Belquer/Cotucatronics/docs/relatorio/002.md

# Relatório 002 — ppc/002 rev C (cérebro + painel) — FECHADO

> **Estado: as DUAS placas fechadas em rev C, pacotes de fábrica PRONTOS.**
> `para_fabrica` passa nas duas, com procedência limpa. O que falta é **humano**:
> a confirmação de rotação peça-a-peça no pré-visualizador da JLC antes de pagar
> (§4). Este relatório substitui a versão anterior — que dizia, corretamente para
> a época, que a rev B **não** estava fechada e que faltava um host com KiCad 10.
> Esse bloqueio caiu (§1) e a saga que o seguiu está aqui, factual.

- **Data:** 2026-09-10
- **Ramo:** `claude/slack-session-sm2ldz`
- **Placas:** `kicad/cotuca_cerebro/cotuca_cerebro.kicad_pcb` (rev C — marca+búzios reposicionada e escalada para a banda centro-direita),
  `kicad/cotuca_painel/cotuca_painel.kicad_pcb` (rev C — J2 OLED corrigido em cobre)
- **Versionamento — congelamento-no-lançamento:** enquanto nenhuma das placas foi
  fabricada/pedida, **ambas ficam em `rev C`** (silk sem número). As iterações
  pré-fabricação (correcção do J2 do painel; reposicionamento+escala da marca do
  cérebro) partilham `rev C` e distinguem-se pelo **stamp de commit** do pacote —
  a letra só sobe quando um board for efectivamente mandado cortar. Ver
  `.claude/skills/aipcb/references/versionamento.md`.
- **Pacotes de fábrica (versionados, descarregáveis do PR):**
  - `export/cerebro_2026-09-12_06db1c7/` (zip + CPL + CPL rico + BOM + LEIA-ME + kit/) — commit **06db1c7** (**cérebro rev C**: marca COTUCATRONICS+rev+búzios reposicionada para a banda **à direita do U2, abaixo da fila de TP/J12, à esquerda do J2/C3** e **escalada por 0,72** para caber (a banda mede 32,8×9,5 mm; o banner cheio 45 mm não cabia) · silk gerber F/B 0 red/0 org · cobre provado idêntico ao 50e2368)
  - `export/painel_2026-09-12_06db1c7/` (zip + CPL + CPL rico + BOM + LEIA-ME + kit/) — commit **06db1c7** (**painel rev C**: J2 OLED reordenado + footprint 1x07 2,54 mm THT + labels por pino · silk gerber limpo · agora `painel rev C` no silk)
  - Ambos gerados por `para_fabrica`: *geometria 0 · planos inteiros ·
    todas as ligações feitas*. Vivem em `export/` (pasta de topo **rastreada**);
    o `fabrica/` continua a ser scratch gitignored. A partir de
    `para_fabrica v0.12.0` esta cópia para `export/` é **automática** na passagem
    do portão.
- **Thread do dB:** <https://cotucatronics.slack.com/archives/C0C0L4P4HKL/p1788980632073229>

### Histórico de revisões

- **cérebro rev C** — fechado, pacote `export/cerebro_2026-09-11_6ebbda5/` (retirado, reproduzível do histórico). A marca vivia em B.Silkscreen espelhada.
- **cérebro rev C1** — marca (COTUCATRONICS + rev) movida de B.Silkscreen para **F.Silkscreen do topo** — o cérebro monta com os componentes para cima e a tampa é de acrílico transparente, logo o topo é a face que se vê. Colocada na banda livre de topo entre J14 e J15 (folga ≥0,25 mm ao cobre, ≥1,5 mm ao bordo, medida em pcbnew), sem mirror. Acrescentado o **símbolo de búzios** (concha) em F.Silkscreen — a mesma marca `Concha` do `src/splash.h` (super-elipse n=3,2 com lábio/boca dentada), vectorizada para serigrafia. Rev sobe porque **silk é gerber**; o cobre foi provado **idêntico** (fingerprint de cobre/rede igual, diff do `.kicad_pcb` 100 % silk) — nenhuma deriva de gerador como a do painel. Commit **bcc80d2**, pacote `export/cerebro_2026-09-12_bcc80d2/` (retirado, reproduzível do histórico).
- **cérebro rev C2** — branding movido para área aberta centro-direita — a marca (COTUCATRONICS + rev + búzios) migrou **em bloco** (translação rígida +38,+65 mm, layout relativo preservado) da banda de topo para a **área aberta do centro-direita inferior**: acima do J1, à direita do U2 (Daisy DIP, acaba em x=115) e abaixo do bloco J2/J3/C3/J16, a pedido do dB. A banda de topo (rev C1) não comportava o bloco de 45 mm de largura sem apertar, e o ponto exacto apontado (y~55–72) está congestionado por J11/R9/J3/J2 — esta é a área aberta mais próxima que o comporta. Centros novos (F.Silkscreen, sem mirror): COTUCATRONICS (138, 89,4) · `cerebro rev C2` (138, 94,2) · búzios (162, 90,6); bbox (122,87)–(167,96); folgas pad 3,18 · furo 3,53 · pátio 2,22 · serigrafia 2,06 · bordo 24,4 mm. Rev sobe porque **silk é gerber**; o cobre foi provado **idêntico** ao bcc80d2 (fingerprint de cobre/rede igual `cf9aed0b…51eb`, diff do `.kicad_pcb` 100 % silk). Commit **50e2368**, pacote `export/cerebro_2026-09-12_50e2368/`.
- **painel — J2 OLED reordenado** (VCC·GND·DIN·CLK·CS·DC·RST) + footprint 1x07 2.54mm THT + labels por pino — commit deddd3d (silk carimbava `painel rev C1` à época). Ao regenerar a fonte apareceram e corrigiram-se duas derivas pré-existentes do gerador (EC11/SW1 chaves de pino, MOSFET Q1/Q2 source/drain) para o gerador voltar a reproduzir a placa; a netlist regenerada difere do baseline só no J2.
- **⚠️ Congelamento-no-lançamento (2026-09-12, commit 06db1c7)** — nenhuma das placas foi ainda fabricada, logo **as duas voltam a `rev C` no silk** (sem número), e as mudanças acima passam a ler-se como **iterações de `rev C` distinguidas pelo stamp de commit**, não como revs próprias. O silk do painel passa de `painel rev C1` → **`painel rev C`** e o do cérebro de `cerebro rev C2` → **`cerebro rev C`** (só texto de serigrafia; cobre byte-idêntico nas duas). A regra antiga «gerber muda → rev sobe a cada commit» foi substituída em `references/versionamento.md`: a rev sobe **por lançamento** (fabrico/pedido), não por commit.
- **cérebro rev C — marca reposicionada e escalada para a banda pedida** (commit 06db1c7) — o dB apontou a banda **à direita do U2, abaixo da fila de pontos de teste e do J12, à esquerda do bloco J2/C3**. Essa banda mede só **32,8 × 9,5 mm** (medido em pcbnew) e o banner a tamanho cheio tem **45 mm**: a tamanho cheio, COTUCATRONICS + rev caíam sobre os pads MIDI/AUDIO do U2 (**4 `silk_over_copper`** medidos). O grupo (COTUCATRONICS + rev + búzios) foi **escalado uniformemente por 0,72** (layout relativo preservado) e centrado na banda. Centros novos (F.Silkscreen, sem mirror): COTUCATRONICS **(127.2, 68.8)** size 1.872 · `cerebro rev C` **(127.2, 72.256)** size 1.152 · búzios **(144.48, 69.664)** ra 3.6 rb 2.16; bbox (115.7, 67.2)–(148.2, 73.3); folga mínima **0,67 mm** (pátio do U2 à esquerda, pátio do J2 à direita; TP e J12 a >3,6 mm); silk gerber F/B **0 red/0 org**, traço ≥0,15 mm. Cobre provado **idêntico** ao 50e2368 (fingerprint de cobre/rede igual, diff do `.kicad_pcb` 100 % silk). Pacote `export/cerebro_2026-09-12_06db1c7/`.
- **📦 Compra — PLACED (2026-09-12): peças na Mouser + placas nuas na JLCPCB** — BOM `export/COMPRA_MOUSER*` (`.csv` + template `.xlsx`/`.xls`), corte **v2**: 7 peças críticas verificadas em estoque via **Claude-on-Chrome** (F1 `MF-LSMF300/24X-2`, C14/C24 `MKS2C042201M00KN00`, C8 `CL31B106KAHNNWE`, D2 `SS14` onsemi, Q1/Q2 `SI2302CDS-T1-GE3`, IDC 2x13 `61202621621`, barra de headers `61304011121`) — os MPNs backordered/no-match do corte anterior foram trocados. Todo artefato de compra passa a carregar **carimbo** e o `export/MANIFEST.md` é a fonte-da-verdade de "o mais novo" (ver `references/versionamento.md`, «Versionar TUDO»). **Compra: PLACED.** **pedido Mouser #: 40440548 (2026-09-12)** (peças/BOM) · **pedido JLCPCB #: W2026091304545438 (2026-09-12) — placas nuas**. ⚠️ **confirmar se o pedido JLCPCB cobre cérebro E painel ou apenas um** (cobertura não verificada — não assumir).

---

## 1. A saga, factual

### 1.1 KiCad 10 indisponível → instalado por AppImage (Estágio 0)

Os ficheiros são KiCad 10 (formato pcb `20260206`, sch `20260306`) e **nenhum
KiCad instalável por apt/conda/PPA os abre** — foi o bloqueio que fechou o
relatório anterior. Resolvido pela via que o **Estágio 0** da `/aipcb` já prevê:
`scripts/bootstrap_kicad.sh` puxa o **AppImage do GitHub**, extrai o squashfs, e
a pipeline **volta a correr o portão de versão**. Passou: `kicad-cli` 10.0.6 a
abrir, correr ERC e DRC, rotear, encher zonas e exportar — o *"o ficheiro ABRE"*
que o Estágio 0 exige, provado, não assumido.

### 1.2 Os seis críticos da VARREDURA — já corrigidos no ficheiro

Os seis críticos C1–C6 que a `VARREDURA-PRE-FABRICA.md` (o de-facto 001) apanhou
já estavam corrigidos **no ficheiro** e continuam a passar por medição:
`funcao_dos_pads.py` dá **18 regras · 0 falhas** (cérebro) e **12 · 0** (painel),
e o `--sabota` reprova quando se corrompe um pad certo — a guarda tem dentes.
Nada de novo aqui; o trabalho da rev C foi geometria de cobre e colocação.

### 1.3 C16↔J14 — um waiver NEGADO por medição

O único **ERRO** de DRC do cérebro era um `courtyards_overlap` entre **C16**
(100n +3V3A, 0805, lado F) e **J14** (box-header DIN-41651, IDC 2×13). Parecia um
waiver razoável — courtyards são folga nominal. Ao medir **corpo-contra-corpo**,
C16 estava **inteiro dentro** do corpo F.Fab de J14 (o 0805 debaixo do shroud de
um header de assento rente): colisão real, não folga. **Um waiver é uma medição,
não uma opinião** — MUST-FIX, não SAFE-EMBARK. Este caso é agora a **âncora** do
Portão de Certificação de Risco na `/aipcb` e a instância do IFÁ10000 para hardware.

### 1.4 O nudge de J14 estava fisicamente bloqueado → C16 para B.Cu + FreeRouting

A correção óbvia — empurrar J14 para dentro e dar casa a C16 junto ao rail —
estava **fisicamente bloqueada pelo front-end do pré-amp** (D11/R11/J5) a ocupar
o único corredor interior vivo. Sem espaço para recolocar, o cérebro resolveu
**levando C16 para B.Cu** e roteando o +3V3A pela tira de plano com **FreeRouting**
(o router de pé: **JDK 25 + FreeRouting 2.4.1**, headless/offline). Resultado:
DRC de erros **5 → 0**, e os 3 itens de silk dependentes de C16/J14 resolvidos de
borda. O gerador foi atualizado para o novo estado (não só o ficheiro).

### 1.5 O painel levou o nudge real de J1 (5,5 mm) — fechou o latente C5

O painel tem o **mesmo** IDC 2×13 (**J1**), mesma classe de falha, e o seu cap
+3V3A **C5** estava a ~0,5 mm do corpo de J1 — um nudge de ser o próximo C16.
Aqui a recolocação **era possível**: nudge real de **J1 5,5 mm para dentro**,
re-roteamento do canto, **C5 colocado limpo**. DRC 0 erros mantido. O mesmo
defeito das duas placas, dois desfechos — um contornado por cobre porque a
colocação estava presa, o outro **desfeito na colocação** porque havia espaço.

### 1.6 Certificação de risco + revisão de terra — as duas SEGURAS, sem 🔴

- **Registo de risco** (saída da revisão tripla): depois de limpar o ruído de
  ambiente (`library not configured` vinha de `fp-lib-table` em falta, não da
  placa), o resíduo real é **cérebro 16 / painel 5 avisos**, cada um com veredito
  **medido**. Único ERRO era R1 (C16↔J14), já corrigido. Tudo o resto embarca com
  prova (metadata, silk da própria peça, MPN-no-símbolo). **GO** nas duas.
- **Revisão de terra** (`revisao-terra` P0–P7): cérebro com AGND/GND separadas e
  ponte única em NT1 (0 shorts ⇒ sem anel), plano analógico íntegro, pares de
  desacoplamento por rail; painel com terra única correta. **Ambas SEGURAS, sem
  🔴** — o único 🟠 é a distância do desacoplamento do rádio ESP32 (C3/C4 a ~10 cm),
  questão de ruído mitigada pelos caps de bordo do módulo, não defeito de cobre.

### 1.7 O achado de congestão (Estágio 3.5)

A revisão de densidade **pré-layout** mostrou que J14 e J1 eram a **mesma**
decisão tomada duas vezes: um IDC 2×13 encostado ao bordo de cima, o que mata um
dos dois broadsides de escape e sobre-aloca o corredor (**procura 17 > oferta
13**). Essa métrica prevê a colisão de C16 **antes de qualquer pista**. O achado
virou estágio: a `/aipcb` ganhou o **Estágio 3.5 — Previsão de congestão** (portão
GO / REVER-COLOCAÇÃO, duas recusas duras), a referência `references/congestao.md`,
e a ferramenta `scripts/congestao.py`. Corrida na rev C fechada, ela ainda marca
**cérebro J14 vermelho** (o over-commit é real, foi contornado por B.Cu, não
desfeito) e **painel J1 verde** (o nudge de 5,5 mm abriu o segundo broadside) —
exatamente a história das duas placas, medida.

---

## 2. O que passou por medição (rev C)

| check | cérebro | painel |
|---|---|---|
| DRC erros (com regras JLC, `--refill-zones`) | **0** | **0** |
| unconnected_items | **0** | **0** |
| ERC erros | **0** | **0** |
| funcao_dos_pads | **18 regras · 0 falhas** | **12 · 0** |
| revisão de terra | **SEGURA, sem 🔴** | **SEGURA, sem 🔴** |
| registo de risco | **GO** | **GO** |
| `para_fabrica` | **PASS** (pacote e058d6b) | **PASS** (pacote aad5d5a) |

---

## 3. Pacotes de fábrica (procedência)

Os dois pacotes saem carimbados com data/commit e o veredito *geometria 0 ·
planos inteiros · todas as ligações feitas*:

- **Cérebro:** `export/cerebro_2026-09-12_06db1c7/` — 2 camadas (F.Cu + B.Cu),
  GND (prio 0) + AGND (prio 1) ambas em B.Cu, NT1 como ponte única. BOM com coluna
  LCSC preenchida; CPL presente. **rev C** (marca + búzios em F.Silkscreen na banda
  à direita do U2, escalada por 0,72 para caber; cobre idêntico ao 50e2368).
- **Painel:** `export/painel_2026-09-12_06db1c7/` — 2 camadas. BOM+CPL presentes. **rev C** (J2 OLED corrigido; silk `painel rev C`).

> **Reempacotamento 6ebbda5 (`para_fabrica` v0.18.0).** O portão passou a preservar
> o **CPL rico** (`cpl_rico_<board>.csv`, com Val/Package) ao lado do CPL da JLC —
> antes reescrevia o CPL no lugar e perdia valor/footprint, e a jusante ninguém os
> lia da posição. Cada pacote ganha ainda um subdirectório **`kit/`** (gerado por
> `kit_montagem.py` v1.0.0): `MAPA_COLOCACAO.md` (colocação por valor, TOP/BOTTOM
> separados, BOTTOM e THT sinalizados), `COMPRA_LCSC.csv` (carrinho LCSC com sobras)
> e `LEIA-ME-KIT.txt` — o kit de montagem em casa na chapa quente. Os pacotes
> anteriores foram retirados (reproduzíveis do histórico do git). O `VISTORIA.md` é
> regenerado à parte, agora a partir do CPL rico que embarca.

> **Encomendar 2 camadas, não 4** — só há F.Cu e B.Cu; pedir 4 paga um plano
> interior que este desenho não usa.

---

## 4. Portões humanos pendentes ⟨dB⟩

**Não scriptáveis** — a rotação no CPL é a do KiCad, a JLC espera a da biblioteca
dela. Confirmar peça-a-peça no **pré-visualizador 3D da JLC, por placa, ANTES de
pagar** (só as peças com polaridade importam):

- **Cérebro:** `U1` OPA1642 SOIC-8 (ponto de pino 1); `D11`/`D21` BAV99 SOT-23
  (**risco 180°** — a JLC roda SOT-23 com frequência); `D1` SMBJ24A SMB (catodo =
  barra); `D2` SS14 SMA (catodo — ver ressalva do Value/MPN em §5).
- **Painel:** `Q1`/`Q2` AO3400A SOT-23 (**risco 180°**); **`J2` OLED — pinout vs
  Waveshare 2,42"**: a placa tem `1 GND · 2 +5V · 3 CLK · 4 DIN · …`; o módulo tem
  `VCC · GND · DIN · CLK · …`. **Com cabo 1:1, VCC↔GND TROCAM (o OLED morre ao
  ligar) e DIN/CLK também.** Ou se **reordena o J2** (o cabo de fábrica passa a
  servir), ou se **crimpa um cabo cruzado** — confirmar com o módulo em mão; nenhum
  script vê o conector de outra pessoa.
- **Pots THT** (`PTV09A-1020S-B103`) **não passam pela JLC** — vêm do
  distribuidor à parte; o `-1` é vertical com bucim, o `-4` é rear-mount e o eixo
  não sobe pela tampa.

Enquanto o ⟨dB⟩ não assinar, o Estágio 8 fica **INCOMPLETA** — nunca se confunde
com feito.

---

## 5. Ressalvas (honestas)

- **Regeneração do mapa LCSC bloqueada por egress (403 em jlcsearch).** O
  `codigos_lcsc.json` está completo **por referência** e o `para_fabrica`
  consumiu-o; **a chave de D2 ainda traz o MPN antigo, mas o `ref→C2480` está
  correto**. É a mesma peça (SS14 em SMA) que o desenho chama `1N5819` no `Value` —
  compra e desenho dão-lhe nomes diferentes; a coluna LCSC é que manda para a
  montagem.
- **"0 erros" de DRC (severidade=erro) é mais estreito que o portão do
  `para_fabrica`** (severidade=aviso + `refs_apontam`). As duas placas passam
  agora o **portão completo**, não só o DRC de erros — é o portão largo que conta.
- **Sem medição de bancada (P7).** A revisão de terra é do desenho/cobre; os
  números AC/mV sob carga ficam pendentes até haver placa na bancada.

---

## 6. Artefactos de método desta corrida

| artefacto | versão | porquê |
|---|---|---|
| `.claude/skills/aipcb/SKILL.md` | — | novo **Estágio 3.5 — Previsão de congestão** (portão GO/REVER-COLOCAÇÃO) |
| `.claude/skills/aipcb/references/congestao.md` | novo | método, fórmulas das 5 métricas, as 2 recusas duras, âncoras J14/C16 e J1/C5 |
| `.claude/skills/aipcb/scripts/congestao.py` | **0.1.0** | portão 3.5: orçamento de escape + densidade de pinos, read-only, sai ≠0 em vermelho, `--sabota` |

As placas carregam a **revisão** em `gr_text` (**`cerebro rev C`**, **`painel rev C`**) —
que agora **está** fechada. Sob **congelamento-no-lançamento** (2026-09-12), como
nenhuma das duas foi ainda fabricada, ambas ficam em `rev C` (silk sem número); as
mexidas do dia — correcção do J2 OLED do painel em cobre, e no cérebro a marca+búzios
levada primeiro para a F.Silkscreen do topo e depois reposicionada+escalada (0,72)
para a banda à direita do U2 — são **iterações de `rev C` distinguidas pelo stamp de
commit**, não revs próprias (só serigrafia nas do cérebro, cobre idêntico; ver
Histórico de revisões). O método de versão (as 3 camadas + a regra de
congelamento-no-lançamento) está em `.claude/skills/aipcb/references/versionamento.md`. As bumpagens de scripts de pipeline das corridas
anteriores (`faz_placa` 0.14.0, `para_fabrica` 0.11.0, `poe_furos` 0.2.0)
mantêm-se.

### 6a. Paridade com o DFM da JLC — serigrafia (adenda 2026-09-10)

O DFM da JLCONE reprovou o painel com serigrafia a vermelho que o portão
sub-contou (silk→pad, silk→furo, largura de traço). Corrigido no painel (texto
`Q1`/`Q2`/`painel rev C` para fora de pad+furo; 301 contornos de biblioteca a
0,12 → 0,15 mm) e dado **paridade** à pipeline: `cotuca_painel.kicad_dru` (regras
silk→pad/→furo/traço/altura), `para_fabrica` **0.13.0** (recusa serigrafia de
texto sobre pad + texto fino/baixo; silk→furo já cai na geometria) e
`normaliza_silk.py` **0.1.0** (a largura de gráfico de serigrafia, que nenhum DRC
mede, subida na fonte). **Decisão ⟨dB⟩ (ferramenta):** o **KiCad é a
fonte-da-verdade** (aberto, versionado, automatizável por agentes); o EasyEDA
Pro / JLCONE é só o front-end final de DFM + encomenda — o portão dá paridade
para esse passo ser um carimbo.

**Cérebro — mesma passagem, medida no gerber (2026-09-11).** Antes: silk→pad **23
vermelhos** (F) + **2** (B), traço mín 0,12 mm. Depois de `serigrafia_dfm`
(v0.2.0 — passou a tratar os 17 rótulos de pino `PCB_TEXT` do módulo ESP32-C3 em
`U3`, que faziam o `widen` rebentar): **silk→pad/→furo 0 vermelho nos dois lados**,
traço todo ≥ 0,18 mm, e cada marcador de polaridade/pino-1/cátodo (`D1` SMB, `D2`
SMA, `D11`/`D21` SOT-23, `U1` SOIC-8, «+» de `C1`/`C3`/`C5`/`C6`) renderizado e
**verificado a sobreviver** (`refs_apontam` 0). Laranjas medidas, cada uma ACEITE
com o número: anel mín **0,15 mm** (217 features plateadas; 0 < 0,13; 0 < 0,15;
`H1`–`H4` NPTH sem anel), 72 vias 0,6/0,3 = a via-padrão da JLC; **0 slots** (sem
EC11 — a classe slot/negative-mask não se aplica); expansão de máscara 0,0 mm e
**72 vias todas tapadas**; silk→pad no limite 0,163 mm (F)/0,195 mm (B) ≥ 0,15. O
`para_fabrica` **0.15.0** dá o cérebro **PRONTO** (geometria 0, ERC 0, unconnected
0, `funcao_dos_pads` 18/0, silk gerber 0, tenting 0 abertas). Detalhe em
`fab-automation.md` §2a-bis. **As DUAS placas agora com serigrafia a 0 vermelho no
gerber.**
