Belquer/Cotucatronics/docs/IFA10000.md

# IFÁ10000 — protocolo de certificação de efeitos

### Todo efeito que entra no Cotucatronics passa por aqui. Sem exceção, sem atalho.
### E toda placa que entra numa caixa passa pela trilha M, no fim deste documento.

> **Por que existe.** Cada item deste protocolo foi comprado com horas de
> bancada. O freeze quase morreu pelo número errado; um módulo passou
> sessões mudo por um contrato não conferido; 108 KB no lugar errado
> custaram 13 pontos de CPU. Nada aqui é burocracia — é cicatriz virada
> procedimento. Ver [battle_scars.md](battle_scars.md) para as histórias.
>
> **Documento vivo.** Efeito novo que revele buraco no protocolo ganha
> etapa nova. O IFÁ10000 melhora a cada certificação.

---

## As 10 etapas

Cada etapa tem **critério de passagem explícito**. Efeito que não passa
não entra no build — fica no repo, documentado, com a etapa que reprovou.

---

### 0. MEDIÇÃO LIMPA — o pré-voo, antes de qualquer número

Nenhuma etapa deste protocolo produz dado válido sem isto. Skill:
`medicao-limpa`.

- [ ] **o canal foi provado**: comando de eco conhecido, resposta conferida
- [ ] **ambiente zerado**: `tone off`, búzios desligados, params nos defaults
- [ ] **unidade declarada**: µs? % de que prazo? RMS, pico ou norm?
- [ ] **regime declarado**: estreia ou permanente? bloco 48 ou 256?
- [ ] **um voo, uma variável** — e os empregos da variável listados antes
- [ ] caixa-preta armada por comando no início; sessão de leitura não escreve

**Passa se:** o zero que aparecer na tela significa alguma coisa.

> Custou: quatro janelas de teste de MIDI lidas como "link morto" com o log
> mudo por um `bb arm` meu — mediram o meu silêncio, e a conclusão errada
> foi **publicada** no battle_scars como causa confirmada. **Um zero num
> canal não confirmado não é dado; é ausência de dado.**

---

### 1. CONTRATO — o que ele promete, conferido antes de embarcar

Ler o `description.json` (motor externo) ou a interface (shell) **antes** de
escrever uma linha de wrapper.

- [ ] entradas / saídas: quantas, e batem com o slot que vai recebê-lo?
- [ ] parâmetros: nomes exatos, faixas, valores iniciais
- [ ] datarefs externos: quais o host precisa preencher, e de que tamanho?
- [ ] classname / símbolos que possam colidir com outro módulo

**Passa se:** o wrapper e o contrato contam a **mesma história**, e a
divergência que existir está comentada no código.

> Custou: um módulo mudo por `r_window` de 2048 numa FFT de 1024; wrapper
> declarando 2 entradas num patch de 1; um param de mistura sumido de um
> export. **Ler o JSON custa um minuto; um módulo mudo custou horas.**

---

### 2. EMBARQUE — ele acorda?

- [ ] compila com `make check` (clone limpo tem tudo)
- [ ] `Init` retorna verdadeiro e o boot loga o que alocou
- [ ] `mods` mostra os params **descobertos por nome**, índices ≥ 0
- [ ] zero falhas de alocação

**Passa se:** boot limpo, sem `-1` em ligação nenhuma.

---

### 3. MOTOR — ele está sendo dirigido? *(só motor externo)*

- [ ] `processEventsUntil()` + `advanceTime()` a cada bloco
- [ ] warm-up no `Init` paga a estreia no boot
- [ ] re-kick de params depois do warm-up

**Passa se:** um parâmetro mexido ao vivo muda o som **na hora**.

> Custou a sessão inteira de 2026-08-16. Assinatura da falha: **roda, custa
> CPU, não soa, sem log.** Sinal puro roda sem motor; tudo que depende
> de evento fica morto.

---

### 4. MEMÓRIA — quanto, onde, e com que padrão de acesso

- [ ] quantos bytes, e em qual região (pool de módulo / SRAM / SDRAM)?
- [ ] quantos acessos por amostra, e são sequenciais ou espalhados?
- [ ] o tamanho é **perguntado ao efeito**, nunca fixado em quem chama

**Passa se:** cabe com folga declarada, e a escolha de região está
justificada no código.

> Custou: reverb com 108 KB em SDRAM = +12,9 pontos de CPU; os mesmos
> 108 KB em SRAM = +5,6. **O padrão de acesso importa mais que o
> tamanho** — 48 acessos espalhados por amostra é o pior caso pra cache.

---

### 5. CARGA — estreia e regime, separados, nos dois blocos

Medir **pico**, não média. Nos dois regimes: **bloco 48** (instrumento) e
**bloco 256** (com módulo espectral).

| | estreia (µs) | regime (µs) | % do prazo |
|---|---|---|---|
| bloco 48 | | | |
| bloco 256 | | | |

- [ ] estreia separada do regime (janela de graça)
- [ ] pico, com o medidor **zerado** entre as leituras
- [ ] a unidade está declarada (µs? %? de que prazo?)

**Passa se:** o pico cabe no prazo com folga ≥ 25%.

> Custou: freeze condenado por 233 965 µs de estreia quando o regime era
> 3 520. **Estreia é o preço da mudança; regime é o aluguel.** E: pico
> decide, média mente — um módulo tinha média de 7,8% com pico de 210%.

---

### 6. MATERIAL DE PROVA — o sinal certo pra este efeito

Cada efeito tem sua régua. Usar a errada produz "não funciona" falso.

| Efeito | Material | Por quê |
|---|---|---|
| delay, shifter | senoide | período claro, deslocamento audível |
| cross-synthesis | **banda larga** (ruído, piezo) | peneira: só devolve onde as fontes coincidem |
| reverb | **transiente + silêncio** | cauda só aparece depois do ataque |
| gate, limiter, governor | transiente percussivo real | é o caso que eles existem pra tratar |
| filtro | varredura ou ruído rosa | mostra a curva inteira |

- [ ] o material usado está registrado no teste
- [ ] o aceite final é sempre com o **piezo**, tocando a escultura

**Passa se:** o efeito responde ao material certo, e o registro diz qual foi.

> Custou: um cross-synthesis declarado quebrado porque senoide × drone esparso ≈
> silêncio. Não era bug — era **régua errada**.

---

### 7. FAIXA E ESTOURO — onde ele satura

- [ ] histograma de pico ao longo da faixa de cada parâmetro
- [ ] medido **antes** do limiter (depois dele tudo mostra 0,95)
- [ ] identificado: satura numa **nota** (→ notch) ou numa **região**
      (→ filtro)?

**Passa se:** existe tabela dizendo onde começa e até onde vai.

> É o que transforma "está estourando o grave" em "de 110 a 155 Hz o
> pico passa de 1,0" — e o conserto deixa de ser chute.

---

### 8. SEGURANÇA — o que ele pode fazer de errado

- [ ] interage bem com governor, limiter e shifter?
- [ ] pode realimentar pelo exciter? qual o plano B se o laço engordar?
- [ ] **quais params entram nos búzios, e quais NÃO** — com o porquê

Regra da whitelist: **caráter entra, moldura e segurança não.**
`level`, `src_mix`, gate, governor, limiter, roteamento e shift **jamais**.
Bloco que serve de referencial fixo (como o reverb) também fica fora:
*se tudo salta, nada é surpresa.*

**Passa se:** a decisão de cada param está escrita no manifest com a razão.

---

### 9. ACEITE — o ouvido do músico, não a caixa-preta

- [ ] **mínimo 1 minuto contínuo** tocando a escultura
- [ ] o efeito faz o que promete, do começo ao fim
- [ ] nada degrada ao longo do teste

**Passa se:** o dB diz que está bom. **Só isso conta como entregue.**

> Custou: "auto-rand funcionando" declarado com 951 pushes medidos, e a
> torneira seca. **Encanamento provado não é feature entregue.**

---

### 10. REGISTRO — o que fica pro próximo

- [ ] **TESTES.md**: teste T-novo com procedimento e critério
- [ ] **STATUS.md**: estado, custo medido, defeitos que ele trouxe
- [ ] **battle_scars.md**: se houve cicatriz, ganha parágrafo
- [ ] **commit por assunto**, com o *porquê* no corpo
- [ ] docs sincronizados no repo **e** no vault

**Passa se:** alguém que clone o repo amanhã reproduz tudo sem perguntar
nada.

---

## O braço executável — skills em `.claude/skills/`

O protocolo deixou de ser só leitura. As cicatrizes viraram skills que
carregam sozinhas na sessão quando o assunto aparece:

| Skill | Dispara quando | Vem de |
|---|---|---|
| `ifa10000` | efeito novo, revalidação, "isso está certificado?" | este documento |
| `medicao-limpa` | antes de **toda** medição — é a etapa 0 | caso 8, `tone on`, búzios ligados |
| `instrumentacao` | log, caixa-preta, contadores, sondas, mscope | os 8 casos do cap. 2 |
| `bug-de-ordem` | funciona às vezes; teste incoerente | as 3 famílias do cap. 1 |
| `edicao-segura` | **toda** alteração de arquivo | edições que falharam em silêncio |
| `aipcb` | placa nova, placa numa caixa — é quem corre a **trilha M** | o painel rev C sem fixação |

**Por que skills e não só documento:** o cap. 11 manda, com todas as letras,
procurar o teste que corta o sistema ao meio quando o sintoma se repete — e
mesmo assim quatro janelas foram gastas gerando hipóteses sobre BLE sem
aplicar a regra. **A lição não pegou por estar escrita.** Skill carrega no
momento do uso; documento espera ser lembrado.

---

## Ficha de certificação (copiar e preencher)

```
EFEITO: ..................  DATA: ..........  VERSÃO: ..........
TIPO: [ ] módulo externo   [ ] bloco permanente do shell
POSIÇÃO NA CADEIA: ......................................

 0 MED. LIMPA    [ ] canal provado ....  ambiente zerado ....  unidade ....
 1 CONTRATO      [ ] ....................................
 2 EMBARQUE      [ ] ....................................
 3 MOTOR         [ ] ....................  [ ] N/A (shell)
 4 MEMÓRIA       [ ] ......... bytes em ........  ..... acessos/amostra
 5 CARGA         [ ] blk48: ..... µs pico   blk256: ..... µs pico
 6 MATERIAL      [ ] ....................................
 7 FAIXA         [ ] satura em .............. (nota / região)
 8 SEGURANÇA     [ ] búzios: entra ..........  fica fora ..........
 9 ACEITE        [ ] dB ouviu ..... min  →  ....................
10 REGISTRO      [ ] T....  STATUS  scars  commit  vault

VEREDITO: [ ] CERTIFICADO   [ ] REPROVADO na etapa ....
```

---

## Certificados até aqui

| Efeito | Data | Veredito | Nota |
|---|---|---|---|
| delay (motor externo) | 2026-08-15 | ✅ T5 | primeiro módulo; abriu o caminho |
| búzios (shell) | 2026-08-16 | ✅ T13 | 74 transientes / 74 sorteios |
| reverb (shell) | 2026-08-17 | ✅ T14a | 108 KB: SDRAM +12,9 pp → SRAM +5,6 pp |
| passa-alta Fx2 (shell) | 2026-08-17 | ✅ T14b | histograma por nota evitou o notch errado |
| freeze (motor externo) | — | ❌ etapa 5 | 7 349 µs; não cabe em prazo nenhum |
| freeze granular (shell) | 2026-08-18 | ✅ **CERTIFICADO** | 98 µs de 500; três versões — laço de 2 s, ganho, e mix-como-camada |
| shifter SSB (shell) | 2026-08-15 | ✅ T8 | 50,5 dB de supressão em placa |

---

## Trilha M — pareamento mecânico placa ↔ caixa (IFÁ10000-M)

As dez etapas acima certificam **efeitos**. A trilha M certifica **o encaixe de
uma placa em qualquer caixa em que ela entre** — furos, ângulos, tamanhos,
volume, técnica de fixação, acesso e montagem. Vive na sub-skill `3ddesign`,
orquestrada pela `aipcb` (no estágio 3, antes do cobre, e antes dos gerbers): o
texto completo, as âncoras e a ficha estão em
**`.claude/skills/3ddesign/references/ifa10000-m.md`**. Aqui fica o registo.

**A ordem de prioridades** — é ordem, não lista absoluta:

1. **A placa traz os seus meios de fixação.** Sem furos não há como a prender, e
   nenhuma caixa resolve isso: aqui a placa cede.
2. **Com isso garantido, a caixa cede à placa em tudo o resto.** É muito mais
   fácil ajustar uma embalagem do que uma PCB.
3. **A placa só cede noutra coisa com justificação excelente**, escrita, medida
   e assinada pelo dB.

**Etapas:** M0 medição · M1 interfaces · M2 fixação · M3 furos e recortes · M4
tamanhos e contornos · M5 ângulos e orientação · M6 volume Z · M7 acesso e
montagem · M8 tolerâncias · M9 encaixe a seco ⟨dB⟩ · M10 registo.

### Certificados — trilha M

| Placa · caixa | Data | Veredito | Nota |
|---|---|---|---|
| painel rev C (`06db1c7`) · tampa r2 | 2026-09-18 | ❌ **M2** (`encaixe.py`) | **0 pontos de fixação.** Sem furos de montagem nem NPTH; desenhada para ficar pendurada nos eixos, mas os pots passaram à tampa por fios (caso B) e o `EC11E15244G1` não tem rosca. Pela prioridade 1 cede a placa: há 4 pontos furáveis medidos (M3 com anilha, fora do cobre e em acrílico inteiro), todos à direita de x=97 — os primeiros 60 mm, sob o OLED, ficam em balanço. Na próxima rev, os furos entram por desenho, com um na ponta esquerda. **M6 (dB, medido): o header do OLED com jumpers direitos não cabe entre a placa e o acrílico** — J2 por baixo ou jumpers em L; na próxima rev, conectores do lado de baixo por desenho. |
| cérebro rev C (`06db1c7`) · fundo r2 | 2026-09-18 | ❌ **M6** | M2 ✓ (4 furos M3, triângulo 5254 mm²) · M4 ✓ · cabo ✓ (265 mm pedidos, BOM 300). **M6: três corpos dentro dos discos dos arcade** — `J14` (8,85 mm) a 11,6 do centro, trimpot `RV1` (10) a 13,3, Daisy `U2` (17) a 14,8 — contra o raio do FURO (15) e 7,5 mm de folga. O corpo do botão por baixo da tampa é mais estreito e nunca foi medido: medir o botão pode absolver o `U2` e talvez o `RV1`; o `J14` é o que mais provavelmente bate. |

---

*Ifá consulta o destino com rigor; os Búzios consultam com acaso. O
instrumento precisa dos dois — e o rigor vem primeiro, senão o acaso não
tem onde cair.*
