Belquer/Cotucatronics/docs/ppc/008-versao-nova-cerebro-e-silencio.md

# ppc/008 — a versão nova: cérebro, silêncio, e o que a pesquisa desmentiu

<!-- doc-check: ignore cotuca_cerebro (pasta do projecto KiCad, nao e param) -->
<!-- doc-check: ignore funcao_dos_pads (portao do /aipcb, ferramenta em kicad/) -->

> **Estado: PESQUISA FECHADA EM 5 DE 7 FRENTES, decisão principal TOMADA.**
> Escrito a 2026-09-29, a seguir à noite em que a caixa montada se recusou a
> funcionar e o dB disse: *"consertaremos uma coisa e outra vai estragar."*

**O pedido que o originou, nas palavras dele:** deixar o sistema actual como
aprendizado, seguir para caixa e placa novas, **som mais limpo, nível
audiófilo**, aproveitando o que for bom — *"sem apego às peças, focando no
objetivo de um instrumento sólido, limpo e preciso."*

---

## §0 — A DECISÃO, e ela inverteu-se a meio da pesquisa

> **Não se faz placa própria agora.** Faz-se **caixa e carrier novas,
> mecânica-primeiro, com um Daisy Seed3** — e mede-se.

Eu tinha recomendado o contrário (STM32H7R3 próprio). O estudo de custo
desmentiu-me, e a razão é simples: **o benefício que eu invoquei já está à
venda.**

| por unidade | 5 un | 10 un | 30 un | 100 un |
|---|---|---|---|---|
| placa própria (JLCPCB) | ~$33 | ~$24 | ~$18 | ~$14,6 |
| Seed3 + carrier | ~$55 | ~$49 | ~$44 | ~$40 |
| **poupança** | ~$22 | ~$25 | ~$26 | **~$25** |

**A poupança é plana** — a curva de desconto da Daisy também é (5 % a 100 un),
e o ganho vem de trocar um módulo de $30 por ~$9 de silício, não de escala.

Contra isso: a média da indústria é **2,9 respins**, ~90 % dos primeiros
protótipos falham, e só o hardware dos respins custa **$700–1600**. Ponto de
equilíbrio: **~40 placas** (só hardware) ou **~200** com o tempo de projecto a
preço de mercado. Claramente certo a partir de **300–500 un/ano**.

**A 10 unidades, a placa própria perde feio:** semanas e dois ou três respins
para poupar $250.

### E o projecto já tinha decidido isto, a 2026-09-05

A `COTUCA_BOM.md` diz, e a razão é a mesma de hoje:

> *"A Daisy Seed rev4. **RESOLVIDO a 2026-09-05: passou a Seed3.** A pinagem foi
> conferida pino a pino... o nome STM32 bate nos 40 pinos, sem uma excepção...
> Símbolo, footprint e netlist ficaram **idênticos**. O que mudou a favor:
> codec **TI TAC5242**, 32 bit/192 kHz, chão de ruído de −120 dB."*

A pesquisa de hoje **não descobriu o cérebro — confirmou uma decisão de há três
semanas**, e o Seed3 é `drop-in`: *"backwards compatible with existing firmware
binaries"*. Zero alterações de firmware, zero de netlist.

⚠️ **Acção com prazo:** a Electrosmith deixou de vender por distribuidores e o
mercado de memória está tenso até 2027. A 2026-09-29 havia **44 Seed3** e **436
Seed2 DFM** em stock directo, a $29,99.

### Quando reabrir a questão da placa própria

1. Quando houver compromisso de **300+ unidades/ano**; **ou**
2. quando estiver **medido** que a arquitectura sem SDRAM serve (ver §1) — e aí
   desenha-se uma placa deliberadamente **melhor**, não só mais barata.

---

## §1 — A conta de memória, que é o que decide qualquer placa própria

**Medido na placa, não estimado** (`SDRAM via AllocBig` no arranque):

```
SDRAM via AllocBig: 2 035 216 de 67 108 864 bytes
  motores de pitch   150 KB × 2
  delay              187 KB
  freeze             750 KB × 2
```

**1,94 MB de RAM grande + 318 KB de `.bss` = ~2,26 MB.**

🔴 **NENHUM STM32H7 TEM ISSO INTERNAMENTE.** O maior (H7A3/H7B3/H7B0) tem
1,4 MB, e **1024 KB contíguos**. As peças com RAM suficiente são muito mais
lentas (U5G9, 160 MHz, 0,27× a nossa CPU) ou só existem em BGA (N6).

### ⚠️ E o baseline de CPU que eu usei estava errado

Eu li **29,6 % / 40,8 %** na placa — mas **com o shimmer inactivo**. O
`STATUS.md` documenta o caso cheio: **59,5 % média / 65,8 % pico**.

> **Valor lido de placa viva não tem procedência.** Eu medi o que estava a
> correr e tratei-o como o pior caso.

Com 65,8 %, o H7B0 a 280 MHz dá **113 % do prazo** — rebenta. Era a peça
elegante (1024 KB contíguos seguravam `.bss` + pitch + delay dentro do chip) e
morre por aqui.

### O achado técnico que torna a placa própria possível um dia

> **O QUADSPI do H750 só lê em modo mapeado. O OCTOSPI escreve.**

É **por isso** que a Daisy precisa de SDRAM paralela. Qualquer peça com OCTOSPI
(H723, H7A3/B3/B0, H7R3/S3) permite PSRAM série como RAM de trabalho.
Candidatos verificados: **STM32H7R3Z8T6** ($6,10/100 na ST, 600 MHz, LQFP144) +
**APS6404L-3SQR-SN** (8 MB, SOP-8, 3,0 V, $2,90/100).

### 🔴 CORRECÇÃO (estudo da memória, 2026-09-29): a PSRAM NÃO devolve os 12,9 pontos

Aquela medição foi **externo contra interno**, não SDRAM contra PSRAM. Custo de
uma linha de cache de 32 bytes (o Cortex-M7 tem linha fixa de 32 B):

| memória | 1.ª palavra | pico | **falha de 32 B** |
|---|---|---|---|
| **SRAM interna** | ~0 | ~3 GB/s | **~11 ns** |
| XSPI x16 @152 MHz (APS256, config da ST) | ~50 ns | 608 MB/s | 103 ns |
| **SDRAM da Daisy** @120 MHz CL3 | ~80 ns | 480 MB/s | **147 ns** |
| HyperRAM x8 @166 MHz | 56 ns | 333 MB/s | 152 ns |
| HyperRAM x8 @100 MHz (3,0 V) | 56 ns | 200 MB/s | 216 ns |

**A PSRAM empata com a SDRAM. Só a memória interna é ~14× melhor**, e é aí que
vivem os 12,9 pontos.

### E daí sai a melhor ideia da pesquisa toda: ENCOLHER, não acrescentar

> Um buffer de freeze de **2 s estéreo a 48 kHz** são **750 KB em float32** — e
> **375 KB em int16**.

Dois desses são **750 KB**, e o **H7A3/H7B3 tem 1024 KB contíguos**. Com os
pitch e o delay a caber no resto, **a memória externa desaparece**: zero sinais,
zero erratas de OCTOSPI, zero corrente de refrescamento ao pé do analógico, e os
12,9 pontos de volta.

⚠️ **A tensão que isto cria, e que só se resolve medindo:** o H7A3/H7B3 corre a
**280 MHz = 0,58×** a nossa CPU, o que dava 113 % do prazo pela conta de
relógio. Mas essa conta **não contabiliza as paragens de memória**, que é
precisamente o que melhora quando tudo vem para dentro. A conta de relógio diz
que não cabe; a física da memória diz que pode caber. **Não se decide por
argumento.**

### ⚠️ E a peça que eu recomendei NÃO serve

A **APS6404L** (Quad-SPI) tem **escrita mapeada quebrada**. Errata da ST
(ES0478 §2.6.8, ES0491 §2.8.6, ES0596 §2.4.1): *"memory-mapped write error
response when DQS output is disabled"*, estado **P — contorno parcial**. E o
contorno obrigatório traz o seu próprio defeito: *"os bytes que deviam ser
mascarados são escritos na memória"* — ou seja, **escrita parcial estraga as
amostras vizinhas**. O representante da AP Memory confirma-o no fórum da ST.

Se houver memória externa, as opções sãs são **x16 XSPI** (APS256XXN, $3,90/100,
mais rápida que a nossa SDRAM actual) ou **HyperRAM** (IS66WVH8M8BLL, validada
pela ST, com driver e exemplo, e cujo RWDS torna a escrita por byte **realmente
segura** — contorna a pior errata).

### 🔴 Dois riscos novos, e o segundo é de RUÍDO

**Contenção de DMA.** Medição num fórum da ST: HyperRAM a 100 MHz deu
**178 MB/s** — e caiu para **54 MB/s** quando um DMA de UART disputou o mesmo
barramento AXI. **O nosso DMA de SAI corre sempre.** É o maior risco isolado
deste plano, e mede-se no primeiro protótipo.

**Corrente de refrescamento da PSRAM.** A ficha da AP Memory: *"a corrente de
pico do refrescamento periódico interno pode chegar a 25 mA, durando algumas
dezenas de microssegundos"*. A ISSI especifica **60 mA** em rajada a 166 MHz.
**Isso é um transitório periódico, a taxa fixa, ao lado do analógico** — a mesma
família do transitório do callback que estraga a Daisy (§5). Se houver PSRAM,
**leva trilho filtrado próprio**.

🔴 **O RISCO QUE TEM DE SER MEDIDO ANTES DE DESENHAR COBRE:** os motores de
pitch fazem **acesso disperso**, e acesso disperso em memória série é dominado
por latência. Já medimos **+12,9 pontos de CPU** ao pôr o reverb em SDRAM. Com
456 KB contíguos no H7R3, **1,9 MB vai para a PSRAM, incluindo os buffers
quentes**. Experiência proposta: pôr um motor de pitch atrás de um caminho de
acesso deliberadamente lento **no hardware actual** e medir o custo no callback.

---

## §2 — O firmware já está portável, e isso é desenho, não sorte

```
main.cpp        8 318 linhas   inclui SÓ headers do projecto
hal.h             531 linhas   inclui SÓ <cstdint> e <cstddef>
DSP (18 headers)               nenhum toca em libDaisy
─────────────────────────────────────────────────────────
hal_daisy_seed.cpp  2 554      ← o ÚNICO que inclui libDaisy
qspi_raw.cpp          664      ← inclui só stm32h7xx.h (CMSIS)
```

Busca por chamadas reais a libDaisy fora da camada de placa (`daisy::`,
`DaisySeed`, `dsy_*`, `AdcHandle`, `SaiHandle`): **zero**. As ocorrências em
`main.cpp` são comentários.

**A migração é um ficheiro** — 94 funções, das quais ~20 tocam no silício. E o
`qspi_raw.cpp` escrito a 2026-09-29 é CMSIS puro: **transfere-se tal e qual**.

**Proposta de refinamento:** acrescentar `AllocFast()` (SRAM interna) ao lado do
`AllocBig()` (memória externa), para a partição quente/frio ficar **explícita e
auditável no arranque**, como já é a contabilidade da SDRAM.

---

## §3 — O silêncio: a linha de base é NOSSA, e é melhor que a literatura

| condição | IN_L | IN_R |
|---|---|---|
| **melhor já medido** (painel apagado) | **−75,3** | **−77,7** dBFS |
| com o painel OLED aceso | −69,3 | −71,3 dBFS (**−6 dB**) |
| **antes do conserto de terra** | −34,2 | −34,2 dBFS |
| saída em repouso | pico −74,7 · média −89,6 dBFS | |
| tom permanente medido 2026-09-29 | **4999,1 Hz a 33,9 dB**, dominância 1,00 | |

**Refazer o terra valeu 35 a 39 dB.** Trocar o conversor vale ~15–33 dB.

⚠️ O agente de aterramento procurou medição publicada equivalente ao nosso
ganho e **não encontrou nenhuma**. Isto é dado próprio, e vale mais aqui do que
qualquer fonte externa.

### Por que foi o terra, e por que não podia ter sido outra coisa

Archambeault (IEEE EMC Society, 2008) mede a transição: **abaixo de ~800 kHz** a
corrente de retorno segue o caminho de **menor resistência**; acima, o de
**menor indutância**.

- **A banda de áudio está toda abaixo disso.** O retorno do áudio **não
  acompanha o traço** — espalha-se pelo plano. Não se controla por roteamento;
  controla-se por **não partilhar cobre**. É **acoplamento por impedância
  comum**.
- **A assinatura confirma:** −34,2 dBFS **igual nos dois canais**. Simétrico é
  referência partilhada; diafonia ou cabo estragado seriam assimétricos.
- **O retorno digital está muito acima** dos 800 kHz — esse acompanha o traço e
  fica na partição digital **desde que o plano seja contínuo**.

### 🔴 O corolário, que é o maior risco da revisão nova

> **Um LDO, uma ferrite ou um plano dividido NÃO protegem se o retorno
> analógico voltar a partilhar caminho resistivo com o retorno do class-D ou do
> conversor comutado.** Colocação e topologia de corrente dominam tudo o resto.

O que nos deu 35-39 dB pode ser desfeito por uma decisão de **posicionamento**,
e nenhum componente caro o recupera.

---

## §4 — Regras de layout, com a fonte e o número

⚠️ **A literatura discorda de si própria, e isso é dado:** TI **SLAA749**
(codecs) manda **dividir** o plano; **Ott** e TI **SLYT512** mandam **um plano
só, particionado**; TI **SLOA216** (class-D) manda **contínuo**. Os três foram
lidos em texto extraído do PDF porque **o sumarizador de busca fabricou dois
resumos** — inclusive inverteu o sentido do SLAA749.

**Escolha deste projecto: um plano só, particionado.** O SLAA749 escreve para
placas onde o codec é a única ponte; a nossa tem H7 a 480 MHz, Octo-SPI, QSPI e
USB — dezenas de redes atravessariam o corte.

| regra | fonte | número |
|---|---|---|
| Um plano contínuo, particionado; disciplina de roteamento em **todas** as camadas | Ott · SLYT512 | — |
| Codec **a cavalo da partição**, digital para o MCU, analógico para os pré-amps | Ott | — |
| Empilhamento **assimétrico**: dieléctrico fino ao plano (~0,005"), núcleo grosso ao meio | Ott | **≥10 dB** menos radiação de laço |
| Nenhuma rede rápida atravessa descontinuidade; via de retorno a **<100 mil** de cada via de transição | NXP AN13202 | — |
| Energia entra na **partição digital**, alimenta o digital, **depois** filtra para o analógico | SLYT512 | — |
| **LDO** no trilho analógico, alimentado pelo buck | SLYT512 + ADI | mV → µV rms |
| Relógios longe dos pinos de referência do codec; condensador pequeno **mais perto** | Cirrus DS686F1 §5.8 | — |
| **MCLK a 256×fs (12,288 MHz)** para **contornar o PLL do codec** | TI SLAA749 | — |
| **1 kΩ + 4,7 nF** entre codec e class-D (polo a 33 kHz) | TI SLAA749 | — |
| Class-D: **1 nF + 0,1 µF** no PVCC; ferrite eficaz **acima de 1 MHz** nas saídas | TI SLOA216 | margens >10 dBµV |
| **Espalhamento de espectro** ligado no class-D | TI SLOA216 | conformidade medida assim |
| Traços do class-D ao transdutor **curtos**; nunca em paralelo com os piezos | TI SLOA216 | "a maior fonte de emissão" |
| Baixar a **força de saída** do Octo-SPI/QSPI ao mínimo que cumpra timing | NXP AN13202 | harmónicas medidas a cair |

⚠️ **NÃO é verdade que barramento estreito irradie menos por ter menos
condutores.** Procurou-se medição publicada e não existe. O barramento série
ajuda por ser **fisicamente pequeno e fácil de manter dentro da partição
digital** — a razão importa, porque a errada leva a decisões erradas.

---

## §5 — Conversores: o campo mudou debaixo de nós

🔴 **CS4270 e CS4272 estão em FIM DE VIDA** — última compra 2023-12-10, último
envio 2024-06-07, *"EOL'd due to fab closure"*. O conversor de referência do
GuitarML **não se pode desenhar hoje**. O **WM8731 também** está EOL, e a
dinâmica dele **a 48 kHz é 85 dB**, não os 90 que se citam (90 é a 96 kHz).

⚠️ **E os datasheets do CS4270/CS4272 não trazem aviso de fim de vida.** Quem só
lê a ficha é enganado — é a regra §7f da `/kicad` aplicada ao ciclo de vida.

**A escolha é o TI TAC5242** (119 dB ADC / 120 dB DAC, um trilho de 3,3 V, PLL
com detecção automática, ~$5,84) — **e é o que o Seed3 já traz.**

### A prova de que o conversor NÃO é o limite

Histórico medido da própria Daisy:

| placa | conversor | ficha | ruído medido |
|---|---|---|---|
| Seed Rev4 | AK4556 | 103/106 | 40 µV |
| Seed 1.1 | WM8731 | 85/100 | **18,6 µV** |
| Seed 1.2 | PCM3060 | **99/104** | **234 µV** |

**A placa com o melhor conversor mediu 15-22 dB pior.** Explicação da própria
Electrosmith: *"o STM32 é demasiado bom a regular o próprio consumo — há um
transitório de corrente quando processa áudio no callback."* As placas medem
**~95 dB em modo de arranque**: silenciosas quando o callback não corre.

> **O degrau de corrente do bloco modula a alimentação e cai DENTRO da banda, à
> taxa do bloco.** Isto entra no desenho da carrier como requisito: bulk
> generoso na entrada, e considerar o tamanho do bloco como variável de ruído,
> não só de latência.

⚠️ As medições da Daisy são de amadores (uma via entrada de microfone de
portátil). **Os deltas de ~20 dB são credíveis; os microvolts absolutos não.**

---

## §6 — A entrada dos piezos

### 🔴 PRIMEIRO, O QUE MATA A DISCUSSÃO TODA (9.º estudo)

Ruído intrínseco calculado para cada topologia contra piezos de 10-30 nF,
20 Hz-20 kHz sem ponderação:

> **Todas ficam entre 0,19 µV e 2,5 µV referidos à entrada.**
> **O nosso −75 dBFS medido são ≈178 µV.**

Mesmo um **TL072** — a pior peça que alguém poria aqui — é **~37 dB mais
silencioso que o nosso chão medido**. **Nenhuma escolha de topologia move o
nosso número.**

| referência | chão |
|---|---|
| **nós, hoje** | −75 dBFS ≈ 178 µV ≈ **−72,8 dBu** |
| nós, antes do conserto de terra | −34,2 dBFS ≈ 19,5 mV |
| **o nosso próprio conversor, pela ficha** | −90 dBFS ≈ 32 µV |
| **Grace Design FELiX2**, entrada de instrumento | < **−98 dBu** |
| Fishman Pro EQ Platinum | −89 dBu (A) |
| Headway EDB-2 | −87 dBu |

*"Como os pedais profissionais"* são ≈ **−98 dBu**. Estamos a ≈ **−73**. E
estamos **15-24 dB pior que a ficha do conversor que já lá está** — o ruído nem
chega ao limite do chip.

> **Os 25 dB que faltam são interferência, terra e alimentação** — a mesma
> classe de problema que o nosso conserto de terra já resolveu 35 dB. Nada no
> ruído intrínseco de um pré-amp se move 35 dB.

### 🔴 A ESCADA DE DIAGNÓSTICO, e corre-se antes de desenhar cobre

1. **Curto-circuitar a entrada do pré-amp nos terminais do piezo** e medir.
2. **Curto-circuitar a entrada do conversor** e medir. ⚠️ **Se isto der ≈ −75
   dBFS, o pré-amp é inocente por completo** e todo o trabalho de entrada é
   desperdício.
3. **Desligar e ligar os exciters** com o piezo ligado, e medir o delta.

**Medir SEM ponderação.** A ponderação A esconde exactamente a região de baixa
frequência que um microfone de contacto existe para captar.

### O que fazer na mesma — porque é barato e certo

⚠️ **Estamos na PIOR configuração de terra que existe.** A Endevco TP-270
ordena-as por medição:

| | configuração | veredicto |
|---|---|---|
| 1.ª | transdutor com caixa à terra + **montagem ISOLADA** + amp single-ended | *"o sistema mais simples disponível"* |
| 2.ª | montagem à terra + **amplificador DIFERENCIAL** | o remédio quando não se pode isolar |
| **3.ª** | **montagem à terra + amp à terra** | ⚠️ *"o método mais propenso a ruído"* — **o nosso** |

**Ou isolamos os piezos do corpo** (aceitando que a ressonância de montagem cai
15-30 %), **ou vamos a diferencial. Não fazer nenhuma das duas é a pior
opção.**

### Correcções ao que eu já tinha escrito aqui

1. **O Alex Rice, como publicado, tem os graves destruídos.** `C2`/`C3` = 220 pF
   ficam **em série com o piezo** e dominam a capacitância: corte a **~250 Hz**,
   não os 20 Hz que o autor reclama. A Stompville mediu-o e corrigiu com 22 nF →
   **8,5 Hz**; a aritmética independente dá 8,94 Hz. E a impedância de entrada
   real é **~1,7 MΩ medidos**, não os 3 MΩ documentados.
2. **"1 MΩ chega" para os nossos piezos.** Com 10-30 nF, 1 MΩ já dá 8-16 Hz. O
   folclore dos 10 MΩ vem de elementos **pequenos** (200 pF precisa de 20 MΩ).
3. **Resistência de polarização maior é MAIS SILENCIOSA** — confirmado com
   números: 1 MΩ → 1,02 nV/√Hz referidos a 1 kHz; 22 MΩ → 0,22. O piezo derva o
   ruído da resistência. *"Valores altos são ruidosos"* é **erro** para fonte
   capacitiva.
4. ⚠️ **A TI revisou o ruído do TL072 de 18 para 37 nV/√Hz** em Julho de 2025
   (SLOS080W). **Toda a literatura secundária ainda cita 18.**
5. **Ganho perto da unidade, e com atenuador.** Uma pancada leve num piezo passa
   **1 V de pico**. Com o conversor a ~1 Vrms de fundo de escala, precisamos de
   **margem, não de ganho** — e é por isso que o chão do conversor domina.

### E o que a literatura de instrumentos actuados acrescenta ao acoplamento

- **TI SLAA901**, e é o número que assusta: a saída de um class-D comuta a
  **0,7-2 V/ns**. `I = C·dV/dt` → **250 pF numa borda de 2 V/ns puxam ~0,5 A de
  pico**. Uns poucos pF de dispersão para um nó de megaohms é uma corrente
  enorme. **Nunca usar filtro de saída só com condensador.**
- E do mesmo documento: *"ruído que parece relacionado com a comutação da saída
  pode na verdade estar a irradiar das ligações de alimentação"* — **consertar o
  desacoplamento antes de perseguir o filtro de saída.**
- **Par entrançado até aos exciters, nunca cabo paralelo** (Jim Brown) — sozinho
  pode dar 20-30 dB.
- **Ruído triboeléctrico é de primeira ordem aqui**, não refinamento: o cabo
  está preso a um corpo que estamos deliberadamente a abanar. Cabo de baixo
  ruído com camada de grafite (Mogami W2319/W2524, Canare GS-6, Belden 9239),
  **curto**, e **preso ao corpo junto do transdutor**.

### ⚠️ E as especificações comerciais não se podem comparar

O agente prova-o: a Radial PZ-DI publica *"EIN −98 dBu"* — mas o ruído Johnson
da própria entrada de 10 MΩ que ela declara é **−82,6 dBu**. A figura publicada
está **16 dB abaixo do ruído da própria resistência de entrada** dela. **Nenhum
fabricante declara a capacitância da fonte junto com a figura de ruído.** Os
−128 dB da Grace são a entrada de **microfone** com fonte de 50 Ω, não a de
instrumento.

**Um piezo nunca pode atacar o conversor directamente.** As entradas são de
capacitor comutado; o CS4270 di-lo: *"THD+N degrada-se para impedância de fonte
acima de 1 kΩ"*. O nosso piezo está em megaohms.

**Topologia recomendada: amplificador de carga** (piezo contra terra virtual,
realimentação capacitiva) em vez de seguidor de alta impedância. Resolve três
problemas de uma vez: ganho passa a depender de `C_piezo/C_realim`, logo fica
**insensível à capacitância do cabo**; mata ruído triboeléctrico; e entrega ao
conversor a impedância baixa que ele exige.

⚠️ **Condensadores cerâmicos Classe 2 são microfónicos**, e a placa vai
aparafusada a um corpo que vibra com exciters. **C0G ou filme no caminho do
piezo.** (O GuitarML usa Classe 2 no caminho de áudio.)

**Resultado contra-intuitivo, por confirmar na bancada:** para uma fonte
capacitiva, **subir a resistência de polarização BAIXA o ruído em banda** — a
capacitância do piezo filtra o ruído da resistência, e o integrado tende para
√(kT/C), independente de R. Dois agentes derivaram o mesmo número
independentemente, **mas não há fonte publicada que o diga no contexto do
piezo**. Fica como experiência, não como facto.

---

## §6b — 🔴 O CONSTRANGIMENTO NÃO É PREÇO, É PRAZO (2026-09-29)

Lido em páginas ao vivo da Mouser: **52 semanas de prazo de fábrica em
praticamente todo o conjunto STM32H7.** O preço deixa de ser a variável.

| peça | stock | reposição | papel |
|---|---|---|---|
| **STM32H750VBT6** | **24** | mid-**2027** | o MCU da Daisy, LQFP100 |
| **STM32H7A3ZIT6** | **16** | sem data | **a rota de 1 MB contíguo** |
| STM32H7B3ZIT6Q | 440 | — | idem, LQFP144 |
| STM32H750ZBT6 | **2 432** | — | LQFP144, $8,94/100 |
| STM32H723ZGT6 | **1 582** | — | LQFP144, $9,80/100 |
| STM32H747IIT6 | 34 | 2027-05 | 30 semanas (excepção) |

> ⚠️ **A opção tecnicamente mais interessante é a menos disponível.** O
> H7A3/H7B3 é o que permitiria encolher os buffers para `int16` e eliminar a
> memória externa — e há 16 e 440 peças.

**Só duas peças são simultaneamente baratas, LQFP e disponíveis hoje:**
STM32H750ZBT6 e STM32H723ZGT6, ambas LQFP144.

Isto **reforça** a decisão do §0: uma placa própria hoje seria uma aposta de
abastecimento por cima de todo o resto do risco. E reforça a acção com prazo —
comprar os Seed3 enquanto há.

## §6c — O que as plataformas abertas já resolveram (estudo 7/7)

### ✅ O que a NOSSA carrier já faz certo

Verificado no `cotuca_cerebro`, e coincide com a prática publicada:

| nosso | o que a literatura diz |
|---|---|
| **`OPA1642`** na entrada dos piezos | JFET, 5,1 nV/√Hz. ⚠️ *"não uses MCP6002 na entrada de instrumento — 28 nV/√Hz contra 5,1 é 15 dB de penalização onde mais custa"* |
| **Ilha de AGND com ponte ÚNICA** (`MAPA-DE-TERRA.md` §6) | a decisão que a Daisy empurra para a carrier (`R7 DNI 0R`) |
| **Pré-amp encostado aos jacks, dentro da ilha, pista curta** | o padrão de particionamento por colocação |
| **Malha do piezo ao AGND só de UM lado** | *"nas duas pontas fecha laço"* |
| **`2200 µF` + `100 n` no terminal do amp** | medido a 2026-08-31: sem banco, o exciter zumbe |

**A parte analógica do desenho não é o problema.** Isso é informação: o ruído
que resta não está nestas decisões.

### ❌ O que falta, e é barato

1. **Filtro de reconstrução na saída: `3k3` + `2n2` = 22 kHz.** É o conserto
   comunitário confirmado para a regressão de SNR da Daisy Rev7, e a GuitarML já
   o traz **desenhado de origem** no SoundSketch. Não existe na nossa carrier.
2. **O class-D como DOMÍNIO DE ENERGIA PRÓPRIO** — trilho próprio, ferrite
   própria, retorno de terra próprio e **linha de desligamento por software**
   (Bela cape rev C3 faz exactamente isto com o PAM8406). Temos o banco de
   condensadores, não temos o domínio nem o desligamento.
3. **Filtrar NO amplificador**: LC (10 µH + 220 nF) mais snubber RC (3,3 Ω +
   1 nF), e um RC entre o PVCC e o AVCC do próprio amp (Phil's Lab, TPA3130D2).

### A comparação de conversores medida EM SISTEMA

Blocos de 48 amostras a 48 kHz, mesma placa, mesmo teste:

| codec | chão medido |
|---|---|
| WM8731 | **−79 dB** |
| AK4556 | −92 dB |
| **TAC5242** | **−95 dB** |
| aparelho desligado (chão do teste) | −104 dB |

**+16 dB do WM8731 para o TAC5242, medido, não de ficha.** E o TAC5242 tem
**entradas diferenciais** — o que permitiria atacar o conversor diferencialmente
a partir do pré-amp de piezo e **rejeitar a oscilação de terra entre a entrada e
o conversor**. Isso casa com o achado seguinte.

### O pré-amp de piezo: o número que desqualifica a ligação directa

Um piezo é uma fonte de tensão em série com **5–10 nF**. A impedância de entrada
fixa a frequência de corte:

| impedância de entrada | corte | veredicto |
|---|---|---|
| **30 kΩ** — a Daisy Seed NUA, sem pré-amp | **530 Hz – 1,06 kHz** | desqualificante |
| 1 MΩ — Mutable **Ears** (OPA1641) | 16–32 Hz | funcional |
| **3 MΩ** — **Alex Rice** | **5,3–10,6 Hz** | alvo |

⚠️ **A Daisy Seed não tem buffer de entrada nenhum**: `AUDIO_IN` → 0 Ω → 2,2 µF
→ `LINEIN` do codec. Quem ligar um piezo directamente a ela perde tudo abaixo de
~500 Hz. **É por isso que o nosso pré-amp existe**, e é a razão mais forte para
ele continuar a existir.

**O Alex Rice é um par diferencial JFET, balanceado** — piezo ao centro, bordo
de latão à outra entrada, folha de blindagem ao terra. *"Uma abordagem
single-ended sacrifica 6 dB de ganho"* e é mediamente mais ruidosa.

### 🔴 CORRECÇÃO (8.º estudo): AMPLIFICADOR DE CARGA, não alta impedância

O sétimo estudo recomendou um amplificador de tensão de alta impedância (2-3 MΩ,
op-amp JFET) — que é o que **todos** os desenhos abertos de piezo fazem. **E é
exactamente aquilo por que eles estão documentados como propensos a zumbido.**

Rod Elliott (ESP, Project 202) **construiu e comparou** as três topologias:

> *"O amplificador de carga não tinha praticamente zumbido nenhum. Isto é um
> bónus real, porque era quase impossível eliminar o zumbido na versão de alta
> impedância."* · A versão de alta impedância *"produzia zumbido de 50 Hz
> independentemente da distância a que estivesse de qualquer fonte."*

**E o argumento decisivo é sobre NÓS:** nenhum dos desenhos estudados tem um
class-D na mesma placa. **O nosso tem.** O amplificador de carga **remove a
antena** em vez de tentar blindá-la — a entrada passa a ser terra virtual de
impedância quase nula, imune à capacitância do cabo e ao ruído triboeléctrico.

O mecanismo do zumbido, quantificado (Mudhar): *"a impedância capacitiva de uma
fonte de 15 nF é ~200 kΩ a 50 Hz, e por isso é fácil acoplar zumbido
capacitivamente."* E mediu **NE5534 a 62 dB de S/N contra NE5532 a 49 dB** na
mesma fonte de 15 nF — **13 dB só da escolha do op-amp**.

**Dimensionamento (TI SBOA287):** ganho de ruído ≈ `1 + C_piezo/Cf` (×11 com
disco de 10 nF e `Cf` = 1 nF) · corte inferior = `1/(2π·Rf·Cf)` · `Vout = Q/Cf`.
⚠️ **Não usar a SBOA340** — é uma nota de medição de corrente, e um resumo
automático dela produziu conteúdo plausível e errado sobre amplificadores de
carga.

**Referência aberta completa:** `github.com/arxwtf/2023_PiezoPreamp2` (MIT,
KiCad 7, cada peça com propriedade "Purpose"): **OPA145 JFET singles, um por
canal** — *"dois singles e não um duplo, para minimizar a diafonia"* · `Rf`
10 MΩ · `Cf` comutável 1n/5n7/11n/23n · série de entrada **75 Ω** · ESD por
**TVS bidireccional de ~1,0 pF** (Bourns CDSOD323-T12LC).

**RECOMENDAÇÃO REVISTA: amplificador de carga, com opção de strap para voltar a
alta impedância de 1 MΩ.** As duas topologias partilham o op-amp e quase todos
os passivos — a cobertura é barata.

### O que copiar do Mutable Ears, agora com o esquema traçado

⚠️ O PDF verdadeiro **não está no índice de documentação da Mutable**:
`pichenettes.github.io/mutable-instruments-documentation/modules/ears/downloads/ears_v40.pdf`

Cadeia com as anotações da própria Émilie Gillet: jack → `C3` **68 pF** para
GND (*"LPF > 500 kHz"*) → `C5` 4,7 µF → `R5` **1,0 MΩ** → `R4` **10 kΩ série**
(*"protecção de V+"*) → **OPA1641**. O clamp `D3` BAT54S tem footprint mas está
**DNP**.

**Três coisas a copiar, e a terceira é a mais valiosa:**

1. **68 pF de derivação RF mesmo no jack.**
2. **10 kΩ em série antes do op-amp** — o máximo absoluto do OPA1641 permite
   ±0,5 V para lá dos trilhos se a corrente for limitada a 10 mA, logo 10 kΩ com
   ±12 V tolera ~±112 V no jack. **É por isso que o clamp externo é DNP.**
3. **A evolução.** O antepassado de 2014 (Mikrophonie 2) punha dois 1N4148
   directamente no nó de 1 MΩ, assimetricamente. Gillet moveu o clamp para
   **atrás** dos 10 kΩ, tornou-o simétrico, e depois **despopulou-o**.
   > **Fuga e capacitância de díodo num nó de alta impedância é o erro que ela
   > projectou para fora.**

### Regras de layout do nó de alta impedância (OPA1641 §10.1)

- *"Considerar um **anel de guarda** de baixa impedância, accionado, à volta dos
  traços críticos."*
- *"Afastar os traços de entrada dos de alimentação e de saída o mais possível.
  Se não puderem ser separados, **cruzar perpendicularmente** é muito melhor do
  que em paralelo."*
- Traços de entrada **curtos**.
- ⚠️ **E uma nota de montagem:** limpeza pós-assemblagem e **cozedura a 85 °C
  durante 30 min** depois de limpeza aquosa. **Resíduo de fluxo atravessado num
  nó de 1-10 MΩ é um caminho real de fuga e ruído** — e esta placa vai ser
  retrabalhada à mão.

**Mais:** ligar o **lado de latão** do disco ao terra (Open Music Labs). E
planear o transitório: um piezo percutido *"pode dar saída na ordem dos
quilovolts"* — indicação de clipe no mínimo, limitador a decidir
explicitamente.

### ⚠️ CORRECÇÃO sobre o espalhamento de espectro do class-D

Eu listei-o como medida de ruído. **É mais estreito do que parece:** o
MAX98357A varia a frequência de comutação **±20 kHz em torno de 330 kHz**, e
*"acima de 10 MHz o espectro alargado parece ruído para efeitos de EMI"*.
Ajuda a **emissão radiada acima de 10 MHz** e **não faz nada** pelo fundamental
de 330 kHz a centímetros da entrada. **Não substitui filtragem.**

**E a TI descreve a nossa situação nas palavras dela** (TPA3116 §layout):
*"Pode haver casos em que é necessário acrescentar um filtro LC de reconstrução
completo. Isto pode acontecer se houver circuitos próximos sensíveis a ruído."*
→ **filtro LC completo, não o atalho da ferrite.**

Mais: *"manter o laço de corrente de cada saída, através da ferrite e do
condensador, de volta ao GND, o mais pequeno e apertado possível — o tamanho
deste laço determina a eficácia dele como antena"* · *"todos os terras ligados
no GND do CI, que deve ser o ponto de terra em estrela"* · snubber **18 Ω +
330 pF** com retorno directo aos pinos de GND.

⚠️ **E escolher a frequência de comutação contra o aliasing do nosso ADC**, não
só contra os limites de EMC.

### 🔴 Isolamento galvânico: não é sugestão de fórum, é prática que se vende

A **Electrosmith vende módulos DC-DC isolados** nos produtos dela — `PDS1-S5-S5-M`
e `PDS1-S24-S5-M` — a alimentar o áudio **separadamente do MCU** no Petal e no
Patch.

> **Com um class-D na mesma placa, orçamentar um DC-DC isolado para a
> alimentação analógica desde o início.**

E o banco de condensadores não chega: os 1000 µF deram só ~50 % de melhoria
porque *"condensadores grandes têm resistência interna que limita a eficiência
deles em alta frequência"*. **Bulk é necessário, não suficiente.**

### ✅ A LACUNA FECHOU: existe precedente, e existe o conserto

Eu escrevi acima que ninguém publicou esta combinação. **Estava errado** — há um
caso de primeira mão, do laboratório do **Halldór Úlfarsson** (Intelligent
Instruments Lab), com a mesma geometria: pickups de alta impedância, transdutor
de 20 W accionado por amplificador de 50 W, **tudo no mesmo corpo e na mesma
alimentação**.

**Sintoma:** *"estamos a ter ruído digital na saída de áudio quando a
alimentamos da mesma fonte que o amplificador."*

**Diagnóstico do mantedor da Bela:** *"recomendo uma entrada de alimentação
dedicada (ou seja: **sem terra partilhado**) para o amplificador de potência,
senão vais ter um laço de terra. Em alternativa, se o teu amplificador tiver
entrada balanceada, deves conseguir atacá-lo com sinal balanceado."*

**Resultado:** *"o sinal balanceado parece ser a resolução do nosso problema."*

E o registo longo do mesmo laboratório é o documento mais útil de toda a
pesquisa, porque é um instrumento de realimentação — *"qualquer ruído no sistema
tende a acumular-se"*:

| tentativa | resultado |
|---|---|
| pickups nos 5 V do computador | *"imensa porcaria digital… tão sujo que nem tentámos filtrar"* |
| mesma fonte que computador e amp, **com** regulador e filtragem | *"ainda demasiado sujo… porque os componentes partilham terra e partilham ruído por ali"* |
| **pilha de 9 V dedicada** | *"o mais limpo que conseguimos pôr estes pickups a soar"* |

### 🔴 GANHO EM ANALÓGICO, ANTES DO ADC — não em software depois

Do mesmo registo, e vale para o nosso firmware:

> *"tivemos de acrescentar muito ganho digitalmente… esse ganho digital acabou
> por ser uma fonte consistente de sujidade."*

O conserto foi um **pré-amplificador analógico ×5** alimentado pela mesma pilha.
**O ganho vai antes do conversor.** Ampliar em software amplifica também o chão
de ruído que o conversor já digitalizou.

### 🔴 E O EXCITER ABANA AS TUAS PRÓPRIAS SOLDAS

Segunda falha documentada, piezo de alta impedância e actuador no mesmo corpo: o
ADC entrava em colapso durante a realimentação, e a causa raiz era **mecânica**:

> *"uma má ligação de solda na linha de 3,3 V que ia para os faders e
> interruptores, que às vezes **desligava com as vibrações fortes da caixa
> produzidas pelo altifalante**."*

⚠️ **Isto pode ser o mecanismo da noite de 2026-09-29** — o DPDT desligado, os fios
do OLED, o conector da ponte. *"Consertaremos uma coisa e outra vai estragar"*
deixa de ser azar e passa a ser previsão. **A revisão mecânica tem de contar com
a vibração do próprio instrumento**, não só com a montagem.

### O que a prática de instrumentos actuados (NIME) acrescenta

- **Magnetic Resonator Piano** (McPherson) **evita class-D de propósito** e usa
  um **amplificador de transcondutância** (corrente proporcional à tensão de
  entrada), em **configuração diferencial** *"para que os terras de potência e
  de sinal possam ser separados; as tensões induzidas no terra de potência por
  outros amplificadores cancelam-se"*. E faz **cancelamento antecipativo**:
  o amplificador expõe uma tensão proporcional à corrente do actuador, e
  *"subtraindo uma versão escalada dela, esta interferência é
  significativamente atenuada."*
- **Overtone Fiddle** (Overholt) resolve o acoplamento **mecanicamente**: o
  pickup vai no **fim do braço**, não no corpo, *"o que permite um uso menos
  contido da realimentação gerada por DSP, porque há muito pouca fuga directa
  do actuador embebido no corpo de volta ao pickup."* **Perguntar se o piezo e
  o exciter podem ser desacoplados por colocação antes de os combater
  electricamente.**
- **Berdahl** (CCRMA) prova que um **limitador de RMS no laço de realimentação**
  torna o estado de energia nula localmente assintoticamente estável — com
  prova de Lyapunov. Leitura obrigatória antes de escrever o DSP de
  realimentação.
- **EMvibe** impõe uma restrição de segurança **no software de síntese**:
  *"não podemos enviar uma forma de onda arbitrária. Temos de garantir uma
  pequena porção de tempo desligado no sinal, para não danificar os
  amplificadores."*
- **Lorentz Lap Brass** (NIME 2024), class-D PAM8406 a accionar cordas: *"há
  diafonia electrónica notável entre o circuito do pickup óptico e o sinal
  presente nas cordas"* — **e eles já tinham escolhido pickups ÓPTICOS** para
  serem cegos a campos magnéticos, e mesmo assim apanharam diafonia do class-D.

### ⚠️ CORRECÇÕES a coisas que eu escrevi acima

1. **O Alex Rice NÃO é um amplificador de carga.** É de **alta impedância,
   balanceado, JFET discreto**, com 3 MΩ e realimentação que *aumenta*
   deliberadamente a resistência de entrada. O argumento do amplificador de
   carga pertence ao **Rod Elliott** e ao **LOM Elektrosluch** — não a ele. A
   recomendação de carga mantém-se; a atribuição estava errada.
2. **🔴 O TPA3116D2 NÃO TEM espalhamento de espectro.** Uma busca no texto
   integral do datasheet dá **zero** ocorrências de *"spread"*. Tem selecção de
   frequência por pinos (`AM0/AM1/AM2` → 400/500/600/1000/1200 kHz) e um pino
   `SYNC`. **Eu recomendei-te ligar espalhamento de espectro — no nosso
   amplificador isso não existe.** Ele vive na família TAS58xx, por registo.
3. **O MAX98357A comuta a 300 kHz**, não 330 (a ficha contra o guia da
   Adafruit).

### As duas recomendações que passam a ser as primeiras

> **(a) Alimentação separada e SEM TERRA PARTILHADO para o amplificador dos
> exciters, com ligação BALANCEADA da metade sensível para a metade que
> comuta.** É o conserto que funcionou no único caso de primeira mão com a
> nossa geometria, é o que a Electrosmith vende, e é o que o McPherson desenhou
> de origem.
>
> **(b) Ganho em ANALÓGICO antes do ADC**, nunca em software depois.

### 🔴 E a parte que continua sem medição

Três fontes primárias **discordam** sobre plano de terra dividido ou contínuo ao
lado de uma entrada sensível: o TAS5825M pede plano contíguo, o TPA3116D2 pede
estrela no CI, e a Adafruit divide AGND de PGND com uma ferrite. **Não existe
medição que compare as três numa placa com piezo à entrada e class-D à saída.**
E **nenhuma fonte primária dá uma distância física mínima** entre um class-D e
uma entrada de alta impedância.

> **Deixar opções de layout na primeira versão:** footprints de ferrite, e um
> jumper de dividir-ou-unir. Isto prototipa-se, não se lê.

### Duas coisas que contrariam suposições comuns

- **2 camadas chegam.** O catálogo inteiro da Mutable Instruments é de **2
  camadas** (Clouds 106×89 mm, Elements 106×164 mm) com desempenho de ruído
  excelente. Quatro camadas é o padrão, não é requisito.
- **A Electrosmith FECHOU o esquema da Daisy de propósito.** Andrew Ikenberry:
  *"o esquema público passou a ser um esquema reduzido — não vamos fornecer
  toda a informação necessária para clonar a Seed existente."* O módulo que
  estamos a usar já não é um desenho de que se possa aprender.

### Erratas alheias que valem como nossas

- **Ksoloti v0.3 INVERTEU a decisão de terra do Axoloti**: *"3.3VA e GNDA agora
  reservados só para áudio e codec; 3.3V e GND para o digital e também para o
  ADC/DAC do STM32."* Mesma família de placa, decisão oposta, dois anos depois.
- **OWL2, notas de bancada:** *"mover o C408 de 100 n para junto do pino VA"*
  levou o ruído de VA de **60 mV para 40 mV**. Colocação de desacoplamento
  descobre-se na bancada, não no DRC.
- **Axoloti:** alargar um furo de fixação curto-circuitou dois planos de energia
  internos e matou o regulador. **Zona de exclusão entre furos e planos.**
- **GuitarML, arrependimentos declarados pelo próprio autor:** cerâmicos Classe 2
  no caminho de áudio (por preço), **sem pulldown de hardware no BOOT0**, e
  **wipers dos pots directos ao ADC sem resistência em série nem condensador** —
  este último é o único defeito claro num desenho de resto cuidadoso.

## §7 — O que falta, e o que NÃO foi verificado

**Estudos: 7 de 7 fechados.** ⚠️ A frente de **exciters/class-D** é a mais
fina — um agente paralelo falhou ao arrancar e foi coberta de segunda mão.
Merece uma passagem própria: class-D de entrada I2S (TAS5805M, MAX98357A)
contra entrada analógica, limites térmicos e de impedância dos exciters, e
falhas documentadas de acoplamento de class-D em entradas de alta impedância.

**Lacunas declaradas, para ninguém as tratar como factos:**

- ~~Zero preços da Mouser/DigiKey.~~ **FECHADO a 2026-09-29** por leitura em
  navegador real. Onde as duas fontes coincidem, **batem ao cêntimo**:
  H750VBT6 $7,81/100, H723ZGT6 $9,80/100, H7B3ZIT6Q $9,75/100 na ST **e** na
  Mouser. A tabela de preços está validada por duas fontes independentes.
  Continua sem preços da DigiKey além da unidade (páginas atrás de verificação
  interactiva que não se contorna).
- **Preços de PCB da JLCPCB são DERIVADOS**, não cotados: a ferramenta exige
  login e Gerbers. **Correr antes de orçamentar.**
- **Se a JLCPCB permite ENIG no serviço Económico** — vale ~$75 de uma vez.
- **Impostos de importação do Brasil** — fontes de 2026 contradizem-se. A
  conclusão robusta é que **o Brasil duplica o custo à chegada**; as
  percentagens não são de confiar.
- **O argumento verbatim de Rick Hartley contra dividir o plano** — atribuído
  universalmente, sem transcrição nem artigo encontrado.
- **Nenhuma medição de EMI comparando SDRAM com Octo-SPI existe** em nada que
  os agentes encontraram. Os argumentos de contagem de pinos e de excursão de
  tensão são raciocínio de primeiros princípios. **Se quisermos saber, medimos
  nós.**
- **A SDRAM da Daisy pode já ser de 1,8 V** (a AS4C16M32MSA é a peça *mobile* da
  Alliance). Se for, metade do argumento de ruído sobre excursão de tensão não
  se aplica ao nosso caso — a metade da contagem de pinos aplica-se na mesma.
- ⚠️ **TERCEIRA ocorrência do mesmo defeito de método:** um resumo de busca deu
  o H750VBT6 a **$9,10 com 9 258 em stock**; a página ao vivo diz **$12,06, 24
  unidades, 52 semanas**. Não se cita preço que não tenha sido lido numa página.
- ⚠️ **O sumarizador de busca fabricou preços e resumos repetidamente** durante
  esta pesquisa — o mesmo preço para quatro peças diferentes, e a inversão do
  sentido de um documento da TI. **Todo número aqui foi lido de uma página, não
  de um resumo.**
