Belquer/Cotucatronics/docs/operacao/ROTEAMENTO-CEREBRO.md

# Lista de roteamento — cerebro

Gerada por `kicad/lista_roteamento.py` v0.3.1 em **2026-09-08**, commit `1dca972`.  
⚠️ **Não comitado**: `kicad/cotuca_cerebro/cotuca_cerebro.kicad_pcb`, `kicad/faz_placa.py`, `kicad/roteia_fr.py` — a placa pode não corresponder a este commit.

**0 ligações**, mais **0 pad(s) que perderam o plano** — 0 no total, que é o que o DRC diz. Tudo o resto já está feito e o DRC dá geometria zero com os planos inteiros, o que quer dizer que **o que desenhares tem de continuar a dar isso**.

Depois de as fazeres, o portão diz se ficou bom:

```bash
python3 kicad/para_fabrica.py cerebro
```
