Belquer/Cotucatronics/docs/battle_scars.md

# Battle Scars — Cotucatronics
<!-- doc-check: ignore lib_id (campo do formato .kicad_sch, nao param) -->
<!-- doc-check: ignore lib_symbols (seccao do formato .kicad_sch, nao param) -->
<!-- doc-check: ignore nogueira_6p4 (perfil de dentes da caixa (6,4 mm), nome de configuracao) -->
<!-- doc-check: ignore acrilico_3p0 (idem, para acrilico de 3,0 mm) -->
<!-- doc-check: ignore confere_furos (portao em tools/, fora do alcance do check_docs) -->
<!-- doc-check: ignore arruma_silk (ferramenta em kicad/, fora do alcance do check_docs) -->
<!-- doc-check: ignore refs_apontam (ferramenta em kicad/, fora do alcance do check_docs) -->
<!-- doc-check: ignore kicad_layout (nome de skill, nao param) -->
<!-- doc-check: ignore funcao_dos_pads (ferramenta em kicad/, fora do alcance do check_docs) -->
<!-- doc-check: ignore pcb_contorno (ferramenta em kicad/, fora do alcance do check_docs) -->
<!-- doc-check: ignore confere_arcade (funcao do pcb_contorno, em kicad/) -->
<!-- doc-check: ignore para_fabrica (ferramenta em kicad/, fora do alcance do check_docs) -->
<!-- doc-check: ignore portao_humano (script da skill aipcb, em .claude/skills/aipcb/scripts/) -->
<!-- doc-check: ignore confere_caixa (idem) -->
<!-- doc-check: ignore confere_acesso (idem, vive no pcb_contorno.py) -->
<!-- doc-check: ignore silk_over_copper (codigo de violacao do DRC do KiCad) -->
<!-- doc-check: ignore route_l_a  (nome ANTERIOR da matriz, renomeado em 2026-09-02 para `route_a_l` — entrada primeiro, saida depois. A mencao aqui e o REGISTO do que se aprendeu com o nome velho; apaga-lo apagava o que explica a cicatriz.) -->
<!-- doc-check: ignore route_l_b (idem) -->
<!-- doc-check: ignore route_r_a (idem) -->
<!-- doc-check: ignore route_r_b (idem) -->
<!-- doc-check: ignore in_gain_a (REMOVIDO em 2026-08-28 — cicatriz 15v. O nome aparece aqui porque a cicatriz E sobre a remocao dele; apaga-lo apagaria o assunto.) -->
### O que o firmware nos ensinou enquanto a gente o ensinava a cantar
*Registro de aprendizados — resultados e metodologia. Atualizado ao fim da caçada do shimmer ardido e dos dois controles de I/O.*

---

## 0. Por que este documento existe

O Cotucatronics saiu do zero até um instrumento com delay, cross-synthesis espectral com portadora própria, stack anti-feedback completo e randomização por transiente ("Búzios") em poucas semanas de bancada. No caminho, cometemos e catalogamos dezenas de erros — e o padrão mais valioso que emergiu não foi nenhum truque de DSP: foi **uma disciplina forense de bancada**. Este documento registra as cicatrizes para que os próximos módulos, esculturas e colaboradores herdem as lições sem pagar o preço de novo.

Personagens: **dB** (design de instrumento, patches Max, ouvido e decisões musicais), **Claude Code** (compilação, gravação, medição em hardware), **Claude chat** (arquitetura, hipóteses, prompts, auditoria externa via /gitsync). O triângulo funciona porque cada vértice pode vetar os outros dois com dados.

---

## 1. As três famílias de bug de ordem

Todos os bugs graves de firmware desta fase tinham **lógica correta e ordem errada**. Eles caem em três famílias, e distinguir a família importa porque o conserto difere.

**Família A — Corrida de contexto.** Dois contextos concorrentes (callback de áudio vs loop principal vs ISR), com a proteção armada num e a condição acontecendo no outro. Casos: despacho serial rodando na ISR (travava a placa no comando `list`); a janela de graça armada no loop enquanto o bloco caro rodava no callback (duas vezes). Conserto: **mover o armar para junto do checar — mesmo contexto, sempre.** Corolário: toda flag que cruza callback↔loop é `volatile` (ou atomic).

**Família B — Ordem de configuração.** Sem concorrência nenhuma; sequência errada dentro de uma função só. Engana mais justamente porque o código lê certo de cima pra baixo. Casos: `bind[]` preenchido antes do `Add()` dos params; `RequestBlockSize` depois do `Init()` dos módulos (módulos preparados pra bloco 48 recebendo 256 — estouro de heap silencioso rodando por baixo de medições que pareciam limpas). Conserto: **quem configura vem antes de quem consome.** Risco de confundir com a Família A: leva a "sincronizar" o que só precisava ser reordenado — resposta cara pra problema barato.

**Família C — Variável com dois empregos.** Uma coisa servindo a dois propósitos, e um teste (ou conserto) mexendo nos dois de uma vez. Casos: o `DelayMs(1)` era relógio do loop **e** metrônomo da rampa — removê-lo para testar o relógio destruiu a rampa junto, contaminando a conclusão auditiva do voo; o `@title`/classname default servindo a todos os exports até colidir. Conserto: **antes de mexer numa variável, listar todos os empregos dela.** No desenho experimental: um voo, uma variável — e conferir que a variável é mesmo uma.

---

## 2. A família da instrumentação que destrói o dado (8 casos)

A lição mais repetida do projeto, cometida inclusive **depois de nomeada**. Instrumentação é código de produção e falha como código de produção.

1. A janela de graça **zerava o medidor** e apagava o pico de estreia — o dado que ela existia para revelar.
2. A sonda de perfil **se sobrescrevia** a cada ativação: a medição barata apagava a cara.
3. O filtro `grep` da sessão de leitura **escondia a linha de erro** que explicava a falha.
4. Os contadores `static` **zeravam no boot da sessão de leitura** — medíamos a leitura, não o voo.
5. Os marcadores do HAL gravavam **fora do portão** `bb_rec` — o comando `bb` da autópsia contaminava a cena do crime.
6. O `BlackboxArm()` ligava **no meio do processamento de uma linha serial** — M1/M2 pareavam eventos de linhas diferentes e produziram um álibi falso (M1==M2 "provando" que nenhuma linha prendia).
7. As ~20 escritas/volta com `SCB_CleanDCache` viraram **suspeitas de criar o defeito que mediam** (inocentadas depois, mas o voo enxuto precisou existir para isso).
8. **O mudo sem porta de saída (2026-08-18).** O comando `bb arm` chamava `LogMute(true)` e **não existia nenhum caminho de volta** — a flag só zerava no boot. Quatro janelas seguidas de teste de MIDI reportaram "0 CCs" e eu li como link morto. O log estava mudo **porque eu mesmo tinha armado a caixa-preta numa janela anterior**: cada medição seguinte mediu o meu próprio silêncio.

**A escalada, nomeada: números → conclusões.** Os casos 1 a 7 estragaram *medições* — um pico perdido, um perfil sobrescrito, um contador zerado. O caso 8 estragou uma *conclusão*, e a conclusão foi **publicada**: com base nesses quatro zeros eu commitei neste documento uma causa errada para a falha de MIDI (ver o adendo no capítulo 11). Instrumentação quebrada não para na planilha — ela chega ao registro permanente, e de lá volta como premissa da sessão seguinte.

**O agravante:** o próprio comando avisava — `"caixa-preta armada; log mudo ate o proximo reset"`. A mensagem saía **uma vez**, no armamento, e eu nunca a li porque vinha antes das linhas que eu estava esperando. **Aviso que aparece uma vez não é aviso; é sorte.**

**O antídoto (v0.39.0): todo comando de status denuncia os modos que silenciam.** `board`, `midi` e `mscope` imprimem `[LOG MUDO]` no cabeçalho. E o ponto fino, que é a lição de desenho: **a declaração tem que ser imune ao modo que declara.** Um banner impresso pelo `Log()` normal morreria mudo junto com todo o resto — por isso existe `LogAlways()`, que atravessa o mudo, e só o banner o usa. Antídoto que pega a mesma doença não é antídoto.

Esse antídoto é o **mesmo** da cicatriz 7 do capítulo 3 (o rótulo que mentia, "transições: NENHUMA" impresso com todos os contadores zerados): as duas falhas são o instrumento **não declarando o próprio estado**, e as duas se curam obrigando-o a declarar.

9. **O watchdog que condenou o inocente (2026-08-18).** O CTOS ganhou veto
   automático: efeito que estoura o prazo entra em bypass. Na primeira
   execução ele mediu **4 277 071 629 µs** — lixo, assinatura de subtração
   estourada — leu como estouro e **desligou o freeze**, que gastava 35 µs de
   500. Os 15 s de "aceite do freeze" que rodaram em seguida foram, na
   verdade, 15 s do instrumento **sem freeze**, e eu quase os apresentei como
   resultado.

**A escalada completa a família: números → conclusões → AÇÕES.** Os casos 1–7
corromperam *medições*. O caso 8 corrompeu uma *conclusão*, e ela foi
publicada. O caso 9 **agiu**: não relatou errado, ele *mudou o sistema* com
base no erro.

> **Um instrumento que só observa erra e alguém percebe. Um instrumento que
> age erra e altera o sistema antes de alguém perceber.**

**A regra:** todo mecanismo automático de veto exige **teste de
plausibilidade antes do gatilho**. Amostra implausível é **descartada e
contada**, nunca julgada — e o contador aparece no status, senão o descarte
vira outro silêncio. Juiz que aceita prova corrompida condena o inocente.

**Regras destiladas:** dado de evento único grava uma vez e **trava** (não atualiza). Estado vence contagem (o token de voo `in_flight` é imune ao problema do armamento; contadores pareados não são). A caixa-preta arma **por comando explícito no início do voo**, nunca no meio de um fluxo. A sessão de leitura não escreve nada. Escritas em backup SRAM em **lote** (acumular em DTCM, um flush por volta ou por evento, struct `alignas(32)`).

---

## 3. Medir antes de concluir — os casos que provam a regra

**O freeze condenado pelo número errado.** Primeira medição: 233.965 µs — "impossível". A separação estreia/regime revelou 3.520 µs de regime: faltava 2,1×, não 88×. Sem separar, teríamos cortado o patch com o número errado. **Estreia é o preço da mudança; regime é o aluguel. Nunca julgar aluguel pelo preço da mudança.**

**A estreia morava no hop, não no primeiro Process.** O warm-up desenhado por intuição (uma chamada de silêncio) não teria consertado nada — o bloco 1 era barato; o custo caía no bloco 2 (primeiro hop) e decaía em dois hops. A medição bloco-a-bloco corrigiu o desenho: warm-up cobre ~4096 amostras. **A prova de que funcionou não foi o tempo — foi a memória aparecer no lugar certo** (14 KB migrando pro `MemReport` do Init).

**Pico decide, média mente.** Um módulo de FFT: média 7,8%, pico 210%. Custo FFT concentra no bloco do hop (1 a cada N). O watchdog julga o pico. Corolário do bloco: dobrar o bloco dobra o prazo mas o pico sobe junto (~19%) — **dobrar o bloco não dobra a folga.**

**`-O3` piorou.** Binário +13%, média de CPU +15% — app executando da QSPI paga I-cache miss por byte de código. **Nesta plataforma, código menor é código mais rápido.** Regra registrada: ao reverter, remedir tudo (todos os números têm -O3 como base).

**Fixar parâmetro no Max não remove o DSP.** Cirurgia de "fixar valores": 12% menos código, **0% menos CPU**. Parâmetro congelado é alavanca colada, não motor desligado. Corte de custo exige **deletar objetos de sinal**. Rota preferida para módulo pesado: construir do piso e devolver luxo por luxo com etiqueta de preço — não desbastar patch rico.

**Frequência bater com suspeito não é identificação.** Duas fontes distintas produziam 1 kHz; a conclusão inverteu duas vezes até o teste que **remove** uma fonte separar as duas. Identificação exige manipulação, não coincidência.

**Suspeitar não é medir.** O estouro de heap (Família B) "provavelmente não distorcia o tempo de FFT" — e não distorcia. Mas só a remedição completa permitiu afirmar. Números publicados com defeito ativo por baixo foram **invalidados e remedidos**, mesmo os que estavam certos por sorte.

**Teste que passa merece a mesma desconfiança que teste que falha.** O bug do zsh (word-splitting) deixou um teste "passar por acaso" no pino 18; só o silêncio inesperado no pino 19 o expôs. A expectativa violada revela o que a expectativa confirmada esconde.

**RMS ≠ pico.** O medidor reportava RMS; senóide tem pico 3 dB acima. −1,1 dBFS RMS = ADC da interface clipando — e o governor pareceu errado por causa do instrumento de medição, não do firmware. Conhecer a unidade do próprio medidor é pré-requisito de qualquer conclusão.

**O assassino confirmado por protocolo.** `hal::DelayMs(1)`: quatro voos, mesma instrumentação, **uma variável** — 1.505 voltas/morte aos 12,6 s com ele; 8,7 M de voltas/vivo sem ele; religado, morte de novo; removido, vivo de novo. Discriminante e conserto no mesmo protocolo. É o padrão-ouro: quando a hipótese sobrevive à reintrodução do suspeito, ela vira fato.

---

## 4. Cultura de hipótese (como erramos melhor)

Hipóteses erradas com testes certos resolveram o projeto. O diagnóstico "cycle~ a 0 Hz por eventos não propagados" errou o mecanismo exato — mas o **teste de um comando** (um `set` de uma nota) que ele gerou apontou a região certa e destravou tudo. **Teste bom sobrevive a hipótese ruim.** Registrar apostas com percentuais ("60% relógio, 30% instrumentação, 10% resto") mantém o placar honesto e ensina a calibrar.

Derrubar a própria hipótese com dado é vitória, não derrota: o M1==M2 derrubou a hipótese da prisão no line_cb — e depois o furo do M1==M2 (armamento no meio da linha) a reabilitou — e depois o token a derrubou de vez. Três reviravoltas, todas por medição, nenhuma por teimosia.

Quando as hipóteses acabam, **pedir olhos novos com um relatório estruturado**: contexto, medições contraditórias, o que já foi descartado *com o dado que descartou*, e perguntas numeradas. Os melhores destravamentos da caçada vieram de relatórios assim.

---

## 5. Fronteiras de arquitetura (o que nos salvou repetidamente)

**HAL:** includes de fabricante só em `hal_<board>.cpp`. Trocar de cérebro = um arquivo + uma entrada de Makefile. Auditado em clone limpo múltiplas vezes; nunca violado.

**Módulos:** headers do motor externo só nos `.cpp` de módulo; o `main` fala com `Module`, nunca com motor. A fronteira fechou inclusive a porta dos fundos (as estatísticas de alocação passaram a sair por `Module::Memory()`).

**Portão único da SDRAM:** `AllocBig()` é o único acesso; `DSY_SDRAM_BSS` proibido fora do HAL. O linker passou a **auto-aplicar** a regra (pool reivindica a região inteira; clandestino nem linka).

**Manifest = identidade do instrumento.** Params, macros, requisitos, bloco, cercas de sorteio, máscara de escala, mapa MIDI — tudo dado, nada código. Trocar escultura = trocar manifest + módulo. `Requirements` conferidos no boot: cérebro insuficiente recusa com log claro, nunca bug misterioso no palco.

**Get/Shaped/Real — três consumidores, três moedas.** Knob lê `Get` (norm cru), módulo lê `Shaped` (norm curvado), humano lê/escreve `Real` (unidades). O bug do push com `Get` (curva invisível pro DSP) e o do `set` normalizado (bench_boost "1.0" entregando 8×) nasceram de misturar moedas. A borda serial fala unidade humana; o miolo fala norm; a conversão vive na borda.

**Repo versiona o instrumento; bancada é estado transitório.** O default do repo é o que a placa É quando alguém clona e grava. Modo bancada vira *receita documentada*, nunca estado commitado.

**Clone limpo é o teste.** O cabeçalho de alocação do módulo, nunca commitado, ("funciona na minha máquina" por semanas) gerou o `make check` — que **na primeira execução** pegou outro defeito (export do freeze não rastreado). Hábito automatizado vence hábito lembrado; a prova é que a checagem manual recém-escrita não teria pego o segundo caso.

---

## 6. Patch embarcado — o manual das cicatrizes

**Domínios evento vs sinal são a fonte nº 1 de bug de patch.** A régua: *olha a boca de quem come.* Freq de `cycle~` (nesta versão) = evento (param → expr → cycle~, direto). Ganho de `*~` = sinal (param → `sig~` → inlet). `delay~` (sinal) ≠ `delay` (evento). Operadores que alimentam entradas de sinal precisam ser variante `~`. Feedback fecha **só** com `feedback~` no ciclo. Na dúvida: autocomplete descreve, help patcher demonstra — copiar exemplo vivo venceu três vezes.

**Memórias:** `data @external 0` tranca como interna; `buffer~` é externo *por natureza* (o @external não pega). Receita oficial: **janelas matemáticas são do host** (firmware aloca via AllocBig, gera sqrt(hann), entrega via dataref, lendo o tamanho do próprio dataref); **memórias de estado são do patch** (`data @external 0`). Dataref se resolve **por nome**, nunca por índice (reexport reordena). `poke~`/`peek~` referenciando nome inexistente cria buffer externo fantasma no Max — funciona lá, sai mudo na placa.

**Custo:** todo `buffer~` custa **8 B/amostra** (Float64Buffer, ignora a macro de float32) + arredondamento pra potência de 2 — estimativa ingênua erra por até 4×. Patch grande mata por **tempo**, não memória (freeze: 2% da SDRAM, 275% do prazo). Custo FFT concentra no bloco do hop.

**Embarque:** o runtime de desktop é inutilizável — o export entra como fonte, com um motor mínimo. As macros de configuração têm de vir **antes** dos includes: chegar depois é o mesmo que não existir, e a falha é silenciosa. Alocador híbrido (pool SRAM → AllocBig), free no-op, memória vitalícia. **O motor precisa ser dirigido:** `processEventsUntil()` + `advanceTime()` por bloco — sem isso, relógio preso em 0, nenhum evento executa, patch com portadora interna sai mudo. **Warm-up no Init** (política de slot, ~4096 amostras de silêncio) paga a estreia no boot. **Re-kick de params pós-warm-up** (reenviar todos os valores com o motor vivo) mata a classe "estado inicial que não propagou".

**Conferência pré-embarque do `description.json` é obrigatória e já pagou três vezes:** datarefs externos inesperados, params faltando (um param de mistura sumido), saída mono onde o slot espera par, classname default. Ler o JSON custa um minuto; um módulo mudo custou horas.

**Cross-synthesis é peneira:** só devolve energia onde molde e portadora coincidem. Senóide × drone esparso ≈ silêncio (e "sem diferença perceptível" que não era bug). **Banda larga é a régua de cross-synthesis; senóide é a régua de delay e shifter.** Cada efeito tem seu material de prova.

---

## 7. O loop principal sob carga (a caçada do DelayMs)

Com a carga a 65% do bloco, o mundo do loop principal muda de clima e três verdades ficaram gravadas:

**Serial USB é hostil sob carga.** As rajadas de ~3,4 ms do callback starvam a ISR de USB; o CDC do host apodrece; transmit pode não retornar. Hierarquia de canais promovida a arquitetura: **caixa-preta = registro de voo** (sempre); **serial = telemetria oportunista** (quando o universo colabora); **MIDI = controle** (imune). `Log()` com orçamento duro (descarta e conta, nunca espera); destino final: ring buffer kick-and-forget drenado por ISR — o loop nunca toca o USB.

**Detecção de host morto é responsabilidade nossa.** `dev_state`/TxState não detectam host que some sem avisar. Dead-man por timeout de conclusão + rearme por RX. E o gate protege as chamadas *seguintes* — não a que já entrou: por isso "3 falhas que retornam" não pega "1 chamada que não retorna".

**Rampa por tempo, não por volta.** Rampa que avança um passo por iteração amarra duração musical à saúde do loop (Família C: o DelayMs era o metrônomo dela). Desenho certo: `t = (NowMs − start)/dur`, lerp puro, sem estado incremental — qualquer volta reconstrói o valor do zero, loop degradado só espaça as avaliações, a rampa termina no prazo aconteça o que acontecer.

**Starvation ≠ prisão, e a célula que distingue:** contador de voltas *completas* no fim do while(1) + timestamp. Parado = prisão (e o token diz dentro de quê); lento = starvation (e a resposta é tirar trabalho do loop, não priorizar).

**Desfecho (2026-08-16, fechado).** Assassino nomeado e removido; feature entregue. A **ordem dos consertos importou tanto quanto os consertos**: a rampa teve que virar função do relógio **antes** de o `DelayMs` sair, senão remover o metrônomo teria quebrado a música ao consertar o loop. Foi o único momento da caçada em que consertar na ordem errada teria produzido um segundo bug enquanto apagava o primeiro.

A assinatura que apontou o culpado antes de qualquer medição confirmar foi a **forma da falha, não a magnitude**: o loop primeiro *degradava* (8 ms por volta em vez de 1) e só depois *parava de vez*. Cache degrada linear e não mata; relógio quebra de uma vez. E o mecanismo ficou provado pelo carimbo de tempo, escrito **imediatamente antes** do delay — o loop chegou lá aos 12 674 ms e nunca mais voltou: entrou e não saiu.

Commits: [`b9e5365`](https://github.com/Belquer/Cotucatronics/commit/b9e5365) (rampa por tempo) → [`bbf7f84`](https://github.com/Belquer/Cotucatronics/commit/bbf7f84) (DelayMs fora, com a tabela dos quatro voos) → [`7960f1d`](https://github.com/Belquer/Cotucatronics/commit/7960f1d) (Búzios, T13 aprovado, catálogo forense).

**Pendências herdadas da caçada**, que o documento deixa em aberto de propósito: o ring de log *kick-and-forget* (o loop nunca toca o USB) segue como refactor certo e não feito; a serial ainda morre sob carga, contornada por `log_mute` + caixa-preta + MIDI; e o estado do repo é de **bancada** (dinâmica neutralizada do A/B com o Max), esperando a decisão do dB sobre quanto de proteção volta e a que custo tímbrico.

---

## 8. Hardware — o que a medição decidiu

O piezo grande direto na entrada da Daisy preserva nível e grave — **opamp dispensado por medição** para este disco (receita do buffer arquivada para piezos menores/cabos longos). Proteção passiva (1k + 2×1N4148) recomendada antes do exciter: barata, invisível ao som, blinda o codec contra picos de impacto. O apito e o crackling eram **anel de terra do USB do computador** — somem na bateria, que já era o projeto; resíduo de 1 kHz a −90 dBFS é nosso (taxa de bloco) e inaudível. Pots são 3 fios + 100 nF no trilho analógico; botões, 2 fios + pull-up interno. **A física venceu a teoria duas vezes** (buffer, e a compensação de pitch que um simples 0.33→0.02 resolveu melhor que a fórmula) — o ouvido tem poder de veto sobre a elegância.

---

## 9. Búzios — o resultado que as cicatrizes compraram

Cada transiente na escultura é uma jogada; o que cai decide o timbre. `dly_time` sorteia em degraus de 50 ms **em unidade real** (a curva 2.5 entortaria sorteio uniforme em norm — mais uma vez, a moeda certa no lugar certo); a carta de nota do Fx2 sorteava nota a nota **sempre em Lá menor natural** (máscara de escala é dado de manifest; a base 110 Hz já é Lá, então a máscara nasce afinada); knob manual segue cromático — *a máquina se comporta, a mão pode tudo*. Cerca de segurança inegociável: level, gate, governor, limiter, routing e src_mix jamais sorteáveis. Aceite: **1 minuto de taps, 74 transientes, 74 sorteios — razão 1:1, julgada pelo músico.** O critério final de qualquer feature é o ouvido de quem toca; caixa-preta prova encanamento, não flor.

---

## 10. O dia 2026-08-17 — quatro cicatrizes

**Estado de diagnóstico que sobrevive ao diagnóstico.** O `level` ficou em 0.4 desde o A/B com o Max e virou default do repo por três commits, junto com gate e governor desligados. Pior que o descuido: eu **documentei a violação no STATUS como temporária** e segui em frente. Registro que se sabe errado e não conserta não é aviso — é permissão. O dB só descobriu indo tocar o instrumento real. É prima da instrumentação-que-apaga-o-dado, mas pior: aquela estraga a medição, esta estraga o instrumento, e some do radar justamente por estar anotada. **Estado de bancada tem prazo, e o prazo é a mesma sessão.**

**Regra que sobrevive ao motivo.** O `fx2_on` nascia em bypass pra proteger de um risco que a medição já tinha eliminado — o módulo em 37% do prazo, watchdog funcionando, morte do loop com outra causa já consertada. A regra continuava cobrando preço (o dB encontrou "só o delay" seis vezes num dia) por um perigo que não existia mais. E o custo era invisível de um lado e óbvio do outro: **quem escreve a regra não é quem aperta o RESET.** Regra de segurança precisa de data de revisão, senão vira superstição.

**`bytes 0` tem três causas, e a ordem de suspeita muda com o contexto.** No dia da solda é cruzamento TX/RX (o guia manda desconfiar dele primeiro, e está certo). Depois que o fio está provado, é quase sempre o **link BLE** — que cai sozinho, some depois de RESET, e é derrubado por outro central que se conecte ao mesmo periférico. No palco vai ser sempre essa. Receita: *esquecer o device → parear de novo → reiniciar o app que manda*. E **"conectado" num app prova que aquele aparelho tem o link, não que o CC sai de lá** — BLE MIDI costuma aceitar um central por vez, e um segundo app toma a conexão em silêncio.

**Guardar um teste que passa é guardar um instrumento.** O que fechou o caso do MIDI foi um teste que já tinha passado: mesmo botão, mesmo CC, funcionara vinte minutos antes e parou sem ninguém tocar no firmware. Referência conhecida-boa vale mais que hipótese nova — se o que funcionava parou e o firmware não mudou, o firmware não é o suspeito.

### O corolário que atravessa as quatro: replace que falha calado

Duas destas cicatrizes quase não existiram — o script que as escrevia usou uma âncora errada, o `replace` não casou, **não deu erro**, e eu reportei como feito. O mesmo padrão já tinha comido uma célula de instrumentação inteira (o `VOLTAS=0, nan` que eu li como bug de escopo e era **código que nunca foi inserido**).

**Edição programática sem verificação é a mesma família da instrumentação que apaga o dado**, aplicada ao próprio ato de documentar. Regra: `assert` na âncora antes de substituir, e `grep` depois pra confirmar que entrou. Ferramenta que falha calada mente com a mesma confiança com que acerta.

---

## 11. MIDI, BLE e a hora que eu gastei trocando de suspeito (2026-08-17)

**O teste que elimina variáveis vale mais que dez que trocam de suspeito.**
Passei uma hora atrás de um MIDI que não chegava, e troquei de hipótese
cinco vezes — link BLE caindo, fader desconfigurado, app sem autorização,
DMA abortado, controlador mandando dump. **Nenhuma foi confirmada nem
descartada com evidência.** O dado era sempre o mesmo (`bytes 0`) e a
explicação era nova a cada rodada.

O **loopback** (jumper D13→D14, comando `midiloop`) resolveu em dez
segundos: mensagem sai pelo TX, volta pelo RX, percorre UART → DMA → ISR →
fila → parser → mapa → parâmetro. Passou com 113 mensagens, zero órfãos,
zero ressync, zero perdidos. **A placa inteira provada, e o problema
isolado fora dela.**

Ele estava disponível desde o começo, na fila congelada esperando um fio.
A regra: **quando o mesmo sintoma se repete pela terceira vez, pare de
gerar hipóteses e procure o teste que corta o sistema ao meio.** Trocar de
suspeito parece progresso e não é — é a mesma medição vestida de nova.

**E a causa real, achada pelo dB depois de eu esgotar cinco hipóteses: o
pareamento BLE não sobrevive ao reset da placa.** Todo `bytes 0` da tarde
veio depois de um reset sem reparear; todo sucesso veio depois de parear.
Não era link instável, nem 5V no pino de 3V3, nem brown-out do rail, nem
central competindo — era procedimento de operação que ninguém tinha
escrito. **Gravar e testar MIDI não cabem no mesmo ciclo.**

> **ADENDO DE 2026-08-18 — esta conclusão foi publicada em cima de silêncio
> auto-infligido.** Ela continua acima, sem corte, porque o registro do
> que eu concluí importa tanto quanto a correção.
>
> As quatro janelas de "0 CCs" que sustentaram o *"não sobrevive ao
> reset"* aconteceram **com o log mudo pelo meu próprio `bb arm`** (caso 8
> do capítulo 2). Elas não mediram o link: mediram o meu silêncio. **O
> pareamento pode ou não sobreviver ao reset — nós ainda não sabemos, e o
> que estava escrito aqui como causa confirmada não estava confirmado.**
>
> O que permanece verdadeiro e independente do erro: o dB observou por
> conta própria que reparear fazia funcionar, e o loopback (113 mensagens,
> zero órfãos) prova o caminho **dentro** da placa. O que cai é a
> atribuição de causa exclusiva.
>
> A revalidação está desenhada: gravar (o que já é um reset) → **não
> reparear** → `log on` e conferir eco → só então `mscope stats`. Sem eco
> confirmado, aborta e não interpreta. **Qualquer resultado é lucro:** ou
> some uma burocracia inventada, ou o procedimento vira dado.
>
> **RESOLVIDO no mesmo dia, por medição: o pareamento SOBREVIVE ao reset.**
> Firmware v0.40.0 gravado (DFU + gravação + reset, sem reparear nada),
> canal provado por eco, fader movido: **65 CCs, 220 bytes, zero órfãos,
> zero ressync, zero perdidos.** A causa que este capítulo publicou está
> **refutada**, não apenas em dúvida. Não havia fenômeno de BLE nenhum —
> havia um log que eu tinha mandado calar. **O procedimento
> "gravar → reparear → testar" era superstição nascida do caso 8**, e o
> BOARDS.md pode voltar a ser simples.
>
> A lição que sobra é sobre a forma do erro, não sobre BLE: **uma
> explicação plausível preencheu o buraco que a medição quebrada abriu, e
> depois se defendeu sozinha** — cada novo zero parecia confirmá-la, porque
> cada novo zero vinha da mesma instrumentação quebrada. Hipótese que se
> alimenta do próprio defeito não é hipótese; é eco.

O que me cegou: `bytes 0` é idêntico em todas as causas — fio cruzado,
módulo sem alimentação, app sem autorização, central competindo, e
pareamento velho. Eu tinha o sintoma certo e nenhuma forma de distinguir,
e em vez de procurar o que distinguisse, **gerei explicações**. A pergunta
que resolveria — *"o aparelho ainda está pareado?"* — é a mais básica do
checklist e foi a única que eu não fiz.

**Instrumento que só diz "não chegou" precisa de um par que diga "o que eu
mandei, chegou".** O `mscope` mede o que entra, e por isso nunca podia
distinguir "a fonte não mandou" de "mandou e se perdeu". O loopback é o
par dele: fonte conhecida, caminho real, resposta binária. Todo canal de
entrada devia nascer com o seu.

**Erro de UART engolido em silêncio.** O callback do DMA fazia
`if(res != OK) return;` sem contar nada — overrun, framing e ruído de
linha ficavam invisíveis, e `bytes 0` com a porta reportando **ESCUTANDO**
era indistinguível de "ninguém está mandando". Contador adicionado.

**E a escuta DMA pode ser abortada sem voltar sozinha.** Erro de UART pode
derrubar a recepção no stack da ST, e o `DmaListenStart` não se rearma: o
sintoma seria exatamente "funcionou e parou pra sempre", com a porta
dizendo que escuta. Agora há vigia no `PollMidi` que rearma, contador de
rearmes, e o comando manual `rearm`. **Não é remendo — é a contrapartida
obrigatória de um DMA circular que ruído de linha pode derrubar.**

**Estado de teste anterior contamina o teste seguinte.** Os búzios ficaram
ligados de uma rodada passada, com limiar 0.04, sorteando `dly_time`,
`dly_mix` e as duas cartas do Fx2 **continuamente** durante os testes de
MIDI — o instrumento se modificava sozinho enquanto eu media outra coisa.
É a prima do `tone on` esquecido durante a medição do reverb. **Zerar o
ambiente antes de medir é parte da medição.** (E de brinde: 0.04 dispara
com o chão de ruído do piezo, sem ninguém tocar — dado que só apareceu por
acidente.)

---

## 11b. O conserto que quase sobreviveu ao problema (2026-08-18)

Com o slot Fx2 vazio, o dB ouviu o instrumento e disse: **"o som está
com uma presença de grave que nunca teve antes, muito melhor sonoramente."**

A causa está em uma linha de escopo. O passa-alta de 120 Hz vive **dentro**
do bloco do Fx2, e `fx2_want` exige um módulo no slot:

```cpp
const bool fx2_want = fx2 && params.Real(manifest.p_fx2_on) >= 0.5f;
```

Slot vazio ⇒ bloco pulado ⇒ **filtro não existe mais**. O grave do piezo
passa inteiro.

**Por que isso é um acerto e não sorte.** Aquele filtro nasceu pra tratar um
defeito *do módulo do Fx2* — o estouro de grave que só acontecia com ele
ligado. O estouro se **ouvia na saída**, então o lugar óbvio pra filtrar era
o master. A decisão foi outra, e está escrita no manifest: *"NO CAMINHO DO
FX2, não no master: sem módulo não estoura."*

Se tivesse ido pro master, ele teria sobrevivido à saída do módulo e o
instrumento ficaria fino **para sempre**, sem ninguém saber por quê — um
filtro sem dono, tratando um problema que não existe mais.

**A regra:** *um conserto pertence ao escopo do defeito, não ao lugar onde o
sintoma aparece.* Filtro que existe por causa de um efeito mora no caminho
daquele efeito. Quando o efeito sai, o conserto sai junto — de graça, sem
ninguém precisar lembrar.

O corolário incomoda mais: **todo conserto instalado fora do escopo do seu
defeito vira dívida invisível.** Ele continua rodando depois que a razão
morreu, e o custo aparece como "o instrumento sempre soou assim".

---

## 11c. O cabo (2026-08-18) — cinco hipóteses, nenhuma certa

A placa passou horas "morta": USB enumerava, DFU gravava, e o app não dava
sinal — sem banner, sem resposta, sem som. **A causa era o cabo USB.** Com um
cabo curto, tudo voltou ao normal. Quem achou foi o dB, trocando o cabo.

**O que eu testei, e o veredito de cada uma:**

| Hipótese minha | Como testei | Veredito |
|---|---|---|
| freeze quebrando o boot | build com o freeze fora | ❌ mesma falha |
| alimentação / rail com o WIDI | só USB, WIDI fora | ❌ mesma falha |
| cabo ou USB do host | DFU enumera e grava | ❌ *(conclusão errada)* |
| QSPI corrompida | leitura de volta = ruído | ❌ era upload não suportado |
| `cdc_dead` sem retentativa | conserto gravado | ❌ sintoma idêntico |

**As bissecções foram bem feitas e a conclusão foi errada.** Cada teste
isolou uma variável e deu resposta limpa; o problema é que a variável certa
nunca entrou na lista como *suspeita ativa* — eu a marquei como **descartada**
logo no começo, porque "o DFU enumera e grava, logo o cabo está bom".

**O erro de raciocínio, que é o que vale guardar:** DFU e app usam o mesmo
cabo mas **não o mesmo regime**. O bootloader faz transferências curtas, em
rajada, sem áudio rodando; o app mantém CDC contínuo com o loop e o áudio
disputando. **Um cabo marginal passa no primeiro e falha no segundo.** Provar
que o cabo serve pro DFU não prova que ele serve pro app — e eu tratei como
se provasse.

**A regra:** *descartar um suspeito exige testá-lo no regime em que o defeito
aparece.* Descarte feito em outro regime não é descarte, é mudança de
assunto. E suspeito descartado cedo demais some da lista — não é reexaminado
por mais bissecções que se faça depois, porque bissecção só divide o espaço
que sobrou.

> Custou horas de sessão, seis gravações, um conserto no alvo errado
> (legítimo, mas não era a causa) e três afirmações minhas de "isso fecha o
> diagnóstico" que não fechavam nada.

---

## 11d. O instrumento que não pode depender do paciente (2026-08-18)

O loop principal morreu. Serial, MIDI e caixa-preta pararam juntos — e os
**três** passam pelo loop. Nenhum conseguiu relatar a própria morte.

Passei uma hora testando hipóteses (freeze, alimentação, QSPI, cabo, log)
**sem nenhuma observação por baixo**. Todas erradas. O que destravou foi
piscar o LED da placa direto do loop: em dois segundos ele disse mais que uma
hora de sondas pela serial, porque não passava por nada que estava morto.

**E a primeira versão do LED tinha o mesmo defeito.** Era o próprio loop que
piscava, então ele só sabia dizer *"morreu"*, nunca *"onde"*. A segunda versão
é dirigida pelo **callback de áudio** — o único contexto que sobrevive — e
pisca N vezes com N igual à última fase que o loop completou.

> **Um instrumento de diagnóstico não pode depender do que ele diagnostica.**
> Se o observador e o paciente compartilham o destino, não há autópsia — só
> silêncio.

Corolário prático: **todo canal de diagnóstico precisa declarar de que
contexto ele depende.** Serial depende do loop. MIDI depende do loop.
Caixa-preta depende do loop pra ser lida. O LED dirigido pelo áudio depende
só da interrupção. Quando os três primeiros calam ao mesmo tempo, isso não é
coincidência — é a assinatura do que eles têm em comum.

---

## 11e. Comandos fantasma: a quarentena funcionou e não bastou (2026-08-18)

Transições de link BLE fazem o iOS reenviar o estado de todos os widgets. O
instrumento obedecia. A quarentena de reconexão foi construída pra isso e
**barrou 154 CCs em duas reconexões** — funcionou. E mesmo assim o resto do
despejo passou e pôs **sete parâmetros no máximo**: `src_mix` em 1.0 (jack de
linha, nada plugado) e `gate_thresh` em 1.0 (portão sempre fechado)
emudeceram o instrumento.

O gatilho da quarentena é *≥ 4 CCs distintos em < 100 ms após > 5 s de
silêncio*. As duas brechas: despejo mais **espalhado** que 100 ms, ou **sem os
5 s de silêncio** porque o músico estava tocando.

**A defesa mais forte não é apertar o gatilho — é reduzir a superfície.**
`src_mix`, `gate_thresh` e `gov_ceiling` são **roteamento e segurança**. A
regra da whitelist dos búzios já dizia que esses jamais entram em sorteio; a
mesma lógica vale pro MIDI, e ninguém tinha feito a ligação:

> **O que não está mapeado não pode ser derrubado por fantasma.**

Foram exatamente esses três que emudeceram o instrumento. Custa uma linha por
CC tirá-los do mapa, e nenhuma quantidade de heurística de timing dá a mesma
garantia.

**Assimetria que o dado expõe:** o instrumento aceita "tudo no máximo" como se
fosse música. Sete parâmetros no topo simultâneo não é gesto humano — é
assinatura de máquina, detectável **por si só**, sem depender de timing. Daí a
segunda defesa: **limite de taxa de mudança por parâmetro** vindo de MIDI. Um
fader real anda em rampa; `src_mix` de 0 a 127 num único CC é fisicamente
impossível.

---

## 11f. O filtro de sanidade que descartava a catástrofe (2026-08-18)

O caso 9 (watchdog que vetou um efeito saudável com base em 4 277 071 629 µs)
foi consertado com um **filtro de plausibilidade**: amostra acima de 10× o
orçamento é descartada e contada, nunca julgada. Isso impediu vetos falsos —
e criou um defeito novo, apontado pelo dB:

> **Um estouro catastrófico apareceria exatamente assim.**

O filtro definia "implausível" por **magnitude**. Mas magnitude sozinha **não
distingue outlier-por-erro de outlier-por-evento**. Um bloco que realmente
levasse 5 ms — o pior caso que o veto existe pra pegar — seria descartado
como ruído de relógio. O watchdog ficou cego justamente para aquilo que ele
foi feito para ver.

**E ajustar o limiar não conserta: só move a cegueira.** Qualquer corte por
magnitude tem, do outro lado, uma catástrofe do mesmo tamanho.

**É a família do dead-man cego pro host morto** (o disjuntor que declarava o
CDC morto e nunca mais tentava) **e da janela de graça que apagava a estreia**
(o filtro que existia pra perdoar o custo inicial e apagava a única medição
dele). Nos três, um mecanismo de proteção destrói o dado que justifica sua
existência.

### A causa real, achada por leitura de fonte

```cpp
uint32_t GetTick() { return tim_hal_handle_.Instance->CNT; }
uint32_t GetUs()   { return GetTick() / (GetFreq() / 1000000); }
```

`System::GetUs()` **divide antes de quem chama subtrair**. O `CNT` é um
contador livre de 32 bits, mas o valor devolvido vive numa faixa muito menor
— a 200 MHz, `2³²/200 ≈ 21 474 836 µs`, ou seja **dá a volta a cada ~21,5 s**.

Subtração `uint32` só corrige a volta quando o valor ocupa a faixa **inteira**.
Como não ocupa, uma volta no meio da medição produz `0 - 21 474 836` =
**4 273 492 460** — que é o número observado, a menos de onde no ciclo a volta
caiu.

**A taxa confirma:** o bloco mede ~100 µs a cada 1 ms, então a volta cai
dentro da janela em ~10% das vezes. Uma volta a cada 21,5 s em 2 h dá ~335
voltas → ~33 medições corrompidas esperadas. Observadas: 21. Mesma ordem.

**Conserto:** medir em **ticks crus** e converter **depois** da subtração. O
`CNT` ocupa os 32 bits todos, então a volta se corrige sozinha. Com o relógio
certo, o filtro por magnitude foi **removido** — número grande voltou a
significar estouro de verdade, e volta a vetar.

**A regra:** *filtro que define "implausível" por magnitude descarta a
catástrofe junto com o ruído.* Se um outlier incomoda, ache **por que ele
existe** — outlier reprodutível é bug achável, quase sempre de configuração
ou de aritmética, não fenômeno.

**Pré-requisito que isso estabelece:** um atuador automático exige um relógio
**monotônico e confiável**. Sem isso, o caso 9 está armado para reincidir —
não é questão de se, é de quando.

---

## 11g. A defesa que sobreviveu à ameaça (2026-08-18)

A quarentena de reconexão foi construída porque despejos de estado do iOS
punham `src_mix` e `gate_thresh` em valores perigosos e **emudeceram o
instrumento três vezes numa sessão**. Ela funcionava: barrou 154 e 14 CCs em
dois eventos.

Horas depois, duas decisões do dB — **cada uma correta isoladamente** —
mataram a ameaça que a justificava:

1. `src_mix` e `gov_ceiling` **saíram do mapa MIDI**. *O que não está mapeado
   não pode ser derrubado.*
2. Os defaults do que o MIDI alcança foram a **zero**, e o Loopy (que só
   transmite) virou a fonte da verdade.

Com isso o despejo deixou de ser ataque e virou a **inicialização desejada**.
E a quarentena continuou rodando, agora descartando exatamente o que o
instrumento precisava para acordar:

```
msgs completas 5 | APLICADAS 0
quarentena: 5 CCs recusados
```

Cinco mensagens no boot, zero aplicadas, instrumento mudo. O sintoma era
idêntico a "o MIDI não responde" — e a causa era uma defesa nossa fazendo
exatamente o que fora mandada fazer.

**Não é bug: é defesa órfã.** Nenhuma linha estava errada. O que mudou foi o
mundo em volta dela, e ninguém revisou a defesa quando isso aconteceu.

**É a família do passa-alta de 120 Hz** (cap. 11b) — conserto que existia por
causa do módulo do Fx2. A diferença é instrutiva: **aquele saiu sozinho porque
estava no escopo do defeito** (dentro do bloco do Fx2), e este não saiu porque
estava no escopo do sistema inteiro.

**A regra, mais dura que a do cap. 11b:**

> **Toda defesa precisa declarar a ameaça que a justifica**, para que se possa
> perguntar se a ameaça ainda existe.

Sem isso, defesas acumulam e viram folclore: cada uma custando alguma coisa,
nenhuma sendo revista, e a soma delas eventualmente impedindo o sistema de
funcionar. O conserto aqui não foi remover — foi **rebaixar a defesa a
sensor**: continua detectando e anunciando a reconexão (diagnóstico que se
quer ter), e parou de descartar.

**Corolário de processo:** quando uma decisão remove uma classe de ameaça,
o passo seguinte é *listar o que existia por causa dela*. Nós tomamos as duas
decisões e não fizemos essa pergunta.

---

## 11h. Proposta que o outro lado já executou (2026-08-18)

Propus um mapa de CCs renumerado, apresentei a tabela, pedi confirmação — e
**não implementei**. O dB alinhou o Loopy pela tabela.

O resultado foram várias rodadas caçando um `level` que "não respondia":
o fader mandava CC 20 (o novo `level`) e a placa ainda tinha CC 20 =
`dly_time`. Os dois lados estavam certos em relação a documentos diferentes.

O diagnóstico só destravou quando o dB colou a tabela de volta e perguntou
*"mas... e isso?"*.

**A regra:** *proposta que o outro lado já executou deixa de ser proposta.*
Uma tabela apresentada como decisão vira contrato no instante em que alguém
age sobre ela — e o custo de implementar tarde é maior que o de implementar
junto, porque no intervalo os dois lados divergem **em silêncio**.

---

## 11i. Os dois tetos que estouraram calados, e a caixa única (2026-08-18)

Quatro parâmetros novos do shimmer empurraram **três** para fora da tabela:
`kMaxParams = 32`, o manifest declarava 35, e o `Add()` devolvia `-1` **sem
dizer nada**. Os três últimos declarados eram os **búzios inteiros** — a
feature sumiu do instrumento.

No mesmo dia, o mapa MIDI chegou a **17** entradas com `kMaxMidiMap = 16` e
**sem nenhuma guarda**: a 17ª foi escrita **fora do array**. O comando `midi`
imprimia a linha (lê pelo mesmo índice estourado) e o `ApplyMidiCc` não achava
o dono — **duas leituras contraditórias da mesma tabela**, que é a assinatura
de escrita fora dos limites.

**Sintomas:** uma feature ausente, e um `?` numa tabela de debug. Nenhum erro,
nenhum log. Os dois só apareceram porque alguém olhou.

**Quinta instância da mesma família no mesmo dia:** `log_muted` sem porta de
saída, `cdc_dead` que nunca retentava, `replace` que não achava a âncora,
`Add()` devolvendo −1, e o mapa MIDI sem guarda. **Mecanismo que falha em
silêncio.**

**Conserto em dois níveis, e o segundo é o que importa:** os tetos subiram
(48 e 32, com folga proposital pros ~12 params dos quatro efeitos que faltam),
e o estouro passou a **gritar no boot** com o número exato. Subir o teto
resolve hoje; a falha ruidosa resolve todas as próximas.

> **Estouro de capacidade é defeito de PROJETO, não condição de runtime.** Quem
> adiciona o 49º parâmetro precisa saber na hora, não descobrir por uma feature
> que sumiu.

### A causa profunda, e a resposta do dB: a caixa única

O teto era o sintoma. A causa é que **não havia lugar único onde a lista de
features vive** — então ninguém revisa o que já existe antes de acrescentar, e
o custo de cada adição fica invisível até algo quebrar.

Daí [`docs/FEATURES.md`](FEATURES.md), decidido pelo dB em 2026-08-18:

- **Toda feature vigente numa caixa só**, com params, CCs e estado.
- **Aposentadas vão pro arquivo**, no mesmo documento, com *por que saiu* e
  *como reviver*.
- **A caixa é o começo de toda sessão**, e tem checklist próprio: *o que já
  está aqui que eu deveria revisar antes de acrescentar mais?*

**Por que o arquivo importa tanto quanto a lista:** este projeto já tem
**sete** features aposentadas, e cada uma deixou rastro — o módulo do Fx2 deixou
params vivos e CCs mortos, o freeze externo deixou um wrapper, a regra do
pareamento deixou um procedimento que ninguém precisava seguir. **Aposentar
sem registrar produz folclore**: coisas que continuam no código porque ninguém
lembra por que estão lá.

É a mesma raiz do cap. 11g (a defesa que sobreviveu à ameaça): sem declarar
por que algo existe, não há como perguntar se ainda precisa existir.

---

## 11j. O controle que não controlava (2026-08-18)

O dB, sobre o shimmer recém-nascido: **"o som está lindo mas o ganho está
baixo, mesmo com o mix no máximo."**

A causa era literal: **eu nunca chamava `Mistura()`.** O `shm_mix` existia,
era lido, escalava um campo interno — e nada no caminho de áudio consumia esse
campo. Todo o nível audível vinha do laço de realimentação, então o controle
girava sem estar ligado a coisa alguma.

**O que torna esse defeito perigoso é que o efeito FUNCIONAVA.** Soava bonito,
respondia ao feedback, ao shift, ao tamanho da sala. Um controle morto no meio
de um efeito vivo não produz sintoma até alguém tentar usá-lo — e mesmo então
o relato natural é *"está baixo"*, que manda procurar ganho, não fiação.

**A regra:** *todo param novo precisa de um teste que prove que ele MOVE
alguma coisa.* Não que exista, não que receba CC, não que apareça no `list` —
que **mude o som**. O PAT (T18) faz isso pelo lado do MIDI; falta o
equivalente do lado do DSP.

**Sinal de alerta genérico:** quando um controle "não parece fazer efeito", a
primeira hipótese não deve ser *"a faixa está errada"* ou *"o ganho é baixo"*.
Deve ser ***"ele está ligado em alguma coisa?"*** — e essa pergunta se
responde lendo o código, em segundos, antes de qualquer ajuste.

---

## 11k. Reportar como feito o que o assert barrou (2026-08-18)

Três vezes seguidas eu anunciei um conserto como gravado, e o `main.cpp`
tinha ficado em **v0.67.0** o tempo todo. As edições morriam num `assert` de
âncora — comportamento **correto** da disciplina de edição segura, que
protege o arquivo — e eu só conferia o resultado da **gravação**, nunca o do
**script**.

O `EXPIROU`/`GRAVOU` da laçada me dizia que o binário subiu. Não me dizia
*qual* binário.

**O que mascarou:** os consertos que importavam estavam em `params.h` e
`midi.h`, e **esses** foram escritos. Os búzios voltaram, o `shm_shift`
passou a responder — tudo funcionou. Só o log de capacidade no boot não
existia, e era justamente a peça que provaria que o resto estava certo.

> **Sempre conferir a versão do `main.cpp` — no arquivo E na placa — como
> parte da rotina.** O boot já imprime `Cotucatronics OS vX.Y.Z`: comparar
> com o fonte custa uma linha e fecha a diferença entre *"eu editei"* e *"a
> placa tem"*.

**A regra geral:** *saída de ferramenta não é confirmação de intenção.* A
laçada confirma que gravou; o `assert` confirma que a âncora casou; o
`grep` confirma que o texto entrou. **São três confirmações diferentes, e eu
tratei a primeira como se cobrisse as três.**

Corolário desagradável: quanto melhor a proteção contra edição silenciosa
(o `assert`), mais fácil é *não perceber* que ela agiu — porque o efeito de
uma edição barrada é o arquivo continuar igual, e arquivo igual não faz
barulho.

---

## 11l. O RESET que não precisava existir (2026-08-18)

Esta sessão gastou perto de **vinte gravações** brigando com a janela de ~2 s
do bootloader. Metade falhou porque eu pedia o RESET e **só depois** começava
a escutar — a família de ordem, aplicada a duas pessoas em vez de a duas
funções.

A pergunta do dB — *"tem como eu colocar um jumper pra você fazer o rst por
aí?"* — tinha uma resposta melhor que jumper: **`System::ResetToBootloader(
DAISY_INFINITE_TIMEOUT)`**. A placa se reinicia direto no DFU e **espera pra
sempre**. Comando `dfu go` pela serial, e a gravação acontece sem ninguém
tocar em nada.

**Resultado medido, na primeira gravação seguinte:**

| | tentativas |
|---|---|
| últimas três com RESET físico | **119**, 66, 47 |
| primeira com `dfu go` | **1** |

**A lição não é sobre a API — é sobre quanto tempo se pode gastar contornando
um atrito antes de perguntar se ele precisa existir.** O atrito era aceito
como fato da bancada desde a primeira sessão, e todo o fluxo foi construído em
volta dele: laçadas de retentativa, pedidos de "toca o RESET", coordenação de
tempo entre duas pessoas. A solução estava no header da libDaisy o tempo todo.

> **Atrito repetido vira paisagem.** Quando algo incomoda pela terceira vez,
> pergunte se ele precisa existir — *antes* de automatizar o contorno.

**E a regra irmã, que a rotina de versão encontrou em minutos:** o `board` não
imprimia a versão fora do banner de boot, então a checagem que o dB acabara de
pedir era **inexecutável** para quem conecta depois. Uma regra que não pode
ser executada não é regra. Corrigido no mesmo ciclo.

**Virou skill portátil** — `bancada-firmware`, sem nada de Cotucatronics
nela: reset por software antes do botão, conferência de versão nos dois
lados, e "saída de ferramenta não é confirmação de intenção". Vale para
qualquer projeto embarcado futuro.

---

## 11m. Escrevi a regra três vezes e violei quatro (2026-08-18)

**"Silêncio não distingue 'ninguém mexeu' de 'caiu'."** Está no `ble`, está no
BOARDS.md, está no battle_scars. E eu construí **quatro** instrumentos que
tratam ausência de dado como dado:

1. O detector de queda BLE dizia **"provável QUEDA"** quando o dB só tinha
   parado de mexer no fader. Corrigido — e o próprio conserto documentou a
   regra.
2. O monitor de tráfego me fez ler **"degradação do link"** num gráfico que
   era o dB tocando normalmente: fluxo humano é naturalmente esburacado.
3. O veredito do teste de fade imprimiu **"não voltou"** enquanto os
   contadores embaixo mostravam 21 CCs aplicados.
4. O aviso de sessão MIDI disparou **"SESSAO MIDI AUSENTE"** com o link
   perfeito, porque "zero bytes desde o boot" também é verdade quando ninguém
   encostou em nada ainda.

**O padrão não é esquecer a regra — é aplicá-la ao sistema e não a mim.** Nas
quatro vezes eu sabia que silêncio é ambíguo; nas quatro vezes escrevi código
que resolvia a ambiguidade **escolhendo um lado**, porque escolher produz uma
frase útil e admitir não produz.

> **A correção nunca é o limiar. É parar de afirmar.**
>
> Instrumento que não consegue distinguir dois estados tem que **dizer isso**,
> e vir com o teste que distingue:
>
> ```
> >>> Se voce JA mexeu num controle, a sessao caiu: reconecte.
> >>> Se ainda nao mexeu, isto aqui nao diz nada: mexa e olhe de novo.
> ```

**Sinal de alerta para escrever qualquer mensagem de diagnóstico:** se a
frase afirma uma causa, pergunte *"que outro estado produz exatamente esta
evidência?"* — e se houver um, a frase tem que citá-lo.

---

## 11n. Duas camadas com o mesmo sintoma (2026-08-18)

Depois de toda gravação o dB tinha de esquecer o Bluetooth, reparear o WIDI e
voltar ao Loopy. Três passos, toda vez.

Medido com o pino do LB:

| Camada | Depois de gravar |
|---|---|
| **BLE** — o que o LB vê | ✅ conectado, `LB 0/100%` |
| **Sessão CoreMIDI** — o que o Loopy usa | ❌ morre |

**O pareamento nunca quebrou.** Esquecer o dispositivo era trabalho gasto num
problema que não existia — a mesma forma da regra *"reparear após todo
RESET"*, revogada por medição algumas horas antes, no mesmo dia.

Ritual de três passos vira **dois**: reconectar no painel Bluetooth MIDI (dá
pra fazer dentro do próprio Loopy) e voltar a tocar.

**E isso expõe o limite da camada 1 que construímos hoje:** o LB responde
*"o rádio está ligado?"*, **nunca** *"o MIDI está fluindo?"*. A matriz de seis
quadrantes precisa da ressalva — `FIXO + zero tráfego` não distingue *"o app
parou de mandar"* de *"a sessão MIDI caiu com o rádio intacto"*. Mesmo par de
sintomas, causas diferentes, e a segunda acontece **toda vez** que se grava.

> **Instrumento novo não resolve a pergunta — ele move a fronteira do que
> ainda é ambíguo.** Vale saber onde a nova fronteira ficou.

---

## 11o. O desperdício que preserva a correção (2026-08-18)

Três efeitos seguidos pagaram o dobro pela mesma razão:

| Efeito | O que duplicava |
|---|---|
| **drive** | `tanh` calculado 2× sobre o mesmo valor mono |
| **phaser** | 2N allpass em vez de N |
| **detune** | gravação escrevendo o mesmo número nos dois canais |

**A causa não é "a cadeia é mono".** É que **a interface oferecia estéreo, o
dado era mono, e nada tornava o descompasso visível.** Todo efeito expunha
`Process(l, r)` como entrada natural; passar o mesmo valor duas vezes parecia
inofensivo, e o tipo `float` não sabe se carrega um canal ou dois.

### As três regras, da mais estreita à mais útil

**1. Desperdício que preserva a correção não tem sintoma.** Os três produziam
áudio **certo**. A única evidência era custo. Revisão não pega, teste não
pega, ouvido não pega — **só medição pega, e só se alguém medir.**

**2. Quando a forma da API não corresponde à forma do dado, o descompasso
cobra em silêncio e repetidamente.** O conserto não é disciplina: eu falhei
três vezes *sabendo* da regra. É fazer o caminho barato ser o **padrão** e o
caro ter que ser pedido — `ProcessMono` devia ter nascido como `Process`, e o
estéreo como `ProcessStereo`.

**3. Conserto sem perguntar "onde mais esta forma aparece?" reincide.**
Consertei no drive, repeti no phaser, repeti na gravação do detune. A pergunta
custa trinta segundos e teria pego as três de uma vez.

> **A terceira é a mais cara do projeto inteiro.** Ela também explica o
> `log_muted` → `cdc_dead` → `Add()` → `AddMidi()`: quatro mecanismos que
> falham em silêncio, consertados um a um, porque nenhum conserto perguntou
> onde mais aquela forma existia.

**O agravante da gravação do detune:** ela roda mesmo com o efeito **em
bypass**. Eram 33 µs pagos **continuamente** para escrever o mesmo número duas
vezes — custo que nem aparece quando o efeito está desligado, que é quando se
espera custo zero.

---

## 11p. O sinal errado como régua, terceira aparição (2026-08-18)

O phaser soou "como um tremolo bem sutil". Medido: **excursão de nível de
0,1 dB** com o notch varrendo — ou seja, não havia notch.

A causa era um par de sinais trocados na equação de diferenças:

```c
y = a*x + x[n-1] - a*y[n-1]   →  H(z) = (a + z⁻¹)/(1 + a·z⁻¹)   polo em z = −a
y = -a*x + x[n-1] + a*y[n-1]  →  H(z) = (z⁻¹ − a)/(1 − a·z⁻¹)   polo em z = +a
```

Polo em **−a** fica perto de **Nyquist**. Com `a ≈ 0,97` — calculado para
200 Hz — toda a ação de fase acontecia perto de **24 kHz**, e os notches
nasciam fora do espectro audível. **A conta do coeficiente estava certa; a
equação é que não correspondia a ela.**

Depois do conserto: **0,1 dB → 14,3 dB de excursão.**

**O relato do dB foi o que tornou isso achável em minutos.** *"Parece um
tremolo bem sutil"* descreve exatamente o resíduo de um notch fora de banda —
sobra a ondulação de nível, some o caráter. *"Não funciona"* teria mandado
procurar no LFO ou no mix.

> **Sintoma descrito pelo caráter vale mais que sintoma descrito pela
> ausência.** Vale pedir: *"com o que se parece?"*, não *"funcionou?"*.

---

## 11q. O estado que não sobrevive ao flash (2026-08-20)

Configurei o detune, gravei a placa para consertar os tetos das tabelas, e
anunciei *"o detune está ligado e pronto"*. O dB foi tocar e não ouviu nada.

Não era o efeito. Era o relato. A regravação zerou todos os params — que é
**a regra que o próprio dB pediu** (tudo nasce em 0, ele sobe pelo Loopy). Eu
repeti como presente um estado que era verdade antes do flash:

```
37 det_on     norm=0.00 real=0.00     ← desligado
39 det_voices norm=0.00 real=1.00     ← uma voz
40 det_spread norm=0.00 real=0.00     ← sem largura
```

O caminho do código estava certo, o `Mistura()` era chamado, o motor
funcionava. Nada disso importava com a chave em zero.

> **Estado de placa afirmado antes de um flash não sobrevive ao flash: ou se
> relê depois, ou não se afirma.** Vale para qualquer estado volátil —
> params, calibração, modo de log. A regravação é a fronteira, e afirmação
> não a atravessa.

**Corolário que virou código.** A denúncia de estouro de tabela existia desde
a v0.70 e **não evitou a segunda ocorrência**, porque só saía no banner de
boot — quem conecta a serial depois nunca a vê. Agora o estado das tabelas
sai também no `board`, sob demanda:

```
tabelas: 55/64 params | 37/48 CCs
```

> **Aviso que exige estar presente na hora certa é aviso que se perde.** Todo
> alarme de boot precisa de um gêmeo consultável a qualquer momento.

---

## 11r. Metade da queixa (2026-08-20)

O dB: *"tem frequências agudas, **médio-agudas** no shimmer que estão bem
ardidas"*. Encontrei uma causa real e a consertei.

**Aliasing.** Ler o buffer a `ratio 2.0` é compressão no tempo: tudo acima de
12 kHz atravessa Nyquist e **dobra de volta inarmônico**. Medido no motor: um
seno de 20 kHz reaparecia em **8 kHz a −11,9 dB**. E o laço fabricava isso
sozinho — com 3500 Hz na entrada, o pico **mais alto de toda a cauda** era
19963 Hz, que não é oitava de nada. Depois do anti-alias: **−64 dB**.

Publiquei a vitória. O dB voltou: *"ainda ardido"*.

A resposta estava na minha própria tabela, e eu a li como efeito colateral
inofensivo:

| | antes | depois |
|---|---|---|
| acima de 12 kHz | 19,2% | 1,2% |
| **2–6 kHz** | **26,4%** | **35,7%** |

A faixa médio-aguda **cresceu como fatia**. Eu tinha tirado energia de cima e
deixado a metade médio-aguda intacta — proporcionalmente mais audível do que
antes. O passa-baixa em 6 kHz que eu instalei **não toca em 2–6 kHz**: por
construção, não podia consertar a metade que o dB nomeou primeiro.

> **A queixa tem tantas partes quantas o dB nomeou.** Consertar uma parte e
> medir melhora não é consertar a queixa. Antes de publicar, reler a própria
> medição perguntando o que ela diz sobre a parte que eu *não* ataquei.

---

## 11s. A hipótese que a medição matou (2026-08-20)

Para a metade restante eu tinha uma hipótese boa, e o próprio código a
endossava: o cabeçalho do `detune.h` já dizia que grãos descorrelacionados
"somam em potência, nunca em fase" e que o caminho, se incomodasse, era
**grão mais longo**. Emenda de fase espalha energia justo no médio-agudo.

Medi antes de implementar. Seno puro de 1000 Hz, pitch ×2 — a saída ideal é
um seno puro de 2000 Hz, e tudo fora do pico é sujeira fabricada pelo motor:

| grão | sujeira |
|---|---|
| 50 ms | −15,8 dB |
| 100 ms (o atual) | −25,5 dB |
| 200 ms (buffer maior) | −36,2 dB |

Dez decibéis disponíveis. Ia gastar memória para pegá-los. Antes, uma última
medição: **planura espectral** da faixa 2–6 kHz na cauda real — próxima de 1
é ruído, próxima de 0 é tonal.

```
cauda do shimmer:  0,009      cauda seca de reverb:  0,004
```

**Tonal.** A sujeira granular existe, mas não é o que arde — e grão de 200 ms
até **piorou** a faixa (49,7% contra 35,7%). Hipótese morta antes de virar
código, por uma medição de trinta segundos.

O que arde é **som legítimo no lugar mais sensível do ouvido**: o 1–3 kHz da
escultura levado a 2–6 kHz pela oitava e sustentado pelo reverb. Não é
defeito de implementação — é o que um shimmer fiel faz.

> **Contra som legítimo no lugar errado não se usa filtro de ruído: usa-se
> EQ.** E a profundidade se escolhe contra uma **régua medida**, não de
> ouvido: a razão (2–6 kHz)/(300–2000 Hz) da cauda *seca* é o timbre natural
> do instrumento na sala. O shimmer dava 1,01 contra 0,28 do seco; o sino de
> −6 dB em 3 kHz o pôs em 0,19.

**Cicatriz menor, cara em tempo: cascata fraca não é filtro íngreme.** A
primeira versão do anti-alias eram três passa-baixas de um polo. Medido:
−25,6 dB, insuficiente. A conta explica — `y = (1−a)x + a·y` tem ganho
`(1−a)/(1+a)` em Nyquist, que com corte em 10 kHz é apenas **−4,8 dB por
polo**, e três já custavam −6,5 dB em 8 kHz. Fraco onde precisava cortar,
pesado onde precisava passar. Butterworth de 6ª ordem acertou as duas pontas.

> **Empilhar filtros baratos não substitui escolher a topologia certa.**
> Medir a resposta do filtro, não presumir que a cascata soma o que se espera.

---

## 11t. A convenção que só funcionava porque todos os casos eram iguais (2026-08-20)

O `piezo_mix` nasceu grudado num piezo só — `real=-1.00`, o extremo
esquerdo — e um dos dois transdutores teria ficado mudo sem sintoma.

A assinatura sempre disse a verdade:

```c
int Add(const char* name, float def_norm, float min_real, float max_real, ...)
                          ^^^^^^^^ NORMALIZADO, está no nome
```

**Todo parâmetro do projeto até aqui tinha `min_real = 0`.** Com mínimo zero,
normalizado e real coincidem, e a distinção nunca precisou existir. Copiei o
padrão de chamada de dezenas de vizinhos corretos sem verificar que a
condição que os tornava corretos — mínimo zero — ainda valia. O `piezo_mix` é
o primeiro de faixa **simétrica**, e nele `def_norm = 0` é a ponta, não o meio.

> **Padrão copiado carrega uma pré-condição que ninguém escreveu.** Ao ser o
> primeiro caso de uma forma nova (faixa negativa, unidade diferente, sinal
> invertido), reler a assinatura em vez de imitar o vizinho — os vizinhos
> estavam certos por um motivo que pode não valer para o caso novo.

Pego pelo `list` antes do dB tocar, e só porque a leitura de estado depois de
gravar já era rotina (11q). A cicatriz anterior pagou por esta.

---

## 11u. Não afirmei estado errado — destruí estado em silêncio (2026-08-20)

A 11q dizia: *estado afirmado antes de um flash não sobrevive ao flash*.
Escrevi a regra, virou skill, e no mesmo dia o dB relatou "sem som no p2".

O `level` estava em **0,00**. Eu havia gravado a placa **quatro vezes** na
mesma conversa, cada gravação zerando o master, e **nunca reposto nem
avisado**. Ele estava re-dialando pelo Loopy a cada rodada sem que eu
soubesse, e uma das perguntas dele nasceu de um silêncio que era meu.

A 11q cobria a metade errada do problema. Afirmar estado velho é um erro de
**relato**; destruir estado sem avisar é um erro de **ação** — e este é pior,
porque o outro lado não tem como saber que aconteceu.

> **Toda gravação destrói estado. Repor o estado de operação e DECLARAR o
> que foi reposto faz parte de gravar** — não é cortesia, é fechar a ação.
> Mínimo: `level`, `in_gain` e as chaves do que estava tocando.

---

## 11v. A pergunta que o instrumento não sabe responder (2026-08-20)

*"Chega sinal no segundo piezo?"* — e não havia como saber. O firmware media
CPU, MIDI, picos por nota, ganho do limiter, custo de cada efeito, e **não
media a própria entrada, por canal**. Piezo mudo e piezo baixo soam
exatamente igual atrás de um reverb.

Medidor cru (pré-balanço, pré-`in_gain`, pré-gate) resolveu em cinco minutos
e respondeu de imediato, antes mesmo de alguém tocar:

```
IN_L (p1): pico 0.00182 = -54.8 dBFS | 4783 amostras
IN_R (p2): pico 0.00422 = -47.5 dBFS | 9515 amostras   ← chega ao conversor
```

Pino morto daria zero absoluto. O canal existe; a pergunta virou "o transdutor
entrega?", que é outra pergunta e tem outro dono.

**A mesma lacuna produziu um erro de fato que durou o dia inteiro.** Citei
`in_gain = 8,0` como "18 dB de fábrica" em três respostas e o pus como defeito
aberto no STATUS. O default é **1,0×** — está escrito no manifest, na mesma
linha do `Add()`. O 8,0 era **ajuste do dB**, dialado pelo Loopy e persistido
até a gravação seguinte.

> **Valor lido de uma placa viva não tem procedência.** Antes de chamar um
> número de "default do projeto", ler o default no fonte — a placa mostra o
> que está lá, não quem o pôs.

> **A pergunta que o instrumento não sabe responder é a que será respondida
> com hipótese.** Quando um canal de sinal novo entra (entrada, saída, sensor),
> o medidor dele entra junto — não depois do primeiro mistério.

**O desfecho inverteu o diagnóstico.** Com o dB tocando:

```
IN_L (p1): pico 1.00000 =  -0.0 dBFS |  42 365 amostras | clip 65
IN_R (p2): pico 0.46398 =  -6.7 dBFS | 244 237 amostras | clip 0
```

O p2 — o canal "sem som" — entrega −6,7 dBFS e tem **quase 6× mais amostras
ativas** que o p1. Quem tem defeito é o **p1**, que bate no teto do conversor
(65 amostras em clip) antes de qualquer ganho de firmware e ocupa todo o
espaço. "Sem som no p2" era o p1 saturado encobrindo o vizinho — exatamente o
caso que o `piezo_mix` foi construído para resolver, chegando pela porta de
trás como se fosse um canal morto.

> **O sintoma nomeia o canal onde a falta é OUVIDA, não o canal onde a causa
> está.** Numa soma, o que some pode estar perfeito: quem o apaga é o outro
> somando. Antes de investigar o lado silencioso, medir o lado alto.

E o conserto de firmware aqui é paliativo declarado: baixar `in_gain` e abaixar
o p1 pelo balanço recupera equilíbrio, mas **clipping no ADC não se desfaz a
jusante**. O conserto real é físico.

---

## 11w. Dois canais de saída não são uma imagem estéreo (2026-08-20)

A especificação do `out_width` dizia "na saída final, após a espacialização
estéreo". Aplicado ao pé da letra, teria desfeito o stack anti-feedback.

`OUT_L` vai para o exciter **no corpo da escultura** e é o ramo que realimenta
o piezo: leva governor e shifter SSB. `OUT_R` é jack de linha, não realimenta,
e sai limpo **por desenho**. Depois do split eles não são L e R de uma imagem
— são dois **destinos** com processamentos diferentes.

`mid = (L+R)/2` e `side = (L-R)/2` ali dentro somariam o ramo protegido com o
desprotegido, reinjetando sinal sem shift no fio que fecha o laço acústico. A
proteção continuaria existindo no código e teria deixado de existir no ar.

O lugar certo é **entre o LEVEL e o split** — o último ponto em que os dois
canais ainda são a mesma imagem.

> **Antes de qualquer operação que MISTURE canais (mid/side, soma mono,
> correlação, pan), perguntar o que cada canal É naquele ponto.** "Estéreo" é
> uma propriedade do trecho, não do cabo.

---

## 11x. Canal mudo prova que aquele canal está mudo (2026-08-20)

Implementando o **aviso obrigatório** do teto de soma — a parte do desenho que
existia justamente para não repetir a família "falha em silêncio" — chamei
`LogAlways()` e `MidiSendBytes()` de dentro do `AudioCb`.

Escrever no CDC de dentro do callback starva a ISR do USB. **É o defeito de
prioridade 1 do `STATUS.md`, escrito lá havia dias, e eu o cometi mesmo
assim.** A implementação do aviso derrubou o instrumento.

Família A dos bugs de ordem, na forma mais pura: quem arma e quem executa têm
que estar no mesmo contexto, e o contexto que pode falar com o mundo é o loop.
Conserto: o callback marca (`volatile int aviso_teto_idx`), o loop lê a marca,
loga e manda o CC.

**Mas a cicatriz não é essa. É o que eu disse depois.**

Com a serial muda, afirmei ao dB: *"a placa continua tocando — só o canal de
conversa caiu"*. Eu tinha medido **uma** coisa: que o CDC não respondia. Dali
inferi o estado do áudio, que é outro subsistema, por nenhuma razão além de ser
a hipótese confortável. O dB descobriu tocando: *"não há som"*. O travamento
era geral.

> **Canal mudo prova que aquele canal está mudo, e nada além disso.** A
> ausência de resposta é a informação mais pobre que existe: ela não distingue
> "o canal caiu" de "o sistema caiu". Antes de afirmar o que sobreviveu, medir
> o que sobreviveu — ou dizer "não sei".

Terceira aparição da mesma família num dia. A 11q foi sobre **afirmar estado
velho**; a 11u sobre **destruir estado calado**; esta é sobre **afirmar estado
que nunca foi medido**. As três têm a mesma raiz: tratar como sabido o que
apenas era conveniente.

---

## 11y. Agir de novo antes de observar a própria ação (2026-08-20)

Teto de soma, teste 1: teto em 620 µs, bloco em 626. Derrubar o detune
(−125 µs) resolvia com folga. **Caíram dois** — detune e phaser:

```
"detune" em BYPASS — bloco 626 us de teto 620
"phaser" em BYPASS — bloco 633 us de teto 620      <- MAIOR que antes
```

Zerar o param **não faz o efeito parar de custar**: o `EffectSlot` desce por
rampa e continua processando enquanto desce. O mecanismo mediu de novo antes
que a própria ação surtisse efeito, viu o bloco ainda alto — mais alto, com o
ruído — e derrubou o próximo da fila.

O preço é exatamente o que a política de prioridade existia para evitar: um
efeito perdido a mais do que o necessário. E o modo de falha é insidioso
porque **cada queda individual parece justificada** pela medição do momento.

> **Mecanismo corretivo automático precisa de carência entre agir e medir de
> novo.** Sem ela ele reage à sua própria ação ainda em curso, e a correção
> vira sobre-correção. A carência não é conservadorismo: é o tempo que a
> realidade leva para refletir o que já foi feito.

250 ms aqui — folgado para as rampas de 8 ms, curto para que um estouro real
não fique sustentado. A cauda de 2 s do freeze não cabe nessa janela, e não
deve caber: durante ela o custo **está** lá, e uma segunda queda seria correta.

---

## 11z. Chave nova num recurso compartilhado cria dependência muda (2026-08-20)

O dB pediu `on`/`off` para o delay e o reverb, que até então ligavam pelo
`mix`. Pedido simples, e cada uma das duas chaves trouxe um problema
diferente.

**O reverb é recurso compartilhado.** O shimmer não tem reverb próprio — ele
realimenta o da cadeia, e isso é o desenho, não um atalho. Um `rev_on` que
pula o bloco inteiro (o que se quer, para custar zero) **emudece o shimmer
junto**, e o sintoma seria "o shimmer parou de funcionar" com o `shm_on` em
127 e nada errado à vista.

> **Desligar um recurso compartilhado emudece quem depende dele, em
> silêncio.** Ao dar chave a algo que outros consomem, a dependência tem que
> se declarar no ponto onde alguém vai olhar — não no comentário do código.

Aqui o `board` passou a imprimir, e só quando a combinação acontece:

```
*** shm_on ligado com rev_on DESLIGADO: o shimmer realimenta o reverb
    e esta MUDO. CC 61 para acordar os dois. ***
```

**O delay é módulo opaco.** A regra da casa — *"bypass pula o processamento,
nunca a gravação"*, que nasceu do clique da Peça 2 — **não é aplicável a um
módulo externo opaco**, que não separa as duas coisas. Pular o `Process()` zera o custo
e deixa a linha de delay rançosa: ao religar sai um pedaço de áudio velho.

Não há terceira opção, então a escolha é declarada: o `dly_on` mistura para o
seco e **o módulo segue rodando**. Paga-se custo para não pagar ranço — e o
teto de soma, fechado horas antes, é o que torna esse custo aceitável.

> **Regra herdada tem pré-condição.** Antes de aplicar uma regra da casa a um
> caso novo, verificar se a estrutura que a tornava possível existe ali. A
> regra do bypass pressupunha poder separar gravação de processamento; num
> módulo fechado, essa separação não existe, e insistir nela produziria um
> defeito em nome de uma boa prática.

---

## 12a. Validade de medição tem regime (2026-08-20)

Medi a entrada dos piezos com **dedo direto no disco solto** e registrei o
resultado como *"a entrada satura"*. Escrevi isso no STATUS como defeito
aberto, propus um plano de oito passos em cima disso, e cheguei a dar valores
de divisor resistivo.

O dB cortou: **esse regime não é o de uso.** Piezo desacoplado, excitado por
contato direto, é o caso mais violento que a pastilha encontra na vida. A mesma
pastilha colada na escultura e excitada pela vibração dela entrega outra coisa,
e provavelmente muito menos.

Nenhum número estava errado. **O que estava errado era o alcance da
conclusão.** Eu media um regime e afirmava sobre outro.

> **Toda medição vale para o regime em que foi feita, e o regime é parte do
> dado — não contexto do dado.** Um número sem regime declarado não é uma
> medição incompleta: é uma medição cuja validade ninguém pode julgar,
> inclusive quem a fez.

O projeto já tinha metade dessa regra, na forma *"estreia ou permanente?"* —
regime **temporal**. Faltava a outra metade: regime **físico**, o de como o
sinal está sendo produzido. Piezo solto e piezo montado são dois instrumentos
diferentes para efeito de medição.

**A correção mudou o plano de forma, não só de conteúdo.** A versão anterior ia
dimensionar um atenuador a partir do número errado. A nova ordem é: montar só a
**proteção** (1 kΩ + 2× 1N4148 — não mexe no ganho, protege o ADC de qualquer
jeito), instalar na escultura, tocar, e **só então** medir. O atenuador virou
condicional: entra se clipar tocando, e talvez não entre.

> **Antes de dimensionar uma solução, verificar se o problema existe no regime
> real.** Dimensionar cedo é resolver um problema que talvez não exista, com um
> número que com certeza não vale.

E há um bônus de método: a proteção é a peça **útil em qualquer desfecho**.
Quando há uma medição pendente, a ordem certa é fazer primeiro o que serve
para os dois resultados possíveis.

---

## 12b. Defeito físico num transdutor imita assimetria de circuito (2026-08-20)

O p2 chegava mais baixo que o p1. Medi, confirmei a diferença, e a diferença
virou premissa: entrou no STATUS como característica do par de canais e quase
virou a **justificativa** para duplicar gate e ganho por cadeia.

Era **um piezo com defeito**. Trocados de canal, p1 e p2 chegam exatamente
iguais.

**O que separou as duas hipóteses não foi medir mais fundo — foi trocar os
piezos de canal.** Nenhuma medição elétrica, por mais precisa, distingue "este
canal atenua" de "este transdutor entrega menos": as duas produzem o mesmo
número. O que distingue é **permutar o suspeito**, que é um experimento, não
uma leitura.

> **Quando um número descreve um par assimétrico, troque os elementos de lugar
> antes de atribuir a assimetria ao sistema.** Uma medição mais precisa do
> mesmo arranjo só confirma o número com mais casas decimais — e o número
> nunca esteve em dúvida.

Mesma família da medição do dedo-no-disco (12a): **o número estava certo; o
que ele descrevia é que não era o que se supunha.** Ali era o regime; aqui é
qual elemento do arranjo carrega a propriedade medida.

**A decisão sobreviveu à justificativa, e isso importa registrar.** Gate e
ganho duplicam mesmo — mas por **material**, não por desequilíbrio: o piezo do
tambor lê transientes curtos e fortes, o da mola/corda lê raspagem contínua de
baixo nível. Um limiar que deixa a raspagem passar abre demais para o tambor.
A duplicação vale com dois piezos perfeitamente casados, e valeria se fossem
idênticos de fábrica.

> **Justificativa errada envelhece mal.** Se ficasse escrito "duplicamos
> porque o p2 era mais baixo", alguém mede os canais iguais no futuro e conclui
> que a duplicação é dispensável — desfazendo uma decisão certa por causa de um
> motivo errado que ninguém revisou. A razão registrada tem que ser a razão que
> se sustenta, não a que estava à mão quando se decidiu.

---

## 12c. Verificador que casa texto não distingue o dado da narração (2026-08-20)

Certifiquei a remoção dos LEDs LG/LR com um teste automático: rodar `ble` e
procurar as letras `LG` ou `LR` na saída. Ele acusou **fantasmas**.

A linha que ele encontrou era esta:

```
LB 0/100%   (LG/LR removidos 2026-08-20)
```

O verificador achou exatamente **a frase que anuncia que eles foram
removidos**. A certificação tinha passado; quem falhou foi o certificador — e
eu publiquei "SIM — ERRADO" antes de olhar a saída com os próprios olhos.

> **Verificador que casa padrão em texto precisa distinguir o DADO da NARRAÇÃO
> sobre o dado.** Procurar um símbolo na saída inteira encontra também os
> comentários, cabeçalhos e avisos que falam sobre ele — e quanto melhor a
> mensagem explica o que mudou, mais provável que ela dispare o alarme.

Casar na estrutura, não no texto livre: a linha de dado tem forma conhecida
(`LB <n>/<n>%`), e é nela que se procura. Corolário desconfortável: **a
mensagem bem escrita é a que mais engana o verificador ingênuo.**

Mesmo dia, mesma família: quase publiquei uma decomposição de CPU em que dois
controles marcavam **+0 µs** — porque a edição que os criava tinha falhado no
`assert` e eu gravei o binário anterior. Um controle que não existe mede zero,
e zero parece dado. **O tell foi o +0 exato em dois itens independentes**;
número redondo demais é sintoma, não resultado.

---

## 12d. Delta entre builds não é atribuível (2026-08-20) — e nesta placa pode ser 25% (2026-08-23)

### A atualização de 2026-08-23, que sobe a regra de grau

Em 2026-08-20 a lição foi *"delta entre builds não é atribuível"*. Em 2026-08-23 mediu-se
**quanto** ele pode valer aqui, e o número muda o que a regra exige.

Duplicar dez params de caráter, com o **mesmo regime e o mesmo trabalho** nos
três binários:

| binário | o que mudou | pico médio |
|---|---|---|
| v0.130.0 | (linha de base) | **460,4 µs** |
| v0.131.0 | dez params duplicados | **437,0 µs** |
| v0.132.0 | **só** um `? :` por bloco | **347,0 µs** |

A v0.132.0 **acrescentou** trabalho e ficou 90 µs mais rápida. Entre a
primeira e a última: **113 µs, 25%, sem que o trabalho mudasse.**

O A/B no mesmo binário, alternando a cada leitura, deu o valor verdadeiro da
duplicação: **+6,6 µs contra 14 µs de espalhamento — indistinguível.**

### O mecanismo, que é desta placa e não genérico

**O código roda da QSPI.** Instrução buscada de flash externa através de
cache: alinhamento de linha e layout de função deixam de ser detalhe de
terceira ordem e viram **variável de primeira ordem**. Qualquer edição
desloca funções, e um laço quente que cruzava uma linha de cache pode passar
a caber nela — ou o contrário.

> **Nesta placa, o delta entre builds pode ser 25% sem nenhuma mudança de
> trabalho. Todo número de CPU citado sem A/B no mesmo binário é ruído com
> aparência de resultado.**

### O que isso explica retroativamente

Casos que ficaram sem culpado ganham um suspeito com mecanismo:

- o **638 vs 620 µs** da unificação de params;
- os **"40% mais rápido"** do BOOT_SRAM — que agora têm explicação
  concorrente: código em SRAM **elimina esta variável**, e parte do ganho
  pode ser a remoção da variância, não velocidade. Não muda a reprovação do
  BOOT_SRAM; muda o que se pode afirmar sobre o ganho dele.

### A consequência prática

**Todo ganho de teste que permite A/B no mesmo binário vale o código que
custa e fica no firmware.** O `ctos teto`/`ctos prazo` já eram assim; o
`dup on|off` entrou pelo mesmo motivo, e se declara em `board` porque
`dup off` altera o instrumento.

Medir custo aqui sem uma chave em tempo de execução não é medir com menos
precisão — **é não medir.**

---

### O caso original (2026-08-20)

O guarda do gate (`if(thresh > 0)`, pular quando o portão está aberto) mediu
**−58 µs** — comparando o total de v0.90.0 contra v0.91.0. Anunciei isso como o
ganho do guarda.

O dB desconfiou: o mesmo gate tinha medido **15 µs** por máscara. Quatro vezes
de diferença no instrumento invalida tudo o que ele mediu.

Medido de novo, **A/B no mesmo binário, na mesma janela** — com `thresh=0` o
guarda pula, com `thresh` mínimo ele processa sem portar nada:

| regime | gate pulado | gate rodando | custo |
|---|---|---|---|
| repouso | 159 µs | 185 µs | **+26** |
| carga total | 618 µs | 648 µs | **+30** |

**O gate custa 26–30 µs e não há super-linearidade.** A hipótese da I-cache
(código menor é mais rápido nesta plataforma) era plausível e já catalogada —
e não se aplica aqui.

Os −58 vinham de comparar **dois builds diferentes**, e entre eles mudaram
duas coisas: o guarda **e** a restauração do histograma pós-ganho, que
*acrescenta* trabalho. O saldo não fecha por ~40 µs em nenhuma direção.

> **Delta entre builds não é atribuível a nenhuma mudança específica.** Nesta
> plataforma o layout do código move a I-cache, e recompilar já muda o número.
> Custo só se atribui por **A/B no mesmo binário, na mesma janela** — de
> preferência alternando por parâmetro, não por recompilação.

A máscara, aliás, saiu absolvida: 16 contra 26 é ~1,6×, dentro do que variância
de layout e de corrida explicam. **O instrumento defeituoso era a comparação,
não a sonda** — e eu tinha acusado a sonda.

**Consequência que fica em aberto:** a rejeição da janela morna do warble
apoiava-se em 7 µs medidos por máscara. Corrigido pelo mesmo fator daria ~11 µs
— ainda pouco, mas é **estimativa**, não medição. Um A/B honesto exigiria um
param de toggle só para isso. Fica declarado como número fraco em vez de
promovido a fato.

---

## 12e. Deleção por faixa calculada, e a instrumentação órfã (2026-08-20)

Duas vezes na mesma sessão apaguei código que não pretendia apagar. As duas
operações têm a mesma forma: **deletar uma faixa cujos limites eu calculei em
vez de listar.** O que separa as duas é só o que as pegou.

### Incidente A — silencioso, achado por acaso

Substituir `s[i0:i1]` no `main.cpp`, com `i0` no `// 1) FONTE` e `i1` no
`// 3) MÓDULO`, para trocar os blocos de fonte, gate e caráter pela versão de
duas cadeias.

Dentro dessa faixa também morava o bloco `1.5`, que continha o **escritor** do
histograma pós-ganho (`out_pk_g`, `out_clip_g`, `hist_o[]`).

**Compilou limpo.** As variáveis continuaram declaradas e o comando `hist`
continuou **lendo** elas. O sintoma seria `hist` imprimindo *"pós-ganho 0"*
para sempre — indistinguível de "não chega sinal depois do ganho". Achado por
acaso, três turnos depois, procurando uma âncora para outra coisa. Nunca foi
commitado, mas rodou em firmware gravado durante várias corridas de medição.

### Incidente B — ruidoso, pego em dez segundos

`re.search` com `.*?` e lookahead, `re.S`, para remover um comentário do
`manifest.h`. Alvo: **7 linhas**. Apagou **50**. Colateral de 43: o bloco
inteiro de documentação do `in_gain` (por que mora pré-gate, por que não é o
mesmo que subir o `level`, o que ele **não** resolve) e a linha
`static constexpr int kCadeias = 2;`.

**Não reconstruí com confiança por que o padrão casou tão longe — e isso fica
assim de propósito**, porque a regra que sai daí é melhor que qualquer
explicação póstuma:

> **A falha é rodar operação destrutiva com um matcher de extensão
> imprevisível — não o casamento inesperado.** `.*?` com `re.S` pode
> atravessar o arquivo inteiro dependendo do lookahead. A extensão precisa ser
> **conhecida antes de deletar, não descoberta depois.**

Antídoto de duas etapas: **casar → imprimir o que casou → conferir a contagem
de linhas → só então apagar.**

### A regra

> **O perigo de uma deleção por faixa é proporcional a quanto do conteúdo
> apagado não é referenciado por nome em outro lugar.**

O compilador testemunha **dependências de símbolo, e nada mais.**

**Só-escrita é a subclasse mais perigosa** — produz *zero com cara de dado*.
Mas a mesma cegueira cobre as 43 linhas de prosa do `in_gain`: nenhum símbolo,
nenhuma reclamação, e prosa some ainda mais silenciosamente, porque ninguém
nunca vai notar a falta de um parágrafo que explicava um porquê.

> **O que lê, o compilador cobra. O que escreve, não.**

### A topologia explica os dois tempos

Não foi sorte nem atenção: **B apagou algo com vinte referências, A apagou algo
com zero.** O que tem muitos dependentes é quase impossível de perder em
silêncio; o que não tem nenhum é quase impossível de notar. O incidente B fez
barulho por sorte estrutural, não por mérito meu — se aquela regex tivesse
comido só comentários e instrumentação, teria passado igual ao A.

### Subtipo novo na família: INSTRUMENTAÇÃO ÓRFÃ

Os oito casos anteriores são *instrumentação presente que corrompe o que
mede*. Este é *instrumentação **ausente** que não avisa*. Sintoma oposto — lá
número errado, aqui número que nunca chega — e a mesma raiz:

> **A instrumentação não tem quem a defenda.** Ninguém depende dela, então nada
> a protege: nem compilador, nem teste, nem uso.

### Defesa acionável: dar testemunha à instrumentação

Fazer com que algo dependa dela **por nome** — um `static_assert`, um contador
que o `board` lê e cujo desaparecimento quebre o build, uma linha de teste que
referencie o escritor. Dá ao compilador uma testemunha onde hoje não há
nenhuma. É *hábito automatizado vence hábito lembrado* aplicado justamente à
classe de código que este projeto mais perde.

### Recuperação: recuperar um BLOCO não é restaurar um ARQUIVO

`git checkout` é o reflexo e é o **errado** quando há trabalho não commitado no
mesmo arquivo — no incidente B teria destruído a unificação de params. O que
funcionou:

```bash
git show HEAD:src/manifest.h     # extrai o bloco
# recola cirurgicamente, com âncora literal
```

### E uma correção do próprio relato

Eu disse ao dB *"terceira vez nesta sessão que uma regex minha come mais do que
devia"*. São **duas**, e uma nem era regex — era fatiamento por índice.

> **Contar errado para o lado que se acusa mais não é humildade: é o mesmo
> defeito com o sinal trocado. Em ambos os casos o número não veio de
> contagem.**

Vale sozinho porque a tentação de errar para o lado autocrítico é alta num
documento de cicatrizes, e corrompe o registro tanto quanto o exagero na
direção oposta.

**E a defesa que eu já tinha cobria isto.** A skill `edicao-segura` manda
âncora **literal e única**, conferida antes. Abandonei-a nas duas vezes, e nas
duas pelo mesmo motivo: a operação parecia grande demais para âncoras
individuais. É o raciocínio de quem pula o cinto na viagem curta — a regra
descartada exatamente na hora em que valia mais.

---

## 12f. Eliminação cirúrgica: o compilador como inventário (2026-08-20)

Tirar o motor externo do projeto era remover 56 sítios espalhados por três
arquivos,
seis arquivos-fonte, quatro diretórios de export e o sistema de slots inteiro.
Um mês antes eu teria feito isso apagando faixas e rezando — e acabara de
escrever a cicatriz 12e sobre por que isso não funciona.

**O método que funcionou inverte a 12e.** Se o compilador testemunha
dependências de símbolo, então **removo primeiro o símbolo-raiz e deixo que
ele liste os dependentes.**

```
1. remove o `#include "module.h"` e a declaração de `mod_slot[]`
2. compila
3. o compilador enumera CADA sítio restante, com número de linha
4. remove um por um, recompilando
```

Quatro erros na primeira passada, depois um, depois zero. **Nenhuma faixa
calculada, nenhuma prosa perdida.** O que a 12e chama de cegueira do
compilador vira ferramenta quando se usa na ordem certa: ele não vê o que
some, mas vê perfeitamente o que ficou órfão.

**A regra complementar da 12e:**

> **Para remover um subsistema, apague o símbolo do qual tudo depende e deixe
> o compilador enumerar o resto.** Não caçe as referências à mão: a lista dele
> é completa, a sua não é.

**Onde o método não alcança, e isso importa.** Ele só enumera o que tem
dependência de símbolo. O que sobrou invisível:

- **params órfãos** (`fx2_gain`, `fx2_hp`…) — existiam na tabela e ninguém
  os lia. Só apareceram quando removi as declarações e o compilador reclamou
  do único consumidor restante, que era um histograma que media um módulo
  fora do build havia dois dias.
- **prosa** — comentários explicando um sistema que não existe mais. Nenhum
  compilador reclama de um parágrafo órfão.
- **verificações sem objeto** — o `check_repo.sh` tinha um bloco inteiro
  conferindo exports que já não existiam. Passava sempre, e ia continuar passando para
  sempre, verificando nada.

> **Depois que o compilador parar de reclamar, ainda falta o que ele não vê:
> params sem leitor, prosa sem assunto, e verificações sem objeto.** Este
> último é o pior dos três: uma checagem que não tem mais o que checar **passa
> com sucesso** e ninguém desconfia de um `ok`.

**O que a remoção rendeu, medido:**

| | antes | depois |
|---|---|---|
| tudo ligado | 678 µs | **545 µs** |
| base (nada ligado) | 182 µs | **115 µs** |
| binário | 212 424 B | 175 980 B |
| params | 61 | 54 |
| repo | — | −8 MB de export |

Os **67 µs da base** são o dado que interessa: o módulo externo rodava **ligado ou
desligado**, porque um `Module::Process` não sabe se está em bypass. O efeito
que substituiu custa 11 µs quando ligado e **zero** quando não — a disciplina de
custo-zero-desligado, que todo efeito da casa segue, era estruturalmente
impossível dentro do sistema de slots.

---

## 12g. "Impossível" que era "impossível nesta arquitetura" (2026-08-20)

O dB pediu envio por cadeia em cada efeito da cauda — `dly_mix_a`,
`frz_mix_b`, e assim por diante. Respondi que **não era fisicamente
possível**, e argumentei bem: a cauda é serial, o `piezo_mix` soma A e B
antes dela, e quando o som chega ao freeze já é um objeto único. Não há um
"A" ali dentro para dosar.

Cada frase estava correta. **A conclusão não**, porque toda ela repousava
numa premissa que eu não examinei: *a cauda é serial*.

Serial era uma **escolha de desenho**, tomada quando havia um efeito de cada
tipo e nenhuma razão para outra coisa. Em paralelo — cada efeito virando um
destino irmão com envio próprio — o pedido não só é possível como custa quase
nada: **cada efeito continua sendo um só**, apenas recebe sua própria dose de
cada cadeia.

O dB insistiu, eu reexaminei, e o custo real da mudança foi **+15 a 20 µs**
contra os "impossível" que eu tinha dito.

> **Antes de dizer "não é possível", separar o que é lei do que é decisão
> minha.** Física não muda; arquitetura é escolha, e uma escolha antiga com
> boas razões *na época* não vira lei por ter durado.

O sintoma de que a distinção não foi feita é justamente a **qualidade do
argumento**: eu sustentei "impossível" com uma cadeia correta de deduções
sobre um sistema que eu mesmo tinha construído. Argumento bom sobre premissa
não examinada é mais perigoso que argumento fraco — ele convence os dois lados.

### E a estimativa não atravessou junto

Previ **807 µs** para o pior caso somando os custos medidos de reverb (+99) e
shimmer (+182) da cauda **serial**. Medido depois da mudança: **639 µs**, 209
abaixo.

A razão é a mesma da cicatriz: na cauda serial cada efeito processava o sinal
**inteiro**; em paralelo cada um recebe só o seu envio, e o shimmer de uma
cadeia não processa a cauda da outra. **Duas salas custaram menos que o dobro
de uma.**

> **Custo medido numa arquitetura não se transporta para outra.** Somar
> números de um desenho para prever outro é a mesma família do "delta entre
> builds não é atribuível" (12d) — ali o layout muda o número, aqui a
> topologia muda o que cada peça processa.

Errei para o lado seguro desta vez. Mas errar 26% para cima numa conta que
decide se algo cabe é o tipo de erro que, na direção contrária, teria matado
uma ideia boa antes de ela ser tentada.

---

## 12h. Redundância criada por uma mudança em outro lugar (2026-08-20)

O dB perguntou: *"qual a função de esp_mix? já não temos rev_mix?"*

Tinha razão, e eu precisei ler o código para descobrir que sim:

```
entrada da sala = cadeia × esp_mix     ← ganho na ENTRADA
sala 100% molhada
retorno         = saída  × rev_mix     ← ganho na SAÍDA
```

Dois ganhos em série no mesmo caminho. **Numa sala linear, entrada 0,5 com
saída 1,0 soa idêntico a entrada 1,0 com saída 0,5** — era o mesmo controle
escrito duas vezes.

**Ninguém adicionou um controle redundante.** Cada peça era correta quando
entrou: `rev_mix` era o dry/wet do reverb desde sempre, e `esp_mix` nasceu
como **crossfade** entre "vai pro espaço" e "sai seco", num desenho em que a
cauda era serial e o seco precisava contornar.

Quando a cauda virou **paralela**, o seco passou a passar por fora sozinho — e
o crossfade virou um ganho simples. **A redundância foi criada pelo refactor,
não pela adição.**

> **Refactor não cria só código morto: cria CONTROLE morto.** Um parâmetro que
> era necessário na arquitetura antiga vira duplicata na nova, e nada avisa —
> dois ganhos em série compilam, medem e soam. Só ficam confusos.

Depois de mudar a topologia, a pergunta não é só "o que quebrou?", mas **"o que
deixou de ser necessário?"**. A primeira o compilador responde; a segunda não
tem quem responda.
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
