Belquer/Cotucatronics/export/cerebro_2026-09-12_06db1c7/bom_cerebro.csv

Comment | Designator | Footprint | Qty | LCSC Part #
2200u/35V | C1 | Capacitor_THT:CP_Radial_D16.0mm_P7.50mm | 1
100n | C2,C4,C7,C9,C15,C16 | Capacitor_SMD:C_0805_2012Metric | 6 | C49678
100u | C3 | Capacitor_THT:CP_Radial_D6.3mm_P2.50mm | 1
47u | C5 | Capacitor_THT:CP_Radial_D6.3mm_P2.50mm | 1
470u 25V | C6 | Capacitor_THT:CP_Radial_D10.0mm_P5.00mm | 1
10u | C8 | Capacitor_SMD:C_1206_3216Metric | 1 | C13585
22n C0G | C12,C22 | Capacitor_SMD:C_1206_3216Metric | 2 | C3862155
2u2 filme | C14,C24 | Capacitor_THT:C_Rect_L7.2mm_W11.0mm_P5.00mm_FKS2_FKP2_MKS2_MKP2 | 2
SMBJ24A | D1 | Diode_SMD:D_SMB | 1 | C19077578
SS14 | D2 | Diode_SMD:D_SMA | 1 | C2480
BAV99 | D11,D21 | Package_TO_SOT_SMD:SOT-23 | 2 | C2500
PTC 3,3A | F1 | Fuse:Fuse_2920_7451Metric | 1 | C720183
entrada decoy PD | J1 | TerminalBlock_Phoenix:TerminalBlock_Phoenix_MKDS-1,5-2-5.08_1x02_P5.08mm_Horizontal | 1
ao amp TPA3116 | J2 | TerminalBlock_Phoenix:TerminalBlock_Phoenix_MKDS-1,5-2-5.08_1x02_P5.08mm_Horizontal | 1
step-down 5V fixo | J3 | Connector_PinHeader_2.54mm:PinHeader_1x03_P2.54mm_Vertical | 1
a ponte ESP32 | J4 | Connector_PinHeader_2.54mm:PinHeader_1x02_P2.54mm_Vertical | 1
fio -> jack piezo J5 | J5 | Connector_PinHeader_2.54mm:PinHeader_1x03_P2.54mm_Vertical | 1
fio -> jack piezo J6 | J6 | Connector_PinHeader_2.54mm:PinHeader_1x03_P2.54mm_Vertical | 1
modulo TPA3116 | J11 | Connector_PinHeader_2.54mm:PinHeader_1x04_P2.54mm_Vertical | 1
fio -> TRS linha L | J12 | Connector_PinHeader_2.54mm:PinHeader_1x03_P2.54mm_Vertical | 1
fio -> TRS linha R | J13 | Connector_PinHeader_2.54mm:PinHeader_1x03_P2.54mm_Vertical | 1
IDC 2x13 -> painel | J14 | Connector_IDC:IDC-Header_2x13_P2.54mm_Vertical | 1
fio -> DPDT tipo 2, canal L | J15 | Connector_PinHeader_2.54mm:PinHeader_1x08_P2.54mm_Vertical | 1
fio -> DPDT tipo 2, canal R | J16 | Connector_PinHeader_2.54mm:PinHeader_1x08_P2.54mm_Vertical | 1
100k | R5,R6,R8 | Resistor_SMD:R_0805_2012Metric | 3 | C149504
100R 1/4W | R7 | Resistor_SMD:R_1206_3216Metric | 1 | C17901
22k | R9 | Resistor_SMD:R_0805_2012Metric | 1 | C17560
0R | R10,R20 | Resistor_SMD:R_0805_2012Metric | 2 | C17477
4M7 | R11,R21 | Resistor_SMD:R_0805_2012Metric | 2 | C17674
1k | R12,R22 | Resistor_SMD:R_0805_2012Metric | 2 | C17513
100R | R14,R24 | Resistor_SMD:R_0805_2012Metric | 2 | C17408
10k — L | R50,R51 | Resistor_SMD:R_0805_2012Metric | 2 | C17414
OPA1642 | U1 | Package_SO:SOIC-8_3.9x4.9mm_P1.27mm | 1 | C67640
Daisy Seed3 | U2 | Module:Electrosmith_Daisy_Seed | 1
ESP32-C3 SuperMini | U3 | cotuca:ESP32C3_SUPERMINI_SOQUETE | 1
