Belquer/Cotucatronics/export/painel_2026-09-12_06db1c7/bom_painel.csv

Comment | Designator | Footprint | Qty | LCSC Part #
100n | C1,C2,C4,C5 | Capacitor_SMD:C_0805_2012Metric | 4 | C49678
100u 16V | C3 | Capacitor_THT:CP_Radial_D6.3mm_P2.50mm | 1
IDC 2x13 femea <- cerebro | J1 | Connector_IDC:IDC-Header_2x13_P2.54mm_Vertical | 1
OLED SSD1309 2,54mm 7p | J2 | Connector_PinHeader_2.54mm:PinHeader_1x07_P2.54mm_Vertical | 1
fio -> arcade AZUL freeze A | J3 | Connector_JST:JST_XH_B2B-XH-A_1x02_P2.50mm_Vertical | 1
fio -> arcade AZUL freeze B | J4 | Connector_JST:JST_XH_B2B-XH-A_1x02_P2.50mm_Vertical | 1
fio -> arcade BRANCO buzios | J5 | Connector_JST:JST_XH_B2B-XH-A_1x02_P2.50mm_Vertical | 1
fio -> LED do arcade A (1=A, 2=K) | J6 | Connector_JST:JST_XH_B2B-XH-A_1x02_P2.50mm_Vertical | 1
fio -> LED do arcade B (1=A, 2=K) | J7 | Connector_JST:JST_XH_B2B-XH-A_1x02_P2.50mm_Vertical | 1
AO3400A | Q1,Q2 | Package_TO_SOT_SMD:SOT-23 | 2 | C20917
100R gate | R1,R2 | Resistor_SMD:R_0805_2012Metric | 2 | C17408
10k pull-down | R3,R4 | Resistor_SMD:R_0805_2012Metric | 2 | C17414
100R serie (~30 mA) | R5,R6 | Resistor_SMD:R_1210_3225Metric | 2 | C2933799
10k lin | RV1,RV2 | Potentiometer_THT:Potentiometer_Bourns_PTV09A-1_Single_Vertical | 2
EC11 — o unico encoder | SW1 | Rotary_Encoder:RotaryEncoder_Alps_EC11E-Switch_Vertical_H20mm | 1
