Belquer/Cotucatronics/export/COMPRA_MOUSER_template.xls

Sheet: Sheet1
Mfr Part Number (Input) | Manufacturer Part Number | Mouser Part Number | Manufacturer Name | Description | Quantity 1 | Unit Price 1 | Quantity 2 | Unit Price 2 | Quantity 3 | Unit Price 3 | Quantity 4 | Unit Price 4 | Quantity 5 | Unit Price 5 | Order Quantity | Order Unit Price | Min./Mult. | Availability | Lead Time in Days | Lifecycle | NCNR | RoHS | Pb Free | Package Type | Datasheet URL | Product Image | Design Risk
RC0805FR-07100RL | RC0805FR-07100RL |  | Yageo | R 100R 0805 1% 1/8W thick film (Yageo). Cerebro R14,R24 + Painel R1,R2. equiv qualquer 100R 0805 1%. | 6
RC0805FR-0710KL | RC0805FR-0710KL |  | Yageo | R 10k 0805 1% 1/8W thick film (Yageo). Cerebro R50,R51 + Painel R3,R4. equiv qualquer 10k 0805 1%. | 6
RC0805FR-07100KL | RC0805FR-07100KL |  | Yageo | R 100k 0805 1% 1/8W thick film (Yageo). Cerebro R5,R6,R8. equiv qualquer 100k 0805 1%. | 5
RC0805FR-0722KL | RC0805FR-0722KL |  | Yageo | R 22k 0805 1% 1/8W thick film (Yageo). Cerebro R9. equiv qualquer 22k 0805 1%. | 3
RC0805JR-070RL | RC0805JR-070RL |  | Yageo | R 0R (jumper) 0805 (Yageo). Cerebro R10,R20. equiv qualquer 0 ohm 0805. | 4
RC0805FR-074M7L | RC0805FR-074M7L |  | Yageo | R 4M7 0805 1% 1/8W thick film (Yageo). Cerebro R11,R21. equiv qualquer 4.7M 0805 1%. | 4
RC0805FR-071KL | RC0805FR-071KL |  | Yageo | R 1k 0805 1% 1/8W thick film (Yageo). Cerebro R12,R22. equiv qualquer 1k 0805 1%. | 4
RC1206FR-07100RL | RC1206FR-07100RL |  | Yageo | R 100R 1206 1% 1/4W thick film (Yageo). Cerebro R7 (100R 1/4W). equiv qualquer 100R 1206 1%. | 3
RC1210FR-07100RL | RC1210FR-07100RL |  | Yageo | R 100R 1210 1% 1/2W thick film (Yageo). Painel R5,R6 (serie ~30mA p/ LED arcade). equiv qualquer 100R 1210. | 4
CL21B104KBCNNNC | CL21B104KBCNNNC |  | Samsung | C 100nF 0805 50V X7R (Samsung) = LCSC C49678. Cerebro C2,C4,C7,C9,C15,C16 (6) + Painel C1,C2,C4,C5 (4) = 10, +20%. equiv Yageo CC0805KRX7R9BB104. | 12
CL31B106KAHNNWE | CL31B106KAHNNWE | 187-CL31B106KAHNNWE | Samsung | C 10uF 1206 25V X7R (Samsung CL31B). Cerebro C8. verificado em estoque no Mouser 187-CL31B106KAHNNWE (2026-09-12). Alt: Murata GRM31CR61E106KA12L (25V X5R), TDK C3216X5R1E106K160AB, Taiyo Yuden TMK316ABJ106KL-T. | 3
C1206C223J5GACTU | C1206C223J5GACTU |  | Kemet | C 22nF 1206 50V C0G/NP0 (Kemet) = equiv de LCSC C3862155. Cerebro C12,C22. C0G obrigatorio. confirmar estoque. | 4
SMBJ24A | SMBJ24A |  | Littelfuse | TVS unidirecional SMB 24V standoff (Littelfuse) = LCSC C19077578. Cerebro D1 (protecao entrada). | 3
SS14 | SS14 | 512-SS14 | onsemi | Diodo Schottky SMA/DO-214AC 40V 1A (onsemi). Cerebro D2. verificado em estoque no Mouser 512-SS14 (2026-09-12); footprint D_SMA. Alt: Vishay SK14-E3/61T, MCC SS14-TP, Diodes SS14L-13-F. NAO usar SS14FL (SMAF, footprint diferente). | 3
BAV99-7-F | BAV99-7-F |  | Diodes Inc | Diodo duplo comutacao SOT-23 (Diodes Inc) = BAV99 = LCSC C2500. Cerebro D11,D21. | 4
SI2302CDS-T1-GE3 | SI2302CDS-T1-GE3 | 781-SI2302CDS-T1-GE3 | Vishay | MOSFET N-ch SOT-23 20V logic-level (Vishay). Painel Q1,Q2 (drivers low-side de LED, Vds<=5V - 20V ok). verificado em estoque no Mouser 781-SI2302CDS-T1-GE3 (2026-09-12). Alt: Diodes DMN3404L-7 (30V), DMG3404L-7, onsemi NTR4003NT1G. | 4
OPA1642AID | OPA1642AID |  | TI | Amp. op. audio JFET duplo SOIC-8 (Texas Instruments) = OPA1642 = LCSC C67640. Cerebro U1. Mouser vende TI direto. | 3
MF-LSMF300/24X-2 | MF-LSMF300/24X-2 | 652-MF-LSMF300/24X-2 | Bourns | PTC resetavel 2920 hold 3A / trip 5.2A / 24V (Bourns MF-LSMF), footprint Fuse_2920_7451Metric (2920/7450 metric = mesma land 2920 do 7451). Cerebro F1. verificado em estoque no Mouser 652-MF-LSMF300/24X-2 (2026-09-12). Alt: Littelfuse 2920L330/24MR (3.3A/24V). NAO usar Bel 0ZCF (so 6V). | 3
ECA-1VM222 | ECA-1VM222 |  | Panasonic | Cap eletrolitico radial 2200uF 35V D16 P7.5mm (Panasonic). THT Cerebro C1. equiv Nichicon/Rubycon 2200uF 35V mesmo corpo. | 3
ECA-1EM471 | ECA-1EM471 |  | Panasonic | Cap eletrolitico radial 470uF 25V D10 P5mm (Panasonic). THT Cerebro C6. | 3
ECA-1EM101 | ECA-1EM101 |  | Panasonic | Cap eletrolitico radial 100uF 25V D6.3 P2.5mm (Panasonic). THT Cerebro C3 (100u) + Painel C3 (100u 16V) — 25V cobre os dois. | 4
ECA-1HM470 | ECA-1HM470 |  | Panasonic | Cap eletrolitico radial 47uF 50V D6.3 P2.5mm (Panasonic). THT Cerebro C5. | 3
MKS2C042201M00KN00 | MKS2C042201M00KN00 | 505-MKS2C042201M00KN | WIMA | Cap filme box 2.2uF 63V PET, PCM5, corpo 7.2x8.5x14mm (WIMA MKS2). THT Cerebro C14,C24. verificado em estoque no Mouser 505-MKS2C042201M00KN (2026-09-12). altura 14mm cabe na caixa (~42mm interno min). ATENCAO: Kemet R82 2.2uF exige passo 7.5mm+ (NAO cabe no P5). Alt mesmo corpo P5: Vishay BFC2378 MKT 2.2uF, EPCOS/TDK B32 2.2uF. | 4
1715721 | 1715721 |  | Phoenix Contact | Bloco de terminais Phoenix MKDS 1,5/2-5,08 2 vias 5.08mm horizontal (Phoenix Contact). Cerebro J1 (decoy PD) + J2 (amp TPA3116). equiv qualquer terminal 2P passo 5.08mm. | 4
B2B-XH-A(LF)(SN) | B2B-XH-A(LF)(SN) |  | JST | Conector JST XH 2 vias vertical THT, header de placa (JST). Painel J3,J4,J5,J6,J7 (arcade/LED). Precisa tb housing XHP-2 + terminais SXH-001T-P0.6 no lado do fio. | 7
61202621621 | 61202621621 | 710-61202621621 | Wurth Elektronik | Box header blindado 2x13 26 pinos 2.54mm THT vertical macho (Wurth Elektronik WR-BHD) = 'IDC 2x13'. Cerebro J14 + Painel J1. verificado em estoque no Mouser 710-61202621621 (2026-09-12); footprint IDC-Header_2x13_P2.54mm_Vertical. Alt: Adam Tech BHR-26-VUA, CNC Tech 3020-26-0100-00, Amphenol 71922-126LF. | 4
61304011121 | 61304011121 | 710-61304011121 | Wurth Elektronik | Barra de pinos macho 1x40 2.54mm THT destacavel vertical (Wurth Elektronik WR-PHD). Cortar p/ TODOS os headers 1 fila 2.54mm: Cerebro J3(1x3),J4(1x2),J5(1x3),J6(1x3),J11(1x4),J12(1x3),J13(1x3),J15(1x8),J16(1x8) + Painel J2 (1x7 OLED). ~44 pinos; 4 barras = folga. verificado em estoque no Mouser 710-61304011121 (2026-09-12). Alt: Amphenol 68000-140HLF, Sullins PREC040SAAN-RC, Adam Tech PH1-40-UA. | 4
PTV09A-4020F-B103 | PTV09A-4020F-B103 |  | Bourns | Potenciometro Bourns PTV09A 10k linear 9mm, pinos PC vertical (Bourns). Painel RV1,RV2. confirmar variante de eixo (F=6mm flatted). | 4
EC11E15244C0 | EC11E15244C0 |  | Alps | Encoder rotativo incremental Alps EC11E c/ chave, vertical, eixo 20mm (Alps Alpine). Painel SW1. Confirmar detentes/comprimento de eixo (familia EC11E15244xx). | 3

Sheet: carimbo
carimbo: COMPRA_MOUSER_template.xls v2 · 2026-09-12 · placas: painel rev C · cerebro rev C
