Belquer/Cotucatronics/caixa/cotuca_caixa_20260906_r5_acrilico_3p0_0070f4e8.dxf

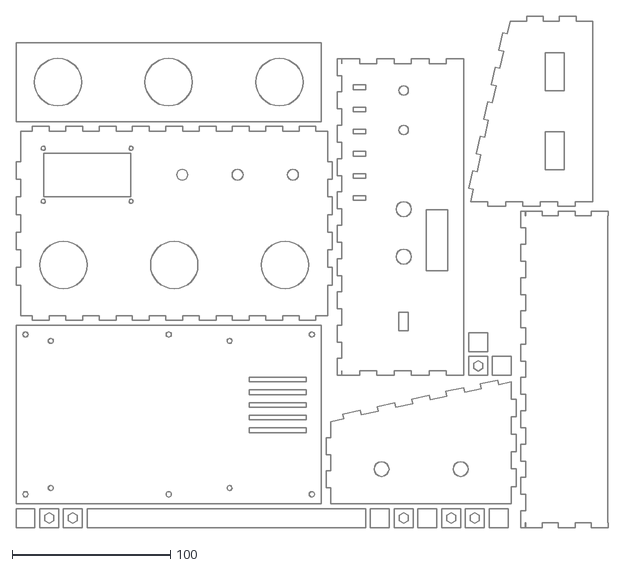
[picture p1: CAD file, 2026-09-06]
caixa/cotuca_caixa_20260906_r5_acrilico_3p0_0070f4e8.dxf
374.1 x 323.0
