Belquer/Cotucatronics/caixa/cotuca_caixa_20260906_r3_acrilico_3p0_037a9c30.dxf

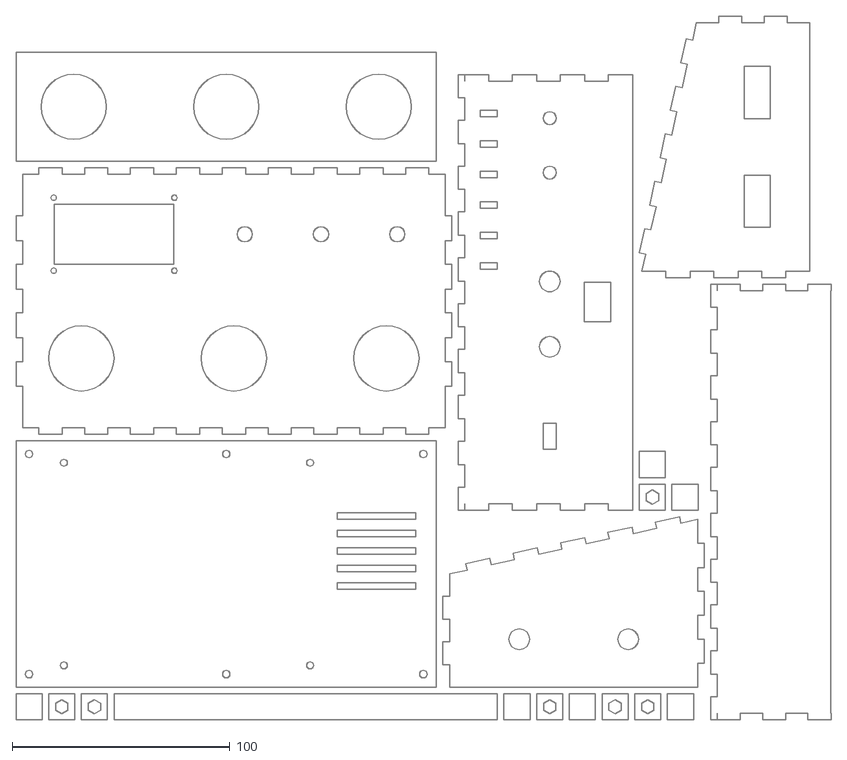
[picture p2: CAD file, 2026-09-06]
caixa/cotuca_caixa_20260906_r3_acrilico_3p0_037a9c30.dxf
374.1 x 323.0
