Belquer/Cotucatronics/caixa/cotuca_caixa_r2_acrilico_3p0_55cf3955.dxf

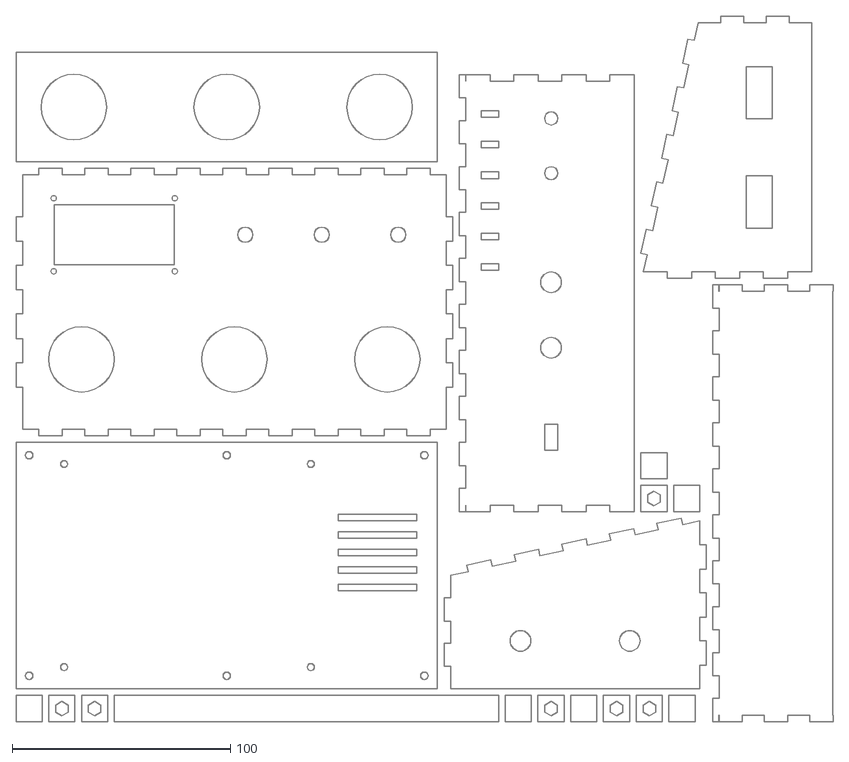
[picture p3: CAD file, 2026-09-06]
caixa/cotuca_caixa_r2_acrilico_3p0_55cf3955.dxf
374.1 x 323.0
