Belquer/Cotucatronics/caixa/BUILD-SHEET-CASCO.html

# Montagem do CASCO

Caixa acrílico 3,0 mm cast, kerf 0,2 mm compensado · cunha 200×120, frente 55 / trás 80, tampa a 11,8° · Cotucatronics

NÃO colar o FUNDO — é a porta de serviço parafusada.

O casco são as 5 faces soldadas (tampa + 4 paredes) + reforço + nervura + calços. O FUNDO entra depois, por baixo, com 6 parafusos M3×10 em porcas cativas. O que custa dinheiro sai; o que fica soldado é acrílico.

## 1. Materiais & ferramentas

- Peças de acrílico 3,0 mm (com a película de proteção ainda colada)
- Weld-On 4 — solvente fino (juntas a 90° e colagens face-a-face)
- Weld-On 16 — gel (só juntas tampa↔frente / tampa↔trás, a 11,8°)
- Frasco aplicador com agulha (sem ele não há capilaridade)
- Esquadro pequeno
- Lixa fina 400 / 600 (à água)
- Luvas de nitrilo (cloreto de metileno; látex não serve)
- Ventilação — bancada arejada / extração
- Fita de pintor forte ou 4 grampos de mola
- Pano de microfibra + álcool isopropílico (nunca acetona)

Não usar: super-cola (racha o acrílico em teia branca), epóxi, cola quente, acetona para limpar.

## 2. Pré-cola (a seco)

- Manter a película de proteção em todas as peças — o vapor do solvente esbranquiça a superfície onde toca. (só sai no fim, depois das 24 h de cura)
- Rebarbar as arestas dos dedos com lixa 400, uma passagem, só onde a junta prender.
- Montar o casco a seco: frente + esquerda + direita + trás. Dedos entram à mão com atrito leve.
- Pousar a tampa a seco; os dedos da frente/trás entram enviesados (11,8°). Se prender, lixar os cantos dos dedos da frente/trás — nunca a tampa.
- Conferir cotas: exterior 200×120, frente 55, trás 80; diagonais do fundo aberto iguais = esquadro.
- Encaixar o fundo por baixo (folga ~0,5 mm) e tirá-lo.
- Dry-fit dos controlos nos furos da tampa: 3× arcade ø30, encoder + 2 pots ø7, OLED (janela + 4× M2.5). Um furo 0,5 mm fora corrige-se agora com lixa, não depois de colada.

## 3. Sequência de colagem

5. Reforço sob a tampa — Weld-On 4 (face-a-face, capilar). Faixa 193×50 colada por baixo da tampa, centrada, bordo da frente a 10 mm da borda dianteira do corpo, com os 3 furos ø30 concêntricos com os da tampa. Confere a seco com um botão enfiado nos dois furos antes do solvente. Agulha pela aresta, peso distribuído (tábua + livro), 30 min.
  Junto: a nervura (tira 12×176) cola-se também sob a tampa com Weld-On 4, ao longo dos 200 mm, a y ≈ 62 mm da frente (entre a fila dos arcade e a dos knobs). Peso, 30 min.
6. 4 paredes nos cantos verticais — Weld-On 4 (90°). Montar frente + esquerda + direita + trás, fita em volta, esquadro nas diagonais. Ponta da agulha ao longo de cada junta, por dentro — entra por capilaridade. Uma passagem lenta por junta; 30 s sem mexer por canto (4 cantos ≈ 2 min).
7. Tampa às paredes — Weld-On 16 na frente/trás (11,8°) + Weld-On 4 nas laterais (90°). Só depois de a §2 confirmar que tudo entra nos furos. Gel nas ranhuras da frente e de trás; solvente nas ranhuras das laterais. Pousar, alinhar os dedos, peso distribuído. Limpar o excesso de gel com pano seco enquanto está fresco.
8. Cura. 1 hora antes de tocar; 24 h antes de carregar. Só então tirar as películas.

## 4. Juntas → adesivo

Junta | Ângulo | Adesivo
4 cantos verticais (parede ↔ parede) | 90° | Weld-On 4
Tampa ↔ frente | 11,8° | Weld-On 16
Tampa ↔ trás | 11,8° | Weld-On 16
Tampa ↔ laterais | 90° | Weld-On 4
Reforço ↔ tampa (laminado) | face | Weld-On 4
Nervura ↔ tampa | face | Weld-On 4
Calços CB/CT (às paredes) | face | Weld-On 4

### NÃO faças agora

- NÃO colar o FUNDO — é a porta de serviço, entra por baixo com 6 parafusos M3×10 em porcas M3 cativas (sexágono 5,7 mm A/F).
- NÃO montar placas nem controlos ainda — carrier, amp e painel entram só quando a placa chegar.

## 5. Segurança

- Weld-On 4/16 têm cloreto de metileno: usar sempre com ventilação.
- Luvas de nitrilo (látex não protege deste solvente).
- Proteção de olhos; evitar respirar o vapor; frasco fechado quando não em uso.

## 6. Depois (quando a placa chegar)

1. Bench test da placa antes de fechar seja o que for.
2. Parafusar no fundo: carrier nos 4 espaçadores M3×10 F-F; módulo do amp nos espaçadores dele.
3. Conectar os cabos (tudo com conector, nada soldado de placa a painel), com ~80 mm de folga em cada cabo que vai do fundo à casca — é o que permite abrir sem desligar.
4. Fechar o fundo com os 6 parafusos M3×10; pés adesivos.

o que custa dinheiro sai; o que fica soldado é acrílico.
