Belquer/Cotucatronics/docs/montagem/manual_montagem.html

# Cotucatronics Manual de montagem

Das placas nuas até o instrumento ligado: cérebro, painel, caixa de acrílico e fios. Siga os passos na ordem. Onde houver ✋, pare e confira antes de seguir.

gerado por tools/manual_montagem.py v0.23.0 · 22/09/2026 · commit d11ff7d (árvore com alterações) · placas do pacote 06db1c7 (rev C)

## 0Antes de começar

1

### Ferramentas1 bancada

- Ferro de solda com ponta fina (cônica ou chanfro 1–2 mm), ~330 °C
- Solda 0,5–0,8 mm com fluxo, e fluxo extra (caneta ou pasta)
- Pinça de ponta fina · lupa ou lente de aumento · malha dessoldadora
- Multímetro com bipe de continuidade — vai ser usado em quase todos os passos
- Alicate de corte rente · alicate de bico · chave Phillips pequena
- Furadeira com brocas ø3,2 e ø7,5 (ou escareador) — para placa e tampa
- Para a caixa: Weld-On 4 com frasco de agulha, Weld-On 16, luvas de nitrilo, fita crepe, esquadro
- Caneta permanente fina, para marcar fios e pinos

feito

2

### Cinco regras que valem para tudo

- O quadrado é o pino 1. Em toda peça com polaridade, o pad quadrado na placa marca o pino 1 (ou o +). Nos desenhos deste manual ele aparece como ■.
- E o quadrado continua visível POR BAIXO, depois da peça soldada. A serigrafia some debaixo do corpo do borne, do header ou do módulo — o pad quadrado não some: vire a placa e ele está lá, do outro lado dos mesmos furos.
- Nunca vire de cabeça para baixo um conector com chave (IDC, JST dos LEDs). Virar troca pinos — alguns são alimentação. Onde o manual manda soldar algo por baixo, ele diz exatamente o quê.
- Antes de ligar qualquer coisa na energia, bipe. Os passos dizem quais pontos têm que bipar e quais não podem bipar.
- A peça na sua mão manda. Se ela não bate com o desenho, pare e pergunte. Não force, não lixe placa, não improvise.
- Marque cada passo como feito na caixinha ✓ quando terminar. A página lembra onde você parou.

Solda com chumbo e solvente de acrílico são tóxicos: janela aberta, mãos lavadas, nada de comer na bancada.

feito

## 1Confira tudo

3

### Identifique os sacos da Mouser — e escreva o valor em cada um21 sacos

A etiqueta da Mouser não diz o valor de um jeito fácil de ler: o que salta à vista é um código, como 603-RC0805FR-07100RL. Procure esse código na coluna na etiqueta e escreva no saco, com caneta, o que está na coluna escreva no saco. A tabela está em ordem alfabética do código.

| na etiqueta | é | escreva no saco | mede | qtd | vai em
☐ | 187-CL21B104KBCNNNC | capacitor cerâmico | 100 nF | 2 × 1,25 mm | 12 | cérebro C2 C4 C7 C9 C15 C16 · painel C1 C2 C4 C5
☐ | 187-CL31B106KAHNNWE | capacitor cerâmico | 10 µF | 3,2 × 1,6 mm | 3 | cérebro C8
☐ | 306-B2BXHALFSNP | conector JST XH 2 vias | JST 2p | — | 7 | painel J3 J4 J5 J6 J7
☐ | 512-SS14 | diodo Schottky | SS14 | — | 3 | cérebro D2
☐ | 595-OPA1642AID | amplificador operacional | OPA1642 | — | 3 | cérebro U1
☐ | 603-RC0805FR-07100KL | resistor | 100 kΩ | 2 × 1,25 mm | 5 | cérebro R5 R6 R8
☐ | 603-RC0805FR-07100RL | resistor | 100 Ω pequeno | 2 × 1,25 mm | 6 | cérebro R14 R24 · painel R1 R2
☐ | 603-RC0805FR-0710KL | resistor | 10 kΩ | 2 × 1,25 mm | 6 | cérebro R50 R51 · painel R3 R4
☐ | 603-RC0805FR-071KL | resistor | 1 kΩ | 2 × 1,25 mm | 4 | cérebro R12 R22
☐ | 603-RC0805FR-0722KL | resistor | 22 kΩ | 2 × 1,25 mm | 3 | cérebro R9
☐ | 603-RC0805FR-074M7L | resistor | 4,7 MΩ | 2 × 1,25 mm | 4 | cérebro R11 R21
☐ | 603-RC0805JR-070RL | resistor jumper | 0 Ω | 2 × 1,25 mm | 4 | cérebro R10 R20
☐ | 603-RC1206FR-07100RL | resistor | 100 Ω médio | 3,2 × 1,6 mm | 3 | cérebro R7
☐ | 603-RC1210FR-07100RL | resistor | 100 Ω grande | 3,2 × 2,5 mm | 4 | painel R5 R6
☐ | 621-BAV99-F | diodo duplo | BAV99 | — | 4 | cérebro D11 D21
☐ | 651-1715721 | borne de parafuso 2 vias | borne 2p | — | 4 | cérebro J1 J2
☐ | 652-MF-LSMF300/24X-2 | fusível rearmável | PTC 3 A | — | 3 | cérebro F1
☐ | 652-SMBJ24A | diodo TVS (proteção) | SMBJ24A | — | 3 | cérebro D1
☐ | 710-61202621621 | conector IDC 2×13 com caixa | IDC 26p | — | 4 | cérebro J14 · painel J1
☐ | 781-SI2302CDS-T1-GE3 | transistor MOSFET | SI2302 | — | 4 | painel Q1 Q2
☐ | 80-C1206C223J5G | capacitor cerâmico C0G | 22 nF | 3,2 × 1,6 mm | 4 | cérebro C12 C22

- Resistor Yageo RC0805FR-07100KL: o número depois de RC é o tamanho (0805, 1206, 1210); o valor fica entre o -07 e o L final. R = ohms, K = mil, M = milhão, 4M7 = 4,7 MΩ, 0R = zero ohm.
- Capacitor Samsung CL21B104…: 21 = 0805, 31 = 1206. O 104 é 10 seguido de 4 zeros, em pF: 100 000 pF = 100 nF. 106 = 10 µF. No Kemet C1206C223, o mesmo: 22 000 pF = 22 nF.
- Diodos, transistor, chip e fusível: o nome é o valor (SS14, BAV99, OPA1642).
- Abra um saco de cada vez e feche antes de abrir o próximo. Duas pecinhas 0805 soltas na mesa ficam iguais para sempre. Os passos de solda seguem esta mesma ordem: um saco por passo, até esvaziá-lo.
- Quando o mesmo valor vem em dois tamanhos, o nome leva pequeno / médio / grande (0805 / 1206 / 1210). Escreva a palavra no saco: é o que distingue na bancada.
- Não vieram neste pedido: cérebro C1 C3 C5 C6 C14 C24 J3 J4 J5 J6 J11 J12 J13 J15 J16 U2 U3 · painel C3 J2 RV1 RV2 SW1.

PARE. Há três sacos de 100 Ω que só mudam no tamanho. Escreva o tamanho no saco: pequeno (RC0805, 2 × 1,25 mm), médio (RC1206, 3,2 × 1,6 mm, só o R7 do cérebro) e grande (RC1210, 3,2 × 2,5 mm, R5/R6 do painel). E 100K é resistor, 104 é capacitor. Leia o código inteiro.

fonte: notificação de envio da Mouser, pedido 40440548 · export/mouser_40440548.csv

feito

4

### Confira as peças do CÉREBRO (placa grande)50 peças

| valor | qtd | referências | encapsulamento | lado
☐ | 470u 25V | 1 | C6 | CP Radial D10.0mm P5.00mm | por cima
☐ | 2200u/35V | 1 | C1 | CP Radial D16.0mm P7.50mm | por cima
☐ | 100u | 1 | C3 | CP Radial D6.3mm P2.50mm | por cima
☐ | 47u | 1 | C5 | CP Radial D6.3mm P2.50mm | por cima
☐ | 100n | 6 | C2 C4 C7 C9 C15 C16 | C 0805 2012Metric | por baixo
☐ | 10u | 1 | C8 | C 1206 3216Metric | por cima
☐ | 22n C0G | 2 | C12 C22 | C 1206 3216Metric | por cima
☐ | 2u2 filme | 2 | C14 C24 | C Rect L7.2mm W11.0mm P5.00mm FKS2 | por cima
☐ | SS14 | 1 | D2 | D SMA | por cima
☐ | SMBJ24A | 1 | D1 | D SMB | por cima
☐ | ESP32-C3 SuperMini | 1 | U3 | ESP32C3 SUPERMINI SOQUETE | por cima
☐ | Daisy Seed3 | 1 | U2 | Electrosmith Daisy Seed | por cima
☐ | PTC 3A | 1 | F1 | Fuse 2920 7451Metric | por cima
☐ | IDC 2x13 -> painel | 1 | J14 | IDC-Header 2x13 P2.54mm Vertical | por cima
☐ | a ponte ESP32 | 1 | J4 | PinHeader 1x02 P2.54mm Vertical | por cima
☐ | fio -> TRS linha L | 1 | J12 | PinHeader 1x03 P2.54mm Vertical | por cima
☐ | fio -> TRS linha R | 1 | J13 | PinHeader 1x03 P2.54mm Vertical | por cima
☐ | fio -> jack piezo J5 | 1 | J5 | PinHeader 1x03 P2.54mm Vertical | por cima
☐ | fio -> jack piezo J6 | 1 | J6 | PinHeader 1x03 P2.54mm Vertical | por cima
☐ | step-down 5V fixo | 1 | J3 | PinHeader 1x03 P2.54mm Vertical | por cima
☐ | modulo TPA3116 | 1 | J11 | PinHeader 1x04 P2.54mm Vertical | por cima
☐ | fio -> DPDT tipo 2, canal L | 1 | J15 | PinHeader 1x08 P2.54mm Vertical | por cima
☐ | fio -> DPDT tipo 2, canal R | 1 | J16 | PinHeader 1x08 P2.54mm Vertical | por cima
☐ | 0R | 2 | R10 R20 | R 0805 2012Metric | por cima
☐ | 100R | 2 | R14 R24 | R 0805 2012Metric | por cima
☐ | 100k | 3 | R5 R6 R8 | R 0805 2012Metric | por cima
☐ | 10k — L | 1 | R50 | R 0805 2012Metric | por cima
☐ | 10k — R | 1 | R51 | R 0805 2012Metric | por cima
☐ | 1k | 2 | R12 R22 | R 0805 2012Metric | por cima
☐ | 22k | 1 | R9 | R 0805 2012Metric | por cima
☐ | 4M7 | 2 | R11 R21 | R 0805 2012Metric | por cima
☐ | 100R 1/4W | 1 | R7 | R 1206 3216Metric | por cima
☐ | OPA1642 | 1 | U1 | SOIC-8 3.9x4.9mm P1.27mm | por cima
☐ | BAV99 | 2 | D11 D21 | SOT-23 | por cima
☐ | ao amp TPA3116 | 1 | J2 | TerminalBlock Phoenix MKDS-1,5-2-5 | por cima
☐ | entrada decoy PD | 1 | J1 | TerminalBlock Phoenix MKDS-1,5-2-5 | por cima

Não montar (o lugar existe na placa, mas fica vazio): C11 C13 C21 C23 RV1 RV2 R13 R23 — não é esquecimento: são a perna de ganho do pré-amp, que hoje é um seguidor (ganho 1, pelo R10/R20 de 0 Ω). Só se montam se o ganho ajustável voltar. Os pontos TP são só pads de teste, e os H são furos.

fonte: pacote de fábrica cerebro_2026-09-12_06db1c7 · cpl_rico_cerebro.csv

feito

5

### Confira as peças do PAINEL (placa comprida)23 peças

| valor | qtd | referências | encapsulamento | lado no desenho
☐ | 100u 16V | 1 | C3 | CP Radial D6.3mm P2.50mm | por cima
☐ | 100n | 1 | C4 | C 0805 2012Metric | por cima
☐ | 100n COLADO ao IDC | 1 | C5 | C 0805 2012Metric | por cima
☐ | 100n COLADO ao cursor | 2 | C1 C2 | C 0805 2012Metric | por cima
☐ | IDC 2x13 femea <- cerebro | 1 | J1 | IDC-Header 2x13 P2.54mm Vertical | por cima
☐ | fio -> LED do arcade A (1=A, 2=K) | 1 | J6 | JST XH B2B-XH-A 1x02 P2.50mm Verti | por cima
☐ | fio -> LED do arcade B (1=A, 2=K) | 1 | J7 | JST XH B2B-XH-A 1x02 P2.50mm Verti | por cima
☐ | fio -> arcade AZUL freeze A | 1 | J3 | JST XH B2B-XH-A 1x02 P2.50mm Verti | por cima
☐ | fio -> arcade AZUL freeze B | 1 | J4 | JST XH B2B-XH-A 1x02 P2.50mm Verti | por cima
☐ | fio -> arcade BRANCO buzios | 1 | J5 | JST XH B2B-XH-A 1x02 P2.50mm Verti | por cima
☐ | OLED SSD1309 2,54mm 7p | 1 | J2 | PinHeader 1x07 P2.54mm Vertical | por cima
☐ | 10k lin | 2 | RV1 RV2 | Potentiometer Bourns PTV09A-1 Sing | por cima
☐ | 100R gate | 2 | R1 R2 | R 0805 2012Metric | por cima
☐ | 10k pull-down | 2 | R3 R4 | R 0805 2012Metric | por cima
☐ | 100R serie (~30 mA) | 2 | R5 R6 | R 1210 3225Metric | por cima
☐ | EC11 — o unico encoder | 1 | SW1 | RotaryEncoder Alps EC11E-Switch Ve | por cima
☐ | AO3400A | 2 | Q1 Q2 | SOT-23 | por cima

Os transistores Q1/Q2 que vieram são SI2302CDS (marcados N2), não AO3400A como diz a lista. É a peça certa — mesma pinagem.

fonte: pacote de fábrica painel_2026-09-12_06db1c7 · MANIFEST v5

feito

6

### Confira os módulos e as peças do painel frontal

| peça | qtd | vai onde
☐ | Daisy Seed (placa de áudio) | 1 | soquete U2 do cérebro
☐ | ESP32-C3 SuperMini (ponte MIDI) | 1 | soquete U3 do cérebro
☐ | Amplificador TPA3116 estéreo | 1 | fundo da caixa, espaçadores
☐ | Step-down 5 V fixo | 1 | fios no J3 do cérebro
☐ | Decoy PD 15 V (gatilho USB-C) | 1 | parede de trás
☐ | OLED Waveshare 2,42" + o cabo dele (MX1.25 → jumpers fêmea) | 1 | tampa, por dentro
☐ | Encoder EC11 com rosca e porca | 1 | SW1 do painel + tampa
☐ | Potenciômetro 16 mm, 10 kΩ linear, com porca | 2 | tampa (ligados por fios)
☐ | Botão arcade 30 mm AZUL com LED 5 V | 2 | tampa
☐ | Botão arcade 30 mm BRANCO (búzios) | 1 | tampa
☐ | Jack TRS 1/4" Neutrik NMJ6HCD2 | 4 | 2 na esquerda (piezos), 2 atrás (linha)
☐ | Chave DPDT ON-ON-ON | 2 | parede de trás
☐ | Piezos e exciters (transdutores 4 Ω) | 2 + 2 | na escultura
☐ | Cabo IDC 2×13 fêmea-fêmea, 300 mm | 1 | painel ↔ cérebro
☐ | Barra de pinos 1×40 (Würth 61304011121) | 4 | cortar em todos os headers
☐ | Tira fêmea 1×20 (soquete da Daisy) | 2 | U2
☐ | Tira fêmea 1×8 (soquete do ESP32) | 2 | U3
☐ | Jumpers fêmea em L (90°) | 7 | OLED
☐ | Cabo USB-C curto com dados (PD) | 1 | powerbank → decoy

fonte: docs/COTUCA_BOM.md §5 e caixa/LICOES-MONTAGEM.md #6, #7, #9

feito

7

### Confira a caixa e a ferragem

| peça | qtd | nota
☐ | Acrílico: TAMPA, FRENTE, TRÁS, ESQUERDA, DIREITA, FUNDO | 6 | 3,0 mm transparente; não tire a película ainda
☐ | Acrílico: NERVURA | 1 | vai colada embaixo da tampa
☐ | Acrílico: REFORÇO 193 × 50 | 1 | vai colado embaixo da tampa, na faixa dos arcade
☐ | Acrílico: calços CB (com sextavado) e CT (lisos) | 6 + 6 | 12 × 12
☐ | Parafuso M3 × 10 cabeça cilíndrica + porca M3 | 6 + 6 | fundo → calços
☐ | Espaçador M3 × 10 F-F + parafuso M3 × 6 | 4 + 8 | cérebro no fundo (10, não 8)
☐ | Espaçador M3 de 6,5 mm (ou 6 + arruela) + parafusos | 2 + 4 | painel na tampa
☐ | Espaçador M2.5 + parafusos | 4 + 8 | OLED na tampa
☐ | Espaçadores para o amplificador | 4 | altura conforme o módulo
☐ | Pé de borracha ø15 adesivo | 4 | fundo

fonte: caixa/CAIXA-ACRILICO-MONTAGEM.md §1 · corte r2 (20 peças)

feito

## 2Cérebro

8

### Cérebro · 100 nF — saco 187-CL21B104KBCNNNC×5

| ref | valor no desenho
☐ | C2 | 100n
☐ | C4 | 100n
☐ | C7 | 100n
☐ | C9 | 100n
☐ | C15 | 100n

- Estanhe um pad, segure a peça com a pinça, derreta esse pad — a peça fica presa.
- Confira se está reta e centrada. Só então solde o(s) outro(s) pad(s).
- Deste mesmo saco ainda falta C16, que vai por baixo — é o passo logo a seguir.
- Este saco volta na outra placa (C1 C2 C4 C5). Se quiser esvaziá-lo de uma vez, solde os dois lugares agora, com as duas placas na bancada.

Vista por cima · em azul: o que se coloca neste passo · ■ = pad 1

fonte: export/mouser_40440548.csv · kit/MAPA_COLOCACAO.md

feito

9

### Cérebro · 0 Ω — saco 603-RC0805JR-070RL×2

| ref | valor no desenho
☐ | R10 | 0R
☐ | R20 | 0R

- Estanhe um pad, segure a peça com a pinça, derreta esse pad — a peça fica presa.
- Confira se está reta e centrada. Só então solde o(s) outro(s) pad(s).

Vista por cima · em azul: o que se coloca neste passo · ■ = pad 1

fonte: export/mouser_40440548.csv · kit/MAPA_COLOCACAO.md

feito

10

### Cérebro · 100 Ω pequeno — saco 603-RC0805FR-07100RL×2

| ref | valor no desenho
☐ | R14 | 100R
☐ | R24 | 100R

- Estanhe um pad, segure a peça com a pinça, derreta esse pad — a peça fica presa.
- Confira se está reta e centrada. Só então solde o(s) outro(s) pad(s).
- Este saco volta na outra placa (R1 R2). Se quiser esvaziá-lo de uma vez, solde os dois lugares agora, com as duas placas na bancada.

Vista por cima · em azul: o que se coloca neste passo · ■ = pad 1

Este é o pequeno dos 100 Ω (2 × 1,25 mm). Há outro saco de 100 Ω noutro tamanho — confira o código 603-RC0805FR-07100RL na etiqueta antes de abrir.

fonte: export/mouser_40440548.csv · kit/MAPA_COLOCACAO.md

feito

11

### Cérebro · 1 kΩ — saco 603-RC0805FR-071KL×2

| ref | valor no desenho
☐ | R12 | 1k
☐ | R22 | 1k

- Estanhe um pad, segure a peça com a pinça, derreta esse pad — a peça fica presa.
- Confira se está reta e centrada. Só então solde o(s) outro(s) pad(s).

Vista por cima · em azul: o que se coloca neste passo · ■ = pad 1

fonte: export/mouser_40440548.csv · kit/MAPA_COLOCACAO.md

feito

12

### Cérebro · 10 kΩ — saco 603-RC0805FR-0710KL×2

| ref | valor no desenho
☐ | R50 | 10k — L
☐ | R51 | 10k — R

- Estanhe um pad, segure a peça com a pinça, derreta esse pad — a peça fica presa.
- Confira se está reta e centrada. Só então solde o(s) outro(s) pad(s).
- Este saco volta na outra placa (R3 R4). Se quiser esvaziá-lo de uma vez, solde os dois lugares agora, com as duas placas na bancada.

Vista por cima · em azul: o que se coloca neste passo · ■ = pad 1

fonte: export/mouser_40440548.csv · kit/MAPA_COLOCACAO.md

feito

13

### Cérebro · 22 kΩ — saco 603-RC0805FR-0722KL×1

| ref | valor no desenho
☐ | R9 | 22k

- Estanhe um pad, segure a peça com a pinça, derreta esse pad — a peça fica presa.
- Confira se está reta e centrada. Só então solde o(s) outro(s) pad(s).

Vista por cima · em azul: o que se coloca neste passo · ■ = pad 1

fonte: export/mouser_40440548.csv · kit/MAPA_COLOCACAO.md

feito

14

### Cérebro · 100 kΩ — saco 603-RC0805FR-07100KL×3

| ref | valor no desenho
☐ | R5 | 100k
☐ | R6 | 100k
☐ | R8 | 100k

- Estanhe um pad, segure a peça com a pinça, derreta esse pad — a peça fica presa.
- Confira se está reta e centrada. Só então solde o(s) outro(s) pad(s).

Vista por cima · em azul: o que se coloca neste passo · ■ = pad 1

fonte: export/mouser_40440548.csv · kit/MAPA_COLOCACAO.md

feito

15

### Cérebro · 4,7 MΩ — saco 603-RC0805FR-074M7L×2

| ref | valor no desenho
☐ | R11 | 4M7
☐ | R21 | 4M7

- Estanhe um pad, segure a peça com a pinça, derreta esse pad — a peça fica presa.
- Confira se está reta e centrada. Só então solde o(s) outro(s) pad(s).

Vista por cima · em azul: o que se coloca neste passo · ■ = pad 1

fonte: export/mouser_40440548.csv · kit/MAPA_COLOCACAO.md

feito

16

### Cérebro · 22 nF — saco 80-C1206C223J5G×2

| ref | valor no desenho
☐ | C12 | 22n C0G
☐ | C22 | 22n C0G

- Estanhe um pad, segure a peça com a pinça, derreta esse pad — a peça fica presa.
- Confira se está reta e centrada. Só então solde o(s) outro(s) pad(s).

Vista por cima · em azul: o que se coloca neste passo · ■ = pad 1

fonte: export/mouser_40440548.csv · kit/MAPA_COLOCACAO.md

feito

17

### Cérebro · 10 µF — saco 187-CL31B106KAHNNWE×1

| ref | valor no desenho
☐ | C8 | 10u

- Estanhe um pad, segure a peça com a pinça, derreta esse pad — a peça fica presa.
- Confira se está reta e centrada. Só então solde o(s) outro(s) pad(s).

Vista por cima · em azul: o que se coloca neste passo · ■ = pad 1

fonte: export/mouser_40440548.csv · kit/MAPA_COLOCACAO.md

feito

18

### Cérebro · 100 Ω médio — saco 603-RC1206FR-07100RL×1

| ref | valor no desenho
☐ | R7 | 100R 1/4W

- Estanhe um pad, segure a peça com a pinça, derreta esse pad — a peça fica presa.
- Confira se está reta e centrada. Só então solde o(s) outro(s) pad(s).

Vista por cima · em azul: o que se coloca neste passo · ■ = pad 1

Este é o médio dos 100 Ω (3,2 × 1,6 mm). Há outro saco de 100 Ω noutro tamanho — confira o código 603-RC1206FR-07100RL na etiqueta antes de abrir.

fonte: export/mouser_40440548.csv · kit/MAPA_COLOCACAO.md

feito

19

### Cérebro · BAV99 — saco 621-BAV99-F×2

| ref | valor no desenho
☐ | D11 | BAV99
☐ | D21 | BAV99

- Estanhe um pad, segure a peça com a pinça, derreta esse pad — a peça fica presa.
- Confira se está reta e centrada. Só então solde o(s) outro(s) pad(s).
- SOT-23 só encaixa de um jeito: 2 pernas de um lado, 1 do outro — igual ao desenho dos pads.

Vista por cima · em azul: o que se coloca neste passo · ■ = pad 1

fonte: export/mouser_40440548.csv · kit/MAPA_COLOCACAO.md

feito

20

### Cérebro · SS14 — saco 512-SS14×1

| ref | valor no desenho
☐ | D2 | SS14

- Estanhe um pad, segure a peça com a pinça, derreta esse pad — a peça fica presa.
- Confira se está reta e centrada. Só então solde o(s) outro(s) pad(s).

Vista por cima · em azul: o que se coloca neste passo · ■ = pad 1

PARE. Diodo tem lado. A faixa no corpo do diodo fica do lado do pad marcado K no desenho (o cátodo). Ao contrário, a placa não liga ou queima o diodo.

fonte: export/mouser_40440548.csv · kit/MAPA_COLOCACAO.md

feito

21

### Cérebro · SMBJ24A — saco 652-SMBJ24A×1

| ref | valor no desenho
☐ | D1 | SMBJ24A

- Estanhe um pad, segure a peça com a pinça, derreta esse pad — a peça fica presa.
- Confira se está reta e centrada. Só então solde o(s) outro(s) pad(s).

Vista por cima · em azul: o que se coloca neste passo · ■ = pad 1

PARE. Diodo tem lado. A faixa no corpo do diodo fica do lado do pad marcado K no desenho (o cátodo). Ao contrário, a placa não liga ou queima o diodo.

fonte: export/mouser_40440548.csv · kit/MAPA_COLOCACAO.md

feito

22

### Cérebro · PTC 3 A — saco 652-MF-LSMF300/24X-2×1

| ref | valor no desenho
☐ | F1 | PTC 3A

- Estanhe um pad, segure a peça com a pinça, derreta esse pad — a peça fica presa.
- Confira se está reta e centrada. Só então solde o(s) outro(s) pad(s).
- O fusível não tem polaridade: entra em qualquer sentido.

Vista por cima · em azul: o que se coloca neste passo · ■ = pad 1

fonte: export/mouser_40440548.csv · kit/MAPA_COLOCACAO.md

feito

23

### Cérebro · OPA1642 — saco 595-OPA1642AID×1

| ref | valor no desenho
☐ | U1 | OPA1642

- Estanhe um pad, segure a peça com a pinça, derreta esse pad — a peça fica presa.
- Confira se está reta e centrada. Só então solde o(s) outro(s) pad(s).

Vista por cima · em azul: o que se coloca neste passo · ■ = pad 1

Ache o pino 1 antes de soldar. Segure o chip com a escrita legível: o pino 1 é o de baixo à esquerda. A marca dele pode ser um ponto nesse canto ou uma faixa na ponta (o lado curto), ligando os pinos 1 e 8. Para ter certeza, teste o chip solto com o multímetro em modo diodo: ponta vermelha no pino 4 (embaixo à direita), preta em cada um dos outros → 0,4–0,8 V. Invertendo as pontas → OL. Se esse padrão aparecer em outro pino, pare.

PARE. O pino 1 do chip vai no pad marcado pino 1 no desenho. Girado, todos os pinos trocam — inclusive a alimentação.

fonte: export/mouser_40440548.csv · kit/MAPA_COLOCACAO.md

feito

24

### Cérebro · confira o que fica VAZIO antes de virar a placa4 lugares

Os lugares C11 C21 R13 R23 não se montam — não é esquecimento: são a perna de ganho do pré-amp, que hoje é um seguidor (ganho 1, pelo R10/R20 de 0 Ω). Só se montam se o ganho ajustável voltar.

- Confira que estão mesmo vazios e que não há solda a ligar dois pads neles.
- Confira também que todas as outras peças SMD estão soldadas: nenhum saco deve ter sobrado cheio.

Vista por cima · em azul: o que se coloca neste passo · ■ = pad 1 · ✕ vermelho: fica vazio

feito

25

### Cérebro · vire a placa e solde o C16 (100n) POR BAIXO×1

- O C16 é a única peça SMD por baixo. Não tem polaridade. É o último lugar do saco 100 nF (187-CL21B104KBCNNNC).

Vista POR BAIXO (espelhada — como você vê com a placa virada) · em azul: o que se coloca neste passo · ■ = pad 1

fonte: MAPA_COLOCACAO.md: C16 Bottom

feito

26

### Cérebro · headers de pinos (corte da barra 1×40)×8

| ref | pinos | para
☐ | J3 | 3 | step-down 5V fixo
☐ | J5 | 3 | fio -> jack piezo J5
☐ | J6 | 3 | fio -> jack piezo J6
☐ | J11 | 4 | modulo TPA3116
☐ | J12 | 3 | fio -> TRS linha L
☐ | J13 | 3 | fio -> TRS linha R
☐ | J15 | 8 | fio -> DPDT tipo 2, canal L
☐ | J16 | 8 | fio -> DPDT tipo 2, canal R

- Corte a barra no número de pinos certo (conte duas vezes).
- Encaixe o lado curto dos pinos na placa, por cima. Solde um pino, confira se ficou em pé (90°), depois os outros.
- O J4 ("a ponte ESP32") fica vazio: a ponte encaixa no soquete U3, que já tem a alimentação.

Vista por cima · em azul: o que se coloca neste passo · ■ = pad 1

feito

27

### Cérebro · bornes de parafuso J1 e J2×2

- A abertura dos parafusos fica virada para fora da placa, onde os fios vão chegar.
- J1 = entrada do decoy PD (1 = +, 2 = GND) · J2 = alimentação do amplificador (1 = +15 V, 2 = GND).
- Depois de soldado o corpo tapa a serigrafia — inclusive o triângulo do pino 1. Antes de apertar fio nenhum, ache o pino 1 por um destes dois:
- (a) Vire a placa: o pad quadrado é o pino 1. É o jeito mais rápido e não precisa de energia.
- (b) Bipe: no J1, o pino 1 bipa com o fusível F1. No J2, o pino 1 bipa com o + do C1 (o capacitor grande) e com o pino 1 do J11. O outro pino de cada um bipa com qualquer terra.

Vista por cima · em azul: o que se coloca neste passo · ■ = pad 1

Trocar os dois fios do J1 põe 15 V ao contrário em toda a placa. Confira por (a) e por (b) antes de ligar a energia.

feito

28

### Cérebro · capacitores de filme C14 e C24 (2u2)×2

- Sem polaridade. Encoste o corpo na placa antes de soldar.
- Não tem filme de 2,2 µF com pernas a 5 mm? Use, pela ordem: um filme de 1 µF (ou dois em paralelo nos mesmos furos); ou um eletrolítico de 2,2 a 10 µF, 25 V ou mais, com o + no furo marcado + no desenho — o que liga ao R14/R24 (confirme com o bipe). Esse lado fica a ~7 V e o da Daisy sempre abaixo.
- Nunca cerâmico multicamada (X7R, Y5V) aqui: com 7 V em cima perde capacitância, distorce, e é microfônico — numa escultura que vibra, vira ruído no áudio.

Vista por cima · em azul: o que se coloca neste passo · ■ = pad 1

fonte: substituição feita no cérebro #1 a 19/09 — docs/STATUS.md

feito

29

### Cérebro · capacitores eletrolíticos×4

| ref | valor
☐ | C5 | 47u
☐ | C3 | 100u
☐ | C6 | 470u 25V
☐ | C1 | 2200u/35V

- A perna longa (+) vai no pad ■ quadrado. A faixa no corpo do capacitor marca o −, do lado oposto ao quadrado.
- Solde do menor para o maior: C5 → C3 → C6 → C1.
- Deixe vazios os lugares C13 C23 RV1 RV2 (✕ vermelho no desenho): não é esquecimento: são a perna de ganho do pré-amp, que hoje é um seguidor (ganho 1, pelo R10/R20 de 0 Ω). Só se montam se o ganho ajustável voltar.

Vista por cima · em azul: o que se coloca neste passo · ■ = pad 1 · ✕ vermelho: fica vazio

PARE. Eletrolítico ao contrário estoura quando liga. Confira os quatro antes de soldar.

feito

30

### Cérebro · PROVE o pré-amp antes de seguir (dois multímetros de dois segundos)

Ligue os 15 V (decoy PD no J1) e meça, com a ponta preta no TP8 (GND):

medida | onde | tem de dar | se não der
alimentação do pré-amp | TP3 | ~14,6 V | o R7 ou o trilho de 15 V
polarização | TP4 | ~metade do TP3 (~7,3 V) | solda fria no R5/R6 — foi este o defeito de 22/09
saída do canal A | U1 pino 1 | igual ao TP4 | junta do U1, lado A
saída do canal B | U1 pino 7 | igual ao TP4 | junta do U1, lado B

- Alimentação boa não é polarização boa. O TP2 e o TP3 podem dar 15 V e 14,6 V com o instrumento inteiro mudo: sem o TP4 você não sabe.
- As duas saídas do U1 repousam no VBIAS. Uma delas fora disso, com a outra certa, é junta do chip — e o par simétrico é o que denuncia.
- Se uma junta for intermitente, ela passa uma vez e falha depois. Pressione levemente o U1 com um palito enquanto mede: se a leitura mudar, refaça os oito pinos.

Vista por cima · em azul: o que se coloca neste passo · ■ = pad 1

PARE. Não siga para os piezos com o TP4 fora dos ~7 V. Tudo o que vier depois — jack, cabo, transdutor — vai parecer culpado, e não é.

fonte: docs/battle_scars.md 15fe · medido na primeira montagem, 22/09

feito

31

### Cérebro · caixa de pinos IDC J14 (para o cabo do painel)×1

- A caixa de pinos tem um entalhe (chave) no meio de um dos lados compridos. Coloque-a com o entalhe do lado desenhado na serigrafia da placa.
- O pino 1 fica no pad marcado ■ no desenho.

Vista por cima · em azul: o que se coloca neste passo · ■ = pad 1

feito

32

### Cérebro · soquetes da Daisy (U2) e do ESP32 (U3)2 + 2 tiras

- Use as tiras fêmea: 2 × 1×20 no U2, 2 × 1×8 no U3.
- Truque para ficarem retos: encaixe as tiras no módulo, apoie o módulo sobre a placa, e solde as tiras com o módulo no lugar. Depois tire o módulo.
- Ainda não deixe os módulos na placa — eles entram depois do teste de energia.

Vista por cima · em azul: o que se coloca neste passo · ■ = pad 1

feito

## 3Painel

33

### Painel · 100 nF — saco 187-CL21B104KBCNNNC×4

| ref | valor no desenho
☐ | C1 | 100n COLADO ao cursor
☐ | C2 | 100n COLADO ao cursor
☐ | C4 | 100n
☐ | C5 | 100n COLADO ao IDC

- Estanhe um pad, segure a peça com a pinça, derreta esse pad — a peça fica presa.
- Confira se está reta e centrada. Só então solde o(s) outro(s) pad(s).
- Este saco volta na outra placa (C2 C4 C7 C9 C15 C16). Se quiser esvaziá-lo de uma vez, solde os dois lugares agora, com as duas placas na bancada.

Vista por cima · em azul: o que se coloca neste passo · ■ = pad 1

fonte: export/mouser_40440548.csv · kit/MAPA_COLOCACAO.md

feito

34

### Painel · 100 Ω pequeno — saco 603-RC0805FR-07100RL×2

| ref | valor no desenho
☐ | R1 | 100R gate
☐ | R2 | 100R gate

- Estanhe um pad, segure a peça com a pinça, derreta esse pad — a peça fica presa.
- Confira se está reta e centrada. Só então solde o(s) outro(s) pad(s).
- Este saco volta na outra placa (R14 R24). Se quiser esvaziá-lo de uma vez, solde os dois lugares agora, com as duas placas na bancada.

Vista por cima · em azul: o que se coloca neste passo · ■ = pad 1

Este é o pequeno dos 100 Ω (2 × 1,25 mm). Há outro saco de 100 Ω noutro tamanho — confira o código 603-RC0805FR-07100RL na etiqueta antes de abrir.

fonte: export/mouser_40440548.csv · kit/MAPA_COLOCACAO.md

feito

35

### Painel · 10 kΩ — saco 603-RC0805FR-0710KL×2

| ref | valor no desenho
☐ | R3 | 10k pull-down
☐ | R4 | 10k pull-down

- Estanhe um pad, segure a peça com a pinça, derreta esse pad — a peça fica presa.
- Confira se está reta e centrada. Só então solde o(s) outro(s) pad(s).
- Este saco volta na outra placa (R50 R51). Se quiser esvaziá-lo de uma vez, solde os dois lugares agora, com as duas placas na bancada.

Vista por cima · em azul: o que se coloca neste passo · ■ = pad 1

fonte: export/mouser_40440548.csv · kit/MAPA_COLOCACAO.md

feito

36

### Painel · 100 Ω grande — saco 603-RC1210FR-07100RL×2

| ref | valor no desenho
☐ | R5 | 100R serie (~30 mA)
☐ | R6 | 100R serie (~30 mA)

- Estanhe um pad, segure a peça com a pinça, derreta esse pad — a peça fica presa.
- Confira se está reta e centrada. Só então solde o(s) outro(s) pad(s).

Vista por cima · em azul: o que se coloca neste passo · ■ = pad 1

Este é o grande dos 100 Ω (3,2 × 2,5 mm). Há outro saco de 100 Ω noutro tamanho — confira o código 603-RC1210FR-07100RL na etiqueta antes de abrir.

fonte: export/mouser_40440548.csv · kit/MAPA_COLOCACAO.md

feito

37

### Painel · SI2302 — saco 781-SI2302CDS-T1-GE3×2

| ref | valor no desenho
☐ | Q1 | AO3400A
☐ | Q2 | AO3400A

- Estanhe um pad, segure a peça com a pinça, derreta esse pad — a peça fica presa.
- Confira se está reta e centrada. Só então solde o(s) outro(s) pad(s).
- SOT-23 só encaixa de um jeito: 2 pernas de um lado, 1 do outro — igual ao desenho dos pads.

Vista por cima · em azul: o que se coloca neste passo · ■ = pad 1

fonte: export/mouser_40440548.csv · kit/MAPA_COLOCACAO.md

feito

38

### Painel · o encoder SW1, por cima×1

- Encaixe o encoder por cima: 3 pinos (A C B) de um lado, 2 pinos (botão) do outro, 2 patas grossas nas laterais.
- Solde as 2 patas primeiro (seguram), depois os 5 pinos.

Vista por cima · em azul: o que se coloca neste passo · ■ = pad 1

PARE. Confira se o seu encoder tem os 2 pinos do botão (do lado oposto ao A C B). Sem eles o botão de apertar não funciona — avise antes de soldar.

fonte: LICOES-MONTAGEM.md #9

feito

39

### Painel · REGRA: daqui em diante, quase tudo vai POR BAIXO

Na caixa, a placa do painel fica só 6,5 mm abaixo do acrílico — é a altura do corpo do encoder. Tudo o que for mais alto que isso bate na tampa. Por isso os conectores, o capacitor e os fios do painel vão por baixo da placa.

- A partir de agora os desenhos do painel estão em vista por baixo (espelhada): é assim que você vê com a placa virada na mão.
- Por baixo a serigrafia não aparece. Use o pad quadrado ■ como referência, sempre.

Vista por baixo: o encoder (já soldado) aparece do outro lado · os tracejados são as peças que estão por cima

fonte: LICOES-MONTAGEM.md #9

feito

40

### Painel · capacitor C3 (100 µF) por baixo×1

- Enfie as pernas por baixo. A perna longa (+) vai no furo do pad ■.
- Solde por cima e corte as pernas.

Vista POR BAIXO (espelhada — como você vê com a placa virada) · em azul: o que se coloca neste passo · ■ = pad 1

PARE. Perna longa no ■. Ao contrário estoura.

feito

41

### Painel · conectores dos botões J3, J4, J5 (JST) por baixo×3

- Encaixe cada JST por baixo e solde por cima.
- São dos interruptores dos arcade — não têm polaridade, então virar não faz mal nestes três.
- J3 = azul A · J4 = azul B · J5 = branco (búzios).

Vista POR BAIXO (espelhada — como você vê com a placa virada) · em azul: o que se coloca neste passo · ■ = pad 1

feito

42

### Painel · LEDs dos arcade: FIOS soldados em J6 e J7 (sem JST)4 fios

pad | rede | fio vai para
■ 1 | +5V | + do LED do arcade (ânodo)
2 | LED_R_A | − do LED do arcade

- Aqui não use JST: virado por baixo ele trocaria + com −.
- Solde dois fios (vermelho no ■, preto no outro) direto nos furos, por baixo. Faça igual no J7 (arcade B).
- Marque na ponta de cada fio: A+, A−, B+, B−.
- ⚠️ Não confie na cor de um chicote comprado. Um par macho/fêmea do mesmo saco pode sair com o vermelho de um lado a casar com o preto do outro — aconteceu aqui a 22/09, e os LEDs não acendiam com a placa perfeita. A ficha só entra de um jeito, mas a chave garante o pino, não a cor. Bipe pino a pino antes de ligar, e marque as duas pontas.

Vista POR BAIXO (espelhada — como você vê com a placa virada) · em azul: o que se coloca neste passo · ■ = pad 1

fonte: LICOES-MONTAGEM.md #9

feito

43

### Painel · header do OLED (J2) por baixo1 × 7 pinos

pad | sinal | cor no cabo Waveshare
■ 1 | +5V | vermelho
2 | GND | preto
3 | OLED_DIN | azul
4 | OLED_CLK | amarelo
5 | OLED_CS | laranja
6 | OLED_DC | verde
7 | OLED_RST | branco

- Corte 7 pinos da barra. Encaixe por baixo e solde por cima.
- Os jumpers do OLED entram por baixo, com conectores em L virados para trás e para baixo.

Vista POR BAIXO (espelhada — como você vê com a placa virada) · em azul: o que se coloca neste passo · ■ = pad 1

PARE. Por baixo a ordem aparece ao contrário. O pad ■ é o VCC. Antes de ligar: bipe o ■ com o ponto de teste TP1 (+5V) e o vizinho dele com o TP3 (GND). Se não bipar, pare.

fonte: LICOES-MONTAGEM.md #7

feito

44

### Painel · cabo do cérebro: fita soldada direto no J1 (sem conector)26 fios

- Pegue o cabo IDC de 300 mm. Corte fora a ficha de uma das pontas (deixe a outra — ela vai no cérebro).
- Na ponta cortada, separe os 26 fios uns 15 mm. O fio vermelho é o 1.
- Solde por baixo, na ordem: ímpares (1, 3 … 25) na fila mais longe da borda comprida mais próxima; pares (2, 4 … 26) na fila mais perto dela.
- O pad 1 do J1 é redondo (sem quadrado). Ele fica na ponta do J1 do lado dos conectores J3/J6 — marcado ● no desenho.

Vista POR BAIXO (espelhada — como você vê com a placa virada) · em azul: o que se coloca neste passo · ■ = pad 1

PARE. NÃO solde a caixa de pinos IDC por baixo, virada: dá curto do +3V3A com o GND. Só fios.

fonte: LICOES-MONTAGEM.md #8

feito

45

### Painel · fios dos potenciômetros (RV1, RV2)6 fios

pad na placa | rede | perna do potenciômetro
1 | GND | perna de uma ponta
2 | POT_L | perna do meio (cursor)
3 | +3V3A | perna da outra ponta

- Os potenciômetros não vão na placa: ficam presos na tampa, ligados por 3 fios cada.
- Solde 3 fios de ~10 cm em cada (RV1 = esquerdo, RV2 = direito), por baixo. A perna do meio do potenciômetro vai sempre no pad 2.
- Se o volume girar ao contrário, inverte-se no firmware — não refaça a solda.

Vista POR BAIXO (espelhada — como você vê com a placa virada) · em azul: o que se coloca neste passo · ■ = pad 1

fonte: LICOES-MONTAGEM.md #6 (caso B) e #9

feito

46

### Painel · dois furos de fixação (ø3,2)2 furos

- O painel não veio com furos de fixação. Ele fica preso pelo encoder e por estes dois furos.
- Marque com caneta e fure com broca ø3,2, devagar, pelo lado de cima (componentes). Tire a rebarba.
- Cotas a partir do canto superior esquerdo, olhando por cima: A = 77,5 → , 32,0 ↓ · C = 146,0 → , 4,0 ↓ (mm).

Vista por cima · os círculos marcam os furos A e C com o espaço da arruela livre de trilhas

Estes pontos foram medidos para não cortar nenhuma trilha. Não fure em outro lugar.

fonte: certificação IFÁ10000-M · docs/STATUS.md 18/09

feito

## 4Caixa

47

### Caixa · ORDEM que não se pode inverter: painel antes dos jacks

Com os quatro jacks TRS montados, a placa do painel não sai mais: a ponta do encoder fica presa no acrílico da tampa antes de a placa libertar os jacks.

- Na montagem: ponha o painel na tampa antes de apertar os jacks.
- Na manutenção: para tirar o painel, tire primeiro os quatro jacks. Não force a placa — a ponta do encoder não passa.
- Vale a pena deixar os fios dos jacks com folga para eles saírem sem dessoldar.

Descoberto na bancada a 19/09, com a caixa montada.

fonte: caixa/LICOES-MONTAGEM.md #11

feito

48

### Caixa · monte a seco, sem cola

- Não tire a película das peças ainda.
- Encaixe frente + esquerda + direita + trás. Os dentes entram à mão com leve atrito.
- Apoie a tampa por cima (frente e trás entram inclinadas, 11,8°).
- Meça: 200 × 120, altura 55 na frente e 80 atrás. As diagonais do fundo aberto têm que ser iguais.
- Encaixe todas as peças reais nos furos (arcade, jacks, chaves, USB-C, encoder, potenciômetros). Um furo errado se corrige agora com lixa — depois, não.

fonte: CAIXA-ACRILICO-MONTAGEM.md §2

feito

49

### Caixa · ajuste os furos da tampa

- Encoder: o furo tem ø7 e a rosca é M7 — alargue para ~7,3 mm até a rosca passar sem forçar.
- Potenciômetros: ao lado de cada furo de ø7, fure ø3,2 a 7,5 mm à esquerda do centro (vista de cima, mesma altura) — é para o pino anti-giro do potenciômetro.
- Postes do painel: fure ø3,2 na tampa em A e C. Cotas na superfície da tampa, a partir da borda esquerda e da borda da frente (medindo ao longo da inclinação): A = 91,5 → , 78 ↑ · C = 160 → , 106 ↑.

Acrílico racha se a broca pegar: velocidade baixa, sem pressão, apoio de madeira embaixo.

fonte: LICOES-MONTAGEM.md #1 e #9 · geometria da pcb_contorno

feito

50

### Caixa · cole as quatro paredes

- Monte de novo frente + esquerda + direita + trás, sem a tampa. Fita crepe em volta, esquadro nos cantos.
- Com o frasco de agulha, passe Weld-On 4 ao longo de cada junta por dentro — ele entra sozinho por capilaridade. Uma passada lenta por junta.
- 30 s sem mexer em cada junta. 1 hora antes de tocar, 24 h antes de fazer força.

PARE. Luvas de nitrilo. Nunca super cola (racha o acrílico), nunca acetona.

fonte: CAIXA-ACRILICO-MONTAGEM.md §3

feito

51

### Caixa · calços com porca presa (×6)

- Cada calço = CB (com sextavado, embaixo) + CT (liso, em cima).
- Coloque o fundo encostado por dentro, rente à borda, como gabarito. Cole o CB com o sextavado para baixo sobre ele, nos 4 cantos e no meio da frente e de trás.
- Enfie a porca M3 no sextavado e cole o CT por cima: a porca fica presa.
- Tire o fundo antes de secar.

fonte: CAIXA-ACRILICO-MONTAGEM.md §4

feito

52

### Caixa · reforço e nervura embaixo da tampa

- Reforço (193 × 50): centrado, borda da frente a 10 mm da borda dianteira. Confira a seco enfiando um botão arcade nos dois furos de ø30 — têm que ficar concêntricos. Depois Weld-On 4 pela aresta, peso por cima, 30 min.
- Nervura: ao longo dos 200 mm, a ~62 mm da frente (entre os arcade e os knobs). Weld-On 4, peso, 30 min.

fonte: CAIXA-ACRILICO-MONTAGEM.md §4b e §5

feito

53

### Caixa · cole a tampa (por último)

- Só depois de confirmar que tudo encaixa nos furos.
- Weld-On 16 (gel) nas ranhuras da frente e de trás (as inclinadas). Weld-On 4 nas laterais.
- Apoie, alinhe, peso distribuído. Limpe o excesso de gel com pano seco. 24 h. Só então tire as películas.

fonte: CAIXA-ACRILICO-MONTAGEM.md §5

feito

## 5Montar o interior

54

### Tampa por dentro · botões, potenciômetros, OLED

- Arcade ×3 (azul A à esquerda, branco no meio, azul B à direita): porca por dentro.
- Potenciômetros ×2 com porca, pino anti-giro no furo de ø3,2.
- OLED por dentro, sobre 4 espaçadores M2.5 — o vidro olhando pela janela, o cabo para dentro.

fonte: LICOES-MONTAGEM.md #2 e #6

feito

55

### Tampa por dentro · o painel

- Passe o eixo do encoder pelo furo da tampa. Arruela + porca por fora, sem apertar ainda.
- Espaçadores de 6,5 mm em A e C, entre a placa e a tampa; parafusos M3 dos dois lados.
- Aperte a porca do encoder por último. A placa tem que ficar paralela à tampa, sem forçar.

Se algo raspar na tampa, pare: alguma peça ficou por cima e devia estar por baixo.

fonte: LICOES-MONTAGEM.md #9 · IFÁ10000-M M2

feito

56

### Paredes · jacks, chaves, USB-C

- Esquerda: 2 jacks TRS dos piezos (furos ø9,5).
- Trás: 2 jacks TRS de linha (ø9,5) e 2 chaves DPDT (ø6). Porca por dentro.
- Trás: o decoy PD com o USB-C para fora (2 parafusos ou fita dupla forte).

fonte: CAIXA-ACRILICO-MONTAGEM.md §6 · furos do gerador da caixa

feito

57

### Fundo · cérebro e amplificador

- Cérebro sobre 4 espaçadores M3 × 10 (não 8: a placa passa por cima de calços de 6 mm).
- Amplificador sobre os espaçadores dele.
- Ainda sem a Daisy e o ESP32 nos soquetes.

fonte: CAIXA-ACRILICO-MONTAGEM.md §1 e §6

feito

## 6Fios

58

### Fios · mapa de TODOS os conectores do cérebro

ref | liga em | o que é | pinos | pino a pino
J1 | decoy PD | entrada decoy PD | 2 | ■1 = sinal → F1 · 2 = GND
J2 | modulo amplificador | ao amp TPA3116 | 2 | ■1 = +15V · 2 = GND
J3 | modulo step-down 5 V | step-down 5V fixo | 3 | ■1 = +15V · 2 = GND · 3 = +5V
J4 | ponte ESP32 | FICA VAZIO (vestígio) | 2 | ■1 = +5V_PONTE · 2 = GND
J5 | jack do piezo A | fio -> jack piezo J5 | 3 | ■1 = sinal → R12 · 2 = AGND · 3 = AGND
J6 | jack do piezo B | fio -> jack piezo J6 | 3 | ■1 = sinal → R22 · 2 = AGND · 3 = AGND
J11 | modulo amplificador | modulo TPA3116 | 4 | ■1 = +15V NÃO LIGAR · 2 = GND · 3 = AMP_IN_L · 4 = AMP_IN_R
J12 | jack de linha L | fio -> TRS linha L | 3 | ■1 = LINHA_L · 2 = AGND · 3 = AGND
J13 | jack de linha R | fio -> TRS linha R | 3 | ■1 = LINHA_R · 2 = AGND · 3 = AGND
J15 | chave DPDT L | fio -> DPDT tipo 2, canal L | 8 | ■1 = OUT_L_DAISY · 2 = LINHA_L · 3 = AMP_IN_L · 4 = OUT_L_DAISY · 5 = LINHA_L · 6 = AMP_IN_L · 7 = GND · 8 = GND
J16 | chave DPDT R | fio -> DPDT tipo 2, canal R | 8 | ■1 = OUT_R_DAISY · 2 = LINHA_R · 3 = AMP_IN_R · 4 = OUT_R_DAISY · 5 = LINHA_R · 6 = AMP_IN_R · 7 = GND · 8 = GND

O pad quadrado ■ é o pino 1 em todos. O J14 (cabo do painel) tem 26 vias e está na tabela seguinte. Não existem J7 a J10.

- J15 e J16 repetem cada sinal em dois pinos (1 e 4, 2 e 5, 3 e 6): são os dois polos da chave DPDT. Os pinos 7 e 8 são o terra de referência do cabo, e não vão a terminal nenhum da chave.
- Em J5, J6, J12 e J13 o pino 1 é sempre o sinal e os outros dois são terra.
- J1 tem 2 pinos, a 5,08 mm. O borne especificado (Phoenix 1715721) traz um pino por polo — se a peça na sua mão tiver mais pinos, é outra peça: pare e confira antes de soldar.

PARE. O J11 pino 1 NÃO se liga. Ele traz o mesmo +15 V que já vai pelo J2, e o módulo em mão alimenta-se pelo borne de parafuso (decidido a 20/09). Ligar os dois põe a força em paralelo por dois caminhos e fecha um laço de terra — e nada se queixa até o som ficar sujo. Energia pelo J2 (fio curto e grosso, é o retorno de força) · áudio pelo J11: pino 2 = referência, 3 = L, 4 = R. O pino 1 sai na rev D.

fonte: kicad/encaixe.py (DESTINOS) + redes de cotuca_cerebro.kicad_pcb · ficha Phoenix 1715721

feito

59

### Fios · as 26 vias do J14 (cabo do painel)

pino | sinal | pino | sinal
■ 1 | GND | 14 | GND
2 | OLED_CLK | 15 | LED_FRZ_A
3 | GND | 16 | LED_FRZ_B
4 | OLED_DIN | 17 | BOT_FRZ_A
5 | OLED_CS | 18 | BOT_FRZ_B
6 | OLED_DC | 19 | BOT_BUZIOS
7 | OLED_RST | 20 | ENC_A_A
8 | GND | 21 | ENC_A_B
9 | +3V3A | 22 | ENC_A_PUSH
10 | GND | 23 | GND
11 | +5V | 24 | POT_L
12 | +5V | 25 | POT_R
13 | GND | 26 | GND

- O cabo é direto e com chave: pino 1 no pino 1. Não há nada a decidir — só entra de um jeito.
- Esta tabela é para medir, não para montar: serve quando um botão não responde e você quer bipar a via certa.

Vista por cima · em azul: o que se coloca neste passo · ■ = pad 1

fonte: gerado das redes das duas placas

feito

60

### Fios · como se faz um cabo de sinal (o método, não o improviso)

Vale para os piezos (J5/J6) e para as saídas de linha (J12/J13). O que separa um cabo profissional de um improviso não é a solda: são descascar certo, aliviar o esforço e terminar a malha num ponto só.

passo | medida | porquê
1 · corte no comprimento | piezo < 60 mm · linha o que a caixa pedir + folga | cabo sobrando vira antena e vira laço
2 · descasque a capa | 25 mm | é o que dá para trabalhar a malha sem a destrançar toda
3 · junte a malha num rabicho | ≤ 10 mm | malha aberta deixa de blindar; o rabicho é o trecho que não blinda — por isso curto
4 · descasque o centro | 4–5 mm | mais do que isso fica condutor nu dentro do conector
5 · estanhe os dois | banho rápido | fio estanhado não se desfia e não abre com o tempo
6 · termine | conector ou solda (abaixo) | —
7 · termorretrátil | um por condutor + um no conjunto | isola e segura; o do conjunto é meio alívio de esforço
8 · alívio de esforço | abraçadeira a ≤ 20 mm da terminação | é isto que falta em 90% dos improvisos: a força do cabo tem de morrer na abraçadeira, nunca na solda

- Cabo: blindado de instrumento/microfone, um condutor central. Não serve fio paralelo nem cabo de rede.
- Terminação, duas maneiras certas. (a) Soldar direto no header + termorretrátil + abraçadeira — é o que boutiques de pedais fazem num trecho curto dentro da caixa, e é o que já está soldado aqui. (b) Conector de crimpe de sistema, com trava: família Molex KK-254 ou Harwin M20 encaixam nos headers de 2,54 mm que a placa tem. ⚠️ O código exacto confere-se na ficha do fabricante antes de comprar — MPN é afirmação, não palpite.
- 🚫 Dupont genérico não é conector de sistema: sem trava, contacto fraco, recua com vibração. Serve para bancada, não para um instrumento que viaja.
- A malha termina num ponto só. Aqui é a ilha AGND. Não a ligue também ao chassi nem a dois pinos.
- Encaminhe longe dos fios do amplificador, dos exciters e do step-down, e cruze-os a 90° quando não der para afastar.
- Teste do puxão: segure a abraçadeira e puxe o cabo com força moderada. Se a solda sentir, o alívio está no sítio errado.
- Marque as duas pontas com fita e caneta antes de fechar a caixa.

fonte: caixa/CAIXA-ACRILICO-MONTAGEM.md §6b · docs/operacao/ATERRAMENTO.md

feito

61

### Fios · piezos → cérebro J5 e J6

pino | rede | liga em
■ 1 | Net-(J5-Pad1) | ponta (tip) do jack · centro do cabo blindado
2 | AGND | manga (sleeve) · malha do cabo
3 | AGND | anel (ring) — vai à terra

- Igual para o J6 (segundo piezo).
- Fio < 60 mm, blindado. E a malha depende do cabo: se ele tiver dois condutores + malha, a malha é escudo e liga só do lado da placa; se for coaxial (um central + malha), a malha é o retorno e liga nas duas pontas — solta no jack não dá menos ruído, dá sinal nenhum.
- Com coaxial: centro no pino 1, malha no pino 2 e na manga do jack; ligue anel e manga juntos no jack e deixe o pino 3 sem nada (é a mesma rede do 2).
- Rabicho curto ao soldar a malha: malha destrançada é blindagem que se perde.
- Malha grossa a tocar nos pinos 2 e 3? Não faz mal — os dois são a mesma rede (AGND). O que não pode tocar é o pino 1, que é o sinal: malha no pino 1 é o piezo em curto, e o sintoma é silêncio nesse canal. O mais simples é soldar a malha só no pino 2 e deixar o 3 vazio.
- Confira no fim, sem energia: entre o pino 1 e o 2 NÃO pode bipar. Entre o pino 1 e a ponta do jack, tem de bipar.
- Solde o cabo direto nos pinos do header, sem conector destacável: o trecho é curto, fica dentro da caixa, e neste nó de 4,7 MΩ um crimpe frouxo vira estalo, não perda de sinal.
- Termorretrátil em cada pino: segura o fio e impede que dois pinos se toquem.
- Limpe o fluxo com álcool isopropílico depois de soldar. Resíduo entre pinos é caminho de fuga, e numa entrada de 4,7 MΩ isso aparece como ruído.
- Se quiser destacável mesmo assim: carcaça Dupont 1×3, e transforme a malha num rabicho de fio comum antes de crimpar — malha trançada crimpada direto dá contato ruim.

Vista por cima · em azul: o que se coloca neste passo · ■ = pad 1

fonte: HARDWARE.md §2 · CAIXA-ACRILICO-MONTAGEM.md §6b

feito

62

### Fios · saídas de linha → cérebro J12 e J13

pino | rede | liga em
■ 1 | LINHA_L | ponta (tip) do jack de linha
2 | AGND | manga (sleeve)
3 | AGND | anel (ring)

Igual para o J13 (canal R).

- Aqui jumper comum serve (ao contrário do J5/J6): é sinal de linha, de baixa impedância, vindo da chave DPDT.
- Torça o par — sinal com o terra dele. O que capta zumbido é a área do laço entre ida e volta, não o tipo de fio.
- Afaste dos fios do amplificador e dos exciters: são eles que carregam corrente comutada.
- Crimpe Dupont recua com o tempo. Solde as pontas, ou prenda o corpo do conector com um pingo de cola.

Vista por cima · em azul: o que se coloca neste passo · ■ = pad 1

Não confunda com o J5/J6: lá é entrada de piezo, o trecho de maior impedância do instrumento — cabo blindado, < 60 mm, malha só do lado da placa.

fonte: rede de cada pad, placa fabricada · docs/operacao/ATERRAMENTO.md

feito

63

### Fios · chaves DPDT → cérebro J15 (L) e J16 (R)

pino | rede | liga em
■ 1 | OUT_L_DAISY | comum do polo 1
2 | LINHA_L | polo 1, posição jack
3 | AMP_IN_L | polo 1, posição amp
4 | OUT_L_DAISY | comum do polo 2
5 | LINHA_L | polo 2, posição jack
6 | AMP_IN_L | polo 2, posição amp
7 | GND | não liga na chave (terra do cabo)
8 | GND | não liga na chave (terra do cabo)

- Antes de soldar, meça a chave com o multímetro: em cada posição, descubra qual pino do meio (comum) bipa com qual pino da ponta. Escreva os números da SUA chave nas linhas em branco do desenho.
- Posição 1: comuns ligados às pernas jack. Posição 3: às pernas amp. Posição do meio: um polo em cada — as duas saídas.
- Três fios e um jumper, que é a fiação que já funcionou: 1 → comum de um polo; jumper entre os dois comuns; 2 → perna linha desse mesmo polo; 3 → perna amp do outro polo. A chave usa-se na diagonal, e duas pernas ficam vazias.
- O que isso dá nas três posições: só linha (mixer) · os dois · só amp (exciter).
- Os pinos 4, 5 e 6 são os mesmos sinais de 1, 2 e 3 (a placa duplica-os) e não se usam nesta fiação. Os 7/8 são o dreno do cabo.
- Nada de terra vai à chave: os pinos 7/8 são dreno do cabo. Corte-os rente e isole a ponta solta.
- Depois de fiar, confira sem energia, bipando entre o header e a chave: posição *jack* → 1–2 e 4–5 · posição *amp* → 1–3 e 4–6 · posição *do meio* → um par de cada (por exemplo 1–2 e 4–6).
- ⚠️ Se no meio as duas metades derem o mesmo, a sua chave é do outro tipo e a posição do meio não manda para as duas saídas. Não é defeito de montagem: é a peça.

Pernas pelo que fazem, não pelo número: meça a sua chave e escreva os números dela nas linhas. Três fios e um jumper — a fiação que já funcionou: o sinal entra nos dois comuns (jumpeados), a linha sai por um polo e o amp pelo outro, na diagonal. As duas pernas a cinzento ficam vazias. Os pinos 4, 5 e 6 do header são os mesmos sinais de 1, 2 e 3 — não se usam. Tracejado cinzento = dreno do cabo, que não vai a perna nenhuma.

Vista por cima · em azul: o que se coloca neste passo · ■ = pad 1

PARE. Chave ON-ON-ON tem tipos diferentes. Meça antes de fiar — não confie na posição das pernas.

fonte: docs/COTUCA_BOM.md §5 · HARDWARE.md §3

feito

64

### Fios · amplificador

pino | rede | liga em
■ 1 | +15V | NÃO ligue numa entrada de áudio (+15 V)
2 | GND | GND da entrada do amp
3 | AMP_IN_L | entrada L do amp
4 | AMP_IN_R | entrada R do amp

pino | rede | liga em
■ 1 | +15V | + da alimentação do amp
2 | GND | − da alimentação do amp

Vista por cima · em azul: o que se coloca neste passo · ■ = pad 1

PARE. As saídas do amplificador para os exciters têm os dois terminais quentes. Nunca ligue uma saída do amp ao GND nem a um jack — queima o amp.

fonte: HARDWARE.md §1 e §3

feito

65

### Fios · energia: decoy PD e step-down

pino | rede | liga em
■ 1 | Net-(F1-Pad1) | + do decoy PD (15 V)
2 | GND | − do decoy PD

pino | rede | liga em
■ 1 | +15V | VIN do step-down
2 | GND | GND do step-down
3 | +5V | VOUT (5 V) do step-down

- O módulo tem dois GND (IN e OUT) e a placa só dá um. Bipe os dois pinos de terra do módulo: em qualquer step-down destes eles são o mesmo nó, e aí basta um fio ao J3 pino 2 — de preferência partindo do lado OUT, que é por onde volta a corrente do 5 V. Se não bipar, o módulo é isolado (raro): aí ligue os dois, com um jumper curto no próprio módulo.
- Um fio só, e dedicado. O terra do 5 V voltar por outro caminho já custou um clique a ~3 Hz audível neste instrumento (ATERRAMENTO.md).
- 🚫 Não acrescente capacitor grande na ENTRADA do step-down. 2200 µF ali produziram guincho agudo medido a 31/08: um conversor comutado é carga de potência constante e oscila contra a indutância do fio. E na saída, no máximo 100 µF.

Vista por cima · em azul: o que se coloca neste passo · ■ = pad 1

PARE. Confira as marcas VIN / GND / VOUT no seu step-down. VIN no 5 V queima a Daisy.

fonte: HARDWARE.md §1

feito

66

### Fios · botões e LEDs dos arcade (painel)

- Onde vai cada botão, olhando a tampa de cima, da esquerda para a direita: azul A, azul B, branco (búzios). Os dois azuis (freeze) ficam juntos, e o branco fica à direita deles.
- Interruptor de cada arcade → o JST dele (J3 azul A, J4 azul B, J5 branco). Sem polaridade.
- LED dos azuis: fio A+/B+ no terminal + do LED do botão, A−/B− no −. O branco não tem LED.

A ordem não é escolha de gosto: o C1 (2200 µF) do cérebro fica debaixo de um dos furos, e só o botão branco passa por cima dele, porque não tem LED e desce só 20 mm (o azul desce 34). Antes de fechar a tampa, olhe por baixo de cada furo e confirme que nenhum botão com LED tem peça alta debaixo. Medido na bancada a 19/09.

fonte: caixa/LICOES-MONTAGEM.md #10 · docs/STATUS.md (19/09)

feito

67

### Fios · o cabo do painel no cérebro

- A ficha que sobrou no cabo IDC vai no J14 do cérebro: a chave da ficha entra no entalhe da caixa de pinos — só entra de um jeito.
- O cabo corre pela parede de trás, com ~80 mm de folga: é o que deixa tirar o fundo sem desligar.

Vista por cima · em azul: o que se coloca neste passo · ■ = pad 1

fonte: CAIXA-ACRILICO-MONTAGEM.md §6b

feito

## 7Ligar e fechar

68

### Antes de ligar · bipes (sem energia)

| entre | tem que
☐ | +15 V e GND (bornes J2) | NÃO bipar
☐ | +5 V e GND (TP1 e TP3 do painel) | NÃO bipar
☐ | +3V3A e GND (TP2 e TP3 do painel) | NÃO bipar
☐ | ficha IDC solta: pino 9 ↔ TP2 do painel | bipar
☐ | ficha IDC solta: pinos 11 e 12 ↔ TP1 | bipar
☐ | ficha IDC solta: pino 1 ↔ TP3 | bipar
☐ | ficha IDC solta: pino 2 ↔ pad 4 do J2 (OLED CLK) | bipar
☐ | pad ■ do J2 ↔ TP1 | bipar (é o VCC do OLED)

PARE. Qualquer linha errada: pare e ache o fio antes de continuar.

fonte: HARDWARE.md checklist · LICOES-MONTAGEM.md #7 e #8

feito

69

### Primeira energia · passo a passo

- Sem Daisy, sem ESP32, exciters desligados.
- Ligue o powerbank no decoy PD. Meça no J1: 15 V.
- Meça a saída do step-down (J3 pino 3): 5 V. Só com 5 V confirmados siga.
- Desligue. Encaixe a Daisy no U2 e o ESP32 no U3, na orientação do desenho da serigrafia (conferir o canto do pino 1 e o lado do USB).
- Ligue de novo. Só por último conecte os exciters, com volume baixo.

PARE. Se algo esquentar, cheirar ou o LED do amp acender sem motivo: desligue na hora.

fonte: HARDWARE.md checklist antes de energizar

feito

70

### Antes de fechar · confira o que ainda está aberto

- Arcade da esquerda × J14 do cérebro: com o fundo no lugar, aperte o botão até o fim e veja se o corpo dele encosta na caixa de pinos J14 ou no trimpot/Daisy. Se encostar, pare — avise para ajustar a caixa.
- Botão do encoder: aperte e veja se o menu reage. Se não, o seu encoder pode não ter os pinos do botão.
- Fundo: 6 parafusos M3 × 10 nas porcas presas. Pés de borracha a 12 mm dos cantos.

fonte: docs/STATUS.md (18/09): M6 do cérebro por medir

feito
