Belquer/Cotucatronics/src/TESTES.md

# TESTES.md — Cotucatronics OS · roteiro de bancada

## LED USR — o que ele está a dizer

A placa fala pelo LED em dois momentos, com **a mesma gramática**: conta N
piscadas, faz uma pausa, e repete.

### Recusa de arranque — o laço de paragem

Se o `CheckRequirements()` falhar, a placa **não arranca de propósito** e o
LED conta o código de cada requisito em falta, ciclando entre eles:

| piscadas | requisito em falta |
|---|---|
| **1** | entrada de áudio — o instrumento exige, a placa não tem |
| **2** | RAM grande insuficiente |
| **3** | knobs a menos do que o manifest exige |

⚠️ **Nada mais funciona neste estado** — o laço principal nunca começa, logo
não há serial a que perguntar. Mas **o texto do erro repete-se** a cada três
ciclos: ligar a serial a qualquer momento mostra o motivo.

> Custou meia hora em 2026-08-31. O `min_knobs` dizia 4, o painel tem 2, e a placa
> recusou arrancar — correctamente. Mas piscava 5 Hz constante (indistinguível
> de um travamento) e dizia o erro **uma vez**, no boot, para um host que ainda
> não estava a escutar. **Alarme de boot que se perde, numa forma sem
> "depois".**

### Fase do laço — quando ele está a correr

Com o instrumento vivo, o mesmo LED conta a **fase** em que o laço está. Corre
no callback de áudio, e por isso **sobrevive a um laço morto** — foi o que
endereçou o *livelock* do `PollMidi` em 2026-08-28.

| piscadas | fase |
|---|---|
| 1 | knobs |
| 2 | `PollSerial` · encoders · espelho do OLED |
| 3 | botões do painel |
| 4 | disparo do sorteio |
| 5 | rampas do sorteio |
| 6 | `PollMidi` · LbTick |
| 7 | espelho MIDI, fim do laço |

**Como distinguir os dois:** a recusa de arranque nunca passa de **3** e a
placa está muda a comandos; a fase chega a **7** e a placa responde.

**Documento v0.25.0** · última execução em placa: 2026-08-18 · firmware
**v0.47.0 / HAL v0.11.0** na QSPI. **T1, T2, T3, T5, T6, T7 e T8 passaram**; T4 espera
hardware, e o T7e (gate com piezo) espera junto. **T10a passou nativo;
T10b espera um jumper.**

Roteiro mínimo pra dizer "a placa está viva e o painel falso responde"
antes de encostar em DSP. T1–T3 rodam só com USB; T4 espera hardware;
T5 é o critério de aceite do primeiro módulo externo; T10 é o do MIDI.

> **Os bancos nativos rodam sem placa e sem flash:** `./test.command`
> valida `dynamics.h` e `midi.h` no Mac em um segundo. Eles não
> substituem teste em placa — nenhum deles toca hardware — mas evitam
> gastar um ciclo de gravação pra descobrir erro de aritmética ou de
> máquina de estados.

---

## Ambiente validado

| Item | Versão |
|---|---|
| Placa | Daisy Seed 2 (DFM) — detectada por `CheckBoardVersion()`, codec PCM3060 |
| Toolchain | ARM GNU Toolchain 15.3.rel1 (`arm-none-eabi-gcc 15.3.1`) |
| libDaisy | `~/dev/libDaisy` (`libdaisy.a`, 7.6 MB) |
| dfu-util | 0.11 |
| Bootloader | Electrosmith `dsy_bootloader_v6_4-intdfu-2000ms.bin` (vem com a libDaisy) |
| Firmware | Cotucatronics OS v0.5.0 / `hal_daisy_seed v0.4.0` · `APP_TYPE=BOOT_QSPI` |

Ocupação do firmware v0.4.1 (com módulo externo e medidor de CPU):

| Região | Usado | Total | % |
|---|---|---|---|
| FLASH (interna) | 0 B | 128 KB | 0,00% — é do bootloader agora |
| QSPIFLASH | 123 784 B | 7 936 KB | **1,52%** |
| SRAM | 71 100 B | 512 KB | 13,56% |
| SDRAM | 64 MB | 64 MB | 100,00% (o `sdram_pool` inteiro — ver nota no fim) |

> **Antes da migração o mesmo firmware ocupava 123 392 B / 128 KB = 94,14%
> da flash interna.** Um único módulo externo comeu quase tudo; o segundo não
> caberia. Daí o `APP_TYPE=BOOT_QSPI`.

> O toolchain do Homebrew (`brew install arm-none-eabi-gcc`) **não serve**:
> vem sem newlib, e a libDaisy morre em `stdint.h: No such file or directory`.
> Use o cask `gcc-arm-embedded` (pede senha de admin).

## Como rodar

### Passo único: gravar o bootloader (só na primeira vez por placa)

O bootloader mora na flash interna, como qualquer app normal — então
grava-se pelo **DFU da STM**: segure **BOOT**, toque **RESET**, solte BOOT.

```bash
make program-boot
```

Isso é **uma vez por placa**. Depois disso a flash interna é do bootloader e
não se mexe mais nela, a não ser pra atualizar o próprio bootloader.

### Ciclo normal: compilar e gravar o app na QSPI

```bash
make -C ~/dev/libDaisy          # uma vez
make BOARD=daisy_seed
# toque RESET e grave DURANTE a janela de graça (LED pulsando, ~2 s).
# Pra estender a janela indefinidamente: segure BOOT (o LED responde com
# piscadas rápidas).
make program-dfu               # o APP_TYPE já aponta pro endereço da QSPI
./cotuca_serial.py --send board list mods --gap 1.3
```

**O que mudou em relação ao fluxo antigo:**

| | Antes (`BOOT_NONE`) | Agora (`BOOT_QSPI`) |
|---|---|---|
| Entrar em modo de gravação | BOOT + RESET (DFU da STM) | só RESET, e gravar na janela de ~2 s |
| Onde o app vai parar | flash interna, 128 KB | QSPI, 8 MB |
| Teto de tamanho | 128 KB | 7 936 KB |
| USB PID no DFU | `0483:df11` (STM) | `0483:df11` (bootloader da Daisy) |
| Tempo de boot | imediato | +2 s de janela de graça |

`make program-dfu` sempre termina com `Error 74` no `leave request`: a placa
pula pro app e para de responder ao último `get_status`. Se apareceu
`File downloaded successfully`, gravou.

### Voltar pra flash interna

```bash
make clean && make APP_TYPE=BOOT_NONE
# BOOT + RESET + solta BOOT
make APP_TYPE=BOOT_NONE program-dfu
```

Isso **apaga o bootloader** (o app volta a ocupar a flash interna) — pra
voltar pra QSPI é preciso refazer o `make program-boot`.

---

## T1 — LED pisca 1×/seg · ✅ PASSOU

**Procedimento:** gravar, olhar o LED USER.
**Esperado:** ~1 Hz. Pisca **rápido** (10 Hz) = `CheckRequirements()` reprovou a placa.

**Resultado:** piscando devagar. Confirmado também pelo serial: o boot imprime
`pronto.` em vez de entrar no laço de pisca rápido, ou seja a Seed 2 atende
`needs_audio_in`, `min_knobs 4` e a RAM exigidos pelo manifest.
Na v0.3.0 o LED virou heartbeat contado (toggle a cada 500 ticks de ~1 ms),
e o ritmo de 1 Hz se manteve.

## T2 — painel falso via serial 115200 · ✅ PASSOU

**Procedimento:** `board`, `list`, `k1 0.5`, `list`.

```
> board      < Daisy Seed | knobs:5 | in:sim | 48000Hz/blk48
> list       <  0 level      norm=0.70 real=0.70
             <  1 tone_freq  norm=0.40 real=848.00
             <  2 tone_mix   norm=0.00 real=0.00
             <  3 spare      norm=0.00 real=0.00
             <  4 src_mix    norm=0.00 real=0.00
> k5 0.5     < knob 5 -> 0.50   (src_mix 0.00 → 0.50)
> k1 0.5     < knob 1 -> 0.50
> list       <  0 level      norm=0.50 real=0.50
```

Sample rate e block size batem com o `BoardInfo`. A tradução
normalizado→real do manifest confere: `0.40` em `[80, 2000]` = 848 Hz.

## T3 — áudio no AUDIO_OUT_L · ✅ PASSOU

**Procedimento:** cabo em **pino 18 (AUDIO OUT L)** e **pino 20 (AGND)**;
`tone on`, `k2 0.1875`, `k2 0.8`, `k5 0.5`, `tone off`.

**Lado do firmware — passou:**

```
> tone on     < tone ON            (tone_mix 0.00 → 0.50)
> k2 0.1875   < knob 2 -> 0.19     → tone_freq real = 440.00 Hz
> k2 0.8      < knob 2 -> 0.80     → tone_freq real = 1616.00 Hz
> tone off    < tone OFF
```

Conversão pra afinação alvo, com `tone_freq` em `[80, 2000]`:
`norm = (Hz − 80) / 1920`. Logo **440 Hz = 0.1875** e 880 Hz = 0.4167.

**Lado do ouvido — passou.** Tom contínuo e limpo no reteste com 3 s por altura
(848 → 440 → 1616 → 440 Hz), sem estalo, dropout ou distorção. A primeira
passada tinha soado como um bip curto; foi observação parcial, não defeito.

> **`k5` / SRC MIX passou a existir na v0.3.0.** `list` mostra `src_mix` no
> índice 4 e `k5 0.5` move de 0.00 → 0.50. O crossfade `IN_L`↔`IN_R` está no
> callback, mas só será audível com as duas entradas ligadas (T4).

## T4 — piezo / exciter / toggle de roteamento · ⏸️ BLOQUEADO

Espera o buffer de alta impedância, o TPA3116 e o painel. Nada a rodar.

## T5 — módulo externo "delay" · ✅ PASSOU

**O critério de aceite do primeiro módulo.** Compilar não é evidência: o
patcher pode estar montado e mudo. Aqui a conta foi fechada por medição, não
só por ouvido — ver T5b.

**Pré-requisito:** bootloader gravado (`make program-boot`, uma vez) e
firmware na QSPI (`make program-dfu`). Ambos feitos em 2026-08-15;
executado com o firmware v0.4.1 / HAL v0.4.0.

### T5a — descoberta dos parâmetros (serial, sem áudio)

```bash
./cotuca_serial.py --send board list mods --gap 1.5
```

**Esperado:**

- No **boot**: `modulo "delay": 2 params, 2 ligados`, e **nenhum**
  `AVISO: param … nao existe no modulo`.
- `list` mostra **7** parâmetros — os 5 de sistema mais `dly_time` e
  `dly_mix`, ambos `norm=0.50`.
- `mods` mostra o módulo, os dois params **descobertos por nome**
  (`[0] dly_time`, `[1] dly_mix`), as duas ligações do manifest com índice
  `≥ 0`, e o extrato de memória com **`0 falhas`**.
- O boot imprime `SDRAM via AllocBig: N de 67108864 bytes` com **N > 0** —
  é a linha de delay. Antes do módulo esse número era zero.

**Falhou se:** índice `-1` em alguma ligação (nome divergente do
`description.json`), `falhas > 0` no extrato (SDRAM esgotada), ou
`ERRO: modulo "delay" falhou no Init` (o firmware cai pra passthrough e o
áudio sai seco, o que **não** é o teste passando).

**Resultado — passou:**

```
> mods
< modulo "delay": 2 params
<   [0] dly_time
<   [1] dly_mix
<   dly_time   -> dly_time [0]
<   dly_mix    -> dly_mix [1]
<   ram: 2000 SRAM (de 32768) + 1048584 SDRAM, 15 blocos, 0 falhas
> list
<  5 dly_time   norm=0.50 real=0.50
<  6 dly_mix    norm=0.50 real=0.50
```

7 parâmetros, ligações em `[0]` e `[1]`, nenhum `AVISO`, 15 blocos e
**0 falhas**.

### T5b — confirmação sonora

Cabo no **pino 18 (AUDIO OUT L)** e **pino 20 (AGND)**.

| # | Comando | Esperado no ouvido |
|---|---|---|
| 1 | `tone on` · `k2 0.7` | senóide **ecoando em trem que decai** — o feedback interno do patch é 0.4, então cada repetição sai a ~40% da anterior e a cauda morre sozinha em alguns ecos |
| 2 | `k1 0.0` → `k1 0.5` → `k1 1.0` | o **tempo entre os ecos varre audivelmente**, de curto a longo. Varrer com o eco tocando dá o glissando típico de delay time modulado |
| 3 | `k2 0.0` | som **seca**: só a senóide direta, sem cauda |
| 4 | `tone off` | silêncio depois da cauda escoar |

`k1` → `dly_time`, `k2` → `dly_mix`, `k3` → `level` (ver `manifest.h`).

**Falhou se:** eco único em vez de trem (feedback não chegou), cauda que
**cresce** em vez de decair (feedback > 1, perigo pro exciter — corte o
volume), estalos a cada mudança de `k1` (interpolação do delay), ou `k2`
sem efeito nenhum (parâmetro não ligado — volte pro T5a).

**Resultado — passou, e medido em vez de só ouvido.**

Eco não muda afinação, então FFT de frequência não prova delay. O que prova é
a **cauda que sobra depois de cortar a fonte** — se o sinal persiste com a
fonte muda, ele está saindo da linha de delay e de nenhum outro lugar:

| Condição | Nível 1 s após `tone off` |
|---|---|
| `dly_mix = 0.0` | silêncio (−94 dBFS) |
| `dly_mix = 1.0` | **848 Hz a −33,7 dBFS** |
| `dly_time = 0.05` | cauda já extinta na janela de medição |
| `dly_time = 0.9` | −27,2 dBFS |

Com o tom ligado e 100% molhado: 848,23 Hz a −23,4 dBFS; logo após o corte,
848,01 Hz a −33,8 dBFS (−10,4 dB de decaimento); 3 s depois, silêncio.

O par `dly_mix = 0` → seco / `dly_mix = 1` → cauda é o controle que fecha a
cadeia inteira: **ParamTable → ligação por nome → `setParameterValue` do
motor → mudança audível**.

### T5c — CPU

```
> cpu
< cpu: 5.7% media, 9.9% pico (bloco de 48 @ 48000 Hz)
```

**Constante** em 5,7% / 9,9% com qualquer combinação de `dly_time` e
`dly_mix`, e igual em repouso e com o tom passando. Era esperado: a linha de
delay lê e escreve toda amostra independente do ajuste, então a carga não
depende do parâmetro. Carga determinística é o que se quer no palco — mas
significa que **o custo do módulo não cai quando ele está "desligado"**.

## T6 — curva de parâmetro e `set` serial · ✅ PASSOU

**Procedimento:** girar `k1` (→ `dly_time`, `curve 2.5`) por todo o curso e
conferir o `real` no `list`; depois exercitar `set <nome> <valor>`.

### T6a — a curva bate com a conta

`real = pow(norm, 2.5)`, medido nos cinco pontos:

| `k1` | Previsto | Medido |
|---|---|---|
| 0.00 | 0.000 | 0.00 |
| 0.25 | 0.031 | 0.03 |
| **0.50** | **0.177** | **0.18** |
| 0.75 | 0.487 | 0.49 |
| 1.00 | 1.000 | 1.00 |

Metade do curso do knob cobre os primeiros ~18% da faixa — os delays curtos
ganharam metade útil do percurso, que era o objetivo.

### T6b — o valor CURVADO chega no DSP

O teste que importa: não basta o `list` mostrar o número certo, o motor tem que
receber esse número. Medindo a cauda 1 s após cortar a fonte (440 Hz,
`dly_mix = 1.0`):

| `k1` | `dly_time` real | Cauda |
|---|---|---|
| 0.5 | 0.177 (curto) | −28,7 dBFS |
| 0.9 | 0.768 (longo) | **−7,2 dBFS** |

21,5 dB de diferença: delay curto repete mais vezes por segundo e a energia
decai mais rápido. Se o módulo estivesse recebendo o normalizado cru (0.5 e
0.9), a separação seria bem menor.

> **Armadilha que isso apanha.** O push pro módulo usava `params.Get()` — o
> normalizado **cru**. Com a curva só dentro do `Real()`, ela ficaria presa do
> nosso lado e nunca chegaria ao motor: o sintoma seria "a curva não faz nada",
> sem erro, sem log, sem pista. O push agora usa `Real()`. **Todo parâmetro
> futuro herda isso:** o que chega no módulo é `Real()`, e é por ali que
> qualquer transformação de manifest passa a valer.

### T6c — `set <nome> <valor>`

```
> set tone_freq 440      < tone_freq -> real=440.000 (norm=0.188, curve 1.0)
> set dly_time 0.5       < dly_time -> real=0.500 (norm=0.758, curve 2.5)
> set naoexiste 0.5      < ? param "naoexiste" nao existe (use list)
```

Alcança qualquer parâmetro pelo nome **em unidade real**, mostra a curva
aplicada e recusa nome inexistente ou valor fora da faixa. `tone_freq` e `tone_mix` são **serial-only por design** — os
knobs 1–3 foram pro delay e pro level, e o tom de teste é bancada, não
performance.

## T7 — cadeia de dinâmica do shell · ✅ PASSOU (com ressalva no gate)

Gate → [módulo] → level → split → `OUT_L`: governor → [bench_boost] → limiter ·
`OUT_R`: limiter. Firmware v0.6.3 / dynamics v0.3.1.

### T7a — governor comprime, e comprime o previsto

Tom 440 Hz, `dly_mix 0`, nível fora da região de clipe do ADC:

| `gov_ceiling` | ganho | saída medida | previsto |
|---|---|---|---|
| 1.0 | 1.00 | −9,0 dBFS | — |
| 0.02 | 0.39 | −17,2 dBFS | **−8,2 dB** |

Redução medida **8,2 dB**, batendo ao décimo com `20·log₁₀(0,39)`, repetível
duas vezes.

> **Armadilha de medição.** Numa primeira tentativa o medido (6,7 dB) não batia
> com o previsto (11,1 dB). Não era o governor: `cotuca_measure.py` reporta
> **RMS**, e pra senóide o pico fica 3 dB acima — a leitura de −1,1 dBFS RMS
> significava pico em **+1,9 dBFS**, ou seja o ADC da interface estava clipando
> e a leitura alta saía subestimada. Baixado o nível, os números fecharam.
> Toda medida de nível aqui precisa de pico abaixo de 0 dBFS, não RMS.

### T7b — limiter segura, e a conta fecha

Com `bench_boost` (ferramenta de bancada) empurrando o sinal contra o teto:

| `bench_boost` | interno | `gainL` medido | previsto `0,95/env` |
|---|---|---|---|
| 1× | 0,25 | 1.00 | 1.00 |
| 2× | 0,50 | 1.00 | 1.00 |
| 4× | 1,00 | **0.96** | 0,95 |
| 8× | 2,00 | **0.48** | 0,475 |

A saída trava de 4× em diante enquanto a entrada dobra.

**Distorção — medida nativamente**, porque na placa o ADC clipa antes:

| Sobrecarga | Pico de saída | THD |
|---|---|---|
| 1,1× | 0,95000 | 0,13% |
| 2× | 0,95000 | 0,13% |
| 4× | 0,95000 | 0,13% |
| 8× | 0,95000 | **0,13%** |

**A distorção não cresce com a sobrecarga.** Em regime permanente o clamp duro
nunca atua: o ganho suavizado já trouxe o sinal abaixo do teto, e o que sai é
senóide limpa apenas escalada. O clamp só pega o transiente inicial de ~1 ms,
que é o papel de backstop dele.

> **Ressalva:** isso é regime permanente. Material **percussivo** — que é
> exatamente o piezo com taps — bate no clamp a cada ataque. Quando o piezo
> chegar, medir de novo com transiente real, não com senóide.

### T7c — roteamento, os dois andares

```bash
python3 teste_roteamento.py
```

⚠️ **PRÉ-CONDIÇÃO DE FIAÇÃO, e não é opcional: cada saída num canal PRÓPRIO
da interface.** O script mede o mapa e **aborta** se as duas caírem no mesmo
canal — porque foi exactamente isso que invalidou a primeira corrida (ver
abaixo).

Seis critérios, medidos em v0.178.0 · `OUT_L → ch1`, `OUT_R → ch2` ·
separação útil 59,6 dB · chão −78,2 / −81,5 dBFS · base −32,6 / −36,7:

| critério | OUT_L | OUT_R | |
|---|---|---|---|
| `route_l_a=0` corta A em L, e **só** em L | −44,8 | +0,0 | ✅ |
| `route_r_a=0` corta A em R, e **só** em R | −0,0 | −43,9 | ✅ |
| `out_l=0` corta o ramo L, e **só** L | −44,1 | +0,0 | ✅ |
| `out_r=0` corta o ramo R, e **só** R | +0,0 | −41,5 | ✅ |
| **inversão**: A só no L → A só no R | −32,6 → −77,4 | −80,9 → −36,7 | ✅ |
| o delay **sobrevive** a `route_r_a=0` | — | −40,5 contra chão −81,5 | ✅ |

O último é o que separa os andares: a matriz tira o seco, o freeze e o espaço
da cadeia A, mas o retorno do delay fica **41 dB acima do chão** — uma
instância só, envios já somados, e nada nela sabe de que cadeia veio.

> **A PRIMEIRA CORRIDA TINHA DOIS CRITÉRIOS VAZIOS.** As duas saídas chegavam
> somadas a uma entrada só (soma coerente confirmada ao centésimo: −22,1 e
> −19,1 dBFS dão −14,45, medido −14,5). Com `OUT_L` sem chegar à interface,
> *"o L não afecta o R"* dava +0,0 dB **fosse qual fosse o firmware**.
> **Critério que não pode falhar não é critério** — e ele passou, com aspecto
> de prova.
>
> **E o mapa saiu CRUZADO na primeira montagem** (`OUT_L → ch2`). Por isso o
> script o MEDE em vez de o assumir: índice trocado não produz silêncio, produz
> veredito trocado de lado.

### T7d — CPU

| Configuração | Média | Pico |
|---|---|---|
| Sem cadeia (v0.5.0, só o delay do motor externo) | 5,7% | 9,9% |
| Repouso, cadeia carregada | 10,2% | 20,5% |
| **Tudo engajado** (gate aberto + governor comprimindo + boost 8× + limiter atuando + delay) | **11,0%** | **20,5%** |

A cadeia custou ~5 pontos de média. Note que engajar tudo custa quase nada a
mais que o repouso: os três blocos rodam o detector e o ganho **sempre**, ativos
ou não. Carga determinística — bom pro palco, mas o custo não desaparece quando
o bloco está "desligado".

### T7e — gate · ⏸️ PARCIAL

Fecha corretamente com o chão em silêncio digital (`gain=0.00`, `env=0.0001`) e
abre com sinal (`gain=1.00`, `env=0.47`). Mas os dois critérios que importam —
*silenciar chão de ruído real* e *abrir no tap sem comer transiente* — precisam
do piezo. Com a entrada desligada não há chão que gatear.

O teste nativo cobre a lógica: fecha a −60 dBFS, abre em 10,1 ms, e deixa passar
**9,5% do sinal no primeiro milissegundo**. Esse último número é o que vale
discutir quando o piezo chegar: com attack de 10 ms o gate **come parte do
transiente**. Pra um tap seco em metal pode soar como perda de ataque. O
conserto seria attack de ~1 ms, e o detector já está rápido o bastante (0,5 ms)
pra sustentar isso sem falso disparo.

## T8 — shifter SSB (anti-feedback) · ✅ PASSOU

Quarto bloco permanente do stack, em C++ do shell. Ramo do exciter, entre o
split e o governor. Firmware v0.9.0 / dynamics v0.4.0.

**Este é o teste perfeito pro medidor por FFT**: o deslocamento é literalmente
uma frequência, então o critério de aceite é diretamente mensurável em vez de
inferido.

### T8a — o deslocamento acontece, e é o valor pedido

Tom 440 Hz, `set shift_hz 5`, medido no ramo do exciter:

```
ch2:  445.12 Hz   -7.4 dBFS   erro +0.12 Hz (+0.5 cents)
```

**445,12 Hz** = 440 + 5, com o mesmo desvio de clock de +0,12 Hz que aparece em
toda medição desde o T3. Deslocamento linear em Hz, não intervalo.

### T8b — banda lateral inferior suprimida

FFT alvo em três frequências, 3 s de captura, janela de Hann:

| Componente | Nível | vs. banda superior |
|---|---|---|
| **445 Hz** (banda superior) | −4,3 dBFS | — |
| 440 Hz (portadora) | −101,0 dBFS | **−96,7 dB** |
| 435 Hz (banda inferior) | −54,9 dBFS | **−50,5 dB** |

**50,5 dB de supressão**, contra os 30 dB pedidos — e batendo *exatamente* com
os 50,5 dB previstos nativamente a 440 Hz. A portadora original praticamente
desapareceu (96,7 dB abaixo): o SSB está limpo.

Perfil nativo em toda a banda:

| Tom | Supressão |
|---|---|
| 100 Hz | 55,7 dB |
| 440 Hz | 50,5 dB |
| 5 kHz | 46,8 dB |

### T8c — CPU

| Configuração | Média | Pico |
|---|---|---|
| Sem shifter (v0.8.0) | 9,6% | 20,4% |
| **Com shifter** | **10,7%** | **23,6%** |

**~1 ponto de média**, abaixo do orçamento de 3–6% previsto. Constante para
qualquer `shift_hz` — o filtro roda sempre, como os outros blocos do stack.

O barateamento vem do oscilador de quadratura em **forma acoplada** (4
multiplicações por amostra) em vez de dois `sinf`/`cosf` por amostra.

### T8d — jack sem shift · ✅ PASSOU

Cabo movido pro **pino 19** (`OUT_R`), mesmo tom 440 Hz e mesmo `shift_hz 5`:

| Componente | Nível | vs. 440 |
|---|---|---|
| **440 Hz** (original) | −4,4 dBFS | — |
| 445 Hz (banda superior) | −111,1 dBFS | **−106,7 dB** |
| 435 Hz (banda inferior) | −108,7 dBFS | −104,3 dB |

**106,7 dB de rejeição** — isso é o piso de ruído, não supressão parcial. O jack
sai absolutamente limpo, sem traço do deslocamento. O split é real.

### T8e — roteamento, dos dois lados

Com o cabo no pino 19:

| Roteamento | Medido em `OUT_R` |
|---|---|
| exciter=1, jack=1 | 440,12 Hz, −7,4 dBFS |
| exciter=1, jack=0 | silêncio |
| exciter=0, jack=1 | 440,12 Hz, −7,4 dBFS |

Espelho exato do teste no pino 18: cada ramo responde só ao próprio `route`, e
mutar um não toca no outro.

> **Erro de bancada que quase virou conclusão errada.** A primeira rodada deste
> teste usava `set -- $cfg` num loop de shell pra separar os pares. **zsh não faz
> word-splitting** em expansão não-quotada, então `$1` virava `"1 1"` e `$2`
> ficava vazio — o comando enviado era `set route_jack` sem valor, que o
> `strtof` lê como **0**. O jack esteve mutado durante todo o teste.
>
> A conclusão anterior (que `route_exciter` — hoje `out_l` — controla o canal
> medido no pino 18) continuava certa, mas **por acaso**. Refeito com
> argumentos explícitos.
>
> Vale a lição pro roteiro: teste que dá o resultado esperado merece a mesma
> desconfiança que o que falha — aqui foi o silêncio *inesperado* no pino 19 que
> expôs o bug, e ele estava lá desde a rodada anterior.

> ### A armadilha que quase passou: `a` vs `a²`
>
> A primeira versão do shifter dava **18,9 dB** de supressão, degradando em
> direção ao meio da banda (60 dB a 100 Hz, 19 dB a 5 kHz). Testei as quatro
> combinações de atraso e sinal — a melhor parava em 19 dB. Testei duas formas
> de seção allpass — sem melhora.
>
> A causa: **os coeficientes clássicos publicados são `a`, e a seção usa `a²`.**
> Elevar ao quadrado levou de 18,9 pra 46,8 dB a 5 kHz. Não era erro de
> estrutura nem de sinal — era convenção não documentada no conjunto de
> coeficientes.
>
> **Se tivesse gravado sem medir, o anti-feedback ficaria com metade da
> supressão e ninguém descobriria até uma escultura apitar no palco.** É o
> argumento mais forte que este projeto tem a favor de medir antes de gravar.

---

## T10 — MIDI: parser, mapa e loopback de UART · ⚙️ NATIVO PASSOU · ⏳ PLACA PENDENTE

**A validação está partida em dois de propósito, porque as duas metades
provam coisas diferentes e só uma delas roda sem hardware.**

| | O que prova | O que **não** prova |
|---|---|---|
| **T10a** — banco nativo | parser, mapa do manifest, normalização, curva | nada da UART |
| **T10b** — loopback com jumper | UART, baud rate, pino, DMA, fila, ISR | — |

Um parser perfeito alimentado por uma UART configurada a 9600 baud não
recebe byte nenhum, e o T10a passaria do mesmo jeito. Por isso o T10a
**não** é o teste de aceite — é o que permite chegar na bancada com o
parser já sabidamente correto.

### T10a — banco nativo · ✅ PASSOU

```bash
cd src && ./test.command      # ou: clang++ -std=c++14 -O2 -I. test_midi.cpp -o /tmp/t && /tmp/t
```

`midi.h` e `manifest.h` são C++ puro e board-agnostic, então a máquina
de estados **e a via completa CC→ParamTable** rodam no Mac.

**Resultado: 16 verificações, 0 falhas.** As que importam:

```
OK   status omitido: 3 CCs de um B0 so                     n=3 ultimo val=127
OK   clock entre os data bytes nao quebra o CC             n=1 val=64 realtime=1
OK   nota/bend/pgm/pressure engolidos, CC seguinte intacto n=1 cc=21 val=32 outras=4
OK   corpo de sysex nao vira CC, e o CC seguinte funciona  n=2 cc=22 val=99
OK   dados sem status sao descartados e contados           n=1 orfaos=3 val=70
OK   CC 20 val 64 -> dly_time norm 0.50                    norm=0.5039 real=0.1803 (curve 2.5)
OK   CC 24 val 127 -> gov_ceiling em 1.00 (param sem knob) norm=1.0000
OK   CC e knob no mesmo param dao o MESMO valor            midi=1.0000 knob=1.0000
```

A penúltima é a que fecha o critério de aceite do enunciado. A última é
a que prova que **MIDI é um knob remoto e não um caminho novo**: o mesmo
gesto pelas duas vias dá bit a bit o mesmo valor.

> **`real=0.1803` não é erro.** `dly_time` tem curva 2.5, então
> `real = 0.5039^2.5 = 0.18`. O `list` mostra as duas colunas; o
> critério é o `norm`. A curva do manifest vale pro MIDI **exatamente
> como vale pro knob** — é o ponto, não um efeito colateral.

### T10b — loopback de UART · ⏳ PENDENTE

**Precisa de um jumper entre o pino 14 (D13/TX) e o pino 15 (D14/RX).**
Um fio, sem solda. É a única forma de provar baud rate e pino sem o
WIDI em mãos.

```bash
cd src && ./cotuca_serial.py --send midi "midiloop 20 64" midi list --gap 1.5
```

**Esperado:**

1. No **boot**: `MIDI: USART1 31250 8N1 | TX=D13(pino14) RX=D14(pino15)`
   e `MIDI: canal omni, 5 CCs mapeados`.
2. `midi` antes: `uart ESCUTANDO | perdidos 0`, `bytes 0`, `cc 0`.
3. `midiloop 20 64` manda `B0 14 40` pelo TX.
4. `midi` depois: **`bytes 3 | cc 1`**, e no histórico
   `cc 20 val 64 ch 1 -> dly_time`.
5. `list`: **`dly_time norm=0.50`**.

**Falhou, e o que cada falha quer dizer:**

| Sintoma | Onde está o problema |
|---|---|
| `uart PARADA` no boot | a UART nem inicializou — conflito de periférico |
| `bytes 0` depois do `midiloop` | o jumper: fio solto, ou pino errado |
| `bytes 3` mas `cc 0` | parser — mas o T10a já cobre isso, então desconfie do jumper primeiro |
| `cc 1` mas `dly_time` parado | o mapa do manifest, ou id resolvido antes do `Add()` |
| `perdidos > 0` | fila de 128 estourou — não deve acontecer com 3 bytes |

### `miditest` — o atalho, e o que ele custa

```
miditest 20 64
```

Injeta os mesmos três bytes **na fila de RX**, sem passar pela UART.
Serve pra separar "o fio não chegou" de "chegou e o firmware ignorou"
sem desmontar nada.

> **`miditest` NÃO substitui o `midiloop`.** Ele entra depois do fio:
> um baud rate errado, um pino trocado ou um DMA mal configurado
> passariam por ele sem reclamar. O próprio comando avisa isso na
> resposta (`NAO passa pela UART`).
>
> E ele escreve no mesmo índice de fila que a ISR do RX. Com MIDI ao
> vivo entrando, as duas escritas correm. **É gancho de bancada com a
> porta silenciosa.**

### No dia da solda do WIDI

`midi` é a primeira coisa a consultar. Ele responde **em qual etapa o
sinal parou**:

```
midi: uart ESCUTANDO | perdidos 0 | canal omni
  bytes 42 | cc 3 | outras 12 | orfaos 0 | realtime 24 | canal alheio 0
  parser: running status B0 | 0 byte(s) pendente(s)
  cc 20  -> dly_time
  ...
  ultimos CCs (mais recente primeiro):
    cc 20  val 64  ch 1  -> dly_time
```

- `bytes 0` → **cheque o cruzamento TX↔RX antes de qualquer coisa**
  (ver [BOARDS.md](BOARDS.md)). Ligar reto não queima nada e não dá erro
  nenhum: só não chega byte, igualzinho a módulo sem alimentação.
- `bytes > 0` mas `cc 0` → está chegando lixo, ou só real-time. Se
  `realtime` sobe e mais nada, o controlador manda clock e não CC.
- `cc > 0` mas `(fora do mapa)` no histórico → o controlador manda CC,
  só que outro número. Ajuste o `midi_map[]` no manifest.
- `canal alheio > 0` → chegou no canal errado. O default é omni, então
  isto só aparece se alguém fixou `midi_channel`.

## T11 — painel v2 por serial (botões antes da solda) · ⏳

Mesma estratégia que validou os knobs antes dos pots existirem: os
comandos `b1` e `b2` simulam os botões pelo caminho REAL — mesma
detecção de borda, mesmo randomizador, mesmas rampas. O que fica de
fora é só o GPIO e o debounce.

### T11a — B1 randomizador

```bash
./cotuca_serial.py --send list b1 list --gap 1.5
```

**Esperado:** `B1: sorteando 2 param(s) em 50 ms`, e o `list` depois
mostra `dly_time` e `dly_mix` com valores diferentes do anterior.

**Whitelist:** só esses dois. Se `level`, `src_mix`, `gate_*`, `gov_*`,
`route_*`, `shift_hz` ou `bench_boost` mudarem, **é defeito grave** —
a whitelist existe pra que o botão surpreenda o timbre e nunca a
segurança nem a identidade do instrumento.

### T11b — a rampa não clica

Com `tone on` soando, disparar `b1` repetidamente. O timbre deve
mudar sem estalo. Rampa de 50 ms: curta pro gesto, longa pro alto-falante.

### T11c — B2 hold

Com `button2_target = -1` (instrumento atual), `b2 1` deve avisar que
não há alvo. Quando o freeze voltar ao Fx2 e o alvo for `p_frz_on`:
`b2 1` congela, `b2 0` libera, e o `list` mostra o valor anterior
restaurado — não zerado.

### T11d — knobs no desenho novo

| | Antes | Painel v2 |
|---|---|---|
| k1 | dly_time | **level** |
| k2 | dly_mix | **src_mix** |
| k3 | level | dly_time |
| k4 | src_mix | dly_mix |
| k5 | src_mix | **livre** |

`k5 0.5` não deve mexer em nada — o delay só tem dois params de caráter.

### O que o serial NÃO prova

GPIO, pull-up e debounce. `b1`/`b2` entram depois disso. Um botão que
quica ou um pino trocado passa neste teste e falha no painel — a
validação do hardware é bater no botão de verdade e ver o log.

## T12 — RETIRADO

O ensaio de coincidência espectral saiu com o efeito que o motivava. As duas
lições que ele comprou vivem onde servem a qualquer efeito futuro: o material
de prova por família está na etapa 6 do [IFÁ10000](../docs/IFA10000.md)
(*banda larga é a régua de cross-synthesis; senóide é a de delay e shifter*),
e o custo de a errar está no cap. 6 do
[battle_scars](../docs/battle_scars.md).

## T13 — BÚZIOS: sorteio por transiente em Lá menor · ✅ PASSOU

**Aprovado de ouvido pelo dB em 2026-08-16, um minuto contínuo de taps:
74 transientes, 74 sorteios aplicados. Razão 1:1.**

Nome do dB, e descreve o gesto melhor que qualquer termo técnico: cada
batida na escultura é uma jogada de búzios, e o que cai decide o timbre.
A escala de Lá menor faz a sorte cair sempre dentro do tom — surpresa
sem nota errada.

```bash
./cotuca_serial.py --send "bb arm" "set buzios_on 1" "set fx2_on 1" --gap 3
```

| Alvo | Sorteio |
|---|---|
| `dly_time` | 100–500 ms em **degraus de 50 ms** (cerca em REAL) |
| carta de nota do Fx2 | nota nova em **Lá menor**, repetição aceita |
| `dly_mix` / carta de timbre do Fx2 | [0.3–0.8] / [0.4–1.0] |

Proibidos por design: `level`, `src_mix`, gate, governor, limiter,
roteamento, shift. **O búzio pode surpreender o TIMBRE, nunca a
SEGURANÇA nem a IDENTIDADE do instrumento.**

### A caçada que o T13 custou — o loop que morria

O búzios "funcionava" 5 segundos e congelava. Foram nove voos de
diagnóstico até o assassino ter nome, e o método que resolveu foi trocar
teoria por medição a cada passo:

| Voo | Variável | Voltas do loop | Morte |
|---|---|---|---|
| completo | tudo ligado | 1 505 | 12,6 s |
| enxuto | sem `DelayMs`, instr. mínima | 8 748 683 | vivo aos 58,7 s |
| discriminante | `DelayMs` religado | 1 516 | 12,7 s |
| **conserto** | `DelayMs` fora | **9 711 576** | **vivo aos 62,9 s** |

**`hal::DelayMs(1)` no fim do loop era o assassino.** Com o callback do
o módulo do Fx2 segurando a CPU em rajadas de ~3,4 ms, a espera baseada em tick
engole tick e em algum momento não termina. O carimbo de tempo é escrito
imediatamente ANTES do delay: o loop chegou lá aos 12 674 ms e nunca
mais voltou — entrou e não saiu.

Tirar é seguro porque o delay era cortesia de CPU e o áudio roda por
interrupção. A única coisa que dependia da cadência do loop era a rampa
do sorteio — e ela virou função do relógio no patch anterior. **Tirar o
metrônomo deixou de ter efeito colateral no exato commit em que o
metrônomo deixou de existir.**

(Na spec do dB este teste veio como "T12"; virou T13 porque o T12 já
era da coincidência espectral.)

Cada batida no piezo sorteia:
- **tempo de delay novo, uniforme entre 100 e 500 ms** (cerca em REAL,
  porque a curva 2.5 do param entortaria um sorteio em norm);
- **nota nova do módulo do Fx2 em Lá menor natural** ({0,2,3,5,7,8,10} sobre
  110 Hz — que JÁ é um Lá), repetição aceita: sorteio sem memória;
- `dly_mix` [0.3–0.8] e a carta de timbre do Fx2 [0.4–1.0].

```bash
./cotuca_serial.py --send "set arand_on 1" "set fx2_on 1" --gap 2.5
```

**Esperado, de ouvido:**
- cada batida move o eco (derrapagem de pitch na cauda do delay =
  esperado e DESEJADO) e salta a nota do módulo do Fx2;
- a nota **nunca soa "errada"** — sempre dentro de Lá menor;
- duas batidas em < 100 ms = UM sorteio só (cooldown);
- `set arand_on 0` congela tudo (exige serial viva; com o módulo
  ligado ela morre — RESET também congela, arand_on nasce em 0).

**Registro:** enquanto a serial viver, cada sorteio loga
`arand: dly_time=… <nota>=…`. Depois dela, os **últimos 4 sorteios**
ficam na caixa-preta (slots 4–7: id na parte inteira, norm na fração)
e saem no `bb` após o reset.

**Custo:** o detector é um envelope + comparação por amostra. Esperado
~zero; conferir no `cpu` que o pico não saiu da casa dos 63–64%.

**Segurança inalterada:** level, src_mix, gate, governor, limiter,
routing e shift seguem FORA de qualquer sorteio — a whitelist com
cercas substitui a lista simples, não a política.

## T14 — REVERB + passa-alta do Fx2 · ✅ PASSOU

Certificado pelo [IFÁ10000](../docs/IFA10000.md) em 2026-08-17.

### T14a — reverb (Freeverb no shell)

`rev_mix` 0.15 · `rev_size` 0.5 · `rev_damp` 0.5, todos serial/MIDI.
**Material de prova: transiente + silêncio** — reverb em senoide contínua
é quase inaudível, porque a cauda só aparece depois do ataque.

**Custo, e a cicatriz que ele deixou:**

| Buffers (108 KB) | Sem reverb | Com reverb | Custo |
|---|---|---|---|
| SDRAM (`AllocBig`) | 8,0% | 20,9% | **+12,9 pp** |
| **SRAM** (`.bss`) | 7,9% | **13,5%** | **+5,6 pp** |

**O padrão de acesso importa mais que o tamanho.** São 48 acessos por
amostra espalhados em 24 linhas de atraso — 2,3 M/s, o pior caso possível
pra cache. Os mesmos 108 KB na região certa custam menos da metade.

Pico com o módulo do Fx2: 71,3% (3800 µs de 5333), folga de 29%.

**Fora dos búzios de propósito:** o reverb é MOLDURA, não caráter. Com
tudo saltando a cada batida, a sala constante é o que faz as jogadas
pertencerem ao mesmo lugar. *Se tudo salta, nada é surpresa.*

### T14b — passa-alta do Fx2: a medição que impediu o conserto errado

Sintoma: "um grave está estourando". O histograma de pico por nota
(pré-level, pré-limiter) mostrou:

| Portadora | Pico |
|---|---|
| ~110 Hz | 1,417 🔴 |
| ~139 Hz | 1,478 🔴 |
| ~175 Hz | 0,756 |
| ~220 Hz | 0,704 |
| ~277 Hz | 1,485 🔴 |
| ~349 Hz | 0,549 |

**Duas correções de leitura que valem mais que o número.** Primeira: os
baldes cobriam 4 semitons cada, grosseiro demais — resolução dobrada
depois. Segunda, e mais séria: o histograma agrupa por **pitch da
portadora** e mede **pico total** — ele diz *quando* a saída picou, não
*em que frequência está a energia*. Chamar aquilo de "ressonância" e
receitar notch teria sido cirurgia baseada em suposição.

O passa-alta virou então **hipótese e conserto ao mesmo tempo**: se
achatasse o histograma, era energia grave; se não, o problema seria
desequilíbrio de nível por nota e o filtro sairia.

**Achatou.** `fx2_hp` = **120 Hz**, aprovado de ouvido ("não estoura
mais"). Fica **no caminho do Fx2**, não no master — sem módulo não
estoura (medido), então filtrar o master castigaria o delay de graça. E
120 Hz fica **abaixo** da região de 174–220 Hz que o histograma mostrou
saudável: cortar mais alto levaria o corpo do som junto.

## T15 — ESTADO INSTRUMENTO: a placa sobe tocando · ✅ 2026-08-17

O instrumento real, aprovado de ouvido pelo dB. **Nenhum comando serial
necessário** — RESET e toca.

| Parâmetro | Valor | Como se chegou nele |
|---|---|---|
| `level` | **1.00** | fundo de escala; o atenuador está na placa de som |
| `in_gain` | **8×** | topo da faixa, subiu 1→2→4→8 de ouvido |
| `rev_mix` | **0.35** | valor tocado e aprovado (0.15 era chute não ouvido) |
| `buzios_thresh` | **0.04** | 0.15 era duro demais pro gesto real |
| `gate_thresh` | 0.02 | restaurado |
| `gov_ceiling` | 0.85 | proteção, não cor |
| `fx2_on` / `buzios_on` | **1 / 1** | nascem ligados |

### ~~`in_gain` — pós-fonte, PRÉ-GATE~~ 🗑️ REMOVIDO 2026-08-28

> **O param saiu, e este registo fica.** O `Governor` é um AGC: 18 dB postos
> no `in_gain` eram 18 dB que ele tirava adiante, e a saída não mudava — o
> único efeito audível era o degrau, porque o ganho era lido por bloco e
> aplicado por amostra. **Se não soa, não fica.**
>
> O teste abaixo continua verdadeiro sobre o que mediu na altura; o que
> mudou foi o instrumento.

A promessa mais antiga deste manifest, cumprida no lugar que ela mesma
reservou no primeiro dia: *"o ganho de compensação do piezo NÃO mora no
level: mora pós-entrada / pré-gate"*.

**Por que não é o mesmo que subir o `level`:** o level empurra a SAÍDA
contra o governor e o limiter — mais volume ali é mais compressão, que é
o artefato que se quer evitar. O ganho de entrada levanta o sinal antes
da cadeia inteira, e a dinâmica segue trabalhando na mesma proporção.

**Pré-gate** porque o gate precisa decidir sobre o sinal já no nível
certo; depois dele, o limiar significaria coisas diferentes conforme o
ganho.

> ⚠️ **Está no TETO, e isso é informação.** Em 8× o chão de ruído do
> piezo está 18 dB acima de onde estava. Se faltar mais, **subir o teto é
> o caminho errado** — o certo é o buffer de alta impedância
> ([BOARDS.md](BOARDS.md)), que levanta o sinal antes do ADC e melhora a
> relação sinal/ruído em vez de multiplicar os dois. A conclusão de
> 2026-08-16 ("a Daisy dá conta do piezo") segue válida *para o nível em que
> ele estava* — e esse nível mudou de significado.

### A regra do bypass, revogada por medição

`fx2_on` nascia em 0 porque módulo pesado que estoura o prazo mata o loop.
O risco foi **medido e afastado**: o módulo em 37% do prazo, watchdog
intacto, e a morte do loop que se culpava tinha outra causa (`DelayMs`,
cap. 7 do battle scars) — já consertada.

No lugar da regra fica algo melhor: **o watchdog**, que força bypass se o
módulo estourar de verdade. *Proteção por medição, não por abstinência.*

**Condição de retorno, escrita no manifest:** módulo novo e não medido no
slot Fx2 → voltar ao bypass. A regra continua certa pra quem ainda não
passou pelo [IFÁ10000](../docs/IFA10000.md).

## T10b — LOOPBACK MIDI · ✅ PASSOU (2026-08-17)

Sai da fila congelada. Jumper **D13 → D14** e:

```bash
./cotuca_serial.py --send "mscope on" "midiloop 22 0" "midiloop 22 64" "midiloop 22 127" midi --gap 3
```

**Passou:** as três mensagens saíram pelo TX, voltaram pelo RX e
percorreram o caminho real — UART → DMA → ISR → fila → parser → mapa →
parâmetro. Hex batendo com a decodificação, `level` indo a 0.000 / 0.504 /
1.000.

| bytes | msgs | aplicadas | órfãos | ressync | perdidos | erros UART |
|---|---|---|---|---|---|---|
| 395 | 113 | 112 | 0 | 0 | 0 | 0 |

**É o teste que corta o sistema ao meio.** O `mscope` mede o que entra e
por isso nunca distingue "a fonte não mandou" de "mandou e se perdeu"; o
loopback usa fonte conhecida no caminho real e dá resposta binária. Todo
canal de entrada devia nascer com o seu par assim.

## T16 — MIDI real com o WIDI, pelo scope · ✅ a/b/c PASSARAM

> **PRÉ-REQUISITO, e ele explica todos os falsos negativos:** o pareamento
> BLE **não sobrevive ao reset da placa**. Sempre *gravar → esquecer o
> dispositivo → parear → testar*. Ver [BOARDS.md](BOARDS.md).

Reprodutível por qualquer um com um cabo USB. **Sessão fria primeiro** —
`fx2_on 0` pra serial viver — depois com o módulo, pela caixa-preta.

### T16a — sessão fria, fader deslizando

```bash
./cotuca_serial.py --send "set fx2_on 0" "mscope on" --gap 2
```

O dB pareia o iPhone e desliza o fader do Loopy. O scope conta a história,
e cada desfecho aponta pra um lugar diferente:

| O que aparece | Onde está o problema |
|---|---|
| **nada** | BLE não pareou, ou UART/cruzamento (ver o guia de solda) |
| bytes chegam, `msgs completas` não sobe | parser preso — ver `ressync` e `órfãos` |
| msgs sobem, `APLICADAS` não | CC fora do mapa |
| `fila perdeu` > 0 | rajada estourando a fila da ISR |
| tudo sobe e o som não muda | o problema está depois do mapa |

### T16b — rajada · ✅ PASSOU com 914 mensagens

Fonte determinística (MIDI Wrench, knobs 20–23 e botões 24–33):

| CC | msgs | | CC | msgs |
|---|---|---|---|---|
| 20 `dly_time` | 62 | | 28 (mistura do Fx2) | 42 |
| 21 `dly_mix` | 49 | | 29 `rev_mix` | 58 |
| **22 `level`** | **381** | | 30 `in_gain` | 27 |
| 23 `src_mix` | 53 | | 31 `gate_thresh` | 25 |
| 24 `gov_ceiling` | 43 | | 32 `buzios_on` | 19 |
| 25 `fx2_gain` | 72 | | 26 (nota do Fx2) | 57 |

**914 mensagens · órfãos 0 · truncadas 0 · faixa 0–127 em todos.**

O `cc 33` apareceu como "(fora do mapa)" neste voo e por isso foi mapeado
pro `fx2_on` — **instrumentação que mostra o que NÃO está mapeado fez a
lacuna aparecer sozinha.** Agora o módulo do Fx2 liga por MIDI, e o instrumento
não depende mais de serial nem de boot pra tocar.

### T16b (histórico) — rajada de 200 CCs

Fader varrido rápido de ponta a ponta. Com `mscope stats`, uma linha por
segundo: **msgs/s**, descartes, últimos 4 CCs. O stream teria buracos aqui
de propósito — é o caso que o modo `stats` existe pra cobrir.

**Passa se:** `ressync` fica em 0 e `fila perdeu` fica em 0.

### T16c — MIDI sob carga do módulo do Fx2 · ✅ PASSOU (2026-08-18, v0.40.0)

**A pergunta:** o MIDI sobrevive com o módulo consumindo 65% do prazo do
bloco? O furo conhecido era o `hal::PollMidi()`, que roda no loop
principal — os bytes chegam por DMA (imune a carga), mas **quem despacha é
o loop**. Se o loop engasga, o canal cai junto.

**Procedimento** (etapa 0 do IFÁ10000 primeiro, sempre):

```
log on            → conferir eco. Sem eco, aborta.
board             → confirma versão
tone off ; set buzios_on 0     → zera o ambiente
midi              → baseline da marca d'água
set fx2_on 1      → sobe o módulo (uma variável trocada)
mscope stats      → janela de 90 s varrendo o CC 22 sem parar
midi ; cpu        → veredito
```

**Resultado**

| | sem carga | sob carga |
|---|---|---|
| CPU de pico | — | **65,1%** (3 470 de 5 333 µs) |
| mensagens | 65 | **2 779 em 90 s** (~70/s sustentado) |
| bytes | 220 | 8 362 |
| órfãos / ressync / perdidos | 0 / 0 / 0 | **0 / 0 / 0** |
| erros de UART / rearmes | 0 / 0 | **0 / 0** |
| **pico da fila** | **32 de 128** | **32 de 128** |

**Passa.** A marca d'água **não subiu um byte** com o módulo ligado: o
loop drena a fila na mesma velocidade a 65% de CPU que a vazio. O furo do
`PollMidi` está fechado **com número**, não com suposição.

**E o número explica a si mesmo.** Os 32 bytes não são atraso do loop — são
o **tamanho da rajada da fonte**. O WIDI entrega em pacotes de ~10
mensagens, e a fila reflete o BLE, não o despacho. Por isso o valor é
idêntico nos dois regimes: se fosse latência de loop, teria subido junto
com a carga.

**Hierarquia confirmada na prática:** caixa-preta é registro, serial é
telemetria oportunista, **MIDI é controle** — e o controle não vacilou sob
carga.

> **Pendência menor:** `msgs completas 2779 | APLICADAS 2778`. Falta
> exatamente **uma**, igual à janela sem carga (65/64). Diferença **fixa**
> de 1, não taxa de perda — quase certamente a mensagem em trânsito no
> instante da leitura. Confirmar antes de chamar de cosmético.

> **Nota histórica.** Este teste ficou "não executado" por um dia inteiro
> porque quatro tentativas anteriores reportaram `0 CCs` — com o log mudo
> por um `bb arm` meu. Elas não mediram o link: mediram o meu silêncio.
> Ver caso 8 em [../docs/battle_scars.md](../docs/battle_scars.md).

---

## T18 — PAT: Parameter Alignment Test · ⏳ 4 de 14

Um parâmetro por vez, pedido **pelo nome** (não pelo número de CC). O dB mexe
o controle, a placa registra qual CC chegou e em que param bateu, e o dB
relata o que ouviu. Separa três coisas que "não funciona" mistura: **CC não
chega**, **CC chega no param errado**, e **CC chega certo e não soa**.

**Pré-requisito inegociável:** etapa 0 do IFÁ10000 **depois de cada RESET** —
os búzios nascem ligados e sorteiam `dly_time` e `dly_mix`, então julgar
esses dois com eles ativos é medir duas mãos no mesmo controle. Já aconteceu,
e o dB percebeu antes de mim.

| # | Parâmetro | CC | Alinhamento | Comportamento |
|---|---|---|---|---|
| 1 | `freeze on` | 26 ✅ | ok | ✅ **certificado** (v0.3.1) |
| 2 | `freeze mix` | 27 ✅ | corrigido no app (mandava CC 0) | ✅ funciona |
| 3 | `delay time` | 20 ✅ | ok | ⚠️ re-testar (búzios ligados no julgamento) |
| 4 | `delay mix` | 21 ✅ | ok | ✅ funciona |

Faltam: `level`, `src mix`, `gov ceiling`, `reverb mix`, `in gain`,
`gate thresh`, `buzios on`, `freeze size`, e os dois **esperados-mortos**
`fx2 gain` (CC 25) e `fx2 on` (CC 33) — slot Fx2 vazio, o esperado é o CC
chegar e não fazer nada.

**#1 e #2 DESBLOQUEADOS em 2026-08-18:** o freeze v0.3.1 passou no aceite de 10 s
(*"ficou ótimo assim"*) e o widget do `freeze mix` foi corrigido pro CC 27 no
app. A regra que valeu até aqui continua valendo pro próximo: **conserto não
verificado não vira linha verde em lugar nenhum.**

**Nota de método:** o `ctos` foi conferido DEPOIS do aceite pra provar que o
freeze esteve ativo o teste inteiro. Sem isso o resultado não vale — o
primeiro aceite foi anulado justamente por um veto falso do watchdog, e os
15 s "de freeze" eram 15 s de silêncio.

**Achado que justifica o teste existir, e que se confirmou:** o widget de
`freeze mix` mandava **CC 0** (fora do mapa). O instrumento estava certo e o
app no número errado — diagnóstico que nenhuma leitura de código
encontraria, e que o dB corrigiu no app assim que o PAT apontou.

**Mapa reduzido em 2026-08-18:** `src_mix` (CC 23) e `gov_ceiling` (CC 24) saíram
do mapa MIDI por segurança — ver T17. Os widgets deles no controlador seguem
mandando e a placa ignora, o que aparece como `msgs completas` maior que
`APLICADAS` (95 de 887 numa sessão). **Isso é a proteção funcionando, não
perda.**

---

## T17 — QUARENTENA DE RECONEXÃO: o som não muda sem gesto · ⏳ NOVO

**O caso de campo (2026-08-18).** Transições de link BLE fazem o iOS/Loopy
reenviar a posição de todos os widgets de uma vez. O instrumento obedecia:
**som silenciado na desconexão, e freeze com `frz_size` no teto na
reconexão** — comandos que ninguém deu, aplicados como se fossem gesto.

**A defesa** (main.cpp v0.44.0): todo CC que chega depois de silêncio
> 5 s fica **seguro por até 100 ms sem ser aplicado**. Se dentro da janela
aparecerem ≥ 4 CCs **distintos**, é dump: descarta tudo o que estava
seguro e bloqueia por 500 ms. Senão, libera na ordem e a vida segue.

> **Por que segurar antes de decidir.** O gatilho é o *quarto* CC
> distinto. Bloquear a partir dali deixaria os **três primeiros**
> entrarem — e com 14 CCs no mapa, três bastam pro estrago observado.

### Fase 1 — capturar a rajada real (o dado que ainda não temos)

```
log on            → conferir eco
mscope on
```
Conectar e desconectar o WIDI **com o scope ligado**. Registrar: **quais
CCs, quais valores, e o timing**. A caixa-preta carimba (slots 87 e 89).

**Critério:** ter em mãos o perfil da rajada — sem ele, o limiar de 4 CCs
distintos é hipótese razoável, não número medido.

### Fase 2 — o ciclo de 5

Instrumento **tocando**, com o delay e o reverb no estado aprovado:

```
1. conectar    → o som mudou? 
2. desconectar → o som mudou?
   ... 5 vezes
midi     → quantos CCs a quarentena recusou
ble      → quantas (re)conexões foram detectadas
```

**Passa se: o som NÃO muda em nenhuma das 10 transições sem que alguém
tenha encostado num controle.** Qualquer mudança audível sem gesto é
reprovação, mesmo que os contadores digam que a quarentena atuou.

**Falso positivo a vigiar:** um gesto humano legítimo barrado. O perfil é
diferente — fader real é **um** CC repetido em rampa, dois dedos são
**dois** CCs — mas o teste tem que confirmar que tocar normalmente depois
de uma pausa continua funcionando. Custo declarado: o primeiro gesto
depois de 5 s parado chega com até 100 ms de atraso, uma vez só.

### Defesa em profundidade (fora da placa)

Investigar no Loopy se existe *"send state on connect"* pra desligar na
origem. **Não substitui a nossa** — um app de terceiro no caminho crítico
é exatamente o que este projeto evita —, mas se existir, some a causa em
vez de filtrar o sintoma.

---

## Catálogo forense — quando o instrumento destrói o próprio dado

Sete casos numa sessão, e o padrão vale mais que qualquer um deles:
**instrumentação é código de produção.** Quem mede tem que ser blindado
como quem toca.

1. **D-cache** — escrita na caixa-preta morria no cache e sumia no reset.
2. **Bootloader** — o `BootInfo` dele mora na base da backup SRAM e é
   escrito a cada boot, por cima da palavra mágica.
3. **Domínio travado** — acesso sem `HAL_PWR_EnableBkUpAccess()` é bus
   fault, não escrita ignorada.
4. **A leitura apagando o voo** — contadores `static` zeram no boot, e a
   sessão que LÊ reescrevia os slots antes de olhar. Reportava sempre
   "5 pushes" (o número da leitura). Conserto: só grava com o voo ativo.
5. **O mesmo, uma camada abaixo** — blindei os contadores do `main.cpp`
   e esqueci os do HAL. Conserto: portão único no `BlackboxArm()`.
6. **Contadores pareados que mentem** — `M1==M2` parecia álibi, mas o
   gravador ARMAVA no meio de uma linha, então os contadores pareavam
   eventos de linhas diferentes. Conserto: **token de estado**, não
   contagem.
7. **Dado velho com cara de fresco** — `BlackboxArm` só zerava quando a
   mágica era inválida, então `disparos` do voo anterior apareciam
   misturados. Conserto: zera sempre.

E uma **terceira família** de bug de ordem, irmã da corrida-de-contexto e
da ordem-de-configuração, mas no desenho experimental: **uma variável
servindo a dois propósitos, e o teste mexendo nos dois de uma vez.** O
`DelayMs` era relógio E metrônomo da rampa; removê-lo pra testar o
relógio mudou a música junto, e invalidou a leitura auditiva do voo.

### Ferramentas que a caçada deixou

`bb arm` (arma antes do voo, nunca no meio) · `log_mute` (Log só grava na
caixa-preta) · token de voo · marcadores de fase · carimbo de tempo ·
contador de voltas completas.

---

## Defeitos conhecidos

### A serial morre sob callback longo · ABERTO

Com o Fx2 ativo, o USB CDC cai poucos blocos depois (`Device not
configured`) e não volta até o RESET. **O áudio continua rodando o tempo
todo** — a escultura toca normalmente, só não há mais como falar com ela.

Não é inanição do loop principal, que foi a primeira teoria: a carga
medida é de **61%**, e 61% não starva loop nenhum. A hipótese de pé é o
callback segurando o processador em blocos de ~3,2 ms e atrasando o
serviço da interrupção do USB o bastante pra quebrar o timing do CDC.
**Não medido — é hipótese, não diagnóstico.**

**Impacto prático, que é o que importa:** nenhum parâmetro pode ser
ajustado sob a carga, então todo ajuste vira uma regravação.
Foi a causa de quase toda a lentidão da sessão de 2026-08-16.

Contornos que existem hoje: a **caixa-preta** (`bb`) grava durante o voo
e é lida depois do reset; o **CC 25** ajusta o `fx2_gain` por MIDI, que
é o único caminho de controle que sobrevive.

### Motor externo não dirigido: módulo roda mas eventos nunca executam · CORRIGIDO

`MinimalEngine` exige que o HOST rode `processEventsUntil()` e
`advanceTime()` a cada bloco. Chamar só `patcher_.process()` deixa
`_currentTime` em zero pra sempre: sinal puro roda (FFT, delay), mas
tudo que depende de evento — clock, rampa, captura — fica morto. No Max
funciona porque o motor é do Max. Assinatura: **roda, custa CPU, não
soa (ou soa errado), sem log**. Corrigido no wrapper do módulo do Fx2,
v0.5.0; o delay tinha a mesma violação e funcionava por ser só sinal —
corrigir quando for mexido.

### Caixa-preta: três armadilhas silenciosas até a primeira leitura · CORRIGIDO

1. **Domínio de backup travado**: acesso sem `HAL_PWR_EnableBkUpAccess()`
   é bus fault, não escrita ignorada.
2. **D-cache**: escrita fica no cache e morre no reset — cada escrita
   precisa de `SCB_CleanDCache_by_Addr`.
3. **Bootloader**: o `BootInfo` DELE é linkado na BASE da backup SRAM
   (binário separado!) e escrito a cada boot — em cima de qualquer coisa
   que o linker do app puser ali. A caixa-preta mora em `0x38800F00`
   (fim da região, ponteiro fixo), longe da briga.

### `r_window`: o "fallback" de tamanho é o único caminho · CORRIGIDO

`r_window` é `buffer~` e o export **nunca** chama `requestSize()` nele,
então `getSizeInBytes()` devolve 0 sempre e o código que "lê o tamanho do
próprio dataref" nunca executou. O fallback estava em 2048 pra uma FFT de
1024: o patch lia meia janela — uma rampa — e o overlap-add nunca somou
plano. Corrigido no wrapper do módulo do Fx2, v0.3.0.

### Backup SRAM: destravar o domínio antes de qualquer acesso · CORRIGIDO

Só ligar o clock não basta. No H7 o domínio de backup nasce com proteção
de escrita, e acesso a `0x38800000` sem `HAL_PWR_EnableBkUpAccess()` dá
**bus fault**, não escrita ignorada — a placa morre no primeiro `bb`,
parecendo defeito de boot sem relação com o módulo. Sequência completa
em `hal_daisy_seed v0.10.1`.

| # | Sintoma | Estado |
|---|---|---|
| 1 | `list` travava a placa (CDC calada até o reset) | ✅ corrigido no HAL v0.2.0 |
| 2 | Todo `%f` saía vazio — `board` sem o `48000`, `list` com `norm= real=` | ✅ corrigido no Makefile |
| 3 | Linha de log saía picotada e grudada na seguinte | ✅ corrigido no HAL v0.3.1 |
| 4 | Comando serial demorava até 0,5 s pra responder | ✅ corrigido no main.cpp v0.3.0 |
| 5 | Soft-knee do governor tinha degrau de 0,09 no topo do joelho | ✅ corrigido no dynamics v0.3.1 |
| 6 | `set <param>` recebia NORMALIZADO, não real — `set bench_boost 1.0` dava **8×** | ✅ corrigido no main.cpp v0.7.0 |

**#1 — despacho serial rodava na ISR.** `SetReceiveCallback` dispara em contexto
de interrupção, e `hal::Log()` transmite pelo mesmo USB: o segundo `Log`
esperava um TX que só completa quando a ISR retorna. Deadlock. `board` (1 log)
passava, `list` (4 logs) matava. A ISR agora só enfileira (SPSC de 8, fila cheia
descarta em vez de bloquear) e o `PollSerial()` despacha do loop principal —
que é exatamente pra isso que ele existe no contrato do `hal.h`.

**#2 — printf sem float.** A libDaisy linka com `--specs=nano.specs`, e o
newlib-nano vem sem suporte a `%f`: falha **calada**, sem warning. Como o
manifest e o painel são todos float, metade da saída sumia. `LDFLAGS = -u
_printf_float` no Makefile, custa ~4,6 KB.

**#3 — buffer único do Logger.** O `Logger` da libDaisy formata tudo num
`static char tx_buff_[128]` **compartilhado** e transmite sem esperar: a segunda
linha sobrescrevia o buffer enquanto o USB ainda lia a primeira, e a saída vinha
truncada e grudada (`SDRAM via AllocBig:$$ 0 level...`), às vezes sumindo.

Não era ritmo — por isso um `System::Delay(2)` por linha **não** curou. O
`hal::Log` agora ignora o Logger e transmite direto por
`hw.usb_handle.TransmitInternal()`, com **dois buffers alternados** e retry até
o CDC aceitar. Como `Log` só retorna após o aceite, ao escrever em B o buffer A
já foi entregue ao hardware, e o transmit de B só é aceito quando A terminou:
nenhum buffer é tocado enquanto o DMA o lê. Retry tem teto de ~50 ms, pra placa
sem host lendo não travar.

**Verificado:** 21 linhas em rajada com 50 ms entre comandos, todas íntegras.

**#4 — latência.** Com o despacho por polling, o `DelayMs(500)` do loop virava o
teto de resposta a comando. O loop agora gira a ~1 ms e o LED virou heartbeat
contado (toggle a cada 500 ticks), mantendo 1 Hz. Verificado com comandos a
0,35 s de intervalo: resposta imediata.

**#6 — `set` recebia normalizado.** Era coerente com `ParamTable::Set()`, mas
virava armadilha em parâmetro cuja faixa não é `[0,1]`: `set bench_boost 1.0`
parecia "sem boost" e entregava **8×**, o máximo — num parâmetro que existe
justamente pra sobrecarregar a saída do exciter. "Parece seguro e é o máximo" é
a inversão errada pra ter num instrumento.

`set` agora fala em **unidade real** — Hz, ms, ×. Converte pra normalizado
invertendo a curva:

```
norm = pow((real - min) / (max - min), 1/curve)
```

e **recusa** fora da faixa em vez de saturar: quem digita 12 num parâmetro que
vai até 8 errou, e saturar em 8 esconderia o erro.

`Set()` normalizado continua existindo ao lado de `SetReal()`, e knob e macro
seguem usando ele — posição de curso é normalizada por natureza. A mudança é só
na fronteira humana.

Efeito colateral bem-vindo: conserta o `dly_time` também. Com `curve 2.5`,
`set dly_time 0.5` dava real `0.177`; agora dá `0.500`. Antes era preciso saber
a curva de cabeça pra digitar o valor certo.

**Validado em placa** (firmware v0.7.0):

```
> set tone_freq 440     < tone_freq -> real=440.000 (norm=0.188, curve 1.0)
> set bench_boost 1     < bench_boost -> real=1.000 (norm=0.000, curve 1.0)
> set bench_boost 12    < fora da faixa: bench_boost aceita [1.000 .. 8.000]
> set dly_time 0.5      < dly_time -> real=0.500 (norm=0.758, curve 2.5)
> set tone_freq 5000    < fora da faixa: tone_freq aceita [80.000 .. 2000.000]
```

`pow(0.5, 1/2.5) = 0.758` confere a inversão da curva, e a FFT confirma os
440 Hz na saída (440,12 Hz medidos, +0,5 cents — o desvio de clock de sempre).

---

## Nota de arquitetura

**O `AllocBig()` deixou de ser descartado pelo linker.** Até a v0.3.0 a SDRAM
aparecia como `0 B / 64 MB` porque nada chamava a função e o `--gc-sections`
comia o pool inteiro. Com o módulo externo alocando a linha de delay, os 64 MB
voltaram de uma vez: o mapa agora mostra `SDRAM: 64 MB / 64 MB = 100%`.

Isso é **esperado, não estouro**. O `sdram_pool` em `hal_daisy_seed.cpp` reserva
a região inteira de propósito, e reparte por dentro — os 100% são o pool, não o
consumo. O consumo real é o que o boot imprime:

```
SDRAM via AllocBig: N de 67108864 bytes
```

A consequência prática é a de sempre: **não sobra byte pra mais nada em
`.sdram_bss`**. Todo acesso à SDRAM tem que passar pelo portão. Regra completa
em [BOARDS.md](BOARDS.md).

### Quanto o motor externo pedia — previsão vs. medido

A previsão errou por exatamente **2×**, e a causa é instrutiva:

| Origem | Conta | Bytes |
|---|---|---|
| Previsto | 131 072 samples × **4 B**, supondo que a macro de float32 valesse pra linha de delay | 524 296 |
| **Medido** | 131 072 samples × **8 B** + 8 B de header | **1 048 584** |

**Por que o dobro:** a macro de float32 troca o `SampleValue` (os sinais do
patcher) para `float`, mas a linha de delay é um `buffer~`, e o código gerado
a instancia como **`Float64Buffer`** — 8 B por amostra, independente da macro:

```cpp
this->delaytilde_01_del_buffer = new Float64Buffer(this->delaytilde_01_del_bufferobj);
```

131 072 × 8 = 1 048 576, mais 8 do nosso header = **1 048 584**, que é o número
medido, ao byte. A macro não alcança o armazenamento de `buffer~`.

**Consequência de planejamento:** todo `buffer~` de um patch custa 8 B por
amostra, não 4. Um freeze de 10 s a 48 kHz pede ~4 MB, não 2. Com 64 MB de
SDRAM ainda sobra muito, mas a conta pra dimensionar módulos é essa.

Os demais buffers do patcher são do tamanho do bloco e **couberam no pool de
32 KB em SRAM**, como previsto: 2 000 B em 15 blocos, 6% do pool. Só a linha de
delay foi pra SDRAM.

> **Nota sobre a macro de float32:** sem ela, `SampleValue` seria `double` e a
> mesma linha de delay pediria **1 MB** em vez de 512 KB.
