Belquer/Cotucatronics/kicad/cotuca_cerebro/cotuca_cerebro.kicad_pcb

## KiCad design kicad/cotuca_cerebro/cotuca_cerebro.kicad_pcb (2026-09-17)

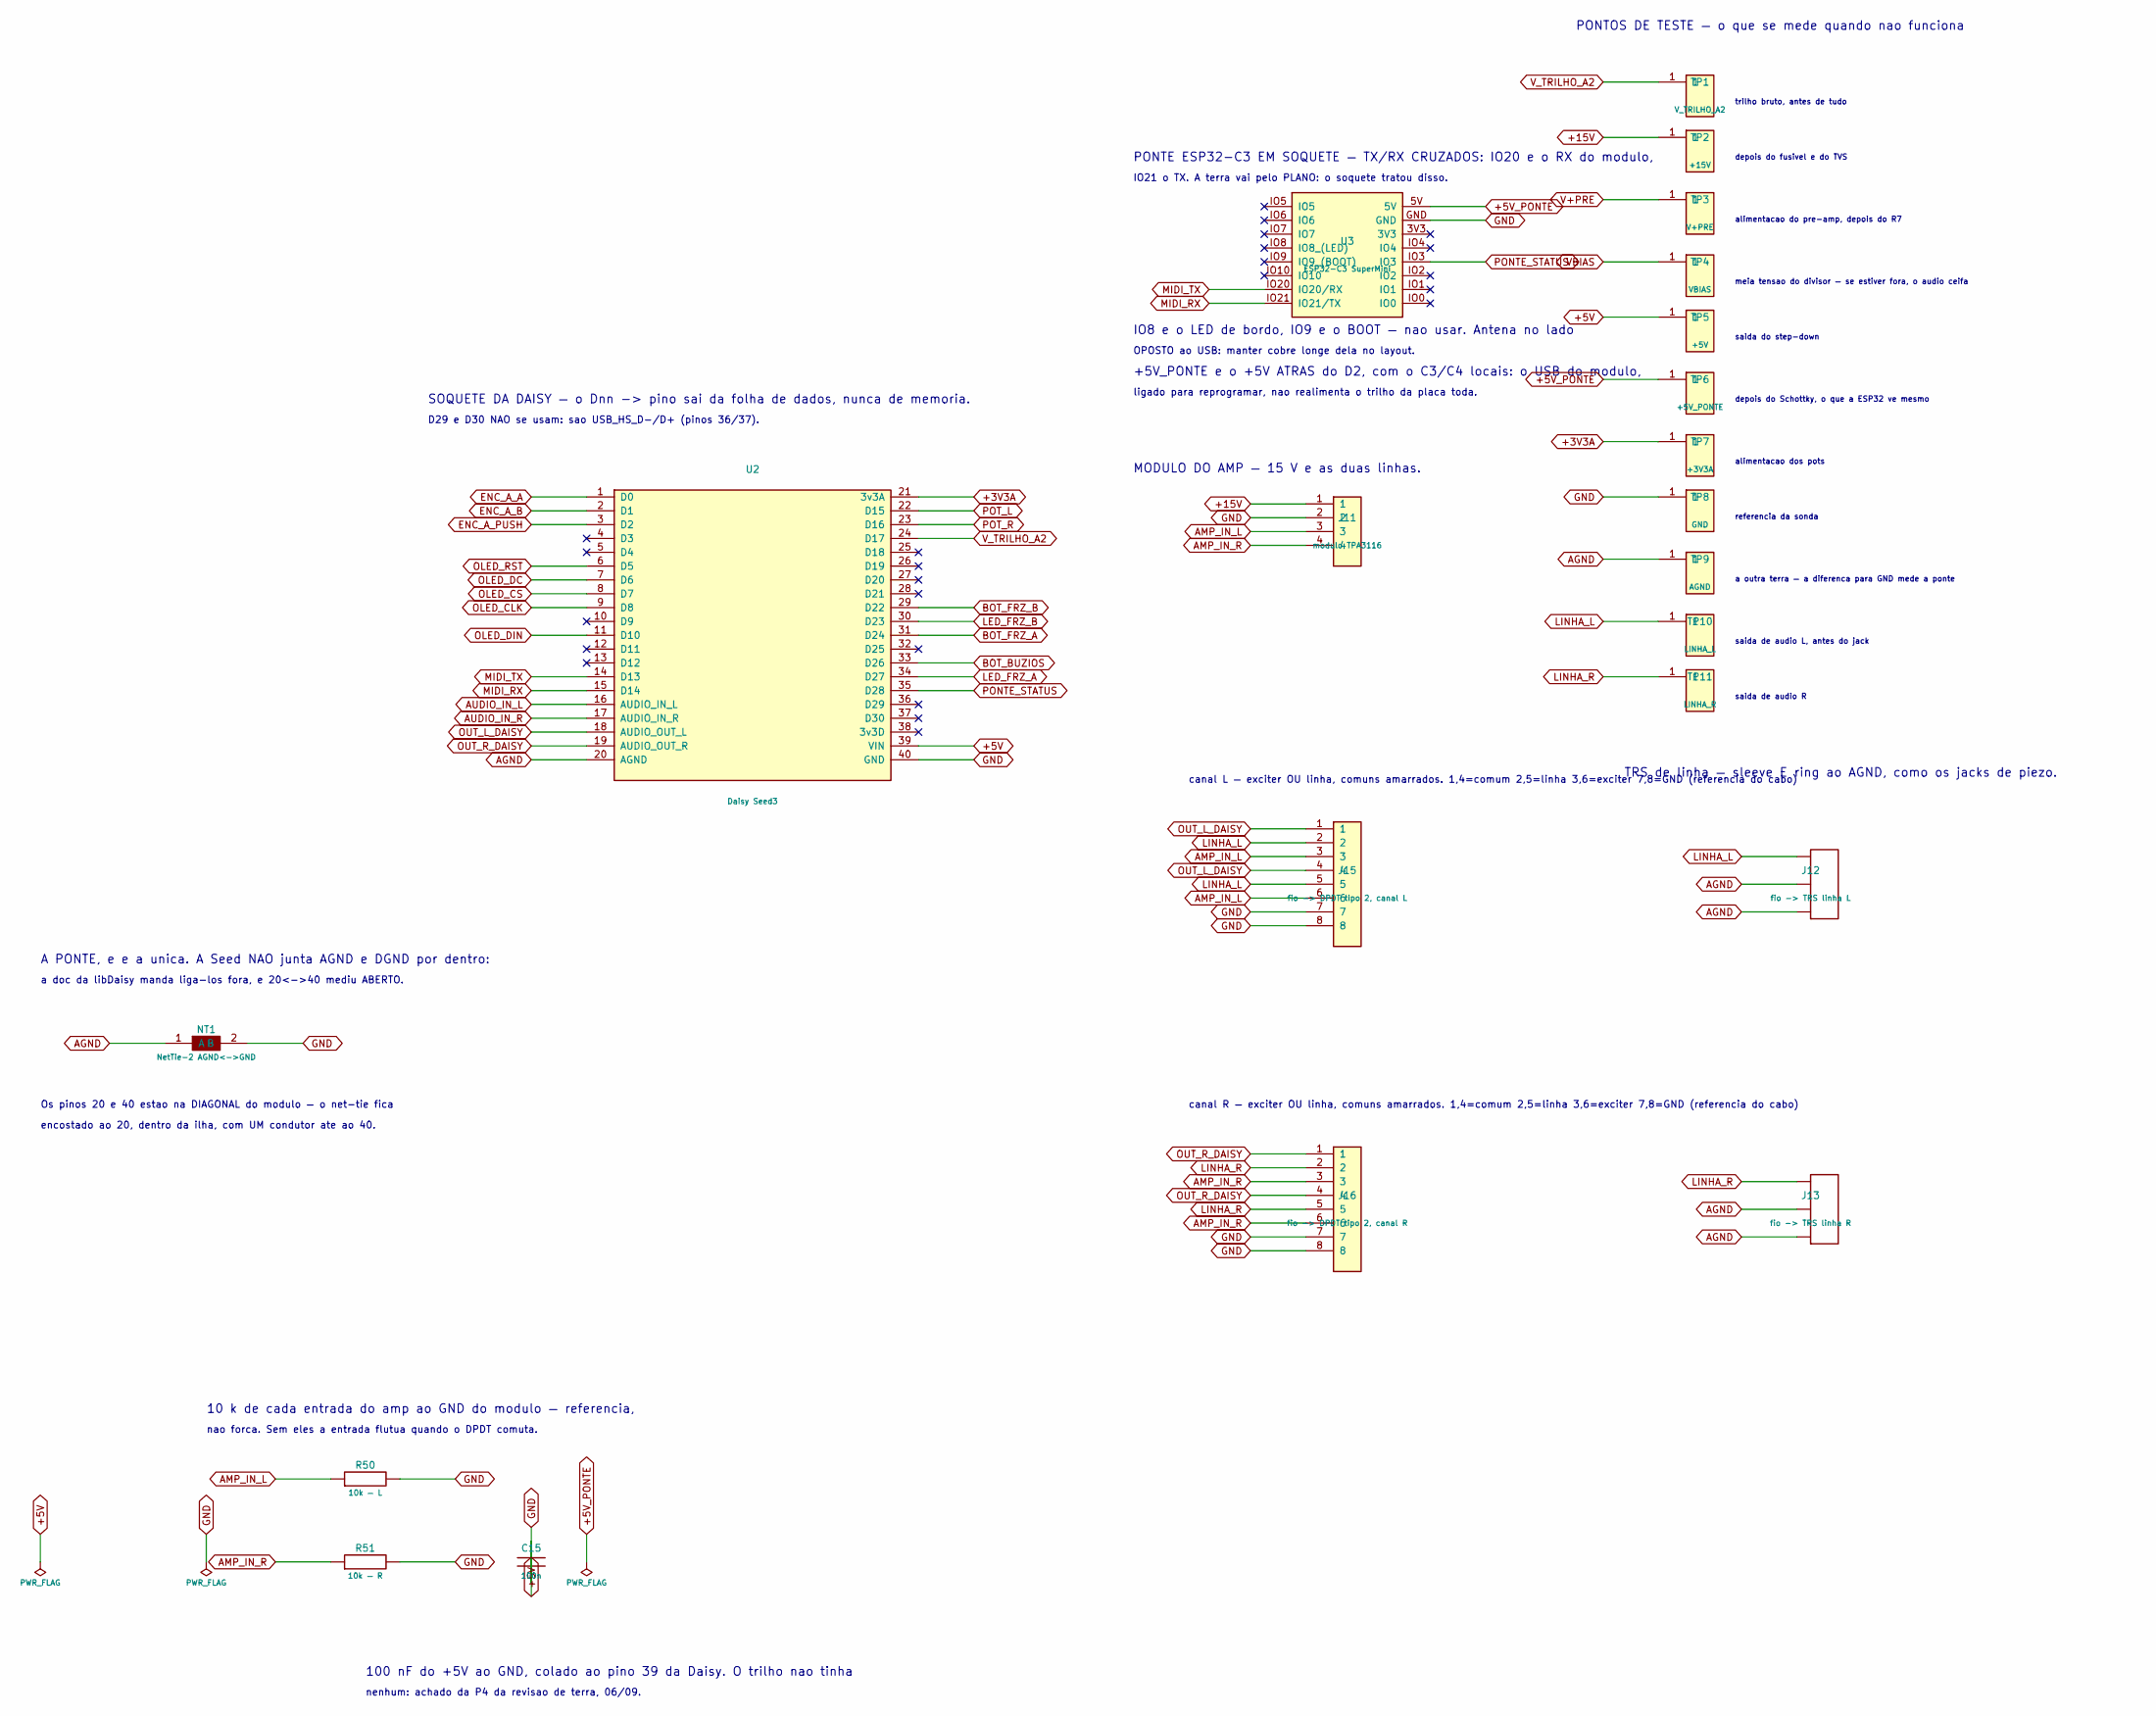
[picture p4: schematic cotuca_soquete.kicad_sch, SOQUETE + PONTE + DPDT + SAIDAS — carrier rev B]

Parts:
C15: 100n; C_0805_2012Metric
J11: modulo TPA3116; PinHeader_1x04_P2.54mm_Vertical; MPN 61304011121
J12: fio -> TRS linha L; PinHeader_1x03_P2.54mm_Vertical; MPN 61304011121
J13: fio -> TRS linha R; PinHeader_1x03_P2.54mm_Vertical; MPN 61304011121
J15: fio -> DPDT tipo 2, canal L; PinHeader_1x08_P2.54mm_Vertical; MPN 61304011121
J16: fio -> DPDT tipo 2, canal R; PinHeader_1x08_P2.54mm_Vertical; MPN 61304011121
NT1: NetTie-2 AGND<->GND; NetTie-2_SMD_Pad2.0mm
R50: 10k — L; R_0805_2012Metric
R51: 10k — R; R_0805_2012Metric
TP1: V_TRILHO_A2; TestPoint_Pad_D1.5mm
TP2: +15V; TestPoint_Pad_D1.5mm
TP3: V+PRE; TestPoint_Pad_D1.5mm
TP4: VBIAS; TestPoint_Pad_D1.5mm
TP5: +5V; TestPoint_Pad_D1.5mm
TP6: +5V_PONTE; TestPoint_Pad_D1.5mm
TP7: +3V3A; TestPoint_Pad_D1.5mm
TP8: GND; TestPoint_Pad_D1.5mm
TP9: AGND; TestPoint_Pad_D1.5mm
TP10: LINHA_L; TestPoint_Pad_D1.5mm
TP11: LINHA_R; TestPoint_Pad_D1.5mm
U2: Daisy Seed3; Electrosmith_Daisy_Seed
U3: ESP32-C3 SuperMini; ESP32C3_SUPERMINI_SOQUETE

Connections:
+3V3A: TP7.1, U2.21 (3v3A); also elsewhere on the board
+5V: C15.1, TP5.1, U2.39 (VIN); also elsewhere on the board
+5V_PONTE: TP6.1, U3.5V; also elsewhere on the board
+15V: J11.1, TP2.1; also elsewhere on the board
AGND: J12.2, J12.3, J13.2, J13.3, NT1.1 (A), TP9.1, U2.20 (AGND); also elsewhere on the board
AMP_IN_L: J11.3, J15.3, J15.6, R50.1
AMP_IN_R: J11.4, J16.3, J16.6, R51.1
AUDIO_IN_L: U2.16 (AUDIO_IN_L); also elsewhere on the board
AUDIO_IN_R: U2.17 (AUDIO_IN_R); also elsewhere on the board
BOT_BUZIOS: U2.33 (D26); also elsewhere on the board
BOT_FRZ_A: U2.31 (D24); also elsewhere on the board
BOT_FRZ_B: U2.29 (D22); also elsewhere on the board
ENC_A_A: U2.1 (D0); also elsewhere on the board
ENC_A_B: U2.2 (D1); also elsewhere on the board
ENC_A_PUSH: U2.3 (D2); also elsewhere on the board
GND: C15.2, J11.2, J15.7, J15.8, J16.7, J16.8, NT1.2 (B), R50.2, R51.2, TP8.1, U2.40 (GND), U3.GND; also elsewhere on the board
LED_FRZ_A: U2.34 (D27); also elsewhere on the board
LED_FRZ_B: U2.30 (D23); also elsewhere on the board
LINHA_L: J12.1, J15.2, J15.5, TP10.1
LINHA_R: J13.1, J16.2, J16.5, TP11.1
MIDI_RX: U2.15 (D14), U3.IO21 (IO21/TX)
MIDI_TX: U2.14 (D13), U3.IO20 (IO20/RX)
OLED_CLK: U2.9 (D8); also elsewhere on the board
OLED_CS: U2.8 (D7); also elsewhere on the board
OLED_DC: U2.7 (D6); also elsewhere on the board
OLED_DIN: U2.11 (D10); also elsewhere on the board
OLED_RST: U2.6 (D5); also elsewhere on the board
OUT_L_DAISY: J15.1, J15.4, U2.18 (AUDIO_OUT_L)
OUT_R_DAISY: J16.1, J16.4, U2.19 (AUDIO_OUT_R)
PONTE_STATUS: U2.35 (D28), U3.IO3
POT_L: U2.22 (D15); also elsewhere on the board
POT_R: U2.23 (D16); also elsewhere on the board
V+PRE: TP3.1; also elsewhere on the board
VBIAS: TP4.1; also elsewhere on the board
V_TRILHO_A2: TP1.1, U2.24 (D17); also elsewhere on the board

Notes on the sheet:
SOQUETE DA DAISY — o Dnn -> pino sai da folha de dados, nunca de memoria.
D29 e D30 NAO se usam: sao USB_HS_D-/D+ (pinos 36/37).
A PONTE, e e a unica. A Seed NAO junta AGND e DGND por dentro:
a doc da libDaisy manda liga-los fora, e 20<->40 mediu ABERTO.
Os pinos 20 e 40 estao na DIAGONAL do modulo — o net-tie fica
encostado ao 20, dentro da ilha, com UM condutor ate ao 40.
PONTE ESP32-C3 EM SOQUETE — TX/RX CRUZADOS: IO20 e o RX do modulo,
IO21 o TX. A terra vai pelo PLANO: o soquete tratou disso.
IO8 e o LED de bordo, IO9 e o BOOT — nao usar. Antena no lado
OPOSTO ao USB: manter cobre longe dela no layout.
+5V_PONTE e o +5V ATRAS do D2, com o C3/C4 locais: o USB do modulo,
ligado para reprogramar, nao realimenta o trilho da placa toda.
MODULO DO AMP — 15 V e as duas linhas.
canal L — exciter OU linha, comuns amarrados. 1,4=comum 2,5=linha 3,6=exciter 7,8=GND (referencia do cabo)
canal R — exciter OU linha, comuns amarrados. 1,4=comum 2,5=linha 3,6=exciter 7,8=GND (referencia do cabo)
trilho bruto, antes de tudo
depois do fusivel e do TVS
alimentacao do pre-amp, depois do R7
meia tensao do divisor — se estiver fora, o audio ceifa
saida do step-down
depois do Schottky, o que a ESP32 ve mesmo
alimentacao dos pots
referencia da sonda
a outra terra — a diferenca para GND mede a ponte
saida de audio L, antes do jack
saida de audio R
PONTOS DE TESTE — o que se mede quando nao funciona
10 k de cada entrada do amp ao GND do modulo — referencia,
nao forca. Sem eles a entrada flutua quando o DPDT comuta.
TRS de linha — sleeve E ring ao AGND, como os jacks de piezo.
100 nF do +5V ao GND, colado ao pino 39 da Daisy. O trilho nao tinha
nenhum: achado da P4 da revisao de terra, 06/09.

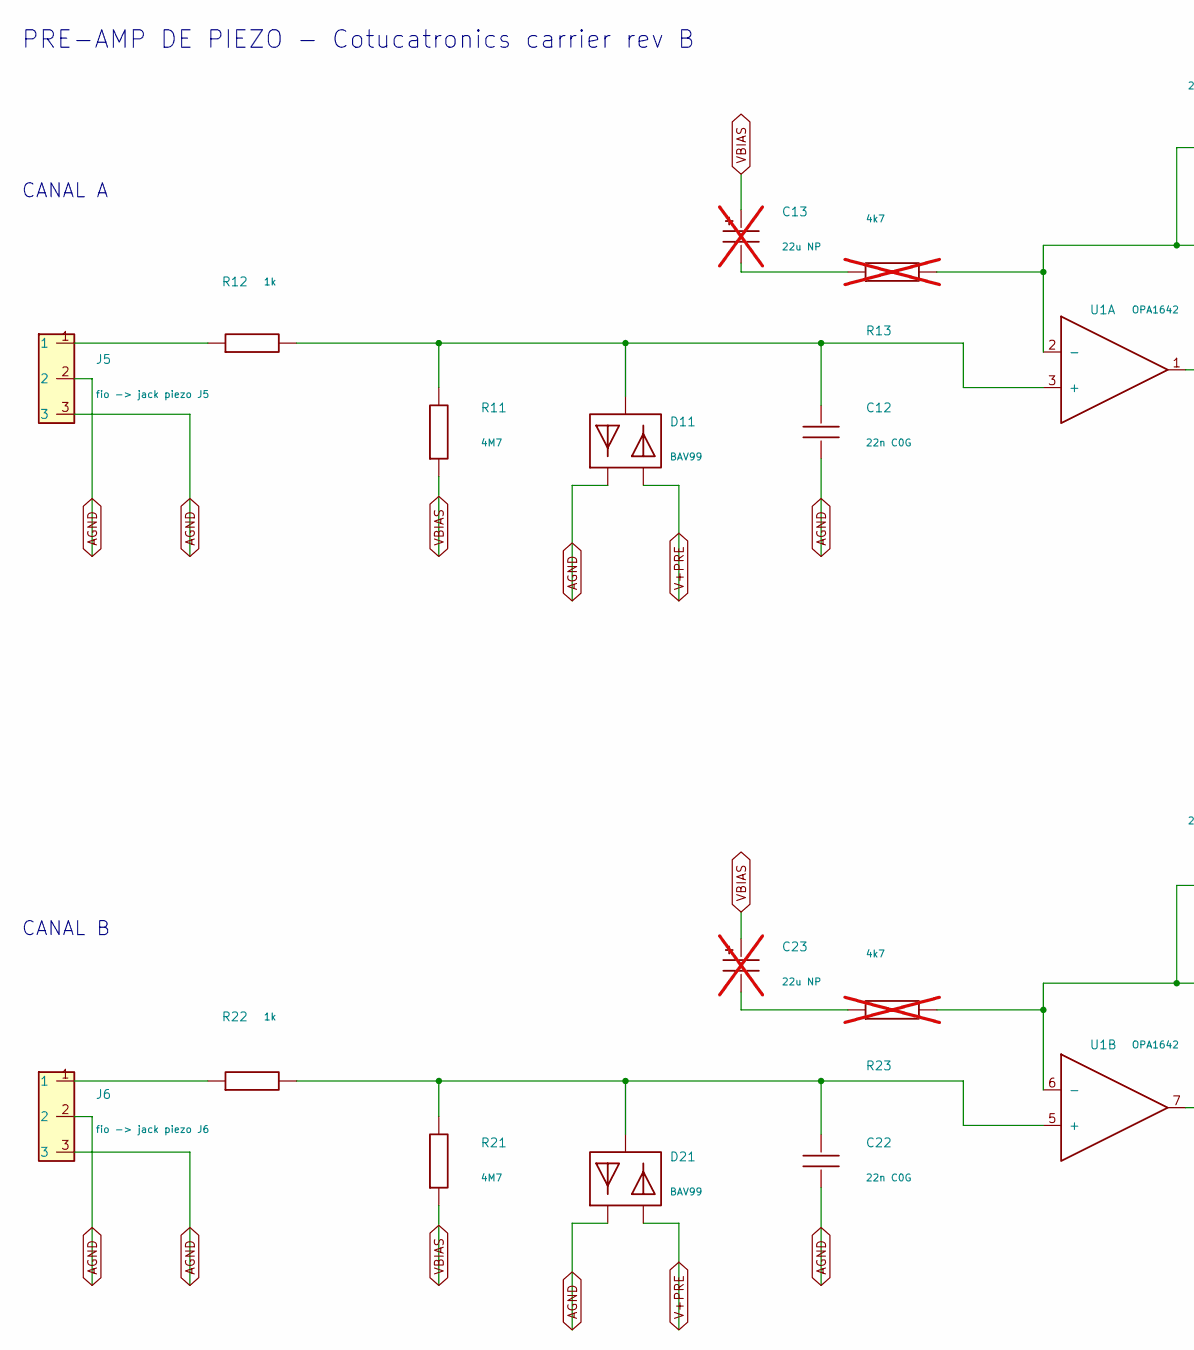
[picture p5: schematic cotuca_preamp.kicad_sch, part in row 1, column 1]

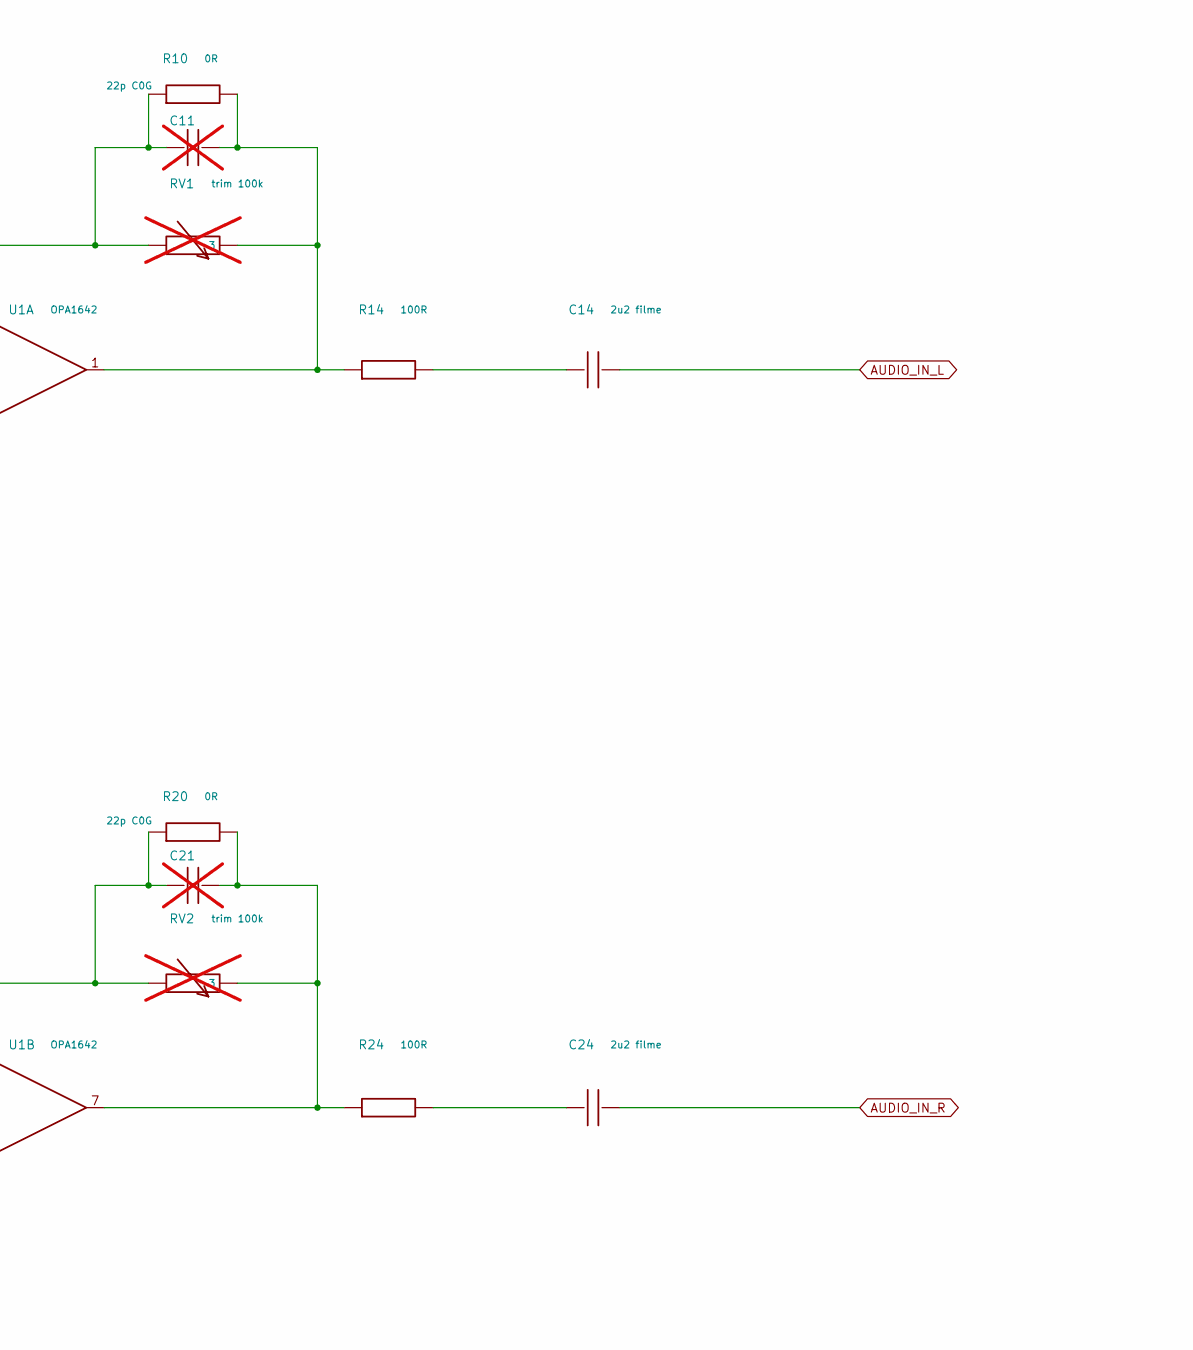
[picture p6: schematic cotuca_preamp.kicad_sch, part in row 1, column 2]

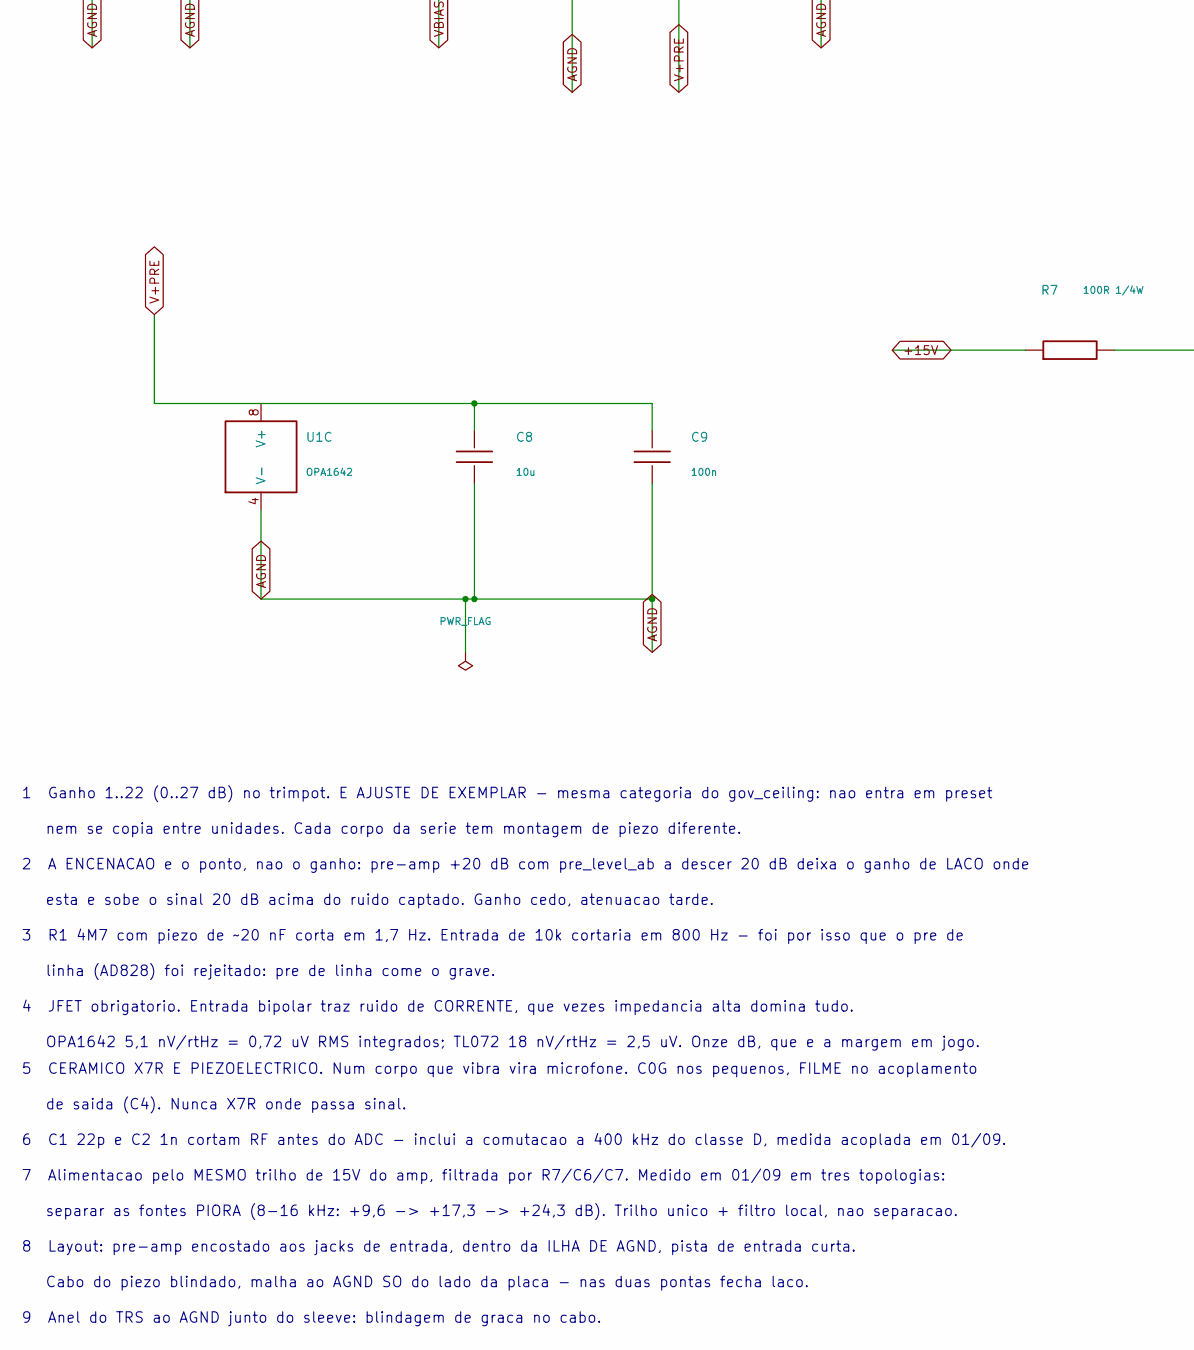
[picture p7: schematic cotuca_preamp.kicad_sch, part in row 2, column 1]

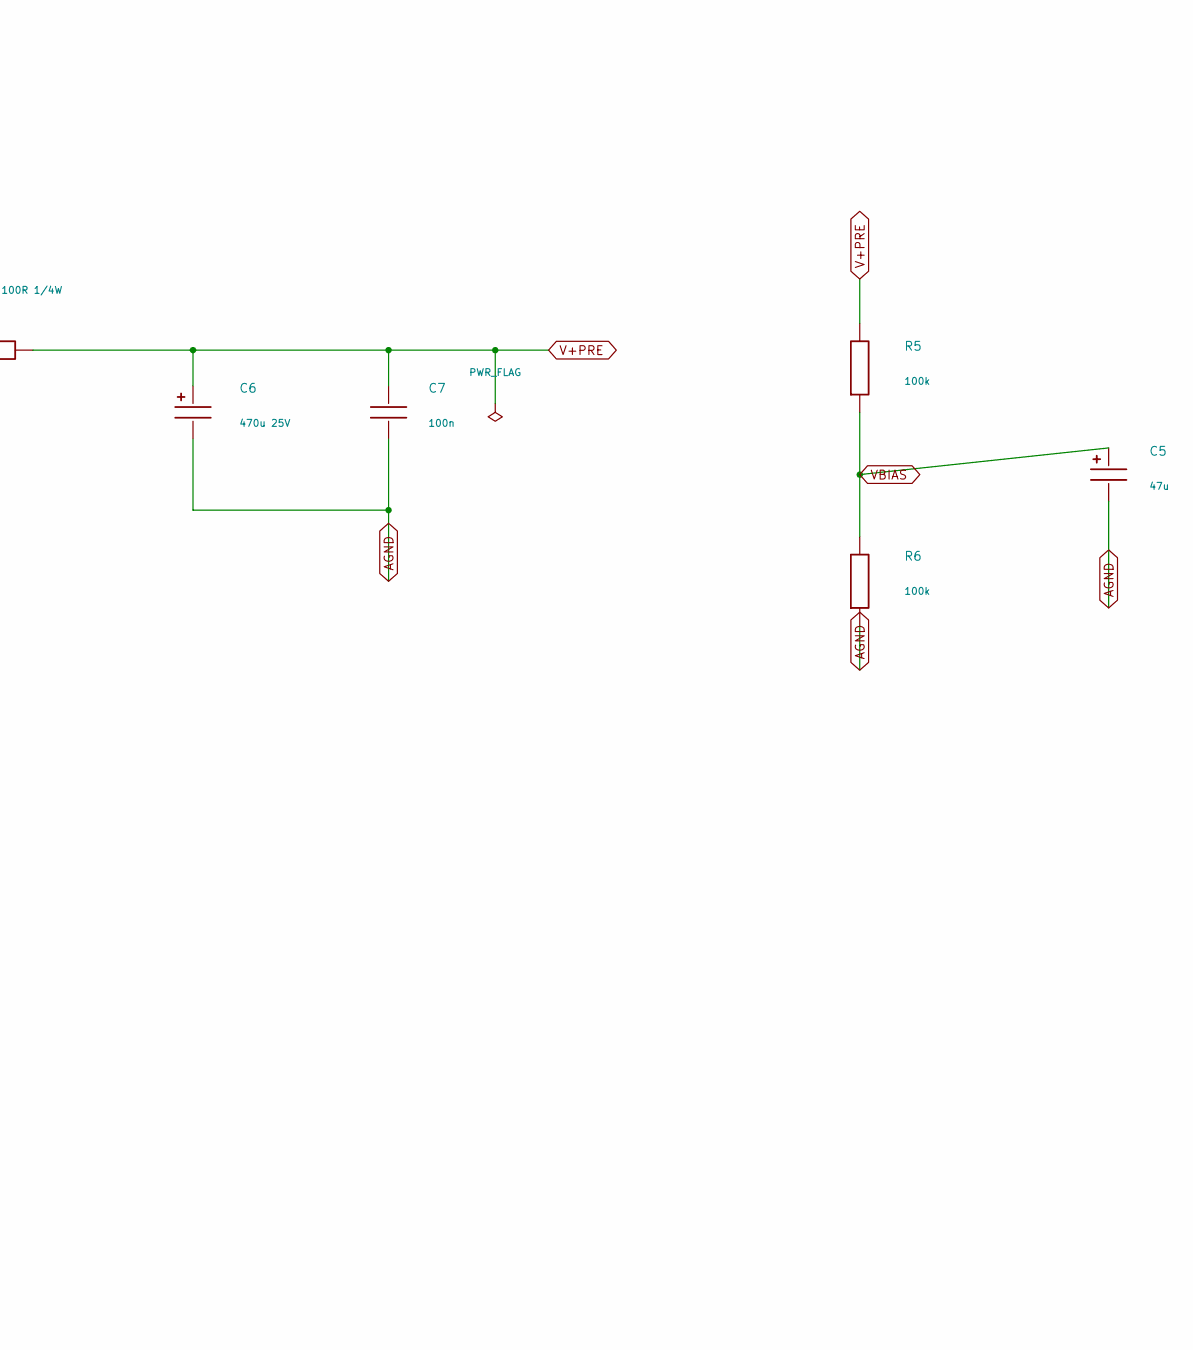
[picture p8: schematic cotuca_preamp.kicad_sch, part in row 2, column 2]

Parts:
C5: 47u; CP_Radial_D6.3mm_P2.50mm; MPN EEU-FR1E470
C6: 470u 25V; CP_Radial_D10.0mm_P5.00mm; MPN EEU-FR1E471
C7, C9: 100n; C_0805_2012Metric
C8: 10u; C_1206_3216Metric; MPN CL31B106KAHNNWE
C11, C21: 22p C0G; C_0805_2012Metric; not fitted
C12, C22: 22n C0G; C_1206_3216Metric; MPN C1206C223J5GACTU
C13, C23: 22u NP; CP_Radial_D6.3mm_P2.50mm; MPN UES1H220MEM; not fitted
C14, C24: 2u2 filme; C_Rect_L7.2mm_W11.0mm_P5.00mm_FKS2_FKP2_MKS2_MKP2; MPN MKS2C042201M00KN00
D11, D21: BAV99; SOT-23; MPN BAV99,215
J5: fio -> jack piezo J5; PinHeader_1x03_P2.54mm_Vertical; MPN 61304011121
J6: fio -> jack piezo J6; PinHeader_1x03_P2.54mm_Vertical; MPN 61304011121
R5, R6: 100k; R_0805_2012Metric
R7: 100R 1/4W; R_1206_3216Metric
R10, R20: 0R; R_0805_2012Metric
R11, R21: 4M7; R_0805_2012Metric
R12, R22: 1k; R_0805_2012Metric
R13, R23: 4k7; R_0805_2012Metric; not fitted
R14, R24: 100R; R_0805_2012Metric
RV1, RV2: trim 100k; Potentiometer_Bourns_3296W_Vertical; MPN 3296W-1-104LF; not fitted
U1: OPA1642; SOIC-8_3.9x4.9mm_P1.27mm; MPN OPA1642AIDR

Connections:
+15V: R7.1; also elsewhere on the board
AGND: C5.2, C6.2, C7.2, C8.2, C9.2, C12.2, C22.2, D11.1, D21.1, J5.2, J5.3, J6.2, J6.3, R6.2, U1.4 (V-); also elsewhere on the board
AUDIO_IN_L: C14.2; also elsewhere on the board
AUDIO_IN_R: C24.2; also elsewhere on the board
unnamed: C11.2, R10.2, R14.1, RV1.2, RV1.3, U1.1
unnamed: C13.2, R13.1
unnamed: C14.1, R14.2
unnamed: C21.2, R20.2, R24.1, RV2.2, RV2.3, U1.7
unnamed: C23.2, R23.1
unnamed: C24.1, R24.2
unnamed: J5.1, R12.1
unnamed: J6.1, R22.1
unnamed: C12.1, D11.3, R11.1, R12.2, U1.3 (+)
unnamed: C11.1, R10.1, R13.2, RV1.1, U1.2 (-)
unnamed: C22.1, D21.3, R21.1, R22.2, U1.5 (+)
unnamed: C21.1, R20.1, R23.2, RV2.1, U1.6 (-)
V+PRE: C6.1, C7.1, C8.1, C9.1, D11.2, D21.2, R5.1, R7.2, U1.8 (V+); also elsewhere on the board
VBIAS: C5.1, C13.1, C23.1, R5.2, R6.1, R11.2, R21.2; also elsewhere on the board

Notes on the sheet:
9 Anel do TRS ao AGND junto do sleeve: blindagem de graca no cabo.
separar as fontes PIORA (8-16 kHz: +9,6 -> +17,3 -> +24,3 dB). Trilho unico + filtro local, nao separacao.
esta e sobe o sinal 20 dB acima do ruido captado. Ganho cedo, atenuacao tarde.
2 A ENCENACAO e o ponto, nao o ganho: pre-amp +20 dB com pre_level_ab a descer 20 dB deixa o ganho de LACO onde
6 C1 22p e C2 1n cortam RF antes do ADC - inclui a comutacao a 400 kHz do classe D, medida acoplada em 01/09.
CANAL B
3 R1 4M7 com piezo de ~20 nF corta em 1,7 Hz. Entrada de 10k cortaria em 800 Hz - foi por isso que o pre de
nem se copia entre unidades. Cada corpo da serie tem montagem de piezo diferente.
de saida (C4). Nunca X7R onde passa sinal.
8 Layout: pre-amp encostado aos jacks de entrada, dentro da ILHA DE AGND, pista de entrada curta.
7 Alimentacao pelo MESMO trilho de 15V do amp, filtrada por R7/C6/C7. Medido em 01/09 em tres topologias:
PRE-AMP DE PIEZO - Cotucatronics carrier rev B
Cabo do piezo blindado, malha ao AGND SO do lado da placa - nas duas pontas fecha laco.
linha (AD828) foi rejeitado: pre de linha come o grave.
OPA1642 5,1 nV/rtHz = 0,72 uV RMS integrados; TL072 18 nV/rtHz = 2,5 uV. Onze dB, que e a margem em jogo.
CANAL A
4 JFET obrigatorio. Entrada bipolar traz ruido de CORRENTE, que vezes impedancia alta domina tudo.
1 Ganho 1..22 (0..27 dB) no trimpot. E AJUSTE DE EXEMPLAR - mesma categoria do gov_ceiling: nao entra em preset
5 CERAMICO X7R E PIEZOELECTRICO. Num corpo que vibra vira microfone. C0G nos pequenos, FILME no acoplamento

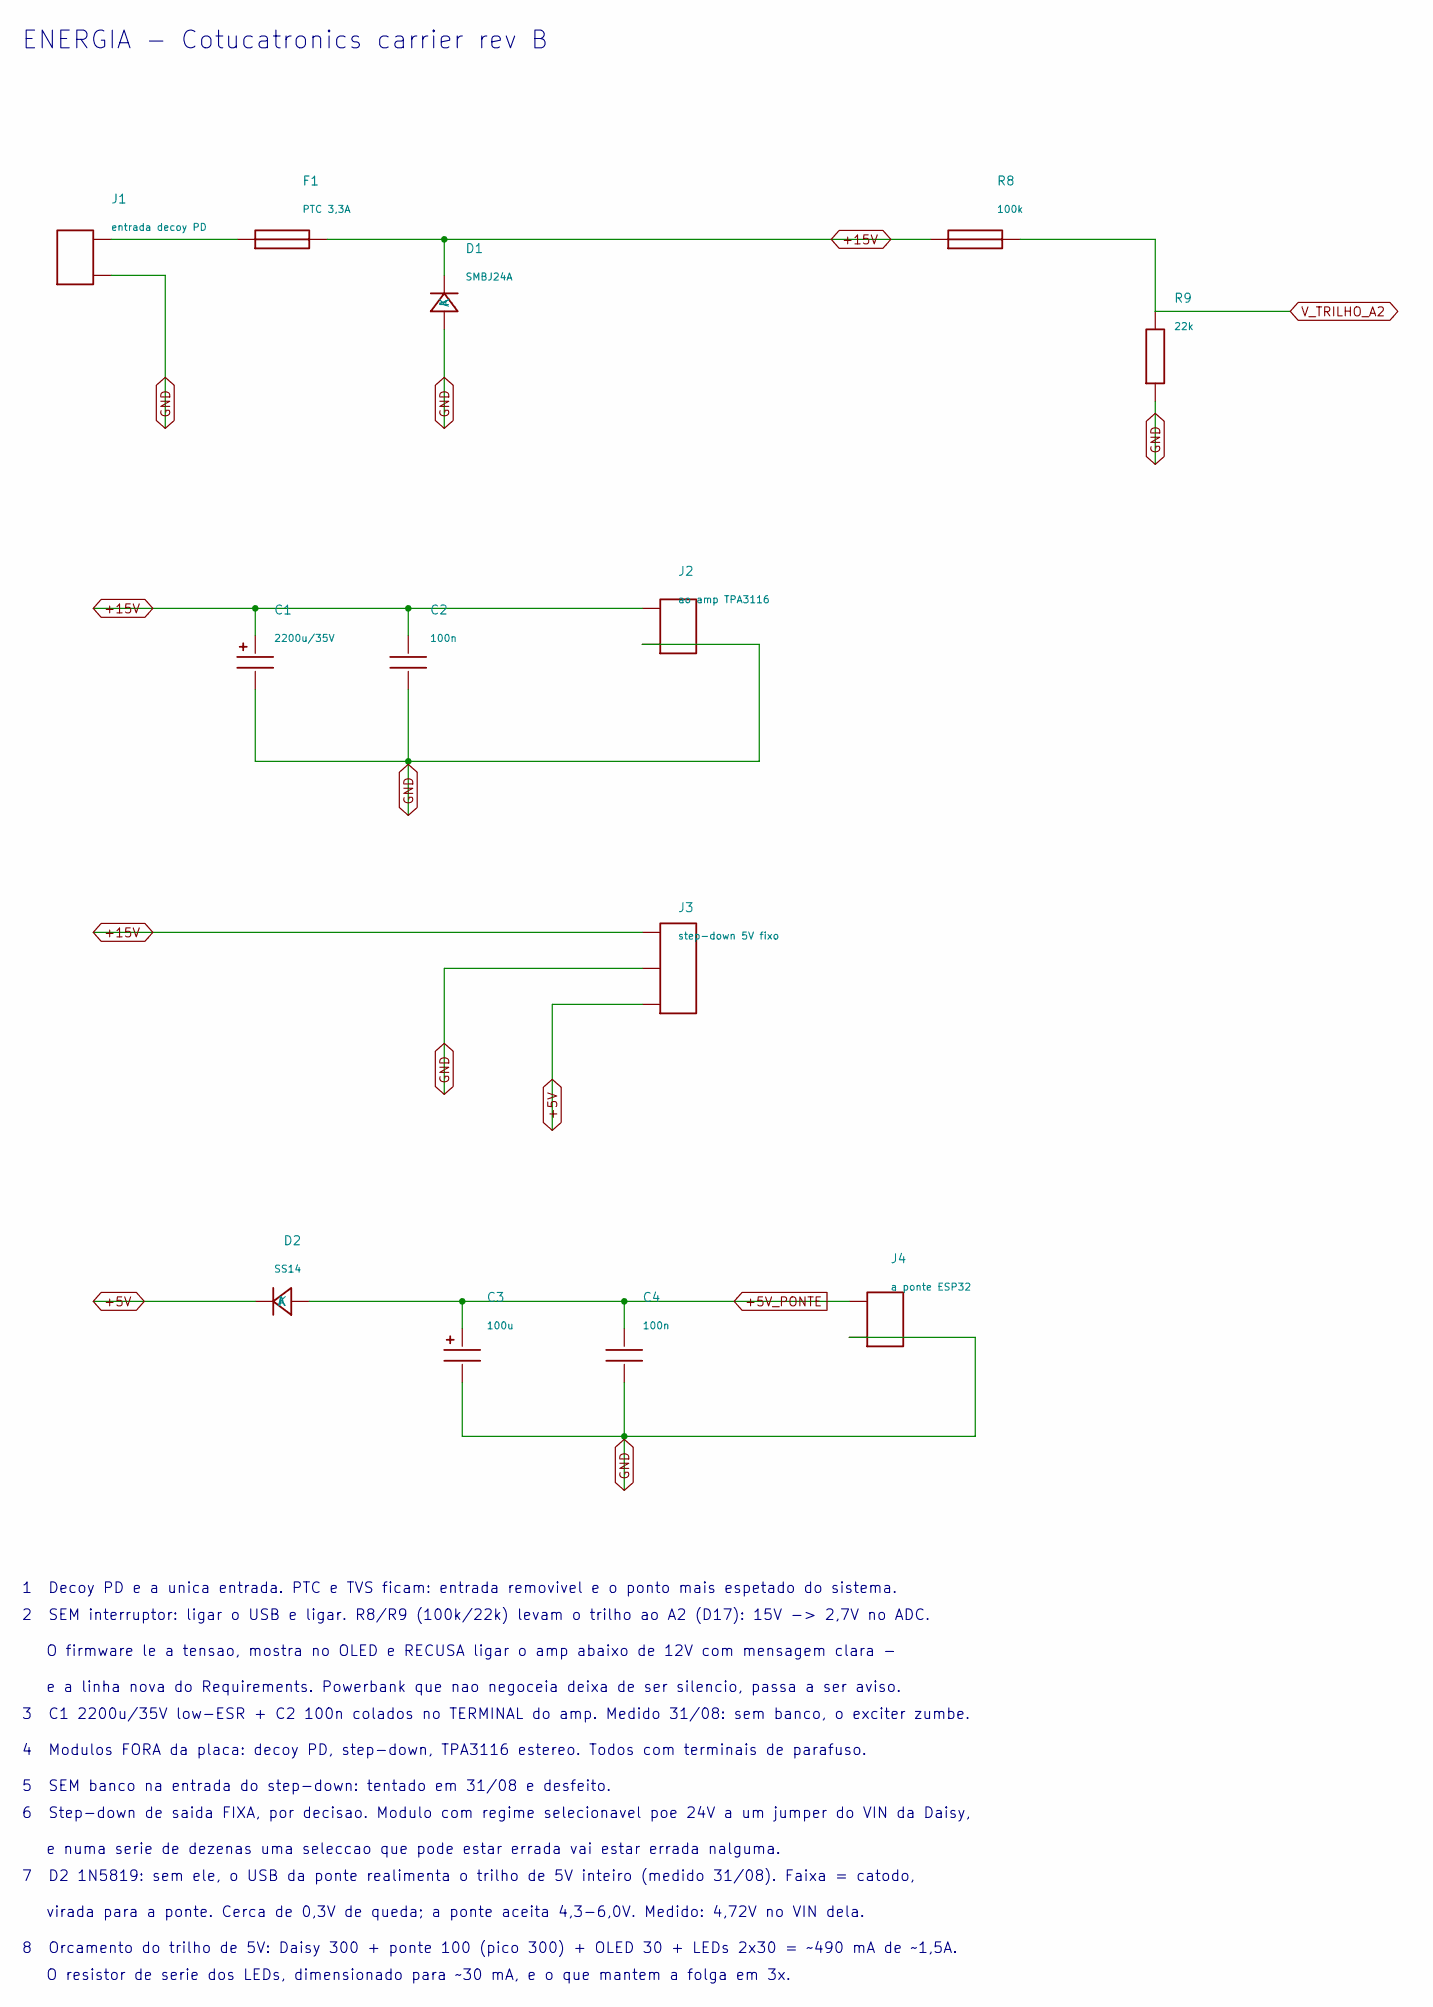
[picture p9: schematic cotuca_energia.kicad_sch]

Parts:
C1: 2200u/35V; CP_Radial_D16.0mm_P7.50mm; MPN EEU-FR1V222
C2, C4: 100n; C_0805_2012Metric
C3: 100u; CP_Radial_D6.3mm_P2.50mm; MPN EEU-FR1C101
D1: SMBJ24A; D_SMB; MPN SMBJ24A
D2: SS14; D_SMA; MPN SS14
F1: PTC 3,3A; Fuse_2920_7451Metric; MPN MF-LSMF300/24X-2
J1: entrada decoy PD; TerminalBlock_Phoenix_MKDS-1,5-2-5.08_1x02_P5.08mm_Horizont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; MPN 1715721
J2: ao amp TPA3116; TerminalBlock_Phoenix_MKDS-1,5-2-5.08_1x02_P5.08mm_Horizont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; MPN 1715721
J3: step-down 5V fixo; PinHeader_1x03_P2.54mm_Vertical; MPN 61304011121
J4: a ponte ESP32; PinHeader_1x02_P2.54mm_Vertical; MPN 61304011121
R8: 100k; R_0805_2012Metric
R9: 22k; R_0805_2012Metric

Connections:
+5V: D2.2 (A), J3.3; also elsewhere on the board
+5V_PONTE: C3.1, C4.1, D2.1 (K), J4.1; also elsewhere on the board
+15V: C1.1, C2.1, D1.1 (K), F1.2, J2.1, J3.1, R8.1; also elsewhere on the board
GND: C1.2, C2.2, C3.2, C4.2, D1.2 (A), J1.2, J2.2, J3.2, J4.2, R9.2; also elsewhere on the board
unnamed: F1.1, J1.1
V_TRILHO_A2: R8.2, R9.1; also elsewhere on the board

Notes on the sheet:
3 C1 2200u/35V low-ESR + C2 100n colados no TERMINAL do amp. Medido 31/08: sem banco, o exciter zumbe.
virada para a ponte. Cerca de 0,3V de queda; a ponte aceita 4,3-6,0V. Medido: 4,72V no VIN dela.
6 Step-down de saida FIXA, por decisao. Modulo com regime selecionavel poe 24V a um jumper do VIN da Daisy,
e numa serie de dezenas uma seleccao que pode estar errada vai estar errada nalguma.
O firmware le a tensao, mostra no OLED e RECUSA ligar o amp abaixo de 12V com mensagem clara -
5 SEM banco na entrada do step-down: tentado em 31/08 e desfeito.
8 Orcamento do trilho de 5V: Daisy 300 + ponte 100 (pico 300) + OLED 30 + LEDs 2x30 = ~490 mA de ~1,5A.
e a linha nova do Requirements. Powerbank que nao negoceia deixa de ser silencio, passa a ser aviso.
1 Decoy PD e a unica entrada. PTC e TVS ficam: entrada removivel e o ponto mais espetado do sistema.
2 SEM interruptor: ligar o USB e ligar. R8/R9 (100k/22k) levam o trilho ao A2 (D17): 15V -> 2,7V no ADC.
7 D2 1N5819: sem ele, o USB da ponte realimenta o trilho de 5V inteiro (medido 31/08). Faixa = catodo,
4 Modulos FORA da placa: decoy PD, step-down, TPA3116 estereo. Todos com terminais de parafuso.
ENERGIA - Cotucatronics carrier rev B
O resistor de serie dos LEDs, dimensionado para ~30 mA, e o que mantem a folga em 3x.

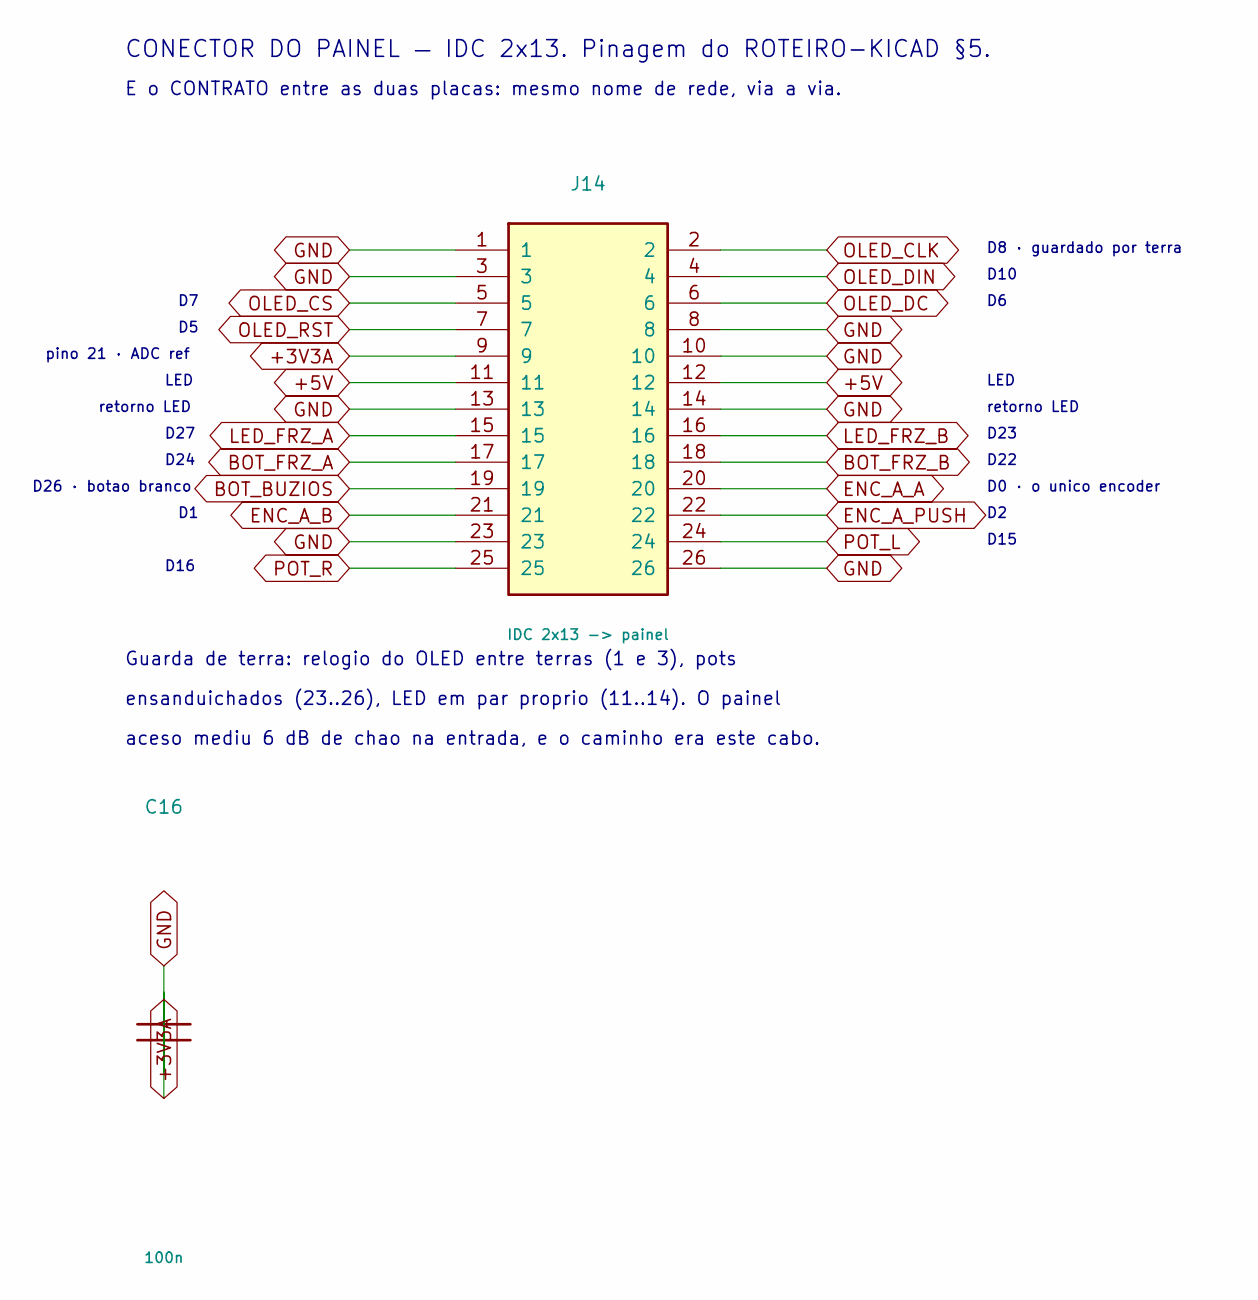
[picture p10: schematic cotuca_conector.kicad_sch, CONECTOR DO PAINEL — IDC 2x13 — carrier rev B]

Parts:
C16: 100n; C_0805_2012Metric
J14: IDC 2x13 -> painel; IDC-Header_2x13_P2.54mm_Vertical; MPN 61202621621

Connections:
+3V3A: C16.1, J14.9; also elsewhere on the board
+5V: J14.11, J14.12; also elsewhere on the board
BOT_BUZIOS: J14.19; also elsewhere on the board
BOT_FRZ_A: J14.17; also elsewhere on the board
BOT_FRZ_B: J14.18; also elsewhere on the board
ENC_A_A: J14.20; also elsewhere on the board
ENC_A_B: J14.21; also elsewhere on the board
ENC_A_PUSH: J14.22; also elsewhere on the board
GND: C16.2, J14.1, J14.3, J14.8, J14.10, J14.13, J14.14, J14.23, J14.26; also elsewhere on the board
LED_FRZ_A: J14.15; also elsewhere on the board
LED_FRZ_B: J14.16; also elsewhere on the board
OLED_CLK: J14.2; also elsewhere on the board
OLED_CS: J14.5; also elsewhere on the board
OLED_DC: J14.6; also elsewhere on the board
OLED_DIN: J14.4; also elsewhere on the board
OLED_RST: J14.7; also elsewhere on the board
POT_L: J14.24; also elsewhere on the board
POT_R: J14.25; also elsewhere on the board

Notes on the sheet:
D8 · guardado por terra
D10
pino 21 · ADC ref
LED
retorno LED
D27
D23
D24
D22
D26 · botao branco
D0 · o unico encoder
D15
D16
CONECTOR DO PAINEL — IDC 2x13. Pinagem do ROTEIRO-KICAD §5.
E o CONTRATO entre as duas placas: mesmo nome de rede, via a via.
Guarda de terra: relogio do OLED entre terras (1 e 3), pots
ensanduichados (23..26), LED em par proprio (11..14). O painel
aceso mediu 6 dB de chao na entrada, e o caminho era este cabo.

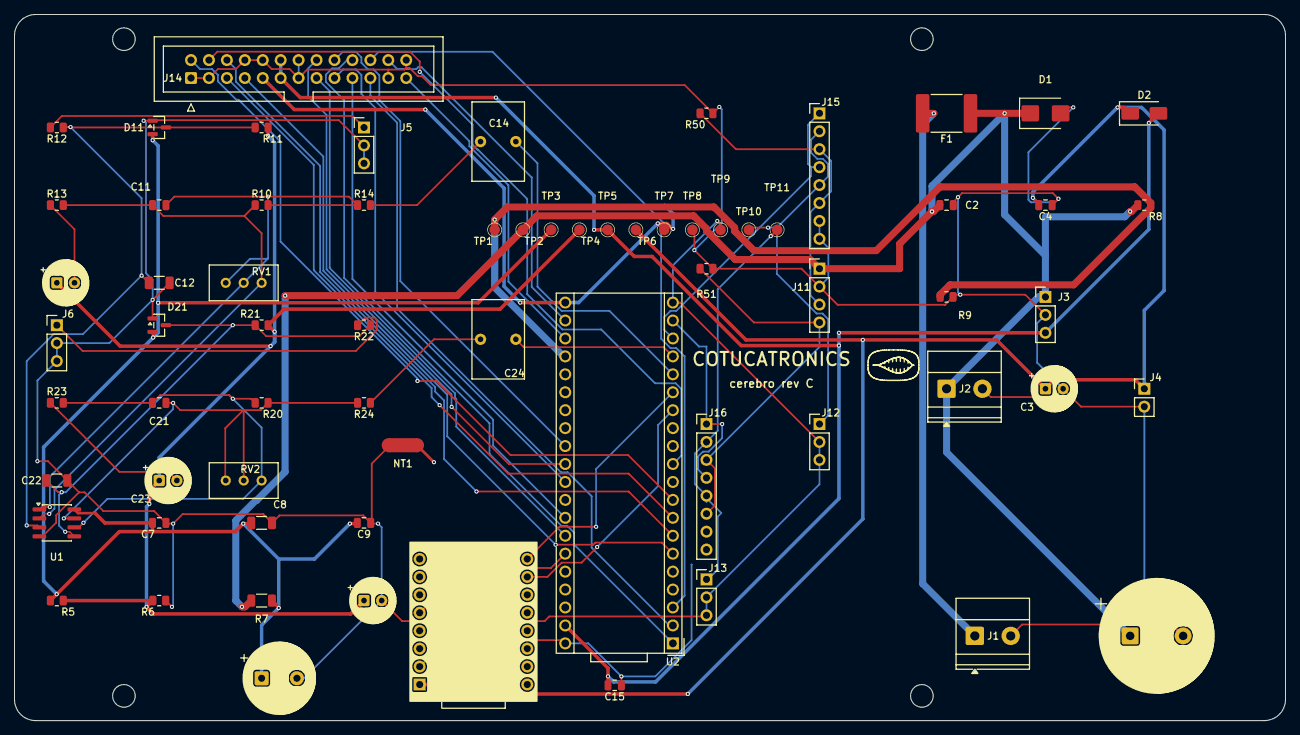
[picture p11: board cotuca_cerebro.kicad_pcb from above]

Board: 2 copper layers, 180.0 x 100.0 mm, 74 parts (1 on the bottom side), 48 nets.

Other parts of the board:
H1, H2, H3, H4: MountingHole_3.2mm_M3
