Belquer/Cotucatronics/kicad/cotuca_painel/cotuca_painel.kicad_pcb

## KiCad design kicad/cotuca_painel/cotuca_painel.kicad_pcb (2026-09-17)

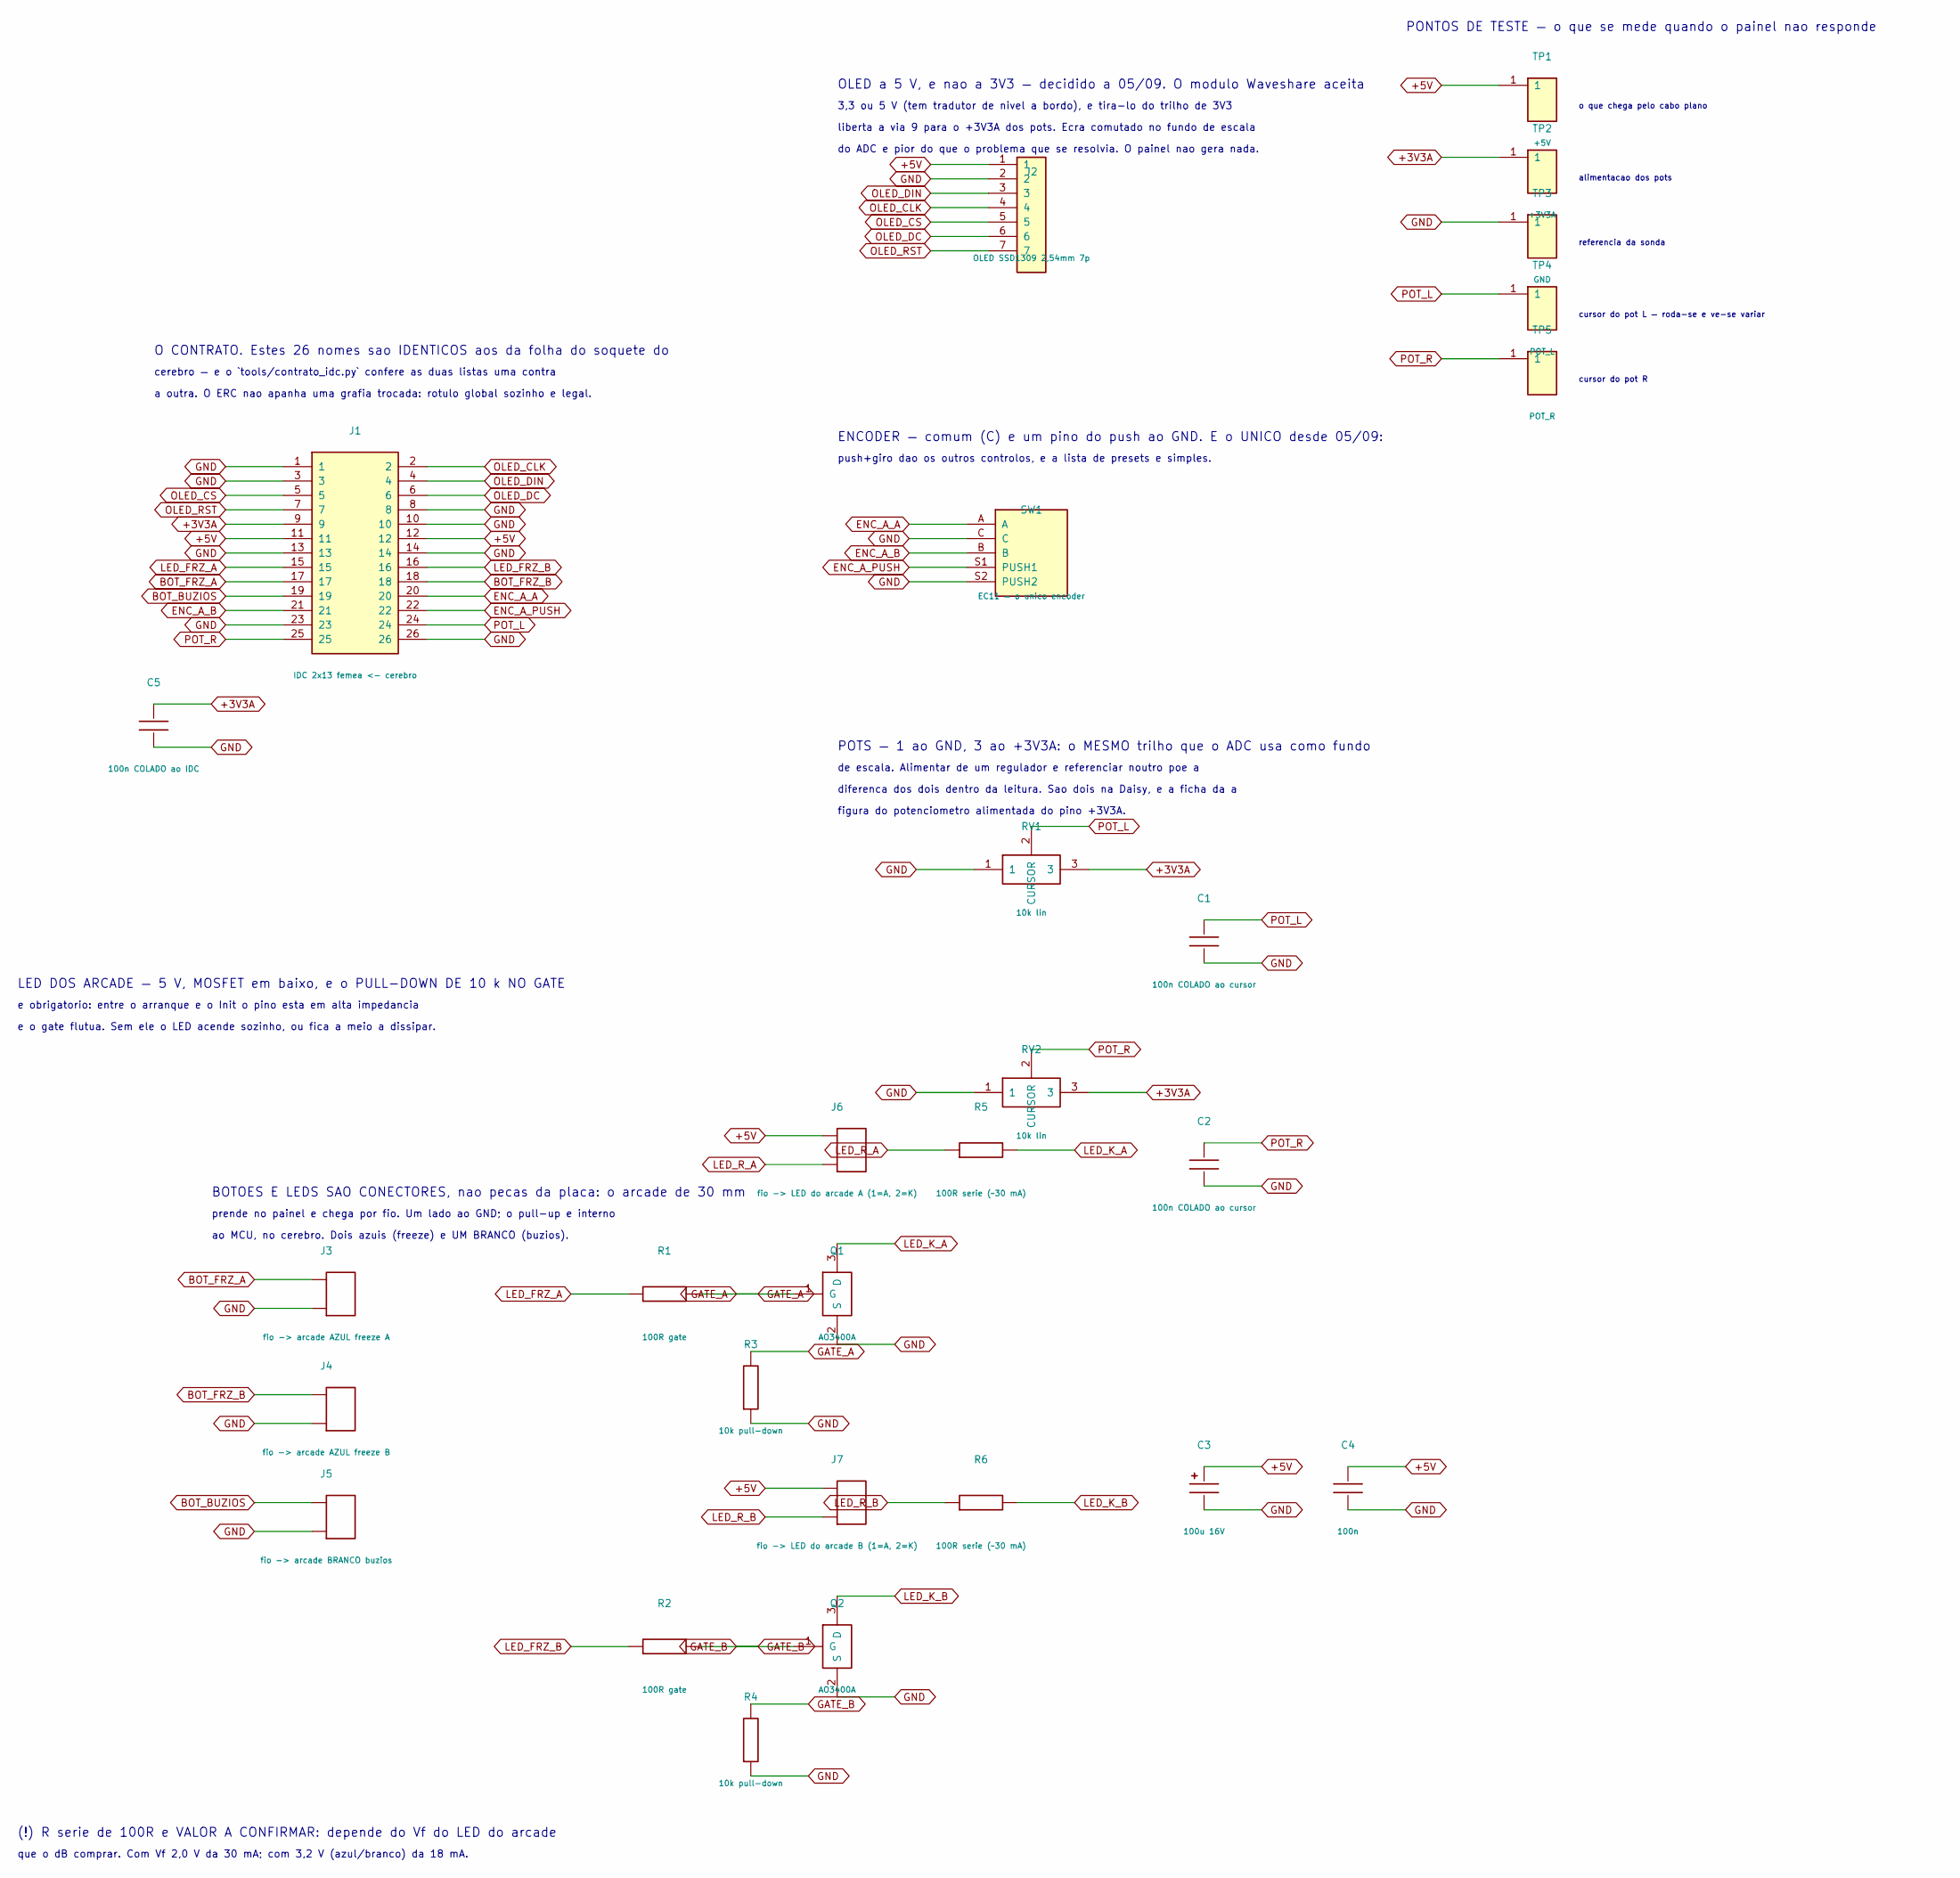
[picture p12: schematic cotuca_painel.kicad_sch, PAINEL — tampa da caixa — rev C1]

Parts:
C1, C2: 100n COLADO ao cursor; C_0805_2012Metric
C3: 100u 16V; CP_Radial_D6.3mm_P2.50mm; MPN EEU-FR1C101
C4: 100n; C_0805_2012Metric
C5: 100n COLADO ao IDC; C_0805_2012Metric
J1: IDC 2x13 femea <- cerebro; IDC-Header_2x13_P2.54mm_Vertical; MPN 61202621621
J2: OLED SSD1309 2,54mm 7p; PinHeader_1x07_P2.54mm_Vertical; MPN 53047-0710
J3: fio -> arcade AZUL freeze A; JST_XH_B2B-XH-A_1x02_P2.50mm_Vertical; MPN B2B-XH-A
J4: fio -> arcade AZUL freeze B; JST_XH_B2B-XH-A_1x02_P2.50mm_Vertical; MPN B2B-XH-A
J5: fio -> arcade BRANCO buzios; JST_XH_B2B-XH-A_1x02_P2.50mm_Vertical; MPN B2B-XH-A
J6: fio -> LED do arcade A (1=A, 2=K); JST_XH_B2B-XH-A_1x02_P2.50mm_Vertical; MPN B2B-XH-A
J7: fio -> LED do arcade B (1=A, 2=K); JST_XH_B2B-XH-A_1x02_P2.50mm_Vertical; MPN B2B-XH-A
Q1, Q2: AO3400A; SOT-23; MPN SI2302CDS-T1-GE3
R1, R2: 100R gate; R_0805_2012Metric
R3, R4: 10k pull-down; R_0805_2012Metric
R5, R6: 100R serie (~30 mA); R_1210_3225Metric
RV1, RV2: 10k lin; Potentiometer_Bourns_PTV09A-1_Single_Vertical; MPN PTV09A-1020S-B103
SW1: EC11 — o unico encoder; RotaryEncoder_Alps_EC11E-Switch_Vertical_H20mm; MPN EC11E15244G1
TP1: +5V; TestPoint_Pad_D1.5mm
TP2: +3V3A; TestPoint_Pad_D1.5mm
TP3: GND; TestPoint_Pad_D1.5mm
TP4: POT_L; TestPoint_Pad_D1.5mm
TP5: POT_R; TestPoint_Pad_D1.5mm

Connections:
+3V3A: C5.1, J1.9, RV1.3, RV2.3, TP2.1
+5V: C3.1, C4.1, J1.11, J1.12, J2.1, J6.1, J7.1, TP1.1
BOT_BUZIOS: J1.19, J5.1
BOT_FRZ_A: J1.17, J3.1
BOT_FRZ_B: J1.18, J4.1
ENC_A_A: J1.20, SW1.A
ENC_A_B: J1.21, SW1.B
ENC_A_PUSH: J1.22, SW1.S1 (PUSH1)
GATE_A: Q1.1 (G), R1.2, R3.1
GATE_B: Q2.1 (G), R2.2, R4.1
GND: C1.2, C2.2, C3.2, C4.2, C5.2, J1.1, J1.3, J1.8, J1.10, J1.13, J1.14, J1.23, J1.26, J2.2, J3.2, J4.2, J5.2, Q1.2 (S), Q2.2 (S), R3.2, R4.2, RV1.1, RV2.1, SW1.C, SW1.S2 (PUSH2), TP3.1
LED_FRZ_A: J1.15, R1.1
LED_FRZ_B: J1.16, R2.1
LED_K_A: Q1.3 (D), R5.2
LED_K_B: Q2.3 (D), R6.2
LED_R_A: J6.2, R5.1
LED_R_B: J7.2, R6.1
OLED_CLK: J1.2, J2.4
OLED_CS: J1.5, J2.5
OLED_DC: J1.6, J2.6
OLED_DIN: J1.4, J2.3
OLED_RST: J1.7, J2.7
POT_L: C1.1, J1.24, RV1.2 (CURSOR), TP4.1
POT_R: C2.1, J1.25, RV2.2 (CURSOR), TP5.1

Notes on the sheet:
O CONTRATO. Estes 26 nomes sao IDENTICOS aos da folha do soquete do
cerebro — e o `tools/contrato_idc.py` confere as duas listas uma contra
a outra. O ERC nao apanha uma grafia trocada: rotulo global sozinho e legal.
OLED a 5 V, e nao a 3V3 — decidido a 05/09. O modulo Waveshare aceita
3,3 ou 5 V (tem tradutor de nivel a bordo), e tira-lo do trilho de 3V3
liberta a via 9 para o +3V3A dos pots. Ecra comutado no fundo de escala
do ADC e pior do que o problema que se resolvia. O painel nao gera nada.
ENCODER — comum (C) e um pino do push ao GND. E o UNICO desde 05/09:
push+giro dao os outros controlos, e a lista de presets e simples.
POTS — 1 ao GND, 3 ao +3V3A: o MESMO trilho que o ADC usa como fundo
de escala. Alimentar de um regulador e referenciar noutro poe a
diferenca dos dois dentro da leitura. Sao dois na Daisy, e a ficha da a
figura do potenciometro alimentada do pino +3V3A.
BOTOES E LEDS SAO CONECTORES, nao pecas da placa: o arcade de 30 mm
prende no painel e chega por fio. Um lado ao GND; o pull-up e interno
ao MCU, no cerebro. Dois azuis (freeze) e UM BRANCO (buzios).
LED DOS ARCADE — 5 V, MOSFET em baixo, e o PULL-DOWN DE 10 k NO GATE
e obrigatorio: entre o arranque e o Init o pino esta em alta impedancia
e o gate flutua. Sem ele o LED acende sozinho, ou fica a meio a dissipar.
(!) R serie de 100R e VALOR A CONFIRMAR: depende do Vf do LED do arcade
que o dB comprar. Com Vf 2,0 V da 30 mA; com 3,2 V (azul/branco) da 18 mA.
o que chega pelo cabo plano
alimentacao dos pots
referencia da sonda
cursor do pot L — roda-se e ve-se variar
cursor do pot R
PONTOS DE TESTE — o que se mede quando o painel nao responde

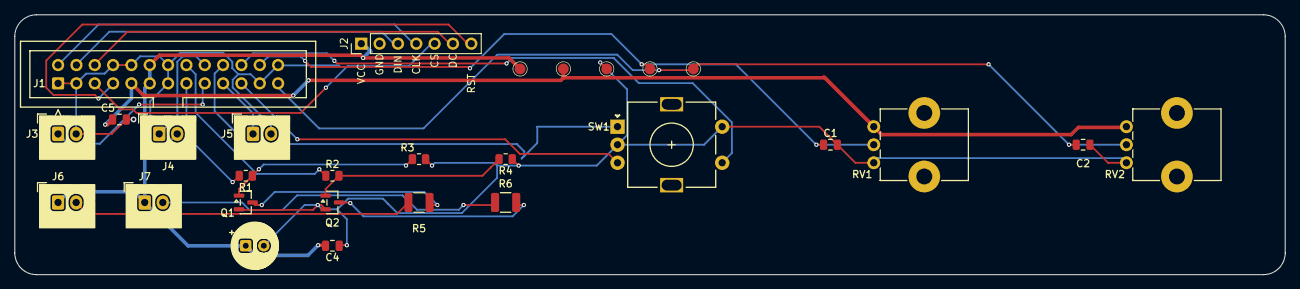
[picture p13: board cotuca_painel.kicad_pcb from above]

Board: 2 copper layers, 176.0 x 36.0 mm, 28 parts (0 on the bottom side), 24 nets.
