Belquer/Cotucatronics/docs/operacao/esquematicos/revB/cotuca_energia.kicad_sch

## KiCad design docs/operacao/esquematicos/revB/cotuca_energia.kicad_sch (2026-09-04)

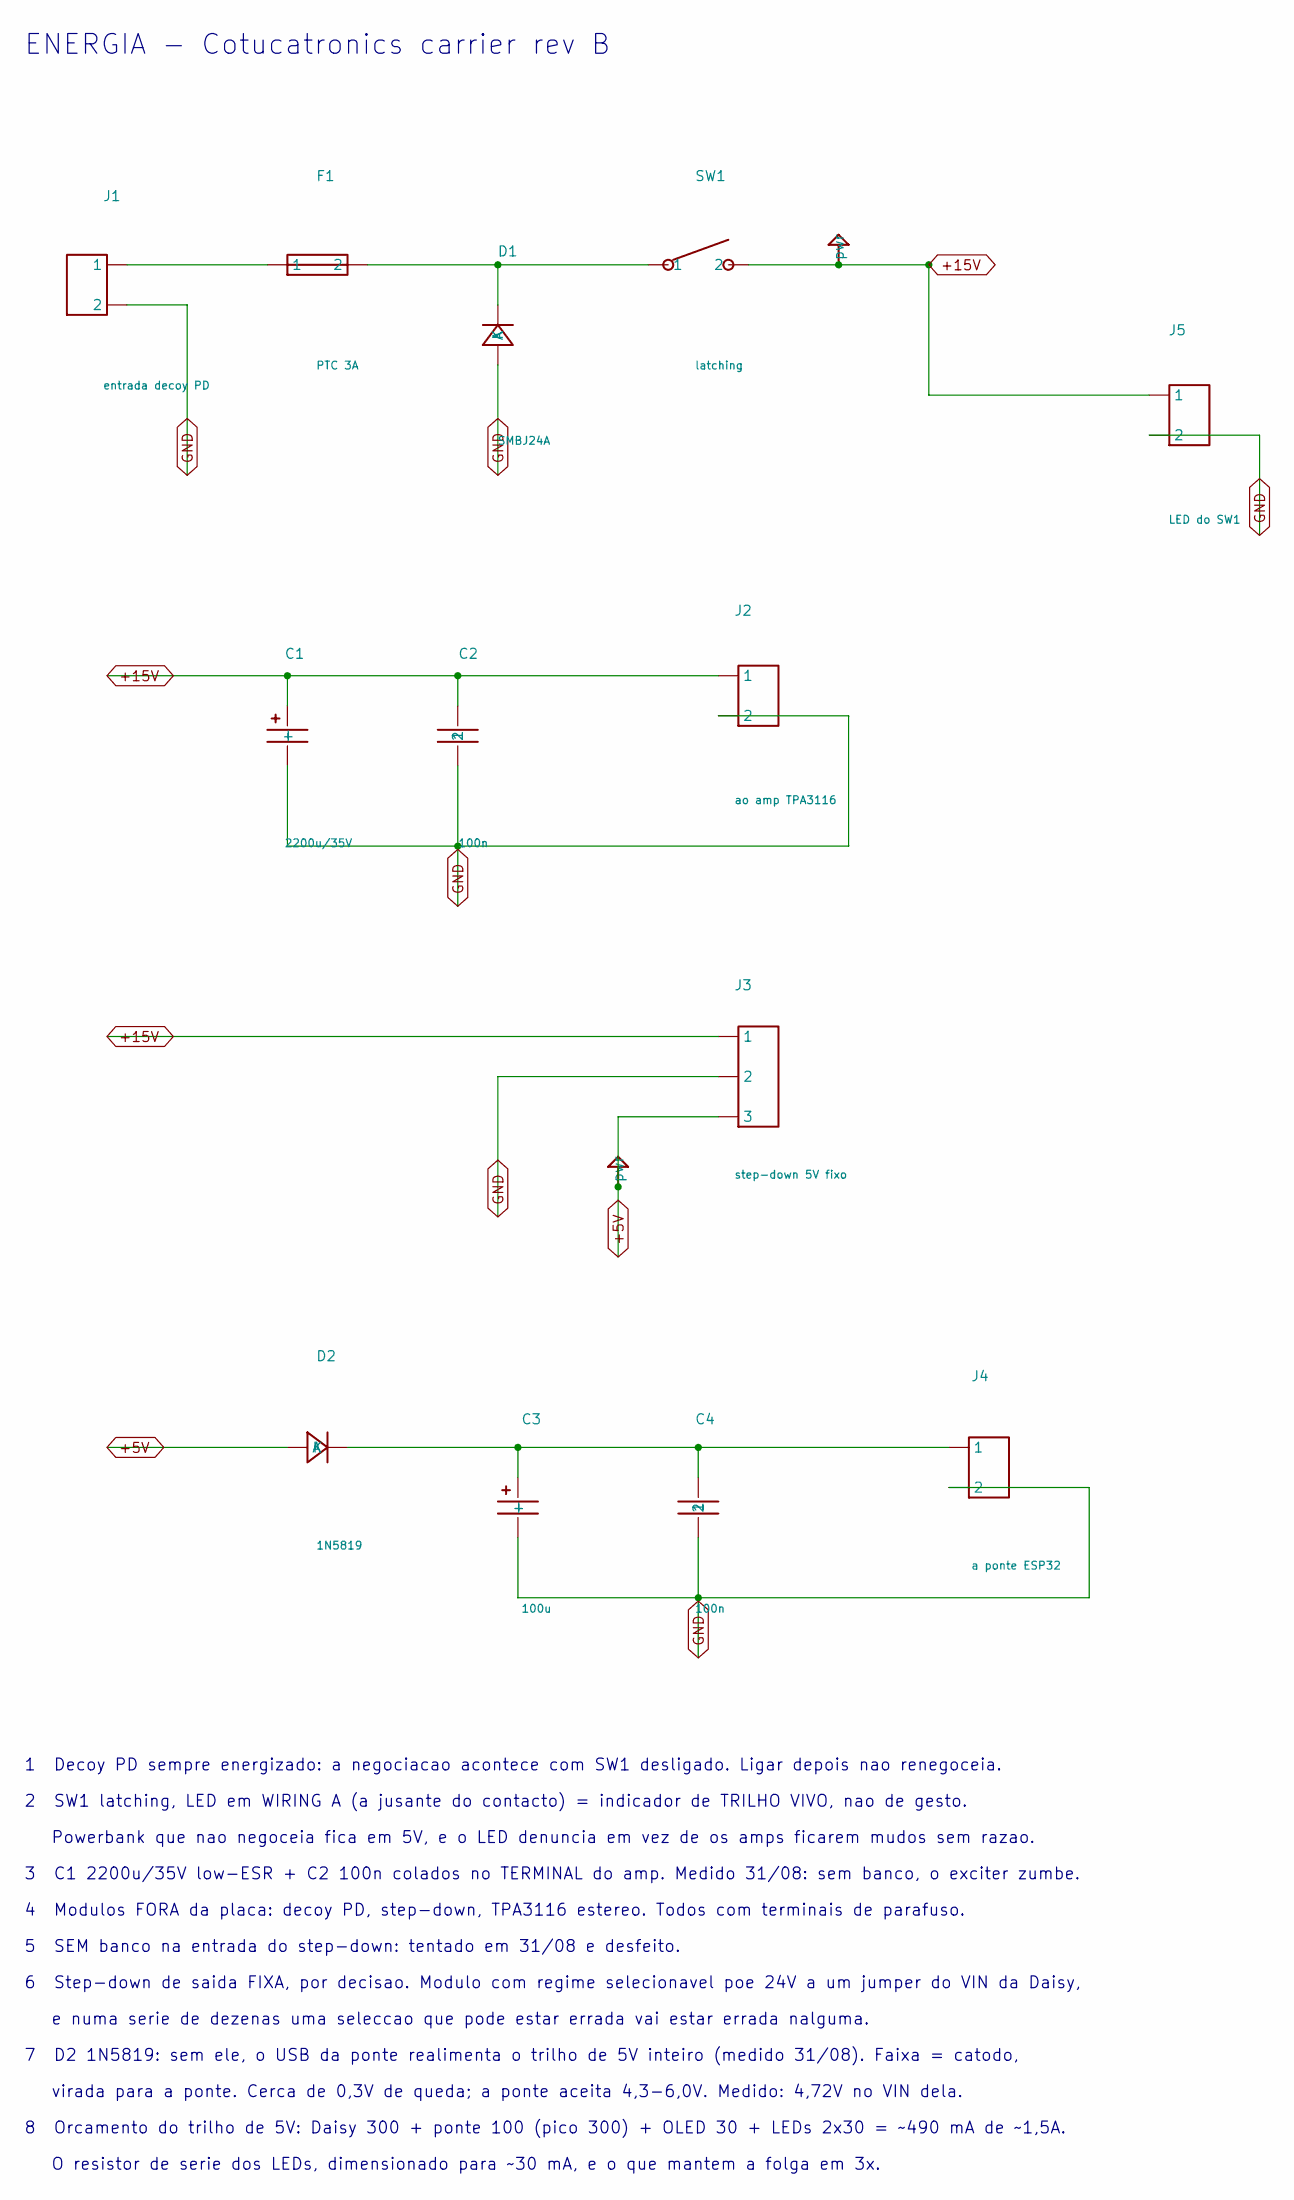
[picture p14: schematic cotuca_energia.kicad_sch]

Parts:
C1: 2200u/35V
C2, C4: 100n
C3: 100u
D1: SMBJ24A
D2: 1N5819
F1: PTC 3A
J1: entrada decoy PD
J2: ao amp TPA3116
J3: step-down 5V fixo
J4: a ponte ESP32
J5: LED do SW1
SW1: latching

Connections:
+5V: D2.1 (A), J3.3
+15V: C1.1 (+), C2.1, J2.1, J3.1, J5.1, SW1.2
GND: C1.2 (-), C2.2, C3.2 (-), C4.2, D1.2 (A), J1.2, J2.2, J3.2, J4.2, J5.2
unnamed: C3.1 (+), C4.1, D2.2 (K), J4.1
unnamed: D1.1 (K), F1.2, SW1.1
unnamed: F1.1, J1.1

Notes on the sheet:
7 D2 1N5819: sem ele, o USB da ponte realimenta o trilho de 5V inteiro (medido 31/08). Faixa = catodo,
Powerbank que nao negoceia fica em 5V, e o LED denuncia em vez de os amps ficarem mudos sem razao.
6 Step-down de saida FIXA, por decisao. Modulo com regime selecionavel poe 24V a um jumper do VIN da Daisy,
1 Decoy PD sempre energizado: a negociacao acontece com SW1 desligado. Ligar depois nao renegoceia.
3 C1 2200u/35V low-ESR + C2 100n colados no TERMINAL do amp. Medido 31/08: sem banco, o exciter zumbe.
4 Modulos FORA da placa: decoy PD, step-down, TPA3116 estereo. Todos com terminais de parafuso.
5 SEM banco na entrada do step-down: tentado em 31/08 e desfeito.
e numa serie de dezenas uma seleccao que pode estar errada vai estar errada nalguma.
virada para a ponte. Cerca de 0,3V de queda; a ponte aceita 4,3-6,0V. Medido: 4,72V no VIN dela.
2 SW1 latching, LED em WIRING A (a jusante do contacto) = indicador de TRILHO VIVO, nao de gesto.
O resistor de serie dos LEDs, dimensionado para ~30 mA, e o que mantem a folga em 3x.
ENERGIA - Cotucatronics carrier rev B
8 Orcamento do trilho de 5V: Daisy 300 + ponte 100 (pico 300) + OLED 30 + LEDs 2x30 = ~490 mA de ~1,5A.
