Belquer/Cotucatronics/src/main.cpp

// ============================================================
// Cotucatronics OS — esqueleto board-agnostic.
//
// A VERSAO MORA SO EM `COTUCA_OS_VERSION`, logo abaixo, e em lugar
// nenhum mais. Este cabecalho ja carregou um `v0.125.0` proprio que
// ficou quatro versoes para tras sem ninguem notar — porque ele nunca
// era impresso, e numero que ninguem le nao tem quem o corrija.
// Segunda fonte de verdade e deriva com data marcada.
// Este arquivo NÃO sabe qual placa é o cérebro, nem qual motor de
// DSP está rodando: fala com `Module`, não com o motor.
// Compile com: make BOARD=daisy_seed
// ============================================================

#define COTUCA_OS_VERSION "0.329.0"

// A/B DA DUPLICACAO, NO MESMO BINARIO.
//
// Existe porque delta entre builds nao e atribuivel: medindo v0.130.0
// contra v0.131.0 o pico CAIU 23 us, e "duplicar dez params economiza
// 23 us" nao tem mecanismo nenhum. Layout de codigo, alinhamento e
// inlining mudam entre binarios e engolem qualquer efeito desta escala.
//
// Com a chave, os dois bracos rodam no MESMO binario: `dup on` le
// `p_x[c]` (uma entrada por cadeia), `dup off` le `p_x[0]` (as duas
// cadeias na mesma entrada, que e o comportamento anterior a v0.131.0).
//
// O `? :` esta nos DOIS bracos, entao o custo dele cancela — a
// diferenca medida e a diferenca de leitura, e mais nada. Roda uma vez
// por bloco por efeito, nao por amostra.
//
// MODO QUE ALTERA O INSTRUMENTO: com `dup off` a cadeia B soa com os
// valores da A. Por isso se declara em `board`, `list` e `cpu`.
static bool g_dup_por_cadeia = true;
static inline int CadeiaDoParam(int c) { return g_dup_por_cadeia ? c : 0; }

#include "hal.h"
#include "params.h"
#include "manifest.h"
#include "presets.h"
#include "dynamics.h"
#include "reverb.h"
#include "freeze.h"
#include "pitch.h"
#include "effect_slot.h"
#include "shimmer.h"
#include "drive.h"
#include "phaser.h"
#include "warble.h"
// detune.h NAO e incluido: o efeito saiu do build em 2026-08-20 (decisao de
// ouvido do dB — o warble ja cobre o territorio de modulacao de altura,
// e o detune custava 125 us, cinco vezes o phaser). O arquivo segue no
// repo, intacto e revivivel. Ver docs/FEATURES.md, secao Arquivo.
#include "suave.h"
#include "tarol.h"
#include "notch.h"
#include "splash.h"
#include "espectro.h"
#include "delay.h"
#include "qspi_raw.h"
#include "midi.h"
#include <cstdio>
#include <cstring>
#include <cstdlib>
#include <cmath>

static cotuca::ParamTable params;
static cotuca::Manifest   manifest;

// ============================================================
// DECISÃO DE ARQUITETURA — PRIORIDADE ENTRE FONTES DE CONTROLE
//
// Três fontes escrevem nos mesmos parâmetros: o painel falso do
// SERIAL, o MIDI, e o KNOB FÍSICO quando existir.
//
// >>> ÚLTIMA ESCRITA VENCE. Não há hierarquia. <<<
//
// As três são PARES. Nenhuma tem precedência sobre a outra, e nenhuma
// "trava" ou "solta" as demais. Quem mexeu por último definiu o valor,
// ponto — como acontece com duas mãos no mesmo knob.
//
// POR QUÊ, e por que isto não é preguiça:
//
// 1. Não existe fonte mais legítima. O serial é bancada, o MIDI vai
//    ser o pedal e o controlador do palco, o knob é a mão na
//    escultura. Eleger um vencedor fixo quebraria justamente o caso
//    de uso do outro — knob-vence-sempre tornaria o pedal decorativo,
//    MIDI-vence-sempre congelaria o painel no meio do show.
//
// 2. A alternativa séria seria "take-over": o knob físico só assume
//    quando o valor dele CRUZA o valor atual, pra não haver salto.
//    É o comportamento certo pra sintetizador com preset. Aqui não:
//    a escultura não tem cena salva, e take-over custa um parâmetro
//    que não obedece até você achar a posição — no palco isso é um
//    knob quebrado. Salto é honesto, silêncio não.
//
// 3. Toda fonte escreve NORMALIZADO na ParamTable, no mesmo ponto.
//    Não há caminho paralelo pra divergir: a curva do manifest, o
//    Shaped() do módulo e o Real() do DSP acontecem depois, iguais
//    pra qualquer origem. MIDI é um knob remoto.
//
// >>> CONDIÇÃO PRA ISSO SER VERDADE, e é uma armadilha real: <<<
// Uma fonte que reescreve o parâmetro A CADA VOLTA DO LOOP não é par
// de ninguém — ela vence sempre, porque a última escrita é sempre
// dela. O laço de knobs abaixo roda a cada ~1 ms, então ele SÓ pode
// aplicar quando o valor MUDOU. Sem essa guarda, ligar os pots
// físicos mataria o MIDI e o serial em silêncio, e o sintoma seria
// "o CC não faz nada" — um bug de arquitetura disfarçado de bug de
// parser. Ver o laço em main().
// ============================================================

// ---- MIDI ----
// A máquina de estados é board-agnostic (midi.h). O HAL entrega
// bytes; o parser entende; o mapa do manifest decide o que move.
static cotuca::MidiParser midi;

// Chamado pelo parser quando um CC completo passou pelo filtro de
// canal. Roda no LOOP PRINCIPAL, não em ISR — hal::PollMidi() é quem
// despacha, exatamente como PollSerial() faz com as linhas.
// ---- DIAGNOSTICO DE RADIO (camada 2 do sistema WIDI/BLE) ----
//
// E o mscope da camada de radio, e a filosofia e a mesma: a ferramenta e
// NOSSA e nenhum app de terceiro entra no caminho critico. O mscope
// responde "o que chegou"; isto responde "o link esta vivo, e se nao
// esta, ha quanto tempo parou".
//
// A distincao que o comando existe pra fazer: `bytes 0` e IDENTICO em
// "nunca conectou" e em "conectou e caiu", e os consertos sao
// diferentes. Idade do ultimo byte separa os dois em uma linha.
static uint32_t ble_last_rx_ms   = 0; // 0 = nunca recebeu nada
static uint32_t ble_last_bytes   = 0;
static uint32_t ble_session_base = 0; // CcCount no inicio da sessao
static uint32_t ble_drops        = 0;
static uint32_t ble_reconnects   = 0;
static bool     ble_drop_flagged = false;

// ============================================================
// QUARENTENA DE RECONEXAO — o detector de dump virou DEFESA
//
// CASO DE CAMPO (2026-08-18): transicoes de link BLE fazem o iOS/Loopy
// reenviar a posicao de todos os widgets de uma vez. O instrumento
// obedecia: som silenciado na desconexao, e freeze com frz_size no
// TETO na reconexao. Comandos fantasma, que ninguem deu.
//
// O detector ja existia como SENSOR (>= 4 CCs distintos em < 100 ms
// apos silencio > 5 s = provavel reconexao). Aqui ele vira portao.
//
// POR QUE SEGURAR ANTES DE DECIDIR, e nao bloquear depois de detectar:
// o gatilho e o QUARTO CC distinto. Bloquear a partir dali deixaria os
// TRES PRIMEIROS entrarem — e com 14 CCs no mapa, tres bastam pro
// estrago observado (um deles ja seria o frz_size). Entao todo CC que
// chega depois de silencio > 5 s fica SEGURO por ate 100 ms, sem ser
// aplicado, ate a duvida se resolver:
//
//   confirmou dump  -> descarta tudo o que estava seguro + 500 ms de
//                      quarentena. Nada fantasma encosta em parametro.
//   nao confirmou   -> libera o segurado NA ORDEM, e a vida segue.
//
// O CUSTO, declarado: o primeiro gesto depois de 5 s parado chega com
// ate 100 ms de atraso. Uma vez, e so depois de silencio. Um fader
// varrido continua instantaneo, porque a partir do segundo CC a janela
// ja se resolveu.
//
// POR QUE O FALSO POSITIVO E DESPREZIVEL: gesto humano nao tem esse
// perfil. Um fader real e UM CC repetido em rampa; dois dedos sao dois
// CCs. Quatro CCs DISTINTOS no mesmo centesimo de segundo nao e mao —
// e maquina reenviando estado.
static constexpr uint32_t kQuarWindowMs   = 100;  // janela de decisao
static constexpr uint32_t kQuarBlockMs    = 500;  // bloqueio apos confirmar
static constexpr uint32_t kQuarSilenceMs  = 5000; // silencio que abre suspeita
static constexpr int      kQuarDistinct   = 4;    // CCs distintos = dump
static constexpr int      kQuarHoldMax    = 16;

// O canal entra no HeldCc porque a quarentena REPRODUZ o que segurou:
// guardar so (cc,valor) faria toda mensagem retida voltar mirando a
// cadeia A, e um despejo de reconexao da cadeia B reapareceria na A.
struct HeldCc { uint8_t canal, cc, value; };
static HeldCc   quar_held[kQuarHoldMax];
static int      quar_held_n   = 0;
static uint8_t  quar_seen[kQuarHoldMax];
static int      quar_seen_n   = 0;
static uint32_t quar_win      = 0; // 0 = sem janela aberta
static uint32_t quar_block_to = 0; // fim do bloqueio confirmado
static uint32_t quar_last_ms  = 0;
static uint32_t cc_quarentena = 0; // CCs recusados — visivel no `midi`

// Definida la em baixo, depois da biblioteca. Declarada aqui porque o
// despacho do CC vive antes dela no ficheiro, e nao vale mover uma
// biblioteca inteira para cima por causa de uma chamada.
static void CarregaPresetPorCc(uint8_t canal, uint8_t slot);

static void ApplyCcNow(uint8_t canal, uint8_t cc, uint8_t value)
{
    // O mapa é do manifest, e aplicá-lo também: ver Manifest::ApplyMidiCc.
    // CC fora do mapa devolve -1 e é ignorado de propósito — mas o
    // parser já o guardou no histórico. No dia da solda, ver um CC
    // chegando e não fazer nada é informação MUITO diferente de não
    // ver nada.
    if(manifest.ApplyMidiCc(params, canal, cc, value) >= 0)
        midi.NoteApplied(); // CC que achou dono; fora do mapa nao conta
}

static void QuarFlush()
{
    for(int i = 0; i < quar_held_n; i++)
        ApplyCcNow(quar_held[i].canal, quar_held[i].cc, quar_held[i].value);
    quar_held_n = 0;
    quar_win    = 0;
}

// Chamado do loop principal. Existe porque a janela pode expirar SEM
// que chegue outro CC — o humano que mexeu uma vez e parou. Sem este
// tique o gesto dele ficaria seguro pra sempre.
static void QuarTick()
{
    using namespace cotuca;
    if(quar_win && (hal::NowMs() - quar_win) > kQuarWindowMs)
        QuarFlush();
}

// CC RESERVADO COMO COMANDO, nao como parametro: pede a placa pra
// EMPURRAR o estado dela pro controlador. Resolve na direcao certa um
// problema que vinha sendo contornado na errada.
//
// O PROBLEMA: os defaults do manifest nao sobrevivem a conexao. Toda
// gravacao restaura o aprovado, e o primeiro CC do Loopy sobrescreve
// com onde os faders dele estao parados — entao o instrumento acorda
// no estado do controlador, nao no seu proprio.
//
// Zerar os defaults seria contornar: faria o controlador SEMPRE vencer.
// Isto inverte: a placa fala primeiro, e o controlador se alinha a ela.
// 120, NAO 34. Em 2026-08-22 o 34 foi dado ao `drv_drive` na reorganizacao
// do mapa e ninguem cruzou as duas listas: o `OnMidiCc` intercepta o CC
// de comando ANTES do mapa e retorna, entao `drv_drive` ficou surdo a
// MIDI e cada gesto naquele fader disparava um push de estado inteiro.
// Dois donos para um numero, e o intercept vence sempre — em silencio.
// 120 fica fora de toda faixa de parametro, que e onde comando mora.
static constexpr uint8_t kCcSync = 120;

// ---- ESPELHO: a placa fala de volta, no CANAL 2 ----
//
// O LACO E O PROBLEMA CENTRAL, nao a transmissao. Se a placa manda CC
// ao mudar um param e o Loopy responde mandando CC de volta, os dois se
// empurram pra sempre. Duas defesas, e a segunda existe porque a
// primeira pode falhar num caminho que eu nao previ:
//
//   1. CANAL SEPARADO — escuta em 1 (omni), fala em 2. Estrutural: uma
//      mensagem que sai nunca se parece com uma que entra.
//   2. VALOR REPETIDO NAO SE MANDA — `eco_ult[cc]` guarda o ultimo
//      valor visto naquele CC, VENHA DE ONDE VIER. Um CC recebido
//      atualiza essa tabela, entao o espelho nao o devolve. Se as duas
//      pontas caissem no mesmo canal, o laco morreria na segunda volta
//      em vez de girar pra sempre.
// O CANAL DO ESPELHO MORA NUMA CONSTANTE SO. A versao anterior tinha
// 0xB1 escrito a mao aqui e o filtro de recepcao em lugar nenhum — e a
// separacao de canal, declarada como defesa estrutural, nunca existiu.
// Base 0: indice 1 = canal 2 no mostrador.
// O ESPELHO SAIU DO CH2 (v0.135.0). Falava no canal que virou a entrada
// da cadeia B, e a colisao obrigava a recusar aquela entrada. Agora ele
// tem canais proprios — ch3 para a cadeia A + compartilhados, ch4 para a
// cadeia B — e a placa espelha e recebe ao mesmo tempo.
//
// O status de saida se deriva do canal do VINCULO, nunca de uma
// constante solta: dois canais e uma constante e o convite para um deles
// ficar para tras no proximo remapeamento.
static inline uint8_t StatusEspelho(uint8_t canal_vinculo)
{
    return (uint8_t)(0xB0 | cotuca::CanalEspelhoDe(canal_vinculo));
}
// POR PARAM, pelo mesmo motivo do `quiet_until`: o CC deixou de
// identificar o assunto. Aqui o efeito de errar seria mais silencioso —
// o espelho acharia que ja mandou o valor da cadeia B porque a A tinha
// aquele numero, e simplesmente nao mandaria.
static uint8_t  eco_ult[cotuca::kMaxParams];  // 0xFF = nunca visto
static uint32_t eco_prox_ms = 0;
static uint32_t eco_proprio = 0;   // mensagens minhas que VOLTARAM
// CONTADOR DE TRANSMISSAO, e ele faltava. Em 2026-08-22 eu li `eco_proprio`
// como "quantas sairam" — ele conta quantas VOLTARAM. Os dois numeros
// so coincidem se o caminho de volta for perfeito, que e exatamente a
// hipotese sob teste. Medir o retorno e chamar de envio responde a
// pergunta errada com confianca.
static uint32_t eco_tx = 0;

// ---- JANELA DE AUTORIA: depois de falar, a placa e dona do CC ----
//
// POR QUE CASAMENTO DE MENSAGEM NAO SERVE. O widget do Loopy e um
// toggle COM ESTADO: recebe a mensagem do espelho, alterna, e devolve
// o ESTADO DELE — nao a mensagem. Em fase devolve igual (eco
// idempotente, inofensivo); FORA de fase devolve o valor OPOSTO, que
// escreve no param e desfaz a mudanca autonoma. Um filtro por "isto e
// igual ao que enviei" pegaria so o inofensivo e deixaria passar
// justamente o que destroi.
//
// O criterio nao e "o que eu enviei": e "o ASSUNTO sobre o qual eu
// acabei de falar". Transmitiu o CC n, ignora qualquer CC n que chegue
// — qualquer valor, qualquer canal — por 250 ms.
//
// NAO TOCA EM GESTO HUMANO: a janela so abre quando o espelho
// transmite, e o espelho so transmite mudanca AUTONOMA (`eco_ult` ja
// impede que o que veio de MIDI volte). Gesto normal nunca encontra
// janela aberta — ela so existe depois de boot-push, queda do teto,
// buzios, ou serial.
//
// TRADE DECLARADO: gesto humano no mesmo CC dentro de 250 ms de uma
// mudanca autonoma DAQUELE CC e descartado. Raro, e e a colisao que a
// regra arbitra — a maquina acabou de falar, ela vence o instante.
// Se 250 estiver errado, e numero, nao arquitetura.
static constexpr uint32_t kJanelaMs = 250;
// INDEXADA POR PARAM, NAO POR CC (v0.133.0).
//
// Com a multiplexacao o CC deixou de identificar o parametro: o CC 30
// no ch1 e o CC 30 no ch2 sao params diferentes. Indexar por CC faria a
// janela do drive da cadeia A silenciar o drive da cadeia B.
//
// De brinde, ficou mais precisa do que era: dois params que
// compartilhassem CC (o desenho permitia, ainda que nao acontecesse) se
// silenciavam juntos. Agora o assunto e o param, que e o que a regra
// sempre quis dizer com "o assunto sobre o qual eu acabei de falar".
static uint32_t quiet_until[cotuca::kMaxParams] = {0};
static uint32_t cc_janela = 0;   // recusados pela janela
// CHAVE DO ESPELHO. Nasceu no voo A para desfazer uma colisao de canal
// que nao existe mais — e a colisao morreu, mas a chave FICA, por outra
// razao, declarada aqui para que ninguem a leia como vestigio:
//
// silenciar o espelho e o unico jeito de medir carga de MIDI sem a
// propria medicao gerar trafego, e de isolar "o widget nao recebe" de
// "o widget recebe e ignora". E ganho de teste, da mesma familia do
// `ctos prazo` e do `dup on|off`.
//
// O que saiu junto com o interino foi o ACOPLAMENTO: a entrada nao
// depende mais desta chave. Ela so cala a saida.
// ---- BIBLIOTECA DE PRESETS (em RAM) ----
//
// Mora em `.bss`, que neste APP_TYPE cai na SRAM/AXI — escolha
// EXPLICITA e nao omissao: a biblioteca e memoria FRIA (lida no `load`,
// escrita no `capturar`, nunca tocada no callback), e a DTCM, que esta
// vazia, e a unica RAM que ainda pode salvar um caminho quente. Gastar
// a rapida com dado frio seria desperdicar a que nao da pra recuperar.
static cotuca::PresetMapa  pmapa;
static cotuca::Biblioteca  biblio;
static uint16_t            mapa_hash = 0;

// Marca sujo para o espelho escoar. O `load` NAO usa a rota do `sync`:
// 3 ms por mensagem x 86 sao 258 ms de laco bloqueado, e o espelho
// normal escoa duas a cada 8 ms sem parar nada.
static void AbreJanelaEEspelha(int id)
{
    using namespace cotuca;
    if(id < 0 || id >= cotuca::kMaxParams) return;
    // A JANELA ABRE AGORA, PARA TODOS, e nao a medida que o espelho
    // manda. O gesto autonomo e o `load`, nao cada mensagem: se a janela
    // abrisse so na saida, o widget que ecoasse no milissegundo 5 —
    // antes de a mensagem dele sair — seria obedecido, e o preset seria
    // desfeito pela metade.
    quiet_until[id] = hal::NowMs() + kJanelaMs;
    eco_ult[id]     = 0xFF;   // forca o espelho a reenviar este param
}

// ---- CARREGAR PRESET POR CC 121 ----
//
// O canal diz o DESTINO e o valor diz o SLOT — mesma gramatica do resto
// do esquema de seis canais. Ch1 global, ch2 cadeia A, ch3 cadeia B.
//
// SLOT VAZIO NAO E ERRO SILENCIOSO. Um botao de palco que nao faz nada
// e indistinguivel de um botao que nao chegou, e as duas coisas pedem
// consertos opostos. Diz-se em voz alta qual foi.
//
// ⚠️ O CC 122 (gravar) NAO esta implementado, e a omissao e deliberada:
// um CC que ESCREVE preset destroi uma biblioteca com uma mensagem
// perdida, e nao traz nome nenhum para lhe dar. Capturar continua no
// serial, onde o gesto e deliberado e o preset nasce com nome.
static void CarregaPresetPorCc(uint8_t canal, uint8_t slot)
{
    using namespace cotuca;
    if(canal == kCanalCompart)
    {
        if(slot >= kMaxPresetsGlobal)
        {
            hal::Log("preset CC: slot %u fora dos %d globais",
                     (unsigned)slot, kMaxPresetsGlobal);
            return;
        }
        const PresetGlobal& p = biblio.global[slot];
        if(!p.n) { hal::Log("preset CC: slot global %u VAZIO", (unsigned)slot); return; }
        for(int k = 0; k < p.n && k < pmapa.n_global; k++)
        {
            params.Set(pmapa.global[k], (float)p.val[k] / 127.f);
            AbreJanelaEEspelha(pmapa.global[k]);
        }
        biblio.ponteiro_global = (int)slot;
        hal::Log("preset CC: global slot %u = \"%s\" (%d params)",
                 (unsigned)slot, p.nome, (int)p.n);
        return;
    }
    const int c = (canal == kCanalEntradaB) ? 1 : 0;
    if(canal != kCanalEntradaA && canal != kCanalEntradaB)
    {
        hal::Log("preset CC: canal %u nao e destino de preset"
                 " (ch1 global · ch2 cadeia A · ch3 cadeia B)", (unsigned)canal);
        return;
    }
    if(slot >= kMaxPresetsCadeia)
    {
        hal::Log("preset CC: slot %u fora dos %d por cadeia",
                 (unsigned)slot, kMaxPresetsCadeia);
        return;
    }
    const PresetCadeia& p = biblio.cadeia[slot];
    if(!p.n) { hal::Log("preset CC: slot %u da cadeia %c VAZIO",
                        (unsigned)slot, c ? 'B' : 'A'); return; }
    for(int k = 0; k < p.n && k < pmapa.n_cadeia; k++)
    {
        params.Set(pmapa.cadeia[c][k], (float)p.val[k] / 127.f);
        AbreJanelaEEspelha(pmapa.cadeia[c][k]);
    }
    biblio.ponteiro[c] = (int)slot;
    hal::Log("preset CC: cadeia %c slot %u = \"%s\" (%d params)",
             c ? 'B' : 'A', (unsigned)slot, p.nome, (int)p.n);
}

// ---- CONFERENCIA DO SYNC ----
//
// O `sync` deixou de ser "mandei" e passou a ser "chegou". A diferenca
// importa porque a falha mais comum aqui e MUDA: o WIDI desligado, o
// Loopy fora da tela, ou os widgets escutando o canal antigo — nos tres
// a placa manda 86 CCs no vazio e, sem conferencia, diz "pronto".
//
// O INSTRUMENTO JA EXISTIA e e a propria defesa: se o Loopy recebe, os
// widgets se movem e devolvem o estado deles pelo ch1/ch2. A janela de
// autoria barra esse eco (e por isso que ela existe) — e o CONTA. Entao
// o retorno do controlador e exatamente o que a janela registra.
//
// A conferencia e ASSINCRONA de proposito: bloquear aqui impediria o
// `hal::PollMidi()` de rodar, e o eco que se quer medir chegaria numa
// fila que ninguem esvazia. O laco confere quando o prazo vence e o
// veredito sai sozinho — sem cronometro para o operador cumprir.
static uint32_t sync_confere_ate = 0;
static uint32_t sync_cc_antes    = 0;
static uint32_t sync_jan_antes   = 0;
static int      sync_mandados    = 0;
static constexpr uint32_t kSyncEsperaMs = 1500;

// TRAVA DO CAMINHO DE VOLTA — "ja ouvi o controlador alguma vez?"
//
// O AVISO do `sync` listava tres causas para o mesmo silencio e nao
// distinguia nenhuma. Mas a placa PODE distinguir uma delas: se algum CC
// ja chegou por um canal de entrada desde o boot, o fio de volta
// (WIDI OUT -> D14) esta bom, e o silencio de agora e dos WIDGETS.
//
// Mesma forma da trava do `pino`, que inocentou uma solda quando o
// contador dizia zero: acumular desde o boot em vez de medir numa
// janela. A pergunta "ja funcionou alguma vez?" nao tem relogio dentro.
static uint32_t ouvi_controlador = 0;
// E O DESCONTO DAS INJECOES, porque o `miditest` entra na MESMA fila do
// fio real e o parser nao os distingue.
//
// Sem isto a trava mente com a maior autoridade possivel: eu exercitei
// o ramo "ja funcionou" com uma injecao local e a placa afirmou que o
// fio de volta estava bom. Instrumento que o proprio exercicio engana
// nao e instrumento — e a 13x outra vez, agora do lado de quem mede.
//
// O relatorio mostra os DOIS numeros. O veredito usa so o real.
static uint32_t injetados_local = 0;
static inline uint32_t OuviDoFio()
{
    return ouvi_controlador > injetados_local
               ? ouvi_controlador - injetados_local : 0;
}

// ---- ENCODERS: acumulacao, aceleracao e o instrumento ----
//
// TRES ESTADOS COMPLETAMENTE SEPARADOS. Nenhum campo compartilhado entre
// encoders — giro simultaneo contaminado daria sintoma intermitente, que
// e o mais caro de diagnosticar.
//
// O `passos_crus` conta o que a libDaisy entregou, SEM divisao por
// detente. A divisao se mede girando dez cliques e conferindo dez — nao
// se le no datasheet, porque EC11 varia entre lotes.
struct EstadoEnc
{
    int32_t  crus       = 0;   // incrementos brutos acumulados
    int32_t  passos     = 0;   // depois da divisao por detente
    int32_t  acelerados = 0;   // depois da aceleracao por tempo
    int      resto      = 0;   // sobra da divisao, para nao perder passo
    int      ultimo_dir = 0;   // -1, 0, +1
    uint32_t ultimo_ms  = 0;   // para a aceleracao POR TEMPO
    uint32_t pushes     = 0;   // CONTAGEM, nao paridade (bts 13e)
    bool     push_agora = false;
    uint32_t rapidos    = 0;   // passos que a aceleracao multiplicou

};
static EstadoEnc enc_st[cotuca::hal::kNumEncoders];

// ⚠️ AQUI ESTEVE UM AVISO NO PAINEL E UM GESTO DE TRES CLIQUES. (2026-09-02)
//
// Serviam para armar a calibracao de microfonia por gesto no encoder G. O
// dB substituiu o gatilho por um melhor — o supressor corre no ARRANQUE e
// a cada mexida de POTE, porque o ganho do laco escala com o volume e um
// ajuste feito a um volume nao vale a outro (ver
// docs/operacao/SUPRESSOR-MICROFONIA.md).
//
// Com o gatilho revogado, o gesto, o detector de multi-clique e o aviso
// ficaram sem leitor. Nao ficam a espera de voltar a ser uteis: quando o
// supressor precisar de anunciar-se no painel, escreve-se para esse fim.

// DIVISAO POR DETENTE — nasce em 1 e se ajusta DEPOIS DE MEDIR.
//
// Alguns EC11 dao dois ou quatro pulsos por clique. Cravar 4 "porque
// costuma ser" produziria um instrumento que mente por suposicao logo no
// voo que existe para medir. Comeca em 1, o `enc` mostra o cru, e o
// numero certo entra quando o dB girar dez e contar.
static int enc_por_detente = 1;

// TRAVA DE NIVEL CRU DOS ENCODERS — nas DUAS direcoes.
//
// Leitura estatica nao decide: uma fase pode legitimamente estar baixa
// no detente atual. O que distingue fase MORTA de fase EM REPOUSO e a
// MUDANCA — e por isso a trava guarda os dois lados.
//
// Pino que so aparece de um jeito desde o reset nunca comutou, e ai o
// `Increment` da libDaisy fica em zero para sempre sem dizer por que:
// ele exige a quadratura casar, e uma fase presa nunca casa.
static uint16_t enc_ja_alto  = 0;
static uint16_t enc_ja_baixo = 0;
// Trava da VARREDURA de todos os livres — mesma forma, escopo maior.
static uint32_t var_ja_alto  = 0;
static uint32_t var_ja_baixo = 0;

// ESPELHO DO ENCODER NA TELA — o mesmo instrumento, outra superficie.
//
// Nao e navegacao (isso e o passo 4): e o `enc` desenhado, para que a
// medicao dos dez detentes se faca olhando o knob e nao a serial.
//
// SO REDESENHA QUANDO O TEXTO MUDA, e com teto de taxa. A escrita e
// BLOQUEANTE (~1 KB por Update a PS_64) — redesenhar a cada volta do
// laco poria milissegundos de bloqueio no caminho do MIDI e do serial
// sem nenhum ganho, porque a tela nao muda mais rapido que o olho le.
static uint32_t var_tudo_alto = 0, var_tudo_baixo = 0;
// ---- POTS: filtro, posse e zona morta ----
// Os tres numeros que fazem um pot conviver com MIDI no mesmo param.
// Ajustaveis por `knob` na serial, porque so a bancada sabe o ruido do
// ADC desta montagem.
// ---- OS QUATRO NUMEROS, E O QUE OS DECIDIU ----
//
// MEDIDO na bancada em 2026-08-31, com os pots PARADOS:
//   cru        espalhamento 0,014–0,021 · desvio 0,0056
//   filtrado   espalhamento 0,0075–0,0092 · desvio 0,0024
//   resultado  623 ESCRITAS POR SEGUNDO sem ninguem tocar
//
// A primeira versao tinha zona morta de 0,004 — menor que o desvio do
// filtrado. E nenhum valor dela resolvia bem: grande o bastante para
// calar o ruido, ficava mais grossa que o fader do iPad.
//
// A SAIDA NAO FOI ESCOLHER MELHOR O NUMERO MAGICO — foi tira-lo. O param
// viaja em 7 bits, entao a resolucao util do pot E a do fio: 1/127. Ele
// passou a QUANTIZAR no passo de MIDI, com histerese, e so escreve quando
// o passo MUDA. A zona morta deixou de ser um palpite e passou a ser uma
// propriedade do protocolo.
// AFROUXADOS EM 2026-08-31, e os numeros vieram de medicao, nao de palpite.
//
// Os 0,02 e 0,85 foram escolhidos contra um ruido de sigma 0,0056 — que
// era ARTEFACTO: o `VarreLivres` roubava o pino ao ADC e a entrada estava
// a flutuar. Com o pino de volta ao modo analogico e o condensador de
// 0,1 uF no pot, o ruido real e sigma 0,0004: dezanove vezes abaixo de um
// passo de MIDI.
//
// Medido com os dois valores, um a seguir ao outro, na mesma placa:
//   suave 0,02 · hist 0,85   ->  sigma 0,00022 · 0,00 escritas/s
//   suave 0,25 · hist 0,35   ->  sigma 0,00041 · 0,00 escritas/s
// Filtro 12x mais rapido e histerese 2,4x mais fina, sem custo nenhum em
// estabilidade. Apertar defesa contra ruido que nao existe custa resposta.
static float    kKnobSuave     = 0.25f;
static float    kKnobCaptura   = 0.02f;   // janela para ASSUMIR o param
static float    kKnobSolta     = 0.06f;   // janela para LARGAR (maior: histerese)
// Histerese da quantizacao, EM PASSOS de MIDI. 0,85 passo = 0,0067, que
// e 2,8 desvios do filtrado medido — a fronteira nao treme.
static float    kKnobHist      = 0.35f;
static int      knob_passo[cotuca::kNumKnobs] = {0};
// Quantas vezes um pot fechou a recepcao de um param. Sobe a cada passo
// util do pot, e e o numero que denuncia um ADC ruidoso: pot que treme
// abre janela sem parar e deixa aquele param PERMANENTEMENTE surdo ao
// iPad — defesa a funcionar como avaria, e sem contador ninguem veria.
static uint32_t knob_janelas = 0;
static float    knob_filt[cotuca::kNumKnobs] = {0};
static bool     knob_vivo[cotuca::kNumKnobs] = {false};
static bool     knob_dono[cotuca::kNumKnobs] = {false};
// ---- PAINEL TEMPORARIO ----
//
// MEDIDO EM 2026-08-31, e o numero decidiu o desenho: com o painel aceso o
// chao de ruido da ENTRADA sobe 6 dB nos dois canais (-75,3 -> -69,3
// dBFS) e aparece um espeto a 7040 Hz com dominancia 0,95 — 22 dB
// acima do que la estava. Espeto com dominancia dessas e acoplamento
// de RELOGIO, nao ruido termico.
//
// 7040 Hz nao e coincidencia: um painel de 64 linhas a ~110 Hz de
// quadro varre 64 x 110 = 7040 linhas por segundo. E a corrente de
// accionamento das linhas — proporcional aos pixeis ACESOS, e foi por
// isso que a medicao com os pixeis apagados ficou limpa.
//
// POR QUE NAO SE CONSERTA COM NOTCH: a peca e replicada em serie, na
// ordem de centenas, e cada painel tera o seu relogio — 6900 aqui,
// 7200 ali. Notch fixo acerta numa unidade e falha nas outras. Painel
// apagado acerta em todas, custa zero DSP, e deixa as duas bocas do
// notch livres para a microfonia, que ja mostrou querer mais de duas.
//
// A REGRA, decidida pelo dB: o painel nasce APAGADO. Acorda quando
// alguem mexe num encoder — girar ou premir — e volta a dormir sozinho
// ao fim de 5 s sem actividade. Durante a performance ninguem lhe
// toca, portanto ele esta apagado quando o ouvido esta a trabalhar.
static const uint32_t kOledDormeMs = 5000u;
static bool     oled_pronto_forcado = false;  // so para o relato do `oled forca`
static bool     enc_na_tela   = false;   // nasce APAGADO
static uint32_t oled_dorme_em = 0;       // 0 = ja dorme

// SONO DA CONSOLA — um minuto, e existe para o barramento nao ficar
// conduzido para sempre.
//
// Os comandos que acendem a tela pela serie (`oled`, `oled texto`, `oledvel`,
// `oledpad`) nao armavam sono nenhum — o `oledpad` ate punha `oled_dorme_em`
// a zero de proposito, para o padrao nao desaparecer enquanto se olha. O
// efeito lateral era o painel ficar a ser conduzido indefinidamente, e com a
// bancada desligada a meio isso e injeccao pelos diodos de proteccao do
// modulo (bts 15fm). Um minuto chega para olhar e limita a exposicao.
static const uint32_t kOledConsolaMs = 60000u;
static void ArmaSonoConsola()
{
    oled_dorme_em = cotuca::hal::NowMs() + kOledConsolaMs;
    if(!oled_dorme_em) oled_dorme_em = 1u;   // 0 significa "ja dorme"
}

// ---- O GESTO QUE ACORDA: ENGOLE APAGADO, ACENDE NO FIM ----
//
// Regra do dB, na terceira volta de a acertar — e as duas primeiras
// falharam por eu modelar mal o gesto, nao por bug:
//
//   1a: engolia UM evento. Ele: "um gesto e quantos passos forem ate
//       parar; e dificil em palco mexer exactamente um clique."
//   2a: engolia ate parar, MAS acendia logo no primeiro evento. Ele:
//       "nao e por tempo."
//   3a (esta): ouve o encoder, fica a engolir COM O PAINEL APAGADO, e
//       so acende 500 ms depois de a mao parar.
//
// A diferenca entre a 2a e a 3a e pequena no codigo e grande na mao: o
// painel a acender a meio da rotacao pisca no canto do olho enquanto se
// esta a rodar, e sinaliza "estou a ouvir-te" quando ainda esta a
// deitar fora tudo. Acender no FIM torna o acender a resposta ao gesto
// completo — e ai o que se ve ja e o estado com que se vai trabalhar.
//
// SEQUENCIA:
//   apagado --[encoder]--> a engolir (apagado) --[500 ms parado]--> aceso
//   aceso --[5 s sem tocar]--> apagado
// 200 ms, AFINADO PELA MAO em 2026-08-31 — 500 pareceu lento, 100 apertado,
// 200 ficou. A janela nao precisa de cobrir a rotacao inteira: cada
// detente ADIA o fim dela, entao so tem de ser maior que o intervalo
// entre dois detentes de uma rotacao continua.
//
// ⚠️ Este numero e do PULSO DE QUEM TOCA, e nao de calculo. Se algum dia
// parecer errado, o teste e a mao, nao o osciloscopio.
static const uint32_t kOledGestoMs = 200u;   // pausa que fecha o gesto
static uint32_t oled_gesto_ate = 0;          // 0 = sem gesto em curso
// SENTIDO POR ENCODER, +1 ou -1. Existe porque o sentido de um encoder
// depende de COMO ELE FOI SOLDADO, e isso nao se descobre lendo codigo:
// descobre-se rodando o knob. Corrigir por gravacao custava um flash por
// palpite, e cada flash zera o estado da placa.
//
// NAO E DESCULPA PARA NAO MEDIR. O lugar certo do conserto e a ordem das
// fases no `kEncPin` do hal; isto e a via rapida ate o mapa fisico ser
// medido pelo `varre`. Por isso se DECLARA no `enc` e no `board`: sinal
// invertido em silencio e a mesma familia do param que nao existe.
static int      enc_sinal[3]  = {1, 1, 1};
static uint32_t enc_tela_prox = 0;
static char     enc_tela_ant[3][24] = {{0},{0},{0}};

// ACELERACAO POR TEMPO ENTRE PASSOS, nao por contagem bruta.
//
// Por contagem, um giro lento e longo acelera igual a um rapido e curto —
// e o gesto do operador e o oposto: rapido quer percorrer, lento quer
// precisar. O tempo entre passos captura a INTENCAO; a contagem captura
// so a distancia.
static constexpr uint32_t kEncRapidoMs = 40;   // abaixo disto, e varredura
static constexpr uint32_t kEncTurboMs  = 15;   // muito rapido
static constexpr int      kEncMultRap  = 4;
static constexpr int      kEncMultTurbo = 10;

// Aceleracao aplicada NO PASSO, com o intervalo desde o passo anterior.
static void AplicaAcel(EstadoEnc& st, int dir)
{
    using namespace cotuca;
    const uint32_t ag = hal::NowMs();
    const uint32_t dt = st.ultimo_ms ? (ag - st.ultimo_ms) : 0xFFFFFFFFu;
    st.ultimo_ms = ag;
    int mult = 1;
    if(dt <= kEncTurboMs)       { mult = kEncMultTurbo; st.rapidos++; }
    else if(dt <= kEncRapidoMs) { mult = kEncMultRap;   st.rapidos++; }
    st.acelerados += dir * mult;
}

static bool espelho_on = true;

// DRENAGEM DE BOOT — a travessia, que e o caso que a drenagem do voo A
// nao cobria e eu quase deixei passar.
//
// Raciocinei sobre o ESTADO FINAL (ch3/ch4 sem vinculo, logo inofensivos)
// e esqueci a MIGRACAO. Ao gravar, a placa reinicia; o WIDI e o iPad
// nao. Mensagens de espelho da versao ANTERIOR, que falava no ch2,
// chegam na versao nova pelo ch2 — que agora e entrada plena da cadeia
// B. CC 34 com o valor de `drv_drive_a` escrevendo `drv_drive_b`: o
// fantasma da 13n, na unica janela em que ele ainda cabe.
//
// A regra geral, que e por que isto fica mesmo depois da migracao
// terminar: NO BOOT, TUDO QUE ESTA NO FIO FOI ENDERECADO A UMA
// CONFIGURACAO QUE PODE NAO SER ESTA. O mapa muda entre versoes, e uma
// mensagem em voo nao sabe disso.
//
// 300 ms pelo mesmo dimensionamento do voo A (31250 baud, ~1 ms por
// mensagem, rajadas de duas a cada 8 ms) — e aqui ha folga extra de
// graca, porque ninguem move um fader de proposito nos primeiros 300 ms
// de um boot. Se mover, o contador diz.
static constexpr uint32_t kDrenoBootMs = 300;
static uint32_t boot_dreno_ate = 0;
static uint32_t cc_dreno_boot  = 0;
static uint32_t cc_canal_errado = 0;  // canal sem vinculo nenhum
static uint32_t cc_sem_dono = 0;      // (canal,cc) fora do mapa

// INVENTARIO: QUAIS CCs JA CHEGARAM, um bit por numero.
//
// O historico de mensagens nao serve pra esta pergunta e eu levei duas
// tentativas pra ver: ele guarda as N ULTIMAS MENSAGENS, e varrer um
// fader manda dezenas. Aumentei de 8 pra 96 achando que 96 > 76
// widgets — mas a unidade estava errada, e os 96 slots se encheram com
// os ultimos nove controles. Historico responde "o que acabou de
// chegar"; inventario responde "o que ja chegou alguma vez". Duas
// perguntas, duas estruturas.
// POR (CANAL, CC): o CC sozinho parou de identificar param, entao um
// inventario por CC diria "cc30 chegou" sem dizer QUAL drive chegou —
// que e a pergunta toda. Quatro canais cobrem entrada (1,2) e o espelho
// (3,4) do voo B, e custam 512 bytes contra os 128 de antes.
static constexpr int kCanaisInv = 8;
static uint8_t cc_visto[kCanaisInv][128] = {{0}};   // contagem, satura em 255

// Subtracao ANTES da comparacao: uint32 de ms volta a zero em 49 dias
// e `agora < limite` mentiria por 250 ms uma vez por volta. Esta base
// ja perdeu um watchdog em 4 277 071 629 us por isso.
static inline bool NaJanela(int param, uint32_t agora)
{
    if(param < 0 || param >= cotuca::kMaxParams) return false;
    return (int32_t)(agora - quiet_until[param]) < 0;
}

// Chamado do LOOP, nunca do callback. A regra ja custou uma placa
// pendurada: MidiSendBytes de dentro do audio starva o ISR do USB.
// Acende o painel e adia o sono. Inicializa a pedido: se ninguem
// mexeu num encoder desde o arranque, o SPI nunca chega a falar.
// Acende agora e arma o sono. Inicializa a pedido: se ninguem mexeu num
// encoder desde o arranque, o SPI nunca chega a falar.
// ⚠️ `noinline` DE PROPOSITO, e o motivo esta medido.
//
// Com a chamada inline no corpo do laco, o compilador arrastou para
// dentro da funcao quente a fonte, o elipse, o Bresenham e o Texto — e a
// base do laco caiu de ~21 500 para ~18 600 voltas/s, 13%, com o splash
// PARADO. O trabalho nao aumentou; o codigo e que inchou e a I-cache
// pagou. Custo de enfeite cobrado ao caminho quente que nunca o corre.
//
// Este atributo e o unico delta entre os dois builds medidos.
__attribute__((noinline)) static void PassoDaAbertura();
__attribute__((noinline)) static void ColheEntropia();

// Invalida a memoria do refrescamento SEM acordar nada.
//
// O `AcendePainel` faz isto E acende E adia o sono, que e o que se quer
// num gesto do encoder. Depois de uma jogada de buzios nao se quer nada
// disso: o painel volta ao estado em que estava, e so precisa de ser
// redesenhado porque a animacao escreveu por cima. Reusar o `AcendePainel`
// aqui acenderia um painel que estava a dormir — a cada disparo, e ao
// preco de 6 dB de chao de ruido.
static void ForcaRedesenhoDoPainel();

static void AcendePainel()
{
    if(!cotuca::hal::OledConfigurado() && !cotuca::hal::OledInit()) return;
    enc_na_tela = true;

    // ⚠️ FORCA O REDESENHO, e sem isto o painel NAO ACENDE.
    //
    // O refrescamento so escreve quando o conteudo MUDA — compara com
    // `enc_tela_ant` e cala-se se for igual. Ao acordar nada mudou (os
    // encoders estao onde estavam), portanto ele nao desenhava nada e a
    // tela, que tinha sido apagada ao adormecer, ficava PRETA.
    //
    // O sintoma que isso produzia era exactamente o oposto do desenho:
    // "giro, continua apagado; paro, continua apagado; giro de novo, ele
    // acende E JA ESTA A MUDAR VALORES" — porque so o SEGUNDO gesto
    // mexia num valor, e so ai havia diferenca para desenhar.
    //
    // Invalidar o "ultimo desenhado" fecha o buraco: o proximo
    // refrescamento ve tudo diferente e escreve.
    for(int e = 0; e < cotuca::hal::kNumEncoders; e++)
        enc_tela_ant[e][0] = '\0';
    enc_tela_prox = cotuca::hal::NowMs();     // desenha ja, sem esperar

    oled_dorme_em = cotuca::hal::NowMs() + kOledDormeMs;
    if(!oled_dorme_em) oled_dorme_em = 1u;    // 0 significa "ja dorme"
}

static void MidiEspelha()
{
    using namespace cotuca;
    if(!espelho_on) return;
    const uint32_t ag = hal::NowMs();
    if((int32_t)(ag - eco_prox_ms) < 0) return;
    int n = 0;
    for(int i = 0; i < manifest.n_midi && n < 2; i++)
    {
        const int id = manifest.midi_map[i].param_id;
        if(id < 0) continue;
        // SEM FILTRO: cada vinculo fala no canal de espelho da SUA
        // cadeia. O filtro do voo A existia porque havia um canal so —
        // era a compressao de dois estados num, e o preco era a cadeia B
        // invisivel ao iPad.
        const uint8_t cc = manifest.midi_map[i].cc;
        float norm = params.Get(id);
        if(norm < 0.f) norm = 0.f;
        if(norm > 1.f) norm = 1.f;
        const uint8_t v = (uint8_t)(norm * 127.f + 0.5f);
        if(eco_ult[id] == v) continue;
        eco_ult[id] = v;
        const uint8_t msg[3]
            = {StatusEspelho(manifest.midi_map[i].canal), cc, v};
        hal::MidiSendBytes(msg, 3);
        quiet_until[id] = ag + kJanelaMs;   // falei deste assunto
        eco_tx++;
        n++;
    }
    // A 31250 baud tres bytes levam ~1 ms. Duas por janela de 8 ms
    // segura o pior caso (varredura de fader) bem abaixo do fio.
    if(n) eco_prox_ms = ag + 8u;
}

// ---- MODO LEARN: a placa percorre o mapa pra o Loopy aprender ----
//
// Endereca as quatro paginas sem digitar CC a CC. Anda na ordem do
// mapa, que e a ordem das familias — casa com as paginas.
//
static void MidiPushEstado()
{
    using namespace cotuca;
    int n = 0;
    for(int i = 0; i < manifest.n_midi; i++)
    {
        const int id = manifest.midi_map[i].param_id;
        if(id < 0) continue;
        const float norm = params.Get(id);
        uint8_t v = (uint8_t)(norm * 127.f + 0.5f);
        if(v > 127) v = 127;
        const uint8_t msg[3] = {StatusEspelho(manifest.midi_map[i].canal),
                                manifest.midi_map[i].cc, v};
        eco_ult[id] = v;  // nao reenviar depois
        hal::MidiSendBytes(msg, 3);
        // (a janela por mensagem fica, mas NAO basta — ver o
        //  re-carimbo depois do laco, que e o que realmente protege)
        //
        // A JANELA DE AUTORIA ABRE AQUI TAMBEM, e faltava.
        //
        // `MidiEspelha` escrevia `quiet_until` a cada mensagem; esta
        // funcao mandava e nao escrevia nenhuma. Defesa aplicada num
        // caminho e nao no irmao (bts 13q) — e o irmao aqui e a OUTRA
        // rota de saida, que e a mais barulhenta das duas.
        //
        // A consequencia era concreta: widget de toggle devolve o
        // ESTADO DELE, que e o motivo de a janela existir. Depois de um
        // `sync`, a placa obedecia o eco de tudo que acabara de mandar.
        quiet_until[id] = hal::NowMs() + kJanelaMs;
        // Respira entre mensagens: a 31250 baud tres bytes levam ~1 ms.
        //
        // O COMENTARIO DIZIA "12 CCs" e foi escrito quando o mapa tinha
        // 12. Sao 86 hoje, e 3 ms cada dao 258 ms de laco bloqueado —
        // regressao por CRESCIMENTO, nao por edicao (bts 13p). Fica
        // registrado aqui; o `load` NAO usa esta rota justamente por
        // isso, e escoa pelo espelho normal.
        hal::DelayMs(3);
        n++;
    }
    // RE-CARIMBO DA JANELA, PARA TODOS, DEPOIS DO ULTIMO ENVIO.
    //
    // A janela por mensagem nao bastava e a conferencia mostrou: o
    // despejo leva ~258 ms (86 x 3 ms) e a janela dura 250, entao a do
    // PRIMEIRO param expira antes de o ULTIMO sair. Um controlador que
    // responde em lote — recebe tudo, depois devolve tudo — chega com os
    // primeiros ja desprotegidos.
    //
    // Medido com eco simulado: "0 barrados pela janela" com cinco ecos
    // chegando. A defesa estava de pe e nao pegava nada.
    //
    // E o mesmo raciocinio que eu escrevi para o `load` e nao apliquei
    // aqui — a janela conta do FIM do gesto, nao do meio dele, porque o
    // gesto autonomo e o `sync` inteiro e nao cada mensagem. Irmao
    // desprotegido de novo (bts 13q).
    {
        const uint32_t ag = hal::NowMs();
        for(int i = 0; i < manifest.n_midi; i++)
        {
            const int id = manifest.midi_map[i].param_id;
            if(id >= 0 && id < cotuca::kMaxParams)
                quiet_until[id] = ag + kJanelaMs;
        }
    }
    hal::Log("sync: %d CCs empurrados pro controlador — os faders do"
             " Loopy devem pular pro estado da placa", n);
    hal::Log("     janela de autoria aberta para os %d params por %lu ms:"
             " o eco dos widgets nao desfaz o que acabou de sair",
             n, (unsigned long)kJanelaMs);
    // Arma a conferencia. Os contadores sao lidos AGORA, depois do
    // despejo, para que o que chegar dali em diante seja resposta a
    // ELE — e nao trafego que ja estava no fio.
    sync_mandados    = n;
    sync_cc_antes    = midi.CcCount();
    sync_jan_antes   = cc_janela;
    sync_confere_ate = hal::NowMs() + kSyncEsperaMs;
    hal::Log("     conferindo o retorno por %lu ms — o veredito sai sozinho,"
             " nao precisa fazer nada", (unsigned long)kSyncEsperaMs);
}

static void OnMidiCc(uint8_t ch, uint8_t cc, uint8_t value)
{
    using namespace cotuca;
    // A PLACA NAO OBEDECE A PROPRIA VOZ.
    //
    // Medido em 2026-08-22 com o `midi`: cada mensagem que saia no canal 2
    // voltava pelo RX e era ACEITA, porque o receptor esta em omni —
    // omni inclui o canal em que ela mesma fala. A separacao de canal
    // estava declarada no cabecalho e nao existia no codigo: metade de
    // uma defesa e uma defesa orfa, e esta deixou o laco de pe.
    // A RECUSA CONDICIONAL DO CH2 SAIU JUNTO COM A AMEACA (v0.135.0).
    //
    // Ela existia porque o espelho falava no ch2 e a placa obedeceria a
    // propria voz. Com o espelho no ch3/ch4 o ch2 e SO entrada, e manter
    // a recusa deixaria a cadeia B pela metade — defesa orfa e a que
    // sobrevive ao inimigo.
    //
    // A voz propria continua barrada, e por um caminho mais simples: os
    // canais 3 e 4 NAO TEM VINCULO NENHUM no mapa, entao caem na recusa
    // por canal logo abaixo, contados. Endereco que nao existe nao
    // precisa de defesa dedicada.
    //
    // E o que protege contra o laco de verdade nao e canal, e a JANELA
    // DE AUTORIA: o widget ouve o ch3, reage, e manda no ch1 — mesmo
    // canal de sempre. Nenhuma separacao de canal pega isso; so a janela
    // por param pega.
    if(cotuca::EhCanalEspelho(ch)) { eco_proprio++; return; }
    // O fio ainda carrega o que foi enderecado a versao anterior.
    if(boot_dreno_ate && (int32_t)(hal::NowMs() - boot_dreno_ate) < 0)
    { cc_dreno_boot++; return; }
    // CANAL SEM VINCULO NENHUM: recusado e CONTADO.
    //
    // No voo A so 1 e 2 endereçam. 3 e 4 ainda nao existem como saida do
    // espelho, mas a recusa ja vale para eles e para qualquer outro —
    // defesa que so nasce junto com a ameaca chega atrasada, e esta e
    // barata porque o canal virou parte do endereço: um CC que chega
    // num canal sem vinculo simplesmente nao acha dono.
    if(!cotuca::EhCanalEntrada(ch))
    {
        cc_canal_errado++;
        if(ch < kCanaisInv && cc_visto[ch][cc] < 255) cc_visto[ch][cc]++;
        return;
    }
    // CC de COMANDO: nao e parametro, nao passa pela quarentena, nao
    // entra no mapa. Borda de subida so.
    if(cc == kCcSync)
    {
        static bool armado = true;
        if(value >= 64)
        {
            if(armado) { armado = false; MidiPushEstado(); }
        }
        else
            armado = true;
        return;
    }

    // Registrado ANTES de qualquer recusa: a pergunta que esta trava
    // responde e "o fio de volta funciona?", e ela nao depende de o
    // firmware ter obedecido a mensagem.
    ouvi_controlador++;

    const uint32_t now = hal::NowMs();

    // O PARAM SE RESOLVE ANTES DA JANELA, e a ordem inverteu de proposito.
    //
    // Antes a janela era consultada por CC e o param so aparecia la na
    // frente. Com a multiplexacao o CC nao identifica mais o assunto, e
    // consultar a janela antes de saber o param silenciaria a cadeia
    // errada — o drive da A calando o drive da B.
    const int pid = manifest.FindMidiParam(ch, cc);

    // INVENTARIO por (canal, cc): registrado ANTES de qualquer recusa,
    // porque a pergunta que ele responde e "isto chegou alguma vez", e
    // essa pergunta nao depende de o firmware ter obedecido.
    if(ch < kCanaisInv && cc_visto[ch][cc] < 255) cc_visto[ch][cc]++;

    // CC que chega num canal sem vinculo: nao move nada, e e CONTADO.
    // Sem o contador isto seria indistinguivel de "o widget nao mandou",
    // que e o erro que custou uma sessao inteira em 2026-08-22.
    // ---- CC DE COMANDO: nao tem param, e morreria na linha abaixo ----
    //
    // O 121 nao e um param — e uma ordem. Passa-lo pelo mapa exigiria
    // inventar um param falso so para o transportar, e esse param
    // apareceria no `list`, no preset e no espelho: tres sitios onde
    // ele nao existe.
    //
    // Ate 2026-09-01 isto NAO EXISTIA. O `PRESETS-LISTA.md` descrevia o
    // desenho e nada o implementava, entao os botoes de preset do Loopy
    // eram inertes — documento a descrever intencao como se fosse
    // comportamento, que e uma armadilha para quem o le.
    //
    // ⚠️ E A PRIMEIRA TENTATIVA FICOU A JUSANTE DESTE PORTAO, o que a
    // tornou codigo morto: `FindMidiParam` devolve -1 para o 121, e o
    // `pid < 0` descartava-o antes. O comando nunca corria, e o unico
    // sintoma era nao acontecer nada — indistinguivel de nao ter
    // chegado.
    if(cc == cotuca::Manifest::kCcPresetLoad)
    {
        // A QUARENTENA VALE PARA ELE TAMBEM, e mais do que para um
        // param: um dump de reconexao BLE com um 121 velho carregaria
        // um preset a meio da peca. Param errado corrige-se com o dedo;
        // PRESET errado troca o instrumento inteiro numa mensagem.
        if(quar_block_to && now < quar_block_to) { cc_quarentena++; return; }
        CarregaPresetPorCc(ch, value);
        midi.NoteApplied();
        return;
    }

    if(pid < 0) { cc_sem_dono++; return; }

    // JANELA DE AUTORIA, agora por PARAM. Descarte CONTADO — descarte
    // mudo e a familia proibida: defesa que trabalha calada e
    // indistinguivel de defesa que nao existe, e foi assim que o laco do
    // canal 2 passou.
    if(NaJanela(pid, now)) { cc_janela++; return; }
    // Passou a janela: o Loopy e o autor deste valor e ja o conhece,
    // entao o espelho nao deve devolve-lo.
    eco_ult[pid] = value;

    // 1) Bloqueio confirmado: o CC e REGISTRADO pelo parser (ja
    //    aconteceu antes daqui) mas nao encosta em parametro.
    if(quar_block_to)
    {
        if(now < quar_block_to)
        {
            cc_quarentena++;
            return;
        }
        quar_block_to = 0;
    }

    const uint32_t gap = quar_last_ms ? (now - quar_last_ms) : 0xFFFFFFFFu;
    quar_last_ms       = now;

    // 2) Primeiro CC depois de silencio longo: abre a duvida.
    if(gap > kQuarSilenceMs)
    {
        quar_win    = now ? now : 1u;
        quar_seen_n = 0;
        quar_held_n = 0;
    }

    // 3) Dentro da janela: SEGURA, nao aplica.
    if(quar_win && (now - quar_win) <= kQuarWindowMs)
    {
        bool ja = false;
        for(int i = 0; i < quar_seen_n; i++)
            if(quar_seen[i] == cc) ja = true;
        if(!ja && quar_seen_n < kQuarHoldMax)
            quar_seen[quar_seen_n++] = cc;
        if(quar_held_n < kQuarHoldMax)
            quar_held[quar_held_n++] = {ch, cc, value};

        if(quar_seen_n >= kQuarDistinct)
        {
            // ---- A DEFESA VIROU ESTORVO (2026-08-18) ----
            //
            // A quarentena nasceu porque o despejo de reconexao punha
            // `src_mix` e `gate_thresh` em valores perigosos e emudecia
            // o instrumento. Duas decisoes do dB mataram essa premissa
            // no mesmo dia:
            //
            //   1. os params de roteamento e seguranca SAIRAM do mapa —
            //      o que nao esta mapeado nao pode ser derrubado;
            //   2. os defaults do que o MIDI alcanca foram a ZERO, e o
            //      Loopy (que so transmite) virou a fonte da verdade.
            //
            // Com isso o despejo deixou de ser ataque e virou a
            // INICIALIZACAO desejada. A defesa passou a descartar
            // exatamente o que o instrumento precisa: 5 mensagens
            // chegaram no boot e ZERO foram aplicadas.
            //
            // Entao ela vira SENSOR: continua detectando e contando
            // (diagnostico util — reconexao e evento que se quer ver),
            // e para de descartar. Libera o que estava seguro.
            QuarFlush();
            ble_reconnects++;
            // CARIMBA A BASE DA SESSAO. Ate 2026-08-22 este contador era
            // LIDO e nunca ESCRITO: o `ble` imprimia
            // `CcCount() - ble_session_base` com a base congelada em
            // zero, ou seja, o TOTAL rotulado como "msgs da sessao".
            // Pior que zero-com-cara-de-dado — numero plausivel e
            // errado, que ninguem tem como desconfiar. Uma reconexao
            // e o inicio de sessao que o rotulo sempre prometeu.
            ble_session_base = midi.CcCount();
            hal::BlackboxWrite(87, (float)ble_reconnects);
            hal::Log("ble: (re)conexao detectada — %d CCs distintos em"
                     " <%lu ms. APLICADOS: com defaults em zero, o"
                     " despejo do controlador E a inicializacao.",
                     quar_seen_n, (unsigned long)kQuarWindowMs);
            quar_win    = 0;
            quar_seen_n = 0;
            return;
        }
        if(false)
        {
            // CONFIRMADO. Descarta o que estava seguro — inclusive os
            // tres primeiros, que e o ponto inteiro deste desenho.
            cc_quarentena += (uint32_t)quar_held_n;
            quar_held_n   = 0;
            quar_win      = 0;
            quar_block_to = now + kQuarBlockMs;
            ble_reconnects++;
            hal::BlackboxWrite(87, (float)ble_reconnects);
            hal::BlackboxWrite(89, (float)cc_quarentena);
            hal::Log("ble: DUMP DE RECONEXAO barrado — %d CCs distintos"
                     " em <%lu ms apos silencio. %lu CCs recusados,"
                     " %lu ms de quarentena.",
                     quar_seen_n, (unsigned long)kQuarWindowMs,
                     (unsigned long)cc_quarentena,
                     (unsigned long)kQuarBlockMs);
        }
        return;
    }

    // 4) Janela expirou sem dump: libera o segurado, na ordem.
    if(quar_win)
        QuarFlush();

    ApplyCcNow(ch, cc, value);
}

static void OnMidiByte(uint8_t b) { midi.Byte(b); }

// ============================================================
// MIDI SCOPE — o analisador que a gente nao tem no bolso
//
// Duas colunas: hex CRU e o que o PARSER CONCLUIU. Byte igual
// significa coisas opostas conforme o estado (0x45 e "data1 de um CC"
// ou "orfao" dependendo do que veio antes), entao mostrar so o hex
// seria mostrar metade.
//
// ORCAMENTO: escreve pelo hal::Log, que descarta em vez de esperar.
// Em rajada o scope tem BURACOS, e isso e projeto, nao defeito —
// ferramenta de diagnostico que segura o loop e o proximo DelayMs
// (battle_scars cap. 7). Os CONTADORES nunca mentem; o stream sim.
// ============================================================
static int      mscope_mode = 0; // 0 = off, 1 = stream, 2 = stats
static uint32_t msc_msgs = 0, msc_last_s = 0, msc_win_msgs = 0;

static const char* VerdictoStr(cotuca::MidiVerdict v)
{
    using V = cotuca::MidiVerdict;
    switch(v)
    {
        case V::RealTime:     return "realtime";
        case V::StatusCanal:  return "status canal";
        case V::StatusSystem: return "status system (cancela running)";
        case V::SysexInicio:  return "sysex inicio";
        case V::SysexCorpo:   return "sysex corpo";
        case V::SysexFim:     return "sysex fim";
        case V::DadoOrfao:    return "?? DADO SEM STATUS";
        case V::DadoParcial:  return "data parcial";
        case V::MsgCompleta:  return "MSG COMPLETA";
        case V::Truncada:     return "!! TRUNCADA (ressync)";
    }
    return "?";
}

static void OnMidiTrace(uint8_t b, cotuca::MidiVerdict v, uint8_t status,
                        int n_data)
{
    using namespace cotuca;
    using V = cotuca::MidiVerdict;
    if(v == V::MsgCompleta) { msc_msgs++; msc_win_msgs++; }
    if(mscope_mode != 1)
        return;
    // Decodifica o que der: CC completo vira nome de param e valor real.
    if(v == V::MsgCompleta && (status & 0xF0) == 0xB0)
    {
        const uint8_t cc  = midi.History(0).cc;
        const uint8_t val = midi.History(0).value;
        const int     pid = manifest.FindMidiParam((uint8_t)(status & 0x0F), cc);
        if(pid >= 0)
            hal::Log("  %02X  CC ch%d cc%d val%d -> %s %.3f", b,
                     (status & 0x0F) + 1, cc, val, params.Name(pid),
                     (double)params.Real(pid));
        else
            hal::Log("  %02X  CC ch%d cc%d val%d -> (fora do mapa)", b,
                     (status & 0x0F) + 1, cc, val);
        return;
    }
    hal::Log("  %02X  %s%s", b, VerdictoStr(v),
             (v == V::DadoParcial && n_data == 1) ? " (data1)" : "");
}



// Fonte que alimenta o módulo: crossfade das entradas + tom de teste.
// Estático porque o callback de áudio não aloca. 64 > block_size (48).
// TEM que ser >= ao block_size da placa. Com 64 e bloco 128, o clamp
// abaixo processaria metade do bloco e deixaria a outra metade do
// buffer de saida com lixo do bloco anterior — sem erro, com ruido.
// >= ao maior block_size que o manifest pode pedir (48/128/256).
static constexpr size_t kMaxBlock = 256;
static float            src_buf[kMaxBlock];


// REVERB — bloco permanente do shell, não módulo. Ver reverb.h pras
// duas razões (pool de SRAM a 92,4% e a natureza fim-de-linha).
// Pico de saida por balde de pitch (13 semitons da cerca dos buzios).

// ---- ESPACO POR CADEIA ----
//
// DUAS SALAS DE VERDADE, e a razao e que shimmer NAO e um efeito ao
// lado do reverb: ele E o reverb realimentado com pitch. Pra cadeia A
// ter shimmer e a B ter sala limpa, cada uma precisa da propria — nao
// ha como uma sala so ser molhada de dois jeitos ao mesmo tempo.
//
// Custo medido: +99 us a sala, +182 us o shimmer. Pior caso (as duas
// com shimmer) da 807 us contra teto de 850 — cabe, e o teto de soma
// existe exatamente pra esse limite.
struct Espaco
{
    cotuca::Reverb      reverb;
    bool                reverb_ok = false;
    cotuca::Shimmer     shimmer;
    cotuca::EffectSlot  shimmer_slot;
    cotuca::PitchEngine pitch;      // motor proprio: o shimmer le a cauda
    bool                pitch_ok  = false;
    float*              pitch_mem = nullptr;
    cotuca::Suave       suave;      // rampa da chave da sala
    uint32_t            pico_us   = 0;
};
static Espaco esp[cotuca::Manifest::kCadeias];
static cotuca::Reverb reverb;
static bool           reverb_ok = false;

// FREEZE — bloco permanente do shell, no lugar que era do módulo do Fx2
// na cadeia. Ver freeze.h pro porquê de ser C++ e não módulo externo.
//
// O buffer vai pra SDRAM via AllocBig e ISSO ESTA CERTO, ao contrário
// do reverb, que teve que sair de lá. A diferença é o PADRAO DE
// ACESSO, que a etapa 4 do IFA10000 existe pra perguntar:
//
//   reverb : 48 leituras ESPALHADAS por amostra (8 combs + 4 allpass,
//            estéreo) — cada uma num buffer diferente, cada uma um
//            provável miss. SDRAM custou +12,9 pontos de CPU.
//   freeze : 4 leituras SEQUENCIAIS por amostra (2 grãos x 2 canais),
//            avançando uma posição por amostra. A linha de cache
//            trazida serve as próximas 16 leituras.
//
// Mesma região, custo diferente, porque a pergunta certa nunca foi
// "quantos bytes" e sim "de que jeito".
// UM FREEZE POR CADEIA. Cada uma congela SEU material no SEU instante;
// um freeze so, alimentado pela soma, congelaria os dois juntos — e o
// gesto e justamente pegar um material enquanto o outro segue vivo.
static cotuca::Freeze freeze_c[cotuca::Manifest::kCadeias];
static bool           freeze_c_ok[cotuca::Manifest::kCadeias] = {};
static float*         freeze_c_mem[cotuca::Manifest::kCadeias] = {};
static cotuca::Freeze freeze;
// 2 s estéreo a 48 kHz = 192 000 floats = 768 KB. Dois segundos porque
// é o que sustenta uma batida inteira da escultura com cauda; abaixo
// de ~1 s a varredura volta ao início rápido demais e o ouvido acha o
// laço, que é exatamente o defeito que este bloco existe pra não ter.
static constexpr float kFreezeSeconds = 2.0f;

// MOTOR DE PITCH COMPARTILHADO — um buffer, ate 4 vozes. Ver pitch.h e
// docs/CTOS.md §5b. Shimmer, detune e warble consomem ESTE, em vez de
// cada um alocar o seu: e onde o "compartilhado" vira economia real.
//
// 100 ms basta pra faixa util (0.5x a 2x): subindo uma oitava, a
// leitura se aproxima da gravacao em um grao por grao, e a folga de
// partida cobre isso com margem. 9600 floats = 38 KB.
// 400 ms, nao 100. Os 100 ms cobriam o MINIMO pra leitura nao alcancar
// a gravacao, e isso travava o grao em 25 ms (teto cap/4). Duas razoes
// independentes pedem grao longo, e as duas apareceram no mesmo dia:
//
//   MEDIR: janela de 25 ms tem largura de banda de ~40 Hz e laterais a
//   80 Hz — portadora e lateral quase encostadas. Encurtar o grao NAO
//   ajuda: afasta as laterais e alarga a portadora na mesma proporcao.
//   Com 100 ms, banda ~10 Hz e laterais a 20 Hz: portadora legivel.
//
//   SOAR: grao curto e granular audivel ("chuvisco"); o shimmer quer
//   cauda lisa. O freeze ja tinha mostrado isso na etapa 9.
//
// Custo: 38 400 floats = 150 KB em SDRAM, acesso sequencial.
static constexpr float     kPitchSeconds = 0.40f;

// VALIDACAO ISOLADA (etapa 2 do IFA10000 pro motor): rota de teste que
// substitui o sinal pela leitura deslocada, 100% molhado, pra medir a
// frequencia de saida por FFT. Nao e caminho de producao — o shimmer
// so entra depois que isto passar.

// PECA 2 EM VALIDACAO: o motor de pitch e o primeiro efeito a rodar
// dentro de um EffectSlot. Escolhido em vez do freeze porque o freeze
// tem cauda de 2 s aprovada de ouvido, e o fade do slot e outra coisa
// (bypass de 8 ms) — envolver o freeze agora poria duas rampas
// disputando o mesmo gesto.
//
// O slot entrega tres coisas de uma vez: fade sem clique, custo ZERO
// desligado, e a cronometragem por efeito que faltava (o `ctos` media
// so o freeze).

// ---- SHIMMER: motor PROPRIO, no ponto de derivacao da cauda ----
//
// Motor separado do `pitch` porque "compartilhado" e afirmacao sobre a
// FONTE, nao sobre o recurso (docs/CTOS.md §5b, correcao de 2026-08-18). O
// shimmer grava a SAIDA DO REVERB — e a cauda que sobe de oitava e
// realimenta; detune e warble vao gravar o seco, noutro ponto.
static cotuca::PitchEngine pitch_tail;
static bool                pitch_tail_ok  = false;
static cotuca::Shimmer     shimmer;
static cotuca::EffectSlot  shimmer_slot;

// DRIVE — primeiro da cadeia, zero memoria. Fecha a classe "sem
// historico" e valida o EffectSlot nela.
static cotuca::EffectSlot drive_slot;

// PHASER — depois do drive, antes do delay. Zero buffer, mas N
// multiplicacoes por amostra: a regua do drive vale, trabalho nao e
// memoria. `bypass_style: cut` — sem cauda, corta seco (nao ha nada
// decaindo pra deixar terminar).
static cotuca::EffectSlot phaser_slot;

// WARBLE — deriva de fita. Buffer minusculo (40 ms mono = 7,5 KB), em
// SRAM: acesso e uma leitura interpolada por amostra, perto da cabeca
// de escrita, entao cabe na cache sem esforco.
static cotuca::EffectSlot warble_slot;

// DETUNE — motor PROPRIO no ponto pos-modulo. Terceiro ponto de
// derivacao (seco / cauda do reverb / pos-modulo), e o unico dos cinco
// que consome DUAS vozes do mesmo buffer: o caso que o "compartilhado"
// previa desde o desenho.
// I/O: balanco da entrada e largura da saida. Nascem no NEUTRO (1.0)
// pra nao produzirem um fade-in de estreia que ninguem pediu.
static cotuca::Suave       suave_gl, suave_gr;

// DELAY EM C++ — substitui o modulo externo em 2026-08-20. Era o ultimo
// consumidor daquele runtime no instrumento. Ver delay.h: o grafo do
// patch foi lido do export e reproduzido, feedback 0.4 incluido.
static cotuca::Delay       delay_fx;
static bool                delay_ok  = false;
static float*              delay_mem = nullptr;
static constexpr float     kDelaySeg = 1.0f;   // teto do tempo
static cotuca::Suave       suave_dly, suave_rev;

// LEVEL SUAVIZADO — o master de saida era o UNICO ganho aplicado cru.
//
// Medido em 2026-08-27 pelo ouvido do dB: mover o fader do `level` depressa
// produzia um clique. A causa e de forma, nao de valor: o `level` era
// lido UMA vez por bloco e multiplicado igual nas 48 amostras, entao
// cada bloco era um degrau. A 48 kHz sao 1 ms por degrau — inaudivel
// quando o movimento e lento, e um transiente quando nao e.
//
// O projeto ja tinha a ferramenta e ja a usava no gate, no delay, no
// reverb e na chave da sala. Faltava no ganho mestre, que e justamente
// onde qualquer salto aparece INTEIRO na amplitude, sem nada a seguir
// que o disfarce.
static cotuca::Suave       suave_pre;

// TOM DE TESTE, UM SUAVIZADOR POR CADEIA. Carrega `tone_mix` e
// `tone_dest` JUNTOS, porque do ponto de vista do audio eles sao a mesma
// grandeza: quanto deste tom entra NESTA cadeia. O `dest` era um `if`
// inteiro — ligava e desligava o tom de uma amostra para a outra, que e
// o degrau maximo possivel.
static cotuca::Suave       suave_tom[cotuca::Manifest::kCadeias];
// Via DIRETA: um por SAIDA, pela mesma razao de rampa. Chamavam-se
// `_e`/`_j` de exciter e jack, nomes que a chave DPDT tornou falsos:
// para onde a saida vai e decisao de cobre, nao de firmware.
static cotuca::Suave       suave_dir_l, suave_dir_r;

// ---- MATRIZ DE ROTEAMENTO 2x2 ----
//
// Qual CADEIA entra em qual SAIDA. Ate 2026-08-28 isto era codigo fixo com
// as quatro celulas ligadas (`out[0] = out[1] = A + B`), e a matriz
// cheia reproduz exatamente esse som.
//
// AS RAMPAS VIVEM NUM BUFFER, e nao ha jeito mais barato: tres
// contribuicoes diferentes precisam do MESMO valor suavizado na MESMA
// amostra — o seco, o freeze e o espaco. Chamar `Passo()` em cada uma
// adiantaria o filtro tres vezes por amostra, e a rampa deixaria de
// ser a rampa. Entao passa-se UMA vez, guarda-se, e os tres leem.
//
// Indice: [2*c + 0] = cadeia c -> OUT_L, [2*c + 1] = cadeia c -> OUT_R.
// Custo: 4 x 256 x 4 = 4 KB de SRAM, estatico, sem alocacao.
// ---- TAROLATOR, um por cadeia ----
// Custa ~17 us cada (medido em A/B no mesmo binario) e por isso NAO entra
// na ordem de sacrificio: efeito que so some sob carga desapareceria
// exatamente quando se toca forte.
static cotuca::Tarol       tarol[cotuca::Manifest::kCadeias];
static cotuca::Suave       suave_tarol[cotuca::Manifest::kCadeias];

// ---- NOTCH ANTI-MICROFONIA, um por cadeia ----
static cotuca::Notch       notch[cotuca::Manifest::kCadeias];
static bool                notch_vivo[cotuca::Manifest::kCadeias] = {false, false};

// ---- CACADOR DE FREQUENCIA ----
//
// O QUE ELE RESOLVE: sem isto, saber a frequencia que grita exige
// interface de audio e um portatil. Na galeria nao ha nem um nem
// outro, e a peca e replicada em serie — cada uma com a sua soldadura
// e os seus modos. O instrumento tem de saber medir-se a si proprio.
//
// TRAVESSIA DE CONTEXTO, e ela e o risco deste bloco. O callback
// ESCREVE, o laco LE. A disciplina e a mesma que a do anel de MIDI,
// que travou a placa em 2026-08-28 por perseguir um ponteiro vivo:
//
//   callback: enche ate ao fim, poe `cheio=true`, e PARA de escrever
//   laco:     so le quando `cheio`, e limpa a flag quando acaba
//
// Assim nao ha corrida — ha um dono de cada vez, e a flag e o bastao.
// `volatile` nos dois lados porque o compilador nao sabe que existe
// outro contexto.
// N=2048: 43 ms de janela, passo de bin de 23,4 Hz.
//
// COMECOU EM 1024 E SUBIU DEPOIS DA PRIMEIRA CACA REAL. A parabola
// resolve a PRECISAO do pico, mas nao resolve a SEPARACAO: com bins de
// 46,9 Hz, tudo abaixo de uns 200 Hz cabia em quatro bins e o resto de
// DC mandava. Doze KB e barato ao lado de um cacador que so serve
// acima de 200 Hz.
static const int           kCacaN = 2048;
static float               caca_buf[kCacaN];
// Os dois do FFT. 8 KB, e vivem aqui em vez de na pilha porque a pilha
// do laco nao tem 8 KB para dar.
static float               caca_re[kCacaN];
static float               caca_im[kCacaN];
static volatile int        caca_i    = 0;
static volatile bool       caca_cheio = false;
static volatile bool       caca_quer  = false;   // o laco pediu
static volatile int        caca_cad   = 0;       // de que RAMO (0=L, 1=R)

// ---- VIGIA: a placa caca sozinha, sem o ida-e-volta da serie ----
//
// POR QUE ELA EXISTE, e o numero que a impos: cada captura olha 43 ms
// de audio. Pedida pela serie, o ciclo inteiro leva ~1,3 s — ou seja,
// olha-se 3% DO TEMPO. Na primeira sessao apanhou-se a microfonia por
// sorte (dois acertos em vinte e cinco pedidos); na segunda, com o
// instrumento a gritar na mesma, nao se apanhou NADA.
//
// Instrumento de medida com 3% de ciclo util nao mede: amostra. E
// amostragem esparsa de um evento raro devolve "nao ha evento" com a
// mesma cara com que devolveria a verdade.
//
// NAO BLOQUEIA O LACO. A tentacao era um `while` de vinte segundos
// dentro do comando — e teria parado o MIDI, os botoes e os encoders.
// Isto e maquina de estados: uma captura por passagem, e o laco faz o
// resto entre elas.
static bool                vigia_on  = false;
static uint32_t            vigia_ate = 0;
static int                 vigia_cad = 0;
static const int           kVigiaQ   = 6;
static float               vigia_hz[kVigiaQ];
static float               vigia_db[kVigiaQ];
static float               vigia_dm[kVigiaQ];
static int                 vigia_n[kVigiaQ];
static int                 vigia_q = 0;
static uint32_t            vigia_voltas = 0;
// LIMIAR AJUSTAVEL, e a razao e economica: fixa-lo obriga a gravar
// para o afinar, e cada gravacao apaga o estado todo. O primeiro
// valor (-25 dB) apanhou a microfonia forte e deixou passar o que
// sobrou depois dos dois notches — que era exactamente o alvo
// seguinte. Instrumento de medida com limiar fixo so serve para a
// primeira medicao.
static float               vigia_piso = -25.f;
// Volume por ramo, dos pots. SUAVIZADO porque e ganho por amostra e o
// param vem em degraus — a mesma escada que ja mordeu o `level`, o
// `tone_mix`, o `tone_dest` e o `in_gain`. Quinta ocorrencia da forma.
static cotuca::Suave       suave_post_l, suave_post_r;

static cotuca::Suave       suave_mat[4];
static float               mat_g[4][kMaxBlock];

// ---- TETO DE SOMA DO CTOS ----
//
// IRMAO DO WATCHDOG, NAO SUBSTITUTO. O watchdog por-efeito pega o
// efeito BUGADO — um que sozinho estoura seu orcamento tem defeito, e o
// veto e justo porque ha culpado. Este pega N efeitos SAUDAVEIS que
// juntos nao cabem no prazo. Nao ha culpado, e procurar um fabricaria
// injustica: qualquer regra de "quem foi" acabaria punindo o inocente.
//
// A politica e PRIORIDADE DECLARADA no manifest, decidida a frio pelo
// dB. O sistema no calor nao escolhe nada: le a ordem e obedece.
//
// MEDE O BLOCO INTEIRO, nao a soma de estimativas. Estimativa some
// justamente no caso que importa (interacao, cache, estreia); o
// cronometro do bloco e o unico numero que corresponde ao que de fato
// acontece.
static constexpr float    kTetoFrac      = 0.85f;  // do prazo do bloco
static constexpr uint32_t kBlocosSeguidos = 4;     // ~4 ms antes de agir
// CARENCIA DEPOIS DE CADA QUEDA. Zerar o param NAO faz o efeito parar de
// custar: o EffectSlot desce por rampa e continua processando enquanto
// desce. Sem esperar, o mecanismo mede de novo antes da propria acao
// surtir efeito, ve o bloco ainda alto e derruba o proximo — MEDIDO: com
// teto em 620 e bloco em 626, caiu o detune E o phaser, quando o detune
// (-125 us) sozinho ja resolvia. Um efeito perdido a mais do que o
// necessario e exatamente o que a politica de prioridade existe pra
// evitar.
//
// 250 blocos ~ 250 ms: folgado pras rampas de 8 ms e curto o bastante
// pra que um estouro real nao fique sustentado. A cauda de 2 s do freeze
// nao cabe nesta janela, e nao deve caber: durante ela o custo ESTA la, e
// uma segunda queda seria correta.
static constexpr uint32_t kCarenciaBlocos = 250;
static uint32_t soma_us        = 0;   // ultimo bloco medido
static uint32_t soma_pico_us   = 0;
static uint32_t soma_seguidos  = 0;
static uint32_t soma_quedas    = 0;
static uint32_t soma_carencia  = 0;   // blocos restantes de espera
static uint32_t soma_teto_us   = 0;   // 0 = automatico (kTetoFrac do prazo)
static uint32_t soma_teto_forc = 0;   // != 0 = teto artificial, so pra teste
static bool     soma_caiu[cotuca::Manifest::kMaxSacrificaveis]   = {false};
static uint32_t soma_caiu_ms[cotuca::Manifest::kMaxSacrificaveis] = {0};
static uint32_t soma_caiu_us[cotuca::Manifest::kMaxSacrificaveis] = {0};
// QUAL CRITERIO DERRUBOU. Com dois criterios agindo, "CAIU pelo teto"
// para ambos e relatorio que perde a informacao mais util: carga
// SUSTENTADA acima do orcamento e PICOS estourando o prazo pedem
// consertos diferentes, e o registro nao pode confundi-los.
static bool     soma_caiu_est[cotuca::Manifest::kMaxSacrificaveis] = {false};
static bool     soma_sem_saida = false;
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
int main(void)
{
    using namespace cotuca;
    hal::Init();
    // A `.itcm_text` mora gravada na QSPI e RODA na ITCM. Copiar aqui,
    // antes de qualquer chamada pra la — e depois do hal::Init(),
    // porque a copia usa cache e o cache e configurado la dentro.
    cotuca::qspi::CopiaParaItcm();
    params.Init();
    manifest.Init(params);

    const uint32_t falhas = CheckRequirements();
    if(falhas)
    {
        // ---- PARAGEM QUE SE EXPLICA, e as duas metades sao precisas ----
        //
        // A versao anterior piscava a 5 Hz para sempre e dizia o erro UMA
        // vez. As duas coisas falharam juntas em 2026-08-31, e custaram meia
        // hora de caca no sitio errado:
        //
        //   - a MENSAGEM sai no boot, para um host que ainda nao esta a
        //     escutar. Depois disso a placa nunca mais diz nada. E o
        //     "alarme de boot que se perde", agora numa forma sem depois:
        //     nao ha comando a que perguntar, porque o laco principal
        //     nunca comeca.
        //   - o PISCAR era mudo: 5 Hz constante nao distingue qual dos
        //     tres requisitos falhou, nem sequer se distingue de outro
        //     defeito qualquer. Eu li "pisca sem parar" e fui procurar um
        //     travamento, quando a placa estava a recusar arrancar de
        //     proposito.
        //
        // Agora: o LED conta o CODIGO de cada falha, com a mesma gramatica
        // do instrumento de fase (N piscadas, pausa) — quem esta na
        // bancada ja sabe le-la —, e o texto REPETE-SE, para que ligar a
        // serial a qualquer momento mostre o motivo.
        hal::Log("=== RECUSA DE ARRANQUE — cerebro errado para este"
                 " instrumento ===");
        DizRequisitos(falhas);
        hal::Log("  o LED conta o codigo de cada falha: N piscadas, pausa,"
                 " e repete.");
        uint32_t ciclo = 0;
        while(1)
        {
            // Um codigo por volta, ciclando entre os que falharam: mostrar
            // so o primeiro esconderia os outros, e a bancada consertaria
            // um de cada vez sem saber quantos faltam.
            int cod = 0;
            for(int i = 0; i < 3 && !cod; i++)
            {
                const int k = (int)((ciclo + (uint32_t)i) % 3u);
                if(falhas & (1u << k)) cod = k + 1;
            }
            ciclo++;
            for(int p = 0; p < cod; p++)
            {
                hal::SetLed(true);  hal::DelayMs(150);
                hal::SetLed(false); hal::DelayMs(150);
            }
            hal::DelayMs(1200);
            // O TEXTO REPETE a cada volta. Quem ligar a serial daqui a uma
            // hora ve o motivo, que era exatamente o que faltava.
            if((ciclo % 3u) == 0u) DizRequisitos(falhas);
        }
    }

    // Tamanho de bloco é decisão de INSTRUMENTO, não de placa: define
    // a latência, e num instrumento realimentado a latência é parte do
    // laço acústico.
    //
    // TEM QUE VIR ANTES DO Init DOS MÓDULOS. O Module::Init recebe
    // hal::Info().block_size e o repassa ao prepareToProcess, que
    // dimensiona os buffers internos por ele. Pedir o bloco DEPOIS
    // deixava os módulos preparados pra 48 enquanto o callback
    // entregava 256 — estouro de heap silencioso nos blocos vizinhos
    // do alocador. Mesma familia dos outros bugs de ordem desta
    // funcao: quem configura tem que vir antes de quem consome.
    hal::RequestBlockSize(manifest.req.block_size);


    // Salvaguarda (c): bench_boost TEM que nascer em 1.0. Hoje não
    // existe persistência de cena, então isto nunca dispara — é
    // tripwire pro dia em que existir. Um boost de 8x restaurado em
    // silêncio seria a escultura gritando no palco sem explicação.
    {
        const float b = params.Real(manifest.p_bench_boost[0])
                        + params.Real(manifest.p_bench_boost[1]) - 1.f;
        if(b != 1.0f)
            hal::Log("AVISO: bench_boost nasceu em %.2f e nao 1.00 — "
                     "ferramenta de bancada NAO deve persistir", b);
    }

    for(int c = 0; c < cotuca::Manifest::kCadeias; c++)
        cad[c].gate.Init(hal::Info().sample_rate);
    gov_l.Init(hal::Info().sample_rate);
    gov_r.Init(hal::Info().sample_rate);
    lim_l.Init(hal::Info().sample_rate);
    lim_r.Init(hal::Info().sample_rate);
    shift_l.Init(hal::Info().sample_rate);
    shift_r.Init(hal::Info().sample_rate);

    // ---- MIDI ----
    // Depois do manifest.Init(): o parser recebe o canal do manifest,
    // e o mapa CC→param só existe depois dos Add(). Mesma regra de
    // ordem de configuração que vale pros bind[].
    // 0xFF = nunca visto, entao o primeiro passe do espelho empurra o
    // estado INTEIRO pro Loopy. E a resposta na direcao certa pro
    // problema que mordeu tres vezes hoje: gravar zera tudo e a tela do
    // dB continuava mostrando o valor velho. Agora a placa fala primeiro.
    for(int i = 0; i < cotuca::kMaxParams; i++) eco_ult[i] = 0xFF;
    // Armado DEPOIS do hal::Init(), porque `NowMs()` antes dele nao tem
    // base de tempo valida — a mesma pre-condicao que derrubou o vigia
    // do loop em 2026-08-22 (bts 12z).
    boot_dreno_ate = hal::NowMs() + kDrenoBootMs;
    // O MAPA DE PRESET E O HASH SE CONSTROEM DEPOIS DO manifest.Init(),
    // porque os dois LEEM a tabela ja povoada. Ler antes daria um mapa
    // vazio e um hash de nada — e o hash de nada bate com o hash de
    // nada, entao todo preset passaria na conferencia (P2 do audit:
    // quem configura vem antes de quem consome).
    pmapa.Construir(params);
    mapa_hash = cotuca::MapaHash(params);
    hal::Log("presets: mapa 0x%04X | %d por cadeia + %d global%s",
             (unsigned)mapa_hash, pmapa.n_cadeia, pmapa.n_global,
             pmapa.estourou ? "   *** ESTOUROU o teto por preset ***" : "");
    // ENCODERS INICIALIZAM NO BOOT, e nao no primeiro `enc`.
    //
    // Ate a v0.169.0 o `EncoderInit` so era chamado pelo comando de
    // diagnostico, e o `EncoderPoll` do laco retornava cedo enquanto
    // isso. Consequencia: girar antes de digitar `enc` nao contava nada
    // — e o sintoma era desconcertante, porque o `encpino` (que tem
    // GPIOs proprios) mostrava as fases COMUTANDO enquanto o contador
    // ficava em zero.
    //
    // Isso me custou uma rodada de diagnostico de HARDWARE: cheguei a
    // mandar o dB conferir o comum do encoder no multimetro, e o comum
    // estava certo. Instrumento nao inicializado le zero, e zero pareceu
    // dado — a familia de sempre, agora no codigo que eu mesma escrevi
    // para caca-la.
    //
    // E o defeito estava ANOTADO ha horas, com estas palavras: "os
    // encoders nao funcionam ate alguem digitar `enc`, o que e
    // inaceitavel quando o painel for tocar". Deixei para depois.
    hal::EncoderInit();
    midi.Init(manifest.midi_channel, OnMidiCc);
    midi.SetTrace(OnMidiTrace);
    hal::SetMidiByteCallback(OnMidiByte); // é isto que liga a UART
    hal::Log("MIDI: canal %s, %d CCs mapeados",
             manifest.midi_channel == kMidiOmni ? "omni"
                                                : "fixo (ver `midi`)",
             manifest.n_midi);

    // REVERB: aloca ANTES do StartAudio — familia (B) da regra de
    // ordem, quem configura vem antes de quem consome. O callback
    // rodando com reverb_ok false so passa direto; rodando com buffer
    // meio-alocado leria memoria alheia.
    //
    // O `FloatsNeeded` e perguntado ao proprio reverb: este arquivo nao
    // conhece as afinacoes do Freeverb, e o dia em que a taxa mudar o
    // tamanho acompanha sozinho. Fixar um numero aqui seria a mesma
    // armadilha do r_window com 2048 numa FFT de 1024.
    {
        const float  sr   = hal::Info().sample_rate;
        const size_t need = cotuca::Reverb::FloatsNeeded(sr);
        const size_t have = sizeof(reverb_mem[0]) / sizeof(reverb_mem[0][0]);
        for(int c = 0; c < cotuca::Manifest::kCadeias; c++)
        {
            esp[c].reverb_ok = esp[c].reverb.Init(sr, reverb_mem[c], have);
            esp[c].suave.Init(sr, 20.f, 0.f);
            esp[c].shimmer.Init(sr);
            esp[c].shimmer_slot.Init(sr, 8.f, 2000.f); // cauda de 2 s
        }
        reverb_ok = esp[0].reverb_ok;
        suave_gl.Init(hal::Info().sample_rate, 20.f, 1.f);
        suave_gr.Init(hal::Info().sample_rate, 20.f, 1.f);
        // Chaves nascem FECHADAS (0): default zero, como todo param
        // alcancavel por MIDI.
        suave_dly.Init(hal::Info().sample_rate, 20.f, 0.f);
        suave_rev.Init(hal::Info().sample_rate, 20.f, 0.f);
        // Nasce em 0 como o param: os params deste instrumento nascem
        // todos em zero por regra, entao nao ha rampa de estreia a evitar.
        suave_pre.Init(hal::Info().sample_rate, 20.f, 0.f);
        for(int c = 0; c < cotuca::Manifest::kCadeias; c++)
            suave_tom[c].Init(hal::Info().sample_rate, 20.f, 0.f);
        suave_dir_l.Init(hal::Info().sample_rate, 20.f, 0.f);
        suave_dir_r.Init(hal::Info().sample_rate, 20.f, 0.f);
        // A MATRIZ NASCE EM 1, ao contrario dos vizinhos: o param dela
        // tambem nasce em 1 (ver manifest), e um suavizador que nascesse
        // em 0 daria um fade-in de 20 ms no primeiro bloco — audivel, e
        // ninguem o pediu.
        for(int i = 0; i < 4; i++)
            suave_mat[i].Init(hal::Info().sample_rate, 20.f, 1.f);
        suave_post_l.Init(hal::Info().sample_rate, 20.f, 1.f);
        suave_post_r.Init(hal::Info().sample_rate, 20.f, 1.f);
        for(int c = 0; c < cotuca::Manifest::kCadeias; c++)
        {
            tarol[c].Init(hal::Info().sample_rate);
            suave_tarol[c].Init(hal::Info().sample_rate, 20.f, 0.f);
            notch[c].Init(hal::Info().sample_rate);
        }
        comp_l.Init(hal::Info().sample_rate);
        comp_r.Init(hal::Info().sample_rate);
        {
        }
        // Loga OS DOIS numeros. Se a taxa mudar e o `need` passar o
        // `have`, o reverb recusa (passthrough) e o log diz por que —
        // em vez de rodar lendo memoria alheia, que e o que um
        // buffer curto faria em silencio.
        hal::Log("espaco: sala A %s | sala B %s (%u de %u floats cada,"
                 " %u KB em SRAM no total)",
                 esp[0].reverb_ok ? "pronta" : "BUFFER CURTO",
                 esp[1].reverb_ok ? "pronta" : "BUFFER CURTO",
                 (unsigned)need, (unsigned)have,
                 (unsigned)(sizeof(reverb_mem) / 1024));
    }

    // MOTOR DE PITCH: alocar e inicializar ANTES do StartAudio, mesma
    // regra de ordem do reverb e do freeze.
    {
        const float  sr   = hal::Info().sample_rate;

        // Motor da cauda + shimmer. Mesmo tamanho de buffer: a oitava
        // acima exige a mesma folga de partida.
        // UM MOTOR DE PITCH POR ESPACO. Cada shimmer le a cauda da SUA
        // sala; um motor compartilhado misturaria as duas e o shimmer
        // de A ouviria o reverb de B.
        const size_t need_t
            = cotuca::PitchEngine::FloatsNeeded(sr, kPitchSeconds);
        for(int c = 0; c < cotuca::Manifest::kCadeias; c++)
        {
            esp[c].pitch_mem = (float*)hal::AllocBig(need_t * sizeof(float));
            if(esp[c].pitch_mem)
                esp[c].pitch_ok = esp[c].pitch.Init(sr, esp[c].pitch_mem,
                                                    need_t, kPitchSeconds);
        }
        hal::Log("motores de pitch: A %s | B %s (%u KB cada em SDRAM)",
                 esp[0].pitch_ok ? "pronto" : "SEM BUFFER",
                 esp[1].pitch_ok ? "pronto" : "SEM BUFFER",
                 (unsigned)(need_t * sizeof(float) / 1024));
        // DELAY: 1 s a 48 kHz = 192 KB. Vai pra SDRAM pelo portao
        // unico (`AllocBig`), como os motores de pitch — nao cabe no
        // pool de SRAM e nao deve competir com ele.
        {
            const size_t nd = cotuca::Delay::FloatsNeeded(sr, kDelaySeg);
            delay_mem = (float*)hal::AllocBig(nd * sizeof(float));
            if(delay_mem)
                delay_ok = delay_fx.Init(sr, delay_mem, nd, kDelaySeg);
            hal::Log("delay: %s (%.0f ms max, %u KB em SDRAM, feedback %.2f)",
                     delay_ok ? "pronto" : "SEM BUFFER — passthrough",
                     (double)(kDelaySeg * 1000.f),
                     (unsigned)(nd * sizeof(float) / 1024),
                     (double)cotuca::Delay::kFeedback);
        }
        for(int c = 0; c < cotuca::Manifest::kCadeias; c++)
        {
            Cadeia& k = cad[c];
            k.drive.Init(sr);   k.drive_slot.Init(sr, 8.f);
            k.phaser.Init(sr);  k.phaser_slot.Init(sr, 8.f);
            k.warble_ok = k.warble.Init(sr, warble_mem[c],
                                        sizeof(warble_mem[c])
                                            / sizeof(warble_mem[c][0]), 40.f);
            k.warble_slot.Init(sr, 8.f);
        }
        hal::Log("warble: A %s | B %s (40 ms cada, %u KB em SRAM no total)",
                 cad[0].warble_ok ? "pronto" : "BUFFER CURTO",
                 cad[1].warble_ok ? "pronto" : "BUFFER CURTO",
                 (unsigned)(sizeof(warble_mem)/1024));
        // CAUDA DE 2 s NA SAIDA (pedido do dB). Entrar e imediato;
        // sair e decaimento — o shimmer E a sala se empilhando, e sala
        // nao para de existir quando alguem solta o botao.
        shimmer_slot.Init(sr, 8.f, 2000.f);
        hal::Log("shimmer: %s (motor da cauda, %u KB em SDRAM)",
                 pitch_tail_ok ? "pronto" : "SEM BUFFER — inativo",
                 (unsigned)(need_t * sizeof(float) / 1024));
    }

    // FREEZE: mesma regra de ordem do reverb — alocar e inicializar
    // ANTES do StartAudio. E o tamanho é PERGUNTADO ao freeze, nunca
    // fixado aqui: se a taxa mudar, o pedido acompanha sozinho.
    {
#if COTUCA_FREEZE_ENABLED
        const float  sr   = hal::Info().sample_rate;
        const size_t need = cotuca::Freeze::FloatsNeeded(sr, kFreezeSeconds);
        for(int c = 0; c < cotuca::Manifest::kCadeias; c++)
        {
            freeze_c_mem[c] = (float*)hal::AllocBig(need * sizeof(float));
            if(freeze_c_mem[c])
                freeze_c_ok[c] = freeze_c[c].Init(sr, freeze_c_mem[c], need,
                                                  kFreezeSeconds);
        }
        hal::Log("freeze: A %s | B %s (%.1f s, %u KB cada em SDRAM)",
                 freeze_c_ok[0] ? "pronto" : "SEM BUFFER",
                 freeze_c_ok[1] ? "pronto" : "SEM BUFFER",
                 (double)kFreezeSeconds,
                 (unsigned)(need * sizeof(float) / 1024));
#else
        hal::Log("freeze: DESLIGADO no build (bisseccao)");
#endif
    }

    // ---- CAPACIDADE DAS TABELAS: DENUNCIA NO BOOT ----
    // Em 2026-08-18 os dois tetos estouraram no mesmo dia, os dois EM
    // SILENCIO: `kMaxParams` recusou tres params (os buzios inteiros
    // sumiram) e `kMaxMidiMap` deixou a 17a entrada ser escrita FORA
    // DO ARRAY (o `shm_shift` chegava e nao achava dono).
    if(manifest.midi_overflow > 0)
        hal::Log("ERRO: %d entradas do mapa MIDI RECUSADAS (kMaxMidiMap)."
                 " Os ULTIMOS CCs declarados NAO respondem.",
                 manifest.midi_overflow);
    if(params.Overflow() > 0)
        hal::Log("ERRO: %d parametros RECUSADOS (kMaxParams). Os ULTIMOS"
                 " declarados NAO existem.", params.Overflow());
    hal::Log("tabelas: %d params (teto %d) | %d CCs (teto %d)",
             params.Count(), (int)cotuca::kMaxParams,
             manifest.n_midi, (int)cotuca::kMaxMidiMap);

    hal::SetSerialLineCallback(HandleLine);
    // ---- CONSOLA SEM FIO: o mesmo interpretador, por outro cano ----------
    //
    // ⚠️ E O MESMO `HandleLine`, DE PROPOSITO. Dois interpretadores para os
    // mesmos comandos seria a familia que este projecto mais persegue: duas
    // fontes do mesmo facto, a derivar em silencio. Aqui muda o TRANSPORTE,
    // nunca o significado — quem chega por radio executa exactamente o que
    // chega pelo cabo, e um comando novo aparece nos dois sem trabalho.
    midi.SetSysexCallback(ConsolaSysex);

    hal::StartAudio(AudioCb);
    hal::Log("Cotucatronics OS v" COTUCA_OS_VERSION " [%s] — pronto.",
             hal::Info().name);
    // Toda a SDRAM do projeto passa por AllocBig(). Este log é o extrato:
    // se um módulo alocar escondido, o número aqui não fecha.
    hal::Log("SDRAM via AllocBig: %u de %u bytes",
             (unsigned)hal::AllocBigUsed(),
             (unsigned)hal::Info().big_ram_bytes);

    // ---- A ABERTURA ----
    //
    // DEPOIS do StartAudio, de proposito: o instrumento ja soa enquanto a
    // jogada corre. Um splash que atrasa o audio troca 2,5 s de som por
    // 2,5 s de enfeite, e nesta casa isso nao se troca.
    //
    // ⚠️ SEMENTE FRACA NO ARRANQUE, e digo-o. O `rng_state` dos buzios so
    // gira DENTRO do laco (uma soma aurea por volta), e aqui o laco ainda
    // nao deu volta nenhuma: vale 0. Entao semeio do relogio, que no boot
    // varia pouco — a jogada de arranque e quase sempre a mesma. A do
    // despertar, essa sim, apanha o `rng_state` ja girado por milhoes de
    // voltas, e ai a jogada e diferente de cada vez.
    if(hal::OledConfigurado() || hal::OledInit())
    {
        abertura.Versao("v" COTUCA_OS_VERSION);
        splash_semeia_em = hal::NowMs() + kColheitaMs;
        if(!splash_semeia_em) splash_semeia_em = 1u;   // 0 significa "feito"
    }

    // Tick de ~1 ms. Nada de bloqueio longo aqui: o serial responde na
    // hora e o LED vira heartbeat contado, não um sleep de meio segundo.
    constexpr uint32_t kLedToggleTicks = 500; // 500 ms aceso / 500 apagado

    bool     led  = false;
    uint32_t tick = 0;

    // Último valor lido de cada knob físico. Ver a DECISÃO DE
    // PRIORIDADE no topo: o knob só escreve quando MUDOU, senão ele
    // reescreveria o parâmetro a cada ~1 ms e venceria MIDI e serial
    // sempre — "última escrita vence" viraria "o knob vence", sem que
    // ninguém tivesse decidido isso.
    //
    // -2 e um valor impossivel (ReadKnob devolve -1 ou 0..1), entao a
    // primeira leitura real sempre conta como mudanca.
    float knob_last[kNumKnobs];
    for(int k = 0; k < kNumKnobs; k++)
        knob_last[k] = -2.f;

    // RASTREADOR DE FASE. O batimento provou que o loop MORRE (2816
    // ticks contra 1,07 milhao de blocos de audio), mas nao onde. Cada
    // etapa carimba o slot 12 ANTES de rodar; depois do reset, o
    // numero que sobrou e a ultima etapa que ele entrou — e a proxima
    // linha depois dela e a que trava. Uma store por etapa.
    // VOO ENXUTO (bancada 2026-08-16). A instrumentacao cresceu ate
    // ~20 escritas em backup SRAM por volta, cada uma com
    // SCB_CleanDCache_by_Addr — e o padrao observado (degrada 8x, DEPOIS
    // para) e compativel com o observador virando o assassino.
    //
    // kDiagFull=false deixa so DUAS escritas por volta: voltas e
    // carimbo. E o DelayMs sai junto, porque o outro suspeito do mesmo
    // tamanho e o relogio: DelayMs(1) que engole tick durante as
    // rajadas de 3,4 ms do callback explicaria os ~8 ms/volta sem
    // culpar o cache — e relogio quebra de vez, cache degrada linear.
    static constexpr bool kDiagFull = false;
    // ============================================================
    // DelayMs FORA DO LOOP — o assassino, nomeado por medicao.
    //
    // Dois voos, uma variavel trocada, instrumentacao identica:
    //   sem DelayMs : 8 748 683 voltas, vivo aos 58,7 s
    //   com DelayMs :        1 516 voltas, morto aos 12,7 s
    //
    // E o carimbo diz o mecanismo: ele e escrito IMEDIATAMENTE ANTES do
    // delay. O loop chegou la aos 12 674 ms e nunca mais voltou — entrou
    // e nao saiu. Com o callback pesado segurando a CPU em rajadas
    // de ~3,4 ms, a espera baseada em tick engole tick e em algum
    // momento nao termina.
    //
    // Por que simplesmente TIRAR e seguro, e nao remendo: o delay era
    // cortesia de CPU, e o audio roda por INTERRUPCAO — o loop girando
    // livre nao lhe rouba nada. A unica coisa que dependia da cadencia
    // do loop era a rampa do sorteio, e ela agora e funcao do relogio,
    // nao contagem de voltas. Tirar o metronomo deixou de ter efeito
    // colateral no exato patch em que o metronomo deixou de existir.
    // ============================================================
    static constexpr bool kUseDelay = false;
    // FASE publica em `loop_fase` ALEM da caixa-preta. A caixa-preta so
    // se le pela serial, e a serial morre junto com o loop: o dado
    // existia, o caminho ate ele e que estava morto.
    #define FASE(n) do { loop_fase = (uint8_t)(n); \
                        loop_snap = ((uint32_t)(n) << 24) \
                                  | ((uint32_t)loop_sub << 16) \
                                  | (loop_voltas & 0xFFFFu); \
                        if(kDiagFull) cotuca::hal::BlackboxWrite(12, (float)(n)); } while(0)
    // SUB so tem sentido dentro da fase 2; a `FASE()` limpa-a ao sair,
    // senao um numero velho sobreviveria a mudanca de rua.
    #define SUB(n) do { loop_sub = (uint8_t)(n); \
                        loop_snap = ((uint32_t)loop_fase << 24) \
                                  | ((uint32_t)(n) << 16) \
                                  | (loop_voltas & 0xFFFFu); } while(0)

    while(1)
    {
        // Declarado NO TOPO: quem configura vem antes de quem consome.
        // (`voando` saiu: era a condicao que prendia o registador de voo ao
        //  `buzios_on`. Ver o bloco das escritas 28/29 mais abaixo.)
        FASE(1);
        // Knobs físicos. Pares do MIDI e do serial: quem mexeu por
        // último vence. Hoje ReadKnob() devolve -1 (sem pot ligado) e
        // este laço não faz nada — a guarda de mudança existe pro dia
        // em que os pots chegarem, porque sem ela o MIDI para de
        // funcionar em silêncio no mesmo dia.
        for(int k = 0; k < hal::Info().num_knobs && k < kNumKnobs; k++)
        {
            const float cru = hal::ReadKnob(k);
            if(cru < 0.f) continue;              // sem pot: -1, fora do dominio

            // 1) SUAVIZA. O ADC treme, e a guarda antiga era
            //    `if(v == knob_last[k])` — igualdade de float sobre ruido
            //    NUNCA dispara. O comentario que estava aqui previa a
            //    consequencia com estas palavras: "sem ela o MIDI para de
            //    funcionar em silencio no mesmo dia". Previa certo: o pot
            //    escreveria o param a cada volta do laco e ganharia sempre.
            // ADOCAO NA PRIMEIRA LEITURA. No arranque ninguem escreveu
            // ainda o param, entao a verdade e a POSICAO FISICA do pot —
            // e um volume que nasce longe de onde o botao esta e a
            // primeira coisa que assusta quem liga o instrumento. Depois
            // disto vale a captura, que protege do salto.
            if(!knob_vivo[k])
            {
                knob_filt[k] = cru;
                knob_vivo[k] = true;
                knob_dono[k] = true;
                knob_passo[k] = (int)(cru * 127.f + 0.5f);
                knob_last[k] = (float)knob_passo[k] / 127.f;
                manifest.knob[k].Apply(params, knob_last[k]);
                continue;
            }
            knob_filt[k] += kKnobSuave * (cru - knob_filt[k]);
            const float v = knob_filt[k];

            const int alvo = manifest.knob[k].PrimeiroAlvo();
            if(alvo < 0) continue;
            const float pos = manifest.knob[k].Inverso(params.Get(alvo));
            if(pos < 0.f) continue;              // macro sem inverso util

            // 2) CAPTURA SUAVE. O pot e ABSOLUTO e o param e partilhado
            //    com o MIDI e a serial. Sem captura, tocar no pot salta o
            //    param para a posicao fisica dele — o mesmo defeito que fez
            //    os encoders serem escolhidos RELATIVOS no painel v2.
            //
            //    Ele so assume quando PASSA pelo valor actual, e larga
            //    quando alguem escreve por outro caminho. A janela de
            //    largar e maior que a de capturar de proposito: iguais,
            //    ficariam a trocar de dono na fronteira.
            if(!knob_dono[k])
            {
                if(fabsf(v - pos) > kKnobCaptura) continue;
                knob_dono[k] = true;
            }
            else if(fabsf(v - pos) > kKnobSolta)
            {
                knob_dono[k] = false;            // o iPad mexeu: recaptura
                continue;
            }

            // 3) QUANTIZA NO PASSO DO FIO, COM HISTERESE.
            //
            //    O param sai daqui em 7 bits de qualquer forma — pelo
            //    espelho, pelo preset, pelo iPad. Fazer o pot mais fino que
            //    isso nao ganha resolucao nenhuma e ganha ruido: e a
            //    fronteira entre dois passos que treme.
            //
            //    So se muda de passo quando o valor a ultrapassa com
            //    margem. Sem histerese, um valor parado em cima da
            //    fronteira alterna para sempre — que e o que produzia 623
            //    escritas por segundo com os pots parados.
            //    ⚠️ A MARGEM CONTA-SE A PARTIR DA FRONTEIRA, NAO DO CENTRO.
            //
            //    Ate v0.205.0 a condicao era `|em_passos - passo| < 0.35`,
            //    e o `passo` vinha de ARREDONDAR AO MAIS PROXIMO — que
            //    deixa um resto de ate 0.5, MAIOR que os 0.35 exigidos.
            //    Para qualquer posicao cujo resto caisse entre 0.35 e 0.5,
            //    a guarda nunca fechava: o laco reescrevia o MESMO valor a
            //    cada volta, para sempre, com o pot imovel.
            //
            //    Nao era so desperdicio. Cada escrita abre a janela de
            //    silencio de 250 ms, entao o `level` ficava PERMANENTEMENTE
            //    surdo ao Loopy — um pot parado a calar o iPad. Medido a
            //    2026-08-31: 210 150 janelas em 20 s parado, o ritmo do laco.
            //
            //    O ruido nao tinha culpa: medido no mesmo instante, 0.23
            //    passos de pico-a-pico. Uma guarda mal posta imita ruido, e
            //    eu quase acusei o ADC — outra vez.
            const float em_passos = v * 127.f;
            const float atual     = (float)knob_passo[k];
            if(fabsf(em_passos - atual) < 0.5f + kKnobHist) continue;
            knob_passo[k] = (int)(em_passos + 0.5f);
            if(knob_passo[k] < 0)   knob_passo[k] = 0;
            if(knob_passo[k] > 127) knob_passo[k] = 127;
            knob_last[k] = (float)knob_passo[k] / 127.f;
            manifest.knob[k].Apply(params, knob_last[k]);

            // O POT E AUTOR, e fecha a recepcao daquele param — pedido do
            // dB, e tapa uma corrida real.
            //
            // Ate aqui a janela era aberta pelo TRANSMISSOR: o pot
            // escrevia, e so quando o `MidiEspelha` mandasse — fase 7, ate
            // 8 ms depois e no maximo dois params por passagem — e que o
            // `quiet_until` abria. Nesse intervalo um CC do Loopy entrava e
            // sobrescrevia o gesto em curso. Com o pot a varrer, e uma
            // corrida que ele perde de vez em quando: o fader "prende" a
            // meio do movimento e ninguem sabe porque.
            //
            // Autor abre a janela no instante em que escreve, e nao quando
            // alguem o anuncia. Mesma regra que ja vale para o widget do
            // Loopy — quem mexeu ultimo manda, e tem 250 ms de sossego.
            //
            // TODOS os alvos da macro, nao so o primeiro: uma macro de tres
            // alvos protegeria um e deixaria dois expostos.
            {
                const uint32_t ate = hal::NowMs() + kJanelaMs;
                for(int a = 0; a < manifest.knob[k].TargetCount(); a++)
                {
                    const int id = manifest.knob[k].Alvo(a);
                    if(id >= 0 && id < cotuca::kMaxParams)
                    {
                        quiet_until[id] = ate;
                        knob_janelas++;
                    }
                }
            }
        }
        // ---- VIGIA ANTI-MICROFONIA ----
        if(vigia_on)
        {
            if((int32_t)(hal::NowMs() - vigia_ate) > 0)
            {
                vigia_on = false; caca_quer = false;
                hal::Log("VIGIA: %lu capturas | %d frequencia(s) fortes",
                         (unsigned long)vigia_voltas, vigia_q);
                if(!vigia_q)
                    hal::Log("  nada acima do chao — nao gritou nesta janela.");
                for(int i = 0; i < vigia_q; i++)
                {
                    int m = i;   // sao seis: ordena a imprimir
                    for(int j = i + 1; j < vigia_q; j++)
                        if(vigia_db[j] > vigia_db[m]) m = j;
                    if(m != i)
                    {
                        float t; int ti;
                        t = vigia_hz[i]; vigia_hz[i] = vigia_hz[m]; vigia_hz[m] = t;
                        t = vigia_db[i]; vigia_db[i] = vigia_db[m]; vigia_db[m] = t;
                        t = vigia_dm[i]; vigia_dm[i] = vigia_dm[m]; vigia_dm[m] = t;
                        ti = vigia_n[i]; vigia_n[i] = vigia_n[m]; vigia_n[m] = ti;
                    }
                    hal::Log("  %2d) %8.1f Hz | pico %+7.1f dB | %4d vez(es)"
                             " | dom %.2f", i + 1, (double)vigia_hz[i],
                             (double)vigia_db[i], vigia_n[i], (double)vigia_dm[i]);
                }
                if(vigia_q)
                    hal::Log("  poe a mao com `set notch1_hz_%c <hz>` +"
                             " `set notch1_db_%c 12` (idem notch2)",
                             vigia_cad ? 'b' : 'a', vigia_cad ? 'b' : 'a');
            }
            else if(caca_cheio)
            {
                vigia_voltas++;
                float med = 0.f;
                for(int i = 0; i < kCacaN; i++) med += caca_buf[i];
                med /= (float)kCacaN;
                float e0 = 0.f;
                for(int i = 0; i < kCacaN; i++)
                { caca_re[i] = caca_buf[i] - med; e0 += caca_re[i] * caca_re[i]; }
                if(e0 > 1e-9f)
                {
                    float nv = -200.f, dm = 0.f;
                    const float hz = cotuca::Espectro::Pico(
                        caca_re, caca_im, kCacaN, hal::Info().sample_rate,
                        100.f, 8000.f, &nv, &dm);
                    // O CHAO MEDIDO DESTA PECA e -43 dB e a microfonia
                    // real deu +45. O limiar fica no meio, bem longe
                    // dos dois — nao ha ambiguidade nesta faixa.
                    if(hz > 0.f && nv > vigia_piso)
                    {
                        int achou = -1;
                        for(int i = 0; i < vigia_q; i++)
                            if(hz > vigia_hz[i] * 0.96f && hz < vigia_hz[i] * 1.04f)
                            { achou = i; break; }
                        if(achou < 0 && vigia_q < kVigiaQ)
                        {
                            achou = vigia_q++;
                            vigia_hz[achou] = hz; vigia_db[achou] = -200.f;
                            vigia_dm[achou] = 0.f; vigia_n[achou] = 0;
                        }
                        if(achou >= 0)
                        {
                            vigia_n[achou]++;
                            // Guarda a frequencia do INSTANTE MAIS FORTE,
                            // e nao a media do grupo: media entre um pico
                            // alto e um vizinho fraco aponta para onde
                            // nao mora modo nenhum.
                            if(nv > vigia_db[achou])
                            { vigia_db[achou] = nv; vigia_hz[achou] = hz;
                              vigia_dm[achou] = dm; }
                        }
                    }
                }
                caca_cheio = false; caca_quer = false;
            }
            else if(!caca_quer)
            {
                caca_i = 0; caca_cheio = false;
                caca_cad = vigia_cad; caca_quer = true;
            }
        }

        FASE(2);
        SUB(1);   // PollSerial -> HandleLine -> Log -> TransmitInternal
        hal::PollSerial();
        // ---- ENCODERS, no laco ----
        {
            SUB(2);   // niveis crus dos encoders + VarreTudo
            const uint16_t m = hal::EncoderNiveisCrus();
            enc_ja_baixo |= m;
            enc_ja_alto  |= (uint16_t)(~m & 0x1FFu);
            const int* dummy; const int nl = hal::PinosVarridos(&dummy);
            if(hal::VarreTudoAtivo())
            {
                const uint32_t w = hal::VarreTudo();
                const int* d2; const int nt = hal::PinosTodos(&d2);
                var_tudo_baixo |= w;
                var_tudo_alto  |= (~w) & ((nt >= 32) ? 0xFFFFFFFFu
                                                     : ((1u << nt) - 1u));
            }
            SUB(3);   // varredura dos pinos livres
            const uint32_t v = hal::VarreLivres();
            var_ja_baixo |= v;
            var_ja_alto  |= (~v) & ((nl >= 32) ? 0xFFFFFFFFu
                                              : ((1u << nl) - 1u));
        }
        SUB(4);   // EncoderPoll + os tres encoders (G intermitente)
        hal::EncoderPoll();
        for(int e = 0; e < cotuca::hal::kNumEncoders; e++)
        {
            EstadoEnc& st = enc_st[e];
            const int  inc  = hal::EncoderIncremento(e) * enc_sinal[e];
            const bool push = hal::EncoderPushBorda(e);


            // ---- O PRIMEIRO GESTO SO ACENDE ----
            //
            // Pedido do dB, e e regra de OPERACAO, nao de codigo: com o
            // painel apagado, quem gira nao ve o que esta a mudar. Se o
            // primeiro gesto ja mexesse no valor, o utilizador alterava
            // as cegas e so descobria depois de a tela acender — e nao
            // saberia de quanto.
            //
            // Entao o gesto que acorda e ENGOLIDO: o incremento e a
            // borda de push sao lidos (para nao ficarem na fila e
            // dispararem depois) e DEITADOS FORA. A partir do segundo
            // gesto, tudo normal.
            //
            // ⚠️ Ler e descartar, e nao "nao ler": `EncoderIncremento` e
            // `EncoderPushBorda` CONSOMEM o evento. Deixa-los por ler
            // guardaria o gesto para a volta seguinte, e ele acabaria
            // por ser aplicado na mesma — so que atrasado, que e pior.
            const bool houve = inc || push || hal::EncoderPushNivel(e);
            if(houve && !enc_na_tela)
            {
                // PAINEL APAGADO: engole, e ADIA o acender. Cada evento
                // empurra a marca para a frente, entao rodar sem parar
                // mantem tudo engolido e a tela apagada.
                //
                // ⚠️ Ler e DEITAR FORA, e nao "nao ler": os leitores
                // CONSOMEM o evento, e deixa-lo por ler aplicava-o na
                // volta seguinte — atrasado, que e pior que logo.
                oled_gesto_ate = hal::NowMs() + kOledGestoMs;
                if(!oled_gesto_ate) oled_gesto_ate = 1u;
                st.push_agora  = hal::EncoderPushNivel(e);
                continue;
            }
            if(houve) AcendePainel();          // ja aceso: so adia o sono

            if(inc)
            {
                st.crus += inc;
                st.ultimo_dir = inc;
                // Divisao com RESTO guardado: sem ele, dividir por 4
                // perderia ate tres pulsos a cada troca de sentido, e a
                // perda apareceria como "o encoder as vezes nao anda".
                st.resto += inc;
                while(st.resto >= enc_por_detente)
                { st.resto -= enc_por_detente; st.passos += 1; AplicaAcel(st, +1); }
                while(st.resto <= -enc_por_detente)
                { st.resto += enc_por_detente; st.passos -= 1; AplicaAcel(st, -1); }
            }
            if(push) st.pushes++;
            st.push_agora = hal::EncoderPushNivel(e);
        }

        SUB(5);   // OLED por SPI
        // ---- A ABERTURA: um quadro por periodo, NUNCA um laco de espera ----
        if(splash_semeia_em)
        {
            ColheEntropia();
            if((int32_t)(hal::NowMs() - splash_semeia_em) >= 0)
            {
                splash_semeia_em = 0;
                rng_state ^= ent_acc ^ hal::NowTicks();
                splash_semente = rng_state;
                abertura.Comeca(rng_state, false);
                splash_ativo = true;
                splash_prox  = hal::NowMs();
                // ⚠️ A QUALIDADE DA ENTROPIA E DITA, nao presumida. Se o
                // ADC estiver morto, `EntropiaAdc` devolve 0 sempre e
                // `distintas` fica em 1 — e a linha denuncia-o, em vez de
                // eu jurar que a jogada e diferente de cada vez.
                hal::Log("abertura: semente %08lX · %lu leituras distintas"
                         " do ADC em %lu ms%s",
                         (unsigned long)rng_state,
                         (unsigned long)ent_distintas,
                         (unsigned long)kColheitaMs,
                         ent_distintas < 8 ? "  <- ENTROPIA FRACA" : "");
            }
        }
        if(splash_ativo) PassoDaAbertura();
        PassoDoSupressor();
        // A marca fica no vidro, e depois APAGA. Painel aceso custa 6 dB de
        // chao de ruido (medido) — deixar a assinatura acesa para sempre
        // seria cobrar esse preco por um enfeite.
        if(splash_apaga_em && (int32_t)(hal::NowMs() - splash_apaga_em) >= 0)
        {
            splash_apaga_em = 0;
            // ⚠️ COM O PAINEL LIGADO, APAGAR NAO CHEGA: o refrescamento so
            // escreve quando o conteudo MUDA, e nada mudou enquanto a
            // abertura corria — a marca ficaria no vidro para sempre. E a
            // mesma armadilha que ja tinha impedido o painel de acender.
            if(splash_tinha_tela) ForcaRedesenhoDoPainel();
            else                  hal::OledPreenche(false);
        }
        // ---- BANCO DE ENSAIO: um quadro por periodo, sem delay ----
        if(!splash_ativo && oled_bench_on)
        {
            const uint32_t ag = hal::NowMs();
            if(oled_bench_fase == 1 && (int32_t)(ag - oled_bench_prox) >= 0)
            {
                oled_bench_prox = ag + oled_bench_ms;
                hal::OledDesenha(oled_fb);
            }
            if(oled_bench_fase == 0 && (int32_t)(ag - oled_bench_ate) >= 0)
            {
                const uint32_t dt = ag - oled_bench_t0;
                oled_voltas_seg_base = dt ? (loop_voltas - oled_bench_v0)
                                                * 1000u / dt : 0;
                hal::OledDmaEstado(nullptr, nullptr, nullptr);
                oled_bench_fase = 1;
                oled_bench_t0   = ag;
                oled_bench_ate  = ag + oled_bench_seg * 1000u;
                oled_bench_prox = ag;
                oled_bench_v0   = loop_voltas;
                hal::Log("oledbench: base %lu voltas/s — agora a desenhar.",
                         (unsigned long)oled_voltas_seg_base);
            }
            else if(oled_bench_fase == 1 && (int32_t)(ag - oled_bench_ate) >= 0)
            {
                oled_bench_on = false;
                uint32_t q, d, us;
                hal::OledDmaEstado(&q, &d, &us);
                const uint32_t dt = ag - oled_bench_t0;
                const uint32_t vs = dt ? (loop_voltas - oled_bench_v0) * 1000u / dt : 0;
                hal::Log("OLED BENCH: %lu Hz por %lu ms", 
                         (unsigned long)(1000u / (oled_bench_ms ? oled_bench_ms : 1)),
                         (unsigned long)dt);
                hal::Log("  voltas/s: %lu com o painel · %lu quieto · %+ld%%",
                         (unsigned long)vs, (unsigned long)oled_voltas_seg_base,
                         oled_voltas_seg_base
                             ? (long)((long)vs - (long)oled_voltas_seg_base) * 100
                                   / (long)oled_voltas_seg_base
                             : 0L);
                hal::Log("  quadros %lu nesta corrida · descartes %lu ·"
                         " QUADRO pico %lu us",
                         (unsigned long)(q - oled_bench_q0),
                         (unsigned long)d, (unsigned long)us);
                hal::Log("  (o \"disparo\" e o quadro INTEIRO enquanto o"
                         " caminho for bloqueante — memcpy + SPI)");
            }
        }
        // A MAO PAROU: agora sim acende. Fica aqui, e nao no laco dos
        // encoders, porque tem de correr mesmo quando NAO ha evento —
        // e "parar" e justamente a ausencia de eventos.
        if(oled_gesto_ate && (int32_t)(hal::NowMs() - oled_gesto_ate) >= 0)
        {
            oled_gesto_ate = 0;
            AcendePainel();
        }
        // ADORMECE. Subtraccao em ticks antes de comparar, que e como
        // esta casa trata a volta do uint32.
        if(oled_dorme_em && (int32_t)(hal::NowMs() - oled_dorme_em) >= 0)
        {
            oled_dorme_em  = 0;
            enc_na_tela    = false;
            oled_gesto_ate = 0;   // dormiu: o proximo gesto recomeca
            if(hal::OledConfigurado()) hal::OledPreenche(false);
            // (!) E LARGA O BARRAMENTO. A dormir nao ha o que mostrar, e
            // conduzir sinal num painel que pode ficar sem 5 V a qualquer
            // momento ja custou um modulo (bts 15fm). Ao acordar, o
            // `OledInit` volta a perguntar se ha alimentacao.
            hal::OledSolta();
            hal::Log("oled: a dormir (%lu s sem encoder) — barramento LARGADO"
                     " (nada conduzido) · o painel aceso custa 6 dB de chao",
                     (unsigned long)(kOledDormeMs / 1000u));
        }
        // ---- ENCODER NA TELA ----
        if(!splash_ativo && enc_na_tela && hal::OledConfigurado()
           && (int32_t)(hal::NowMs() - enc_tela_prox) >= 0)
        {
            char l[3][24];
            static const char* kIni[] = {"A", "B", "G"};
            bool mudou = false;
            for(int e = 0; e < cotuca::hal::kNumEncoders; e++)
            {
                const EstadoEnc& st = enc_st[e];
                snprintf(l[e], sizeof(l[e]), "%s c%+ld p%+ld #%lu%s",
                         kIni[e], (long)st.crus, (long)st.passos,
                         (unsigned long)st.pushes, st.push_agora ? " *" : "");
                if(strcmp(l[e], enc_tela_ant[e]) != 0)
                { mudou = true; snprintf(enc_tela_ant[e],
                                         sizeof(enc_tela_ant[e]), "%s", l[e]); }
            }
            if(mudou)
            {
                hal::OledLinhas(l[0], l[1], l[2]);
                // 60 ms entre desenhos: mais rapido que isso o olho nao
                // acompanha, e cada Update bloqueia o laco.
                enc_tela_prox = hal::NowMs() + 60u;
            }
        }

        // ⚠️ DUAS CHAMADAS, DOIS CARIMBOS. O `SUB(6)` cobria as duas, e
        //    quando o LED apontou 6 eu tratei-as como uma so — consertei
        //    o pump, a placa continuou a travar, e a medicao seguinte
        //    teria dito o mesmo `6`. O instrumento dava a rua; a porta
        //    exigia mais um carimbo. Foi exactamente para isto que a
        //    sub-fase nasceu (ver o cabecalho do `loop_sub`).
        //
        //    8 = dentro do MidiEspelha · 9 = dentro do MidiTxPump
        SUB(8);
        MidiEspelha();   // LOOP, nunca callback — ver cabecalho
        // O PUMP LOGO A SEGUIR AO ESPELHO, e nao no fim da volta: assim
        // o que acabou de ser enfileirado sai nesta mesma passagem, e a
        // latencia do espelho nao ganha uma volta inteira de laco.
        SUB(9);
        hal::MidiTxPump();
        hal::ConsolaPump();   // espelho da consola: so quando o MIDI esta quieto

        SUB(7);   // veredito do sync, com LogAlways
        // VEREDITO DO SYNC. Roda no laco porque so aqui o
        // `hal::PollMidi()` ja teve chance de processar o que voltou.
        if(sync_confere_ate
           && (int32_t)(hal::NowMs() - sync_confere_ate) >= 0)
        {
            sync_confere_ate = 0;
            const uint32_t voltaram = midi.CcCount() - sync_cc_antes;
            const uint32_t barrados = cc_janela - sync_jan_antes;
            if(!voltaram)
            {
                // O QUE A PLACA SABE E O QUE ELA NAO SABE, separados.
                // Ela sabe que mandou e nao ouviu; nao sabe por que, e
                // dizer "o Loopy nao esta conectado" seria escolher uma
                // das tres causas para produzir uma frase util.
                hal::LogAlways("sync: AVISO — mandei %d CCs e NADA voltou em"
                               " %lu ms.", sync_mandados,
                               (unsigned long)kSyncEsperaMs);
                // A TRAVA CORTA O ESPACO DE CAUSAS AO MEIO.
                if(OuviDoFio())
                    hal::LogAlways("      MAS o fio de volta JA FUNCIONOU neste"
                                   " voo (%lu CCs pelo FIO desde o boot). Entao"
                                   " nao e cabo nem pareamento: sao os widgets,"
                                   " que nao estao ouvindo ch%d-ch%d.",
                                   (unsigned long)OuviDoFio(),
                                   cotuca::kDeslocEspelho + 1,
                                   cotuca::kDeslocEspelho
                                       + cotuca::kNumCanaisEntrada);
                else
                    hal::LogAlways("      E a placa NUNCA ouviu o controlador"
                                   " neste voo. Restam duas: os widgets nao"
                                   " escutam ch%d-ch%d, ou o fio de volta"
                                   " (WIDI OUT -> D14) nao fecha.",
                                   cotuca::kDeslocEspelho + 1,
                                   cotuca::kDeslocEspelho
                                       + cotuca::kNumCanaisEntrada);
                hal::LogAlways("      Nao confirmado quanto ao RETORNO. A"
                               " TRANSMISSAO a placa fez: conferir no MIDI"
                               " Wrench separa as duas coisas.");
            }
            else
            {
                hal::LogAlways("sync: OK — %d CCs enviados, %lu voltaram do"
                               " controlador (%lu barrados pela janela,"
                               " nenhum desfez nada).",
                               sync_mandados, (unsigned long)voltaram,
                               (unsigned long)barrados);
                if(voltaram < (uint32_t)sync_mandados / 2)
                    hal::LogAlways("      Voltou MENOS DA METADE: o link"
                                   " responde, mas parte dos widgets pode"
                                   " estar noutra pagina ou noutro canal.");
            }
        }
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
