Belquer/Cotucatronics/src/hal.h

#pragma once
// hal.h v0.45.0
// ============================================================
// Cotucatronics OS — HAL (Hardware Abstraction Layer)
// A fronteira de independência de fornecedor.
//
// Regra de ouro: NADA fora de hal_<board>.cpp pode incluir
// headers de fabricante (daisy_seed.h, Arduino.h, etc).
// main.cpp, params, macros, manifests e módulos externos só
// conhecem este arquivo.
//
// Trocar de placa = escrever um novo hal_<board>.cpp
// e compilar com: make BOARD=<nome>
// ============================================================

#include <cstdint>
#include <cstddef>

namespace cotuca::hal
{

// ---- capacidades da placa (preenchido pela implementação) ----
struct BoardInfo
{
    const char* name;         // "Daisy Seed", "Teensy 4.1"...
    int         num_knobs;    // ADCs disponíveis no painel
    int         num_buttons;  // botões momentâneos no painel
    bool        has_audio_in; // false = só síntese/playback
    float       sample_rate;
    size_t      block_size;
    size_t      big_ram_bytes; // RAM "grande" p/ delays longos, freeze etc.
                               // Daisy: 64MB SDRAM. Placas sem: 0.
    uint32_t    cpu_hz;        // clock real do núcleo, lido da placa —
                               // não o nominal. Boost muda isto.
};

// ---- áudio ----
// Callback genérico: buffers de float não-intercalados.
// in/out[canal][amostra]. Canais fixos em 2 por simplicidade.
using AudioCallback = void (*)(const float* const* in,
                               float**             out,
                               size_t              size);

// ---- serial (painel falso / debug) ----
using SerialLineCallback = void (*)(const char* line);

// ---- MIDI ----
// O HAL entrega BYTES CRUS, um a um. Não parseia: a máquina de
// estados MIDI é board-agnostic e mora em midi.h, do lado do shell.
// A placa só sabe puxar bytes de um fio a 31250 baud.
//
// Por que byte e não mensagem: parser no HAL significaria reescrever
// o parser a cada placa nova, e é justamente o tipo de lógica que não
// muda de hardware pra hardware. O que muda é COMO os bytes chegam —
// DMA, interrupção, polling —, e isso sim é assunto da placa.
using MidiByteCallback = void (*)(uint8_t byte);

// ---- contrato que toda placa implementa ----
bool             Init();                       // clocks, codec, power
const BoardInfo& Info();
void             StartAudio(AudioCallback cb);

// Pede um tamanho de bloco. Chamar ANTES de StartAudio; depois
// dele não tem efeito. A placa pode recusar e manter o seu — o
// valor efetivo fica em Info().block_size, que é a verdade.
//
// É o manifest quem pede, não a placa quem impõe: bloco define
// LATÊNCIA, e latência é característica do instrumento.
void             RequestBlockSize(size_t block_size);
// POTS: 0.0–1.0, ou **-1 quando nao ha pot** — ausencia representada
// FORA do dominio, e nao com um zero que se confunde com pot no fundo.
// Dois canais: A0 (D15) e A1 (D16); os outros tres do bloco sao o
// encoder global.
float            ReadKnob(int index);
void             AdcInit();
bool             AdcConfigurado();
// O pot `index` esta com as pontas trocadas no cobre? Quem imprime
// diagnostico precisa saber, ou anuncia como "cru" um numero ja rodado.
bool             KnobInvertido(int index);
// O valor de COBRE do pot: sem inversao, sem batentes. Para RE-MEDIR
// onde ele de facto para — a correcao dos batentes apaga a evidencia
// dela propria, e correcao que nao se pode conferir vira folclore.
float            ReadKnobCru(int index);

// Entropia FISICA do conversor, sem relogio misturado — para quem chama
// poder medir se o ADC esta mesmo a variar. 0 = ADC nao pronto.
uint32_t         EntropiaAdc();
// Diz se cada pino do ADC esta SOLTO (segue o pull interno) ou LIGADO a
// uma fonte de impedancia baixa. Mata o ADC ate um reboot — sao os mesmos
// pinos. Ver o cabecalho no .cpp.
void             AdcSondaPinos(bool* solto_l, bool* solto_r);
// CONTROLO POSITIVO: a placa dirige o proprio pino e ve se o ADC segue.
// Prova que o par (canal, pino) esta certo antes de qualquer leitura
// valer — sonda que nao consegue devolver diferente nao mede nada.
void             AdcControloPositivo(float* al, float* bl,
                                     float* ar, float* br);
// true = PRESSIONADO. Já com debounce; quem chama vê só transições
// limpas. O contrato é NÍVEL, não evento: detectar borda é do shell,
// que é onde se sabe o que uma borda significa.
//
// Chamar do loop principal, em qualquer ritmo — o debounce é por
// tempo, não por contagem de chamadas.
bool             ReadButton(int index);        // true = pressionado
// NIVEL CRU do pino: sem debounce, sem borda, sem estado. Existe para
// responder "o botao fecha para GND?" sem passar por camada nenhuma que
// possa mascarar a resposta — mesma razao de o `pk` medir a entrada de
// audio antes de qualquer ganho. true = pino BAIXO (o que o botao faz).
bool             ButtonNivelCru(int index);
// Botao declarado NORMALMENTE FECHADO (excecao de hardware, ver o .cpp): a
// leitura LOGICA inverte-se, o nivel CRU nao. Existe para o diagnostico poder
// dizer que "sempre baixo" ali e o esperado.
bool             ButtonNormalmenteFechado(int index);

// Nivel CRU do pino ligado ao pad LB do WIDI (seed::D28), com pull-up
// interno. Devolve o que o pino le, SEM interpretacao — quem classifica
// "conectado" ou "anunciando" e o main, porque a polaridade e a legenda
// sao do modulo, nao da placa.
//
// Pull-up interno significa que pino solto le ALTO. Entao "alto
// constante" e ambiguo: pode ser LED apagado, ou fio nao ligado. O
// comando `ble` diz isso em vez de fingir que sabe.
// Le o pad LB (D28) do WIDI. Nivel CRU, sem interpretacao.
//
// ERAM TRES. LG (D29) e LR (D30) foram lidos por dois dias e NAO
// MARCARAM NADA util — removidos do hardware em 2026-08-20, com D29/D30 de
// volta ao pool de pinos livres (ver BOARDS.md).
//
// O QUE O LB INDICA SEGUE PERGUNTA ABERTA. A legenda da CME ("pisca
// lento = anunciando, fixo = conectado") foi assumida como sendo do LB
// e o dB DESMENTIU por medicao: desconectou e o LB ficou FIXO. Entao o
// LB nao e "conectado/desconectado" — e o que ele carrega ainda nao se
// sabe. A hipotese "e um dos outros dois" morreu junto com eles: LG e
// LR estao descartados como candidatos POR NAO MARCAREM, o que e
// resultado, nao ausencia de resultado.
bool             ReadWidiLed();

// Reinicia a placa DIRETO no bootloader, com timeout INFINITO — ela
// fica esperando a gravacao ate ser gravada.
//
// Isto elimina o maior atrito da bancada: a janela de ~2 s do
// bootloader depois de um RESET fisico. Esta sessao gastou umas quinze
// gravacoes tentando acertar esse tempo, e varias falharam porque o
// comando saiu depois do toque. Agora a ORDEM some do problema: a
// placa entra em DFU por comando e espera.
//
// NAO TEM VOLTA POR SOFTWARE. Uma vez em DFU, so gravar (ou um RESET
// fisico) traz o app de volta — por isso o comando exige confirmacao.
void             RebootToDfu();

// VERSAO DA IMPLEMENTACAO DO HAL, perguntada ao backend.
//
// NASCEU DE UM BUILD QUEBRADO (2026-08-25). O `board` passou a imprimir as
// versoes de modulo, e para o hal eu usei `COTUCA_HAL_VERSION` direto no
// main.cpp — macro que vive no hal_daisy_seed.cpp e portanto nao existe
// ali. Compilou zero vezes e mesmo assim foi commitado: o check_docs e os
// bancos nativos nao constroem o main.cpp para a placa.
//
// Mover a macro para ca teria resolvido o build e estragado o contrato:
// a versao da IMPLEMENTACAO nao e propriedade da interface. O contrato
// diz "cada backend sabe dizer a sua"; quem responde e quem implementa.
const char*      VersaoImpl();
void             SetLed(bool on);

// LEDs de painel, por INDICE — quem chama nao conhece pino. Cada um
// SEGUE O PARAMETRO que o manifest lhe atribuiu, nunca o gesto:
// indicador reporta estado real, nao intencao.
void             SetPanelLed(int idx, bool on);
int              PanelLedCount();
void             Log(const char* fmt, ...);    // printf via USB/serial
void             SetSerialLineCallback(SerialLineCallback cb);
void             PollSerial();                 // chamar no loop principal
void             DelayMs(uint32_t ms);

// Relogio monotonico em ms desde o boot. Existe pra INSTRUMENTACAO: um
// contador de voltas sem carimbo de tempo diz que o loop parou, mas nao
// QUANDO — e o quando e o que cruza com o evento que o matou.
uint32_t         NowMs();

// ---- MIDI: liga a porta e registra quem recebe os bytes ----
//
// Chamar UMA VEZ, no boot, antes do StartAudio. É esta chamada que
// liga a UART — placa que nunca a chama não paga periférico nenhum.
// Placa sem UART: implementa vazio, e PollMidi() nunca entrega nada.
void             SetMidiByteCallback(MidiByteCallback cb);

// Despacha os bytes acumulados. CHAMAR DO LOOP PRINCIPAL, junto com
// PollSerial() — e pelo mesmo motivo: o RX chega por interrupção, e
// rodar o parser (que mexe em params e pode logar) dentro da ISR é a
// receita do deadlock que matou o `list` na v0.2.0. A ISR só
// enfileira; quem despacha é o loop.
void             PollMidi();

// Transmite bytes crus pela MESMA porta. Existe pro teste de
// loopback (T10): com um jumper de TX pra RX, o firmware manda uma
// mensagem MIDI e ela volta pelo caminho real — UART, DMA, ISR, fila,
// parser. É a única validação que prova baud rate e pino.
// ENFILEIRA E VOLTA SEMPRE. Nunca bloqueia, nunca espera pelo mundo.
// Fila cheia = descarta o resto da mensagem e conta.
//
// ⚠️ Ate 2026-08-31 isto era um `BlockingTransmit`, e com a ponte ESP32
// desligada a placa NAO ARRANCAVA: o D14 flutuava, a USART1 entrava em
// erro, e o `MidiEspelha` ficava la dentro. Um cabo solto matava o
// instrumento. Ver hal_daisy_seed.cpp e HARDWARE.md §4.
void             MidiSendBytes(const uint8_t* bytes, size_t n);

// ESPELHO DA CONSOLA por SysEx (ppc/006 fase 1). `ConsolaPump` chama-se do
// LACO: emite um quadro por passagem e SO quando o anel do MIDI esta vazio —
// diagnostico nunca atrasa o instrumento. Melhor-esforco por desenho: o que
// nao couber e contado em `perdidos`.
void             ConsolaPump();
void             ConsolaEstado(uint32_t* quadros, uint32_t* perdidos,
                               uint32_t* na_fila);

// Chamada do LACO, uma vez por volta. Arranca a transferencia por DMA
// se houver bytes e nada em curso. Volta sempre.
void             MidiTxPump();

// Contadores da fila de TX. Qualquer ponteiro pode ser nulo.
void             MidiTxEstado(uint32_t* descartes, uint32_t* erros,
                              uint32_t* uart_err, uint32_t* bytes,
                              uint32_t* pico, uint32_t* na_fila,
                              uint32_t* recuos);
uint32_t         MidiTxRingTam();

// GANCHO DE BANCADA. Empurra um byte na fila de RX como se tivesse
// vindo do fio. Prova o parser e o mapeamento sem hardware nenhum —
// mas NÃO prova a UART, e por isso não substitui o loopback.
//
// CUIDADO: escreve no mesmo índice que a ISR do RX. Com MIDI ao vivo
// entrando, as duas escritas correm. É gancho de bancada com a porta
// silenciosa, não ferramenta de uso geral.
void             MidiInjectByte(uint8_t b);

// Diagnóstico da porta, pro comando serial `midi`.
bool             MidiRxActive();    // a escuta chegou a começar?
uint32_t         MidiDropped();     // bytes perdidos por fila cheia
// Linhas de comando RECUSADAS por passarem do tamanho maximo. Linha
// truncada nao e comando: executar metade e pior que nao executar.
uint32_t         SerialTruncadas();

// ---- ENCODERS EC11 (tres: cadeia A, cadeia B, global) ----
//
// ESTADO INDEPENDENTE POR ENCODER, e isso e requisito e nao detalhe:
// qualquer variavel compartilhada entre eles faz giro simultaneo se
// contaminar, e o sintoma seria "as vezes o global pula" — intermitente,
// que e o mais caro de todos.
//
// O `Incremento` e CRU: -1, 0 ou +1 do ultimo poll, sem divisao por
// detente e sem aceleracao. A divisao se MEDE (alguns EC11 dao dois ou
// quatro pulsos por clique) e a aceleracao e decisao de interface —
// as duas moram na camada de cima, nao aqui.
//
// LIMITE CONHECIDO: o `Debounce` da libDaisy amostra a 1 kHz e decodifica
// por padrao de quadratura. Transicao mais curta que 1 ms se perde. Por
// isso quem chama ACUMULA e CONTA, para que a perda apareca como numero
// em vez de sumir.
// UM encoder. Foram tres ate 2026-09-05; o dB fechou a interface num so, com
// combinacao de push+giro a fazer o resto e uma lista de presets simples.
//
// ⚠️ E ISSO RESOLVEU O CONFLITO DO D17 DE GRACA. O push do encoder G vivia
// no D17, que o desenho da placa queria para o divisor 100k/22k do trilho
// (A2). Os dois estavam escritos e nenhum verificador via a colisao, porque
// moravam em documentos diferentes. Nenhuma das duas saidas que se propos
// foi precisa: a decisao de INTERFACE dissolveu o problema de HARDWARE.
static constexpr int kNumEncoders = 1;
bool             EncoderInit();
// O NOME DO PINO VEM DO HAL, nao de uma lista no shell. Ate 2026-08-28 o
// `encpino` carregava os nove nomes escritos a mao: uma terceira copia
// do mapa, noutro ficheiro, que o compilador nao consegue cruzar.
const char*      EncoderPinNome(int idx, int qual);   // qual: 0=faseA 1=faseB 2=push
void             EncoderPoll();            // no LOOP, nunca no callback
int              EncoderIncremento(int idx);  // -1 / 0 / +1, CRU
bool             EncoderPushNivel(int idx);   // com debounce
bool             EncoderPushBorda(int idx);   // borda de apertar

// NIVEL CRU dos nove pinos dos encoders, antes de qualquer decodificacao.
//
// O `Increment` da libDaisy so devolve algo quando a QUADRATURA casa: se
// uma fase estiver solta, ele fica em zero para sempre e nao distingue
// "encoder parado" de "fase morta". Isto le o pino direto.
//
// Mesma forma do `pino` que inocentou a solda do freeze B: acumular
// desde o boot, sem janela, e deixar o operador girar quando quiser.
// `idx` 0..2 = encoder, `qual` 0=fase A, 1=fase B, 2=push.
bool             EncoderNivelCru(int idx, int qual);
// Amostra os NOVE pinos de uma vez, um bit por pino (1 = BAIXO).
// Existe para a trava: leitura estatica nao distingue "fase morta" de
// "fase em repouso neste detente" — so a MUDANCA distingue.
uint16_t         EncoderNiveisCrus();

// VARREDURA: le TODOS os pinos livres da Daisy, nao so os nove que eu
// supus. Existe porque supor o mapa e depois medir contra a suposicao
// so encontra o que ja se esperava — se o fio esta noutro pino, nenhum
// instrumento apontado para os nove diria isso.
//
// `mascara` recebe um bit por pino da lista `PinosVarridos()`.
int              PinosVarridos(const int** lista);
uint32_t         VarreLivres();
// VARREDURA DOS 31 PINOS — abre o ponto cego do `VarreLivres`, que so ve
// os 15 sem dono. PRECO DECLARADO: reconfigura tudo como entrada, logo
// MATA o OLED e o MIDI ate um reboot. Sonda que custa periferico so se
// liga por pedido explicito, e diz o que custou.
// REINICIO POR SOFTWARE. Existe porque o `varre tudo` so se desfaz com
// um reboot, e uma modalidade que exige o dedo de alguem para sair nao
// serve a uma bancada remota — nem a uma escultura numa galeria.
void             Reiniciar();

// ATRASO DA DRENAGEM DE MIDI. `MidiAtrasos` conta as voltas que deixaram
// bytes para tras; `MidiSobraPico`, a maior sobra vista. Zero nos dois =
// a drenagem acompanha. A subir = ela esta a perder, e foi perder PARA
// SEMPRE que travou a placa em 2026-08-28.
uint32_t         MidiAtrasos();
uint32_t         MidiSobraPico();
// O TAMANHO DO ANEL VEM DO HAL, nao de uma copia aqui. Escrevi
// `constexpr int kMidiRingTam = 256` neste ficheiro e o anel eram 128:
// uma segunda fonte que nasceu errada, no mesmo dia em que removi tres
// copias do mapa de pinos pelo mesmo motivo.
uint32_t         MidiRingTam();
int              PinosTodos(const int** lista);
uint32_t         VarreTudo();
bool             VarreTudoAtivo();

// ---- OLED (SSD1309 128x64, 4-wire SPI) ----
//
// TESTE DE VIDA, nao driver de painel. Prova que os cinco fios chegam e
// para ai — sem fonte, sem layout, sem taxa de refresh.
//
// DECLARACAO QUE PRECEDE O USO: este display NAO E DETECTAVEL. O
// barramento e TWO_LINES_TX_ONLY e o painel nunca responde, entao
// nenhuma funcao aqui pode dizer "presente". `OledInit` devolve se a
// CONFIGURACAO foi feita — o `Init` da libDaisy e `void` e nao tem o que
// reportar. Chamar isso de deteccao seria a string fixa `placa viva: sim`
// outra vez (bts, cap. instrumentacao).
// (!) RECUSA-SE a conduzir os pinos se o painel nao tiver alimentacao —
// ver `OledPainelAlimentado`. Conduzir 3,3 V num modulo sem VCC alimenta-o
// pelos diodos de proteccao das entradas e mata-o ao longo de sessoes. Ja
// morreram dois modulos. `forcar` passa por cima, para quem sabe o que faz.
bool             OledInit(bool forcar = false);

// O painel tem 5 V? Responde com o PULL-UP do proprio modulo contra o
// pull-down interno do MCU: se o modulo esta alimentado, ele ganha.
// Nao precisa de fio de retorno nenhum — e a unica realimentacao que
// este barramento so-de-escrita tem.
bool             OledPainelAlimentado();

// Larga os cinco pinos (entrada, sem pull) e marca o painel como nao
// configurado. Chama-se quando o painel adormece: a placa deixa de conduzir
// seja o que for, e o `OledInit` seguinte volta a testar a alimentacao antes
// do primeiro pino. E a segunda metade da guarda da bts 15fm — sem ela, a
// primeira so protege o arranque.
void             OledSolta();          // true = CONFIGURADO, nao detectado
void             OledPreenche(bool aceso);   // tela toda acesa/apagada
void             OledTexto(const char* l1, const char* l2);
// Tres linhas pequenas — o formato de instrumento, nao de titulo.
void             OledLinhas(const char* l1, const char* l2, const char* l3);
// ---- O UNICO PONTO DE ENTRADA NOVO DO PAINEL ----
//
// 1024 bytes em ordem de pagina do SSD1309 (`fb[pagina*128 + coluna]`),
// entregues por DMA: o laco paga o DISPARO, nao a transferencia.
//
// ⚠️ O BUFFER TEM DE SOBREVIVER A CHAMADA — o DMA le-o depois dela
// voltar. Estatico, nunca local.
//
// `false` = havia transferencia em curso e o quadro foi DESCARTADO.
bool             OledDesenha(const uint8_t* fb);
void             OledFbZeraPico();
void             OledDmaEstado(uint32_t* quadros, uint32_t* descartes,
                               uint32_t* us_pico);

bool             OledConfigurado();
// Quantos `Update` foram ao painel e quantos caracteres foram escritos.
// Sem estes dois, tela preta tem duas causas indistinguiveis: o desenho
// nao rodou, ou rodou e nao pintou.
uint32_t         OledUpdates();
uint32_t         OledChars();

// SONDA DE FIO: segura um dos cinco pinos do OLED num nivel fixo, para
// medir NO CONECTOR DO PAINEL com multimetro. Testa o percurso inteiro —
// pino, solda, fio, conector — e nao so a continuidade de um fio solto.
//
// Sem janela e sem pressa: o nivel FICA ate a proxima chamada.
//
// ATENCAO: CLK, DIN e CS pertencem ao periferico SPI. Usar a sonda neles
// os reconfigura como GPIO e o SPI para de funcionar ate um `oled` novo
// reinicializar tudo. O comando avisa.
bool             OledSondaPino(const char* nome, bool alto);

// CACA-PONTE: dirige cada pino do OLED e le os outros quatro.
//
// O teste de continuidade ponto-a-ponto NAO cobre isto: `D6 -> DC` passa
// mesmo que D6 esteja tambem em curto com D7, e dois sinais do SPI
// unidos quebram tudo sem romper nada.
//
// Devolve quantos pares suspeitos achou e preenche `achados` com a
// descricao. A placa faz sozinha o que o multimetro faria em dez
// medicoes — e sem depender de um multimetro que ja mentiu hoje.
int              OledCacaPonte(char* achados, int cap);

// LEITOR DE TRES ESTADOS dos cinco pinos do OLED: le cada um com o pull
// interno para cima e depois para baixo, e a comparacao das duas separa
//   SOLTO (segue o pull interno) · preso a TERRA · puxado para CIMA.
//
// E o que o `fio` nao sabe fazer: ele SEGURA um nivel para medir la
// fora, e um 0 V medido no conector tanto pode ser curto como ausencia.
//
// So conclui EM PAR — uma leitura com a fita ligada, outra sem — porque
// o pull-up do proprio modulo OLED e indistinguivel de um curto ao 3V3.
// Deixa os cinco sem pull e o SPI desfeito: pede `oled` a seguir.
void             OledLeCinco(bool* com_pullup, bool* com_pulldown);

// QUEM MANDA NO PINO `i` (0..4 = rst dc cs clk din) NESTE INSTANTE:
// 0 ou 1 = retido pelo `fio` nesse nivel · -1 = nao retido.
//
// (!) Existe porque uma medicao no conector so vale se a retencao ainda
// estiver de pe, e um REINICIO apaga-a sem dizer nada — devolve CLK e
// DIN ao SPI, que em repouso os deixa BAIXOS. Ler 0 V nesses dois e 3,3
// nos outros tres e o repouso NORMAL do barramento, nao avaria.
int              OledRetido(int i);

// SONDA DO SPI: faz os envios ela mesma, com a configuracao do painel, e
// relata por tamanho o CODIGO (0 = OK, 1 = ERR) e o TEMPO em us.
//
// Existe porque o driver do `SSD130x` deita fora o `Result` de cada
// envio: um quadro inteiro pode esgotar oito prazos de 100 ms e o nosso
// `oled` continua a dizer "tela ACESA". Devolve quantas linhas encheu,
// ou -1 se o proprio `Init` do SPI recusou. Toma o SPI: pede `oled`.
int              OledSondaSpi(int ps, int* tam, int* res,
                              uint32_t* us, int cap);
// Prescaler do SPI do painel, ajustavel sem gravar. Fio comprido perdoa
// menos em MHz alto — e isso se MEDE varrendo, nao se supoe.
bool             OledVelocidade(int ps);   // 2,4,8,16,32,64,128,256
int              OledVelocidadeAtual();
uint32_t         MidiErrors();      // erros de UART (overrun/framing/ruido)
uint32_t         MidiRestarts();
// Rearmes CONSECUTIVOS sem a escuta pegar. >= 4 significa que o recuo
// esta activo, ou seja: a linha de RX esta morta.
uint32_t         MidiRearmeSeguidos();
// Falso = o agrupamento de prioridades NAO e o assumido, e a prioridade
// posta na USART1 nao preempta nada. Ver o comentario no Init do MIDI.
bool             NvicGrupoOk();
// Estado CRU da USART1 e do pino PB7 — para diagnosticar sem bissectar.
void             UartDiag(uint32_t* cr1, uint32_t* cr3, uint32_t* isr,
                          uint32_t* moder, uint32_t* pupdr, uint32_t* afrl);

// Reinicio duro, igual ao botao de RESET. Nao vai para o DFU.
// Usado pelo vigia de laco, que vive no callback de audio.
void             ReiniciaAgora();
// Erros de linha limpos na ultima janela de 1 s, total, e quantas vezes
// o receptor teve de se calar por a linha estar suja demais.

// Reinicia a escuta DMA. Erro de UART pode abortar a recepcao no stack
// da ST, e ela NAO volta sozinha — o sintoma e "funcionou e parou pra
// sempre" com a porta reportando escuta ativa. O PollMidi ja rearma
// automaticamente; isto existe pro comando manual de bancada.
bool             MidiRestart();

// Aloca da RAM "grande" (SDRAM na Daisy). Chame só no boot,
// nunca no callback de áudio. Retorna nullptr se a placa não
// tem essa capacidade ou se acabou — quem chama DEVE checar.
//
// Este é o ÚNICO portão de acesso à RAM grande no projeto.
// Declarar DSY_SDRAM_BSS (ou equivalente) fora de hal_<board>.cpp
// é proibido — ver BOARDS.md.
void*            AllocBig(size_t bytes);

// Carga do bloco de áudio, 0.0–1.0 (1.0 = estourou o prazo).
// Média e pico desde o boot. Placa sem medidor devolve -1.
// Relogio do CTOS. Mede o tempo do EFEITO por bloco — CpuLoadMeter
// mede o callback inteiro e nao sabe dizer QUEM gastou; sem separar, o
// veto puniria o inocente.
//
// EM TICKS, DE PROPOSITO, e isto e a correcao de um defeito real.
// `System::GetUs()` faz `CNT / (freq/1e6)` — divide ANTES de quem chama
// subtrair. O CNT e um contador livre de 32 bits, mas o valor devolvido
// vive numa faixa muito menor: a 200 MHz, 2^32/200 = ~21,5 s. Subtracao
// uint32 so corrige a volta quando o valor usa a faixa INTEIRA; como
// nao usa, uma volta no meio da medicao produz ~4,27e9 em vez de ~100.
//
// Foi exatamente o numero que desligou o freeze num veto falso (caso 9
// do battle_scars). Medir em TICKS e converter DEPOIS da subtracao faz
// a volta se corrigir sozinha, porque o CNT ocupa os 32 bits todos.
uint32_t         NowTicks();
uint32_t         TicksPerUs();

float            CpuLoadAvg();
float            CpuLoadMax();

// Zera média e pico. Necessário pra rearmar o watchdog de módulo:
// CpuLoadMax() é monotônico, então sem reset um estouro passado
// travaria o watchdog pra sempre.
void             CpuLoadReset();

// ---- CAIXA-PRETA: memória que sobrevive ao RESET ----
//
// Existe por um motivo específico e recorrente: MEDIR O QUE SÓ
// ACONTECE DEPOIS QUE A SERIAL JÁ MORREU. Um módulo pesado derruba
// o USB alguns blocos depois de subir, e a partir daí a placa não
// tem mais como contar o que viu — todo instrumento que depende de
// log vira inútil justamente no trecho que interessa.
//
// Com isto o firmware grava DURANTE o voo e a gente lê DEPOIS do
// reset, quando o serial voltou a funcionar. É gravador de voo, não
// armazenamento: sobrevive a RESET, NÃO sobrevive a queda de
// energia, e não deve guardar nada que importe pro instrumento.
//
// Escrever é barato (uma store) e pode ser feito do callback de
// áudio. Ler é do loop principal.
//
// Slot fora da faixa é ignorado na escrita e devolve 0 na leitura.
// Depois de energizar do zero o conteúdo é lixo: Valid() diz se o
// que está lá foi escrito por uma execução anterior ou não.
void  BlackboxWrite(int slot, float value);
float BlackboxRead(int slot);
bool  BlackboxValid();   // false = ligou agora, não há voo anterior
void  BlackboxArm();     // marca "há dados"; chamar antes de gravar

// SILENCIA o Log no caminho do USB: ele passa a gravar só na caixa-
// preta. Existe porque em voo NINGUÉM lê a serial — ela morre — e as
// confirmações de comando são luxo que está custando o instrumento.
void  LogMute(bool on);
uint32_t MidiHiWater();   // pico de bytes na fila — o furo do PollMidi
uint32_t MidiRingSize();  // capacidade, pra dar sentido ao pico
bool  LogMuted();                     // o instrumento sabe que esta mudo
void  LogAlways(const char* fmt, ...); // ...e consegue dizer isso
int   BlackboxSlots();

// Total já entregue por AllocBig(), em bytes. Serve de extrato:
// o boot loga isto, e módulo que aloque por fora não aparece aqui.
size_t           AllocBigUsed();

} // namespace cotuca::hal
