Belquer/Cotucatronics/src/manifest.h

#pragma once
// manifest.h (instrumento "bancada") v3.0.0
// ============================================================
// Cotucatronics OS — MANIFEST do instrumento
// Este é o ÚNICO arquivo que muda de escultura para escultura,
// junto com o export do motor em modules/<nome>/.
//
// Instrumento de teste: "bancada" — entrada + tom de teste
// atravessando o módulo externo "delay".
// ============================================================

#include "params.h"
#include "midi.h"

namespace cotuca
{

// O que este instrumento EXIGE do cérebro. O boot confere
// contra hal::Info() e recusa rodar em placa insuficiente —
// erro claro no boot em vez de bug misterioso no palco.
struct Requirements
{
    size_t big_ram_bytes = 0;     // ex: 8MB p/ freeze longo
    bool   needs_audio_in = true; // esculturas com piezo: sim
    // DOIS, e a mudanca custou uma gravacao muda para o aprender.
    //
    // Dizia 4 desde antes de o painel existir. Ao ligar os pots baixei o
    // `num_knobs` do HAL de 5 para 2 — que e o que a placa comporta — e o
    // `CheckRequirements` recusou arrancar: exigencia 4 > disponivel 2. A
    // verificacao fez exatamente o que devia; era o REQUISITO que estava
    // velho, escrito quando ninguem sabia quantos knobs haveria.
    //
    // O sintoma foi o pior possivel de ler: "enumera e nao fala", com o
    // LED a piscar sem parar. A mensagem de erro SAI — mas sai no boot,
    // para um host que ainda nao esta a escutar, e depois disso a placa
    // entra no laco de paragem e nunca mais diz nada. Alarme de boot que
    // se perde, agora numa forma sem "depois": nao ha comando a que
    // perguntar, porque o laco principal nunca comeca.
    int    min_knobs      = 2;

    // ---- TAMANHO DE BLOCO: decisão de INSTRUMENTO ----
    //
    // Define a latência, e num instrumento realimentado a latência é
    // parte do laço acústico — mexer nela muda ONDE o feedback se
    // estabelece. Por isso mora aqui e não no HAL.
    //
    // O prazo de cada bloco é block_size / sample_rate, e é ele que
    // um módulo pesado precisa caber. Módulo espectral concentra o
    // custo no bloco do hop: o que tem que caber é o PICO.
    //
    //    48  →  1000 us  — latência mínima, o normal do instrumento
    //   128  →  2667 us  — 2,7x de orçamento, 2,7 ms de latência
    //   256  →  5333 us  — 5,3x de orçamento, 5,3 ms de latência
    //
    // Medido com o módulo de FFT (2048/hop 1024): pico de 5609 us em
    // regime — não coube nem no 256, por 5%. A variante FFT
    // 1024/hop 512 deve cair pra faixa de 2,5–2,8k us e caber no 256
    // com folga.
    // MÓDULO DO Fx2 FORA DO BUILD (2026-08-18, decisão de ouvido do dB):
    // volta pra 48. O 256 nunca foi escolha — era exigência da FFT do
    // desse módulo, e saiu junto com ela.
    //
    // O que se ganha de volta é o que o 256 custava: a latência cai de
    // 5,3 ms pra 1 ms, e num instrumento realimentado isso REPÕE onde
    // o feedback se estabelece. O freeze que entra no lugar é granular
    // no domínio do tempo — não tem prazo mínimo de janela, roda em
    // qualquer bloco.
    //
    // Pra reviver um módulo de FFT: 256 aqui, e o módulo no Makefile.
    // Os dois arquivos mudam JUNTOS — é por isso que a nota está nos
    // dois.
    size_t block_size = 48;
};

// Grau permitido = semitom MOD 12 relativo ao centro da cerca. Lá
// menor natural: a base da portadora é 110 Hz — um Lá — então a
// máscara nasce afinada de graça, sem transposição nenhuma.
// Outra escultura declara outra máscara; é DADO de manifest.
static constexpr uint8_t kScaleAminor[] = {0, 2, 3, 5, 7, 8, 10};

// Alvo de sorteio (B1 e búzios): cerca por parâmetro + máscara de
// escala opcional. Cerca em NORMALIZADO, sorteio uniforme dentro dela.
// Com máscara (n_scale > 0) o sorteio só pousa em semitons permitidos:
// passo norm_per_semi a partir de center_norm.
struct RandTarget
{
    int            id            = -1;
    float          min_norm      = 0.f;   // cerca; ver real_fence
    float          max_norm      = 1.f;
    const uint8_t* scale         = nullptr;
    int            n_scale       = 0;
    float          center_norm   = 0.5f;
    float          norm_per_semi = 0.f;
    // true = a cerca está em REAL (unidade do param) e o sorteio é
    // uniforme NELA. Necessário quando o param tem curva != 1: sorteio
    // uniforme em norm entortaria a distribuição — "100 a 500 ms"
    // viraria "quase sempre perto de 100".
    bool           real_fence    = false;
    // Passo do sorteio em REAL (0 = contínuo). Com real_fence, o
    // sorteio pousa só em min + k*passo — degraus perceptíveis em vez
    // de variação contínua que o ouvido lê como "quase igual".
    float          real_step     = 0.f;
};

// Semântica do botão 2. Momentânea por ora; Toggle fica declarado
// pra o dia em que existir, mas não implementado — declarar sem
// implementar é melhor que improvisar depois sem lugar previsto.
enum class ButtonMode
{
    Hold,   // param = 1 enquanto pressionado, volta ao anterior ao soltar
    Toggle, // FUTURO: alterna a cada pressionada
};

struct Manifest
{
    Requirements req; // instrumento de teste: defaults servem

    // ids de parâmetros preenchidos no Init()
    int p_pre_level;      // volume master
    int p_test_tone_freq;  // freq do oscilador de teste
    int p_test_tone_level;   // mistura tom de teste vs entrada
    // BALANCO dos dois piezos, nao crossfade. Centro = OS DOIS CHEIOS;
    // girar abaixa o dominante sem cortar o outro. O crossfade que
    // estava aqui (`src_mix`, aposentado 2026-08-20) derrubava OS DOIS no
    // meio — -6 dB cada no centro — e por isso nao resolvia "um
    // encobre o outro".
    //
    // FAIXA SIMETRICA [-1,+1] com neutro em 0: e o que faz o default
    // zero cair no centro sozinho, sem excecao a regra. CC 64 = centro.
    //
    // AGORA PODE IR PRO MIDI, e o `src_mix` nao podia. Aquele emudecia
    // o instrumento nos extremos (3x num dia so); este, no extremo,
    // perde UM piezo e mantem o outro. Nao existe posicao muda.
    int p_piezo_mix;  // -1 = so IN_L ... 0 = ambos cheios ... +1 = so IN_R
    // ---- GANHO DE ENTRADA — pós-fonte, PRÉ-GATE ----
    // O lugar que este manifest reservou pra ele desde o primeiro dia,
    // no bloco do bench_boost: "o ganho de compensação do piezo NÃO
    // mora no level: mora pós-entrada / pré-gate".
    //
    // POR QUE PRÉ-GATE, e não depois: o gate precisa decidir sobre o
    // sinal JÁ no nível certo. Amplificar depois dele significaria
    // amplificar junto o que ele deixou passar, e o limiar do gate
    // passaria a significar coisas diferentes conforme o ganho.
    //
    // POR QUE NÃO É O MESMO QUE SUBIR O LEVEL: o level empurra a
    // SAÍDA contra o governor e o limiter — mais volume ali é mais
    // compressão, que é o artefato que se quer evitar. O ganho de
    // entrada levanta o sinal ANTES da cadeia inteira, então delay,
    // o Fx2 e o reverb recebem material mais quente e a dinâmica
    // continua trabalhando na mesma proporção.
    //
    // O QUE ELE NÃO RESOLVE, e é honesto dizer: ele levanta o CHÃO DE
    // RUÍDO do piezo junto com o sinal. A relação sinal/ruído não
    // melhora — o que melhora é o quanto da faixa útil se usa. Se o
    // ruído começar a incomodar, o conserto é o buffer de alta
    // impedância (receita no BOARDS.md), não mais ganho aqui.
    // ---- DUAS CADEIAS DE CARATER (pivo de 2026-08-20) ----
    //
    // POR QUE DUPLICAR, e a razao NAO e desequilibrio entre transdutores.
    //
    // Cada piezo capta um MATERIAL diferente do instrumento hibrido: o do
    // tambor le transientes curtos e fortes; o da mola/corda le raspagem
    // continua de baixo nivel. E diferenca de FONTE, nao de transdutor.
    // Um limiar de gate que deixa a raspagem passar abre demais pro
    // tambor; um ganho que serve a corda satura no golpe.
    //
    // A duplicacao vale com dois piezos perfeitamente casados, e valeria
    // se fossem identicos de fabrica. ISTO IMPORTA ESTAR ESCRITO: houve
    // um momento em que o p2 chegava mais baixo e isso quase virou a
    // justificativa — era DEFEITO FISICO de um piezo, nao propriedade do
    // circuito, e com os dois em ordem os canais chegam iguais. Se
    // ficasse registrado "duplicamos porque p2 era mais baixo", alguem
    // mede os canais iguais no futuro e conclui que a duplicacao e
    // dispensavel. Justificativa errada envelhece mal.
    static constexpr int kCadeias = 2;
// `in_gain` REMOVIDO em 2026-08-28 — o Governor (AGC) anulava-o e o
    // `piezo_mix` ja fazia o balanco. Ver a nota no `main.cpp`, secao 1.1,
    // que guarda o que se perdeu. CC 21 voltou a ficar livre.
    int p_dly_time;   // → módulo externo "dly_time"
    int p_dly_mix[kCadeias];    // → módulo externo "dly_mix"
    int p_dly_on[kCadeias];     // 0/1 — chave própria (o mix deixa de ser a chave)

    // ---- cadeia de dinâmica do shell (C++ puro, não externo) ----
    // Todos serial-only: são política de segurança e comportamento,
    // não gesto de performance. O painel tem 5 knobs e nenhum deles
    // se gasta aqui.
    int p_gate_thresh[kCadeias];
    int p_gate_release[kCadeias];
    int p_gov_ceiling[2];
    int p_gov_release[2];

    // Roteamento de saída: 0/1. DOIS ANDARES, e eles NÃO fazem a
    // mesma coisa — 2026-08-28, e a confusão entre os dois é o que fez
    // `route_jack` existir com esse nome:
    //
    //   route_*  ANTES dos efeitos. Matriz 2×2: qual CADEIA entra em
    //            qual SAÍDA (A→L, A→R, B→L, B→R). É aqui que se
    //            trocam as cadeias quando os transdutores estão
    //            ligados invertidos, sem duplicar preset nenhum.
    //   out_*    DEPOIS do limiter. Corta o RAMO inteiro, e continua
    //            a ser o único mute de verdade: zerar uma coluna da
    //            matriz cala o seco, o freeze e o espaço daquela
    //            cadeia, mas o retorno do delay ainda entra (uma
    //            instância só, envios já somados — ver main.cpp).
    //
    // O FIRMWARE NÃO NOMEIA DESTINO, e é por isso que `route_jack`
    // era um nome falso. Cada saída passa por um DPDT de três
    // posições — jack | ambos | amp — que mora DEPOIS daqui. `out[1]`
    // não é "o jack": é uma saída que PODE estar no jack, e a chave é
    // que decide. O firmware nomeia SAÍDA; o cobre nomeia destino.
    int p_exc_on[2];    // [0]=exciter L, [1]=exciter R. Gateia shift+governor
    int p_route_l[2];   // a cadeia A/B entra em OUT_L?
    int p_route_r[2];   // a cadeia A/B entra em OUT_R?
int p_post_level_l;        // volume do ramo L — POT em A0 (D15)
    int p_post_level_r;        // volume do ramo R — POT em A1 (D16)
        int p_comp_on;      // compressor: sobe a media sem tocar no pico
    int p_comp_thresh;
    int p_comp_razao;
    int p_comp_makeup;
    int p_sim_laco;     // laco simulado: microfonia sem escultura
    int p_sim_hz;       // frequencia do modo simulado
    int p_sim_fb;       // ganho da realimentacao simulada
    int p_micro_auto;   // supressor automatico ligado?
    int p_micro_dom;    // limiar de dominancia para agir
    int p_out_l;        // OUT_L no ar?  (mute pos-limiter)
    int p_out_r;        // OUT_R no ar?

    // ============================================================
    // >>>>>>>>>>>>>  FERRAMENTA DE BANCADA  <<<<<<<<<<<<<
    //
    // NUNCA mapear bench_boost a knob, encoder, botão ou cena.
    // Ele existe por um motivo só: dar headroom pra EXERCITAR o
    // limiter em teste. O caminho de sinal normal não consegue
    // passar de ~0,5 interno, e um limiter que nunca engata é um
    // limiter não testado.
    //
    // Por que não subir o `level` em vez disso: level [0,1] é
    // CONTRATO DE ERGONOMIA DO PALCO. O knob de volume da
    // escultura não pode ter quatro quintos de curso perigoso.
    //
    // E o ganho de compensação do piezo, quando vier, NÃO mora
    // aqui nem no level: mora pós-entrada / pré-gate, que é onde
    // ele pertence — antes do gate poder decidir sobre o sinal já
    // no nível certo.
    //
    // NÃO PERSISTE. Nasce sempre em 1.0. O boot tem tripwire.
    // ============================================================
    int p_bench_boost[2];

    // SHIFTER — bloco PERMANENTE do shell (dynamics.h), não módulo.
    // Anti-feedback: deslocar alguns Hz quebra a coerência do laço
    // piezo→corpo→piezo antes que ele cresça — o sinal que volta não
    // coincide mais em fase com o que saiu, e a realimentação não
    // encontra frequência pra travar.
    //
    // >>> DESTINO DO ENCODER FÍSICO, junto com gov_ceiling. Os dois
    // >>> formam o controle da "borda de feedback": gov_ceiling diz
    // >>> ONDE parar de crescer, shift_hz diz O QUANTO desmanchar o
    // >>> laço. Push do encoder alterna entre os dois.
    //
    // 0 Hz = desligado. Acima de ~10 Hz começa a soar como efeito
    // (metálico, desafinado) em vez de proteção transparente.
    int p_shift_hz;

    // ---- REVERB — bloco PERMANENTE do shell (reverb.h) ----
    // Freeverb clássico, pós-fx2 e pré-level: a sala envolve o
    // instrumento inteiro, não um canal dele.
    //
    // Serial/MIDI por ora — os cinco knobs estão cheios. Escultura que
    // quiser reverb na mão declara um macro aqui; é decisão de peça,
    // não do shell.
    //
    // rev_mix nasce em 0.15: presença de sala sem virar efeito. Reverb
    // é o ar em volta da escultura, e ar demais afoga o gesto do piezo.
    // Passa-alta NO CAMINHO DO FX2, não no master. O estouro só
    // acontece com o módulo do Fx2 ligado (medido), então filtrar o master
    // castigaria o delay de graça. 0 Hz = desligado.

    // ENVIO DA CADEIA PRO ESPACO — mesma forma do delay e do freeze.
    //
    // Ate 2026-08-20 havia TRES controles pro mesmo caminho: `esp_mix` na
    // entrada, `rev_mix` na saida, e duas chaves. Numa sala LINEAR
    // ganho na entrada e ganho na saida sao o MESMO controle escrito
    // duas vezes — o dB viu antes de mim.
    //
    // Ficou um so: `rev_on`/`rev_mix` dizem quanto da cadeia entra no
    // espaco. O retorno volta inteiro, porque num send/return o retorno
    // E o molhado — o seco ja passa por fora.
    //
    // `shm_mix` VOLTOU AO EMPREGO UNICO: so a camada pitcheada direta.
    // Ele tambem escalava a saida da sala quando o reverb estava
    // desligado, que e a familia C do catalogo (variavel com dois
    // empregos) plantada por mim ontem.
    int p_rev_on[kCadeias];     // 0/1 — chave. ATENÇÃO: emudece o shimmer junto
    int p_rev_mix[kCadeias];
    int p_rev_size[kCadeias];
    int p_rev_damp[kCadeias];

    // FREEZE — bloco permanente do shell (freeze.h), no lugar do
    // o do Fx2 na cadeia: pós-delay, pré-reverb. O congelado ganha a
    // sala junto, que é o que faz ele PERTENCER ao instrumento em vez
    // de flutuar por cima.
    // FREEZE: UM POR CADEIA, e SEM chave separada.
    //
    // NAO HA CHAVE SEPARADA porque congelar JA E o liga/desliga. Foi o
    // dB que viu: "ele nao precisa de on/off ao contrario de todos os
    // outros, o hold dele ja e on off".
    //
    // E o param se chama `frz_on` e nao `frz_hold` pra ler igual aos
    // vizinhos na lista — o gesto e o mesmo, o nome e que acompanha a
    // familia. Consistencia de vocabulario onde o comportamento ja e
    // consistente.
    //
    // DOIS FREEZES DE VERDADE, nao um com envio: cada cadeia congela
    // SEU material, no SEU instante. Um freeze so, alimentado pela
    // soma, congelaria os dois juntos — e o gesto e justamente pegar
    // um material enquanto o outro segue vivo.
    int p_frz_on[kCadeias];     // A CHAVE, que aqui E o gesto de congelar
    int p_frz_vol[kCadeias];    // nivel do congelado
  // 0..1 seco/congelado
    int p_frz_size[kCadeias];

    // DRIVE — waveshaper tanh como COLA. Primeiro da cadeia: sujeira
    // antes de modulacao, tempo e espaco (ordem de pedaleira).
    // CARATER: PARAMS COMPARTILHADOS, chave e dry/wet POR CANAL.
    //
    // Seis efeitos com params independentes ficou confuso de operar
    // (decisao de uso do dB, 2026-08-20). Volta a existir UM drive, UM
    // phaser, UM warble — o que duplica e so o que se opera ao vivo.
    //
    // NAO ESPERE ECONOMIA DE CPU, e isto foi verificado na estrutura
    // antes de medir: cada efeito segue processando os DOIS sinais com
    // estados internos separados (dois conjuntos de allpass, dois
    // buffers de warble), senao os canais se contaminam. O que encolhe
    // e a superficie de controle e a tabela — nao o trabalho.
    int p_drv_on[kCadeias];     // 0/1 — chave, POR CANAL
    int p_drv_mix[kCadeias];    // 0..1 — dry/wet, POR CANAL
    int p_drv_drive[kCadeias];   // POR CADEIA (era compartilhado ate v0.131.0)
    int p_drv_tone[kCadeias];   // POR CADEIA (era compartilhado ate v0.131.0)
    int p_drv_sujeira[kCadeias];   // POR CADEIA (era compartilhado ate v0.131.0)

    // PHASER — N allpass varridos por LFO. Depois do drive, antes do
    // delay: sujeira, depois movimento, depois tempo e espaco.
    //
    // ATENCAO ao `phs_mix`: e INVERTIDO em relacao aos outros efeitos.
    // O notch nasce de CANCELAMENTO entre seco e desviado, e
    // cancelamento maximo exige amplitudes iguais — entao ~0.5 e o
    // "ligado" e 1.0 e quase inaudivel. Ver phaser.h.
    int p_phs_on[kCadeias];        // chave, POR CANAL
    int p_phs_mix[kCadeias];       // dry/wet POR CANAL · MONTANHA: pico em ~0.5
    int p_phs_rate[kCadeias];   // POR CADEIA (era compartilhado ate v0.131.0)
    int p_phs_depth[kCadeias];   // POR CADEIA (era compartilhado ate v0.131.0)
    int p_phs_feedback[kCadeias];   // POR CADEIA (era compartilhado ate v0.131.0)
    int p_phs_stages[kCadeias];   // POR CADEIA (era compartilhado ate v0.131.0)

    // WARBLE — deriva de fita: delay curto modulado. Depois do phaser
    // (sujeira, movimento de fase, movimento de altura), antes do
    // delay.
    //
    // NAO tem `mix`: fita nao mistura com ela mesma. O sinal inteiro
    // deriva, ou nao deriva — misturar com o seco daria flanger, que e
    // outro efeito.
    // WARBLE GANHOU `mix` EM 2026-08-20, por decisao do dB (consistencia:
    // todo efeito de caracter tem chave e dry/wet por canal).
    //
    // ISTO MUDA UM EFEITO APROVADO. Ate aqui o dry/wet do warble era o
    // crossfade do EffectSlot, e ligar bastava pra ouvir. Agora, com
    // mix em 0 — que e o default — ele fica MUDO ligado, igual a drive
    // e phaser. Reaceite pelo IFA10000 esta pendente.
    int p_wrb_on[kCadeias];     // chave, POR CANAL
    int p_wrb_mix[kCadeias];    // dry/wet, POR CANAL
// ---- TAROLATOR ----
    // Nome do dB, e o nome e o diagnostico: nasceu oitavador e nao produz
    // oitava — numa membrana os modos sao inarmonicos e o divisor treme,
    // gerando rajada de ruido com o envelope da pancada. Ver tarol.h.
    //
    // DUAS CHAVES SO. O tom e o rastreio ficaram FIXOS nos numeros que
    // produziram o som aprovado: como params davam curso morto, e a regra
    // e SE NAO SOA, NAO FICA.
    int p_tarol_on[kCadeias];
    int p_tarol_mix[kCadeias];

    // NOTCH ANTI-MICROFONIA — duas bocas por cadeia.
    //
    // ⚠️ CHAMOU-SE `ntc_*` ATE 2026-09-01, e o nome era mau por duas razoes.
    // A primeira: o dB perguntou "o que e ntc?" — e se o dono do
    // instrumento nao reconhece o nome, o nome falhou. A segunda e pior
    // neste repositorio: NTC e um COMPONENTE, o termistor de coeficiente
    // negativo, que aparece em esquematicos a toda a hora. Ao lado de
    // folhas de KiCad, `ntc1_hz` le-se como "o primeiro termistor".
    // O corpo desta peca e SOLDADO: exciter e piezo na mesma chapa,
    // sem junta para perder energia. Nenhum gesto mecanico funcionou.
    int p_notch_on[kCadeias];
    int p_notch_hz[kCadeias][4];   // 4 bocas por ramo
    int p_notch_db[kCadeias][4];
        int p_wrb_rate[kCadeias];   // POR CADEIA (era compartilhado ate v0.131.0)
    int p_wrb_depth[kCadeias];   // POR CADEIA (era compartilhado ate v0.131.0)
    int p_wrb_irreg[kCadeias];   // POR CADEIA (era compartilhado ate v0.131.0)

    // ---- PARAM PRIMARIO POR EFEITO ----
    //
    // O que o pot de "parameter" do painel controla. E destilacao
    // forcada: se nao da pra nomear o knob que mais importa, o efeito
    // nao esta maduro. Tambem e o unico param, alem do on/off, que
    // recebe CC — os secundarios seguem alcancaveis por `set`.
    struct EfeitoCaracter
    {
        int         p_on;
        int         p_primario;
        const char* nome;
        const char* nome_primario;
    };
    EfeitoCaracter caracter[kCadeias][3];

    // TOM DE TESTE: pra qual cadeia. 0=A 1=B 2=AMBAS (default).
    //
    // Tom que entra so numa cadeia deixa a outra INVISIVEL ao teste, e
    // canal mudo prova so que aquele canal esta mudo. Sem destino
    // selecionavel, nenhum teste futuro distingue "B quebrada" de "B nao
    // excitada". AMBAS valida simetria de uma vez; A ou B isolam quando
    // o sintoma for assimetrico.
    int p_test_tone_out;
    int p_test_tone_via;   // 0=pre (pos-level) · 1=post (cadeia)

    // DETUNE — vozes micro-desafinadas + largura. Depois do modulo,
    // onde o estereo existe: sem estereo nao ha spread.

    // SHIMMER — reverb + pitch-up num laco de realimentacao. Nao tem
    // reverb proprio: realimenta o Freeverb da cadeia.
    //
    // NAO HA `shm_decay`, e e deliberado. A especificacao pedia o
    // param E dizia "decay = tempo de cauda do proprio reverb" — o que
    // faria dele um segundo dono de `rev_size`. Variavel com dois
    // empregos e a terceira familia de bug de ordem deste projeto.
    // `rev_size` (CC 25) E o decay, e a dependencia esta declarada.
    // ON/OFF EXPLICITO, pedido do dB: todo efeito que entra na suite
    // ganha o seu. Antes o shimmer ligava quando `mix > 0`, o que
    // funde duas decisoes numa so — desligar obrigava a zerar o mix e
    // perder o ajuste. Chave separada preserva a posicao do fader.
    int p_shm_on[kCadeias];       // 0/1 — chave
    int p_shm_mix[kCadeias];      // 0..1 — CAMADA por cima do seco
    int p_shm_shift[kCadeias];    // 0=+12  1=+7  2=ambos
    int p_shm_feedback[kCadeias]; // 0..1 — quantas oitavas empilham
    int p_shm_tone[kCadeias];     // 0..1 — 0 = 6 kHz (quente) ... 1 = 18 kHz

    // ------------------------------------------------------------
    // ORDEM DE SACRIFICIO — a politica do TETO DE SOMA do CTOS.
    //
    // DUAS SITUACOES DIFERENTES, DOIS MECANISMOS. O watchdog por-efeito
    // pega o efeito BUGADO: um efeito que sozinho estoura seu orcamento
    // tem defeito individual, e o veto e justo porque ha culpado. O teto
    // de soma pega outra coisa: N efeitos SAUDAVEIS que juntos nao cabem
    // no prazo do bloco. Ali nao ha culpado — e excesso de ambicao, e
    // procurar culpa fabricaria um.
    //
    // Entao nao se pergunta "quem estourou?" (ninguem), e sim "qual o
    // instrumento perde com menos dano?". A resposta e PRIORIDADE
    // DECLARADA: o dB decide A FRIO, aqui, fora do calor do overrun.
    //
    // POR QUE NAO LIFO. Derrubar o ultimo ligado e aproximacao: pune por
    // ordem de chegada, que nao tem relacao com valor musical. O ultimo
    // ligado pode ser exatamente o que se estava buscando.
    //
    // A ORDEM DO ARRAY E A PRIORIDADE. Indice 0 cai primeiro. Reordenar
    // aqui e a unica forma de mudar a politica — nao ha numero de
    // prioridade escondido em lugar nenhum.
    struct Sacrificavel
    {
        int         param_on;
        const char* nome;
    };
    // ESTE LIMITE E LIDO NO CALLBACK DE AUDIO, e por isso ele nao pode
    // seguir a tabela de params.
    //
    // Uma varredura de 2026-08-23 procurou "que custos escalam com uma tabela
    // que cresceu?" e achou o `sync` gastando 258 ms onde foi dimensionado
    // para 36 (bts 13p). O callback saiu limpo — o unico laco sobre tabela
    // ali e o do `n_sacrif` — mas saiu limpo por SORTE DE DESENHO: nada
    // dizia que ele nao podia escalar com params, e ninguem tinha
    // verificado.
    //
    // O assert transforma a sorte em garantia. Se um dia alguem quiser
    // sacrificar POR PARAM em vez de por efeito, o build reclama antes de
    // o callback engordar — que e o unico lugar onde engordar custa
    // amostra perdida, e nao apenas paciencia.
    //
    // Se este numero precisar passar de 16, a pergunta certa nao e "posso
    // aumentar?" e sim "isto ainda e por EFEITO?".
    static constexpr int kMaxSacrificaveis = 12;
    static_assert(kMaxSacrificaveis <= 16,
                  "kMaxSacrificaveis e varrido no callback de audio: tem que "
                  "ser constante pequena ligada a contagem de EFEITOS, nunca "
                  "a de params, que cresce (ver battle_scars 13p)");
    Sacrificavel sacrif[kMaxSacrificaveis];
    int          n_sacrif = 0;

    // ---- FREEZE (slot Fx2) ----
    // Serial-only: os cinco knobs estao todos ocupados. As faixas
    // ESPELHAM as do export, porque o modulo recebe normalizado e o
    // o motor remapeia — declarar [-24,24] aqui faz `set frz_transp 12`
    // significar 12 semitons de verdade.
    // BYPASS do slot Fx2. NASCE DESLIGADO de proposito.
    //
    // Um modulo pesado que estoura o prazo do bloco de audio nao
    // "soa mal": ele mata o loop principal por inanicao, e a placa
    // fica surda no serial — sem log, sem cpu, sem jeito de
    // diagnosticar a nao ser regravando. Ja aconteceu com o freeze.
    //
    // Com bypass, o boot sempre responde, e ligar o modulo vira um
    // experimento reversivel em vez de uma aposta.

    // Variante ENXUTA do patch: a cirurgia do dB fixou auto, fade e
    // pitchjit internamente e removeu transp/panjit/ampjit. Restam
    // dois params vivos. O export ainda EXPOE lowcut, highcut,
    // direct, auto, autodel, fade e pitchjit — nao ligamos porque,
    // segundo o autor, estao fixos por dentro; ligar daria a ilusao
    // de controle sobre algo que nao responde.
    // ---- MÓDULO DO SLOT Fx2 ----
    // Cross-synthesis: ch1 = escultura (modulador), ch2 = jack de
    // linha CRU (portadora).
    //
    // A carta de timbre nasceu no export de 2026-08-16 e ficou com o k5, que
    // estava livre desde o painel v2. mix e pitch seguem serial-only.

    // ---- GANHO DE COMPENSAÇÃO DO SLOT Fx2 ----
    // O módulo do Fx2 saía MUITO mais baixo que o delay. Não é defeito:
    // cross-synthesis espectral só devolve energia onde as duas fontes
    // coincidem, e coincidência é raríssima comparada com um delay, que
    // devolve o sinal inteiro.
    //
    // POR QUE UM PARÂMETRO NOVO, e não subir `level` ou `bench_boost`:
    //
    //   level        é o master do palco, contrato [0,1]. Gastá-lo pra
    //                compensar um módulo faria o knob de volume da
    //                escultura significar coisas diferentes conforme o
    //                Fx2 estivesse ligado ou não.
    //   bench_boost  é ferramenta de bancada, proibida de sair da
    //                bancada. Ver o bloco dela acima.
    //
    // Isto é CASAMENTO DE NÍVEL ENTRE MÓDULOS, que é problema próprio e
    // merece nome próprio. Fica no slot, não no master: trocar o módulo
    // do Fx2 troca o ganho junto, como tem que ser.
    //
    // Aplicado ANTES do level e da dinâmica, então governor e limiter
    // continuam protegendo — é por isso que 8x é seguro de oferecer.

    // ============================================================
    // PAINEL v2 — 5 pots + 2 botões momentâneos
    //
    //   k1 = level      k2 = piezo_mix    k3–k5 = macros de caráter
    //   B1 = randomizador                 B2 = assinalável
    // ============================================================

    // ---- B1: RANDOMIZADOR, com whitelist EXPLÍCITA ----
    //
    // Só entra aqui parâmetro de CARÁTER do módulo — o que muda o som
    // sem mudar o que o instrumento é. Ficam PROIBIDOS por design:
    //
    //   level          é o volume. Sortear volume no palco é o mesmo
    //                  que dar um susto em quem está ouvindo.
    //   src_mix        escolhe a FONTE. Sortear isso troca o
    //                  instrumento, não o som dele.
    //   gate_*         política sobre o chão de ruído do piezo.
    //   gov_*, limiter proteção do exciter. Sortear proteção é
    //                  sortear se o hardware sobrevive.
    //   route_*, out_* sortear roteamento pode emudecer a peça, ou
    //                  mandar para o transdutor errado o que estava
    //                  endereçado ao outro.
    //   shift_hz       anti-feedback. Mesmo argumento do governor.
    //   bench_boost    ferramenta de bancada, nunca de performance.
    //
    // A regra por trás: o botão pode surpreender o TIMBRE, nunca a
    // SEGURANÇA nem a IDENTIDADE do instrumento. Whitelist e não
    // blacklist porque param novo nasce fora — esquecer de proibir é
    // erro silencioso, esquecer de permitir só faz o botão ignorá-lo.
    RandTarget randomizable[8];
    int        n_randomizable = 0;

    // ---- BÚZIOS: o sorteio disparado por transiente ----
    //
    // Nome do dB, e ele descreve o gesto melhor que qualquer termo
    // técnico: cada batida na escultura é uma jogada de búzios, e o
    // que cai decide o timbre. A escala de Lá menor é o que faz a
    // sorte cair sempre dentro do tom — surpresa sem nota errada.
    // Detector no shell (main.cpp), pós-gate: batida acima do limiar
    // dispara UM sorteio nas mesmas cercas do B1. buzios_on nasce em 0
    // — é gesto de performance, liga por serial/MIDI, e é candidato ao
    // B2 como toggle quando Toggle existir.
    int p_buzios_on;
    int p_buzios_thresh;   // limiar do envelope pós-gate, 0..1
    int p_buzios_cooldown; // ms entre sorteios; 2 batidas rápidas = 1

    // ---- B2: ASSINALÁVEL ----
    // -1 = sem função. Momentâneo: segura, vale 1; solta, volta.
    // ---- BOTOES COM ALVO, generalizado ----
    //
    // Era `button2_target`, um alvo unico, e o segundo botao fisico
    // (freeze B) obrigaria a repetir o gesto inteiro — que e quando as
    // duas versoes comecam a divergir no primeiro conserto. Agora e
    // tabela: cada botao declara o param que alterna e o pino do LED
    // que espelha esse param.
    //
    // `led_hw` e o INDICE do LED no HAL, nao o pino: o manifest nao
    // conhece pino, e a fronteira board-agnostic e o motivo de esta
    // base existir. -1 = sem LED.
    // SENTINELA NEGATIVA NAO SOBREVIVE A ZERO-INIT, e este projeto ja
    // pagou por isso hoje (o `SacrifTravado` devolvendo -1 testado como
    // booleano). `BotaoAlvo x[] = {}` poe param=0 e led_hw=0 — e ZERO E
    // INDICE VALIDO de parametro e de LED. Sem os inicializadores
    // abaixo, o botao randomizador alternaria o `level` e acenderia o
    // LED do freeze A.
    //
    // O relatorio do `board` pegou isso na primeira leitura: "B1 (?):
    // alterna level | LED 0". Instrumento que declara o proprio estado
    // paga o custo dele na primeira execucao.
    struct BotaoAlvo
    {
        int         param  = -1;   // o que alterna na borda, -1 = nenhum
        int         led_hw = -1;   // indice do LED que espelha, -1 = nenhum
        const char* nome   = nullptr;
    };
    static constexpr int kMaxBotoes = 6;
    BotaoAlvo  botao[kMaxBotoes] = {};
    int        n_botoes = 0;

    void AddBotao(int idx, int param, int led_hw, const char* nome)
    {
        if(idx < 0 || idx >= kMaxBotoes) return;
        botao[idx] = {param, led_hw, nome};
        if(idx + 1 > n_botoes) n_botoes = idx + 1;
    }
    ButtonMode button2_mode   = ButtonMode::Hold;

    // ---- ligação com o módulo DSP, POR NOME ----
    // O manifest não conhecia índice de parâmetro do motor: reexportar
    // o patch reordena tudo. Declara-se o nome, e o boot resolve o
    // índice via Module::FindParam(). Nome que não existe = erro
    // claro no log, não parâmetro fantasma mexendo em nada.
    // O SISTEMA DE MODULOS EXTERNOS SAIU INTEIRO EM 2026-08-20. O delay,
    // ultimo modulo, virou C++ no shell (delay.h). Nao ha mais slot,
    // bind, nem push por nome — todo efeito le os params direto, como
    // sempre foi pros efeitos da casa.

    // ============================================================
    // ---- MIDI: CC → parâmetro ----
    //
    // MIDI É UM KNOB REMOTO, NÃO UM CAMINHO NOVO. O CC entrega um
    // valor normalizado à ParamTable e para por aí — exatamente onde
    // o knob físico para. Tudo que vem depois (curva do manifest,
    // Shaped() pro módulo, Real() pro DSP) acontece igual, porque é
    // a mesma via. Um `dly_time` movido por CC tem a mesma ergonomia
    // curvada de quando é movido pelo knob 1.
    //
    // Isso não é coincidência de implementação: os knobs deste
    // manifest são macros de UM alvo com peso 1.0, e `Macro::Apply`
    // com um alvo de peso 1.0 é literalmente `t.Set(id, v)`. Não há
    // divergência possível entre as duas vias enquanto for assim.
    // Se algum knob virar macro composta e o mesmo gesto tiver que
    // ser alcançável por MIDI, o certo é apontar o CC pra macro —
    // não duplicar os alvos aqui.
    //
    // A tabela é CC → PARÂMETRO e não CC → knob de propósito: o
    // painel tem 5 knobs e o instrumento tem 15 parâmetros. MIDI
    // alcança os que não couberam no painel — gov_ceiling é o
    // exemplo, e é o mais importante deles.
    // ============================================================
    int        midi_channel = kMidiOmni; // omni: aceita todos os canais
    MidiCcBind midi_map[kMaxMidiMap];
    int        midi_overflow = 0; // entradas recusadas por falta de espaco

    // TODA escrita no mapa passa por aqui. A versao anterior fazia
    // `midi_map[n_midi++] = {...}` direto, SEM GUARDA — e a 17a entrada
    // escreveu FORA DO ARRAY. Estouro de capacidade e defeito de
    // PROJETO: quem adiciona o 33o CC precisa saber no boot.
    // ------------------------------------------------------------
    // DETECTOR DE COLISAO — devolve quantos pares (CC, canal) estao
    // repetidos, e escreve o primeiro em `cc_out`/`canal_out`.
    //
    // ESTE DETECTOR NASCEU DE UM DEFEITO SEU. Em 2026-08-31 o notch entrou
    // no CC 115, que ja era do `bench_boost` nos MESMOS canais. O
    // `Aplica` diz na propria linha "primeiro vence; duplicata e erro"
    // — e ninguem verificava. O notch foi registado antes, ganhou, e o
    // `bench_boost` ficou inalcancavel pelo iPad EM SILENCIO.
    //
    // O `board` ate dizia "sem CC: 0 de 95 params", e dizia a verdade:
    // o param sombreado TEM entrada no mapa. Contar quem nao tem CC
    // nao encontra quem tem CC roubado — sao perguntas diferentes, e
    // so uma delas estava a ser feita.
    int Colisoes(uint8_t* cc_out, uint8_t* canal_out) const
    {
        int n = 0;
        for(int i = 0; i < n_midi; i++)
            for(int j = i + 1; j < n_midi; j++)
                if(midi_map[i].cc == midi_map[j].cc
                   && midi_map[i].canal == midi_map[j].canal)
                {
                    if(!n)
                    {
                        if(cc_out)    *cc_out    = midi_map[i].cc;
                        if(canal_out) *canal_out = midi_map[i].canal;
                    }
                    n++;
                }
        return n;
    }

    // Para quem quer a lista toda: devolve o par `k`-esimo em colisao.
    bool Colisao(int k, uint8_t* cc, uint8_t* canal,
                 int* p1, int* p2) const
    {
        int n = 0;
        for(int i = 0; i < n_midi; i++)
            for(int j = i + 1; j < n_midi; j++)
                if(midi_map[i].cc == midi_map[j].cc
                   && midi_map[i].canal == midi_map[j].canal)
                {
                    if(n++ == k)
                    {
                        if(cc)    *cc    = midi_map[i].cc;
                        if(canal) *canal = midi_map[i].canal;
                        if(p1)    *p1    = midi_map[i].param_id;
                        if(p2)    *p2    = midi_map[j].param_id;
                        return true;
                    }
                }
        return false;
    }

    // ---- CCs DE COMANDO: nao sao params, e por isso nao entram no mapa ----
    //
    // 121 e 122 ficam junto do 120 (`sync`) e longe de tudo o que e
    // param — ver PRESETS-LISTA.md. O CANAL diz o DESTINO, como em todo
    // o resto do esquema: ch1 global, ch2 cadeia A, ch3 cadeia B. O
    // VALOR diz o slot.
    static constexpr uint8_t kCcPresetLoad = 121;
    static constexpr uint8_t kCcPresetSave = 122;   // ainda NAO implementado

    void AddMidi(uint8_t cc, int param_id, uint8_t canal = kCanalEntradaA)
    {
        if(n_midi >= kMaxMidiMap) { midi_overflow++; return; }
        midi_map[n_midi].cc       = cc;
        midi_map[n_midi].canal    = canal;
        midi_map[n_midi].param_id = param_id;
        n_midi++;
    }
    int        n_midi = 0;

    // Aplica um CC pela via do knob. Devolve o id do parâmetro movido,
    // ou -1 se o CC não está no mapa.
    //
    // Mora aqui, e não no main.cpp, porque o mapa é do manifest —
    // e porque assim o banco de teste nativo (test_midi.cpp) exercita
    // ESTA função, não uma cópia dela. Lógica de mapeamento duplicada
    // entre firmware e teste é teste que valida a si mesmo.
    // Só CONSULTA o mapa, sem aplicar. O scope precisa disso pra
    // decodificar o CC em nome de parâmetro sem provocar efeito
    // colateral — instrumento de medição que altera o medido é a
    // família inteira do catálogo forense.
    int FindMidiParam(uint8_t canal, uint8_t cc) const
    {
        for(int i = 0; i < n_midi; i++)
            if(midi_map[i].cc == cc && midi_map[i].canal == canal)
                return midi_map[i].param_id;
        return -1;
    }

    // O CANAL E PARTE DO ENDERECO, e por isso e argumento e nao default:
    // uma sobrecarga sem canal deixaria qualquer chamador antigo mirar
    // silenciosamente na cadeia A. O compilador tem que cobrar os dois
    // valores em cada chamada — o custo de errar aqui e o CC do bumbo
    // mexendo no efeito da corda, que ninguem depura de ouvido.
    int ApplyMidiCc(ParamTable& t, uint8_t canal, uint8_t cc, uint8_t value) const
    {
        for(int i = 0; i < n_midi; i++)
        {
            if(midi_map[i].cc != cc || midi_map[i].canal != canal)
                continue;
            // Set() fala NORMALIZADO — o mesmo ponto de entrada do
            // knob físico. Curva, Shaped() e Real() vêm depois, iguais
            // pra qualquer origem.
            t.Set(midi_map[i].param_id, MidiNorm(value));
            return midi_map[i].param_id; // primeiro vence; duplicata é erro
        }
        return -1;
    }

    Macro knob[kNumKnobs];

    void Init(ParamTable& t)
    {
        // ============================================================
        // DEFAULTS: ZERO PARA O QUE O MIDI ALCANCA (dB, 2026-08-18)
        //
        // O Loopy so TRANSMITE — nao recebe sem MIDI learn, e o dB
        // decidiu nao fazer isso por ora. Consequencia: o controlador e
        // a fonte da verdade, e os faders dele estao onde estao.
        //
        // Se a placa acordasse nos valores "aprovados", eles durariam
        // ate o primeiro CC e depois pulariam pro que o fader dissesse.
        // Isso ja aconteceu hoje varias vezes e foi lido como defeito:
        // `level` em 0.49 logo apos o boot, freeze ligado sozinho, o
        // grave "sumindo". Nao era defeito — era o controlador fazendo
        // o trabalho dele por cima do manifest.
        //
        // Entao o manifest para de disputar: params MAPEADOS nascem em
        // ZERO, e o dB constroi o instrumento subindo os faders. Nada
        // pula, porque nao ha divergencia pra corrigir.
        //
        // O QUE NAO E ZERADO, E POR QUE: params que o MIDI NAO alcanca.
        // Zera-los nao alinha nada (o Loopy nunca os manda) e alguns
        // quebram o instrumento — `gov_ceiling` em 0 faz o governor
        // comprimir tudo contra o chao, que foi a causa medida do
        // "sumiu o baixo" desta sessao. Roteamento em 0 e saida muda.
        //
        // A regra, entao: ZERA O QUE O CONTROLADOR ALCANCA, PRESERVA O
        // QUE ELE NAO ALCANCA. E a mesma fronteira caráter/segurança
        // que ja governa a whitelist dos buzios e o mapa MIDI.
        // ============================================================
        // nome, default (0-1), min real, max real
        // ESTADO INSTRUMENTO restaurado 2026-08-17. Estava em 0.4 desde
        // o A/B com o Max e ficou — o dB ouviu o instrumento real e
        // disse "muuuuito baixo". Era resíduo de bancada versionado por
        // descuido, exatamente o que a regra da casa proíbe.
        //
        // FUNDO DE ESCALA (1.0), por decisão do dB: "pode ir pra 1 se
        // precisar diminuo na placa de som". Faz sentido pra ESTA
        // escultura — a saída é jack de linha, e quem tem o atenuador
        // na mão é quem mixa.
        //
        // >>> MAS ISSO NÃO É REGRA GERAL, e o dia em que o EXCITER
        // >>> entrar no caminho a conta muda: lá o atenuador não existe,
        // >>> o TPA3116 recebe o que a placa mandar, e level 1.0 com
        // >>> governor em 0.85 deixa o limiter como única rede. Quando
        // >>> a escultura tocar pelo exciter, revisar este número junto
        // >>> com o gov_ceiling — os dois formam o par que decide onde
        // >>> o laço para de crescer.
        //
        // O contrato [0,1] segue intacto: 1.0 é o topo do curso do knob,
        // não uma exceção. Quem precisar de mais que isso está pedindo
        // ganho de ENTRADA, que mora pós-entrada/pré-gate — nunca aqui.
        // ⚠️ EXCEPCAO DECLARADA A "TODO PARAM NASCE EM ZERO".
        //
        // Decisao do dB em 2026-08-31, e a razao e o que ele faz: o
        // `pre_level_ab` esta ANTES do governor e do limiter, e serve
        // para TESTE e EMERGENCIA — nao para tocar. O volume de
        // performance sao os `post_level_*`, que seguem os pots.
        //
        // Nascer em zero fazia o instrumento acordar MUDO pela via das
        // cadeias, enquanto o tom de teste — que entra depois dele —
        // continuava a soar. Essa assimetria disfarcou-se de defeito de
        // piezo CINCO VEZES num dia, e uma delas quase custou uma
        // subida permanente do ganho de entrada para compensar um param
        // perdido.
        //
        // E a unidade e o valor certo por desenho, nao so por
        // conveniencia: o sinal do piezo deve entrar QUENTE E SAUDAVEL
        // na dinamica de saida. Atenuar antes da proteccao e desperdicar
        // faixa util e depois pedi-la de volta com ganho, que e como se
        // compra ruido.
        p_pre_level     = t.Add("pre_level_ab",     1.0f, 0.f,    1.f);
        p_test_tone_freq = t.Add("test_tone_freq", 0.4f, 80.f,   2000.f);
        // ⚠️ LEVEL — escolha do dB em 2026-09-01, depois de passar por `mix`
        // e `gain`. E o nome que ele quer ver no painel, e o casamento
        // widget<->param no Loopy e por TITULO: quem manda no nome e o
        // que esta pintado no vidro, nao o que e literal no codigo.
        //
        // ⚠️ ENTAO O WIDGET TEM DE PASSAR A "Test Tone Level". Enquanto
        // disser "Test Tone Gain", o gerador de perfil deixa-o orfao e
        // o fader nao manda nada — falha silenciosa, sem erro nenhum.
        //
        // E fica registado o que ele FAZ, para ninguem escrever
        // `>= 0.5f` contra ele: o codigo e um crossfade,
        // `b[i]*(1-m) + tom[i]*m`. Em 0.5 ouve-se metade instrumento e
        // metade tom, e o comando `tone on` poe 0.5 por isso mesmo.
        p_test_tone_level  = t.Add("test_tone_level",  0.0f, 0.f,    1.f);
        // 0.5 NORMALIZADO = 0.0 real = centro. O primeiro argumento do
        // Add() e `def_norm`, e todo param ate hoje tinha min = 0, o
        // que fazia norm e real coincidirem — a distincao nunca doeu e
        // por isso o habito passou batido. Este e o primeiro param de
        // faixa SIMETRICA: aqui norm 0.0 e o extremo esquerdo, e
        // nascia com um piezo mudo.
        p_piezo_mix = t.Add("piezo_mix", 0.5f, -1.f,   1.f);

        // Faixa [1, 8], curva 2 — resolução embaixo, onde o ajuste fino
        // acontece. Em 8.0, o TOPO da faixa, por pedido do dB depois de
        // 4x ter melhorado muito.
        //
        // ESTAR NO TETO É INFORMAÇÃO, não conforto: significa que o
        // instrumento pede mais do que este ganho oferece, e a próxima
        // pergunta deixa de ser "quanto" e passa a ser ONDE. Se 8x
        // ainda ficar curto, subir o teto daqui é o caminho errado —
        // o certo é o BUFFER DE ALTA IMPEDÂNCIA (receita no BOARDS.md),
        // que levanta o sinal ANTES do ADC e melhora a relação
        // sinal/ruído em vez de só multiplicar os dois.
        //
        // Lembrete do que este ganho não faz: ele levanta o chão de
        // ruído do piezo junto. Em 8x o chão está 18 dB acima de onde
        // estava em 1x. Se o ruído aparecer, é ele falando — não é
        // defeito novo.
        //
        // norm para 8.0 = topo da faixa = 1.0
        // os params do módulo já são 0–1 no export, então min/max reais
        // coincidem com o normalizado e a conversão é identidade.
        // curve 2.5 no dly_time: ERGONOMIA, não DSP. O parâmetro do
        // patch é linear em 0–1, e linear na mão significa que quase
        // todo delay curto se amontoa no primeiro décimo do knob. Com
        // 2.5, metade do curso cobre os primeiros ~18% da faixa, que é
        // onde moram os slapbacks e os flams. O motor recebia o valor já
        // curvado e não sabe que houve curva.
        // norm 0.69 com curve 2.5 da real ~0.40: eco audivel e
        // claramente separado, nem slapback nem cauda longa.
        // CURVA LINEAR (dB, 2026-08-18). Era 2.5, que dava controle fino nos
        // tempos CURTOS — util pra delay-como-timbre e pessimo pra
        // delay-como-eco. O patch mapeia real 0..1 em 10..1000 ms
        // linearmente, entao com curva 2.5 o fader em 30% dava 59 ms:
        // abaixo de ~60 ms o ouvido nao separa em eco, vira
        // espessamento. O primeiro TERCO do curso era inaudivel como
        // delay, e foi exatamente o que o dB relatou.
        //
        // Linear: 10% = 109 ms, 25% = 258 ms, 50% = 505 ms, 100% = 1 s.
        // Curso inteiro util, e o fader passa a ler em MILISSEGUNDOS —
        // previsivel pra quem toca.
        // FAIXA CORTADA POR BAIXO (dB, 2026-08-18): o fader inteiro passa a
        // viver na regiao PERCEPTIVEL. Antes ia de 10 ms a 1 s com
        // curva 2.5, e o primeiro terco do curso ficava abaixo de
        // ~60 ms — que o ouvido nao separa em eco, so espessa. Um
        // terco de fader que nao faz nada audivel e um terco perdido.
        //
        // Agora min_real = 0.05, que o patch mapeia em ~59 ms (a borda
        // da percepcao), e o topo segue em 1 s. Linear:
        //   0% = 59 ms | 25% = 294 ms | 50% = 530 ms | 100% = 1000 ms
        //
        // O corte e no PARAMETRO, nao na curva, e a diferenca importa:
        // curva redistribui o mesmo alcance e deixa o inutil no fim do
        // curso; limite REMOVE o inutil do alcance. As cercas dos
        // buzios (100-500 ms) continuam validas porque falam em real e
        // cabem dentro da faixa nova.
        // CURSO INTEIRO desde 2026-08-20: a cerca de 50 ms mudou-se pra
        // dentro do `delay.h`, onde vale pra qualquer manifest que o
        // use. Aqui o param volta a ser 0..1 de ponta a ponta.
        p_dly_time  = t.Add("dly_time",  0.0f, 0.f, 1.f, 1.0f); // 50..1000 ms
        p_dly_mix[0]   = t.Add("dly_mix_a",   0.0f, 0.f,    1.f);  // MIDI: nasce 0
        p_dly_mix[1]   = t.Add("dly_mix_b",   0.0f, 0.f,    1.f);
        // CHAVE PROPRIA. Delay e reverb ligavam pelo `mix` — sao
        // anteriores a convencao de chave que o dB pediu pros efeitos
        // da suite. Fundir chave e mix obriga a zerar o ajuste pra
        // desligar, e o ajuste se perde.
        p_dly_on[0]    = t.Add("dly_on_a",    0.0f, 0.f,    1.f);
        p_dly_on[1]    = t.Add("dly_on_b",    0.0f, 0.f,    1.f);

        // GATE. gate_thresh usa curve 2 porque threshold útil vive
        // todo no fundo da faixa: linear, os primeiros 5% do curso
        // seriam a única parte usável. O default REAL é 0.02
        // (~-34 dBFS), e como Real() = pow(norm,2), o norm que
        // produz 0.02 é sqrt(0.02) = 0.1414.
        // Gate de volta: o chão de ruído do piezo vira cauda no delay se
        // ninguém o cortar. 0.02 é o valor que estava antes do A/B.
        p_gate_thresh[0]  = t.Add("gate_thresh_a",  0.0f, 0.f, 1.f, 2.0f);
        p_gate_thresh[1]  = t.Add("gate_thresh_b",  0.0f, 0.f, 1.f, 2.0f);
        // release em ms: 50–2000, default 300
        p_gate_release[0] = t.Add("gate_release_a", 0.1282f, 50.f, 2000.f);
        p_gate_release[1] = t.Add("gate_release_b", 0.1282f, 50.f, 2000.f);

        // GOVERNOR. gov_ceiling é o futuro destino do ENCODER físico:
        // é a "borda de feedback", o ponto onde a escultura para de
        // crescer. Linear de propósito — a borda é procurada pelo
        // ouvido, e curva atrapalharia o gesto fino.
        // Governor em 0.85, não nos 0.5 de antes: com o level em 0.85 um
        // teto de 0.5 comprimiria o instrumento o tempo todo. Ele volta
        // como PROTEÇÃO (segura o crescimento do laço), não como cor.
        p_gov_ceiling[0] = t.Add("gov_ceiling_l", 0.85f,    0.f,  1.f);
        p_gov_ceiling[1] = t.Add("gov_ceiling_r", 0.85f,    0.f,  1.f);
        // release em ms: 100–3000, default 800
        p_gov_release[0]  = t.Add("gov_release_l",  0.2414f, 100.f, 3000.f);
        p_gov_release[1]  = t.Add("gov_release_r",  0.2414f, 100.f, 3000.f);

        // ROTEAMENTO. Os dois ligados no boot: mudo por engano é pior
        // que alto por engano — pra alto o limiter já tem resposta.
    // ⚠️ `exc_filter`, e nao `exc_on`. Nome do dB, 2026-09-02: o param FILTRA
    //    o sinal do exciter (deslocador + governor); nao liga nem desliga
    //    o exciter. Ele perguntou "corta a saida L do amp?" — e nao corta,
    //    quem corta e o `out_l`. Nome que provoca essa pergunta esta errado.
    //
    // ⚠️ `_l`/`_r` E NAO `_a`/`_b`, e o sufixo aqui tem significado de
    //    MAQUINA e nao de estilo.
    //
    // Terminologia do dB, fixada em 2026-09-02: PIEZO e A ou B, porque o que o
    // define e a COLOCACAO no instrumento; EXCITER e L ou R, porque o que
    // o define e a saida do amp estereo de que ele pega.
    //
    // Estes params governam `out[0]`/`out[1]`, que sao OUT_L e OUT_R —
    // sao de SAIDA. Chamar-lhes `_a`/`_b` fazia tres estragos:
    //
    //   1. o `EhDeCadeia()` classifica pelo sufixo, e eles PARECIAM params
    //      de cadeia — so escapavam pela lista de excepcoes. Nome que
    //      obriga a uma excepcao numa regra e defeito, nao estilo;
    //   2. o MIDI endereçava-os nos canais de ENTRADA (ch2/ch3), quando
    //      todo o resto do lado da saida vive no ch1 compartilhado
    //      (`out_l`, `out_r`, `post_level_l`, `post_level_r`);
    //   3. na bancada obrigava a traduzir "cadeia A" para "saida L" de
    //      cabeca, e era a pergunta que a sessao de escuta precisava de
    //      fazer sem ambiguidade.
    p_exc_on[0]     = t.Add("exc_filter_l",      1.0f, 0.f, 1.f);
    p_exc_on[1]     = t.Add("exc_filter_r",      1.0f, 0.f, 1.f);
        // A matriz nasce CHEIA, e isso e deliberado: cheia ela
        // reproduz exatamente o codigo fixo que a antecedeu,
        // `out[0] = out[1] = A + B`. Feature nova que nasce mudando o
        // som e feature que se descobre pelo susto.
    // ⚠️ ENTRADA PRIMEIRO, SAIDA DEPOIS — nome do dB, 2026-09-02.
    //
    // Eram `route_l_a` (saida, entrada). Lidos em voz alta davam "rota L
    // do A", e a pergunta que a bancada faz e a outra: "para onde vai o
    // A?". Agora `route_a_l` le-se "rota A para L", que e a ordem do
    // sinal e a ordem do pensamento.
    //
    // O eixo do MIDI ja estava certo aqui, e continua: o CANAL diz a
    // ENTRADA (ch2 = cadeia A, ch3 = cadeia B) e o CC diz a SAIDA (97 =
    // para L, 98 = para R). Ao contrario do `exc_filter`, que era de
    // saida e estava endereçado pelos canais de entrada, a rota E de
    // cadeia — o canal e o eixo certo dela.
    //
    // Os membros C++ ficam `p_route_l[c]` / `p_route_r[c]`: o array e
    // indexado pela CADEIA, que e o eixo natural do vector, e o sufixo
    // diz o destino. Nome de string e para quem digita e para o iPad;
    // nome de membro e para quem indexa.
    p_route_l[0]    = t.Add("route_a_l",     1.0f, 0.f, 1.f);
    p_route_l[1]    = t.Add("route_b_l",     1.0f, 0.f, 1.f);
    p_route_r[0]    = t.Add("route_a_r",     1.0f, 0.f, 1.f);
    p_route_r[1]    = t.Add("route_b_r",     1.0f, 0.f, 1.f);
        // NOME: `level_l`/`level_r`, e nao `vol_*`. Alinha com o `level`
        // mestre que ja existia e diz o que sao — o mesmo eixo, em dois
        // ramos. Renomeados em 2026-08-30, a pedido do dB e de graca: o mapa
        // muda de hash, e ainda nao existe preset nenhum capturado.
        //
        // VOLUME POR RAMO, e nao e o mesmo que `out_*`. O mute existe para
        // matar um ramo inteiro depois do limiter — gesto de seguranca,
        // instantaneo. O volume e performance, continuo, e mora nos dois
        // pots fisicos soldados em D15/D16.
        //
        // Nasce em 1.0, mas quem manda no arranque e a POSICAO DO POT: o
        // laco adota a leitura fisica na primeira volta. Volume que nasce
        // diferente de onde o botao esta e a primeira coisa que assusta
        // quem liga o instrumento.
        p_post_level_l         = t.Add("post_level_l",         1.0f, 0.f, 1.f);
        p_post_level_r         = t.Add("post_level_r",         1.0f, 0.f, 1.f);
        // ---- SIMULADOR DE LACO: microfonia SEM escultura ----
        //
        // ⚠️ EXISTE PORQUE O dB ERA O BANCO DE ENSAIO, e isso acabou.
        //
        // Em 2026-09-02 o supressor foi afinado com a escultura ligada ao lado
        // de uma pessoa: cada defeito meu chegou-lhe aos ouvidos, e uma
        // das vezes o filho dele gritou. Um actuador que so se prova a
        // gritar num corpo real nao se pode iterar.
        //
        // Isto fecha um laco DENTRO do firmware — ressoador de Q alto mais
        // realimentacao — com o notch LA DENTRO, como no corpo. Sobe-se o
        // `sim_fb` ate oscilar e ve-se o supressor trabalhar, com as saidas
        // MUDAS.
        //
        // `sim_laco` tambem conta como "ha laco" para o portao do
        // supressor: sem isso ele recusava-se a cacar com o som cortado, e
        // era essa recusa que tornava o teste seguro impossivel.
        p_sim_laco      = t.Add("sim_laco",      0.0f, 0.f, 1.f);
        p_sim_hz        = t.Add("sim_hz",        0.0f, 60.f, 8000.f, 2.0f);
        p_sim_fb        = t.Add("sim_fb",        0.0f, 0.f, 2.f);

        // ---- COMPRESSOR — sobe a MEDIA, nao o pico ----
        //
        // PARTILHADO pelos dois ramos, de proposito: os dois exciters vivem
        // no mesmo corpo e no mesmo amp, e quatro params por ramo nao cabem
        // (a tabela ia em 121 de 128). Se o ouvido pedir separacao, separa-se
        // — mas nao se gasta oito lugares antes de alguem os pedir.
        //
        // Nasce DESLIGADO. Compressao muda o timbre, e um instrumento que
        // arranca com o som alterado sem ninguem escolher e uma decisao
        // tomada por omissao.
        //
        // Limiar 0,05 e razao 4 sao o ponto de partida para 49 dB de crista
        // — o valor final sai do ouvido do dB, e o `makeup` tem tecto em 8x
        // porque acima disso o limiter passa a trabalhar sempre.
        p_comp_on       = t.Add("comp_on",       0.0f, 0.f, 1.f);
        p_comp_thresh   = t.Add("comp_thresh",   0.05f, 0.001f, 1.f);
        p_comp_razao    = t.Add("comp_razao",    0.3f, 1.f, 20.f);
        p_comp_makeup   = t.Add("comp_makeup",   0.0f, 1.f, 8.f);

        // ---- SuMiA™: supressor de microfonias automatizado ----
        //
        // `micro_auto` nasce LIGADO. Um instrumento que arranca com a
        // protecao desligada e o cenario de 2026-09-02, em que o dB levou com
        // microfonia a volume alto — e o lado seguro e proteger sem
        // precisar, nao o contrario.
        //
        // `micro_dom` e o limiar de dominancia, e a faixa saiu de
        // MEDICOES e nao de teoria: 0,97-1,00 com o instrumento a gritar,
        // 0,14-0,29 depois de cortado, e microfonia real ja mediu 0,61 em
        // 2026-08-31. Uma calibracao anterior em senoides sinteticas dera 0,85,
        // que teria RECUSADO os casos reais. 0,50 fica no meio da vala,
        // longe dos dois lados, e e ajustavel porque o ouvido decide.
        p_micro_auto    = t.Add("micro_auto",    1.0f, 0.f, 1.f);
        p_micro_dom     = t.Add("micro_dom",     0.5f, 0.f, 1.f);
    // ⚠️ NASCEM FECHADAS. A PLACA ARRANCA MUDA, e isto custou dois sustos.
    //
    // Nasciam em 1.0. Cada GRAVACAO e cada arranque abriam o som com as
    // bocas de microfonia VAZIAS — os params nascem nos defaults — e o
    // laco tinha tudo o que precisava. Em 2026-09-02 aconteceu duas vezes: a
    // primeira apanhou o dB com o volume alto, a segunda fez o filho dele
    // gritar. A rampa de 8 s nao chega: ela sobe o som na mesma.
    //
    // Nascer fechado inverte o lado do erro. Antes, esquecer de proteger
    // custava um uivo; agora, esquecer de abrir custa silencio. Silencio
    // nao magoa ninguem.
    //
    // Quem abre e o operador, com `out_l 1` / `out_r 1` — ou, no futuro, o
    // supressor, DEPOIS de ter provado que o corpo esta seguro.
    // NASCEM ABERTAS — a escultura tem de soar SOZINHA.
    //
    // Estiveram a 0.0f durante meia hora em 2026-09-02, depois de dois sustos
    // com microfonia no arranque. O dB desfez essa decisao com uma frase
    // que a mata: "quero que ele funcione sem o loopy". Uma peca em
    // exposicao nao tem ninguem para escrever `out_l 1`.
    //
    // A seguranca nao vem daqui: vem da RAMPA SUPERVISIONADA (ver
    // `kRampaArranqueAmostras` e o recuo em `PassoDoSupressor`). Ela sobe
    // sozinha, e RECUA sempre que o supressor apanha um modo — o som
    // aparece, mas nunca chega a crescer.
    p_out_l         = t.Add("out_l",         1.0f, 0.f, 1.f);
    p_out_r         = t.Add("out_r",         1.0f, 0.f, 1.f);

        // FERRAMENTA DE BANCADA — ver bloco acima. def_norm 0.0 com
        // faixa [1,8] e curve 1 dá real = 1.0 no boot, sempre.
        p_bench_boost[0]   = t.Add("bench_boost_l",   0.0f, 1.f, 8.f);
        p_bench_boost[1]   = t.Add("bench_boost_r",   0.0f, 1.f, 8.f);

        // SHIFTER. Faixa 0–10 Hz, default 4 Hz (norm 0.4). Linear
        // pelo mesmo motivo do gov_ceiling: a borda se procura de
        // ouvido. Acima de ~10 Hz o deslocamento deixa de ser
        // proteção transparente e vira efeito — as harmônicas param
        // de ser múltiplas inteiras e o timbre metaliza.
        p_shift_hz      = t.Add("shift_hz",      0.0f, 0.f, 10.f);

        // REVERB. Os três 0..1: o reverb.h faz o mapeamento pras
        // grandezas internas (size → realimentação [0.7, 0.98], damp →
        // corte do passa-baixa da cauda).
        // 120 Hz, APROVADO DE OUVIDO em 2026-08-17 ("não estoura mais").
        //
        // O caminho até este número, porque ele parece arbitrário e não
        // é: o histograma de pico por nota mostrou a saída do Fx2
        // picando 1,4–1,5 nas portadoras graves contra 0,55 nas agudas.
        // Isso NÃO provava energia grave — o histograma agrupa por
        // pitch da portadora, não por conteúdo espectral, e o excesso
        // podia estar em qualquer lugar. O passa-alta foi ao mesmo
        // tempo hipótese e conserto: se achatasse, era grave mesmo.
        // Achatou.
        //
        // 120 Hz é escolha musical dentro do que a medição permitiu:
        // corta o sub que a portadora empilha, e fica ABAIXO da região
        // de 174–220 Hz que o histograma mostrou saudável (0,70–0,75).
        // Cortar mais alto levaria junto o corpo do som.
        //
        // NO CAMINHO DO FX2, não no master: sem módulo não estoura
        // (medido), então filtrar o master castigaria o delay de graça.
        // Faixa 0–400, curva 2 — resolução embaixo, que é onde se
        // procura. 0 Hz desliga.

        // 0.35 — o valor que o dB tocou e aprovou ("reverb está ótimo").
        // 0.15 era o chute inicial e nunca foi ouvido.
        p_rev_mix[0]       = t.Add("rev_mix_a",       0.0f, 0.f, 1.f);  // MIDI: nasce 0
        p_rev_mix[1]       = t.Add("rev_mix_b",       0.0f, 0.f, 1.f);
        // DESLIGAR O REVERB EMUDECE O SHIMMER, que nao tem reverb
        // proprio — ele realimenta ESTE. Dependencia real, declarada em
        // vez de deixar o dB cacando um efeito que "parou de funcionar".
        p_rev_on[0]        = t.Add("rev_on_a",        0.0f, 0.f, 1.f);
        p_rev_on[1]        = t.Add("rev_on_b",        0.0f, 0.f, 1.f);
        p_rev_size[0]      = t.Add("rev_size_a",      0.50f, 0.f, 1.f);
        p_rev_size[1]      = t.Add("rev_size_b",      0.50f, 0.f, 1.f);
        p_rev_damp[0]      = t.Add("rev_damp_a",      0.50f, 0.f, 1.f);
        p_rev_damp[1]      = t.Add("rev_damp_b",      0.50f, 0.f, 1.f);

        // ---- FREEZE ----
        // Nasce DESLIGADO. Congelar é gesto, e gesto não tem estado
        // default ligado: a placa subindo já congelada seria a
        // escultura tocando sozinha um som que ninguém pediu.
        // O GESTO, separado do envio: `frz_on_a/b` dizem QUAL cadeia
        // alimenta o freeze; este diz QUANDO congelar.
        p_frz_on[0]    = t.Add("frz_on_a",  0.0f, 0.f, 1.f);
        p_frz_on[1]    = t.Add("frz_on_b",  0.0f, 0.f, 1.f);
        p_frz_vol[0]   = t.Add("frz_vol_a", 0.0f, 0.f, 1.f);
        p_frz_vol[1]   = t.Add("frz_vol_b", 0.0f, 0.f, 1.f);
        // Mix em 1.0: congelou, é o congelado que se ouve. Meio a meio
        // deixaria o seco competindo com a sustentação e o gesto
        // perderia clareza — quem quiser camada abaixa no CC.
        // 100 ms de janela. Abaixo de ~40 ms o grão vira timbre
        // próprio (soa granular, "chuvisco"); acima de ~250 ms os dois
        // grãos leem quase o mesmo trecho e o batimento volta.
        // CUIDADO: o primeiro argumento e NORMALIZADO, nao o valor
        // real. Escrever 100.0f aqui satura em 1.0 e o grao nasce em
        // 400 ms — exatamente o tamanho em que os dois graos leem quase
        // o mesmo trecho e o batimento volta. 100 ms = (100-20)/380.
        // FAIXA CORTADA EM 165 ms (2026-08-20). Ia ate 400, e o `SetSize` limita o
        // grao a um TERCO DO NUCLEO — que tem 500 ms, entao o teto real
        // sempre foi ~167. Sessenta e um por cento do curso do fader nao
        // fazia nada, e o dB percebeu tentando mexer no `frz_size_b`.
        //
        // Mesma licao do `dly_time` em 2026-08-18: LIMITE remove o inutil do
        // alcance, CURVA so o redistribui. E vale pros dois canais — o
        // defeito nunca foi do B.
        // O 165 NAO E ARBITRARIO E NAO PODE DESSINCRONIZAR EM SILENCIO.
        //
        // O `Freeze` grampeia o tamanho do grao em `NucleusLen()/3`, e
        // `NucleusLen()` vale `kNucleusMs` (500 ms) convertido pra
        // amostras. Logo o teto real e 500/3 = 166,7 ms, e declarar
        // 165 poe a faixa inteira dentro do curso util com 1,7 ms de
        // margem.
        //
        // Ate 2026-08-20 a faixa era 20..400 ms contra o mesmo clamp: 61%
        // do curso do fader nao fazia nada (bts 12i). Corrigido em
        // d80e45d — e o item ficou meses na FILA descrevendo o estado
        // pre-conserto, que e a deriva de 2026-08-22 num lugar que o
        // `check-docs` nao olha.
        //
        // SE `kNucleusMs` MUDAR, este numero muda junto: novo teto =
        // kNucleusMs/3, menos uma margem. O literal esta aqui porque
        // derivar exigiria o manifest incluir `freeze.h`, e essa
        // dependencia custa mais que este comentario.
        p_frz_size[0]      = t.Add("frz_size_a",      0.0f, 20.f, 165.f); // MIDI: nasce 0 (= 20 ms)
        p_frz_size[1]      = t.Add("frz_size_b",      0.0f, 20.f, 165.f); // MIDI: nasce 0 (= 20 ms)

        // ---- DRIVE ----
        p_drv_on[0]    = t.Add("drv_on_a",    0.0f, 0.f, 1.f);
        p_drv_on[1]    = t.Add("drv_on_b",    0.0f, 0.f, 1.f);
        // FAIXA CORTADA POR BAIXO, mesma regua do dly_time: 1.5x ja e
        // cola audivel, e abaixo disso o waveshaper nao faz nada que o
        // ouvido perceba. Curso inteiro util, agressivo so no fim.
        //   0% = 1.5x | 25% = 4.1x | 50% = 6.8x | 100% = 12x
        // Passa-baixa pos-saturacao. No topo e transparente de
        // proposito: "tone no maximo" tem que significar SEM filtro.
        p_drv_mix[0]   = t.Add("drv_mix_a",   0.0f, 0.f, 1.f);
        p_drv_mix[1]   = t.Add("drv_mix_b",   0.0f, 0.f, 1.f);
        p_drv_drive[0] = t.Add("drv_drive_a", 0.0f, 1.5f, 48.f);
        p_drv_drive[1] = t.Add("drv_drive_b", 0.0f, 1.5f, 48.f);
        p_drv_tone[0] = t.Add("drv_tone_a", 0.0f, 800.f, 16000.f, 2.0f);
        p_drv_tone[1] = t.Add("drv_tone_b", 0.0f, 800.f, 16000.f, 2.0f);
        // NASCE EM 0 = o tube aprovado de ouvido em 2026-08-22. Subir
        // daqui e ir pro dobrador, que e o "bem mais suja" pedido.
        p_drv_sujeira[0] = t.Add("drv_sujeira_a", 0.0f, 0.f, 1.f);
        p_drv_sujeira[1] = t.Add("drv_sujeira_b", 0.0f, 0.f, 1.f);

        // ---- PHASER ----
        p_phs_on[0]       = t.Add("phs_on_a",       0.0f, 0.f, 1.f);
        p_phs_on[1]       = t.Add("phs_on_b",       0.0f, 0.f, 1.f);
        // 0.02 a 4 Hz. Abaixo de 0.02 o movimento some; acima de ~4 ja
        // e vibrato de fase, nao phaser.
        // 3 posicoes: 4, 6 ou 8 estagios (2, 3 ou 4 notches).
        p_phs_mix[0]      = t.Add("phs_mix_a",      0.0f, 0.f, 1.f);
        p_phs_mix[1]      = t.Add("phs_mix_b",      0.0f, 0.f, 1.f);
        p_phs_rate[0] = t.Add("phs_rate_a", 0.0f, 0.02f, 4.f, 2.0f);
        p_phs_rate[1] = t.Add("phs_rate_b", 0.0f, 0.02f, 4.f, 2.0f);
        p_phs_depth[0] = t.Add("phs_depth_a", 0.0f, 0.f, 1.f);
        p_phs_depth[1] = t.Add("phs_depth_b", 0.0f, 0.f, 1.f);
        p_phs_feedback[0] = t.Add("phs_fb_a", 0.0f, 0.f, 1.f);
        p_phs_feedback[1] = t.Add("phs_fb_b", 0.0f, 0.f, 1.f);
        p_phs_stages[0] = t.Add("phs_stages_a", 0.0f, 4.f, 8.f, 1.0f, 3);
        p_phs_stages[1] = t.Add("phs_stages_b", 0.0f, 4.f, 8.f, 1.0f, 3);

        // ---- WARBLE ----
        p_wrb_on[0]    = t.Add("wrb_on_a",    0.0f, 0.f, 1.f);
        p_wrb_on[1]    = t.Add("wrb_on_b",    0.0f, 0.f, 1.f);
        p_wrb_mix[0]   = t.Add("wrb_mix_a",   0.0f, 0.f, 1.f);
        p_wrb_mix[1]   = t.Add("wrb_mix_b",   0.0f, 0.f, 1.f);
        // 0,5–12 Hz desde 2026-08-28, por veredito de ouvido do dB: "vai de
        // muito devagar a devagar". Era 0,05–3 Hz com curva 2.0, e as duas
        // coisas empurravam para o mesmo lado — a meio do curso dava
        // 0,79 Hz, e o TOPO eram 3 Hz, que ja e lento.
        //
        // A curva 2.0 FICA: com o minimo em 0,5 o extremo lento deixou de
        // ser sub-audio, e a curva continua a dar resolucao onde o gesto
        // e fino. A meio do curso passa a dar ~3,4 Hz — onde ficava o
        // maximo antigo —, entao tudo o que existia mora agora na metade
        // de baixo, e a de cima e territorio novo.
        //
        // MUDAR FAIXA NAO MUDA O HASH DO MAPA (ele cobre nomes), mas MUDA
        // o real que um preset velho produziria: o preset guarda o
        // normalizado. Saiu de graca porque ainda nao existe preset nenhum.
        // TAROLATOR: nasce DESLIGADO. Feature nova que nasce a mudar o som
        // e feature que se descobre pelo susto.
        p_tarol_on[0]  = t.Add("tarol_on_a",  0.0f, 0.f, 1.f);
        p_tarol_on[1]  = t.Add("tarol_on_b",  0.0f, 0.f, 1.f);
        // MIX ATE 4x, COM CURVA 0.5, e as duas coisas vem do mesmo relato:
        // na primeira versao (0–1, linear) o dB so ouvia o efeito no topo
        // do fader — dois tercos de curso morto.
        //
        // O 4x e o teto UTIL, nao um numero redondo: acima disso o tarol
        // domina a cadeia por completo e o limiter grampeia, entao mais
        // ganho deixa de significar mais efeito. 100% e o maximo que este
        // efeito consegue gerar, que foi o pedido.
        //
        // A curva 0.5 puxa a resolucao para BAIXO (o contrario do usual
        // neste manifest): a 10% do curso ja da 1,26x, que e onde o efeito
        // comecava a ser audivel antes. Assim o fader inteiro faz alguma
        // coisa — SE NAO SOA, NAO FICA vale tambem para pedacos de curso.
        p_tarol_mix[0] = t.Add("tarol_mix_a", 0.5f, 0.f, 4.f, 0.5f);
        p_tarol_mix[1] = t.Add("tarol_mix_b", 0.5f, 0.f, 4.f, 0.5f);

        // NOTCH — 60 Hz a 8 kHz, que e onde vivem os modos de um corpo
        // metalico deste tamanho. Curva 2.0 porque os modos sao
        // logaritmicos como o ouvido: faixa linear poria metade do
        // curso acima de 4 kHz, onde nao grita quase nada.
        //
        // `db` e REJEICAO, e nasce em ZERO. Um notch que nascesse a
        // cortar esconderia um modo antes de alguem o ter ouvido.
        p_notch_on[0]    = t.Add("microfonia_on_l",    0.0f, 0.f, 1.f);
        p_notch_on[1]    = t.Add("microfonia_on_r",    0.0f, 0.f, 1.f);
        p_notch_hz[0][0] = t.Add("microfonia1_hz_l",   0.0f, 60.f, 8000.f, 2.0f);
        p_notch_hz[1][0] = t.Add("microfonia1_hz_r",   0.0f, 60.f, 8000.f, 2.0f);
        p_notch_db[0][0] = t.Add("microfonia1_db_l",   0.0f, 0.f, 24.f);
        p_notch_db[1][0] = t.Add("microfonia1_db_r",   0.0f, 0.f, 24.f);
        p_notch_hz[0][1] = t.Add("microfonia2_hz_l",   0.0f, 60.f, 8000.f, 2.0f);
        p_notch_hz[1][1] = t.Add("microfonia2_hz_r",   0.0f, 60.f, 8000.f, 2.0f);
        p_notch_db[0][1] = t.Add("microfonia2_db_l",   0.0f, 0.f, 24.f);
        p_notch_db[1][1] = t.Add("microfonia2_db_r",   0.0f, 0.f, 24.f);
        p_notch_hz[0][2] = t.Add("microfonia3_hz_l",  0.0f, 60.f, 8000.f, 2.0f);
        p_notch_db[0][2] = t.Add("microfonia3_db_l",  0.0f,  0.f,   24.f);
        p_notch_hz[1][2] = t.Add("microfonia3_hz_r",  0.0f, 60.f, 8000.f, 2.0f);
        p_notch_db[1][2] = t.Add("microfonia3_db_r",  0.0f,  0.f,   24.f);
        p_notch_hz[0][3] = t.Add("microfonia4_hz_l",  0.0f, 60.f, 8000.f, 2.0f);
        p_notch_db[0][3] = t.Add("microfonia4_db_l",  0.0f,  0.f,   24.f);
        p_notch_hz[1][3] = t.Add("microfonia4_hz_r",  0.0f, 60.f, 8000.f, 2.0f);
        p_notch_db[1][3] = t.Add("microfonia4_db_r",  0.0f,  0.f,   24.f);
        p_wrb_rate[0] = t.Add("wrb_rate_a", 0.0f, 0.5f, 12.f, 2.0f);
        p_wrb_rate[1] = t.Add("wrb_rate_b", 0.0f, 0.5f, 12.f, 2.0f);
        p_wrb_depth[0] = t.Add("wrb_depth_a", 0.0f, 0.f, 3.f);
        p_wrb_depth[1] = t.Add("wrb_depth_b", 0.0f, 0.f, 3.f);
        p_wrb_irreg[0] = t.Add("wrb_irreg_a", 0.0f, 0.f, 1.f);
        p_wrb_irreg[1] = t.Add("wrb_irreg_b", 0.0f, 0.f, 1.f);
        // Ate 3 ms. O desvio de altura e ~2*pi*rate*depth: 1 ms a
        // 0,6 Hz da ~4 cents (fita boa); 3 ms a 2 Hz da ~65 cents
        // (fita estragada — as vezes e o que se quer).

        // TOM DE TESTE: destino. 0=A 1=B 2=AMBAS (default).
        // ORDEM DO PAINEL (2026-08-28): 0=A+B, 1=so A, 2=so B.
        // Nasce em ZERO como todos os outros — e zero e o estado
        // normal (as duas cadeias), nao um modo de diagnostico. A
        // ordem anterior (0=A, 1=B, 2=ambas) obrigava o default a
        // ser 2 e fazia do estado comum uma excecao a regra da casa.
        p_test_tone_out = t.Add("test_tone_out", 0.0f, 0.f, 2.f, 1.0f, 3);
        // VIA DO TOM DE TESTE (2026-08-28). Duas ferramentas diferentes com o
        // mesmo oscilador, e o switch diz qual:
        //   0 = DIRETO — entra no estagio de saida, DEPOIS do `level`.
        //       Referencia limpa: independente do nivel do utilizador e
        //       do processamento. E o que serve para calibrar e para o
        //       discriminante do codec.
        //   1 = CADEIA — entra dentro das cadeias, como sempre entrou.
        //       Atravessa drive, phaser, reverb e o `level`. E o que
        //       serve para excitar o processamento com sinal conhecido.
        // Nasce em ZERO (direto): o uso comum e medir, e medicao que
        // depende do que o musico deixou no fader nao e medicao.
        p_test_tone_via = t.Add("test_tone_via", 0.0f, 0.f, 1.f, 1.0f, 2);

        // ---- DESCRITOR POR EFEITO DE CARATER ----
        for(int c = 0; c < kCadeias; c++)
        {
            // O PRIMARIO agora e COMPARTILHADO; so a chave e por canal.
            caracter[c][0] = {p_drv_on[c], p_drv_drive[c], "drive", "drive"};
            caracter[c][1] = {p_phs_on[c], p_phs_rate[c],  "phaser", "rate"};
            caracter[c][2] = {p_wrb_on[c], p_wrb_depth[c], "warble", "depth"};
        }

        // ---- SHIMMER ----
        // Tudo em zero: o dB constroi subindo os faders (ver a nota dos
        // defaults no topo desta funcao).
        p_shm_on[0]       = t.Add("shm_on_a",       0.0f, 0.f, 1.f);
        p_shm_on[1]       = t.Add("shm_on_b",       0.0f, 0.f, 1.f);
        p_shm_mix[0]      = t.Add("shm_mix_a",      0.0f, 0.f, 1.f);
        p_shm_mix[1]      = t.Add("shm_mix_b",      0.0f, 0.f, 1.f);
        // Chave de 3 posicoes. steps=3 faz o CC cair em terços limpos.
        p_shm_shift[0]    = t.Add("shm_shift_a",    0.0f, 0.f, 2.f, 1.0f, 3);
        p_shm_shift[1]    = t.Add("shm_shift_b",    0.0f, 0.f, 2.f, 1.0f, 3);
        // O teto de 0.85 mora no shimmer.h, nao aqui: e limite de
        // ESTABILIDADE do laco, nao preferencia musical. Param vai a
        // 1.0 e o efeito escala pra dentro do seguro.
        p_shm_feedback[0] = t.Add("shm_feedback_a", 0.0f, 0.f, 1.f);
        p_shm_feedback[1] = t.Add("shm_feedback_b", 0.0f, 0.f, 1.f);
        // TOM: sobe pra clarear. 0 e o estado BOM, nao o mais brilhante
        // — a regra do default zero desliga efeito, nao escolhe o pior
        // timbre. Medido: 0 poe a cauda em centroide 3189 Hz, 1 em 5507.
        p_shm_tone[0]     = t.Add("shm_tone_a",     0.0f, 0.f, 1.f);
        p_shm_tone[1]     = t.Add("shm_tone_b",     0.0f, 0.f, 1.f);

        // tone_freq e tone_mix ficaram SEM knob: os três primeiros
        // foram pro delay e pro level. Seguem alcançáveis pelo serial
        // (`tone on`/`tone off`) e pelo default — o tom de teste é
        // bancada, não performance.
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
