Belquer/Cotucatronics/(commit log)

2026-08-15 Cotucatronics OS v0.2: base funcional na Daisy Seed 2
    Primeira base que compila, grava e passa T1-T3 na bancada.
    Arquitetura (fechada): fronteira HAL — nenhum include de fabricante
    fora de hal_<board>.cpp; parametros normalizados 0-1 em tabela central;
    macros com peso/inversao; manifest por instrumento com Requirements
    conferidos no boot; AllocBig() abstraindo a SDRAM.
    Dois bugs silenciosos corrigidos nesta bancada:
    - hal_daisy_seed v0.2.1: o despacho serial rodava em contexto de ISR.
    SetReceiveCallback dispara na interrupcao do USB e hal::Log()
    transmite pelo mesmo periferico, entao o segundo Log esperava um TX
    que so completa quando a ISR retorna. Deadlock: "list" travava a
    pl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
    [cotuca_serial.py, hal.h, hal_daisy_seed.cpp, main.cpp, manifest.h, params.h]
2026-08-15 Documenta a arquitetura, o build e os defeitos conhecidos
    O repo nasceu sem README. Sem ele, o ambiente que funciona (toolchain
    com newlib, o Error 74 benigno do dfu-util, o -u _printf_float) so
    existia no historico da bancada e ia se perder.
    Registra tambem o signal path completo do sistema — piezo, SRC MIX,
    exciter, roteamento por toggle — que ainda nao esta implementado mas
    condiciona decisoes de arquitetura.
2026-08-15 Loop responsivo, SRC MIX e o portao unico da SDRAM
    Tres mudancas de preparacao pra integracao RNBO.
    1. Loop responsivo (main.cpp v0.3.0). O DelayMs(500) virou tick de 1 ms.
    Desde que o despacho serial saiu da ISR, aquele sleep era o teto de
    resposta a comando: ate meio segundo de latencia, intocavel pra tocar.
    PollSerial() e leitura de knobs agora rodam a cada tick, e o LED virou
    heartbeat contado (toggle a cada 500 ticks) — mesmo 1 Hz de antes, sem
    bloquear o loop. Verificado com comandos a 0,35 s: resposta imediata.
    2. SRC MIX (k5). O painel tem 5 knobs: 4 de carater + SRC MIX. kNumKnobs
    e num_knobs sobem pra 5, novo parametro normalizado src_mix (default
    0.0) faz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
2026-08-15 Corrige a saida de log picotada trocando o Logger da libDaisy
    O Logger da libDaisy formata tudo num static char tx_buff_[128] UNICO e
    transmite sem esperar. Duas linhas seguidas se sobrescreviam em pleno
    voo: a saida vinha truncada e grudada ("SDRAM via AllocBig:$$ 0 level"),
    as vezes sumia por completo. Um comando isolado saia intacto, o que
    mascarava o problema.
    A hipotese anterior — TX descartado por BUSY — estava errada, e por isso
    o System::Delay(2) por linha nao curou nada: o problema nao e ritmo, e o
    buffer ser um so. Delay removido.
    hal::Log agora ignora o Logger e transmite direto por
    usb_handle.TransmitInternal(), com dois buffers alternados e retry ate o
    CDC aceitar. Como Lo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
    [hal_daisy_seed.cpp]
2026-08-15 Adiciona medicao de frequencia por FFT
    Ate agora o teste de afinacao dependia do ouvido: "soou" e "mudou de
    altura". Isso nao pega erro de escala nem desvio de clock, e nao serve
    de regressao quando o oscilador de teste for substituido pelo RNBO.
    cotuca_measure.py grava um trecho de uma entrada de audio e reporta a
    frequencia dominante por FFT, com janela de Hann e interpolacao
    parabolica no log-magnitude pra precisao sub-bin. Reporta tambem o nivel
    em dBFS e, com --expect, o erro em Hz e em cents.
    Medido na Seed 2 pelo caminho eletrico (MiniFuse 4 ch2), com a faixa
    inteira do tone_freq:
    k2 0.0 -> 80.02 Hz (alvo 80) +0.5 cents
    k2 0.1875 -> 440.12 Hz (alvo 440) +0.5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
2026-08-15 Embarca o primeiro módulo RNBO: delay
    O oscilador de teste era o único DSP do firmware. Este commit abre a
    porta pro Max: o export C++ do RNBO vira um cotuca::Module, e a partir
    daqui toda escultura é um patch exportado, não código escrito à mão.
    Por que module_rnbo.cpp é um arquivo só e inclui o export como fonte:
    é a mesma regra de fronteira do hal_<board>.cpp. Só ele vê RNBO.h,
    então trocar de motor de DSP é escrever outro module_<engine>.cpp e
    main.cpp não fica sabendo. E o .cpp gerado precisa ser incluído — não
    compilado à parte — porque as macros de configuração (RNBO_NOTHROW,
    RNBO_USE_FLOAT32, RNBO_USECUSTOMALLOCATOR) são lidas pelos headers:
    compilado como u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
2026-08-15 Documenta a receita de embarque de módulos RNBO
    Fazer o primeiro export do RNBO rodar na Daisy custou uma sequência de
    descobertas que não estão em lugar nenhum: a ordem das macros, o export
    incluído como fonte, a MinimalEngine no lugar da engine completa, o
    alocador híbrido. Nada disso é dedutível do código depois do fato — o
    module_rnbo.cpp mostra O QUE foi feito, não o que acontece se não for.
    Este é o template de toda escultura futura. Sete passos, um checklist e
    uma tabela de armadilhas em ordem de dor, pra que o segundo módulo não
    redescubra o primeiro.
    Registra também uma bomba-relógio: o export do delay saiu com o
    classname padrão `rnbomatic`. Com um módulo só,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
2026-08-15 Migra o app pra QSPI via bootloader da Electrosmith
    Com um único módulo RNBO embarcado o firmware chegou a 123392 B dos
    128 KB de flash interna — 94,14%. O segundo módulo não caberia, e
    descobrir isso no meio da próxima escultura seria descobrir sob
    pressão. Melhor pagar a migração agora, com o firmware validando.
    APP_TYPE=BOOT_QSPI joga o app pros 8 MB da QSPI e entrega os 128 KB
    internos pro bootloader. O mesmo firmware passa de 94,14% de 128 KB
    para 1,52% de 7936 KB: o teto some como problema.
    O que se paga: o M7 executa da QSPI mais devagar que da flash interna
    (mitigado pelo I-cache, mas real — vale medir se um módulo pesado
    começar a apertar o prazo do bloco de áudio),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
2026-08-15 Atualiza docs: fluxo QSPI, T5 e a SDRAM que voltou
    TESTES.md: o fluxo de gravação mudou de verdade — program-boot uma vez
    por placa pelo DFU da STM, e depois só RESET + program-dfu dentro da
    janela de graça. Tabela de antes/depois pra não gravar no endereço
    errado por hábito, e o caminho de volta pra flash interna.
    Ganha o T5, que é o critério de aceite do primeiro módulo RNBO:
    descoberta dos params por nome (T5a) e confirmação sonora (T5b) — trem
    de ecos decaindo com feedback interno de 0.4, k1 varrendo o tempo
    audivelmente, k2 em 0 secando o som. Compilar não é evidência: o
    patcher pode estar montado e mudo. O T5 está marcado PENDENTE porque
    gravar exige o botão BOOT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
2026-08-15 Fecha o T5: delay RNBO tocando na placa, com CPU medida
    O modulo RNBO deixou de ser codigo que compila e passou a ser modulo
    que funciona. Bootloader da Electrosmith gravado na flash interna e app
    gravado na QSPI (0x90040000).
    Instrumentacao nova pra fechar o unico item que faltava do aceite:
    hal.h v0.3.0 ganha CpuLoadAvg()/CpuLoadMax() no contrato,
    hal_daisy_seed v0.4.0 implementa com o CpuLoadMeter da libDaisy
    envolvendo o callback, e main.cpp v0.4.1 expoe o comando "cpu".
    T5a — descoberta por nome: 2 params (dly_time, dly_mix), duas ligacoes
    resolvidas em [0] e [1], nenhum AVISO, 15 blocos alocados, 0 falhas.
    T5b — eco nao muda afinacao, entao FFT de frequencia nao prova delay.
    A p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
2026-08-15 Curva de parametro, set serial generico e a regra do 8B/amostra
    Tres mudancas de ergonomia e documentacao, antes do modulo 2.
    1. ParamTable ganha expoente por parametro (params.h v0.3.0):
    real = min + pow(norm, curve) * (max - min)
    Default 1.0 = linear, com caminho rapido que pula o pow (Real() e
    chamado a cada bloco). O dly_time usa 2.5: metade do curso do knob
    passa a cobrir os primeiros ~18% da faixa, que e onde moram os
    delays curtos.
    CURVA E DECISAO DE MANIFEST, NAO DE MODULO. E ergonomia — como o
    knob se comporta na mao — nao DSP. O modulo recebe o valor ja
    curvado e nao sabe que houve curva, e o mesmo export do RNBO serve
    a esculturas com curvas di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
2026-08-15 Valida a curva em placa: T6 passou
    Fecha a pendencia do commit anterior — a curva estava commitada sem
    validacao em hardware, porque gravar exige um toque fisico no RESET.
    T6a — real = pow(norm, 2.5) bate nos cinco pontos do curso:
    0.00->0.00, 0.25->0.03, 0.50->0.18, 0.75->0.49, 1.00->1.00. Metade do
    knob cobre os primeiros ~18% da faixa, que era o objetivo.
    T6b — o teste que importa nao e o list mostrar o numero certo, e o RNBO
    receber esse numero. Cauda 1 s apos cortar a fonte, 440 Hz, dly_mix 1.0:
    k1 0.5 (real 0.177, curto) -> -28.7 dBFS
    k1 0.9 (real 0.768, longo) -> -7.2 dBFS
    21,5 dB de separacao. Delay curto repete mais por segundo e decai mais
    rapido; com o normalizado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
2026-08-15 Dinamica 1/3: envelope follower compartilhado e gate na entrada
    Primeiro bloco da cadeia de dinamica do shell. C++ puro,
    board-agnostic, sem RNBO: isto nao e DSP de instrumento, e politica
    de seguranca e comportamento que vale pra toda escultura
    independente do modulo carregado. Por isso vive no shell e nao num
    patch — trocar o modulo nao pode trocar a politica.
    dynamics.h v0.1.0 traz o EnvFollower, detector de um polo com
    constantes separadas de subida e descida. E a base compartilhada dos
    tres blocos: gate, governor e limiter diferem no que FAZEM com o
    envelope, nao em como o medem. Uma implementacao de detector, tres
    politicas em cima.
    Gate: abaixo do threshold o ganho vai a zero com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
2026-08-15 Dinamica 2/3: governor soft-knee no ramo do exciter
    Segundo bloco. Politica INVERSA a do gate: o gate age no que e
    pequeno demais, o governor no que e grande demais. Mesmo EnvFollower,
    decisoes opostas — que e exatamente por que o detector foi feito
    compartilhado no commit anterior.
    Nao e limiter. O limiter (3/3) e absoluto e inegociavel; o governor e
    negociavel e musical: soft-knee de joelho largo (50% do teto), slope
    1/4 acima dele, attack 5 ms pra proteger e release 800 ms pra nao
    bombear. A reducao deve soar como o instrumento CEDENDO, nao batendo
    numa parede.
    Soft-knee em dominio linear, sem powf: acima do teto so uma fracao do
    excesso passa, e a transicao entra por interpolacao qua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
2026-08-15 Dinamica 3/3: limiter por ramo e roteamento de saida
    Terceiro e ultimo bloco. INEGOCIAVEL E SEM PARAMETRO EXPOSTO, de
    proposito: gate e governor sao politica musical e se ajustam, o
    limiter e a ultima linha entre o firmware e um exciter queimado.
    Coisa que protege hardware nao vira knob — nao existe cenario em que
    valha desliga-lo, e existir um parametro so cria o cenario de
    desliga-lo por engano.
    Duas camadas, porque uma so nao basta:
    1. ganho suavizado (attack 1 ms) quando o envelope passa de 0.95.
    E o que faz a reducao soar limpa em vez de aspera.
    2. clamp duro no fim. A camada 1 tem tempo de ataque, entao um
    transiente rapido o bastante passa por ela; o clamp garante qu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
2026-08-15 Corrige degrau no joelho do governor, achado por teste nativo
    dynamics.h e C++ puro e board-agnostic — nao inclui hal.h nem nada de
    fabricante. Isso significa que a matematica dos tres blocos compila e
    roda no Mac, sem placa e sem flash. Escrevi o banco de teste pra usar
    o tempo de espera pelo RESET, e ele achou um bug audivel de primeira.
    O bug: o soft-knee do governor multiplicava a excursao inteira pelo
    slope INSTANTANEO —
    out = lo + (env - lo) * slope(t)
    — em vez de integrar o slope ao longo do joelho. Com isso as duas
    metades da curva nao se encontram no topo do joelho: com ceiling 0.5,
    o ramo do joelho entrega 0.4375 e o ramo acima entrega 0.53125. Um
    degrau de 0.094 na curv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
    [dynamics.h, test_dynamics.cpp]
2026-08-16 bench_boost: ferramenta de bancada, e o T7 fechado em placa
    O limiter era inexercitavel na placa: o oscilador de teste devolve
    sin*0.5 e o level vai ate 1.0, entao o pico interno para em ~0.5 contra
    um teto de 0.95. Um limiter que nunca engata e um limiter nao testado.
    bench_boost resolve isso sem tocar no ganho que vai pro palco. Faixa
    [1,8] linear, aplicado imediatamente antes do limiter, so no ramo do
    exciter. Tres salvaguardas:
    (a) bloco de aviso em caixa alta no manifest.h — nunca mapear a knob,
    encoder, botao ou cena;
    (b) nao persiste: def_norm 0.0 numa faixa que comeca em 1.0 faz o
    boot nascer em 1.0 estruturalmente, nao por default que alguem
    possa esquecer de ap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
    [dynamics.h, main.cpp, manifest.h]
2026-08-16 set passa a falar em unidade real; fecha o defeito #6
    set <nome> <valor> recebia NORMALIZADO. Coerente com o ParamTable por
    dentro, mas invertia a intuicao em qualquer faixa que nao comeca em
    zero: `set bench_boost 1.0` parecia "sem boost" e entregava 8x, o
    maximo — num parametro que existe justamente pra sobrecarregar a saida
    do exciter. "Parece seguro e e o maximo" e a inversao errada pra ter
    num instrumento, e eu mesmo cai nela ao conferir o firmware recem
    gravado.
    Agora set fala na unidade do parametro — Hz, ms, vezes — e converte
    invertendo a curva:
    norm = pow((real - min) / (max - min), 1/curve)
    Fora da faixa RECUSA em vez de saturar, citando os limites reais. Quem
    digita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
2026-08-16 Slots fixos, registro de modulos e o slot do shifter
    Prepara o shell pro segundo modulo. Tres mudancas que se sustentam
    mutuamente.
    1. SLOTS FIXOS (module.h v0.2.0). O shell passa a ter posicoes
    definidas na cadeia — Instrument no caminho principal, Shifter no
    ramo do exciter entre o split e o governor — em vez de uma lista
    livre de plugins.
    E escolha, nao limitacao. Cadeia livre pediria ordem configuravel
    em runtime, e num instrumento realimentado A ORDEM E A SEGURANCA:
    o shifter tem que vir antes do governor (o governor precisa reagir
    ao sinal que de fato vai pro exciter, ja deslocado) e o limiter tem
    que ser o ultimo. Slot fixo torna isso estrutural em vez de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
    [main.cpp, manifest.h, params.h]
2026-08-16 Shifter SSB fecha o stack anti-feedback de software
    Quarto bloco permanente do shell, em C++, no ramo do exciter entre o
    split e o governor. Frequency shifter de banda lateral unica: par de
    cadeias allpass IIR em quadratura (Hilbert aproximado, 8a ordem por
    ramo), oscilador de quadratura em forma acoplada, I*cos + Q*sin.
    Deslocar alguns Hz quebra a coerencia do laco piezo->corpo->exciter:
    o retorno nao coincide mais em fase com o que saiu, e a realimentacao
    nao encontra frequencia pra travar. Nao e pitch shift — o
    deslocamento e LINEAR em Hz, entao as harmonicas deixam de ser
    multiplas inteiras. Dai soar metalico acima de ~10 Hz, e dai a faixa
    parar em 10.
    SSB e nao modulacao em anel por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
2026-08-16 T8 completo: jack sem shift, confirmado por medicao
    Fecha o unico criterio pendente do shifter. Cabo movido pro pino 19
    (OUT_R), mesmo tom 440 Hz e mesmo shift_hz 5:
    440 Hz (original) -4.4 dBFS
    445 Hz (banda superior) -111.1 dBFS -106.7 dB
    435 Hz (banda inferior) -108.7 dBFS -104.3 dB
    106,7 dB de rejeicao e piso de ruido, nao supressao parcial: o jack
    sai absolutamente limpo. O split entre os ramos e real, e a decisao de
    que o jack nao leva anti-feedback esta verificada dos dois lados.
    Roteamento tambem confirmado do lado do jack: cada ramo responde so ao
    proprio route, e mutar um nao toca no outro.
    ERRO DE BANCADA REGISTRADO. A primeira rodada do teste de roteamento
    usav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
2026-08-16 Contrato de duas entradas: ch2 e a portadora externa
    Estende Module pra modulos de 2 canais de entrada, que e o que
    cross-synthesis exige. Independe do vocoder: o freeze ja e 2-in e
    estava recebendo a coisa errada.
    Module ganha InputCount(), default 1. A convencao:
    ch1 = sinal do ponto da cadeia onde o slot esta — pos-crossfade
    de fontes e pos-gate, ou seja o instrumento;
    ch2 = IN_R CRU, direto do jack, ANTES do crossfade e ANTES do gate.
    Que ch2 nao passe por nenhum dos dois e deliberado. O crossfade
    existe pra escolher UMA fonte entre piezo e jack; um modulo de duas
    entradas quer as duas ao mesmo tempo, entao passar pelo crossfade
    seria pedir que ele escolhesse justamente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
2026-08-16 Janela de graca, bloco por manifest e a infra do vocoder
    Trabalho provado, independente do destino do patch do vocoder.
    1. JANELA DE GRACA no watchdog. Um modulo pode fazer trabalho de UMA
    VEZ no primeiro Process — o RNBO aloca buffers de FFT
    preguicosamente. Condenar por isso confunde custo de estreia com
    custo de regime, que e justamente a pergunta que interessa.
    Durante a graca (24 blocos) o watchdog nao trava, e ao fim dela o
    medidor e ZERADO: o pico reportado depois e so regime permanente.
    Isso ja pagou: o vocoder marcava 233 965 us no primeiro bloco e
    5 609 us em regime. Sem a graca, 42x de diferenca ficava invisivel
    e a conclusao teria sido "impossivel" em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
2026-08-16 Vocoder FFT 1024 cabe no bloco 256; e o alloc.h que faltava no repo
    BALANCA FECHADA. Export FFT 1024/hop 512, watchdog e graca armados,
    480 MHz:
    bloco 128 (2667us) bloco 256 (5333us)
    estreia -- 81 761 us
    regime 2 984 us 3 561 us
    vs prazo 112% 67%
    veredito nao cabe CABE, com folga
    67% deixa 33 pontos abaixo da regua de 95% — ~1770 us de margem, que
    comporta a variacao de execucao da QSPI e ainda outro bloco moderado
    na cadeia. Nao e "passou raspando": e a casa dele.
    O 128 falha por 12%, o que e informacao util: nao esta longe. Se a
    latenc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
2026-08-16 Warm-up no Init mata a estreia; ordem de config corrigida; make check
    Tres coisas, todas medidas.
    1. WARM-UP COMO POLITICA DO SLOT. Todo modulo embarcado leva ~4096
    amostras de silencio no Init, antes do audio comecar.
    A medicao decidiu o desenho, e contra a intuicao: o custo de
    estreia NAO mora no primeiro Process, mora no primeiro HOP. Perfil
    bloco a bloco do vocoder (FFT 1024/hop 512, bloco 256):
    bloco 1: 932 us bloco 5: 1 122 us
    bloco 2: 81 563 us <- bloco 6: 3 526 us
    bloco 3: 1 136 us bloco 7: 1 100 us
    bloco 4: 42 512 us <- bloco 8: 2 367 us
    Uma chamada de silencio teria pago o bloco 1, que e justamente o
    barato. Sao precis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
    [main.cpp]
2026-08-16 Registra o estado da placa e o pool a 96,6%
    Fechamento da sequencia, depois da auditoria externa num clone limpo.
    1. MODO BANCADA documentado como estado da placa, no BOARDS.md e em
    destaque no README: 480 MHz, bloco 256, -O3, app na QSPI, OS
    v0.15.0 / HAL v0.7.0. O proximo trabalho e de hardware, e daqui a
    semanas ninguem lembra de cabeca o que esta gravado.
    Fica registrado tambem que o bloco 256 e do INSTRUMENTO DE TESTE —
    existe porque o vocoder precisa. Escultura sem modulo espectral roda
    em 48 com 1 ms de latencia; o bloco e decisao de manifest por isso.
    E que o -O3 e candidato a reverter: medido contra -O2, a media
    PIOROU (11,3% -> 13,0%) porque o binario i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
2026-08-16 Estado instrumento vira o default do repo
    Fecha a sequencia. Regra da casa daqui em diante: O REPO VERSIONA O
    INSTRUMENTO; BANCADA E ESTADO TRANSITORIO. O que esta no main e o que
    deve estar na placa pra tocar; configuracao de medicao e receita
    documentada, nao commit.
    1. ESTADO INSTRUMENTO versionado:
    bloco 48 (1 000 us de prazo, 1 ms de latencia)
    modulos delay no slot instrument, fx2 VAZIO
    dly_time 0,40 real (norm 0,69 com curve 2,5)
    dly_mix 0,50
    cpu medida 188 us de 1 000 — 18,8%
    O vocoder sai do MODULE_SRC. Ele existe e cabe, mas exige bloco 256
    e 5,3 ms de latencia — nao e o regime de tocar. Slot vazio e melhor
    que modulo d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
2026-08-16 Entrada MIDI: UART no HAL, parser no shell, CC como knob remoto
    O instrumento tem 15 parametros e o painel tem 5 knobs. Ate agora o
    que nao coube no painel so era alcancavel digitando no serial — o que
    serve pra bancada e nao serve pra nada com a escultura na mao. O
    gov_ceiling e o caso que dói: e a "borda de feedback", o ajuste que se
    procura DE OUVIDO, e procurar de ouvido digitando e impossivel.
    FRONTEIRA. O HAL entrega BYTES CRUS, um a um; a maquina de estados
    mora em midi.h, board-agnostic, ao lado de params.h e dynamics.h. A
    divisao nao e purismo: "como os bytes chegam" muda de placa pra placa
    (DMA, interrupcao, polling), "o que eles significam" nao muda nunca —
    um parser dentro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
2026-08-16 Caca a ruido: o USB do computador e a fonte dominante
    Medido com entrada em curto (AUDIO_IN_L -> AGND, piezo fora) e cadeia
    neutralizada. Detalhe que decide a validade da medicao: gate_thresh em
    ZERO, pra manter o gate permanentemente aberto — com ele fechando, o
    piso fica mascarado e o espectro nao vale nada.
    USB do PC powerbank delta
    pico -44,1 dBFS -64,4 dBFS -20 dB
    16 002 Hz -80,9 some
    7 998 Hz -85,2 some
    3 000 Hz -86,9 -100,5 -13,6
    1 998 Hz -88,9 -97,4 -8,5
    1 002 Hz -88,1 -90,4 -2,3
    VEREDITO. Apito = harmonico de 16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
2026-08-16 Corrige o enquadramento: a bateria ja era o projeto
    A nota de ruido dizia "argumento direto pra bateria interna no build",
    o que faria um leitor futuro entender que a decisao veio desta medicao.
    Nao veio: a bateria sempre esteve no plano e o USB e so pra gravar
    firmware.
    O que a medicao acrescenta e outra coisa, e mais util: o numero do que
    a configuracao de BANCADA custa, e a confirmacao de que o ruido
    reportado nao acompanha o instrumento montado.
    Fica explicito que na bateria o unico ruido remanescente e o residual
    de 1 kHz — nosso, a -90 dBFS, taxa de bloco. E o unico que vai pro
    campo, e por isso o unico que ainda merece atencao.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
2026-08-16 Painel v2, caixa-preta e vocoder ligado no build
    Sincroniza o trabalho que estava na arvore do Mac sem commit. Sao tres
    frentes, e elas vieram JUNTAS porque estao entrelacadas no manifest e
    no main: separa-las exigiria um commit intermediario que nao compila,
    o que e pior que um commit largo.
    --- PAINEL v2 -------------------------------------------------------
    O contrato do HAL ganhou botoes (num_buttons, ReadButton com debounce
    por tempo). O contrato e NIVEL, nao evento: detectar borda e do shell,
    que e onde se sabe o que uma borda significa.
    B1 randomiza uma whitelist de parametros do manifest; B2 segura um
    parametro assinalado e devolve no solta. As mudancas passam por rampa
    (kRampTic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
2026-08-16 Vocoder mudo era coincidencia espectral, nao defeito
    O vocoder rodava, custava 61% do prazo do bloco e nao saia som. Passei
    horas tratando isso como bug de firmware — janela zerada, trava no
    Process, inanicao do loop — e nenhuma das tres hipoteses era o caso.
    O diagnostico veio do dB e explica todos os dados sem sobrar nada:
    molde espectralmente esparso (tom senoidal) x portadora esparsa (drone
    de 3 parciais) = os bins nao coincidem e a saida e ~zero POR
    CONSTRUCAO. O `in=0.0822 out=0.0000` medido no bloco 4 nao era falha,
    era a fisica do patch.
    O mais incomodo: o comentario do fx2_gain JA DIZIA isso — "cross-
    synthesis so devolve energia onde as duas fontes coincidem". A frase
    estav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
    [main.cpp, manifest.h]
2026-08-17 Export novo do vocoder: portadora interna e ganho calibrado no patch
    Duas rodadas de export do dB no mesmo dia, que mudam o contrato:
    1) O patch virou 1-in/2-out (era 2-in/2-out): a portadora agora e
    INTERNA — tres cycle~ + tabela de 16384 + ruido, misturados pelo
    param novo voc_tone. O ch2 externo (jack cru) deixou de existir
    como conceito no patch.
    2) Ganho interno de saida 0.02 -> 0.1. Este e o lugar certo pra
    calibrar nivel: ganho no patch nao amplifica o piso de ruido do
    caminho, ganho no host amplifica. A medicao da caixa-preta depois
    confirmou que com isso o host trabalha em UNIDADE.
2026-08-17 Wrapper do vocoder: dirigir o motor RNBO — a causa raiz do mudo
    O modulo carregava, custava 61% do prazo e nao soava. Tres hipoteses
    morreram antes da verdadeira (janela zerada, trava no Process,
    coincidencia espectral). A frase que resolveu foi do dB: "no Max roda
    perfeito" — patch inocentado, o defeito so podia ser integracao.
    O MinimalEngine exige que o HOST rode processEventsUntil() e
    advanceTime() a cada bloco. O wrapper chamava patcher_.process()
    direto: _currentTime preso em zero desde o boot, nenhum evento
    executava. Sinal puro roda (por isso o delay sempre funcionou); tudo
    que depende de evento fica morto. No Max funciona porque o motor e do
    Max. Assinatura da classe: RODA, CUS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
2026-08-17 Caixa-preta: tres armadilhas silenciosas ate a primeira leitura
    A caixa-preta gravou dois voos inteiros e leu "vazia" duas vezes.
    Nenhuma das falhas dava erro — cada camada fazia exatamente o seu
    trabalho, e o trabalho somado apagava a medicao:
    1) DOMINIO TRAVADO. No H7, acesso a backup SRAM sem
    HAL_PWR_EnableBkUpAccess() e BUS FAULT, nao escrita ignorada. A
    placa morria no primeiro `bb` parecendo defeito de boot.
    2) D-CACHE. A libDaisy liga o cache do M7; escrever em g_bb escrevia
    NO CACHE, a SRAM fisica nunca via o dado, e o reset (que apaga o
    cache) levava o voo junto. Cada escrita agora termina em
    SCB_CleanDCache_by_Addr.
    3) BOOTLOADER. A secao .backup_sram do app lin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
    [hal_daisy_seed.cpp]
2026-08-17 Estado aprovado: delay + vocoder juntos, "tudo perfeito" do dB
    Primeiro estado da cadeia inteira aprovado de ouvido pelo autor do
    patch, com piezo: dly_mix 0.5 -> voc_mix 0.5, voc_pitch 1.0 (base
    440 Hz), voc_tone 0.7, ganho de host 1x, level 0.4. CPU 64% do prazo
    de 5333 us.
    O fx2_gain fecha em UNIDADE com a conta no comentario: a escalada
    8x -> 48x -> 64x foi toda calibrada por ouvido em cima de um sinal que
    o limiter ja esmagava (picos de 2.36 x 64 ~ 151 contra teto de 0.95).
    O "abafado" que restava era portadora tonal GRAVE (pitch 0.5 = 110 Hz
    na formula 2^((p*48-24)/12)*110), nao defeito.
    ATENCAO, e esta marcado no proprio manifest: e estado de BANCADA. A
    dinamica do shell esta neutra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
2026-08-17 Auto-rand por transiente, quantizacao no Set, e a autopsia do voo
    Sincroniza a arvore do Mac. Duas frentes que vieram juntas porque uma
    depende da outra: a serial MORRE com o vocoder ligado, entao a feature
    nova teve que nascer com o registro de voo ja embutido.
    --- AUTO-RAND POR TRANSIENTE (T13) ----------------------------------
    Cada batida no piezo sorteia delay novo e nota nova do vocoder. O
    detector e envelope + comparacao por amostra, com cooldown pra duas
    batidas em menos de 100 ms contarem como uma so.
    O sorteio tem CERCA POR ALVO (RandTarget), e as cercas sao em UNIDADE
    REAL, nao em normalizado. Isso importa: "uniforme entre 100 e 500 ms"
    sorteado em norm com a curva 2.5 do dly_t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
2026-08-17 Rampa por tempo: funcao do relogio, nao contagem de voltas
    A rampa do sorteio avancava um passo por volta do loop: 50 voltas = 50 ms,
    o que so era verdade enquanto o loop girasse a 1 kHz. Isso amarrou a
    DURACAO MUSICAL da rampa a cadencia do loop — e o DelayMs(1) virou relogio
    E metronomo ao mesmo tempo.
    Custou uma leitura invalidada: removi o DelayMs pra testar o relogio e
    mudei a musica junto, sem perceber. E a TERCEIRA FAMILIA de bug de ordem
    deste projeto, irma da corrida-de-contexto e da ordem-de-configuracao, so
    que no desenho experimental: UMA VARIAVEL SERVINDO A DOIS PROPOSITOS, e o
    teste mexendo nos dois de uma vez.
    Agora t = (agora - inicio) / duracao, lerp puro. Ganhos alem do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
    [main.cpp]
2026-08-17 DelayMs fora do loop: o assassino, nomeado por medicao
    O loop principal morria ~12 s apos o vocoder subir. O audio seguia rodando
    por milhoes de blocos — nao era fault, era bloqueio. Nove voos de
    diagnostico ate o nome, e o metodo foi trocar teoria por medicao em cada
    passo:
    voo variavel trocada voltas do loop morte
    completo tudo ligado 1 505 12,6 s
    enxuto sem DelayMs, instr. minima 8 748 683 vivo aos 58,7 s
    discriminante DelayMs religado 1 516 12,7 s
    conserto DelayMs fora 9 711 576 vivo aos 62,9 s
    Mesma instrumentacao nos quatro, UMA variavel trocada. Com o callback do
    vocod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
2026-08-17 BUZIOS: cada batida na escultura sorteia o timbre, em La menor
    Nome do dB, e ele descreve o gesto melhor que qualquer termo tecnico: cada
    transiente e uma jogada de buzios, e o que cai decide o som. Aprovado de
    ouvido em 2026-08-16 — um minuto continuo de taps, 74 transientes, 74
    sorteios aplicados. Razao 1:1.
    Detector no callback, POS-GATE de proposito: o gate ja separou gesto de
    chao de ruido, entao o limiar le batida e nao ambiente. O sorteio mora no
    loop — familia (A) da regra de ordem: quem decide o disparo e quem conta o
    cooldown sao o mesmo contexto, e o loop so consome uma flag pronta.
    dly_time 100-500 ms em DEGRAUS DE 50 ms. O continuo sorteava vizinhos
    (210 e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
2026-08-17 Battle Scars: o que as cicatrizes ensinaram, em documento vivo
    Registro de aprendizados do dB, fechado ao fim da cacada do DelayMs. E par
    do estado: um diz ONDE estamos, o outro diz O QUE APRENDEMOS chegando aqui.
    Dez capitulos, e o mais valioso nao e DSP — e a disciplina forense de
    bancada: as tres familias de bug de ordem (corrida de contexto, ordem de
    configuracao, e a nova — variavel com dois empregos), os sete casos de
    instrumentacao que destruiu o proprio dado, a regra de medir antes de
    concluir com os casos que a provam, o manual do RNBO embarcado, e o
    checklist de retomada a frio.
    Acrescentei o desfecho ao capitulo 7, que estava aberto quando o dB
    escreveu:
    - a ORDEM dos conse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
2026-08-17 STATUS.md: o par do battle scars sobrevive ao clone limpo
    O capitulo 10 do battle scars manda "ler o STATUS antes de tocar em
    codigo", mas o STATUS morava no vault do Obsidian — fora do repo, invisivel
    pra quem clona. Documento que o proprio projeto cita e nao existe no clone
    e a mesma classe do `module_rnbo_alloc.h` que faltou por semanas: funciona
    na maquina de quem escreveu.
    Agora sao par de verdade, os dois em docs/: STATUS diz ONDE ESTAMOS,
    battle scars diz O QUE APRENDEMOS CHEGANDO AQUI.
    O STATUS registra, entre outras coisas, uma violacao DELIBERADA da regra
    da casa: o repo esta versionando estado de BANCADA (dinamica neutralizada
    pro A/B com o Max), nao o instrumento. Duas sessoe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
2026-08-17 Rotina de operacao: docs vivos sincronizam nos dois destinos
    Pedido do dB, e vira regra da casa: toda nova versao de STATUS.md ou
    battle_scars.md vai pro repo E pro vault Obsidian NA MESMA ACAO.
    Os dois destinos servem leitores diferentes e nenhum substitui o outro. O
    repo e o que sobrevive ao clone limpo — foi exatamente por isso que o
    STATUS saiu do vault e entrou em docs/ no commit anterior. O vault e onde
    o dB le, linka e pensa entre sessoes, com tags e backlinks que o Markdown
    cru nao tem.
    Deixar um destino pra depois desalinha o par EM SILENCIO, e o desalinho so
    aparece quando alguem precisa da versao certa — mesma familia dos defeitos
    que este projeto passou o dia catalogando.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
2026-08-17 Reverb, passa-alta do Fx2, e o IFA10000 que nasceu deles
    REVERB (reverb.h, Freeverb no shell). Bloco permanente, nao modulo: o pool
    de SRAM dos modulos esta a 92,4% — a porta RNBO esta fechada por
    aritmetica — e reverb e fim de linha, que e exatamente o lugar de quem
    molha o resultado de todo mundo. Pos-fx2, pre-level, molhando os dois
    ramos; plano B comentado (so OUT_R) se o laco do exciter engordar.
    A fronteira da SDRAM ficou intacta: o header nao conhece o hal, recebe
    `float*` e tamanho, e quem aloca e o main. De quebra roda no banco nativo.
    O tamanho e PERGUNTADO ao reverb (FloatsNeeded), nunca fixado em quem
    chama — fixar seria a armadilha do r_window com 2048 numa FFT de 1024.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
    [hal_daisy_seed.cpp, main.cpp, manifest.h, reverb.h]
2026-08-17 Estado instrumento: a placa sobe tocando, e o ganho vai onde pertence
    O dB foi tocar a escultura real e achou o nivel "muuuuito baixo". A causa
    era residuo meu: o `level` estava em 0.4 desde o A/B com o Max, junto com
    gate e governor desligados. Virou default do repo por TRES commits.
    --- GANHO: in_gain, pos-fonte e PRE-GATE ---
    E a promessa mais antiga deste manifest, cumprida no lugar que ela mesma
    reservou no primeiro dia: "o ganho de compensacao do piezo NAO mora no
    level: mora pos-entrada / pre-gate".
    Por que nao e o mesmo que subir o level: o level empurra a SAIDA contra o
    governor e o limiter — mais volume ali e mais COMPRESSAO, que e justamente
    o artefato que o dB queria evitar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
2026-08-18 MIDI scope: nosso analisador, e o que ele achou na primeira hora
    Ferramenta permanente. `mscope on` mostra cada byte em DUAS COLUNAS — hex
    cru e o que o PARSER CONCLUIU. Duas porque o mesmo byte significa coisas
    opostas conforme o estado: 0x45 e "data1 de um CC" ou "orfao", dependendo
    do que veio antes. Mostrar so o hex seria mostrar a metade que nao
    denuncia dessincronizacao.
    Contadores permanentes no `midi`, espelhados na caixa-preta a cada segundo
    (slots 33-37, porque com o vocoder ligado ninguem digita nada): bytes,
    msgs completas, APLICADAS, ressync, orfaos, fila perdida, e o estado da
    maquina por extenso (aguardando STATUS / data1 / data2).
    A separacao que decide o conserto e `msgs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
2026-08-18 Battle Scars cap. 10: as quatro cicatrizes do dia 17/08
    Duas delas quase nao existiram, e o motivo virou a quinta.
    ESTADO DE DIAGNOSTICO QUE SOBREVIVE AO DIAGNOSTICO. O level ficou em 0.4
    desde o A/B com o Max e virou default do repo por tres commits. Pior que o
    descuido: eu DOCUMENTEI a violacao no STATUS como temporaria e segui.
    Registro que se sabe errado e nao conserta nao e aviso, e permissao.
    Estado de bancada tem prazo, e o prazo e a mesma sessao.
    REGRA QUE SOBREVIVE AO MOTIVO. O bypass do fx2_on cobrava preco real por
    um perigo que a medicao ja tinha eliminado. Quem escreve a regra nao e
    quem aperta o RESET — o custo era invisivel de um lado e obvio do outro.
    `bytes 0` TEM TRES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
2026-08-18 UART do MIDI: erro contado, escuta rearmada, e o loopback que provou tudo
    O MIDI parou de chegar no meio da certificacao e eu passei uma hora
    trocando de suspeito: link BLE caindo, fader desconfigurado, app sem
    autorizacao, DMA abortado, controlador mandando dump. NENHUMA hipotese foi
    confirmada nem descartada com evidencia — o dado era sempre o mesmo
    (`bytes 0`) e a explicacao era nova a cada rodada.
    O LOOPBACK resolveu em dez segundos, e estava disponivel desde o comeco.
    --- T10b: PASSOU, e sai da fila congelada ---
    Jumper D13->D14, `midiloop 22 0/64/127`: as tres mensagens sairam pelo TX,
    voltaram pelo RX e percorreram o caminho real — UART, DMA, ISR, fila,
    parser, mapa, parametro.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
    [hal.h, hal_daisy_seed.cpp, main.cpp]
2026-08-18 MIDI certificado: 914 msgs, fx2_on no CC33, e a causa que era procedimento
    --- T16b PASSOU: 914 mensagens, zero anomalias ---
    Fonte deterministica (MIDI Wrench), 14 CCs mapeados, faixa 0-127 em todos:
    cc22 level 381 msgs | cc25 fx2_gain 72 | cc20 dly_time 62 | ...
    orfaos 0 | truncadas 0 | ressync 0 | perdidos 0 | erros de UART 0
    E o `cc 33` apareceu no scope como "(fora do mapa)" — foi assim que a
    lacuna do fx2_on apareceu SOZINHA. Mapeado agora: o vocoder liga por MIDI,
    e o instrumento nao depende mais de serial nem de boot pra tocar.
    --- A CAUSA REAL, achada pelo dB ---
    O PAREAMENTO BLE NAO SOBREVIVE AO RESET DA PLACA. Todo `bytes 0` da tarde
    veio depois de um reset sem reparear;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
    [hal_daisy_seed.cpp, main.cpp, manifest.h]
2026-08-18 MIDI certificado sob carga, e a regra que nasceu do meu proprio silencio
    O T16c estava "nao executado" ha um dia porque quatro janelas anteriores
    reportaram 0 CCs. O log estava mudo: `bb arm` chamava LogMute(true) e nao
    existia caminho de volta — a flag so zerava no boot. Cada medicao seguinte
    mediu o meu silencio, e sobre esses quatro zeros eu commitei no battle_scars
    uma causa errada ("o pareamento BLE nao sobrevive ao reset").
    Medido agora, com o canal provado antes:
    T16c 2779 CCs em 90 s, vocoder a 65,1% do prazo do bloco
    0 orfaos, 0 ressync, 0 perdidos, 0 erros de UART
    marca d'agua da fila: 32 de 128 bytes, IDENTICA com e sem carga
    A marca d'agua e o que fecha o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
    [hal.h, hal_daisy_seed.cpp, main.cpp]
2026-08-19 Vocoder aposentado com honra, freeze de audio no lugar, e o grave que voltou
    MUDANCA ARTISTICA (decisao de ouvido do dB). O vocoder sai do build; entra um
    freeze granular em C++ no shell, na mesma posicao da cadeia (pos-delay,
    pre-reverb) pra que o congelado ganhe a sala junto com o resto. O slot RNBO
    fica vazio e documentado; export, wrapper, binds e a cerca de La menor dos
    buzios seguem no repo, comentados e conferidos — a volta e de minutos.
    Com o vocoder fora, o block_size volta pra 48: o 256 nunca foi escolha, era
    exigencia da FFT, e saiu junto com ela. Latencia de 5,3 ms pra 1 ms.
    O GRAVE QUE VOLTOU, e por que isso e um acerto de arquitetura. O dB ouviu o
    instrumento e disse: "pres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
    [freeze.h, hal_daisy_seed.cpp, main.cpp, manifest.h]
2026-08-19 CTOS: a base a prova de falha, e o watchdog que condenou o inocente
    DECISAO DE ARQUITETURA DO dB. `docs/CTOS.md` (v0.1.0, PROPOSTA) formaliza o
    Cotucatronics Operational System: uma base que efeito nenhum pode derrubar. O
    gatilho foi o loop principal morrer; num sistema compartimentado isso seria
    estruturalmente impossivel.
    O documento NAO apoia a fronteira em "o freeze e culpado" — isso continua sem
    confirmacao (tres mortes com freeze, uma vida sem ele, e o cabo se movendo no
    meio). Apoia em algo ja medido: passamos horas sem conseguir dizer QUAL
    METADE do sistema estava quebrada, porque nao existe fronteira que separe as
    metades. Um sistema onde "foi a base ou foi o efeito?" nao tem res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
2026-08-19 Freeze certificado, e os dois CCs que emudeciam o instrumento saem do mapa
    FREEZE GRANULAR CERTIFICADO — IFA10000 completo, etapa 9 inclusive. Aceite do
    dB: "ficou otimo assim". Sustentado de 10 s sem pulsacao, cauda de 2 s, e o
    instrumento vivo audivel por baixo do congelado. Etapa 5: 98 us do EFEITO em
    500 de orcamento, 370 de 1000 no sistema inteiro.
    Tres versoes ate chegar aqui, e cada uma consertou um erro de desenho meu:
    v0.1.0 reprovou de ouvido — "um loop de mais ou menos 2 s", "nao soa como
    freeze, soa como um delay lento e permanente". A causa estava
    escrita como DEFESA no proprio cabecalho: eu afirmei que o jitter
    de posicao mataria a periodi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
    [freeze.h, main.cpp, manifest.h, test_midi.cpp]
2026-08-19 Relogio do watchdog consertado na causa, e o filtro que descartava a catastrofe
    O CTOS media o tempo do efeito com `System::GetUs()` e recebia outliers
    absurdos — 4 277 071 629 us. Consertei antes com um FILTRO DE SANIDADE:
    amostra acima de 10x o orcamento e descartada e contada, nunca julgada. Isso
    impediu vetos falsos e criou um defeito novo, que o dB apontou:
    Um estouro catastrofico apareceria EXATAMENTE assim.
    O filtro definia "implausivel" por MAGNITUDE, e magnitude sozinha nao
    distingue outlier-por-erro de outlier-por-evento. Um bloco que realmente
    levasse 5 ms — o pior caso que o veto existe pra pegar — seria descartado
    como ruido de relogio. E ajustar o limiar nao conserta: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
2026-08-19 Mapa v2, defaults em zero, e a defesa que sobreviveu a ameaca
    O CONTROLADOR VIROU A FONTE DA VERDADE, por decisao do dB. O Loopy so
    TRANSMITE (nao recebe sem MIDI learn), entao os defaults do manifest duravam
    ate o primeiro CC e depois pulavam pro que o fader dissesse. Isso foi lido
    como defeito varias vezes hoje — `level` em 0.49 logo apos o boot, freeze
    ligado sozinho, "o grave sumiu". Nao era defeito: era o manifest e o
    controlador disputando o mesmo parametro.
    Agora os params MAPEADOS nascem em ZERO e o dB constroi subindo os faders.
    Nada pula, porque nao ha divergencia pra corrigir.
    ZERA O QUE O CONTROLADOR ALCANCA, PRESERVA O QUE ELE NAO ALCANCA.
    Os nao-mapeados ficam nos valore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
    [hal.h, hal_daisy_seed.cpp, main.cpp, manifest.h, test_midi.cpp]
2026-08-19 Motor de pitch compartilhado validado, e a regua que media o proprio pente
    PECA 1 DA SUITE DE EFEITOS (docs/CTOS.md §5b). Motor de pitch com UM BUFFER
    e ATE 4 VOZES — e onde o "compartilhado" deixa de ser palavra e vira
    economia: shimmer no modo "ambos" precisa de +12 E +7 lendo o MESMO historico,
    e detune precisa de duas vozes micro-desafinadas do mesmo sinal. Um buffer por
    efeito seria pagar tres vezes pelo mesmo trabalho.
    EXTENSAO DO FREEZE, NAO REUSO — e a correcao de premissa importa pro
    planejamento. O freeze.h tem a maquinaria granular e esta certificado, mas le
    a taxa 1.0 e NUNCA deslocou altura. O que veio de la: raiz-de-Hann (potencia
    constante para conteudo descorrelacionado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
2026-08-20 Shimmer no ar, dois tetos que estouravam calados, e a caixa unica
    SHIMMER — primeiro efeito da suite, e o dB aprovou de ouvido: "o som esta
    lindo". Reverb + pitch-up num laco de realimentacao, sem reverb proprio:
    realimenta o Freeverb que ja existe na cadeia. Zero memoria nova, mais fiel ao
    Eno/Lanois onde o shimmer E a sala se empilhando.
    cauda -> pitch(+12/+7) -> passa-alta 200 Hz -> x feedback -> entrada do reverb
    O passa-alta e inegociavel: cada volta empilha uma oitava E reinjeta o que veio
    antes, entao o grave se acumula porque nada o remove. Uma ordem por volta, tres
    voltas, ja sao 18 dB no fundamental.
    PECA 1 e 2 DA SUITE, validadas antes do shimmer:
    MOTOR DE PITCH (pitch.h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
2026-08-20 Drive na cadeia, e o RESET que deixou de existir
    DRIVE — segundo efeito da suite, e fecha a classe "zero memoria, sem motor de
    pitch": valida o EffectSlot em efeito simples antes dos que reusam granular.
    y = tanh(drive * x) / tanh(drive)
    A DIVISAO E O QUE FAZ O CONTROLE VALER. Sem ela, subir o drive sobe o volume
    junto — e o ouvido chama qualquer coisa mais alta de "melhor", entao o
    controle mediria NIVEL disfarcado de TIMBRE. Normalizado, a saida fica em ~1.0
    de pico pra qualquer drive e o que muda e so a forma da onda.
    Ordem interna, cada passo com razao:
    entrada x drive -> tanh -> normaliza -> LPF (tone) -> mix paralelo
    LPF DEPOIS da saturacao: saturar gera agudo aspero; cor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
    [drive.h, hal.h, hal_daisy_seed.cpp, main.cpp, manifest.h]
2026-08-20 Drive certificado, cauda no shimmer, e a regra que escrevi tres vezes e violei quatro
    DRIVE CERTIFICADO — aprovado de ouvido pelo dB, com os tres params provando
    que MOVEM o som (a regra do shm_mix que nao controlava). Custo medido LIMPO,
    por `cpu` ligado vs desligado, sem cronometro dentro da regiao:
    v0.1.0 +36 us std::tanh x2 por amostra
    v0.2.0 Pade + caminho mono +24 us
    + EffectSlot com cache +21 us (2,1% do bloco)
    A APOSTA DE <1% PERDEU, e o motivo e instrutivo: "funcao por amostra" nao
    implica barato quando a funcao e TRANSCENDENTAL. `std::tanh` e chamada de
    biblioteca de ~100 ciclos, e eram DUAS por amostra sobre o mesmo valor mono —
    met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
2026-08-20 Suite completa: phaser, warble e detune, e o desperdicio que preserva a correcao
    CINCO EFEITOS NA CADEIA. Ordem de pedaleira fechada:
    drive -> phaser -> warble -> [delay] -> detune -> freeze -> shimmer -> reverb
    sujeira -> fase -> altura -> tempo -> largura -> gesto -> espaco
    PHASER (aprovado). N allpass de 1a ordem varridos por LFO triangular, com
    feedback. Zero buffer, LFO por bloco. `phs_mix` e INVERTIDO em relacao aos
    outros: o notch nasce de CANCELAMENTO entre seco e desviado, e cancelamento
    maximo exige amplitudes iguais — entao ~0.5 e o "ligado" e 1.0 e quase
    inaudivel. Montanha, nao rampa. Documentado no phaser.h e no manifest.
    E ELE NASCEU MUDO POR DOIS SINAIS TROCADOS (c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
2026-08-20 Alias morto no motor, sino de presenca no shimmer, e a metade da queixa
    O dB disse "agudas E medio-agudas ardidas". Eu consertei uma metade e
    publiquei vitoria; ele voltou com "ainda ardido". Eram duas causas.
    1. ALIASING, e nao brilho. Ler o buffer a ratio 2.0 comprime o tempo:
    acima de 12 kHz o conteudo atravessa Nyquist e volta INARMONICO. Um
    seno de 20 kHz reaparecia em 8 kHz a -11.9 dB, e o laco fabricava o
    defeito sozinho — com 3500 Hz na entrada, o pico MAIS ALTO de toda a
    cauda era 19963 Hz. O anti-alias foi para dentro do PitchEngine, nao
    do shimmer: o defeito e de ler rapido, e quem le rapido e o motor;
    posto la, todo efeito futuro que suba oitava herda calado,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
2026-08-20 Balanco no lugar do crossfade, largura antes do split, e o canal que eu media sem medidor
    Dois controles de I/O pedidos pelo dB, mais o medidor que faltava pra
    saber se eles funcionam.
    PIEZO_MIX (CC 58) — BALANCO, nao crossfade. Centro = os dois piezos
    cheios; girar abaixa o dominante sem cortar o outro. O `src_mix` que
    ocupava este lugar era crossfade linear: no centro derrubava OS DOIS em
    -6 dB, e por isso nunca resolveu "um encobre o outro". Aposentado por
    inteiro, com o knob k2 junto — manter os dois seria dois controles
    disputando os mesmos ganhos, a familia C do proprio catalogo. Faixa
    simetrica [-1,+1] pra que o default zero caia no centro sozinho, sem
    excecao a regra. Ganho de s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
    [main.cpp, manifest.h, suave.h]
2026-08-20 Histograma de entrada, e a medicao que recusa dar o numero que nao tem
    Passo 1 do plano de 8 do dB para a entrada saturando.
    `hist` / `hist reset`: tres colunas — IN_L cru, IN_R cru e pos-in_gain
    ja somado em mono — em baldes de 6 dB, com pico exato, contador de clip
    com latch e a linha que dimensiona o atenuador.
    BALDE PELO EXPOENTE DO FLOAT. |x| em [2^e, 2^(e+1)) e exatamente uma
    faixa de 6.02 dB, e o expoente sai de um shift e uma mascara. Um log10f
    por amostra por canal custaria mais que varios efeitos da suite
    somados; assim o histograma inteiro custou +27 us.
    CRU **E** POS-GANHO. So a entrada crua responderia "o transdutor
    entrega?" e deixaria "o firmware estoura?" em aberto. Sa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
    [main.cpp]
2026-08-20 Teto de soma do CTOS: sem culpado, com prioridade declarada
    A ultima fronteira estrutural. O watchdog do §3 protege contra UM
    efeito com defeito; faltava a protecao contra N efeitos SAUDAVEIS que
    juntos nao cabem no prazo. Situacoes de natureza diferente, mecanismos
    diferentes — a distincao inteira em CTOS.md §3b.
    NAO HA CULPADO no teto de soma, e por isso ele nao procura um. Qualquer
    regra que tente achar "quem foi" quando nao ha quem acaba inventando um
    culpado, e o inventado seria um efeito perfeitamente correto. A saida
    nao e uma deteccao melhor: e abandonar a pergunta. A politica e
    PRIORIDADE DECLARADA a frio pelo dB em Manifest::sacrif[] — a ordem do
    array E a prioridade, sem nu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
2026-08-20 Chave propria pro delay e pro reverb, e o cartao de CC numa folha
    O dB pediu on/off pros dois que ainda ligavam pelo `mix` — sao
    anteriores a convencao de chave da suite. Fundir chave e mix obriga a
    zerar o ajuste pra desligar, e o ajuste se perde.
    Cada uma das duas trouxe um problema diferente, e nenhum era o pedido.
    REV_ON EMUDECE O SHIMMER, e isso e desenho, nao defeito: o shimmer nao
    tem reverb proprio, ele realimenta o da cadeia. Uma chave que pula o
    bloco inteiro (o que se quer, pra custar zero) apaga o shimmer junto, e
    o sintoma seria "o shimmer parou de funcionar" com shm_on em 127 e nada
    errado a vista. Desligar recurso compartilhado emudece quem depende
    dele EM SILENCIO. Entao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
    [main.cpp, manifest.h]
2026-08-21 LG e LR fora do hardware: o pad que nao marcava nada, e o que sobrou
    Os LEDs LG (D29) e LR (D30) foram lidos por dois dias e nao marcaram
    estado util. Removidos do hardware pelo dB; o codigo os acompanha.
    ISTO E RESULTADO, NAO DESISTENCIA. LG e LR ficam descartados como
    candidatos POR NAO MARCAREM, o que fecha duas das tres hipoteses sobre
    qual pad carrega o estado de conexao. A pergunta segue aberta, com dois
    candidatos a menos.
    E o BOARDS.md tinha uma promessa vencida: a secao do LED dizia "se a
    bancada discordar, quem manda e a bancada, e esta tabela muda". A
    bancada JA tinha discordado — o dB desconectou e o LB ficou fixo — e a
    tabela nunca mudou. Agora ela abre declarando isso, e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
    [hal.h, hal_daisy_seed.cpp]
2026-08-21 Duas cadeias de caracter, cauda compartilhada, e o delta que nao se atribui
    PIVO DE ARQUITETURA do dB. Os instrumentos hibridos (tambor + corda +
    molas no mesmo corpo) pedem tratamento diferente por material:
    p1 -> in_gain_A -> gate_A -> [DRIVE PHASER WARBLE] -\
    MIX -> cauda
    p2 -> in_gain_B -> gate_B -> [DRIVE PHASER WARBLE] -/
    A CAUDA NAO DUPLICA, e e o ponto do desenho: e ela que faz tambor e
    corda soarem como o MESMO OBJETO. Duplicar shimmer e reverb separaria o
    que o desenho existe pra unir — e sao justamente os mais caros.
    POR QUE GATE E GANHO DUPLICAM, e a razao NAO e desequilibrio entre
    transdutores. Cada piezo capta um M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
2026-08-21 README: versoes do pivo de duas cadeias
    Ficou de fora do commit anterior porque a ancora de versao do meu
    script nao bateu — o assert barrou a edicao e eu nao conferi o
    git status antes de commitar. Saida de ferramenta nao e confirmacao
    de intencao, pela enesima vez.
2026-08-22 Caracter recolhido, out_width aposentado, e o nome que nao virou param
    Bloco de decisoes do dB, fechado antes de abrir a protecao do ramo B.
    CARATER VOLTA A SER UNICO. Seis efeitos com params independentes ficou
    confuso de operar: volta a existir UM drive, UM phaser, UM warble, com
    params compartilhados. Duplicam so `_on` e `_mix`, que e o que se opera
    ao vivo.
    NAO HOUVE ECONOMIA DE CPU, E ISSO ERA A PREVISAO — verificada na
    estrutura antes de medir e confirmada depois. Cada efeito segue
    processando os DOIS sinais com estados internos separados (dois
    conjuntos de allpass, dois buffers de warble), senao os canais se
    contaminam. O que encolheu foi a superficie de controle e a tabela:
    71 ->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
2026-08-22 Delecao por faixa calculada, e a instrumentacao orfa
    Duas vezes na mesma sessao apaguei codigo que nao pretendia apagar. As
    duas operacoes tem a mesma forma: deletar uma faixa cujos limites eu
    CALCULEI em vez de listar. O que separa as duas e so o que as pegou.
    A: substituir s[i0:i1] no main.cpp levou junto o ESCRITOR do histograma
    pos-ganho. Compilou limpo — as variaveis seguiram declaradas e o `hist`
    seguiu LENDO elas. Teria reportado "pos-ganho 0" pra sempre,
    indistinguivel de "nao chega sinal". Achado por acaso tres turnos
    depois.
    B: regex com `.*?` e lookahead mirou 7 linhas e apagou 50. Colateral de
    43: a documentacao inteira do in_gain e a declaracao de kCadeias. Pego
    em dez segun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
2026-08-22 RNBO fora, inteiro: o delay em C++ e o que a remocao rendeu
    O delay era o ULTIMO consumidor do runtime RNBO. Reescrito em C++
    (delay.h), o RNBO saiu por completo — runtime, sistema de slots,
    modulos e exports.
    O GRAFO DO PATCH FOI LIDO DO EXPORT, NAO INVENTADO: feedback fixo em
    0.4 (era `dspexpr_01_in2 = 0.4`, que o patch nao expunha como
    parametro), saida em CROSSFADE e nao camada, mono nos dois canais. O
    delay foi certificado de ouvido no T5 COM esse feedback; mudar seria
    trocar o caracter aprovado por baixo do pano.
    Duas diferencas deliberadas e declaradas no cabecalho: a realimentacao
    fecha por AMOSTRA (o `feedback~` do RNBO atrasava um vetor) e o tempo e
    INTERPOLADO, entao varrer da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
    [delay.h, dynamics.h, main.cpp, manifest.h, midi.h]
2026-08-22 Cauda paralela e dois espacos: corda com shimmer, couro com sala limpa
    O dB pediu p1 com delay e p2 com reverb, e depois corda com shimmer e
    couro com sala limpa. A cauda serial nao conseguia nenhum dos dois, e eu
    tinha respondido que o primeiro era "fisicamente impossivel".
    ERA IMPOSSIVEL NUMA CAUDA SERIAL — e serial era ESCOLHA MINHA, tomada
    quando havia um efeito de cada tipo e nenhuma razao pra outra coisa.
    Sustentei "impossivel" com uma cadeia correta de deducoes sobre uma
    premissa que eu nao examinei. Cicatriz 12g: antes de dizer que nao da,
    separar o que e LEI do que e decisao minha.
    A CAUDA VIROU DESTINOS IRMAOS, cada um com envio por cadeia:
    A --+-> x dly_a --+
    B --+-> x dl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
2026-08-22 Um envio por destino: o controle que era o mesmo escrito duas vezes
    O dB perguntou "qual a funcao de esp_mix? ja nao temos rev_mix?" — e
    tinha razao. Eu precisei ler o codigo pra descobrir que sim:
    entrada da sala = cadeia x esp_mix <- ganho na ENTRADA
    sala 100% molhada
    retorno = saida x rev_mix <- ganho na SAIDA
    Numa sala LINEAR, entrada 0.5 com saida 1.0 soa identico a entrada 1.0
    com saida 0.5. Era o mesmo controle escrito duas vezes.
    NINGUEM ADICIONOU UM CONTROLE REDUNDANTE. Cada peca era correta quando
    entrou: `rev_mix` era o dry/wet do reverb desde sempre, e `esp_mix`
    nasceu como CROSSFADE entre "vai pro espaco" e "sai seco", num desenho
    em que a cauda era SER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
2026-08-22 Buzios de volta dos mortos, e a auditoria que os achou
    O dB pediu auditoria dos params um por um. A primeira camada — quem LE
    cada param — acusou `buzios_thresh` e `buzios_cooldown`: declarados, na
    tabela, MAPEADOS EM CC, e sem nenhum leitor.
    Nao eram params orfaos. Era o DETECTOR INTEIRO DOS BUZIOS que nao
    existia mais, apagado em 6a8175d — ele vivia pos-gate, dentro da faixa
    que substitui na reestruturacao em duas cadeias. Cicatriz 12e cobrando
    pela terceira vez, e desta vez levou uma FEATURE, nao instrumentacao.
    PASSOU CINCO COMMITS E NADA DENUNCIOU:
    - compilou limpo: as variaveis seguiram declaradas, e o loop seguiu
    LENDO `buzios_fire`. So ninguem mais o escrevia.
    - os pa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
2026-08-22 Entrada fechada: com os piezos montados, nao satura
    Medido com os piezos MONTADOS NA ESCULTURA, que e o regime de uso:
    p1 (IN_L): pico -9,2 dBFS | 18,0% das amostras | clip 0
    p2 (IN_R): pico -19,5 dBFS | 1,3% das amostras | clip 0
    pos-ganho (in_gain 2,8x): -0,3 dBFS | clip 0
    Nenhum clip em lugar nenhum. O DIVISOR SAI DA FILA e o plano de oito
    passos encolhe pra dois: a protecao (1k + 2x 1N4148), que serve de
    qualquer jeito porque piezo entrega dezenas de volts num transiente
    forte, e recalibrar o in_gain.
    A CICATRIZ 12a ACERTOU O DESFECHO. A medicao de 20/08 que dizia "a
    entrada satura" foi feita com DEDO DIRETO NO DISCO SOLTO — o caso mais
    violento que a pastilha en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
2026-08-22 A placa fala de volta, e a trava aprende a falar
    ESPELHO MIDI NO CANAL 2. O instrumento passa a transmitir seu proprio
    estado pro Loopy, resolvendo na direcao certa um problema que vinha
    sendo contornado na errada: toda gravacao zera os 76 params, o teto do
    CTOS derruba efeito sozinho, e mudanca por serial na bancada — e a tela
    do dB continuava mostrando o valor velho. No boot a placa fala primeiro.
    O LACO ERA O PROBLEMA CENTRAL, e a defesa que eu declarei nao existia.
    Escrevi "canal separado" no cabecalho e deixei o receptor em omni — que
    inclui o canal em que a propria placa fala. Ela estava obedecendo a
    propria voz, e so apareceu lendo o historico de CCs a mao, porque nao
    havia conta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
    [drive.h, hal_daisy_seed.cpp, main.cpp, manifest.h]
2026-08-22 Inverter a pergunta: a placa escuta, e 65 de 65 fecham
    O modo `learn` levou cinco versoes de firmware e nunca fechou o
    enderecamento dos widgets do Loopy. A cada versao eu fechava uma janela
    onde o CC errado podia ser gravado, e aparecia outra: a lacuna entre
    minhas varreduras, o auto-confirm correndo por widgets ja armados, o
    `next` que limpava o estacionamento, o pulso sustentado lido como hold,
    o `learn stop` despejando 76 CCs a cada pausa.
    O dB inverteu: "configurei todos pra mandar no canal 1 — fala com eles e
    ve se batem; se nao baterem, ajusta do seu lado". Em vez de fazer os
    widgets aprenderem os numeros da placa, LER o que eles mandam e adaptar
    o firmware. Duas varreduras e 128 b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
2026-08-22 Aposentar o learn: ele exigia a placa surda
    REMOVIDO em v0.121.0 — 136 linhas, ~10 KB de fonte, 83 referencias,
    zero sobrando. LearnFim, LearnPasso, LearnConfirma, o comando, a
    chamada do loop, os guardas em OnMidiCc e MidiEspelha, kJaSabiaMs, o
    contador cc_learn.
    A RAZAO NAO E "nao funcionou bem". E que os dois mecanismos eram
    MUTUAMENTE EXCLUSIVOS e eu demorei a ver: em `learn` a placa fala e
    NAO ESCUTA — descarta todo CC que chega, por desenho, senao os widgets
    ja armados atropelam a caminhada. Mas o inventario `vistos` le
    exatamente o que chega. Ligar o learn cega o unico instrumento capaz
    de provar que o learn funcionou.
    Metodo que exige desligar o sensor que o verificaria e des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
2026-08-22 Teto e orcamento, prazo e parede — e a defesa que quase mirou errado
    O DEFEITO ERA DO MEU LEITOR, NAO DO FIRMWARE. Um regex procurava
    `pico N%` numa linha que diz `N% pico`, com fallback `if else 0`. A
    sessao inteira eu li 0 como "pico morto" e reportei so medias: "509,
    cabe", "697, folga ate 850". A folga nao existia. Cheguei a registrar
    um defeito de firmware inexistente e priorizar como passo 0 de um
    plano. Parser que nao casa deve GRITAR, nunca inventar zero — a regra
    do canal mudo vale pro codigo que eu escrevo pra medir (bts 12u).
    OS QUATRO REGIMES, com o leitor consertado:
    media pico
    todo efeito desligado 183 262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
2026-08-22 Roteiro do BOOT_SRAM, e o .map derruba a estimativa de folga
    ESCRITO ANTES DE GRAVAR, de proposito: sem roteiro, revalidacao vira
    "liguei e funcionou". Oito itens com criterio, mais o re-exame do teto
    no fim e a parede nova no boot-report.
    O ACHADO QUE MUDA O RISCO DO PASSO. A estimativa "480 KB de regiao,
    binario de 180, folga de 300" era minha e estava errada: comparei o
    binario contra a regiao como se ela estivesse VAZIA. O .map diz outra
    coisa — a SRAM ja carrega .data + .bss.
    .isr_vector + .text QSPI 182 KB
    .data SRAM 4,7 KB
    .bss SRAM 276 KB <- dominado por reverb_mem 220 KB
    BOOT_SRAM: a regiao encolhe pra 480 e o .text passa a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
2026-08-22 Uma defesa que se auto-cura sem orcamento vira a doenca
    INVESTIGACAO DO TRAVAMENTO DO BOOT_SRAM. Resultado misto, e o registro
    vale mais que o codigo: NENHUM firmware desta rodada esta commitado em
    main, porque nenhum foi verificado inteiro. A placa roda a v0.123.2 do
    commit 163ee1d, que e o chao que o repo garante.
    DOIS DEFEITOS REAIS, ambos da familia que o Log() ja tinha aprendido:
    trabalho ilimitado em contexto compartilhado.
    PollMidi drenava o anel com `while(m_tail != m_head)` — sem teto, com
    a ISR enchendo em paralelo. Nunca disparou na bancada (zero bytes
    chegaram no teste), mas e a mesma forma.
    E o rearme da escuta MIDI rearmava A CADA VOLTA do loop enquanto
    `IsListen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
2026-08-23 Guarda de faixa em float pela negacao, e tres causas empilhadas
    DELAY: o `while` do ponteiro de leitura escondia DOIS defeitos, e o
    segundo era o pior.
    atraso_ = +Inf -> r = -Inf -> -Inf + cap_ = -Inf, laco ETERNO
    atraso_ = NaN -> `NaN < 0` falso, sai na hora, e `(size_t)NaN` e
    INDEFINIDO: indexa fora do buffer em silencio
    Fui consertar o laco e encontrei a corrupcao silenciosa dormindo na
    mesma linha — ler o contexto antes de tocar rendendo dividendo
    imediato. Conserto parcial que parece completo e pior que nenhum:
    fecha o sintoma que denunciava o resto.
    if(!(r >= 0.f && r < (float)cap_)) r = 0.f;
    NaN falha TODA comparacao, entao a forma DIRETA ("est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
2026-08-23 A janela ITCM abre, dialoga e fecha viva
    O MECANISMO PERIGOSO ESTA PROVADO, com o comando mais inofensivo que
    existe. A placa saiu do memory-mapped executando de ITCM, dialogou com
    o periferico, voltou, e segue viva — `cpu` responde depois.
    DEGRAU 1 `qspi vida` -> 5050 (esperado 5050)
    executa da ITCM, faz conta e retorna: copia ok, I-cache ok
    DEGRAU 2 `qspi id` -> a janela abriu e fechou sem travar
    O ID veio FF FF FF (barramento em repouso — o chip nao respondeu), mas
    isso e DIALOGO, nao mecanismo: ajustavel sem risco, porque a janela ja
    demonstrou que abre e fecha sem matar ninguem. Suspeito principal: a
    libDaisy deixa o chip em QPI no Init, e chip em QPI ignora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
2026-08-23 Sonda de protocolo QSPI: opcode, modo e dummies por argumento
    A JANELA ESTA PROVADA E NAO MUDA MAIS. O que segue e protocolo.
    O SR resolveu a primeira ambiguidade: `SR=0x02` (TCF, transferencia
    COMPLETA) com FLEVEL=0 e zero esperas estouradas prova que o
    periferico executa o comando inteiro e termina limpo. Quem nao
    responde direito e o CHIP — causas opostas que "FF FF FF" nao
    distinguia.
    SONDA EM VEZ DE GRAVACAO POR TENTATIVA. Opcode, modo de linhas e
    ciclos dummy viraram argumento (`qspi id [dummy] [modo] [opcode]`).
    Gravar uma vez por valor custaria minutos e um ciclo de DFU cada, e o
    numero certo se acha varrendo, nao deduzindo.
    O QUE A VARREDURA MOSTROU, e os dois padroes sao legiv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
    [main.cpp, qspi_raw.cpp, qspi_raw.h]
2026-08-23 Freeze fisico aprovado de ouvido, e o botao vira tabela
    BOTAO DE ARCADE + LED, aprovado pelo dB: bater durante cauda
    sustentada congela, bater de novo solta.
    switch D24 · LED D27 · toggle, nao hold
    B2 era momentaneo (segurar forcava 1, soltar devolvia). Virou
    alternancia: segurar um arcade durante uma cauda de freeze e
    desconfortavel, e o `frz_on` deste instrumento JA E o gesto de
    congelar, nao chave de bypass.
    O LED SEGUE O PARAM, NUNCA O GESTO. Atualizado no laco a partir do
    valor real, nao dentro do AlternaBotao: se o freeze mudar por CC,
    serial, preset ou queda do CTOS, o LED acompanha. Indicador que segue
    o gesto mentiria em todos esses casos, e "mentir so as vezes" e o pi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
2026-08-23 Doze deriva doc-codigo, limpos antes do verificador
    AUDIT DE DERIVA. Causa raiz comum: o commit 3834cea (cauda paralela,
    dois espacos, freeze por cadeia) foi reestruturacao grande, e o codigo
    migrou mais completamente que a documentacao e que os simbolos. O
    compilador cobrou os que QUEBRARAM; ninguem cobrou os que sobreviveram
    sem uso, nem a doc que continuou descrevendo o desenho morto.
    FANTASMAS NA DOC — nome citado, param inexistente:
    `frz_hold` descrevia "fonte e gesto separados" por MESES. O
    manifest.h:264 ja registrava a decisao contraria. Reescrito pro
    real: `frz_on_{a,b}` SAO o gesto, duas instancias independentes
    com buffer proprio.
    `frz_mix_{a,b}` hoje e `frz_v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
2026-08-23 make check-docs: o compilador cobra simbolo, isto cobra a doc
    REGRA QUE O AUDIT DESTILOU: toda reestruturacao tem TRES frentes —
    codigo, documentacao e simbolos. O compilador cobra a primeira; nada
    cobrava as outras duas. Agora o `make check-docs` cobra.
    Ferramenta e nao disciplina porque A DISCIPLINA JA FALHOU AQUI: doze
    casos de deriva de uma unica reestruturacao, e a checagem manual
    recem-escrita nao teria pego o segundo. Habito automatizado vence
    habito lembrado.
    PRINCIPIO: o manifest e a unica fonte de verdade; tudo que fala sobre
    ele e verificado contra ele. Fantasma silencioso QUEBRA O BUILD;
    fantasma DECLARADO deixa de ser fantasma.
    A ARMADILHA QUE ELE PISOU NA PRIMEIRA EXECUCAO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
    [params-aposentados.txt]
2026-08-23 A libDaisy nunca entra em quad, e a fila tambem deriva
    O ACHADO MAIS VALIOSO DA RODADA E CONHECIMENTO, NAO CODIGO — e por isso
    vai pro DESENHO-ESCRITA-QSPI.md antes da proxima tentativa, que pode
    travar a placa. Perder a hipotese morta junto com a tentativa seria
    pagar duas vezes.
    // we haven't added the ability to switch to quad mode. So they're
    // currently unused.
    QSPIHandle::Result EnterQuadMode() __attribute__((unused));
    A libDaisy NUNCA entra em quad. O chip esta em SPI simples, e isso
    REFUTA a hipotese que explicava o FF FF FF — hipotese plausivel, que
    batia com o sintoma byte a byte, e errada.
    O protocolo real, da configuracao memory-mapped, e HIBRIDO:
    InstructionMode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
    [params-aposentados.txt]
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2026-08-23 Ausencia mora fora do dominio, e a frente QSPI para no lugar certo
    O relatorio da sonda chamava `0x00` de "nao respondeu" — e `0x00` e
    exatamente o que um chip ocioso devolve ao RDSR. Resposta correta lida
    como ausencia de resposta, pela quinta vez no dia: e o mesmo raciocinio
    do `else 0` do parser de bancada (12u), do `voltaram 0`, do `eco_proprio`
    e do mscope mudo.
    Cinco casos num dia nao sao descuido em serie, sao forma estrutural. A
    regra entra na skill `instrumentacao`: nenhum valor do dominio pode
    significar "sem dado" — ausencia se representa FORA do dominio (flag,
    sentinela impossivel, ou par valor+validade). E o corolario que resolveu
    este caso: imprima o CRU e etiquete a inter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
    [check_docs.py, main.cpp, qspi_raw.cpp]
2026-08-23 Passo 1 dos presets: caracter por cadeia, e o banco volta a vigiar
    DUPLICACAO. Os dez params de caracter (drv_drive/tone/sujeira,
    phs_rate/depth/fb/stages, wrb_rate/depth/irreg) passam a ser [kCadeias].
    Sao dez, nao onze: o 11o de caracter e o dly_time, que fica
    compartilhado de proposito — o delay e instancia unica e duplica-lo
    custaria memoria e CPU de verdade. 76 -> 86 params, folga de 10 no teto.
    CUSTO ZERO, MEDIDO COMO DEVE SER. A comparacao entre binarios teria
    mentido: mesmo regime, mesmo trabalho, tres builds deram 460,4 -> 437,0
    -> 347,0 us. A v0.132.0 ACRESCENTOU um `? :` por bloco e ficou 90 us
    mais rapida. Sao 25% de variacao sem que o trabalho mudasse, porque o
    codigo roda da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
    [params-aposentados.txt]
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2026-08-23 Desenho dos presets em RAM, com tres contagens corrigidas
    Escrito enquanto o aceite de hardware corre, de proposito: e trabalho de
    cabeca, nao toca o firmware e nao captura estado, entao nao corre o risco
    de congelar um enderecamento nao-validado.
    TRES CORRECOES DE CONTAGEM, todas apuradas em vez de estimadas:
    Sao 37 familias por cadeia, nao 33 — a estimativa era 23 originais + 10
    copias, o real e 27 + 10.
    A DTCM nao esta apertada: esta VAZIA. 0 B de 128 KB. O `.bss` cai na
    SRAM (54% de 512 KB, quase tudo reverb_mem com 225 KB); o script tem uma
    secao .dtcmram_bss separada e nada a usa. A premissa de que a biblioteca
    concorreria com a DTCM estava invertida.
    E o `sync` NAO ABRE A JANELA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
    [params-aposentados.txt]
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2026-08-23 Passo 1 dos presets: estruturas e a versao do mapa, provadas sem placa
    presets.h v0.1.0 — o unico pedaco do desenho que se prova inteiro em
    banco nativo, e por isso o escolhido para atravessar a espera da bancada:
    nao toca hardware e nao captura estado.
    A PERTINENCIA E DERIVADA DA TABELA, nao digitada numa segunda lista. Duas
    listas divergem no primeiro param novo, e a divergencia seria silenciosa
    — o param simplesmente nao entraria no preset e ninguem veria. O sufixo
    _a/_b ja diz "e por cadeia"; o resto e a lista curta de excecoes, cada
    uma com a razao ao lado. Medido: 66 de cadeia (2x33) + 9 global + 11
    fora = 86, a tabela inteira coberta.
    O TESTE DO HASH TEM DUAS METADES OPOSTAS, e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
    [params-aposentados.txt]
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2026-08-23 O freeze B nunca era lido, e o rearme do CTOS nunca rearmou
    A solda do dB estava perfeita. Levantei duas suspeitas contra o trabalho
    dele — fiacao cruzada e GND compartilhado ausente — e as duas eram
    falsas. O que resolveu foi medir ANTES da primeira camada:
    B2 ja fechou pra GND: SIM (24144 amostras) -> 2 batidas
    B4 ja fechou pra GND: SIM (24993 amostras) -> 0 batidas
    Numeros praticamente identicos: o pino fechava, o caminho com debounce
    ignorava. Contador em zero tem tres causas (aberto, terminal errado,
    ninguem leu) e nao distingue nenhuma; o nivel cru distingue as tres.
    DEFEITO 1: `for(int b = 0; b < 3 && ...)` — o indice 3, que e o D22 do
    freeze B, nunca era lido. Segu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
    [hal.h, hal_daisy_seed.cpp, main.cpp]
2026-08-23 Presets em RAM: o ciclo fecha, e duas truncagens silenciosas sairam do caminho
    capturar / preset list / preset dump / preset load, e a ingestao por
    COLAGEM: uma linha de dump e um comando valido. Sem isso o dump seria so
    de saida e a biblioteca morreria no desligamento sem volta — dump que
    ninguem consegue recarregar nao e persistencia, e um relatorio.
    Ciclo provado na placa: capturar -> dump -> RESET (a RAM some) -> colar
    de volta -> load. 33 params, 7 linhas, ZERO recusas, valores de volta.
    A biblioteca em RAM ja e persistencia de verdade: o computador e a
    flash, e o dump e o formato. Quando a QSPI destravar, ela so muda de
    casa — nenhuma linha do sistema muda.
    E DUAS TRUNCAGENS SILE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
    [hal.h, hal_daisy_seed.cpp, main.cpp, presets.h]
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2026-08-23 Ausencia so e evidencia quando a presenca era possivel
    Tres casos de hoje eram um so, e a formulacao e do dB. Em todos, uma
    AUSENCIA foi lida como evidencia sobre o mundo quando era evidencia
    sobre o CANAL:
    RDSR devolveu 0x00 -> o chip respondeu ocioso, li "nao respondeu"
    sonda num ramo de tres -> nao cobri os outros, li "vem de outro lugar"
    build sem erro apos touch -> nao recompilei, li "a trava nao morde"
    no arquivo errado
    Antes de concluir do silencio, prove que havia caminho para o som.
    E a mesma raiz da 13k pelo outro lado: la um valor do dominio
    significava "sem dado"; aqui "sem dado" e lido como valor do dominio. As
    duas se resolvem com a mesma pergunta antes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
2026-08-23 O metodo continua sendo vistos: corrigido o enquadramento do retrabalho
    O dB perguntou por que o trabalho manual voltava se tinhamos decidido
    substituir o learn. Ele estava certo. O defeito nao estava na tabela —
    estava em eu a ter apresentado como PROCEDIMENTO. Referencia de 86
    linhas e legitima; "remapeia a partir disto" reintroduz o trabalho que o
    metodo de 22/08 eliminou.
    E A DECISAO ORIGINAL ERA MAIS FORTE DO QUE EU LEMBRAVA. O `learn` nao
    foi aposentado por ser chato: exigia a placa SURDA, descartando todo CC
    que chegasse por desenho, e o `vistos` le exatamente o que chega. Ligar o
    learn cegava o unico instrumento capaz de provar que o learn funcionou.
    Metodo que exige desligar o se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
2026-08-23 Tirar o "armar" do procedimento: era o mecanismo aposentado de novo
    O dB perguntou o que significava "armar o widget". Significa preparar o
    MIDI learn — o mecanismo que a decisao de 22/08 removeu. Eu tinha tirado
    a tabela do lugar de procedimento e mantido, DENTRO do procedimento
    corrigido, um passo do mecanismo aposentado. Corrigir a moldura e
    preservar a peca.
    O procedimento em vigor nao prepara nada no iPad:
    aposentado (learn) em vigor (vistos)
    tu armas o widget tu VARRES os widgets
    a placa dita o numero a placa ESCUTA o que chega
    a placa fica SURDA a placa nunca para de ouvir
    o widget se adapta O FIRMWARE se adapta
    "Quem se adapta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
2026-08-24 Sondas de fio do OLED, e o teste que dava 20 de 20
    O painel esta preto com tudo o que deveria estar certo. Este commit nao
    resolve — instrumenta, e elimina causas por prova em vez de opiniao.
    `fio <rst|dc|cs|clk|din> <0|1>` segura o pino num nivel e PARA, para
    medir NO CONECTOR DO PAINEL. Testa o percurso inteiro (pino, solda, fio,
    conector) e nao a continuidade de um fio isolado. Sem janela e sem
    pressa: o nivel fica ate a proxima chamada. E declara que desconfigura o
    SPI, em vez de fingir que nada mudou.
    `fio curto` caca ponte entre os cinco pinos — o que a continuidade
    ponto-a-ponto NAO cobre: `D6 -> DC` passa mesmo que D6 esteja tambem em
    curto com D7, e dois sinais do SPI unidos q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
    [hal.h, hal_daisy_seed.cpp, main.cpp]
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2026-08-24 Trava de nivel cru dos encoders: acusa o geral e absolve os outros dois
    O encoder global nao contava nada e o `Increment` da libDaisy nao dizia
    por que: ele exige a quadratura casar, e uma fase presa deixa o contador
    em zero PARA SEMPRE sem distinguir isso de "ninguem girou". Cegueira do
    mesmo tipo que o contador do freeze B tinha.
    Leitura ESTATICA nao resolvia: uma fase pode legitimamente estar baixa
    no detente atual. O que distingue fase MORTA de fase EM REPOUSO e a
    MUDANCA — entao a trava guarda os DOIS lados, e pino que so aparece de
    um jeito desde o reset nunca comutou.
    cadeia A faseA COMUTA faseB COMUTA push COMUTA
    cadeia B faseA COMUTA faseB COMUTA push COMUTA
    global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
    [hal.h, hal_daisy_seed.cpp, main.cpp]
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2026-08-24 Audit profundo de 696fa0c: cinco achados e uma familia nova
    Feito depois de ~40 versoes numa sessao com a multiplexacao MIDI refeita
    duas vezes, presets em RAM, tres encoders com o mapa corrigido a meio
    caminho, e o OLED que nunca funcionou. O AUDIT NAO CONSERTA (R4) — os
    fixes sao commits separados.
    O QUE PASSOU, e fica escrito para o proximo audit nao refazer: callback
    de audio LIMPO (zero Log, MIDI, malloc ou delay nas 624 linhas); ordem
    de boot correta; folga em todos os cinco tetos; ZERO instrumentacao
    orfa; 37 familias _a/_b sem uma orfa dos dois lados; e os casts dos
    presets nao estouram porque Set() clampa via Clamp01.
    ACHADOS:
    1 (laranja) QUATRO DOCUMENTOS descrevem o esquema d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
    [params-aposentados.txt]
2026-08-24 Achado laranja fechado: os quatro docs falam os seis canais
    O unico achado do audit que mudava o que alguem faz com as maos. O
    roteiro de aceite mandava conferir ch3/ch4 no MIDI Wrench e a placa fala
    ch4/ch5/ch6 — documento errado nao fica parado, manda alguem ao lugar
    errado com o multimetro na mao.
    CCMAP.md regenerado, ACEITE-MULTIPLEXACAO, PRESETS e STATUS corrigidos.
    A mencao restante no PRESETS ficou, marcada como HISTORICA: o voo B de
    fato levou o espelho para ch3/ch4, e a simetria de seis veio depois —
    apagar isso seria reescrever o registro, nao corrigi-lo.
    E O GERADOR TAMBEM TINHA A PREMISSA VELHA: a tabela dele dizia
    {kCanalEntradaA: 1, kCanalEntradaB: 2}, escrita para DOIS c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
2026-08-25 Gerar o perfil do Loopy, e o verificador que contava zero
    O trabalho a frente era configurar 86 bindings a mao no iPad. A saida nao
    foi acelerar o gesto: foi achar o formato. Perfil de controlo e um bundle
    de plists XML; projeto e um zip com SQLite onde cada widget e JSON com
    `title` e cada `Scene` traz o array ORDENADO dos seus widgets. Com isso o
    endereco fica derivavel do `manifest.h`, e um dia de configuracao vira um
    comando — e, o que importa mais, vira REGENERAVEL.
    O gerador so emitiu depois de reproduzir ao caracter os dois bindings que
    o dB fizera a mao (`b417`, `b314`). Sem amostra conhecida, 86 bindings
    plausiveis sao indistinguiveis de 86 errados, e a deteccao passaria para
    o o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
    [check_docs.py, dynamics.h, hal_daisy_seed.cpp, main.cpp, midi.h, params.h]
2026-08-25 Identidade persistente: o formato exportado nao era o formato
    Ao montar o `.lpproj` completo apareceu que os bindings feitos a mao dentro
    do projeto apontam para `#1522` — o `id` do widget no SQLite — e nao para
    `LPSliderWidget:1:6`. A forma posicional que eu decodifiquei ontem e uma
    CONVERSAO que o Loopy faz ao exportar o perfil sozinho, porque fora do
    projeto o id nao tem significado.
    Eu tinha decodificado o formato de EXPORTACAO e chamado-lhe o formato. A
    fragilidade posicional de que avisei — reordenar a pagina desendereca em
    silencio — era real na forma que eu tinha visto, e desnecessaria na forma
    que eu nao tinha visto.
    v0.2.0 emite `#<id>` quando gera para dentro do projeto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
2026-08-27 O commit de ontem nao compilava, e a sonda escolhia a placa por sorte
    BUILD QUEBRADO, COMMITADO EM 03e6777. O `board` passou a imprimir as
    versoes de modulo e para o hal usei `COTUCA_HAL_VERSION` direto no
    main.cpp — macro que vive no hal_daisy_seed.cpp e portanto nao existe
    ali. NUNCA COMPILOU, e mesmo assim foi commitado: eu rodei check_docs e
    os bancos nativos, e nenhum dos dois constroi o main.cpp para a placa.
    A rotina de bancada diz isto em uma linha e eu tinha a linha na frente:
    build limpo nao confirma que o codigo novo esta no build — e eu nem
    sequer tinha build.
    Mover a macro para hal.h resolveria o build e estragaria o contrato: a
    versao da IMPLEMENTACAO nao e propriedade da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
    [hal.h, hal_daisy_seed.cpp, main.cpp, porta_daisy.py]
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2026-08-27 O firmware minimo, e as tres sondas que mentiram antes dele
    DUAS DAISY NOVAS, gravadas com sucesso, enumeravam o USB e nunca falavam.
    Duas horas de hipoteses sobre o nosso app — bootloader, linker, .bss, QSPI,
    ITCM, n_ramps, NowMs, BbFlush — todas verificadas por leitura, todas
    eliminadas, e o sintoma intacto.
    O QUE RESOLVEU foi trocar a pergunta. Em vez de "o que esta errado no app?",
    "de que lado esta o defeito?". Trinta linhas: Init, StartLog, imprimir,
    piscar. Falou a primeira, e numa unica gravacao ilibou a placa, a cadeia de
    gravacao e o USB CDC — o defeito e do nosso app.
    Cada gravacao seguinte eliminou mais um suspeito: init do audio (nao trava),
    64 MB de SDRAM escritos e rel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
    [teste_minimo.cpp]
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2026-08-28 O level suavizado, e a metade do mapeamento que apontava para um morto
    DUAS COISAS FECHARAM O VOO 1 DO ESP32, e ambas eram invisiveis de dentro.
    1. O MAPEAMENTO TEM DUAS METADES, guardadas em sitios diferentes.
    Depois da troca de hardware o `sync` funcionava — os 86 widgets do
    Loopy saltavam para o estado da placa — e o fader nao comandava nada.
    Parece problema de direccao no radio ou no fio; nao e nem um nem outro:
    a placa move os widgets -> perfil do DISPOSITIVO id b2d29493
    os widgets comandam -> perfil Internal, 154 endpoint e41c21ae
    accoes `Send MIDI`
    Os dois identificadores sao diferentes e nenhum deriva do outr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
    [check_docs.py, main.cpp]
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2026-08-28 O firmware nomeia saida; o cobre nomeia destino
    Tres fontes discordavam sobre o que sao as duas saidas: o codigo somava as
    duas cadeias nas duas, os params chamavam-se `route_exciter`/`route_jack`, e
    o HARDWARE.md dizia "OUT_L (cadeia A)". Passei a sessao a tentar decidir qual
    das tres estava certa.
    Nenhuma. O dB tem dois DPDT de tres posicoes - jack | ambos | amp - um por
    saida. O destino nao e propriedade da saida: e posicao de chave, e muda em
    operacao. `out[1]` nunca foi "o jack"; e uma saida que PODE estar no jack.
    E o nome falso enganou dentro da propria sessao que o corrigiu: usei
    `route_exciter 0` a pensar que silenciava so o transdutor.
    O QUE PASSA A EXISTIR, e sao dois andares q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
    [main.cpp, manifest.h, nivel_tempo.py, presets.h]
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2026-08-28 Cinco defeitos fechados, e cada conserto trouxe outro
    Os itens 2, 3, 5, 6 e 7 da lista. O 1 (encoder G intermitente) e solda e
    fica com o dB; o 4 (20 min de BLE) precisa do iPad acordado.
    2 — O CARTAO DE CC VIROU GERADO. Tinha 27 numeros que ja nao existiam, e
    ninguem notou porque um PDF nao compila e nao falha. A saida nao foi
    escolher entre corrigir e aposentar: o que MUDA gera-se (CC, canal, quais
    params existem, do manifest), o que DURA e dado (a nota humana, numa tabela
    NOTAS). O `gerar_ccmap` v0.3.0 passou a ESCREVER os dois destinos — antes so
    imprimia e alguem colava no CCMAP.md a mao, e gerador que nao escreve deixa
    a ultima milha para a disciplina humana.
    E entao veio o que i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
    [check_docs.py, hal.h, hal_daisy_seed.cpp, main.cpp, params.h, pitch_spectrum.py, ponte.ino]
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2026-08-28 Os 20 minutos passaram, e a NVS pagou-se ao primeiro uso
    0 quedas com o iPad acordado e o Loopy em primeiro plano. O `arranques`
    subiu exactamente UM desde a leitura anterior, e esse um foi a sonda a
    abrir a porta — logo a ponte tambem nao reiniciou, e um piscar de
    alimentacao teria aparecido ali. As duas hipoteses fechadas de uma vez.
    E FICA ESCRITO QUE A SONDA DERRUBA O QUE MEDE: abrir a porta serie do
    ESP32-C3 reinicia a placa, mesmo com DTR/RTS em falso — o USB nativo le a
    abertura como reset. A primeira tentativa deste teste morreu assim, comigo
    a derrubar a ligacao do dB ao ler o `board`. Para observar ao vivo, abrir
    UMA vez e segurar.
    Corolario que muda o passado: a corrida ante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
2026-09-01 O nome passou a dizer de que lado do limitador cada volume mora
    O tom de teste saia alto e limpo e os piezos nao soavam. O dB ia subir o
    ganho dos piezos — mudanca permanente no instrumento, paga em margem de
    microfonia, num sitio onde ninguem ligaria as duas coisas depois.
    Era o master a zero. O tom entra DEPOIS dele; os piezos, antes. Essa
    assimetria e que engana, e apontava para piezo, cabo, jack, ADC — tudo
    menos para o param que ninguem ve. Aconteceu CINCO vezes num dia, sempre
    depois de gravar, porque todo param nasce em zero por regra da casa e um
    master a zero e silencio.
    O dB perguntou se `level` nao era redundante agora que ha `level_l` e
    `level_r`. O codigo diz que nao, e a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
    [params-aposentados.txt]
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2026-09-01 O painel acende no fim do gesto, nao no principio dele
    Terceira volta a acertar a mesma regra, e nenhuma das duas anteriores
    foi bug — foram modelos errados do mesmo gesto.
    1a: engolia UM evento. "um gesto e quantos passos forem ate parar; e
    dificil em palco mexer exactamente um clique."
    2a: engolia ate a mao parar, mas acendia no primeiro evento.
    "ainda nao deu, nao e por tempo."
    3a: ouve o encoder, fica a engolir COM O PAINEL APAGADO, e acende
    500 ms depois de parar.
    A diferenca entre a 2a e a 3a e pequena no codigo e grande na mao: o
    painel a acender a meio da rotacao pisca no canto do olho e sinaliza
    "estou a ouvir-te" enquanto ainda esta a deitar fora tudo o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
    [main.cpp]
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2026-09-01 O portao dos presets fechou, e o ERC finalmente correu
    Duas decisoes do dB, e o mapa passou a 0xFB5A com o global a cair de 11
    para 9 params — sao os dois post_level_* a sair.
    post_level_l/r fora do preset. Razao dele: seguem os pots fisicos, e se
    o preset os restaurar o firmware e o cobre discordam sem ninguem saber
    qual manda; e cada corpo da serie tem ganho de exciter proprio, entao
    preset de um corpo levaria nivel errado noutro. Facto de exemplar, nao
    intencao musical — mesma categoria do exc_on e do gov_ceiling.
    Familia do tom renomeada inteira: test_tone_freq, mix, out, via. Eram
    duas regras de exclusao (`tone_` e `test_tone`) porque o stage nasceu
    com prefixo diferente; agora um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
    [cotuca_energia.kicad_sch, cotuca_preamp.kicad_sch, params-aposentados.txt]
2026-09-01 Os 176 avisos de grade sairam por conserto, nao por isencao
    O dB escolheu realinhar em vez de isentar, e a medicao mostrou que o
    conserto era mais seguro do que eu temia: os pinos DENTRO dos simbolos
    ja estavam todos na grade (offsets de 2,54 e 3,81 sao multiplos de
    1,27) — 42 na grade, zero fora. So a COLOCACAO dos simbolos e as pontas
    de fio estavam fora, 306 pontos, todos em milimetros inteiros.
    Entao o encaixe mexe so nisso, e nao toca no desenho dentro dos
    simbolos: nao ha triangulo de diodo distorcido para consertar nada.
    E arredondar e funcao pura, o que da a garantia que interessa: dois
    pontos que coincidiam continuam a coincidir. O `confere_colisoes` cobre
    o risco simetrico —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
    [cotuca_energia.kicad_sch, cotuca_preamp.kicad_sch]
2026-09-01 Quatro bandeiras a declarar quem alimenta, e o ERC a zero erros
    Decisao do dB: "declarar quem alimenta e resposta; isentar e mandar o
    verificador olhar para o lado". E quatro, nao dois — o ERC nao atravessa
    o R7, entao V+PRE e rede distinta de +15V e precisa da sua.
    #FLG1 -> +15V (energia, fonte: decoy PD)
    #FLG2 -> +5V (energia, fonte: step-down)
    #FLG1 -> V+PRE (preamp)
    #FLG2 -> GND (preamp)
    Um por rede, e so um: dois `power_out` na mesma rede sao conflito, e
    trocariamos um erro por outro.
    Resultado: ZERO erros nas duas folhas. Sobra o que resolve sozinho no
    projecto unico — 46 lib_symbol_issues (simbolos auto-contidos) e 3
    isolated_pin_label, esta ultima marcada como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
    [cotuca_energia.kicad_sch, cotuca_preamp.kicad_sch]
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2026-09-01 Skill loopy: perfil e projecto sao coisas diferentes
    O dB pediu "no formato para importar no Loopy" e eu fui buscar o gerador
    de PERFIL. Ele corrigiu: e PROJECTO. A diferenca importa e agora esta
    escrita — perfil mapeia CC para widgets que JA EXISTEM; projecto traz os
    widgets. Se ainda nao existem, o perfil nao tem a que se agarrar.
    Decodifiquei o .lpproj: e um zip com Project.sqlite, duas tabelas, e o
    `contents` dos objectos e JSON EM TEXTO, nao plist binario — o que torna
    o formato inteiramente tratavel por script. Ficam registados o esquema, o
    padrao de referencia {"_type":...,"_value":id}, e a forma dos objectos
    que interessam para montar uma pagina: Scene, SliderWidget, ButtonWidge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
2026-09-01 Presets sao uma lista so, e a refactorizacao fica para amanha
    O dB corrigiu o modelo em tres frases, e ele estava errado dos dois
    lados. Nao sao duas bibliotecas com conteudos diferentes: e UMA lista, e
    cada preset guarda um retrato completo — valores da cadeia A, da cadeia
    B, e os partilhados. O destino decide QUANTO dele entra: como A entra so
    a parte de A, como B so a de B, como G entra tudo.
    O estado sao DOIS ponteiros — pode estar a parte-A do preset 3 na cadeia
    A enquanto a parte-B do preset 7 esta na B. E o gesto e girar a lista ate
    achar e confirmar, nao dezasseis botoes.
    Fica em PRESETS-LISTA.md, no topo, com o modelo antigo marcado como
    errado por baixo. E com a pergunta de p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
    [presets.h]
2026-09-01 O perfil enderessa por id, e eu apaguei todos os ids
    O dB ligou o BLE e nada respondia. A placa deu o veredito num numero:
    `bytes 0 | cc 0` — nao chegou um unico byte de MIDI, com a UART a
    escutar e sem erros. O corte estava antes dela, e a ponte ja dizia o
    mesmo: BLE->ser 0.
    A causa e o projecto que eu gerei. Esta skill dizia que o `Subject` de
    um binding era POSICIONAL — "<Tipo>:<cena>:<posicao>". Nao e. Verificado
    num export real, e enderessa por ID do objecto: "#1526".
    E ha DOIS perfis, um por direccao, ambos por id: o `Internal` mapeia
    widget -> MIDI (envio, trigger "1482:Value"), e o de dispositivo mapeia
    MIDI -> widget (retorno, Subject "#1526").
    Ao reconstruir as paginas eu ap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
2026-09-01 ntc era um termistor, e o tom de teste chama-se level
    Dois renames, e os dois vieram de o nome nao dizer a verdade a quem o le.
    O dB perguntou "o que e ntc?" — e essa pergunta e o veredito: se o dono
    do instrumento nao reconhece o nome, o nome falhou. Pior neste
    repositorio, onde ha folhas de KiCad ao lado do firmware: NTC e um
    COMPONENTE, o termistor de coeficiente negativo. `ntc1_hz` le-se como
    "o primeiro termistor", nao como "o primeiro notch". Passa a `notch_*`,
    com os CCs 82-86 intactos.
    E o tom de teste passou por tres nomes ate assentar. `mix` era o
    literal — o codigo faz `b*(1-m) + tom*m`, um crossfade a serio, e em 0.5
    ouve-se metade de cada. Depois `gain`, e por fim `level`,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
    [params-aposentados.txt]
2026-09-01 Tres perfis no bundle, e valia o do dispositivo errado
    O BLE ligado, os widgets no ecra, e zero bytes no instrumento. A causa
    nao era o fio, nem o firmware, nem o projecto que eu gerei: o Loopy
    estava ligado como "Cotucatronics 1" — sobra de um emparelhamento
    anterior, guardado — enquanto o trabalho todo estava no perfil
    "Cotucatronics".
    O perfil e por DISPOSITIVO, e eles acumulam. O export real trazia tres:
    Cotucatronics (103 bindings), Cotucatronics1 (99) e FootCtrlPlus (12).
    Vale o do dispositivo LIGADO, e mais nenhum.
    O sintoma nao aponta para la — parece fio, parece firmware. Fica a regra
    de conferir a que dispositivo o Loopy esta ligado ANTES de desmontar
    seja o que for, e a no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
2026-09-02 O rearme sem teto ERA o defeito, e o contador mostrava-o ha semanas
    O dB corrigiu-me: eu tinha escrito no ppc que ele dissera "nao agora" ao
    conserto da ponte ESP32. Ele dissera o oposto, e e regra dele desde o
    inicio — sempre conserta agora. Pus na boca dele uma frase invertida, num
    documento cujo trabalho e instruir a proxima sessao.
    REPRODUZI A FALHA POR SOFTWARE. A ponte tem `pino <g> <0|1|2>`: pondo o
    TX dela (GPIO4) em BAIXO, a linha de RX da Daisy fica em BREAK permanente
    — que e o que uma ESP32 sem alimentacao faz. Deixou de precisar das maos
    do dB para reproduzir; so para o RESET.
    E a causa nao era a que eu escrevera. O rearme do DmaListen JA EXISTIA no
    PollMidi, e era ELE o d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
    [hal.h, hal_daisy_seed.cpp, main.cpp]
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2026-09-02 Conserto adiado nao fica pequeno: fica a ser o equipamento da proxima emergencia
    O dB nomeou o que esta sessao foi, e a leitura dele e mais dura que a
    minha: um problema pequeno abriu uma investigacao de cinco horas porque
    "erros pequenos vao se acumulando por baixo".
    Separada a conta, a forma exacta aparece — e nao e "erro pequeno cresce".
    NENHUM dos defeitos encontrados hoje foi causado pelo pull-up em falta.
    Eram nove, independentes, antigos, e nenhum cresceu: ficaram todos do
    mesmo tamanho. O que mudou foi que passaram a ser USADOS.
    rearme sem teto ................ 10 029 rearmes a vista havia semanas
    LED confundia fase 0 com 1 ..... mandou-me a fase errada
    LED lia duas volatei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
    [main.cpp]
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2026-09-02 O conserto existia desde 25/08, previa o meu erro por escrito, e nao tinha sido adoptado
    O dB perguntou se sobrava algum bug. Fui verificar em vez de responder de
    memoria, e o `check_docs` apontou `porta_daisy.py` na lista de tocados sem
    subir a versao. Abri-o.
    Escrito em 25/08. Docstring:
    "Todo script desta bancada fazia glob(...)[-1]. [...] o modo de falha
    seria mandar comandos da Daisy para o ESP32: sem erro, sem resposta, e
    um diagnostico que procuraria o defeito no lado errado."
    Foi EXACTAMENTE isso que me aconteceu em 01/09, e eu escrevi-o como
    descoberta na 15ax. O conserto existia, estava certo, previa o meu erro
    por escrito — e era usado por UM script. O `flash.sh` e o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
    [cotuca_serial.py, hal.h]
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2026-09-02 PS_2 desenha limpo, e o mapa do prescaler fecha em PS_8 por medicao
    Ultimo item aberto da lista. Verificado por FOTOGRAFIA do padrao de 1 px e
    nao por descricao: xadrez fino e uniforme, sem blocos nem costuras. O
    periferico nao parte ate ao chao.
    PS_64 23 401 us -45%
    PS_16 6 945 us -12%
    PS_8 3 861 us -7% <- escolhido
    PS_4 2 050 us -4%
    PS_2 1 419 us -4%
    A decisao continua PS_8, e agora com razao medida em vez de prudencia: de
    PS_4 para PS_2 o relogio DUPLICA e o quadro so cai 31%. Os ~300 us de
    custo fixo ja sao 21% do quadro, e o laco nao sente a diferenca — -4% nos
    dois. PS_2 nao compra nada que o PS_4 nao de, e gasta a ultima oitava de
    margem electrica.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
2026-09-02 A 15bd repetiu-se dentro do mesmo ficheiro, e o meu grep nao a apanhou
    O dB perguntou se sobrava algum bug. Fui correr o `flash.sh` — que consertei
    hoje e nunca tinha exercitado — e ele falhou em dois sitios.
    1. A LEITURA DE VOLTA DA VERSAO AINDA USAVA `p[-1]`. Consertei o bloco do
    `dfu go` no topo do ficheiro e DEIXEI O DE BAIXO no caminho velho. E a
    15bd a repetir-se dentro do mesmo ficheiro, no mesmo dia: um conserto
    nao adoptado por TODOS os chamadores nao esta feito.
    E o `placa diz v?` que isso produzia matava justamente a razao de o
    script existir — a regra 2 da bancada, conferir a versao na placa.
    2. E EU TINHA DECLARADO "nenhum caminho velho sobrou" com um GRE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
    [check_docs.py]
2026-09-02 A marca sobe e encolhe, e o flash.sh mostrou quatro defeitos por eu nunca o ter corrido
    PEDIDO DO dB: a marca da abertura estava colada as letras. Media-se em
    pixeis e nao a olho — com ra=30/rb=13 em cy=20, o anel exterior (ra+5,
    rb+4) acabava em y=37 e o nome comeca em y=40: TRES pixeis de folga.
    Agora ra=26/rb=11 em cy=17: a marca ocupa y=2..32 e a folga passa a SEIS
    linhas. Verificado no render em terra antes de gravar, e depois no vidro.
    E 15bf, que so apareceu porque o dB perguntou se sobrava algum bug e eu
    fui CORRER o `flash.sh` — consertado nessa manha, commitado, declarado
    feito, e nunca executado uma vez. Quatro defeitos numa corrida:
    1. A 15bd repetiu-se DENTRO DO FICHEIRO O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
    [main.cpp, splash.h]
2026-09-02 Um teste falhava ha semanas, o corredor chamava tres dos cinco, e so correr os apanhou
    Segunda vez que o dB pergunta "sobrou algum bug?". Da primeira respondi com
    um grep e ele apanhou-me. Desta vez corri TUDO o que e executavel.
    1. `test_presets` FALHAVA com tres falhas, e nenhuma era do codigo:
    params por cadeia esperava 33, sao 39 (os notches entraram)
    params globais esperava 9, sao 6 (o dB tirou post_level_l/r,
    out_l/r e pre_level_ab)
    `pre_level_ab` tem de entrar no preset -> o dB REVOGOU isso em 01/09
    Teste que ninguem corre nao e teste: e uma opiniao antiga. E o modo de
    falha e perverso — acusa o CODIGO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
    [test_presets.cpp]
2026-09-02 A microfonia passa a ser por EXCITER, com quatro bocas, e o supressor tem contrato escrito
    Sessao de escuta com o dB. O que ela descobriu vale mais que o codigo.
    O ACHADO. O problema nunca foi "o ajuste do tambor nao serve o botijao":
    era um LACO QUE ATRAVESSAVA OS DOIS CORPOS, pelas diagonais da matriz.
    Medido: com as quatro celulas abertas, 1536,4 Hz a +24,4 dB e dominancia
    0,99. Com `A->L` e `B->R` apenas, 1543,1 Hz a -24,3 dB e dominancia 0,27.
    QUARENTA E NOVE DECIBEIS. O `route` deixou de ser detalhe de
    encaminhamento e passou a ser controlo de primeira ordem sobre a
    microfonia.
    E MAIS: mesmo com a matriz separada os dois ramos reportaram 3275,7 e
    3275,8 Hz — a mesma frequencia as d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
    [hal.h, hal_daisy_seed.cpp, main.cpp, manifest.h, notch.h, presets.h, test_midi.cpp]
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2026-09-04 Esquematicos migrados para o formato do KiCad 10, com a migracao medida
    `kicad-cli sch upgrade` nas duas folhas da revB: 20211014 (KiCad 6, escrito
    pelo kiutils) -> 20260306 (KiCad 10.0.5).
    A migracao passou o portao da skill `kicad` inteiro, e nao por confianca:
    §0 as duas ABREM — o ERC correu antes de tudo o resto
    §3 netlist IDENTICO: energia 6 redes/27 nos, preamp 18 redes/72 nos
    §9 ERC com a MESMA contagem depois (15 e 38), render conferido a olho
    O upgrade correu primeiro em COPIAS, e so depois nos originais.
    ⚠️ E a primeira comparacao de netlist que escrevi disse "IDENTICO (0 linhas
    de topologia)" — zero. A regex era do formato de UMA LINHA e o netlist do
    KiCad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
    [cotuca_energia.kicad_sch, cotuca_preamp.kicad_sch]
2026-09-04 O projeto KiCad entra no git, e deixa de haver tres copias da mesma folha
    Ate agora `kicad/cotuca_cerebro/` — o projeto a serio, com `.kicad_pro` e
    folha raiz — estava POR SEGUIR. Um projeto inteiro fora do git e uma perda a
    uma pancada de distancia, e ao mesmo tempo havia mais duas copias soltas das
    mesmas folhas em `docs/operacao/esquematicos/revB/`.
    Tres copias do `cotuca_energia.kicad_sch`, com ERC de 0, 15 e 66 violacoes, e
    nada no repo dizia qual mandava. E a diferenca nao era cosmetica: a do docs/
    ainda tinha o SW1 e o J5 que o desenho de 04/09 removeu.
    Decisao do dB: `kicad/` e a canonica, entra no git, e as soltas saem. Os
    `gen_*.py` ficam pelo desenho que documentam — as es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
    [cotuca_cerebro.kicad_sch, cotuca_energia.kicad_sch, cotuca_preamp.kicad_sch]
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2026-09-04 Raiz hierarquica de verdade, e a energia encaixada na grade
    A folha raiz era uma COPIA velha da energia (designadores R1/R2 em vez de
    R8/R9) e nao referenciava sub-folha nenhuma — nao havia hierarquia, e os
    passos do soquete e do conector nao tinham onde existir.
    Raiz nova: so as duas folhas. Ligam-se por ROTULOS GLOBAIS e nao por pinos de
    folha, que e o que o desenho ja usava. Provado pela uniao do netlist:
    energia 6 redes / 27 nos
    pre-amp 18 redes / 72 nos
    RAIZ 22 redes / 99 nos (24 menos as 2 partilhadas, que fundem)
    +15V 7+1 -> 8 · GND 10+15 -> 25 · nenhuma rede perdida
    ENERGIA ENCAIXADA NA GRADE de 1,27 mm: 67 -> 13 violacoes, os 53
    `endpoint_off_grid` todos limpo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
    [cotuca_cerebro.kicad_sch, cotuca_energia.kicad_sch, cotuca_preamp.kicad_sch]
2026-09-04 O encaixe na grade fecha: 129 -> 4 violacoes, netlist identico
    A juncao era o que faltava, e o defeito era o MESMO que eu ja tinha
    corrigido uma vez.
    O `encaixa_grade` casava as juncoes por `\(junction \(at `, que exige tudo
    numa linha. No formato expandido do KiCad 10 o `(at` vai para a linha
    seguinte: das 26 juncoes do pre-amp, o padrao apanhou ZERO. Os fios moviam-se
    e as juncoes ficavam — e juncao e SEMANTICA (skill kicad §4), e ela que faz
    os fios ligarem-se num ponto. Mataram-se todas as ligacoes em T, e por isso
    as redes de dois membros sobreviviam e as de tres ou mais morriam.
    Na v0.2.0 eu tinha corrigido exactamente isto para os simbolos — casar por
    estrutura e nao por indent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
    [cotuca_energia.kicad_sch, cotuca_preamp.kicad_sch]
2026-09-04 Pre-amp passa a seguidor, e o terra do audio separa-se do de forca
    O que a bancada aprovou, posto no desenho:
    · rede de ganho (RVA/RVB, R3A/R3B, C3A/C3B, C1A/C1B) marcada DNP —
    fica com footprint, nao e povoada
    · R0A/R0B de 0R POVOADOS ligam OUT a -IN no lugar do trimpot
    · C2A/C2B de `1n C0G` para `20n C0G` (os -6 dB da crista)
    · DA/DB ja eram BAV99 — nada a fazer, e vale dize-lo
    O 0R foi verificado onde interessa, no netlist e nao no desenho:
    Net-(C1A-Pad1) C1A.1 R3A.2 RVA.1 U1A.1 -> + R0A.1 (o -IN)
    Net-(C1A-Pad2) C1A.2 R4A.1 RVA.2 U1A.3 -> + R0A.2 (a saida)
    22 redes intactas, 99 -> 103 nos (os quatro pinos novos), zero violacoes
    novas. Os dois nos ja t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
    [cotuca_preamp.kicad_sch]
2026-09-04 PWR_FLAG fecha o pre-amp: 2 violacoes, e as duas sao a isencao com prazo
    Simbolo `cotuca:PWR_FLAG` novo — pino `power_out`, referencia `#FLG`, fora da
    BOM — com uma bandeira em `V+PRE` e outra em `AGND`. Cada uma num ponto livre
    do fio, com juncao, e nao na coordenada do rotulo, que o taparia (skill §6).
    ERC do projeto 4 -> 2 netlist INALTERADO: 23 redes, 103 nos
    As bandeiras alimentam a rede para o ERC sem entrar como componente: e para
    isso que a convencao da referencia `#` existe.
    ⚠️ E O DNP NUNCA HAVIA PEGADO. Eu inseria `(dnp yes)` a seguir ao `(unit N)`
    e o bloco JA TINHA um `(dnp no)` mais abaixo — duas chaves iguais no mesmo
    simbolo, e o parser fica com a ultima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
    [cotuca_preamp.kicad_sch]
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2026-09-05 O vocoder e o motor externo saem da arvore, e nasce o /audit
    O dB pediu para apagar toda e qualquer referencia ao vocoder e, depois, ao
    motor de DSP externo. Sao 139 mencoes em 35 ficheiros: documentacao, skills,
    os dois documentos de bancada em src/, e 86 linhas de comentario no fonte.
    O CRITERIO. Onde o nome era a RAZAO de uma decisao que ainda vale, a razao
    ficou e so o nome saiu: o bloco 48 (o 256 era exigencia de uma FFT), o defeito
    prioridade 1 da serial (que e starvation da ISR do USB por callback longo, nao
    de um efeito), o passa-alta do Fx2 e quatro etapas do IFA10000. Onde o registo
    ERA sobre ele, saiu inteiro — e isso e perda declarada, nao silenciosa: a
    linha do livro de certi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
    [params-aposentados.txt]
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2026-09-05 D29 e D30 sao o USB, e os pinos 20/40 estao na diagonal
    Tres factos medidos pelo dB fecham o dia, e dois deles corrigem documentos.
    1. NAO HA CONTINUIDADE ENTRE 20 E 40 numa Daisy em mao. A premissa dos
    terras esta agora confirmada em TRES frentes independentes: a doc da
    libDaisy ("always connect the DGND and AGND pins outside of the Daisy"), o
    CSV do fabricante, e o multimetro. A ponte e nossa para desenhar, e o §6a
    do MAPA-DE-TERRA deixa de ser "por medir".
    2. OS PINOS 20 E 40 NAO SAO VIZINHOS. O 20 fica no canto inferior esquerdo,
    colado ao USB-C; o 40 no superior direito, no extremo oposto. Estao na
    diagonal do modulo — e eu tinha escrito o contrario no mapa, como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
    [gera_daisy_sym.py]
2026-09-05 15ca: a ponte nao estava dentro da Daisy, e a instrucao matou uma Seed
    Cicatriz escrita pelo dB, preservada. Entrou como 15ca e nao como 15bn, que
    era o numero no original: o 15bn ja estava ocupado pela ferramenta de
    reposicao construida sobre um contrato deduzido.
    As seis regras que ela deixa sao para o chat cumprir, nao so para a bancada,
    e a primeira e a unica que sobrevive a um conselho errado:
    1. terra e alimentacao so se refazem com a Daisy FORA do soquete
    2. nenhuma instrucao de fiacao sem ver a fiacao real
    3. refazer vem como tabela antes/depois, e o primeiro passo mede o "antes"
    4. reversao escrita antes do gesto
    5. facto de hardware sem fonte e HIPOTESE, e diz-se como h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
2026-09-05 O teste do terra estava velho no documento que manda, e o PID nao distingue os dois DFU
    Duas correcoes, e as duas sao de coisas que MANDAVAM fazer o gesto errado na
    bancada. Nenhuma delas tinha verificador que a apanhasse: sao afirmacoes sobre
    o mundo fisico, e o mundo fisico nao compila.
    1 · ATERRAMENTO.md v0.1.0 -> v0.2.0
    O README diz que este e o documento DONO do aterramento. A sua seccao
    Conferencia mandava medir a ilha contra o trilho com a placa fora do soquete e
    concluia: "se apitar, ha uma ligacao a mais".
    Com o net-tie do revB desenhado, APITAR E O CORRECTO. O teste velho faria ler
    uma placa certa como defeituosa — e a medicao com o multimetro e uma das
    pendencias ainda abert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
2026-09-05 O portao dos SVG sabe dizer nao, e agora tambem "nao consegui olhar"
    `svg_colisoes.py` entra em `tools/` (v0.2.0) e a `design-review` passa a viver
    no repo, com a emenda de 05/09 como PASSO 1 — antes do olho, nao em apendice.
    A do plugin vivia num cache de sessao e a emenda perder-se-ia.
    A ordem fica fixa, e qualquer edicao reinicia as tres:
    gerar -> svg_colisoes (0) -> fatiar e olhar (composicao) -> entregar
    TRES DEFEITOS DO PORTAO, CONSERTADOS ANTES DE O USAR:
    1. `100%` REBENTAVA. `float(el.get("width"))` num rect de fundo matava a
    ferramenta. Nasce o `num()`, que le %, px, mm, cm, in, pt, em, ex, e
    resolve percentagem contra o canvas (viewBox quando width/height sao
    per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
    [svg_colisoes.py]
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2026-09-05 A folha do soquete existe, e as isencoes de AUDIO_IN morreram no prazo
    `cotuca_soquete.kicad_sch`, desenhada por SCRIPT (`gera_soquete.py`), com os
    simbolos que faltavam gerados a parte (`gera_simbolos.py`): NETTIE2, DPDT,
    CONN4_L, CONN5_L.
    A PONTE, e o netlist prova que e unica:
    AGND 21 nos | GND 16 nos | interseccao VAZIA
    NT1.1 no AGND, NT1.2 no GND — duas redes no ERC, uma ligacao de cobre
    E o pre-amp chega a Daisy: AUDIO_IN_L -> C4A.2 + U2.16, AUDIO_IN_R -> C4B.2
    + U2.17. **As duas isencoes de AUDIO_IN morreram no commit que criou esta
    folha**, exactamente como o prazo dizia — zero mencoes no relatorio. E a
    primeira vez que uma isencao deste repo expira por ter sido RESOLV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
    [cotuca_cerebro.kicad_sch, cotuca_soquete.kicad_sch]
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2026-09-05 A folha do conector existe, e desenha-la achou o D17 duplamente reservado
    `cotuca_conector.kicad_sch`, gerada por `gera_conector.py`, com a pinagem do
    ROTEIRO-KICAD §5 verbatim. Mais o simbolo IDC26 (gera_simbolos v0.2.0).
    ERC do projeto: 31 -> 18. As isencoes de painel de 25 -> 10.
    🔴 E O ACHADO E MAIOR QUE A FOLHA: O `D17` ESTA DUPLAMENTE RESERVADO.
    hal_daisy_seed.cpp kEncPin[2] = {D19, D18, D17} -> push do encoder G
    ROTEIRO-KICAD §4 "D17 = A2 = V_TRILHO" -> divisor 100k/22k
    Os dois estao escritos, os dois sao intencionais, e NAO PODEM COEXISTIR: o
    botao poe o divisor a massa a cada clique, e a leitura da tensao do trilho da
    zero exactamente quando alguem car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
    [cotuca_cerebro.kicad_sch, cotuca_conector.kicad_sch]
2026-09-05 Um encoder so, botao branco para os buzios, e o conflito do D17 dissolve-se
    Decisao do dB sobre a interface: UM encoder, com push+giro a dar os outros
    controlos e uma lista de presets simples; o botao de rearme sai (fica o `b3`
    da serial); e os buzios ganham botao BRANCO proprio.
    ⚠️ E ISSO RESOLVEU O CONFLITO DO D17 DE GRACA. O push do encoder G vivia no
    D17, que o desenho queria para o divisor 100k/22k do trilho (A2) — dois usos
    escritos, ambos intencionais, invisiveis a qualquer verificador por morarem
    em documentos diferentes. Eu tinha proposto duas saidas e NENHUMA foi
    precisa: com o encoder G fora, o D17 ficou livre e o firmware nao se tocou.
    **Uma decisao de INTERFACE dissolveu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
    [cotuca_conector.kicad_sch, cotuca_soquete.kicad_sch]
2026-09-05 O sense dos DPDT sai, e nasce o FUTURO.md para o que se pensou e nao se fez
    O sense e descartado: a DPDT tipo 2 usa os dois polos para o mesmo canal
    (comuns amarrados), logo nao sobra contacto para ler estado. `exc_on`
    continua a ser INTENCAO de software — o firmware acredita no que lhe dizem, e
    isso fica dito em vez de suposto.
    Efeito no ERC do projeto: as isencoes de rotulo isolado passam a UMA, e e o
    `+3V3A` que a Daisy expoe e nos nao usamos. As 25 do inicio do dia estao
    liquidadas.
    E nasce `docs/FUTURO.md`, que NAO e lista de tarefas: e o que se considerou,
    com o custo ja apurado e a razao de nao ser agora. Existe porque a
    alternativa e redescobrir — tres vezes nesta semana se rea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
    [cotuca_soquete.kicad_sch]
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2026-09-05 O painel nasce, e tres defeitos do pre-amp so apareciam na fabrica
    O portao inteiro estava verde e o esquema descrevia uma placa que nao ia
    funcionar. Nada disto se ve no proto, que e ligado a mao.
    O OPA1642 ESTAVA ERRADO DE TRES MANEIRAS AO MESMO TEMPO
    1. pinos 1 e 3 TROCADOS face ao SOIC-8 real: a rede de entrada ia soldada
    ao pino de saida do chip;
    2. `U1A` e `U1B` usavam AMBOS os pinos 1/2/3 — o amplificador B ficava no
    encapsulamento do A;
    3. tres referencias = tres linhas de BOM e tres pegadas para um chip.
    E agora um simbolo de TRES UNIDADES, com a pinagem tirada do `LM2904` da
    biblioteca oficial do KiCad (base de que OPA1602, OPA1612, OPA2134, LM4562 e
    NE5532 herda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
    [Seed3_pinout.csv, cotuca_cerebro.kicad_sch, cotuca_conector.kicad_sch, cotuca_energia.kicad_sch, cotuca_painel.kicad_sch, cotuca_preamp.kicad_sch, cotuca_soquete.kicad_sch]
2026-09-05 A caixa sobe para a raiz, e ganha o portao que um ficheiro de corte precisa
    `caixa/` fica ao lado de `kicad/`: sao os dois artefactos fisicos e merecem o
    mesmo nivel. Dentro vao os geradores das paginas, as 6 paginas cotadas em
    `paginas/`, o corte v1 em nogueira, e as 19 pecas soltas de reserva.
    NESTING NAO E COLISAO DE TEXTO
    O `svg_colisoes` pergunta "o desenho le-se?". Num ficheiro de corte a pergunta
    e outra: duas PECAS sobrepostas sao uma peca perdida e uma chapa gasta, e uma
    peca fora da chapa e um pedido recusado. `tools/nesting.py` v0.1.0 verifica
    tres coisas — dentro da chapa (Ponoko P2, 384x384), sem sobreposicao, e **o
    numero de pecas**, porque uma peca que nao foi emitida nao c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
    [cotuca_caixa_corte_nogueira_6p4.dxf, cotuca_preamp.kicad_sch]
2026-09-05 Os pots estavam no trilho errado, e o aviso de ERC era o sintoma
    O `isolated_pin_label` do `+3V3A` nao era ruido. Era o pino 21 da Daisy com
    rotulo e nenhum consumidor — porque os pots estavam alimentados pelo `+3V3`
    DIGITAL e lidos contra o ANALOGICO.
    A FICHA DO SEED3 DECIDE
    "Both the Digital and Analog +3.3V pins will output the voltage from THEIR
    regulators" -> sao dois reguladores independentes
    "65535 corresponding to +3V3A" -> o fundo de escala do ADC e o analogico
    "the +3V3A signal is provided from the +3V3A pin" -> e a figura seguinte
    chama-se literalmente "4.1 - Potentiometer"
    A diferenca entre os dois reguladores ia INTEIRA para a leitura dos pots — que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
    [cotuca_conector.kicad_sch, cotuca_painel.kicad_sch, cotuca_soquete.kicad_sch]
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2026-09-06 As placas nascem, e a caixa muda de espessura quatro vezes no mesmo dia
    O contorno das duas PCB e os tres eixos que saem pela tampa vinham dos
    desenhos em caixa/paginas/ — uma caixa que nunca foi cortada. Corrigi
    contra o corte em nogueira 6,4; era real, mas outra caixa. Depois contra o
    gerador do acrilico, que esta em 6,0. O material encomendado e de 3,00.
    Quatro fontes, quatro espessuras, e as tres primeiras davam numeros
    plausiveis. Seguir a cota a mao teria perdido as quatro vezes.
    Por isso o conserto nao e a cota: e a placa deixar de depender dela. O
    pcb_contorno.py IMPORTA o gerador da caixa (tem __main__, importa-se sem
    correr nada — e importar nao tem parsing entre a cota e o u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
    [cotuca_cerebro.kicad_pcb, cotuca_painel.kicad_pcb, cotuca_painel.kicad_sch]
2026-09-06 A caixa sai de 3 mm por parametro, e a skill /caixa junta os dois artefactos
    O dB encomendou acrilico transparente de 3,00 e o gerador estava em T=6.0. A
    profundidade do dente E a espessura: cortada a 6 e executada em 3, cada junta
    ficava com 3 mm de folga e cada lingueta 3 mm saliente. Nao era uma caixa
    apertada, era uma caixa que nao fecha.
    cotuca_caixa_corte.py v0.3.0:
    · T e kerf passam por --t/--kerf, e o NOME do ficheiro leva a espessura. Esta
    caixa ja teve quatro espessuras plausiveis; um ficheiro de corte sem
    espessura no nome mede-se tao bem como o certo (cicatriz 15cf);
    · os furos dos calcos passam a ser DERIVADOS da chapa (6 mm da borda) em vez
    de seis cotas fixas. Estavam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
    [cotuca_caixa_corte_acrilico_3p0.dxf]
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2026-09-06 O encaixe passa a ser calculado, e poupa 18% de area
    O dB olhou para o visualizador da Ponoko e viu espaco a sobrar. Tinha razao: o
    encaixe estava escrito a mao — primeiro uma coluna alta, depois tres
    prateleiras — e disposicao escolhida por mim e disposicao que ninguem mediu.
    cotuca_caixa_corte.py v0.4.0: bottom-left-fill com rotacao de 90° e semente
    fixa, dentro do gerador. Medido:
    coordenadas a mao 362,4 x 376,5 = 1364 cm2 · margem 4,5 mm
    bottom-left-fill 375,0 x 299,5 = 1123 cm2 · margem 9,0 mm (82%)
    chao teorico (soma das pecas) = 960 cm2
    Semente fixa, logo repetivel — e reencaixa sozinho quando a espessura muda, que
    e o que as coordenadas a mao nunca fizer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
    [cotuca_caixa_corte_acrilico_3p0.dxf]
2026-09-06 O encaixe apertado PAGA-SE, e a margem de 3 mm era invencao minha
    Fui confirmar o modelo de preco da Ponoko em vez de o supor, e ele corrige-me
    nos dois sentidos.
    CORRIGE-ME A FAVOR do dB: eu tinha dito que, se o material e cobrado por chapa
    inteira, apertar o encaixe nao poupa um centimo. Metade errado. O MATERIAL nao
    muda, mas o FABRICO e cobrado por TEMPO DE MAQUINA, e o exemplo aritmetico que
    eles publicam mostra quatro pecas iguais a custar $14,77 de fabrico espalhadas
    e $4,53 encaixadas, com o material igual. Viagem do laser entre pecas distantes
    e tempo. A intuicao do dB ao olhar para o visualizador estava certa por uma
    razao que eu nao tinha visto.
    CORRIGE-ME CONTRA MIM: o aviso "a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
2026-09-06 A pasta caixa fica com quatro ficheiros, e a omissao mentia ha horas
    O dB pediu para limpar redundancia e ficheiros ultrapassados — era o que estava
    a fazer quando apagou por acidente os gerados. A limpeza descobriu um defeito
    que valia mais que a limpeza.
    O DEFEITO. O gerador da caixa tinha `T = _arg("t", 6.0)`. O kicad/pcb_contorno.py
    IMPORTA esse modulo e nao passa argumentos. Durante todo o trabalho de
    dimensionar as placas, os portoes conferiram-nas contra uma caixa de 6 mm
    enquanto a encomendada e de 3 — e disseram que sim. Diziam "espacador minimo
    15" quando o certo e 9, e "folga 3,50" quando e 6,50.
    Um valor por omissao errado nao da erro, da resposta. E da-a com o mesmo ar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
    [cotuca_caixa_corte_nogueira_6p4.dxf, cotuca_cerebro.kicad_pcb, cotuca_painel.kicad_pcb]
2026-09-06 O encaixe rendeu $1,90, e isso muda onde se projecta para poupar
    O dB leu a cotacao real: reduzir de 1364 para 1123 cm2 — 18% de area — poupou
    $1,90. Nao muito, e o numero corrige uma expectativa minha.
    Eu tinha citado o exemplo do blogue da Ponoko, em que o fabrico de quatro pecas
    cai de $14,77 para $4,53 so por encaixar, e esperava algo dessa ordem. NAO
    generaliza: aquelas eram quatro pecas PEQUENAS e iguais, onde o tempo e
    dominado pela VIAGEM do laser entre elas. Uma caixa sao 19 pecas GRANDES, e ai
    o tempo e dominado pelo CORTE — que tem exactamente o mesmo comprimento antes e
    depois de encaixar, 6,07 m nos dois casos.
    O encaixe move a viagem, nao o corte. Numa caixa de pecas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
2026-09-06 A tampa ganha reforco local, e o furo dele nao tem omissao
    Tres respostas do dB, e a terceira e a que nao se deixa para "cortar e pisar":
    um pe sao ~300 N a meio do vao entre a parede da frente e a nervura, e 3 mm de
    acrilico rajam a partir dos furos de o30, que sao o ponto de tensao. Cortar uma
    e pisar diz se parte no primeiro dia; nao diz se parte a centesima — e isto e
    uma peca de serie.
    Vigesima peca: REFORCO, 193 x 50, colado por baixo da tampa so na faixa dos
    arcade. 6 mm efectivos onde o pe pisa, 3 mm onde os pots e o encoder
    atravessam — que e a razao de a tampa ser de 3 (o PTV09 tem ~7 mm de rosca e
    6 de tampa mais a placa por baixo nao deixam porca). O reforco local respeita
    e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
    [cotuca_caixa_corte_acrilico_3p0.dxf]
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2026-09-06 Os arcade afastam-se ao maximo, e o portao passa a saber a altura das pecas
    Dois pedidos do dB numa passagem.
    ESPACAMENTO. Os tres arcade estavam a 40/100/160 — 60 mm entre eixos e 30 de
    vao entre bordos — e um pe largo aperta dois de uma vez. Passam a ser
    DERIVADOS: afastam-se o maximo que a face permite, deixando ARCADE_MARGEM de
    material entre o bordo do furo e a parede. Da x = 30 · 100 · 170, 70 entre
    eixos e 40 entre bordos. Com tres furos de o30 numa face de 200, e o limite
    geometrico — nao ha mais para dar.
    E fica dito no CAIXA-ACRILICO-MONTAGEM.md que 40 pode nao chegar: a frente de
    um pe calcado anda pelos 70-90 mm e cabe em cima de dois bordos. Se acontecer,
    o que resolve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
    [cotuca_caixa_corte_acrilico_3p0.dxf]
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2026-09-06 O nome do ficheiro de fabrico passa a ser a identidade dele
    O dB apanhou a armadilha desta sessao inteira nos meus proprios ficheiros: a
    caixa COM reforco e a caixa SEM reforco sairam as duas como
    cotuca_caixa_corte_acrilico_3p0.svg. Uma estava encomendada (#1263497) e a
    outra nao, e na pasta eram indistinguiveis — que e exactamente o que a cicatriz
    15cf diz sobre fontes vencidas, agora a acontecer nas saidas.
    Um ficheiro de fabrico nao e codigo: depois de encomendado existe como OBJECTO,
    e o nome e a unica coisa que liga a chapa que chegou ao desenho que a gerou.
    cotuca_caixa_r2_acrilico_3p0_55cf3955.svg
    │ │ │ └── digest do desenho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
    [cotuca_caixa_r2_acrilico_3p0_55cf3955.dxf, cotuca_cerebro.kicad_pcb, cotuca_painel.kicad_pcb]
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2026-09-06 As pecas saem de debaixo dos arcade, a placa ganha marca, e nasce a /pm
    COLOCACAO. As seis pecas altas que ficavam debaixo dos botoes saem
    automaticamente, por troca dentro da propria zona — nao empurradas para fora
    dela, que desfazia a razao pela qual as zonas existem. E automatico de proposito:
    os arcade ja mudaram de sitio uma vez e uma lista de trocas escrita a mao
    envelhecia na primeira delas.
    Tres consertos que a passagem obrigou, cada um por um portao ter apanhado:
    1. O teste era da ORIGEM do footprint, e um header 1x6 tem a origem no pino 1 e
    13,5 mm de corpo. Passa a ser dos PADS RODADOS — teste exacto. O intermedio
    que tentei (um raio unico a volta da origem) era tao co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
    [cotuca_cerebro.kicad_pcb, cotuca_painel.kicad_pcb]
2026-09-06 A marca vai para tras, e o acesso ao USB nao existe
    MARCA. Passa para B.SilkS. A primeira tentativa punha-a em cima do C6 e deu 64
    sobreposicoes de uma vez — a frente esta cheia. Atras nao ha nada, e numa caixa
    de acrilico TRANSPARENTE com a placa na chapa de fundo, o lado que se ve por
    baixo do instrumento e o de tras. Texto em camada de tras leva mirror.
    Sobreposicoes de serigrafia: 68 -> 3.
    ACESSO. O dB perguntou como reprograma a Daisy e o ESP32 com tudo montado.
    Medido:
    U2: USB-C na face x=95,6 · z=16,1 · a 17,9 mm da parede de tras
    recorte que a caixa tem: x=34,0 · z=38,0
    -> 61,6 mm de erro em x, 21,9 em z, e o modulo nem chega a parede
    E o recorte que existe NAO esta liv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
    [cotuca_cerebro.kicad_pcb, cotuca_painel.kicad_pcb]
2026-09-06 As aberturas da parede passam a sair da placa, e nasce a r3
    O dB ainda pode fazer novo pedido, entao a caixa ganha as aberturas de USB em
    vez de se viver sem elas.
    Feito como deve ser: a placa ESCREVE caixa/aberturas.json com as aberturas de
    que precisa (ref, x e z na face, tamanho, e porque), e o gerador da caixa LE-O e
    poe os recortes na parede de tras. Escrever "USB da Daisy em x=95,6" a mao na
    parede era transcrever de um ficheiro para o outro — a familia de erro que este
    projecto ja pagou tres vezes.
    O gerador da caixa recusa-se a escrever se uma abertura pedida sobrepuser um
    recorte ou um furo que a parede ja tem: duas coisas nao passam pelo mesmo
    buraco.
    E ISSO CORRIGE A /pm, que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
    [cotuca_caixa_r3_acrilico_3p0_037a9c30.dxf, cotuca_cerebro.kicad_pcb]
2026-09-06 O footprint do ESP32 nasce, e a pinagem era um problema de FACE
    O dB disse a coisa que resolveu tudo: o diagrama "PIN Definitions" do vendedor
    mostra o lado de BAIXO do modulo, e nao o diz em lado nenhum. Lido como vista de
    cima da o espelho, e o espelho poe o 5V onde estava o GND.
    Isso explica as tres leituras contraditorias da mesma peca: a pesquisa dizia 5V
    a direita, eu li a esquerda, o dB com a peca na mao diz a direita. Duas delas
    eram a mesma, e a minha era a imagem virada.
    Vista de cima e vista de baixo de uma pinagem sao a mesma imagem espelhada, e
    nada DENTRO da imagem denuncia qual e. Um diagrama que nao declara a face nao
    e um facto ambiguo — e meio facto, e a metade qu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
2026-09-06 O ESP32 passa a soquete: simbolo, footprint e esquema
    J10 (header de 5 vias, modulo por fio) -> U3 (ESP32-C3 SuperMini em soquete
    2x8). Verificado no netlist:
    5V -> +5V IO20 -> MIDI_TX (IO20 e o RX do modulo)
    GND -> GND IO21 -> MIDI_RX (IO21 e o TX)
    IO3 -> PONTE_STATUS
    os outros 11 pinos com no_connect — ERC continua em 11, os de reserva do
    FUTURO.md, sem um unico aviso novo.
    IO3 e nao IO8 nem IO9: o diagrama do dB mostra que IO8 e o LED azul de bordo e
    IO9 e o BOOT. A pesquisa nao trazia isso.
    O simbolo e o footprint usam os NOMES DA SERIGRAFIA como numero de pino — "5V",
    "GND", "IO21" — e o mapa no esquema e por NOME, nao por ordem. Indexar por orde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
    [cotuca_soquete.kicad_sch]
2026-09-06 Um digest identifica e nao ordena: o nome ganha data
    O dB perguntou "o que vem depois, 955 ou c30?" e a pergunta nao tem resposta —
    sao digests. Eu tinha escrito que "o digest E a identidade", o que e verdade, e
    depois deixei-o a fazer um trabalho que ele nao sabe fazer: dizer qual e o mais
    recente. O REV ordena, mas bumpa-se a mao, que e precisamente aquilo de que o
    digest existe para nao depender.
    O nome passa a levar quatro coisas, cada uma a responder a uma pergunta:
    cotuca_caixa_20260906_r3_acrilico_3p0_037a9c30.svg
    │ │ │ │ └── QUAL E (digest)
    │ │ │ └────── espessura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
    [cotuca_caixa_20260906_r3_acrilico_3p0_037a9c30.dxf]
2026-09-06 A marca sai de cima dos pads, e o KiCad aberto nao via a biblioteca
    Duas queixas do dB, e so uma era defeito.
    DEFEITO: a marca estava a meio da placa, atras, por cima de 130 pads passantes —
    13 silk_over_copper. Eu tinha raciocinado "atras nao ha serigrafia, logo esta
    vazio". A CAMADA estava vazia; a FACE nao. Cicatriz 15cl: uma camada vazia nao e
    espaco livre, porque o que ocupa uma face sao todas as camadas que aparecem
    nela, e os pads passantes atravessam.
    Consertado por varrimento, nao a olho: procurei a maior faixa livre contra todos
    os pads passantes — 123 x 8 mm a partir de (73, 23) — e a marca foi para la.
    silk_over_copper: 13 -> 0 no cerebro, 4 -> 0 no painel.
    NAO ERA DEFEI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
    [cotuca_cerebro.kicad_pcb, cotuca_painel.kicad_pcb]
2026-09-06 O ESP32 entra na placa, e a caixa ganha a abertura dele
    Tinhas razao nos duplicados e eu media no momento errado. O F8 casa por UUID, e
    neste projecto os esquemas sao GERADOS: cada regeneracao muda todos os UUID, o
    KiCad deixa de reconhecer o que ja la esta e ACRESCENTA uma segunda copia. Nove
    pecas duplicadas, incluindo a Daisy, e 57 violacoes de geometria em curtos que
    nao existem no esquema.
    Nasce kicad/sincroniza_pcb.py v0.2.1, que faz o que o F8 faz e nao tem GUI:
    tira copias a mais, acrescenta o que falta, remove o que sobra, e poe o nome da
    rede em cada pad lido do netlist. Verifica-se antes de gravar — se a placa e o
    esquema nao ficarem com as mesmas refs, recusa.
    E um bug meu la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
    [cotuca_caixa_20260906_r5_acrilico_3p0_0070f4e8.dxf, cotuca_cerebro.kicad_pcb]
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2026-09-06 Cada colisao passa a dizer QUANTO, porque eu reportei 42 micrometros como defeito serio
    O portao acusou um par `V-`/`4` no simbolo do OPA1642 e eu disse ao dB que era
    colisao a serio. Fui medir antes de consertar: **42 MICROMETROS** de
    sobreposicao de caixa, na vertical.
    E ruido do MODELO, nao do desenho. A ferramenta supoe ascendente de 0,75 do
    corpo e a fonte de tracos do KiCad nao tem essa metrica. A prova de que e o
    modelo: os dois pares de alimentacao estao a distancias diferentes no render —
    2,92 contra 1,65 — e a diferenca e EXACTAMENTE 1,27, o corpo da letra. E a
    linha de base a contar para lados opostos, nao um pino mal colocado.
    O gerador esta correcto e simetrico, e fui ver: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
    [svg_colisoes.py]
2026-09-07 O ESP32 volta para tras do Schottky, que eu tinha deixado para tras
    O dB leu o esquema e perguntou onde estava o Schottky. Estava onde devia, e o
    modulo e que nao. Medido na netlist:
    D2 (1N5819): pino 1 -> +5V pino 2 -> Net-(C3-Pad1)
    C3 100u + C4 100n: -> Net-(C3-Pad1) o par local, ja existia
    J4 "a ponte ESP32": -> Net-(C3-Pad1)
    U3 (o soquete que eu pus): 5V -> +5V DIRECTO
    Ao trocar o J10 (header por fio) pelo U3 (soquete) liguei o modulo ao trilho
    CRU. O diodo existe para que o USB da ponte, ao ser ligado para reprogramar,
    NAO realimente o trilho de 5 V da placa toda — defeito ja pago na bancada. E
    deixei-o para tras no mesmo dia em que abrimos u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
    [cotuca_cerebro.kicad_pcb, cotuca_energia.kicad_sch, cotuca_soquete.kicad_sch]
2026-09-07 Passo 1 de 4: todo trilho passa a ter par local
    As quatro pecas que faltavam, com as tres correccoes do dB aceites:
    cerebro C15 100n no +5V, colado ao pino 39 da Daisy
    C16 100n no +3V3A, colado ao J14
    painel C3 100u + C4 100n no +5V, JUNTO AOS MOSFET — a carga que comuta
    nao e o OLED (tem os dele), sao os LED dos arcade a 90 mA por
    150 mm de fita
    C5 100n no +3V3A, colado ao J1
    Estado dos trilhos depois, medido na netlist:
    cerebro +15V C1 2200u + C2 100n
    +5V C15 100n
    +5V_PONTE C3 100u + C4 100n (ja existiam, atras do D2)
    +3V3A C16 100n
    painel +5V C3 100u + C4 100n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
    [cotuca_conector.kicad_sch, cotuca_painel.kicad_sch, cotuca_soquete.kicad_sch]
2026-09-07 Passo 2 de 4: as placas nascem outra vez, do esquema
    --zero no sincronizador: apaga todos os footprints e repoe-os da netlist. Existe
    porque um F8 falhado deixa a placa num estado que ninguem audita, e porque neste
    projecto repor nao custa nada — a colocacao inteira vive no pcb_contorno.
    Dois defeitos meus a caminho, os dois apanhados por medicao:
    1. Apaguei as duas placas ANTES de ter provado o caminho de volta: o
    sincronizador so conhecia a biblioteca do projecto e nao a instalada com o
    KiCad. Ficaram vazias e sem forma de encher. Ordem errada — o restauro
    prova-se antes de o destrutivo correr, nao depois.
    2. O .kicad_mod traz a sua propria Reference (REF**) e Value. Eu acr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
    [cotuca_cerebro.kicad_pcb, cotuca_painel.kicad_pcb]
2026-09-07 Passo 3 de 4: dois planos de cobre, duas terras, uma ponte
    A P3 da revisao de terra e explicita: AGND e GND juntos em mais de um sitio
    formam anel, e a fraccao da corrente que escolhe o caminho de dentro passa pela
    referencia do codec. Entao o plano de GND PARA onde a ilha comeca, em vez de
    varrer a placa por baixo do pre-amp.
    cerebro GND em F.Cu e B.Cu, a placa toda
    AGND em F.Cu e B.Cu, ilha x 22..75, y 30..120, PRIORIDADE MAIOR
    painel GND em F.Cu e B.Cu
    A prioridade maior na ilha nao e detalhe: sem ela o GND enchia primeiro e a
    ilha ficava sem cobre.
    Um plano de GND desenhado ANTES da P3 teria criado a segunda ponte com ar de
    melhoria — mais cobre, menos impedanc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
    [cotuca_cerebro.kicad_pcb, cotuca_painel.kicad_pcb]
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2026-09-07 A serigrafia do cerebro sai de cima dos pads
    O dB fechou o KiCad e correu o arruma_silk. Verificado no ficheiro, nao no
    relato:
    ligacoes por rotear 104 -> 104
    segmentos de pista 0 (ainda nao ha roteamento)
    As 27 referencias que ficaram no deslocamento original NAO sao sobras: o script
    so mexe nas que colidem, e essas ja estavam livres onde nasceram. Ferramenta que
    mexe no que esta bem faz trabalho a mais e diff a mais.
    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
    [cotuca_cerebro.kicad_pcb]
2026-09-07 roteia: as pistas faceis, e so essas — 31 das 102
    O dB perguntou se o cowork podia rotear. Nao e o cowork que muda isso: qualquer
    agente esbarra na mesma parede, o kicad-cli nao exporta DSN e nao ha
    autoroteador para chamar. Mas eu tinha dito que rotear por script era 'lento e
    fragil', e isso era pessimismo a mais — depois de ver o formato do segmento,
    uma boa parte faz-se.
    NAO E UM AUTOROTEADOR. Nao procura caminho: prova tres percursos triviais — a
    direito, em L pelo horizontal, em L pelo vertical — e se nenhum estiver livre
    DEIXA A LIGACAO PARA A PESSOA. Um roteador que insiste faz caminhos que ninguem
    quereria e que depois ninguem percebe.
    E um bug meu na primeira versao, apanh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
2026-09-07 Correccao: o kicad-cli SABE encher zonas, e os 35 eram isso
    No commit anterior escrevi que o kicad-cli nao sabia encher zonas e que por isso
    eu nao podia verificar os 35 clearance contra elas. Errado. O --help que corri
    na mesma linha de comandos tem --refill-zones, e tem-no desde sempre.
    Corrido com ele, na mesma copia:
    por ligar 71
    GEOMETRIA 0
    restantes silk apenas
    Os 35 eram todos o preenchimento velho, como eu suspeitava — mas agora esta
    PROVADO em vez de suposto, que e a diferenca que interessa.
    E a licao e a terceira do mesmo feitio hoje: afirmei uma limitacao da ferramenta
    sem correr o --help. As outras duas foram 'nao ha autoroteador' (verdade, mas a
    conclusao que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
2026-09-07 33 pistas por script, e o que sobra e o que precisa de olho
    Corridas na placa viva, com o KiCad fechado e copia de seguranca antes.
    por ligar 104 -> 71
    AGND 6 -> 1
    GND 0 (o plano fez as 23)
    As zonas foram cheias e gravadas com --refill-zones --save-board, entao o que o
    DRC diz agora e sobre o cobre que existe de facto, nao sobre um preenchimento
    velho.
    O roteador nao procurou caminho nenhum: fez as que davam a direito ou em L sem
    desviar de nada, e deixou 71. Essas sao as que exigem contornar peca, escolher
    por onde passar, ou respeitar a regra P5 — e sao justamente as que valem o olho
    do dB. O que ele perdeu foi a parte chata: ligacoes curta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
    [cotuca_cerebro.kicad_pcb]
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2026-09-07 O plano desce para B.Cu, e o roteador deixa de ter o que cortar
    A tentativa anterior perguntou como ensinar o roteador a ver zonas. A
    pergunta estava errada: o cobre estava nas DUAS camadas, e um dois-lados
    so tem duas. Nao sobrava camada para sinal, portanto toda a pista
    atravessava um plano — e atravessar um plano e corta-lo.
    O arranjo passa a ser o normal de um dois-lados: plano solido em B.Cu,
    sinal em F.Cu, e uma via em cada pad SMD de terra a descer ao plano.
    Meia sessao de roteador esperto trocada por vinte linhas de desenho
    certo.
    Tres defeitos meus pelo caminho, todos apanhados a medir:
    - a via ficou ao lado do pad e nao ligada a ele: 19 `via_dangling`,
    porque cobre adjacent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
    [cotuca_cerebro.kicad_pcb, cotuca_painel.kicad_pcb]
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2026-09-07 A cadeia inteira em sete minutos, e as placas roteadas de raiz
    O portao ja existia e as placas ja passavam nele em geometria; o que
    faltava era a cadeia ser rapida o suficiente para se usar. Uma passada
    do roteador levava treze minutos, quase toda a interrogar redes
    inocentes: cada teste da retraccao e um DRC completo com enchimento de
    zonas, e eu testava as 27 redes que tinham tocado em B.Cu.
    O conserto e geometrico e de graca. Uma travessia so pode orfanar um pad
    do plano se passar tao perto dele que ja nao cabe la folga + cobre +
    folga. Isso mede-se sem DRC nenhum, corta de 27 candidatas para 5, acha
    as MESMAS duas culpadas, e a passada cai para 55 segundos. O DRC continua
    a ser quem dec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
    [cotuca_cerebro.kicad_pcb, cotuca_painel.kicad_pcb]
2026-09-07 A passada apertada, e o que fechava os conectores nao era espaco
    O roteador tinha parado em 22 no cerebro e 10 no painel, e a minha
    explicacao era congestionamento. Fui medir, e era o contrario:
    OLED_CLK em (40.0, 22.5) · 0 pistas a menos de 8 mm
    OLED_DIN em (42.5, 22.5) · 0 pistas a menos de 8 mm
    Zero. E as falhas concentravam-se em J14 (9), na Daisy (11) e no J1 do
    painel (8) — todas pecas de duas filas de pinos.
    O que as fecha e aritmetica. Num header de 2,54 com pads de 1,70 o vao
    entre dois pads e 0,840 mm, e o roteador exigia 0,125 + 0,35 + 0,178 =
    0,950 de cada lado. Ele nao conseguia SAIR DE ENTRE OS PINOS de conector
    nenhum, em placa nenhuma. Um sitio sem nada a volta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
    [cotuca_cerebro.kicad_pcb, cotuca_painel.kicad_pcb]
2026-09-07 O conector respira, e leva o pre-amp dois milimetros consigo
    Os cinco sinais do OLED falhavam nas duas placas com ZERO pistas num raio
    de 8 mm a volta deles. Nao era congestionamento.
    O J14 estava em y=25, fila da frente em y=22,5, bordo da placa em y=20:
    1,05 mm de canal entre os pads e o bordo, para treze sinais. Sair pelo
    outro lado obrigava a passar ENTRE dois pads do conector, e o vao de um
    header de 2,54 com pads de 1,70 e 0,840 quando a pista precisa de 0,950.
    Um conector de duas filas encostado a um bordo tem metade dos pinos, e
    nada no desenho o denuncia.
    Descer o J14 4 mm abre o canal para 5,05 — mas a essa altura o patio dele
    toca no D11 e no J5, a primeira fila do pre-amp. Do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
    [cotuca_cerebro.kicad_pcb, cotuca_painel.kicad_pcb]
2026-09-07 O que faltava nao era o caminho, era o primeiro milimetro
    Sobravam 18 ligacoes no cerebro. Fui ver onde acabavam: TODAS terminavam
    num pad de passo fino — os pinos do U1, um SOIC de 1,27, e os do cabo
    plano. As pistas chegavam a cinco milimetros do pad e paravam.
    Nao era falta de espaco. E que o primeiro milimetro a sair de um pad de
    passo fino nao cabe na folga generosa que serve para o resto do percurso,
    e essa folga era minha: 0,35 mm contra os 0,20 que a placa manda.
    Ja sabia que apertar a folga em toda a parte mede-se PIOR (23 -> 34): o
    roteador guloso enfia pistas cedo e fecha corredores. A saida era
    aperta-la so nos primeiros 3 mm a volta das duas pontas — ali nao ha
    corredor a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
    [cotuca_cerebro.kicad_pcb, cotuca_painel.kicad_pcb]
2026-09-08 Arrancar e refazer: a capacidade que faltava, e nao esta pronta
    Depois de o roteador parar em 12, testei tudo o que era afinacao: malha,
    folga, tecto de nos, ordem de ataque, e um corredor achado numa malha
    grossa (busca em dois niveis). Nenhuma rendeu mais de duas ligacoes e
    TRES renderam menos. Todas partiam do mesmo pressuposto — que existe
    caminho livre e falta acha-lo. Para as ultimas nao existe.
    O que faltava e o que um roteador a serio faz: ARRANCA o que estorva,
    passa, e volta a rotear o que arrancou, que agora da a volta porque tinha
    alternativas e a outra nao. Numa passada isolada: 15 por fazer -> 8.
    Na cadeia inteira mediu 14 contra 12. E uma corrida entregou a placa com
    um PL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
    [cotuca_cerebro.kicad_pcb, cotuca_painel.kicad_pcb]
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2026-09-08 O carimbo da lista avisa sobre a PLACA, e le o git sem cortar letras
    Duas coisas erradas no carimbo. O aviso de arvore suja olhava o
    repositorio inteiro e disparava por causa de um ficheiro da caixa e de um
    SVG solto — nada que mudasse a placa descrita. Um aviso que dispara por
    coisas irrelevantes deixa de ser lido, e no dia em que disparar a serio
    ja ninguem lhe liga. Passa a olhar so o .kicad_pcb da placa e os scripts.
    E cortava o prefixo do `--porcelain` por posicao fixa. As duas colunas de
    estado nao ocupam a mesma largura conforme o ficheiro esteja no indice ou
    so na arvore, e o corte comeu a primeira letra de um caminho — "ocs/..."
    em vez de "docs/...". Um caminho com uma letra a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
2026-09-08 O auto-teste contava o total e deixava um estrago mascarar o outro
    A regra de aceitacao do roteador media quantas ligacoes faltam em cada
    REDE, antes e depois, e nenhuma podia piorar. Substituiu uma lista de
    sintomas precisamente para nao haver sintoma novo que passasse por nao
    estar na lista. Passou um:
    antes GND = 1 (um pad solto)
    depois GND = 1 (o pad ligou-se, e o PLANO PARTIU-SE)
    piorou -> NADA
    Contar por rede protege contra a rede errada; nao protege contra a
    ESPECIE errada dentro da mesma rede. Um plano partido nao e "mais uma
    ligacao por fazer" que se compensa com outra qualquer. A chave passa a
    ser (rede, especie).
    ⚠️ E e a mesma familia da assinatura (tipo, red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
    [cotuca_cerebro.kicad_pcb, cotuca_painel.kicad_pcb]
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2026-09-08 O FreeRouting entra, e roteia todos os sinais em 35 segundos
    O dB perguntou se alguem ja teria feito isto. A primeira resposta da
    busca era uma skill com /autoroute por FreeRouting — a coisa que eu tinha
    declarado impossivel tres vezes (15de). A pergunta "isto ja foi feito?" e
    uma verificacao, e nao so uma poupanca de trabalho.
    Na mesma placa, de raiz:
    o meu roteador 103 -> 12 por ligar · ~9 min as duas placas
    FreeRouting 122 -> 8 por ligar · 35 SEGUNDOS as duas
    E as que sobram ao FreeRouting sao TODAS ligacoes ao plano, nao sinal:
    ele fecha todos os sinais. Faz rip-up e shove a serio, que o meu faz mal.
    cerebro 8 por ligar · geometria 0 · planos inteiros
    paine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
    [cotuca_cerebro.kicad_pcb, cotuca_painel.kicad_pcb]
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2026-09-08 Os MPNs migram para o gerador, e a lista a mao pode morrer
    Pedi-me para marcar tres MPNs como "por decidir". Fui migra-los e JA
    ESTAVAM CORRIGIDOS no gerador ha tres dias — quem guardava os errados era
    a lista a mao. Nao havia nada para marcar; havia razoes por escrever.
    Um MPN certo SEM a razao ao lado e um MPN que a proxima leitura troca
    pelo obvio. As tres razoes passaram para junto das entradas:
    2920L3*30*/24MR o /300 nao existe; a 24 V o que ha e o 3,3 A
    EC11E15244G1 o PEC11R tem pinos a 5,0 e o footprint e do Alps a 2,5
    PTV09A-4020*S* S e eixo estriado; o F e liso, e a nota pedia estriado
    DUAS PECAS REAIS QUE NAO ESTAVAM ORCADAS EM LADO NENHUM:
    O gerador tem um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
    [bom_completa.py]
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2026-09-08 Serigrafia sem sobreposicoes, e o portao deixa de decidir por ruido
    O dB pediu para a /kicad e a /design-review evitarem texto sobreposto na
    serigrafia. Fui medir e encontrei duas coisas.
    A PRIMEIRA, que era o pedido. O `arruma_silk` afastava as referencias dos
    PADS e mais nada — e isso nao arruma serigrafia, muda o defeito de sitio:
    o teste conhecia overlap over_copper edge
    so pads 18 6 1
    + serigrafia 5 12 ⬆ 1
    + pistas, sem isentar os
    proprios pads 5 1 1
    + contorno da placa 6 1 0
    Cada linha consertava uma coluna e estragava a seguin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
    [cotuca_cerebro.kicad_pcb, cotuca_painel.kicad_pcb, cotuca_soquete.kicad_sch]
2026-09-08 O reparo aprende a agarrar-se ao vizinho, e mesmo assim nao chega
    Acrescentei ao reparo de terra uma segunda estrategia: quando nao ha
    espaco para uma via, ligar o pad orfao ao pad de terra VIZINHO do mesmo
    conector, que ja chega ao plano. A pista corre entre os pads, onde o
    passo de 2,54 deixa folga, e nao precisa de cobre aberto.
    Nao resolveu, e a razao e dura: a FILA DE TERRA INTEIRA do J14 e do J1
    esta orfa. Nao ha vizinho ligado a que agarrar — o plano nao chega a
    nenhum deles. Amarrar dois orfaos um ao outro da uma ilha de dois em vez
    de um, e o DRC conta na mesma; a guarda impede isso e por isso devolve
    "sem vizinho ligado" em vez de fingir que resolveu.
    Corri tres passadas a ver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
    [cotuca_cerebro.kicad_pcb, cotuca_painel.kicad_pcb]
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2026-09-08 O plano sai do DSN, e a terra passa de pressuposto a trabalho
    Vinte e cinco ligacoes de terra por fazer, e nenhuma das minhas
    ferramentas as fechava. O FreeRouting dizia 5; o KiCad dizia 15. Passei
    horas a construir reparacoes — vias, cotos, vizinhos, cascatas — a tratar
    o sintoma.
    A causa era uma linha no DSN. O `pcbnew` exporta os planos como
    `(plane GND (polygon ...))` e o FreeRouting RESPEITA-OS: considera um pad
    ligado se ele cair dentro do poligono, e nao lhe roteia nada. O KiCad so
    o considera ligado se o cobre ENCHIDO lhe chegar — e a volta de um
    conector cercado por pistas nao chega. Cada um achava que a terra era
    responsabilidade do outro, e nenhum mentiu.
    com plano no D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
    [cotuca_cerebro.kicad_pcb, cotuca_painel.kicad_pcb]
2026-09-08 100% autonomo: um comando, de placa limpa a pacote que o portao aceita
    cerebro 147 ligacoes -> 0 por fazer · geometria 0
    painel 53 ligacoes -> 0 por fazer · geometria 0
    PRONTO para a JLCPCB.
    NENHUM DESTES PASSOS SOZINHO FECHA A PLACA. Juntos, e nesta ordem:
    1 FreeRouting de raiz com o plano FORA do DSN — a terra passa de
    pressuposto a trabalho (15dr)
    2 retrair o que o DRC acusa, pela POSICAO do item e nao pelo nome da
    rede: no GND isso seriam centenas de segmentos, e a placa foi de 2
    por fazer para 28 quando tentei assim
    3 limpar os pendurados — tirar um segmento deixa orfao o que estava
    agarrado a ele, e troca-se um clearance por um via_dangling
    4 Free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
    [cotuca_cerebro.kicad_pcb, cotuca_painel.kicad_pcb]
2026-09-08 O MPN passa a viver nas folhas, e o portao confere que la esta
    Os numeros de peca viviam numa tabela dentro do bom_completa. Funcionava,
    e escondia que O ESQUEMA NAO SABIA DELES. A revisao de fora leu as folhas
    e disse a verdade: "0/36 parts have MPNs — board is not pre-fab ready".
    Zero de 84. E tem razao: quem manda ficheiros para uma fabrica que MONTA
    precisa que o MPN esteja no que se exporta, e o que se exporta sai das
    folhas. E a §12w outra vez — uma regra que vive dentro de uma ferramenta
    so vale para essa ferramenta — agora no numero de peca em vez da largura
    de pista. Mesma licao, mesma semana, dois campos, e nao a reconheci ate
    uma ferramenta de fora ma apontar.
    ⚠️ DUAS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
    [cotuca_cerebro.kicad_pcb, cotuca_conector.kicad_sch, cotuca_energia.kicad_sch, cotuca_painel.kicad_pcb, cotuca_painel.kicad_sch, cotuca_preamp.kicad_sch, cotuca_soquete.kicad_sch]
2026-09-08 Pontos de teste: onze no cerebro, cinco no painel, e nao sessenta e nove
    A revisao de fora dizia "0/69 nets (0%)". A resposta preguicosa e por um
    em cada rede — numa placa de 180x100, com a caixa fechada por cima.
    O criterio nao e a cobertura: e O QUE SE MEDE QUANDO ELA NAO FUNCIONA. Ha
    tensao, ha referencia, ha sinal. Cada um leva a razao escrita ao lado,
    porque um ponto de teste sem razao e um furo que ninguem sabe para que
    serve.
    V_TRILHO_A2 +15V V+PRE VBIAS +5V +5V_PONTE +3V3A GND AGND LINHA_L/R
    painel: +5V +3V3A GND POT_L POT_R
    ⚠️ O AGND TEM O SEU. Sem um ponto em cada terra nao se mede a ponte: a
    diferenca entre elas com o instrumento a tocar e o unico numero que diz
    se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
    [cotuca_cerebro.kicad_pcb, cotuca_painel.kicad_pcb, cotuca_painel.kicad_sch, cotuca_soquete.kicad_sch]
2026-09-08 As fichas entram no repo, e o MPN passa a ser um numero de peca
    O campo `MPN` das folhas tinha descricoes: carimbei a coluna de descricao
    da BOM, e a revisao de fora disse "50/50 parts have MPNs" porque so
    verifica que o campo nao esta vazio. Os 99 % eram frases como
    `header 1x4 2,54` a passar por numeros de peca, e so apareceu quando uma
    ferramenta tentou USAR o valor e foi procurar isso a LCSC.
    O MPN passa a campo proprio, e vazio onde a peca e genuinamente generica.
    A cobertura honesta e 36/84 (43 %) — o mesmo desenho, com o numero certo
    em vez do bonito.
    As fichas entram porque a regra da casa e "nenhum facto de hardware sem
    fonte citada", e a ficha E a fonte. Um repo que exige citac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
    [cotuca_conector.kicad_sch, cotuca_energia.kicad_sch, cotuca_painel.kicad_sch, cotuca_preamp.kicad_sch, cotuca_soquete.kicad_sch]
2026-09-08 O codigo LCSC entra na BOM, e o CPL passa a concordar com ela
    O MPN e para humanos; o `Cxxxxx` e o que a maquina le, e a JLC nao monta uma
    linha sem ele — tenha MPN ou nao. As 46 linhas SMD passam a ter codigo: 26 de
    26 grupos resolvidos, cada um com a descricao que o justifica gravada.
    ⚠️ A busca do distribuidor devolve um LED em primeiro lugar para `4.7MΩ 0805`
    (C84256, 615 nm, 195 mcd). `0Ω 0805` devolve 1 kΩ. Por isso a ordem nao decide
    nada: pedem-se cinquenta e exige-se que a descricao bata em valor,
    encapsulamento, classe, tolerancia e dielectrico. Um falso negativo por
    comparar `22e-12` com `22 * 1e-12` por `==` saia como "0 de 35 passam", que se
    le como facto do catalogo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
    [cotuca_cerebro.kicad_pcb, cotuca_painel.kicad_sch, cotuca_soquete.kicad_sch]
2026-09-08 Dois MOSFET para tres botoes esta certo: o buzios nao tem LED
    O painel tem tres arcades — dois AZUIS de freeze e um BRANCO dos buzios — e
    so `Q1`/`Q2`. Quem conta os MOSFET e sabe dos tres botoes conclui que falta um
    terceiro, e concluiu: custou uma volta inteira a investigar uma via de IDC que
    nao e precisa.
    O buzios e um botao normal. Sabe-se que esta ligado pelo DISPLAY, nao por luz
    no botao. E o caminho dele esta completo dos dois lados ha muito: painel `J5`
    -> IDC via 19 -> Daisy pino 33.
    O `FUTURO.md` chamava-lhe "terceiro botao arcade" a coisa que falta, e o
    terceiro JA EXISTE — o que falta e um quarto. Corrigido, com o inventario das
    oito terras e do que cada uma guarda: relo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
2026-09-08 Os geradores param de minar uuid: regenerar passa a dar o mesmo ficheiro
    Acrescentar um COMENTARIO ao gerador e regenerar produzia 229 insercoes e 229
    remocoes com ZERO linhas nao-uuid. A folha saia electricamente identica e o
    diff era ruido puro.
    O que se perde nisso nao e elegancia, e a REVISAO: uma mudanca real de duas
    linhas desaparece dentro do churn, e um diff que ninguem consegue ler nao e
    revisto. Revisao que nao acontece e revisao que aprova tudo sao a mesma coisa —
    e a §8 desta casa promete que o gerado e "reproduzivel, diffavel e corrigivel
    na fonte".
    A chave e SEMANTICA, nao um contador: `uuid5(NS, "sym:R13")`,
    `"fio:x1,y1-x2,y2"`, `"rot:GND:x,y,ang"`. Um contador tambem ser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
    [cotuca_painel.kicad_sch, cotuca_soquete.kicad_sch]
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2026-09-08 O roteiro deixa de listar as vias, e o terceiro gerador tambem deixa de minar uuid
    O §5 listava as 26 vias a mao e a lista envelheceu: o pino 19 deixou de ser
    terra a 05/09 e a tabela continuou a dizer nove terras e o 19 livre. Dali
    concluiu-se DUAS vezes que havia uma via disponivel que nao havia. A edicao de
    05/09 ate deixou a marca a vista — a linha do pino 6 tinha seis colunas numa
    tabela de quatro, com o 20 repetido — e ninguem reparou, porque uma tabela a
    mao nao tem quem a confira. E a classe 7 da skill `audit`.
    O §5 passa a apontar para o `VIAS` do `gera_conector.py` e para o
    `contrato_idc.py`. ⚠️ E o cabecalho do gerador dizia "a pinagem sai do ROTEIRO
    §5": ficariam os d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
    [cotuca_conector.kicad_sch]
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2026-09-08 A serigrafia: zero texto sobre texto, e quatro defeitos na ferramenta que a arruma
    Corri a design-review na serigrafia com DOIS verificadores. Discordaram — o
    `svg_colisoes` dizia 0 texto×texto e o DRC do KiCad dizia 9 `silk_overlap` — e
    ir medir a discordancia foi o que destapou o resto.
    Os 9 eram a referencia sobre o contorno da PROPRIA peca, que numa placa e
    convencao e nao defeito (ao contrario do esquematico, onde inverte). Mas o
    `arruma_silk` tinha quatro defeitos, todos da mesma familia: a conta certa
    existia no ficheiro e nao era aplicada onde devia.
    ⚠️ O campo `Reference` nao rodava com a peca. Os pads ja usavam a rotacao tres
    linhas acima; o campo fazia `fx+dx, fy+dy`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
    [cotuca_cerebro.kicad_pcb, cotuca_painel.kicad_pcb]
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2026-09-08 O designador aponta para a peca dele — e isso passa a ser medido no portao
    O dB mandou o render: "os textos ainda estao bem desarranjados". E estavam, de
    uma maneira que NENHUMA das minhas medicoes via — o portao dizia `texto×texto:
    0` e o DRC dizia 6 `silk_overlap`, e as referencias estavam espalhadas pela
    borda a apontar para as pecas erradas.
    ⚠️ A CAUSA ESTAVA A MONTANTE E ERA UMA CONSTANTE. O `sincroniza_pcb` criava
    toda peca nova com a referencia a `-11.5` mm: igual para um condensador de
    11 mm e para um ponto de teste de 1,5 mm — 23 das 70 do cerebro. E o
    `arruma_silk` nao lhes tocava, porque so mexia no que COLIDIA, e a 11,5 mm nao
    se colide com nada. Duas ferramentas, cad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
    [cotuca_cerebro.kicad_pcb, cotuca_painel.kicad_pcb]
2026-09-08 A ferramenta passa a ser julgada pelo portao, e nao pela regua dela
    Fui medir a camada que o dB estava a olhar — a do editor, com tudo — e e outra
    coisa: F.Silkscreen 6 colisoes e 0 texto×texto; F.Fab 114 e 29. Eu media a
    camada que sai da fabrica e ele olhava a camada em que trabalha. Dos 336 textos,
    210 vivem na F.Fab, que nao imprime — e dai vem cada par (`C14` duas vezes: a
    referencia na serigrafia e o `${REFERENCE}` na Fab).
    Arrumar a Fab com a mesma ferramenta, medido: cerebro 114->105 e 29->16 (melhor),
    painel 51->68 e 10->13 (pior), e a SERIGRAFIA do painel 6->7 com texto×texto
    0->1 (pior, e e impressa). Duas de quatro pioraram, uma na camada que se
    fabrica. Revertido; fica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
    [cotuca_cerebro.kicad_pcb]
2026-09-08 A F.Fab arrumada, e cada passagem julgada por si
    A Fab e a camada que se le no editor — 210 dos 336 textos vivem la — e tinha
    114 colisoes contra 6 da serigrafia. Arrumada, com duas coisas que faltavam.
    ⚠️ A Fab tem CONTORNOS proprios. A primeira versao so evitava outros textos
    naquela camada, com o argumento de que "a Fab nao e impressa, pads e pistas nao
    custam nada". Verdade — mas ela tem os desenhos de peca dela, e um `Value` por
    cima de um deles conta como colisao no portao tal como na serigrafia. "Nao e
    impresso" nao quer dizer "nao tem obstaculos": quer dizer que os obstaculos sao
    outros, e outros nao e nenhum. Sem isso, arrumar empurrava os valores para cima
    dos contornos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
    [cotuca_cerebro.kicad_pcb, cotuca_painel.kicad_pcb]
2026-09-08 Os nomes das redes nos pontos de teste — feito no painel, medido como impossivel no cerebro
    A placa impressa dizia `TP1`...`TP11` e mais nada: os nomes das redes viviam no
    campo `Value`, que esta na F.Fab e nao se imprime. Quem chega a bancada com o
    osciloscopio ve `TP7` e nao sabe se e `+3V3A` ou `AGND`.
    ⚠️ O nome sai do `(net ...)` do PAD, nunca do `Value`. O `Value` e uma afirmacao
    sobre a rede; o pad E a rede. Se o ponto for movido para outro sitio do cobre, o
    `Value` continua a dizer o que dizia — e a serigrafia passaria a mentir,
    impressa, em tinta, na peca fisica. Lendo o pad, o rotulo ou esta certo ou nao
    existe.
    ⚠️ E a primeira coisa foi perceber que a pergunta estava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
    [cotuca_painel.kicad_pcb]
2026-09-08 A legenda dos pontos de teste no cerebro, e custou zero colisoes
    O que nao cabia eram onze ROTULOS espalhados; o que cabe e um BLOCO. Sao a
    mesma informacao e ocupam areas diferentes: onze textos tem de achar onze
    buracos, cada um ao lado do seu ponto, numa faixa a 4 mm de passo — o bloco
    precisa de UM, e escolhe entre 487.
    legenda de 12 linhas em (108, 36) · 14 mm da fila
    gravado · abre ✓ · texto×texto 0->0 · total 6->6
    Doze linhas novas na serigrafia e o numero de colisoes nao mexeu.
    ⚠️ E a referencia FICA na serigrafia, ao contrario do painel. La, `TP7` impresso
    nao servia para nada porque o nome da rede estava ao lado. Aqui ela E o que liga
    o ponto a linha da legenda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
    [cotuca_cerebro.kicad_pcb]
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2026-09-09 WIP — os seis criticos da varredura, cerebro pronto, painel com 3 por rotear
    ⚠️ GERBER TRAVADO. O `para_fabrica` recusa o painel e nada foi encomendado.
    Commit intermedio a pedido do dB: 26 ficheiros a meio de uma operacao e o
    estado que se perde.
    OS SEIS, cada um com prova medida e no COBRE (nao so no esquema):
    C1 pre-amp o simbolo `OPA1642` desenhava o `-` em baixo e o `+` em cima, e
    os fios tinham sido desenhados para o contrario: o sinal entrava
    pela INVERSORA e a realimentacao pela nao-inversora —
    realimentacao positiva, o amp trava e nao passa som, nos dois
    canais. Conserto na POSICAO e nao no numero (o pino 2 do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
    [cotuca_cerebro.kicad_pcb, cotuca_energia.kicad_sch, cotuca_painel.kicad_pcb, cotuca_painel.kicad_sch, cotuca_preamp.kicad_sch, cotuca_soquete.kicad_sch]
2026-09-09 O passo da malha nunca dividiu 1,27, e o courtyard nunca foi medido contra o bordo
    ⚠️ GERBER CONTINUA TRAVADO. O portao recusa o painel: J1 fora do contorno,
    tres ligacoes por rotear, e a serigrafia por arrumar. Nada foi encomendado.
    DOIS ACHADOS ESTRUTURAIS, e os dois sao "a ferramenta respondeu a pergunta
    que lhe fizeram, e a pergunta era mais estreita do que o que eu li na
    resposta".
    1. `roteia.py` v1.18.0 — PASSO = 0.25 nao divide 1,27.
    A saida de um pad da fila DE TRAS de um header de 2,54 passa pelo meio exacto
    do vao entre dois pads da frente. Com pads de 1,70 e folga 0,22, a tolerancia
    ai e 0,075 mm, e o meio do vao esta a 1,27 do centro do pad. Uma malha de 0,25
    nao tem no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
    [cotuca_painel.kicad_pcb]
2026-09-09 A ordem dos pinos do OLED estava errada nas sete posicoes, e nada a via
    ⚠️ ISTO ERA HARDWARE MORTO. O `J2` do painel ligava aos 7 pinos do modulo
    Waveshare 2.42" pela ordem `GND +5V CLK DIN CS DC RST`, escrita a 05/09 sem
    ficha porque o modulo nao estava em mao.
    Com um cabo PicoBlade DIRECTO (1-1, o que qualquer pessoa compra) isso punha
    **os nossos +5 V no pino DC do modulo** e o nosso RST no VCC dele. Com um cabo
    invertido punha os +5 V no GND — curto do trilho. Nenhuma das duas orientacoes
    de cabo funcionava, e CLK/DIN ficavam trocados nas duas.
    FONTE: pagina do produto Waveshare "2.42inch OLED Display Module, 128x64,
    SPI/I2C, White", seccao "Control Interface": 1 RST · 2 DC · 3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
    [cotuca_painel.kicad_pcb, cotuca_painel.kicad_sch]
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2026-09-09 ppc/002 rev B: D2→SS14, silk H1-H4 escondido, cadeia §3 ligada (rev B NAO fechada)
    Trabalho seguro, verificavel por inspecao — NAO ha KiCad 10 neste ambiente,
    logo NAO se correu DRC/ERC/ratsnest/enchimento de zona nem se exportou pacote.
    - Task 1 (§1): cerebro D2 Value 1N5819 -> SS14 (alinha PCB ao esquema, que ja
    dizia SS14). Unica ocorrencia de 1N5819 no ficheiro.
    - Task 2 (§1): esconde a referencia de silk dos furos H1-H4 (hide yes) — 4 refs,
    e so essas. E o conserto entra na FONTE: poe_furos.py passa a emitir (hide yes)
    (v0.1.0 -> v0.2.0), senao a proxima regeneracao apagava a edicao em silencio.
    - Task 3 (§3): faz_placa.py (v0.13.1 -> v0.14.0) ganha regenera(): geradore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
    [cotuca_cerebro.kicad_pcb]
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2026-09-10 skill(pcb): red-team fixes — portão de ordem, robustez do manifesto, numeração
    Revisão adversarial da skill pcb; corrigidos os achados reais:
    - 🟠 estágio 4: «só então as vias» era só o título — agora é portão de
    entrada duro (não se encosta cobre antes de o portão do estágio 3 fechar),
    simétrico ao STOP gate do sourcing.
    - 🟠 manifesto_fontes.py v0.2.0→v0.3.0: JSON malformado e lista-de-não-objectos
    crashavam com traceback; agora saem com SystemExit limpo. CSV inválido idem.
    (vazio/colunas-em-falta já falhavam fechado.)
    - 🟠 review-protocol: «3×» vs estabilidade era ambíguo (podia parar <3);
    agora três é o piso e não pára antes de uma passa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
2026-09-10 fix parts-tier terminology to JLCPCB canonical set + script tier normalization
    Canonicaliza os tiers de montagem da JLCPCB para o conjunto real de TRES —
    Basic, Preferred Extended, Extended — em toda a arvore da skill /pcb. Nao
    existe um tier "Preferred" isolado: "Preferred" e um marcador sobre o Extended
    que evita a taxa de feeder por tipo no Economic PCBA, logo "Preferred Extended".
    - references/parts-sourcing.md: alinha o checklist de equivalencia (§2), o
    ranking custo-optimo da arvore (§6) e o formato do manifesto para
    Basic/Preferred Extended/Extended. A tabela §1 ja estava canonica.
    - scripts/manifesto_fontes.py (v0.3.0 → v0.4.0): substitui o set TIERS por um
    mapa canon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
2026-09-10 bootstrap KiCad via AppImage in /pcb Stage 0 — unblock envs without a native KiCad
    apt only ships KiCad 7, conda-forge has no kicad, the KiCad PPA and official
    hosts (downloads.kicad.org/kicad.org/sourceforge) are egress-blocked, but
    GitHub release-download URLs pass the proxy. Encode that fallback so no future
    session is blocked by a missing/old KiCad toolchain.
    - scripts/bootstrap_kicad.sh: POSIX, idempotent; skips if a kicad-cli of the
    required MAJOR is on PATH or already extracted; else downloads a GitHub
    release AppImage (parameterizable; default pkgforge-dev KiCad-10.0.6), verifies
    HTTP-ok + min size (+ sha256 if given), never proceeds on a partial download,
    extracts with --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
2026-09-10 ppc/002 rev B->C: cerebro V+PRE island PROVEN closed; rev label bump
    Board 1 (CEREBRO) closure pass under KiCad 10.0.6 (pcbnew via the
    AppImage's usr/bin/python3, 10.0.6).
    MEASURED BASELINE (kicad-cli, refilled zones):
    ERC : 11 violations, all severity=error, all pin_not_connected
    -> all on U2 (MCU socket) unused GPIO/power pins (D3,D4,D9,
    D11,D12,D18-D21,D25,3v3D). Intentional unused pins missing
    NC flags; schematic hygiene, not a board defect.
    DRC : 89 violations, 0 unconnected, 27 schematic-parity.
    errors(2): starved_thermal x1 (J14 pad1 GND), courtyards_overlap x1 (C16/J14)
    warnings(87): lib_footprint_issues 73 (kicad-cli has no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
    [cotuca_cerebro.kicad_pcb]
2026-09-10 cerebro rev C: ERC 11->0, DRC 2 errors->1 (starved_thermal + U3 mismatch fixed)
    Fecho da CEREBRO (ppc/002 rev C). Antes/depois medido com KiCad 10.0.6
    (kicad-cli DRC --refill-zones, sch erc, funcao_dos_pads):
    ERC: 11 erros -> 0 (74 warnings inalterados: footprint_link
    + lib_symbol_mismatch, artefactos headless)
    DRC: 89 (2 erros) -> 87 (1 erro)
    funcao_dos_pads: 18/0 -> 18/0
    0 unconnected antes e depois (V+PRE fechado intacto)
    Itens (cada um provado por DRC/ERC):
    1. starved_thermal J14 pad1 (GND) [erro] -> RESOLVIDO. Pad de terra de
    potencia quer ligacao SOLIDA a zona (ppc/002 §2): J14.pad1 zone_connect=2
    (FULL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
    [cotuca_cerebro.kicad_pcb, cotuca_soquete.kicad_sch]
2026-09-10 painel (ppc/002 rev C): rotear 3 redes, fechar starved_thermal, rev A/B->C
    Fecho da placa PAINEL (board 2). Tudo medido com KiCad 10.0.6 (kicad-cli +
    pcbnew), nao com contadores caseiros.
    ANTES (baseline):
    - ERC: 0 erros
    - DRC (--refill-zones): 3 unconnected (ERROS) - 0 starved_thermal - 0 silk_over_copper
    - 4 silk_edge_clearance (aviso) - 28 lib_footprint_issues (ambiente sem libs
    globais; com libs standard = 1 lib_footprint_mismatch em J1) - 13 parity (MPN)
    - funcao_dos_pads painel: 12 regras / 0 falhas
    DEPOIS:
    - ERC: 0 erros
    - DRC (--refill-zones): 0 unconnected - 0 ERROS - 0 starved_thermal
    - 4 silk_edge_clearance (aviso, contorno de J1 no bordo, pre-existente)
    - 28 lib_footpri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
    [cotuca_painel.kicad_pcb, cotuca_painel.kicad_sch]
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2026-09-10 painel rev C floorplan-nudge — J1 inward, re-route corner, C5 placed clean; DRC 0 errors held; generator updated
    J1 (IDC 2x13) moved 5.5 mm inward off the top edge (y=24 -> 29.5), opening its
    dead top escape broadside (courtyard was 2.2 mm OFF the board; now 3.3 mm clear
    to the edge, supply 13 -> 26). C5 (+3V3A 100n) relocated from 0.5 mm off J1's
    courtyard (the latent "C16" repeat) to (34.5, 34.5) directly under J1 pin 9
    (+3V3A), with a 1.0 mm via straight to the main GND plane (small loop, P4).
    J3/J4/J5 and R1/R2 nudged down to free the escape corridor; 0 courtyard overlaps.
    Corner re-routed with FreeRouting (plane stripped from the DSN so B.Cu stays a
    solid GND plane; right-side tracks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
    [cotuca_painel.kicad_pcb]
2026-09-10 close cérebro rev C — C16→B.Cu (co_prep), route +3V3A via FreeRouting plane-strip, widen U1A/U1B tracks; DRC errors 5→0; generator updated
    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
    [cotuca_cerebro.kicad_pcb]
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2026-09-10 painel rev C — clean dangling copper + fix Q1/Q2/J4 designators; para_fabrica passes
    Remove 6 loose copper stubs from the corner re-route (5 track_dangling +
    1 via_dangling, all redundant dead branches off already-connected nets):
    OLED_CLK/OLED_DC B.Cu branches, ENC_A_PUSH/POT_R F.Cu stubs, GATE_B B.Cu
    stub, and two redundant vias (ENC_A_B junction, GATE_B). DRC dangling 6->0,
    unconnected stays 0.
    Move Q1/Q2/J4 reference silk so each sits nearest its OWN part (were nearer
    R1/R2/C5). refs_apontam 3->0. Positions DRC-gated: silk_overlap/
    silk_over_copper and svg_colisoes all held at baseline (no new violations).
    arruma_silk.py: honor KICAD_CLI from the environment (its self-gate runs
    kicad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
    [cotuca_painel.kicad_pcb]
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2026-09-10 make gerber delivery integral to /pcb — track stamped fab releases under export/, para_fabrica auto-writes there, Estágio 8 requires it committed; persist rev-C cerebro+painel packages
    fabrica/ is gitignored scratch, so stamped fab packages were ephemeral and never
    reached the repo/PR. Now:
    - .gitignore: keep fabrica/ ignored as transient scratch; add a targeted
    negation (!export/**/*.zip) so gerber zips under the tracked top-level export/
    escape the global *.zip. Comments explain the split.
    - para_fabrica.py (0.11.0 -> 0.12.0): on a PASS, copy the lean stamped package
    (gerber zip + cpl + bom + LEIA-ME) into export/<board>_<date>_<commit>/ and
    print that durable path as the final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
    [bom_cerebro.csv, bom_painel.csv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]
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2026-09-10 JLC-DFM silk parity — fix painel silk→pad/→hole, add silk DRC rules to gate, re-export painel
    O DFM da JLCONE reprovou o painel com serigrafia a vermelho que o portão
    sub-contou (silk→pad 25, silk→furo 31): o DRC-default do KiCad mede a serigrafia
    sobre cobre com min_silk_clearance=0 (só o sobreposto, não a folga de 0,15 mm que
    a JLC exige) e não tinha regra de silk→furo.
    Fix do painel (via pcbnew, diff cirúrgico):
    - 3 textos para fora de pad+furo: Reference Q1, Reference Q2, gr_text 'painel rev C'
    (que estava por cima dos pads e furos 24/26 do J1). Preserva svg_colisoes
    (F 2→2, B 2→0) e refs_apontam (0 erradas).
    - 301 contornos de biblioteca a 0,12 → 0,15 mm (nor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
    [cotuca_painel.kicad_pcb]
2026-09-10 persist painel JLC-DFM fab package (para_fabrica 0.13.0, clean stamp 9d293da)
    Pacote de fábrica do painel gerado pelo portão com paridade JLC-DFM: serigrafia 0
    (silk→pad/→furo/traço via .kicad_dru), geometria 0, ligações todas feitas. Stamp
    limpo do commit 9d293da (sem árvore suja). Cérebro precisa da mesma passagem.
    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
    [bom_painel.csv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]
2026-09-10 painel silk DFM v2 — fix at source, measure on the gerber
    Two prior passes called the painel silk clean; JLCONE still showed
    silk->pad 18 red/32 orange, silk->furo 11 red/4 orange, line-width 50
    orange. Root causes, reproduced on the EXPORTED gerber (the artifact JLC
    ingests), not the board-level DRC (which under-counts):
    - kicad-cli pcb drc never fired the .kicad_dru silk_clearance rules
    (0 reported over a board full of silk flush to pads);
    - the red is created by our own --subtract-soldermask, which trims silk
    FLUSH to the pad opening (0 gap = a border JLC counts as red) — visible
    only in the gerber;
    - the "50 orange" line-width was text AND graphics at EXACTLY 0.15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
    [cotuca_painel.kicad_pcb]
2026-09-10 persist painel silk-DFM-v2 fab package (para_fabrica 0.14.0, clean stamp 83f2f82)
    Gerber-verified clean by the new gate: silk->pad 0/0, silk->furo 0/0,
    min silk stroke 0.18 mm on both sides. VISTORIA regenerated. Supersedes and
    removes the painel_9d293da and painel_aad5d5a export dirs — one current
    painel package.
    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
    [bom_painel.csv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]
2026-09-10 serigrafia_dfm: clean up own temp files; gitignore kicad/_silk_*
    The fixer wrote _silk_tg/ and _silk_*.json under kicad/; left behind they
    make para_fabrica's carimbo() see a dirty tree and stamp the package non-clean.
    Remove them at the end and ignore them as a safety net.
    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
2026-09-11 painel DFM oranges — factual per-class resolution (annular/mask/slot/silk), measured verdicts
    Measured every remaining JLCONE orange on the actual gerber/drill (pcbnew +
    gerbonara/shapely), reproduced each mechanism, and gave an evidence-based
    verdict — no cosmetic dismissal. All four classes are manufacturable-as-is,
    ACCEPTED with the measured number; none had a real+cheap fix that did not make
    something else worse:
    - Annular ~75: min 0.15 mm across all 96 drilled features (0 < 0.13 min,
    0 < 0.15); the 33 vias are 0.6/0.3 = the JLC standard via. JLC counts
    top+bottom per through-feature at the 0.15 preferred limit. Bumping the pad
    was TESTED and is worse: 17 vias drop from 0.20 t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
2026-09-11 persist current painel fab package (para_fabrica 0.15.0, clean stamp 8dcec94)
    Re-exported the painel package from 8dcec94 (board byte-identical to 83f2f82 —
    no board change was warranted; all DFM oranges are manufacturable-as-is) so
    there is ONE current painel package stamped to the tip, and regenerated
    VISTORIA. Removed the superseded painel_2026-09-10_83f2f82 dir. Gate passed:
    DRC 0, funcao_dos_pads 12/0, silk gerber 0 red/0 org, vias 34/34 tented,
    all connections made, clean stamp.
    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
    [bom_painel.csv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]
2026-09-11 cerebro JLC-DFM silk-v2 + oranges factual — gerber-measured clean, re-export
    Brought the cérebro to the same JLC-DFM cleanliness the painel just reached
    (JLCONE-confirmed 0 red silk), every claim measured on the exported gerber/drill.
    Silk → ZERO on the gerber (mede_serigrafia):
    - Before: silk→pad 23 red (F) + 2 red (B) = 25; trace min 0.12 mm.
    - After serigrafia_dfm (widen all strokes to 0.18, clip graphics incl. filled
    fp_circles to 0.15 from every pad/hole, relocate 2 board texts): silk→pad and
    silk→furo 0 red / 0 org on BOTH sides; every stroke >= 0.18 mm. refs_apontam 0.
    - Tool fix: serigrafia_dfm v0.2.0 now treats footprint text of class PCB_TEXT
    like FP_TEXT in widen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
    [cotuca_cerebro.kicad_pcb]
2026-09-11 persist cerebro fab package (para_fabrica 0.15.0, clean stamp 1b1931f), regenerate VISTORIA
    Stamped clean package for the silk-v2 / oranges-factual cérebro (commit 1b1931f,
    clean tree). The delivered zip's gerbers re-measured: silk→pad/→furo 0 red / 0 org
    on both sides, stroke min 0.180 mm. VISTORIA regenerated (portao_humano v0.2.0,
    32 items; all 9 polarity markers D1/D2/D11/D21/U1/C1/C3/C5/C6 present). Dropped the
    superseded export/cerebro_2026-09-10_e058d6b. relatorio 002 export references
    updated to the current silk-v2 packages (cérebro 1b1931f, painel 8dcec94).
    Claude-Session: https://claude.ai/code/session_01DBbgKXngnWdT1aM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
    [bom_cerebro.csv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]
2026-09-11 para_fabrica: emit CPL/BOM in JLC upload format — headers + Top/Bottom (real JLCONE reject)
    JLCONE rejected the painel CPL at the live upload with "Failed processing the CPL
    file." Root cause: para_fabrica emitted kicad-cli's NATIVE pos schema — header
    Ref,Val,Package,PosX,PosY,Rot,Side with lowercase top/bottom — but JLCPCB's SMT
    parser requires header exactly `Designator,Mid X,Mid Y,Layer,Rotation` with layer
    `Top`/`Bottom` (capitalized). Same class of lesson as the silk/DFM parity: the
    gate's OUTPUT must be what the fab actually accepts, not what the tool emits by
    default.
    para_fabrica v0.16.0:
    - cpl_para_jlc(): rewrites the exported pos to the JLC schema —
    Ref→Designator, Po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
    [bom_cerebro.csv, bom_painel.csv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]
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2026-09-11 persist pacotes de fabrica regenerados — BOM agrupada por LCSC (stamp a3acd3b)
    Reemite os pacotes das duas placas com a `para_fabrica` v0.17.0: cada peca
    montada e agora UMA linha na BOM (agrupada pelo LCSC), pelo que a JLCONE ja
    nao acusa "Multiple lines matched to the same part".
    cerebro 35 linhas (era 36): R50+R51 `10k — L`/`10k — R` fundidos (C17414).
    painel 15 linhas (era 17): `100n`/`100n COLADO ao cursor`/`... ao IDC`
    fundidos numa so linha C1,C2,C4,C5 (C49678).
    Ambos: geometria 0, serigrafia GERBER limpa, funcao dos pads 0 falhas, vias
    tapadas, ligacoes todas feitas — PRONTO para a JLCPCB. CPL inalterado (uma
    linha por designador; cada 100n mantem a sua pr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
    [bom_cerebro.csv, bom_painel.csv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]
2026-09-11 retire pacotes 1b1931f/8dcec94, repoint 002 para a3acd3b + VISTORIA fresca
    O `para_fabrica` v0.17.0 reempacotou as duas placas com a BOM de montagem
    agrupada por LCSC (uma linha por peça), corrigindo o bug de LCSC duplicado.
    Os pacotes a3acd3b passam a ser a verdade corrente.
    - VISTORIA.md gerada por portao_humano.py v0.2.0 para cada pacote a3acd3b,
    consistente com a BOM/CPL que embarca (cérebro 50 peças, painel 23).
    - Apagados os dois pacotes superados (export/cerebro_..._1b1931f e
    export/painel_..._8dcec94) — reproduzíveis do histórico do git.
    - docs/relatorio/002.md: referências dos pacotes descarregáveis (§ topo e §3)
    repontadas para export/..._a3acd3b/ e o carimbo a3ac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
    [bom_cerebro.csv, bom_painel.csv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]
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2026-09-11 export: reempacota cerebro/painel em 6ebbda5 com CPL rico + kit de montagem
    Regenera os dois pacotes com para_fabrica v0.18.0 (agora com companheiro
    cpl_rico_<board>.csv) e corre kit_montagem v1.0.0 sobre cada um, criando o
    subdirectorio kit/ com MAPA_COLOCACAO.md, COMPRA_LCSC.csv e LEIA-ME-KIT.txt.
    Retira os pacotes a3acd3b superseded (reproduziveis do historico) e repoint
    docs/relatorio/002.md para o stamp 6ebbda5. Ambos os pacotes carimbam arvore
    LIMPA. O VISTORIA.md e regenerado a parte (worker seguinte), agora a partir
    do CPL rico que os pacotes embarcam.
    Validado: cerebro C16 sinalizado BOTTOM; contagens LCSC por codigo batem na
    BOM (16 codigos cerebro, 5 painel); nenhum LCSC distint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
    [COMPRA_LCSC.csv, bom_cerebro.csv, bom_painel.csv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]
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2026-09-12 painel rev C1: J2 OLED reordenado + footprint 1x07 2.54mm THT + labels por pino
    Corrige a ORDEM DO J2 (OLED) na fonte para bater com o modulo Waveshare
    SSD1309, pino a pino: 1=+5V(VCC) 2=GND 3=DIN 4=CLK 5=CS 6=DC 7=RST.
    Antes estava 1=GND 2=+5V 3=CLK 4=DIN (pinos 1<->2 e 3<->4 trocados). Os
    NOMES das redes nao mudaram — so mudou em que pino fisico do J2 caem. O
    contrato J1<->J14 (IDC 2x13) fica intacto.
    Tambem troca o FOOTPRINT do J2 de Molex PicoBlade 1,25 mm (incompativel com
    header/dupont) para um header 1x07 a 2,54 mm THT
    (Connector_PinHeader_2.54mm:PinHeader_1x07_P2.54mm_Vertical), rodado 90 no
    layout para os pinos correrem em +X. Provado que cabe: folga 4,05 mm ao J1,
    2,24 mm ao bor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
    [cotuca_painel.kicad_pcb, cotuca_painel.kicad_sch]
2026-09-12 export: pacote painel rev C1 (deddd3d), retira 6ebbda5, repointa 002
    Regenera o pacote de fabrica do painel a partir do commit deddd3d (J2 rev C1):
    - export/painel_2026-09-12_deddd3d/ — gerbers.zip + CPL + CPL rico + BOM +
    LEIA-ME + kit/ + VISTORIA.md. Portao para_fabrica: PRONTO (silk gerber
    limpo, vias tented, funcao_dos_pads 0, refs_apontam 0, ligacoes todas).
    CPL/VISTORIA/LEIA-ME refletem o J2 corrigido (header 1x07 2,54mm THT,
    ordem VCC·GND·DIN·CLK·CS·DC·RST) e a nota "J2 corrigido".
    - kit/ regenerado por kit_montagem v1.0.0; VISTORIA por portao_humano v0.2.0.
    - Retira o pacote superseded export/painel_2026-09-11_6ebbda5/.
    - docs/relatorio/002.md: repointa o painel para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
    [COMPRA_LCSC.csv, bom_painel.csv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]
2026-09-12 cerebro rev C1: marca+búzios para F.Silk do topo (visível pela tampa)
    A marca do cérebro (COTUCATRONICS + rev) vivia em B.Silkscreen espelhada.
    O cérebro monta com o lado dos componentes PARA CIMA, e a tampa é de acrílico
    transparente — logo a F.Silkscreen (topo) é a face que se vê. Move as duas para
    F.SilkS sem mirror, na banda livre de topo entre o J14 (x≤81) e o J15 (x≥132),
    por cima do C14/U2 e da fila de test-points: COTUCATRONICS @(100,24.4) h2.6 e
    "cerebro rev C1" @(100,29.2) h1.6, folga ≥0.25 mm a todo o cobre e ≥1.5 mm ao
    bordo (medida por varrimento em pcbnew).
    Acrescenta o símbolo de búzios (concha) em F.SilkS — a mesma marca `Concha` do
    `src/splash.h` (supe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
    [cotuca_cerebro.kicad_pcb]
2026-09-12 export: pacote cerebro rev C1 (bcc80d2), retira 6ebbda5, repointa 002
    Empacota o cérebro rev C1 (marca+búzios em F.Silkscreen do topo) em
    export/cerebro_2026-09-12_bcc80d2/ — para_fabrica PRONTO: geometria 0, ERC 0,
    funcao_dos_pads 18/0, refs_apontam 0, vias tented 0 abertas, silk gerber-truth
    0 red/0 org nos dois lados (incluindo a marca movida + búzios + rev C1). VISTORIA
    + kit/ regenerados. Retira o superseded export/cerebro_2026-09-11_6ebbda5/
    (reproduzível do histórico). Repointa docs/relatorio/002.md para o novo stamp,
    marca cérebro rev C1 e acrescenta a linha de histórico de revisões.
    Claude-Session: https://claude.ai/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
    [COMPRA_LCSC.csv, bom_cerebro.csv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]
2026-09-12 cerebro rev C2: marca+búzios movidos para área aberta centro-direita
    A marca do cérebro (COTUCATRONICS + rev + símbolo de búzios) vivia na banda de
    topo em F.Silkscreen (rev C1, @~x100/x124, y24-29). O dB apontou para a área
    ABERTA do centro-direita inferior — a faixa livre ACIMA do J1, à DIREITA do U2
    (Daisy DIP, acaba em x=115) e ABAIXO do bloco J2/J3/C3/J16. A banda de topo não
    comportava um bloco de 45 mm de largura (só o texto COTUCATRONICS tem ~32 mm) e
    o centro exacto apontado (y~55-72) está congestionado por J11/R9/J3/J2 e pelos
    strips verticais J15/J16; a área aberta que cabe o bloco rígido é esta, logo
    abaixo, e é a mais próxima do ponto indicado.
    Move os TRÊS el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
    [cotuca_cerebro.kicad_pcb]
2026-09-12 export: pacote cerebro rev C2 (50e2368), retira bcc80d2, repointa 002
    Empacota o cérebro rev C2 (marca+búzios movidos para a área aberta do
    centro-direita, acima do J1) em export/cerebro_2026-09-12_50e2368/ —
    para_fabrica PRONTO: geometria 0, ERC 0, funcao_dos_pads 18/0, refs_apontam 0,
    vias tented 0 abertas, silk gerber-truth F/B 0 red/0 org (silk->pad e silk->furo)
    incluindo a marca movida + búzios, traço min 0,180 mm, GERBER limpa. VISTORIA +
    kit/ regenerados (idênticos ao pacote anterior salvo stamp/rev — CPL/BOM não
    mudaram, só o silk). Retira o superseded export/cerebro_2026-09-12_bcc80d2/
    marc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
    [COMPRA_LCSC.csv, bom_cerebro.csv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]
2026-09-12 cerebro+painel rev C: marca reposicionada+escalada, freeze-on-release
    Cerebro: a marca (COTUCATRONICS + rev + búzios) foi para a banda que o dB
    apontou — à direita do U2, abaixo da fila de TP/J12, à esquerda do J2/C3.
    Essa banda mede só 32,8x9,5 mm (medido em pcbnew) e o banner a tamanho cheio
    tem 45 mm: a tamanho cheio punha COTUCATRONICS+rev sobre os pads MIDI/AUDIO do
    U2 (4 silk_over_copper). O grupo foi escalado uniformemente por 0,72 (layout
    relativo preservado) e centrado: COTUCATRONICS (127.2,68.8) size 1.872 · rev
    (127.2,72.256) size 1.152 · búzios (144.48,69.664) ra 3.6 rb 2.16. Folga mínima
    0,67 mm (pátio U2 esq., pátio J2 dir.; TP/J12 a >3,6 mm). Silk gerber F/B
    0 red/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
    [cotuca_cerebro.kicad_pcb, cotuca_painel.kicad_pcb]
2026-09-12 export: pacotes cerebro+painel rev C (06db1c7), retira antigos, repointa 002
    Regenerados por para_fabrica com proveniência limpa (commit 06db1c7, árvore
    limpa), ambos PRONTO: geometria 0 · planos inteiros · todas as ligações feitas ·
    silk gerber F/B 0 red/0 org. kit/ (kit_montagem v1.0.0) e VISTORIA.md
    (portao_humano v0.2.0) regenerados nos dois pacotes.
    - export/cerebro_2026-09-12_06db1c7/ — marca reposicionada+escalada (0,72) para a
    banda à direita do U2; silk `cerebro rev C`; cobre idêntico ao 50e2368.
    - export/painel_2026-09-12_06db1c7/ — silk `painel rev C`; cobre idêntico ao deddd3d.
    Retirados os pacotes antigos export/cerebro_2026-09-12_50e2368/ e
    export/painel_2026-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
    [COMPRA_LCSC.csv, bom_cerebro.csv, bom_painel.csv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]
2026-09-12 export: BOM Mouser consolidada (cerebro + painel) para import
    Mapeia cada codigo LCSC das BOMs de montagem para um MPN real que o
    Mouser vende (LCSC nao e aceito no BOM tool do Mouser). Inclui THT
    (eletroliticos, filme, conectores, pot, encoder) alem do SMD. Qty =
    soma das duas placas + folga. Modulos (Daisy, ESP32-C3, TPA3116,
    step-down, decoy PD) listados a parte por nao serem catalogo Mouser.
    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
    [COMPRA_MOUSER.csv]
2026-09-12 export: template Mouser preenchido + BOM consolidado cerebro+painel
    - COMPRA_MOUSER_template.xlsx/.xls: template oficial Mouser (28 colunas,
    header intacto) preenchido com as 29 pecas de catalogo Mouser. MPN em
    "Mfr Part Number (Input)" e "Manufacturer Part Number", Qty em "Quantity 1",
    Manufacturer Name preenchido, "Mouser Part Number" em branco. Modulos
    (Daisy, ESP32-C3, TPA3116, step-down, decoy, cabo) excluidos.
    - BOM_CONSOLIDADO.csv: uma linha por peca distinta das duas placas, merge
    por valor+footprint+LCSC (100n/100R/10k/100u/IDC 2x13 somados), com
    Qty por placa, total, folga (+2 ate 5 / +20%) e designadores; secao de
    modulos nao-Mouser no fim.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
    [BOM_CONSOLIDADO.csv, COMPRA_MOUSER_template.xls, COMPRA_MOUSER_template.xlsx]
2026-09-12 export: repõe 5 peças sem match/backorder no Mouser + rechecagem
    Substituições que mantêm footprint e spec elétrica (estoque não
    verificado — Mouser bloqueado por egress; ver export/MOUSER_ALTERNATES.md):
    - 10uF 1206 (C8): Samsung CL31A106KBHNNNE (long lead) -> Murata
    GRM31CR61E106KA12L (25V X5R, 1206)
    - PTC 2920 (F1): Littelfuse 2920L330/24MR (backorder) -> 2920L300/24MR
    (3.0A/24V, mesma família 2920L)
    - Box header IDC 2x13 (J14/J1): 3M N2513-6002RB (No Match) -> Würth
    61202621621 (WR-BHD 26p 2.54mm THT vertical)
    - Barra 1x40 (headers 1 fila): Sullins PRPC040SAAN-RC (No Match) ->
    Würth 61304011121 (WR-PHD 1x40 2.54mm THT)
    - Schottky SMA (D2): Diodes SS14-13-F (No Match)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
    [BOM_CONSOLIDADO.csv, COMPRA_MOUSER.csv, COMPRA_MOUSER_template.xls, COMPRA_MOUSER_template.xlsx]
2026-09-12 export: troca 3 MPNs No-Match no Mouser por peças catalogadas
    Q1/Q2 MOSFET AO3400A (AOS) -> DMN3404L-7 (Diodes Incorporated), SOT-23, qty 4
    F1 PTC 2920 2920L300/24MR -> 2920L330/24MR (Littelfuse, 3.3A/24V), qty 3
    C14/C24 filme MKS2C042201F00KSSD -> MKS2B042201F00KSSD (WIMA MKS2 2.2uF), qty 4
    Footprints inalterados. Mouser bloqueado por egress; catalogação
    confirmada via WebSearch (páginas ProductDetail), estoque ao vivo NÃO
    verificado — usuário confirma na tela. MOUSER_ALTERNATES.md ganha método
    de alcance, URLs de busca por peça e alternativas por fabricante catalogado.
    Claude-Session: https://claude.a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
    [BOM_CONSOLIDADO.csv, COMPRA_MOUSER.csv, COMPRA_MOUSER_template.xls, COMPRA_MOUSER_template.xlsx]
2026-09-12 export: trava 7 MPNs verificados em estoque no Mouser (via navegador)
    7 peças confirmadas AO VIVO no Mouser com filtro In Stock (2026-09-12),
    gravadas como picks primários definitivos nos 4 arquivos de BOM:
    - C8 10uF 1206: GRM31CR61E106KA12L -> CL31B106KAHNNWE (Samsung) 187-CL31B106KAHNNWE
    - F1 PTC 2920: 2920L330/24MR -> MF-LSMF300/24X-2 (Bourns) 652-MF-LSMF300/24X-2
    - C14,C24 filme 2u2: MKS2B042201F00KSSD -> MKS2C042201M00KN00 (WIMA) 505-MKS2C042201M00KN
    - J14/J1 IDC 2x13: 61202621621 (Wurth) 710-61202621621
    - barra 1x40: 61304011121 (Wurth) 710-61304011121
    - D2 SS14: SS14 (onsemi) 512-SS14
    - Q1,Q2 MOSFET: DMN3404L-7 -> SI2302CDS-T1-GE3 (Vishay) 781-SI2302CDS-T1-GE3
    Template (.xlsx/.xls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
    [BOM_CONSOLIDADO.csv, COMPRA_MOUSER.csv, COMPRA_MOUSER_template.xls, COMPRA_MOUSER_template.xlsx]
2026-09-12 pcb: sourcing Claude-on-Chrome, grafismos por grid, e reconciliacao de MPN
    SKILL.md v1.4.0 — tres aprendizagens da corrida de sourcing pelo Mouser.
    TASK 1 — Estagio 2 ganha o §7 de parts-sourcing.md (sourcing com Claude-on-
    Chrome): o sandbox nao alcanca o Mouser (403 de egress; WebSearch prova
    catalogo, nunca estoque), entao o navegador do humano e a fonte-da-verdade de
    disponibilidade. "Disponivel" = Ships Now >= qty; backordered/long-lead contam
    como INDISPONIVEL (dao MATCH e nao embarcam — ancora CL31A106KBHNNNE). Prompt-
    template copiavel + fluxo em 3 passos + tabela de retorno com Ships Now e lead.
    TASK 2 — Estagio 6 ganha references/grafismos-grid.md (nova) e o helper
    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
    [cotuca_conector.kicad_sch, cotuca_energia.kicad_sch, cotuca_painel.kicad_sch, cotuca_preamp.kicad_sch, cotuca_soquete.kicad_sch]
2026-09-12 export: Versionar TUDO — carimbo em todo artefato + MANIFEST autoritativo
    Raiz: carrinho Mouser ficou com MPN de um export superado enquanto o repo
    já tinha o novo. Todo artefato consumível passa a declarar a própria versão.
    - carimbo v2 nos 4 artefatos de compra (COMPRA_MOUSER.csv, BOM_CONSOLIDADO.csv,
    MOUSER_ALTERNATES.md, template .xlsx/.xls em célula/aba dedicada "carimbo")
    - export/MANIFEST.md (novo): índice único de "am I current?" com protocolo
    confere-o-carimbo-antes-de-consumir; lista soltos + pacotes cerebro/painel
    - skill pcb v1.5.0: secção «Versionar TUDO» em references/versionamento.md +
    Histórico; nota cruzada na skill edicao-segura
    - docs/relatorio/002.md: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
    [BOM_CONSOLIDADO.csv, COMPRA_MOUSER.csv, COMPRA_MOUSER_template.xls, COMPRA_MOUSER_template.xlsx]
2026-09-16 caixa: capturar lições de montagem (campo) + diretriz «tudo parafusado»
    Grava as 5 lições da montagem à mão da caixa r2 (acrílico 3,0) em
    caixa/LICOES-MONTAGEM.md — cada uma com sintoma → causa (file:line no
    gerador) → correção parafusada → re-corte? → ferragem:
    1. furo do pino de indexação do pot ausente (:264 só faz o ø7);
    distância a CONFIRMAR na peça (datasheet ~4,4 vs 4,7 medido da borda)
    2. OLED monta por fora — passa a interno em 4 standoffs M2.5 (:265,:266)
    3. cabos não entraram (gambiarra pelas grelhas :270/:343) — resolve com #2
    4. cola do reforço/nervura mancha o acrílico (:345-350,:363) — aparafusar
    5. fundo colado/escondido (CB/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
2026-09-17 docs(caixa): corrige pot p/ 16mm e registra footprint RV1/RV2 fiado (caso B)
    LICOES-MONTAGEM.md rev. b -> rev. c
    - Lição #1 corrigida: o pot físico é um pot de corpo 16mm (Ø16,90, M7×0,75,
    3T @ passo 5,0mm, anti-rot 7,80mm @ 30° por datasheet ~ 7,5mm medido),
    supersedendo a premissa anterior do PTV09A (9mm). Cota da tampa mantida
    (ø3,2 · 7,5-7,8mm c-c · esquerda/-X na vista de cima).
    - Nova nota #6: footprint RV1/RV2 do painel = PTV09A-1 (passo de pad 2,5mm,
    furo ø1,0, corpo ~12x9,7mm, postes MP ø2,2) conferido no kicad_pcb; MPN
    PTV09A-1020S-B103 no esquema/BOM. O pot fisico (passo 5,0mm) nao caberia
    como board-mounted, mas o usuario confirmou CASO B: pots montados n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
2026-09-18 IFA10000-M: a certificacao do encaixe placa-caixa, e a caixa passa a ceder
    Pedido do dB a 18/09, depois de o painel rev C chegar a fabrica sem um unico
    ponto de fixacao. Nova trilha do IFA10000, dentro da /pcb: o pareamento de
    qualquer placa com qualquer caixa — furos, angulos, tamanhos, volume, tecnica
    de fixacao, acesso e montagem.
    A ORDEM DE PRIORIDADES (e ordem, nao lista absoluta — o dB corrigiu a meio):
    1. a placa traz os seus meios de fixacao. Sem furos nao ha como a prender, e
    nenhuma caixa resolve isso: aqui cede a placa.
    2. com isso garantido, a CAIXA CEDE A PLACA em tudo o resto. E muito mais
    facil ajustar uma embalagem do que uma PCB.
    3. a placa so cede noutra coi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
2026-09-18 A placa tem de se montar: encaixe.py no para_fabrica, e o arcade medido pelo corpo
    "De que vale uma placa correta eletricamente se nao podemos monta-la?" — dB,
    18/09. Nesse dia, perguntas simples de montagem encontraram, com as duas placas
    rev C na fabrica e todos os portoes verdes: o painel sem fixacao, nenhum pot com
    rosca, a fita do IDC com 150 mm num percurso de 265, e corpos debaixo dos
    arcade no cerebro. Cada resposta saiu de um script solto no /tmp.
    O QUE FICOU
    - kicad/encaixe.py v0.1.0 (novo, SO LE): M2 fixacao (>=3 pontos nao
    colineares; rosca so com ficha), M4 contorno (dentro_do_contorno), M6 volume
    sob os arcade (confere_arcade), CABOS entre placas (percurso 3D pela parede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
2026-09-18 OLED: header soldado por baixo, jumpers em L para baixo, e a ancora e o pad quadrado
    O dB resolveu no campo (18/09): por cima o header com jumpers nao cabe — nem
    direitos, nem em L, porque o topo da caixa nao deixa sair os fios e o L para
    baixo espreme o fio contra a tampa. Soldado por baixo, com os L para tras e
    para baixo, fica limpo e livre.
    Por baixo a serigrafia nao se le e a ordem aparece ao contrario. As cores dos
    fios dizem que fio e que sinal; nao dizem que pino e que sinal. A ancora que se
    ve dos dois lados, conferida na placa fabricada: o pad 1 e QUADRADO e e o VCC,
    e dai VCC GND DIN CLK CS DC RST. Confirmar por continuidade com TP1 (+5V) e TP3
    (GND) antes de ligar. E nao repet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
2026-09-18 O encoder real tem rosca e fixa a folga do painel em 6,5 mm: o que muda
    O encoder que o dB tem (foto, 18/09) e um EC11 generico com bucim roscado —
    nao o EC11E15244G1 do BOM, que nao tem. Aparafusado a tampa prende a placa
    (entra no FIXACAO do encaixe, pela peca em mao) e fixa a distancia placa ->
    acrilico no corpo dele: 6,5 mm.
    Medido contra a tabela de alturas, tudo o que e mais alto na face de cima
    bate: J1, J2 (ja resolvidos), J3-J7 e C3 vao por baixo — os LEDs J6/J7 com fios
    soldados, nao JST, porque virar uma ficha com chave troca anodo e catodo — e os
    pots NAO podem ir na placa: ficam na tampa, fiados; os de 16 mm da gaveta
    servem, e o pack de RK097 deixa de ser preciso. Ancora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
2026-09-19 Manual: cada saco da Mouser traduzido no valor a escrever nele
    O dB abriu a caixa da Mouser e os saquinhos nao dizem "100 nF": a
    etiqueta mostra 603-RC0805FR-07100RL. Um estudante com 21 sacos de
    papel e pecas 0805 que ficam iguais fora do saco precisa de uma ponte
    entre o codigo e o valor, e essa ponte nao pode estar errada calada.
    export/mouser_40440548.csv e o que CHEGOU (da notificacao de envio de
    14/09), nao o que se pediu: 21 linhas, cada uma casada com as refs das
    duas placas. O manual_montagem.py le-o e recusa se uma ref nao existe,
    se o tamanho do saco nao bate com o encapsulamento na placa, se uma
    ref esta em dois sacos, se o saco trouxe menos do que as placas pedem,
    ou se uma pec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
    [mouser_40440548.csv]
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2026-09-19 Manual saco a saco, com o tamanho no nome de todo valor repetido
    Duas coisas que o dB pediu da bancada, e a segunda quase custou uma peca:
    1. O tamanho entra no NOME. "100 Ω" existe em tres tamanhos e so o 1206
    dizia "GRANDE"; o 0805 nao dizia nada, e quem le pega o que estiver
    mais a mao. Agora a palavra (pequeno/medio/grande) e CALCULADA da
    comparacao entre os sacos e so aparece quando ha com que confundir, e
    o gerador recusa se dois sacos ficarem com o mesmo nome escrito
    (provado com sabotagem). A tabela ganha a coluna "mede" (2 x 1,25 /
    3,2 x 1,6 / 3,2 x 2,5 mm).
    2. Um passo por SACO, nao por familia de encapsulamento. Agrupar por
    "0805" obrigava a ter sete sacos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
    [mouser_40440548.csv]
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2026-09-19 A serigrafia diz o que a Daisy nao dizia: o cerebro esta girado 180
    Erro meu, corrigido no mesmo dia. Escrevi que a Daisy debaixo do botao
    central provava a orientacao declarada. Nao prova: medi as duas
    orientacoes e o U2 cai sob o furo do meio nas DUAS. Um facto igual dos
    dois lados nao distingue lado nenhum.
    O dB deu a prova que distingue: com o lado do utilizador de frente, a
    serigrafia do painel le-se direita e a do cerebro le-se de cabeca para
    baixo. A placa esta girada 180 face ao modelo, na orientacao rejeitada a
    06/09. E nessa orientacao o verificador acusa o C1 (25 mm) sob o furo 1 —
    que explica finalmente o capacitor alto que obrigou a trocar os botoes —
    e U2 + J13 + J16 sob o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
2026-09-20 bts 15fa: cada modulo tem de ter a sua casa — e agora o portao exige
    Regra dada pelo dB a 20/09, depois de perguntar onde entra o TPA3116 e a
    resposta do repo ser "nos espacadores dele", que nunca existiram.
    O que a torna necessaria: todas as ferramentas deste repo veem
    FOOTPRINTS. DRC, courtyard, M4, M6, manual, BOM da placa — todas partem
    de uma peca com pegada no .kicad_pcb. Um modulo comprado nao tem pegada
    nenhuma: nao existe para verificacao nenhuma, e a falta de lugar para ele
    nao faz barulho ate a caixa estar fechada e cortada.
    encaixe.py v0.2.0 -> v0.3.0 com a etapa M7: a tabela CASA declara por
    modulo a superficie, a fixacao e a fonte; reprova o modulo que um
    conector nomeia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
2026-09-20 onde_furar v0.2.0: o modo do parafuso isolante, e o que ele NAO resolve
    O dB perguntou se furar o cobre e por parafuso de plastico resolve. Meio:
    resolve a cabeca metalica a tocar cobre nu e a ponte GND<->AGND; nao
    resolve o furo CORTAR cobre.
    --plastico deixa o furo cair dentro de um plano, mas continua a proibir
    traco, via, pad, courtyard e bordo — e, para o que sobra, mede o que
    interessa: em que plano cai e a que distancia do BORDO desse plano.
    Essa distancia e a medida do estrangulamento: num campo largo o furo e um
    buraco num campo; num pescoco, parte o caminho de retorno, que e a
    familia de defeito mais cara deste projecto (31/08, 35 a 39 dB).
    No cerebro: 64 mm2 com parafuso metal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
2026-09-20 O amplificador ganhou casa: torres M3 coladas, e o M7 passa de 2 para 1
    Decisao do dB a 20/09: "achei arriscado, nao posso perder essa placa, vou
    colar com hot glue as torres de m3". O onde_furar dizia que os quatro
    pontos passavam com parafuso isolante — passavam, e mesmo assim nao
    furar e a escolha certa: a placa e insubstituivel a meio da montagem,
    colar e reversivel e furar nao e.
    A casa entra na tabela CASA do encaixe.py com os quatro pontos medidos, e
    o M7 passa a reprovar um modulo so, o step-down, em vez de dois.
    ⚠️ Registado junto o que pode morder: cola quente amolece com o calor e o
    classe D aquece. Se a torre ceder, o caminho e epoxi ou fita VHB.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
2026-09-20 Manual: malha grossa nos pinos 2 e 3 do J5 nao faz mal; no pino 1 e silencio
    Pergunta do dB com o ferro na mao: a malha e grossa e vai tocar nos dois
    pinos de terra. Nao ha problema — 2 e 3 sao a MESMA rede (AGND) na placa
    fabricada. O passo nao dizia isso, e quem nao sabe evita uma coisa
    inofensiva ou, pior, gasta a atencao no sitio errado.
    O que importa esta agora escrito: o que nao pode tocar e o pino 1, e o
    sintoma de o tocar e SILENCIO nesse canal, nao ruido. Mais o caminho
    simples (malha so no pino 2, pino 3 vazio) e o teste sem energia: 1-2 nao
    bipa, 1-ponta do jack bipa.
    manual_montagem.py v0.8.0 -> v0.8.1
    [manual_montagem.py]
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2026-09-22 O cerebro toca: tres soldas frias, o divisor medido, e o que ficou escrito
    Sessao de bancada de 21-22/09, do "o iPad conecta e nada acontece" ate o
    instrumento a tocar nos dois canais sem clip.
    bts 15fe — TRES soldas frias em cadeia, e cada sintoma apontava para o
    lugar errado: a ponte com pinos antigos parecia problema do iPad; o
    divisor do VBIAS com solda fria parecia piezo morto (TP2 15 V e TP3
    14,66 V, e o TP4 em 0 — alimentacao boa NAO e polarizacao boa); e a
    junta intermitente do U1 parecia jack mal fiado, porque chegou a
    responder UMA vez. Fica o metodo que resolveu: o gemeo simetrico como
    controle (dedo no R12 deu -13,4 dBFS, no R22 -81,3), e a pressao no chip
    com o medidor a co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
    [manual_montagem.py]
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2026-09-22 A design-review aprendeu que o proprio portao mediu errado
    O verificador nao resolve CSS: resolvia `.rot` como 12 px por causa de
    uma regra homonima noutro desenho, e os SVGs do manual nem `xmlns`
    declaravam, pelo que ele nem achava o `<style>` e caia no omisso em
    silencio. Rotulo centrado modelado como se comecasse no ponto esta
    deslocado de meia largura — inventa colisoes E cala colisoes.
    A emenda diz as tres coisas que evitam isto: xmlns declarado, tamanho e
    alinhamento como ATRIBUTO, e portao proprio para figuras geradas em lote
    (ninguem ia buscar 78 SVGs embutidos num HTML um a um — era por isso que
    a divida durava semanas com a ferramenta ja escrita).
    E acrescenta o que o portao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
2026-09-22 A placa recusa-se a conduzir sinal num painel sem alimentacao
    O dB perguntou por que ja tinhamos dois OLEDs queimados. Duas mortes no
    mesmo sitio nao e azar, e as causas sao DIFERENTES — o que so se soube por
    a primeira estar escrita (23/08: GND e 3V3 invertidos na placa de
    distribuicao, polaridade reversa). Sem esse paragrafo eu teria "confirmado"
    a polaridade e parado.
    A segunda fomos nos. Lido no cobre: os 5 V do painel vem do step-down, que
    corre do +15 V; o pad 39 do U2 e VIN, uma ENTRADA. Medido na bancada: com a
    bancada desligada e a Daisy viva no USB, o TP5 da ZERO. E o firmware
    inicializa o OLED no arranque e desenha sem parar — cinco sinais a 3,3 V
    contra um modulo com VCC a z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
    [hal.h, hal_daisy_seed.cpp, main.cpp]
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2026-09-23 Duas extensoes parecidas, sitios diferentes — e duas falhas empilhadas
    O dB: "o formato correto e .lpcontrollerprofile". DENTRO do .lpproj a pasta
    chama-se `<nome>.lpcontrolprofile`; EXPORTADO solto, o ficheiro e
    `<nome>.lpcontrollerprofile` — com "ler". O gerador escrevia a forma de
    dentro e ele teve de renomear a mao.
    ⚠️ E a armadilha nao foi so o nome: a importacao tinha DUAS falhas ao mesmo
    tempo. Corrigida a extensao, o Loopy continuou a recusar ("perfil global sem
    bindings"), e PARECIA a mesma falha por consertar. Duas causas empilhadas
    leem-se como uma so que nao cedeu — e a segunda so apareceu por eu ter ido
    ver a estrutura do bundle dele em vez de acreditar que a primeira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
2026-09-23 A skill estava certa e a ferramenta contradizia-a: Subject por id, nao posicao
    O perfil gerado dava sempre "perfil sem bindings" no Loopy. Passei o dia a
    caçar a EXTENSAO — mudei para .lpcontrollerprofile a pedido, continuou a
    falhar, e a certa e .lpcontrolprofile nos dois sitios. Nenhuma das duas era a
    causa.
    A causa apareceu em dez segundos quando comparei o que o Loopy escreve com o
    que a ferramenta escrevia:
    Loopy: "Subject": "#1526"
    ferramenta: "Subject": "LPSliderWidget:1:0"
    O Loopy endereça por ID do widget; a ferramenta endereçava por POSICAO, e um
    Subject que nao corresponde a widget nenhum da um perfil que carrega e nao
    liga nada.
    ⚠️ E isto estava escrito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
2026-09-29 ppc/006 §3 revisto: dois slots EXECUTAVEIS nao dao, copia repetivel da
    O plano supunha dois slots executaveis. A medicao de hoje nao deixa:
    · o app executa da QSPI (BOOT_QSPI) e um binario so corre no endereco para
    que foi ligado — dois slots executaveis exigiriam compilar a imagem DUAS
    vezes, uma por endereco, e escolher a certa no envio;
    · BOOT_SRAM resolveria isso e esta fora: 285 KB de codigo + 325 KB de dados
    = 610 KB contra 512 KB de SRAM.
    O desenho novo troca "dois executaveis" por "uma copia REPETIVEL": um so
    endereco de execucao (0x90060000), uma area de encenacao (0x90200000) onde a
    imagem nova aterra, e o escolhedor em 0x90040000 que, ao arrancar, copia
    ence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
2026-09-29 O mapa real da QSPI corrige o plano, e o DFU aceita dois enderecos
    Lido do descritor do bootloader:
    @Flash /0x90000000/64*4Kg /0x90040000/60*64Kg /0x90400000/60*64Kg
    ⚠️ O META nao pode viver em 0x90048000 como o plano dizia: dali para cima o
    sector minimo apagavel sao 64 KB, e um META de 4 KB nao se reescreve sem
    apagar 64. Ha 256 KB de sectores de 4 KB em 0x90000000, abaixo do app, e e la
    que ele pertence.
    ✅ E o mecanismo esta provado: o FLASH_ADDRESS da libDaisy e `?=` e o
    bootloader anuncia a QSPI inteira ao DFU. Escrevi 289 KB em 0x90200000 e a
    placa continuou a arrancar de 0x90040000 sem estranhar — gravar num endereco
    nao perturba o outro, que e o que todo o resto assu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
2026-09-29 A montagem 3D verifica a rev C, nao a rev B
    O ppc/007 vem antes do ppc/003: verificar a arquitectura antiga com
    rigor novo e gastar o rigor no sitio errado. A skill passa a dizer que
    a caixa e DERIVADA do painel, que as alturas de peca de painel nao sao
    fixas no modelo (a peca tem curso, e o modelo verifica se o curso
    chega), e ganha a setima assercao — a caixa e montavel.
    A setima e a unica que antecipa a verificacao real, que e o dB com as
    pecas na mao. O entregavel dela e a ordem de montagem escrita, peca a
    peca, com o vector de aproximacao da chave para cada parafuso: sem isso
    a assercao nao e verificavel, e assercao nao verificavel e decoracao.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
2026-09-30 A PSRAM nao devolve os 12,9 pontos, e encolher os buffers pode
    O estudo da memoria fechou e corrige duas afirmacoes minhas.
    1. A PSRAM NAO recupera os 12,9 pontos de CPU. Aquela medicao foi
    EXTERNO contra INTERNO, nao SDRAM contra PSRAM: uma linha de cache de
    32 B custa ~147 ns da SDRAM da Daisy e ~152 ns de HyperRAM a 166 MHz.
    So a memoria interna (~11 ns) devolve os pontos.
    2. A APS6404L que eu recomendei NAO serve como RAM de trabalho. Errata
    da ST em tres familias: escrita mapeada devolve erro com o DQS
    desligado, e o contorno obrigatorio escreve os bytes que deviam ser
    mascarados — escrita parcial estraga as amostras vizinhas.
    E daí sai a melhor ideia da pesquisa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
2026-09-30 A nossa parte analogica ja esta certa; falta o filtro de saida e o dominio do amp
    Setimo e ultimo estudo: o que as plataformas abertas publicam. Leu
    esquemas a serio — clonou os repos, regerou netlists com kicad-cli, leu
    BOMs e PDFs — em vez de resumos.
    O achado que muda o tom: a NOSSA carrier ja faz quase tudo o que a
    pratica publicada manda. OPA1642 na entrada (JFET, 5,1 nV/raizHz — e o
    relatorio avisa explicitamente contra o MCP6002, que custaria 15 dB
    exactamente ali), ilha de AGND com ponte unica, pre-amp encostado aos
    jacks dentro da ilha, malha do piezo ligada so de um lado, e o banco de
    2200 uF no terminal do amp. A parte analogica nao e o problema.
    O que falta e barato: filt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
2026-09-30 O pre-amp e inocente: a topologia nao e o que nos limita
    Nono e ultimo estudo. Calculou o ruido intrinseco de cada topologia
    contra os nossos piezos de 10-30 nF, sem ponderacao: todas ficam entre
    0,19 e 2,5 uV referidos a entrada. O nosso -75 dBFS medido sao ~178 uV.
    Mesmo um TL072 — a pior peca que alguem poria aqui — e ~37 dB mais
    silencioso que o nosso chao. NENHUMA escolha de topologia move o numero.
    E estamos 15-24 dB pior que a ficha do conversor que ja la esta, o que
    quer dizer que o ruido nem chega ao limite do chip. Os 25 dB que faltam
    ate aos -98 dBu de um pedal profissional sao interferencia, terra e
    alimentacao — a mesma classe que o conserto de terra ja resolveu 35 dB.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
2026-11-02 Remove the two duplicate rows, without losing what only one of them said
    dB: "apague as duplicadas". Neither pair was a copy of the other — each
    row carried something the other did not — so this removes the duplication
    and keeps the knowledge, instead of deleting a row and the facts in it.
    gerar_ccmap.py had two rows, both v0.11.0. One said it owns CCMAP.md and
    the A4 card, that the NOTAS table is the only hand-written part, and that
    it flags orphan notes and notes that lie about topology (ten wrong ones on
    its first run). The other said it stamps date, commit and dirty-tree, and
    carried the warning not to write a second generator — which is exactly
    what happened on 04/09. Merged into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
2026-11-02 Dates become ISO 8601, and a sed would have corrupted the arithmetic
    dB: `04/09` reads as 9 April to an English reader. 1,290 dates converted
    across 128 files.
    ISO 8601 was chosen on evidence, not taste: the repo already used it 106
    times, `verifica_datas.py` already parses it (so changing format does not
    blind the checker that watches dates), and it sorts lexically.
    🔴 WHY A BLIND SED WOULD HAVE BEEN DESTRUCTIVE. This repo is full of `n/m`
    that are not dates: `19/71` unrouted connections, `15/78` figures, `10/12`
    sacrificables, `36/84` MPNs, `16/16` bytes matching. A blind replacement
    turns counts into dates and nobody notices, because a number is still a
    number.
    So the converter reuse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
    [params-aposentados.txt]
